PE1RGU/hf-antenna-switch/docs/design/host-protocol.md

# Host protocol: Mac or Pi to shack interface

Status: v0.1, 2026-10-29. Reviewed by Prins; P3b-01 to P3b-04 and C-1 to C-3 decided as proposed. Firmware phase P3b (firmware/PLAN.md).
Implementation: crate `host-proto` (firmware/crates/host-proto), used by shack-core and by the Mac tools.

## 1. Scope

This document sets the protocol between a host (the Mac now, the Raspberry Pi 5 later) and the shack interface MCU over USB.
One protocol for both hosts (D-68).

The host asks. The shack interface decides. Nothing in this protocol can:

- clear the SAFE latch (only the RESET button can, D-64, D-65, D-75),
- give a permit that the box did not report (D-63),
- key a radio without its permit (TX INH and keying are gated in hardware, D-71).

The host can always make things safer: stop, end TX, release keys.

## 2. Transport

| Item | Value | Source |
|---|---|---|
| Port | ESP32-C3 USB Serial/JTAG, through the DevKit USB-C and the rear panel extension | D-96, D-185 |
| Host side | CDC serial device, for example `/dev/cu.usbmodem*` on the Mac, `/dev/ttyACM0` on the Pi | |
| Isolation | Delock 64226 at the Mac side | A-16, D-185 |
| Baud rate | Not used (USB full speed) | |

The same port also carries the ROM boot messages after a reset and is the flash port. The protocol must survive text it does not know (section 3).

## 3. Format: text lines

Plain ASCII text, one message per line (P3b-01).

- A host line ends with CR, LF or CR LF, so a plain serial terminal works (Enter sends CR). An empty line is no command: no answer, but it counts for the keep-alive. Maximum 120 characters without the line end.
- The shack ends its lines with CR LF. Hosts strip the line end.
- Words are separated by one or more spaces. Keywords are lower case; radio and column names are not case sensitive.
- The first character of a line from the shack tells the line type:

| Start | Line type | Example |
|---|---|---|
| `ok` | Answer: command done or accepted | `ok` |
| `err` | Answer: command refused | `err txbusy R2 is transmitting` |
| `!` | Event, sent when something changes | `!tx R2 permitted` |
| `#` | Log text, for people only | `# expander ready` |

A host ignores every line that does not start with one of these. So the boot ROM text and noise do no harm.

Every command gets exactly one answer line (`ok` or `err`), in the order the commands came. Events and log lines can come between commands and answers. A host matches answers by order, not by content.

Why text and not binary (postcard + COBS, the first idea in PLAN.md): you can drive and read the interface by hand with any serial terminal; the Pi and Mac tools are short scripts; USB already checks every packet, so the frame CRC of the box link is not needed here.

## 4. Names and values

| Item | Values |
|---|---|
| radio | `R1`, `R2`, `R3` |
| column | `A1` to `A4`, `EXP`, `-` (none) |
| column list | columns joined by commas, for example `A2,A3`, or `-` for none |
| on/off | `on`, `off` |
| band | 0 to 15: FT-710 BAND D C B A as a 4-bit number (D-86). Decoding to metres is done on the host |

## 5. Commands

| Command | Does | `ok` answer |
|---|---|---|
| `hello` | Identify | `ok shack fw <x.y.z> proto 1` |
| `status` | Full state, one line (section 7) | `ok <key=value ...>` |
| `route <radio> <tx col> <rx col>` | Route a radio. Sent to the box; the result comes as an event | `ok` (queued) |
| `tx <R2\|R3> on\|off` | Ask for TX permit (handshake) or end TX | `ok` |
| `key <radio> on\|off` | Key the radio through the interface. Works only while its permit is out | `ok` |
| `bias <column list>` | Bias-T feeds on for these columns, off for the rest | `ok` (queued) |
| `stop on\|off` | Software stop: opens the SAFE loop. `off` closes it again; the SAFE latch still needs RESET | `ok` |
| `clearfault` | Clear the shack fault latch (LATCH_CLR edge) after a supervisor reset (P3b-04). While the expander does not answer, RESET_N may still hold the latch: the fault stays and a `#` line says so. When the box reports fault 11 (supervisor trip), the shack also sends ClearFault to the box (D-191, link-protocol.md 4.2); a refusal comes as `!refused clearfault` | `ok` |
| `events on\|off` | Events on (default) or off | `ok` |
| `keepalive <seconds>` | Host keep-alive time-out, 2 to 60 s (section 8) | `ok` |
| `name <column or radio> <text>` | Set the name of an antenna (`A1` to `A4`, `EXP`) or a radio (`R1` to `R3`), 1 to 8 characters (the width of an antenna box on page B): letters, digits, `-`, `.`, `_`, `/`. Stored (section 8a) | `ok` |
| `help` or `?` | The command list as `#` lines, then `ok` | `ok` |
| `names` | All names, one line | `ok A1=G5RV A2=Loop A3=spare A4=spare EXP=unit2 R1=FT-710 R2=WSPR R3=spare` |
| `page b\|c\|auto` | Display page: B flow (default), C cards, or auto (B 10 s, C 5 s). The Safe stop screen always takes over on a blocking problem (Prins, 2026-10-29) | `ok` |

Error answers: `err <code> <text>`. Codes:

| Code | Meaning |
|---|---|
| `syntax` | Unknown command or wrong number of words |
| `arg` | A value out of range (radio, column, on/off) |
| `linkdown` | The box link is down (tx on, route, bias) |
| `notforr1` | `tx` for R1; R1 uses the hardware PTT loop |
| `txbusy` | Route change for a radio that transmits or ends TX (F13) |
| `queuefull` | Too many commands wait for the box; try again |
| `toolong` | Line longer than 120 characters |
| `nofault` | `clearfault` while no fault is known at the shack and the box does not report fault 11 |

## 6. Events

Sent on every change (when events are on). One line each.

| Event | When |
|---|---|
| `!link up` / `!link down` | Box link state (link-protocol.md section 6) |
| `!expander ready` / `!expander lost` | Shack expander set up, or lost (all permits dropped) |
| `!fault` | A supervisor reset was seen after start-up: TX blocked until `clearfault` |
| `!safe ok` / `!safe lost` | SAFE loop current (GPIO21) |
| `!latched 1` / `!latched 0` | SAFE latch (expander input) |
| `!kill 1` / `!kill 0` | KILL switch pressed |
| `!band <n>` | R1 band data changed |
| `!tx <radio> <state>` | `idle`, `requesting`, `permitted`, `ending`, `releasing` |
| `!permit <radio> on\|off` | PERMIT line changed (all radios, R1 included) |
| `!refused <command words> <result>` | The box refused a command; result as in link-protocol.md 4.1, lower case |
| `!permitlost <radio>` | The box dropped a permit in use |
| `!txsense <radio> fault` | Keyed with permit for 500 ms without TX sense (F14) |
| `!txsense <radio> nopermit` | TX sense active without the permit for more than 50 ms, outside the 500 ms after an inhibit: the radio transmits while inhibited (no TX INH input, or a wiring fault). A warning only; nothing stops by itself (F15, D-188) |
| `!route <radio> <tx col> <rx col>` | Route as read back from the box |
| `!host timeout` | Host keep-alive missed: TX ended (section 8) |
| `!selftest pass` / `!selftest fail <item>` | The power-up self-test ended (section 6a). After a fail, TX stays blocked until a power cycle. Items: `expander`, `latch`, `watchdog` |
| `!selftest warn <item>` | Unexpected at start-up, TX not blocked: `txsense <radio>` (TX sense active), `i2c <address>` (SHTC3 0x70 or IMU 0x68 did not answer) |

## 6a. Power-up self-test

Decided by Prins, 2026-10-31. The shack tests its own safety hardware after power-up, before TX can be enabled. No radio is keyed and no permit goes out during the test.

1. Expander: the PCA9539 must answer and read back (F1 set-up) within 1 s of power-up. Fail: `expander`.
2. SAFE latch: it must read set (POR_N holds it set at power-up, D-84). Fail: `latch`.
3. Start-up inputs, warnings only: TX sense of each radio inactive; the DevKit parts SHTC3 (0x70) and IMU (0x68) answer.
4. Watchdog: the WDI kicks stop. The supervisor must trip, which resets the expander, between 0.5 s and 3 s after the last kick (TPS3823 time-out 0.9 to 2.5 s, C-19). Fail: `watchdog`. With R64 open (watchdog off, D-123) this always fails.
5. The kicks resume. When the expander answers again (RESET_N high), the shack gives its one LATCH_CLR edge (D-59 rule 2) and the test has passed.

The test takes 1 to 3 s. A fail means no LATCH_CLR edge: the fault latch keeps TX_EN low in hardware until a power cycle, the shack gives no permit, and `clearfault` does not apply. The display shows the colour bars test pattern (eight bars, 1 s) the first time it starts; it has no read-back, so this check is for the eye. The display shows a fault after a failed test.

The box runs its own self-test (link-protocol.md section 4.2, fault codes 7 to 10); the shack shows its result as `boxfault`.

## 7. Status line

`status` answers one line with `key=value` pairs, in this order:

```
ok link=up safe=ok latched=0 kill=0 fault=0 stop=0 keepalive=2 page=b band=5 box=ready
   r1=A1/A1,permit=1,key=0 r2=A3/A3,tx=permitted,permit=1,key=1 r3=-/-,tx=idle,permit=0,key=0
   k1=A1,A3 rfdet=- bias=- boxfault=0 selftest=pass
```

`selftest` is `running`, `pass` or `fail-<item>` (section 6a).

(One line on the wire; wrapped here for reading. About 200 characters: the 120-character limit is for host lines only. Unknown values read `?`, for example `box=?` before the first box status.)

## 8. Host keep-alive

Decided (P3b-03). A Mac app that crashes while R2 is keyed would leave a WSPR transmitter on until someone notices.

- While any `tx` is on or any `key` is on, the host must send a line at least every keep-alive time-out. Any line counts, an empty line too; `status` is the normal one.
- The time-out is 2 s. `keepalive <seconds>` sets it from 2 to 60 s, for typing by hand (Prins, 2026-10-29). It goes back to 2 s at every power-up. A host app leaves it at 2 s.
- No line within the time-out: the shack ends every TX and releases every key, the normal way (inhibit first, F14), and sends `!host timeout`.
- Routes, bias and the software stop stay as they are.

## 8a. Stored settings

Prins, 2026-10-29: the shack interface keeps its set-up over a power cycle, so the station can be used straight away.

Stored in the shack MCU flash (ESP32-C3, P7):

| Item | Stored | Note |
|---|---|---|
| Antenna and radio names | yes | `name` |
| Route per radio (TX and RX column) | yes | The route the box reports after a `route` that it accepted |
| Bias-T columns | yes | `bias` |
| Display page | yes | `page` |
| TX request, keys | **never** | A restart must not start a transmission |
| Keep-alive time-out | no | Back to 2 s at power-up (section 8) |
| Software stop | no | Off at power-up; the SAFE latch is set at power-up anyway |

- Saved 2 s after the last change, so a burst of commands gives one flash write.
- A record has a version byte and a CRC-16. A bad or missing record gives the defaults (names as in the requirements, no routes, no bias, page B) and the log line `# stored settings not found, defaults used`.
- Restore: each time the box link comes up and the box is ready, and each time the box reports READY again (after KILL, RF on A2, a stop or an expander reset: its relays come back off), the shack sends the stored routes and bias to the box. A route for a radio that is still ending TX goes as soon as that radio is idle. The box checks them like any other command (H1 to H4); a refusal comes as `!refused`. This also restores the routes after a box restart.
- What is stored is the route or bias the box accepted (result Ok), not the read-back in that answer: the box answers at once and switches its relays in the next 36 to 48 ms.
- Restoring a route moves relays without a command from the operator. TX still needs RESET (SAFE latch), the permit and, for R2 and R3, the handshake.

On the ESP32-C3 the record is in flash, in the `nvs` partition at 0x9000: one length byte, then the record. Wi-Fi and BLE are off (D-55), so nothing else uses that partition. espflash does not erase it, so the settings survive a firmware update. Tested on the DevKit, 2026-10-31. The settings are also saved while the expander does not answer.
## 9. Timing

- The shack reads host lines every tick (10 ms) and answers in the same tick.
- Commands that go to the box (`route`, `tx on`, `bias`) answer `ok` when queued. The result comes as an event, about 50 to 120 ms later (link-protocol.md 5.1).

## 10. Implementation (P3b)

- `host-proto` (no_std): line parser into a `HostCommand` enum, and formatters for answers, events and the status line into a fixed buffer. Fuzz test: no panic on any input.
- shack-core: the host port in `Shack::tick`: bytes come in through `ShackHw::usb_read`, each complete line is parsed and answered, and events go out through `ShackHw::usb_write` (`shack/host.rs`); keep-alive timer in `tick`.
- Simulator: the USB port as a byte channel on the board model. `sim-shack --pty` opens a pseudo-terminal, so a real terminal or a Mac script can talk to the simulated interface. Same commands, same answers as the real one.

## 11. Open points

- **P3b-01 Format. Decided (Prins, 2026-10-29): option 1.** Option 1: text lines (this document). Option 2: binary frames (postcard + COBS), smaller and typed, but needs a tool to read. Proposal: option 1.
- **P3b-02 Log output. Decided (Prins, 2026-10-29): accepted.** The firmware writes log text only as `#` lines through this protocol, never as raw `println` on the USB port. Proposal: accept; the target uses a small log adapter.
- **P3b-03 Host keep-alive. Decided (Prins, 2026-10-29): accepted.** 2 s, ends TX and keys only. Proposal: accept.
- **P3b-04 `clearfault`. Decided (Prins, 2026-10-29): option 1.** Clears the shack fault latch from the host after a supervisor reset (watchdog or brown-out) during operation. The firmware cannot read FAULT directly (it is not on the expander); it knows a fault happened when the expander was reset. The SAFE latch is not touched. Option 1: allow from the host, logged. Option 2: no command; a power cycle is needed. Proposal: option 1. The hardware still gates TX by the SAFE latch, the permits and the box.

Choices from P3a, confirmed by Prins (2026-10-29):

- **C-1 R1 permit.** PERMIT_R1 on while the box is READY and R1 has a TX column with K1 on; off while an R1 route change is pending (sent, not answered) or running (the box reports SWITCHING).
- **C-2 Fault after start-up.** After an expander reset during operation, the firmware sets the expander up again but does not clear the fault latch by itself. `clearfault` (P3b-04) is the way back.
- **C-3 F14 plausibility.** 500 ms keyed with permit and no TX sense: the port is flagged (`!txsense`). TX is not blocked.
