PE1RGU/hf-antenna-switch/Datasheets/_register.md

# Datasheet register: HF antenna switch

Rule: for every selected component, this folder holds the datasheet, the errata and the amendments (product change notices). One flat folder.

File name: `<MPN>_<Manufacturer>_<Type>_<Rev-or-date>.pdf`
Types: DS = datasheet, ER = errata, PCN = product change notice, AN = application note, CAT = catalogue chapter, SPEC = manufacturer specification, STD = standard.

## Components

| Component | MPN | Role | Selected |
|---|---|---|---|
| Relay, SPDT 16 A, 12 VDC, wash-tight (RTIII) | TE RTD14012F (TE PN 2-1419108-9) | K0 and TX row, Radio Port card | 2026-09-26 |
| DIN 41612 type C, 96 pos, male, angled, PL2 | HARTING 09 03 196 6921 | Card side, all cards (not used in rev C, archived) | 2026-09-26 |
| DIN 41612 type C, 96 pos, female, straight, PL2 | HARTING 09 03 296 6824 or 6825 | Backplane side (not used in rev C, archived) | 2026-09-26 |
| I2C I/O expander, 16 bit, RESET, no pull-ups | NXP/Nexperia PCA9539PW,118 (TSSOP24; Q900 variant rated -40 to +125 °C). Second sources TI TCA9539PWR, Diodes PI4IOE5V9539LEX (D-133) | Radio Port card, relay select, RESET from safety chain. Addresses 0x74 to 0x77 | 2026-09-26 |
| I2C I/O expander, 8 bit, 100 kΩ pull-ups | NXP PCA9554A | Antenna Port card, active-low relay drive (pull-ups hold the relay off at power-on). Addresses 0x38 to 0x3F | 2026-09-26 |
| DC power connector, 2 pole, PCB, male, 90° | Amass XT60PW-M | Backplane J12 (+12V_RLY) and J13 (+12V_AUX). Cable side: XT60 female | 2026-09-26 |
| DC power connector, 2 pole, PCB, male, 90° | Amass XT30PW-M | Backplane J14 (+5V). Cable side: XT30 female. Cannot mate with XT60: no rail mix-up | 2026-09-26 |
| Differential I2C bus buffer, 2 pairs | NXP PCA9615 | EXP CTRL link unit 1 to unit 2 (one at each end), rev C | 2026-09-27 |
| N-MOSFET 60 V SOT-23, logic level, relay coil driver (primary) | Nexperia BSS138BK | Coil driver, one per RT1 coil (37), rev C | 2026-09-27 |
| N-MOSFET 60 V SOT-23, logic level (second source) | Diotec MMFTN138K (replaces Diodes DMN61D8L-7, D-128, and onsemi 2V7002KT1G, D-134) | Coil driver and level shift, second source for BSS138BK on all boards | 2026-10-19 |
| RJ45 jack, 8P8C unshielded, THT, tab down | Wurth 615008137121; second source Molex 95501-2881 (D-138) | Controller board J1, RJ45 LINK in the top wall | 2026-10-19 |
| Elevated socket 2 x 12, 2.54 mm, 16.13 mm high | Samtec ESQ-112-33-G-D; second source ESW-112-33-G-D (D-139) | Controller board J2 onto RF board J14 | 2026-10-20 |
| P-MOSFET -30 V SOT-23, high-side switch +12V_SW (primary) | Nexperia PMV50EPEA | Relay supply switch under RLY_EN, rev C | 2026-09-27 |
| P-MOSFET -30 V SOT-23, high-side switch +12V_SW (second source) | AOS AO3407A | Second source for PMV50EPEA | 2026-09-27 |
| Coax lightning protector, M-J/M-J (SO-239 both sides), DC to 500 MHz, 500 W PEP | Comet CS-400R (CS-400P discontinued) | Spark arrestor at the RVS box entry, one per coax. Replaceable Sankosha arrestor Y08UZ-400A. DC fire 400 V ±15 %, impulse fire ≤ 950 V (1 kV/µs), insulation ≥ 10 GΩ: passes DC, no static drain | 2026-09-27 |
| UHF receptacle SO-239/A, 4-hole flange 25.4 mm, solder cup | Amphenol RF 83-798 | Radio and antenna ports in the case bottom wall (7 per unit). Body zinc die cast, nickel ≥ 0.00015 in; socket contact brass, silver ≥ 0.0002 in; insulator PTFE per MIL-P-19468. Replaces 83-1R (PBT insulator) | 2026-09-27 |
| SMA panel jack, 4-hole flange 12.7 mm, 50 ohm, PTFE, solder-cup contact | Amphenol RF 901-9215 (stainless body, gold), main part (D-110); second source Cinch/Johnson 142-0701-631 (brass body, gold; D-174); alternative Amphenol RF 132142 (brass body, gold), same outline | EXP J4 to J6 in the left wall (D-108). Not chosen yet: rear length against the 6 mm wall (A-21) | 2026-10-19 (candidates) |
| Solid state relay, 1-form-B (normally closed), 60 V, 150 mA, SOP4 2.54 mm | Littelfuse CPC1117N | Shack interface, TX INH: replaced by D-106 (end of life, PDN EIC-1177) | 2026-09-29, superseded 2026-10-07 |
| Solid state relay, 1-form-B, 350 V, 120 mA, 2.54SOP4 (primary) | Toshiba TLP4176G | Shack interface, TX INH per radio port (U203, U303, U403; D-77, D-106) | 2026-09-29, primary from 2026-10-07 |
| Solid state relay, 1-form-B, 60 V, 0.5 A, GU SOP4 (second source) | Panasonic AQY412S | Shack interface, TX INH, second source of TLP4176G (D-106) | 2026-10-07 |
| PNP medium power transistor 80 V 1 A, SOT-223 | Nexperia BCP53 (-10 or -16) | Shack interface, loop current source pass transistor (D-79) | 2026-09-29 |
| PNP general-purpose transistor 45 V 100 mA, SOT-23 | Nexperia BC857 (B) | Shack interface, loop current source sense transistor (D-79) | 2026-09-29 |
| Linear regulator 5 V 1.5 A, TO-220 | ST L7805CV (L78 series) | Shack interface 13.8 V to 5 V, on the housing wall (D-73, D-82) | 2026-09-30 |
| LDO 3.3 V 800 mA, SOT-223 | ST LD1117S33CTR (C version) | Shack interface 5 V to 3.3 V (D-81) | 2026-09-30 |
| TVS 600 W, SMB, uni- and bidirectional | ST SMBJ16A, SMBJ15CA (SMBJ series) | Shack interface: 13.8 V input (16A); loop pairs (15CA); box loop pairs (15CA, D-58) | 2026-09-30 |
| Schottky rectifier 40 V 3 A, SMC | Vishay SS34-M3/57T | Shack interface 13.8 V reverse-polarity diode (D-73) | 2026-09-30 |
| Mini-DIN 8 socket, PCB, right angle, side shielded | Same Sky MD-80SM (second source Kycon KMDGX-8S-BS, same footprint) | Shack interface radio ports R1 to R3 (D-85, D-86) | 2026-10-01 |
| Photorelay 1-form-A 60 V 0.7 A, 2.54 mm pitch, halogen-free | Toshiba TLP176AM (second source Panasonic AQY212G3HS) | Shack interface keying output per radio port (D-91) | 2026-10-04 |
| ESD clamp, bidirectional 15 V, SOD-323 | Nexperia PESD15VL1BA (second source Bourns CDSOD323-T15C) | Shack interface radio port lines (D-89) | 2026-10-04 |
| ESD array 2 data lines + VBUS, SOT-23-6 | ST USBLC6-2SC6 (second source UMW USBLC6-2SC6) | Shack interface USB-C J14, D+, D-, VBUS (D-96) | 2026-10-04 |
| USB 2.0 Type-C receptacle, 16 contacts, SMT top mount | GCT USB4105-GF-A (second source Same Sky UJ20-C-H-G-SMT-1-P16-TR, same land pattern) | Shack interface USB-C J14 at the housing wall (D-96) | 2026-10-04 |
| Zener 5.1 V 300 mW, SOD-323 | Nexperia BZX384-C5V1 (second source onsemi MM3Z5V1T1G) | Shack interface TX INH HIGH clamp (D-90) | 2026-10-04 |

Notes:
- Order code: datasheet RT1pb rev 4 (10-2023) lists the wash-tight 12 V CO part as RTD14012F, TE PN 2-1419108-9. The older Schrack code RTD14012 (alias 6-1393238-2) is still listed at Mouser. Order RTD14012F.
- RT314012 is the RTII (flux-proof) version. RTD14012 is the RTIII (wash-tight) version: 16 A, 5 mm pinning, CO, 12 VDC, 360 Ω, 33.3 mA, 400 mW, 29 × 12.7 × 15.7 mm (Mouser listing).
- Do not order RT314F12. That part is the bistable (latching) RT1.
- 09 03 296 6824 has 2.9 mm termination length, 6825 has 4.5 mm. Pick after the backplane PCB thickness is fixed.

## Documents

| File | MPN | Type | Rev / date | Source | Status |
|---|---|---|---|---|---|
| AQY41xS_Panasonic_DS_ASCTB140E_2026-01.pdf | AQY412S, AQY410S, AQY414S | DS (catalog with dimensions) | ASCTB140E 202601 | Panasonic, supplied by Prins 2026-10-07 | saved |
| AQY41xS_Panasonic_DS_ASCTB140E_2014-04.pdf | AQY412S, AQY410S, AQY414S | DS (short form) | ASCTB140E 201404-T | https://www.farnell.com/datasheets/2244194.pdf (Prins) | superseded by 202601 |
| OptoMOS_Littelfuse_PDN_EIC-1177_2026-08-13.pdf | CPC1117N and the PCB SSR family | PDN | 2026-08-13 | https://www.tti.com/content/dam/ttiinc/products/PCN/Littelfuse/Littelfuse-PDN-EIC-1177.pdf (Prins) | saved |
| 09031966921_HARTING_DS_2026-03-13.pdf | 09 03 196 6921 | DS | created 2026-03-13 | https://b2b.harting.com/files/download/PRD/PDF_DS/PDF_DS_09031966921_EN.pdf | saved |
| 09032966824_HARTING_DS_2025-08-01.pdf | 09 03 296 6824 | DS | created 2025-08-01 | https://b2b.harting.com/files/download/PRD/PDF_DS/PDF_DS_09032966824_EN.pdf | saved |
| 09032966825_HARTING_DS_2025-07-19.pdf | 09 03 296 6825 | DS | created 2025-07-19 | https://b2b.harting.com/files/download/PRD/PDF_DS/PDF_DS_09032966825_EN.pdf | saved |
| DIN41612_HARTING_CAT_Catalogue-03-11-Ch01_2019-03-13.pdf | DIN 41612 | CAT | catalogue 03 11, chapter 01, PDF 2019-03-13 | https://b2b.harting.com/files/livebooks/en/PRD0200000100182/downloads/livebook.pdf | saved |
| RTD14012F_TE_DS_RT1pb-rev4_2023-10.pdf | RTD14012F | DS | ENG_DS_RT1pb_4, 10-2023, Rev. 4 (current, covers the F codes) | https://eu.mouser.com/datasheet/3/2640/1/ENG_DS_RT1pb_4.pdf | saved |
| RT314012_TE_DS_RT1-rev7.pdf | RT1 (Schrack codes) | DS | ENG_DS_RT1_7 | https://www.te.com/commerce/DocumentDelivery/DDEController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 | saved |
| RT1_TE_SPEC_Definitions-Relays_rev3.pdf | RT1 | SPEC | ENG_SS_Definitions_Relays_3. The datasheet is valid only together with this document. | https://www.te.com/commerce/DocumentDelivery/DDEController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 | saved |
| RTD14012F_TE_PCN_P-23-024412_2023-04-18.pdf | RTD14012 | PCN | 2023-04-18. Case colour orange to white, materials upgraded towards IEC 60335-1 clause 30. Performance and approvals unchanged. Not discontinued. RTD14012 (6-1393238-2) is listed. Changed parts ship from 2023-10-16. | https://eu.mouser.com/PCN/Tyco_Electronics_PCN_P_23_024412.pdf | saved |
| n/a | (none) | PCN | E-13-006437 (2013) covers a solar junction box, not the RT1. Mouser links it to RTD14012 in error. Not filed. | https://eu.mouser.com/PCN/Tyco_Electronics_E_13_006437.pdf | not applicable |
| n/a | RTD14012 | ER | Relays have no errata. PCNs cover changes. | n/a | n/a |
| n/a | HARTING parts | PCN | none listed on the product pages | HARTING customer portal (login) | to check |
| n/a | DIN 41612 | STD | IEC 60603-2 | IEC webstore, paid | reference only |
| PCA9539_NXP_DS_Rev9.1_2025-10-10.pdf | PCA9539 | DS | Rev. 9.1, 10 October 2025 | https://www.nxp.com/docs/en/data-sheet/PCA9539_PCA9539R.pdf | saved |
| TCA9539_TI_DS_SCPS202C_2016-05.pdf | TCA9539PWR (second source of PCA9539PW, D-133) | DS | SCPS202C, revised May 2016 | https://www.ti.com/lit/gpn/TCA9539 (downloaded by Prins) | saved |
| PI4IOE5V9539_Diodes_DS_PT0549-4_2016-09-26.pdf | PI4IOE5V9539LEX (second source of PCA9539PW, D-133) | DS | 2016-06-0005 PT0549-4, 26 September 2016 | https://diodes.com/datasheet/download/PI4IOE5V9539.pdf (downloaded by Prins) | saved |
| PCA9554A_NXP_DS_Rev10_2017-11-08.pdf | PCA9554A | DS | Rev. 10, 8 November 2017 | https://www.nxp.com/docs/en/data-sheet/PCA9554_9554A.pdf | saved |
| n/a | PCA9539, PCA9554A | ER / PCN | none found yet | NXP product pages (PCN list may need login) | to check |
| PCA9615_NXP_DS_Rev2_2021-09-16.pdf | PCA9615 | DS | Rev. 2, 16 September 2021 | https://www.nxp.com/docs/en/data-sheet/PCA9615.pdf | saved |
| 65AN002E_ROHM_AN_Rev001_2022-06.pdf | (general) | AN | No. 65AN002E Rev.001, June 2022 | provided by Prins | saved |
| AND9093-D_onsemi_AN_Rev1_2014-02.pdf | (general, load switch for +12V_SW) | AN | AND9093/D Rev. 1, February 2014 | provided by Prins | saved |
| DMN61D8L_Diodes_DS_Rev4-2_2018-06.pdf | DMN61D8L | DS | DS37630 Rev. 4-2, June 2018 (page marking "Advanced Information": production status to confirm) | provided by Prins (diodes.com) | saved |
| BSS138BK_Nexperia_DS_Rev1_2011-08-04.pdf | BSS138BK | DS | Rev. 1, 4 August 2011, Product data sheet | https://assets.nexperia.com/documents/data-sheet/BSS138BK.pdf (downloaded by Prins) | saved |
| MMFTN138K_Diotec_DS_2026-05-19.pdf | MMFTN138K | DS | Version 2026-05-19 | Prins (diotec.com) | filed |
| BSS138BKT116_ROHM_DS_Rev001_2019-10-29.pdf | BSS138BKT116 | DS | Rev.001, 2019-10-29 | Prins (rohm.com) | filed |
| BSS138BKAHZGT116_ROHM_DS_Rev001_2020-07-07.pdf | BSS138BKAHZGT116 | DS | Rev.001, 2020-07-07 | Prins (rohm.com) | filed |
| BSS138BKW_ROHM_DS_Rev003_2023-10-17.pdf | BSS138BKW | DS | Rev.003, 2023-10-17 | Prins (rohm.com) | filed |
| PJA138K_Panjit_DS_Rev03S_2017-01-24.pdf | PJA138K | DS | REV.03S, 2017-01-24 | Prins (panjit.com) | filed |
| 2N7002KW-AU_Panjit_DS_Rev01S_2017-10-27.pdf | 2N7002KW-AU | DS | REV.01S, 2017-10-27 | Prins (panjit.com) | filed |
| 2N7002K_onsemi_DS_Rev20_2023-10.pdf | 2N7002K, 2V7002K | DS | Rev. 20, October 2023 | Prins (onsemi.com) | filed |
| AO3407A_AOS_DS_Rev5-1_2023-07.pdf | AO3407A | DS | Rev 5.1, July 2023 | https://www.aosmd.com/res/datasheets/AO3407A.pdf | saved |
| PMV50EPEA_Nexperia_DS_v1_2016-06-30.pdf | PMV50EPEA | DS | 30 June 2016, Product data sheet | https://assets.nexperia.com/documents/data-sheet/PMV50EPEA.pdf (downloaded by Prins) | saved |
| 83-1R_AmphenolRF_DS_RevAM.pdf | 83-1R | DS (customer outline drawing) | Rev. AM, 3/27/15 | Prins (Mouser) | saved, not selected (PBT) |
| 83-798_AmphenolRF_DS_RevAG_2012-04-11.pdf | 83-798 | DS (customer outline drawing) | Rev. AG, 11 April 2012 | Prins | saved |
| CS-400R_Comet_DS_4th-ed-2023-04_EN.pdf | CS-400R | DS (instruction manual) | 4th edition, Apr 2023 | Prins (Comet) | saved |
| CS-400R_Comet_DS_4th-ed-2023-04_JA.pdf | CS-400R | DS (instruction manual, Japanese) | 4th edition, Apr 2023 | Prins (Comet) | saved |
| XT60PW-M_Amass_DS_V1.2_2017-06.pdf | XT60PW-M | DS | V1.2 (PDF created 2017-06-16). Drawing only; no polarity marking | https://www.tme.eu/Document/b13629717d44ae038681dba08d18c0b6/XT60PW-M.pdf (alternative: https://www.lcsc.com/datasheet/lcsc_datasheet_2401181031_Changzhou-Amass-Elec-XT60PW-M_C98732.pdf) | saved |
| XT30PW-M_Amass_DS_V1.2_2017-05.pdf | XT30PW-M | DS | V1.2 (PDF created 2017-05-30). Drawing only; no polarity marking | https://www.tme.eu/Document/6eb2005a51a52592b3f19e8a450c54c8/XT30PW-M.pdf | saved |
| n/a | XT60PW-M, XT30PW-M | ER / PCN | none found yet | Amass | to check |
| AN-6602_Fairchild-onsemi_AN_Rev1.0_2015-07-16.pdf | – (JFET family) | AN | Rev 1.0, 2015-07-16 (orig. NSC Note 151, J. Maxwell 1976) | Prins | filed; reference, no part in this design |
| IRFL9014_Vishay_DS_RevG_2021-04-05.pdf | IRFL9014TRPBF | DS | Rev G, 2021-04-05 (doc 91195) | vishay.com | filed |
| BC857_Nexperia_DS_Rev9_2022-07-01.pdf | BC857B | DS | Rev 9, 2022-07-01 (BC856/BC857/BC858) | nexperia.com | filed |
| NTF2955_onsemi_DS_Rev8_2024-12.pdf | NTF2955T1G | DS | Rev 8, 2024-12 | onsemi (downloaded by Prins) | filed |
| ESP32-C3-DevKit-RUST-2_Espressif_SPEC_esp-dev-kits-master_2026-09.pdf | ESP32-C3-DevKit-RUST-2 | SPEC | esp-dev-kits user guide, release master (ESP32-C3 chapter 4) | Espressif (downloaded by Prins) | filed; board schematic and ESP32-C3-MINI-1 datasheet still to get |
| ESP32-C3-DevKit-RUST-2_Espressif_SCH_2025-10-30.pdf | ESP32-C3-DevKit-RUST-2 | SPEC | Rev 2.0 schematic, dated 2025-10-28 (PDF 2025-10-30) | Espressif (downloaded by Prins) | filed |
| PC817X_Sharp_DS_D2-A03101EN_2003-09-30.pdf | PC817X series | DS | Sheet D2-A03101EN, 2003-09-30 | Sharp (downloaded by Prins) | filed |
| 6N137_Vishay_DS_Rev2.2_2023-03-15.pdf | 6N137, VO2601, VO2611 | DS | Rev 2.2, 2023-03-15 | vishay.com | filed |
| 2036_Bourns_DS_RevB_2026-01.pdf | 2036-09-B2LF | DS | Rev B, 01/26 | bourns.com | filed |
| ACT45B_TDK_DS_2016-02-16_zh.pdf | ACT45B-510-2P-TL003 | DS (Chinese edition) | 2016-02-16 | lcsc.com copy of the TDK sheet | filed |
| 1812CAN_Coilcraft_DS_1201_2024-03-22.pdf | 1812CAN-513NRC (choke second source, D-151) | DS | Document 1201-1, revised 03/22/24 | coilcraft.com | filed |
| DLW43SH510XK2_Murata_DS_2020-12-15.pdf | DLW43SH510XK2L (choke second source, D-151) | DS (product search sheet) | 2020-12-15 | chipdip copy of the Murata sheet | filed |
| SL1003A_Littelfuse_DS_2017-12-12.pdf | SL1003A090R-001 (GDT second source, D-149) | DS | Revised 12/12/17 | cdn.components.ru copy of the Littelfuse sheet | filed |
| MMU-MMA-MMB_Vishay_DS_28963_2026-06-02.pdf | MMB 0207 47R, MMA 0204 220R | DS | 28963, 2026-06-02 | vishay.com | filed |
| APX823_Diodes_DS_DS31323-Rev5-2_2024-02.pdf | APX823-29W5G-7 | DS | DS31323 Rev 5-2, Feb 2024 | diodes.com | filed |
| MAX823_ADI_DS_19-0487-Rev5_2005-12.pdf | MAX823SEUK+T (supervisor second source, D-148) | DS | 19-0487 Rev 5, 12/05 | Prins (analog.com) | filed |
| 132142_AmphenolRF_DS_RevNC_2006-09-24.pdf | 132142 | DS (outline drawing) | Rev. NC, 24 Sep 2006 | Prins (amphenolrf.com) | filed |
| 901-9215_AmphenolRF_DS_RevG_2015-07-20.pdf | 901-9215 | DS (customer outline drawing) | Rev. G, 20 Jul 2015 | Prins (amphenolrf.com) | filed |
| 142-0701-631_Cinch_DS_NoRev_2014-12-17.pdf | 142-0701-631 | DS (series data: 0 to 18 GHz, 335 Vrms, DWV 1000 Vrms, -65 to +165 C; gold plated; no outline drawing) | no revision mark, PDF dated 17 Dec 2014 | Prins (4donline.ihs.com, CNCH-S-A0001287992-1.pdf) | filed |
| 615008137121_Wurth_DS_Rev001.002_2025-07-09.pdf | 615008137121 | DS | Rev 001.002, 2025-07-09 | Prins (we-online.com) | filed |
| 54602-908LF_AmphenolFCI_DS_C-BMJ-0102-RevH_2010-02-02.pdf | 54602-908LF | DS (product drawing) | C-BMJ-0102 Rev H, 2010-02-02 | Prins (amphenol-cs.com) | filed |
| 95501-2881_Molex_DS_SD-95501-001-RevF1_2022-01-10.pdf | 95501-2881 | DS (sales drawing) | SD-95501-001 Rev F1, 2022-01-10 | Prins (molex.com) | filed |
| ESW-ESQ_Samtec_DS_F-226_2026-06-16.pdf | ESW, ESQ elevated sockets (ESQ-112-37-G-D-LL, ESQ/ESW-112-33-G-D) | DS (catalogue page) | F-226 Rev 16JUN26 | Prins (samtec.com) | filed |
| SLW_Samtec_DS_SLW-1XX-01-X-X_RevX_2013-03-01.pdf | SLW low-profile socket strip (SLW-116-01-G-S, SLW-112-01-G-S) | DS (marketing print) | Rev X, 2013-03-01 | Prins (samtec.com) | filed |

## Design-rule check (skill hardware-design-rules), 2026-09-26

Assumptions, to be confirmed:
- A1. Worst-case ambient in the RVS box: 45 °C (Prins, 2026-09-26: box on the north side of the shed, plants around it, a bush on the east side, no direct sun).
- A2. RF: 100 W, worst-case SWR 3:1 on the line (FT-710 internal ATU range). Imax = 1.41 A x sqrt(3) = 2.45 A rms. Vmax = 70.7 V x sqrt(3) = 122 V rms, 173 V peak.
- A3. Relay rail: +12V RLY from a linear regulator in the box, 12 V ±5 %.
- Critical parts: not applicable (private project, no commissioner).

| MPN | Parameter | Operating | Rating | Ratio | Limit | Result |
|---|---|---|---|---|---|---|
| RTD14012F | Contact current (RF, per contact) | 2.45 A | 16 A | 0.15 | 0.7 | pass. Exception: ratings are for 50 Hz; HF behaviour not specified, verify by NanoVNA and 100 W test |
| RTD14012F | Contact voltage | 173 V peak | 250 VAC rated (354 V peak) | 0.49 | 0.7 | pass |
| RTD14012F | Ambient temperature | 45 °C (A1) + heat from other coils on the card | 85 °C | 0.53 at 45 °C; 0.8 reached at 68 °C | 0.8 | pass |
| RTD14012F | Coil voltage | 12 V ±5 % = 11.4 to 12.6 V | operative range class 2: 85 to 110 % = 10.2 to 13.2 V | n/a | exception (nominal-rated part) | pass. A 13.8 V rail would fail (above 13.2 V) |
| RTD14012F | Halogen | | TE: see Product Compliance Support Center | | | unknown, to check |
| 09 03 196 6921 / 296 6824 | Current per contact, RF line | 2.45 A | about 1.74 A at 45 °C (derating curve, all contacts loaded) | 1.41 on 1 contact; 0.70 on 2; 0.47 on 3 | 0.7 | pass with 2 contacts in parallel per RF line (0.70, accepted: close to the factor is fine). Returns via ground contacts in rows a and c and one ground contact in row b between RF groups (decided 2026-09-26) |
| 09 03 196 6921 / 296 6824 | Current per contact, +12V RLY at the PSU slot | 0.6 A (full chassis) | about 1.74 A at 45 °C | 0.34 | 0.7 | pass (use 2 contacts for margin) |
| 09 03 196 6921 / 296 6824 | Voltage, RF line | 122 V rms / 173 V peak | working voltage 250 V max (catalogue, depends on safety rules) | 0.49 rms / 0.69 peak | 0.7 | pass. Accepted by Prins 2026-09-26: close to the factor is fine, the factor already gives the margin |
| 09 03 196 6921 / 296 6824 | Temperature | 45 °C + contact self-heating | +125 °C | 0.36 at 45 °C | 0.8 (100 °C) | pass |
| 09 03 196 6921 / 296 6824 | Halogen | | glass-fibre thermoplastic, UL 94 V-0; no halogen statement in the datasheet | | | unknown, to check (V-0 plastics are often brominated) |
| PCA9539 / PCA9554A | Supply voltage | 3.3 V ±5 % = 3.47 V (local LDO on each card) | 5.5 V (max operating) | 0.63 | 0.7 | pass |
| PCA9539 / PCA9554A | I/O current per pin | driver input, below 1 mA (planned) | 25 mA | < 0.04 | 0.7 | pass, provisional until the driver circuit is fixed |
| PCA9539 / PCA9554A | Ambient temperature | 45 °C (A1) + card self-heating | 85 °C | 0.53 at 45 °C; 0.8 reached at 68 °C | 0.8 | pass. PCA9539 Q900 (125 °C) is an option if the card runs warm |
| PCA9539 / PCA9554A | Halogen | | NXP material declaration | | | unknown, to check |
| XT60PW-M / XT30PW-M | Current | 0.6 A per rail (full chassis, estimate) | 45 A (XT60PW-M) / 15 A (XT30PW-M), datasheet V1.2 (TME lists 30 A for the XT60PW-M) | 0.01 / 0.04 | 0.7 | pass |
| XT60PW-M / XT30PW-M | Voltage | 12.6 V | 500 V DC | 0.03 | 0.7 | pass |
| XT60PW-M / XT30PW-M | Temperature | 45 °C + negligible self-heating | 120 °C | 0.38 | 0.8 | pass. Note: lower limit -20 °C, close to Dutch winter extremes; box interior is a few K above ambient from the PSU |
| XT60PW-M / XT30PW-M | Halogen | | polyamide housing, UL94 V-0 (TME listing); no halogen statement found | | | unknown, to check (V-0 polyamide is often brominated) |

## Log

- 2026-09-26: folder and register created.
- 2026-09-26: org allowlist set. HARTING files fetched and saved. TE and Mouser sites refuse scripted downloads (bot protection); the built-in browser can open the files but does not save downloads to disk. TE documents located, not yet saved.
- 2026-09-26: RT1 datasheets saved (RT1pb rev 4 and RT1 rev 7). Scripted clicks in Chrome and the built-in browser do not produce downloads; hand-clicked downloads do. Definitions and two PCNs still to save.
- 2026-09-26: Definitions rev 3 and PCN P-23-024412 saved. PCN E-13-006437 checked and not filed (unrelated product). Relay and connector documents complete, except HARTING PCNs (portal login).
- 2026-09-26: first design-rule check done. Open: box temperature (A1), halogen status of relay and connector, HARTING working-voltage basis (rms or peak).
- 2026-09-26: A1 set to 45 °C. RF on the backplane decided, 3 contacts per RF line and per return. Voltage ratio 0.69 accepted. Open: halogen status of relay and connector.
- 2026-09-26: changed to 2 contacts per RF line, with a ground contact in row b between RF groups.
- 2026-09-26: I/O expanders selected: PCA9539 (radio card, RESET from safety chain) and PCA9554A (antenna card, active-low drive). No card EEPROM. NXP refuses scripted downloads; links listed for Prins.
- 2026-09-26: power entry selected: Amass XT60PW-M (J12 +12V_RLY, J13 +12V_AUX) and XT30PW-M (J14 +5V). Note: the PCB versions are rated 30 A and 15 A, not 60 A and 30 A like the cable versions. TME and LCSC refuse scripted downloads; links listed.
- 2026-09-26: PCA9539, PCA9554A, XT60PW-M and XT30PW-M datasheets saved. XT datasheets show no polarity; the KiCad Amass footprints mark pad 2 = + and pad 1 = - on both parts. XT60PW-M rated 45 A in datasheet V1.2.
- 2026-09-27: rev C. Unit 2 is run from the unit 1 controller over an EXP CTRL RJ45: differential I2C (PCA9615 at each end), /RLY_EN and TX_ANY as hardware lines. DIN 41612 parts archived with the backplane.
- 2026-09-27: arrestor is the Comet CS-400R (CS-400P out of stock). DC fire 400 V ±15 % (min 340 V) against 173 V RF peak: ratio 0.51 at the minimum. DC holdover ≤ 150 ms at 150 V DC: the 12 V bias-T does not hold the arc. Not waterproof: inside the RVS box only. Spare arrestor Y08UZ-400A.
- 2026-09-27: SO-239 Amphenol RF 83-1R. Drawing: hole pattern 0.718 in (18.24 mm), mounting holes 0.125 in, panel hole 0.656 in (16.66 mm), flange 0.054 in. STEP (hardware/unit/unit.3dshapes/AmphenolRF_83-1R.step): rear body 5.5 mm behind the flange, solder cup 3.4 mm dia to 11 mm behind the flange. Insulator is PBT, not PTFE: soldering heat and halogen status to check.
- 2026-09-27: SO-239 changed to Amphenol RF 83-798 (PTFE insulator). Drawing Rev. AG: length 26.59 mm approx, 15.82 mm from flange front face to barrel end, rear body dia 15.75 mm, hole pattern 18.24 mm, holes 3.18 mm. Estimated from the drawing: rear body about 4 mm and cup tip about 9.6 mm behind the flange. No 83-798 STEP; the 83-1R STEP stays as a placeholder.
- 2026-09-27: reference application notes filed: ROHM 65AN002E (PCB layout thermal design) and onsemi AND9093/D (MOSFET load switches; applies to the /RLY_EN switch of +12V_SW).

- 2026-09-27: coil MOSFET second source checked. DMN61D8L (DS37630 Rev 4-2): 60 V, VGS(th) 1.3 to 2.0 V, RDS(on) max 2.4 ohm at VGS 3 V / 0.15 A, gate leakage up to 60 uA at 3 V (internal gate network), internal active drain clamp, ESD 4 kV HBM, SOT-23 G-S-D as BSS138BK, halogen-free per Diodes note 3, AEC-Q101. Drop-in with the external clamp (37.5 V peak stays below its 60 V clamp). onsemi BSS138 rejected (50 V, RDS(on) only to 4.5 V).
- 2026-09-27: BSS138BK datasheet filed (Rev 1). Confirmed: 60 V; VGS(th) 0.48 to 1.6 V; RDS(on) max 6.5 ohm at VGS 2.5 V / 10 mA, 2.2 ohm at 4.5 V; pins 1 G, 2 S, 3 D; ESD 1.5 kV HBM; AEC-Q101. Halogen declaration: to check (Nexperia product page).
- 2026-09-27: PMV50EPEA datasheet filed. Confirmed: -30 V, VGS +-20 V, RDS(on) max 45 mohm at -10 V, VGS(th) -1 to -3 V, pins 1 G, 2 S, 3 D, ESD > 2 kV HBM, AEC-Q101. D-40 decided (Prins). Halogen declarations of PMV50EPEA, BSS138BK and AO3407A still to check.
- 2026-09-27: 3.3 V LDO. TLV755P and AP2112K rejected: 5.5 V class, 5.25 / 5.5 = 0.95 against 0.7. LP2985-33 selected (SLVS522S, May 2025): VIN 2.5 to 16 V, abs max 16 V (legacy chip) or 18 V (new chip), ratio 0.33; -40 to 125 °C. Note: TI ships two dies under one part number (legacy CSO DLN/GF8, new CSO RFB, suffix M3). Legacy needs COUT >= 2.2 uF over temperature with an ESR window; new needs >= 1 uF effective, ESR < 1 ohm. Design to the legacy limit. Second source ST LD2985BM33R (Rev 16, 2021-08-30, read online, file not yet saved): 2.5 to 16 V, same pins (INHIBIT high = on, pin 4 BYPASS 10 nF), COUT 2.2 uF ceramic for 1.8 to 3.3 V. MIC5205 filed but rejected as second source: needs ESR up to about 5 ohm, ultra-low-ESR ceramic can oscillate.
- 2026-09-27: halogen checks closed for this design (design log D-42, private non-commercial project). Earlier 'halogen: to check' entries are not applicable.
- 2026-09-27: LD2985 datasheet filed (Rev 16, 2021-08-30). Second source for LP2985-33 confirmed as drop-in: same SOT-23-5 pins, 2.5 to 16 V, 10 nF bypass, COUT 2.2 uF ceramic at 3.3 V.
- 2026-09-27: power input protection (design log D-45). Fuse Littelfuse 0468001.NR (468 series, Rev GD 2022-11, read online; littelfuse.com refuses scripted downloads) and second source Bourns SF-1206S100-2 (filed, Rev J 2021-04; lower limit -20 °C). TVS Littelfuse SMBJ15A and SMBJ6.0A (Rev JC 2025-07, read online). Links for Prins: https://www.littelfuse.com/assetdocs/fuse-468-datasheet?assetguid=6b7857dc-f79c-4aae-8bcc-a9ef11ddef09 and https://www.littelfuse.com/assetdocs/tvs-diodes-smbj-series-datasheet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
- 2026-09-27: PCA9615 limiting values (Rev 2): VDD(A) and VDD(B) max +6 V, Tamb -40 to +85 °C. VDD(B) on +5V (5.25 V max) gives 5.25 / 6 = 0.875 against 0.7: fails. Open decision.
- 2026-09-27: RF detector (design log D-47, C-15). LM2901 filed (TI SLCS006Z, May 2025, LM339 family datasheet): -40 to 125 °C, supply 2 to 30 V, inputs -0.3 to 36 V, VIO max 15 mV over temperature, open collector. LM339 rejected (0 to 70 °C). BAS70: onsemi BAS70LT1/D Rev 12 (June 2023) read online, not saved (scripted download refused): 70 V, 70 mA, VF max 0.41 V at 1 mA, CT max 2 pF, SOT-23 pin 1 A, pin 3 K. Link: https://www.onsemi.com/pdf/datasheet/bas70lt1-d.pdf
- 2026-09-27: detector changed to a BAS70-04 doubler (design log D-48). Pin-out from onsemi BAS70-04LT1/D Rev 15 (read online, not saved: https://www.onsemi.com/download/data-sheet/pdf/bas70-04lt1-d.pdf): pin 1 anode, pin 2 cathode, pin 3 cathode/anode (series). ST BAS70 series (DocID 12563 Rev 2, 2009) gives the same ratings but no pin drawing. Application note TI SNOAA91 "Comparator Input Types" (May 2023) filed: LM339/LM393/LM2901 inputs are fault tolerant to 36 V, independent of VCC.

- 2026-09-28: application note Fairchild/onsemi AN-6602 "Low Noise JFET - The Noise Problem Solver" filed (from Prins). Reference for low-noise front ends (for example the RX loop preamp); no JFET in the rev C design. Key rules added to the hardware-design-rules skill (section 7).

- 2026-09-28: bias-T supply (design log D-54, C-17). IRFL9014 (Vishay Rev G, filed): -60 V, VGS +-20 V, RDS(on) 0.50 ohm max at -10 V, VGS(th) -2 to -4 V, RthJA 60 K/W on 1 inch2 FR-4, Tj max 150 C, SOT-223 1 G / 2 D / 3 S / tab D. Second source onsemi NTF2955 (Rev 8, 2024-12, read online; onsemi refused the scripted download): -60 V, VGS +-20 V, 150 mohm typ at -10 V, RthJA 65 K/W on 1 inch2, -55 to 175 C, same pin-out (style 3). Link: https://www.onsemi.com/pdf/datasheet/ntf2955-d.pdf. BC857B (Nexperia Rev 9, filed): VCEO -45 V, IC -100 mA, VBE -600/-650/-750 mV at -2 mA, SOT-23 1 B / 2 E / 3 C; also made by onsemi, Diodes, Infineon.

- 2026-09-28: NTF2955 datasheet filed (Rev 8). ESP32-C3-DevKit-RUST-2 user guide filed (candidate controller MCU board). Findings: ESP32-C3-MINI-1, 5 V to 3.3 V buck on the board, supply by USB-C, 5V pin or battery (mutually exclusive), I2C sensors ICM-42670-P 0x68 and SHTC3 0x70 on SDA GPIO10 / SCL GPIO8 (GPIO10 not on the headers), WS2812 on GPIO2, boot button GPIO9; user LED GPIO7 in the tables but GPIO10 in the revision notes (to confirm on the schematic).

- 2026-09-28: DevKit-RUST-2 schematic Rev 2.0 filed. Power path: USB VBUS - D6 B5819W - VBUS (header 26) - D4 B5819W - +5V - SY8088 buck (EN 10k pull-up, header ENABLE 27) - +3V3 (header 2). Q1 DMG3415U switches +BATT to +5V without VBUS. I2C on board: SDA GPIO7, SCL GPIO8 (header 12, 13), 10k pull-ups, SHTC3 0x70, ICM-42670-P 0x68. User LED on GPIO10 (not on the header), WS2812 on GPIO2. The user guide tables (LED GPIO7, SDA GPIO10) are out of date. Design log D-55.

- 2026-09-28: PC817X (Sharp D2-A03101EN) filed. VCEO 80 V (35 V before date code P7, July 2002), Viso 5.0 kV rms, IF 50 mA, VR 6 V, -30 to 100 C, CTR min 50 % at IF 5 mA, tr/tf typ 4 us max 18 us at IC 2 mA RL 100 ohm; Fig. 13 about 18 us at RL 1 kohm. Also made by Lite-On (LTV-817), Everlight (EL817), Vishay (similar). Design log C-18.

- 2026-09-28: link parts (design log D-58). VO2611 (Vishay 6N137 family Rev 2.2, filed): single channel pin-out 1 NC, 2 A, 3 C, 4 NC, 5 GND, 6 VO, 7 VE, 8 VCC; VF 1.4/1.7 V at 10 mA, VR 5 V, IF 20 mA, IF surge 200 mA for 100 us, IFH max 5 mA, VCC 4.5 to 5.5 V, VO max 7 V, CMTI 15 kV/us (6N137: 1 kV/us), -40 to 100 C; second source Broadcom HCPL-2611 (to file). Bourns 2036-09 (Rev B 01/26, filed): DC sparkover 72 to 108 V, impulse 250 V at 100 V/us and 550 V at 1 kV/us, >1e10 ohm, <2 pF, glow 70 V, arc 10 V, 20 kA 8/20 once, 10 kA x10, -55 to 105 C, B2 = THT leads. GDT second source to find.

- 2026-09-28: safety gate (design log D-59, C-19). TPS3823A-33 (TI SLVS165O, March 2025, filed): VIT- 2.83 / 2.93 / 3.00 V (A-33 only), watchdog time-out 0.9 / 1.6 / 2.5 s, reset delay 120 / 200 / 300 ms, push-pull RESET_N, VDD abs max 6 V (3.35 / 6 = 0.56), inputs max VDD + 0.3 V, -40 to 125 °C (A-33 only; other versions -40 to 85 °C). WDI: a floating input disables the watchdog (1 kohm to GND fitted). A version does not latch RESET low when WDI pulses during a reset. SOT-23-5: 1 RESET_N, 2 GND, 3 MR_N, 4 WDI, 5 VDD. Second source Maxim/ADI MAX823 (same pin-out, to confirm; analog.com refused the scripted download). SN74LVC1G74 (TI SCES794G, Sept 2021, filed): DCT (SM8) 1 CLK, 2 D, 3 Q_N, 4 GND, 5 Q, 6 CLR_N, 7 PRE_N, 8 VCC; VCC abs max 6.5 V (0.52); -40 to 125 °C for DCT and DCU; PRE_N and CLR_N both low gives a non-stable state (CLR_N is tied high here); Ioff. Second source Nexperia 74LVC1G74DC (to confirm pin-out). SN74LVC1G27 (TI SCES488E, Dec 2013, filed): 3-input NOR, DBV 1 A, 2 GND, 3 B, 4 Y, 5 VCC, 6 C; VCC abs max 6.5 V (0.52); -40 to 125 °C; Ioff. Second source Nexperia 74LVC1G27GW (to confirm).

- 2026-09-29: TX INH switches (design log D-77). CPC1117N (Littelfuse DS-CPC1117N-R12, 2024-06-06, filed): pin 1 + control, 2 - control, 3 and 4 load; 60 VP, 150 mA (derates to 100 mA at 85 °C), RON typ 5 max 16 ohm at 120 mA, IF to open max 1 mA (3 mA recommended above 60 °C), IF to close min 0.1 mA, VF 0.9/1.2/1.5 V at 5 mA, VR 5 V, IF 50 mA, ton/toff max 10 ms at IF 2 mA, 1500 Vrms, -40 to 85 °C, MSL 3; lead span 6.10 mm, pitch 2.54 mm. TLP4176G (Toshiba, 2026-04-07, filed): pin 1 anode, 2 cathode, 3 and 4 drain (same as CPC1117N); 350 V, 120 mA, RON typ 15 max 25 ohm, trigger IFC max 3 mA, return IFT min 0.1 mA, recommended IF 5 to 25 mA and -20 to 65 °C, abs -40 to 85 °C, 1500 Vrms; body 3.9 x 7.0 mm (lead span about 7.0 mm, from the Toshiba product page). Common footprint needs pads that cover both lead spans (to draw). Design drive: IF 5 mA. Voltage ratio 14.4 V / 60 V = 0.24 (factor 0.7): pass. Halogen: not stated in either datasheet, status unknown (to ask). Toshiba application notes AKX00730 (glossary, IFT and IFC test methods), AKX00765 (safety standards for photocouplers), AKX01280 (photorelay e-book: selection and design notes) filed as AN.

- 2026-09-29: loop current source (design log D-79, C-24). BCP53 (Nexperia Rev 11, 2025-09-30, filed): VCEO -80 V, VCBO -100 V, Ptot 0.65 W at Tamb 25 °C on the standard footprint (more with a 1 cm2 collector pad), Rth(j-a) 192 K/W, Tj 150 °C, hFE min 63 at 5 mA (-10 and -16), VCEsat max 0.5 V at 500 mA; SOT-223 marking BCP53/10, BCP53/16. Voltage 38 / 80 = 0.48 (factor 0.7): pass. Power in a short about 0.13 W against 0.57 W at 40 °C: 0.23 (factor 0.6): pass. Second sources: onsemi, Diodes (to confirm pin-out). BC857 (Nexperia Rev 9, 2022-07-01, filed): VCEO -45 V, Ptot 250 mW, Rth(j-a) 500 K/W, VBE -600 / -650 / -750 mV at VCE -5 V, IC -2 mA; hFE 125 to 800 (B: 220 to 475). In the source it sees VCE about 1.3 V only. Second sources: onsemi, Diodes, many (jellybean).

- 2026-09-30: shack interface regulators (design log D-81, D-82, C-25). L7805C (ST DS0422 Rev 38, February 2025, filed): VI max 35 V (14.4 / 35 = 0.41 pass), TOP 0 to 125 °C (C; AB -40 to 125 °C), VO 4.75 to 5.25 V at 5 mA to 1 A and VI 7 to 18 V, Isc 0.2 A at 35 V, dropout 2 V at 1 A; TO-220 RthJC 5 °C/W, RthJA 50 °C/W; TO-220 tab = GND (insulating pad on the housing wall). Second sources: TI UA7805, onsemi MC7805 (TO-220 pin-out IN, GND, OUT; to confirm). LD1117 (ST DocID2572 Rev 38, January 2025, filed): VIN max 15 V (5 / 15 = 0.33 pass), 800 mA, TOP -40 to 125 °C (C version, order code LD1117S33CTR) or 0 to 125 °C (standard), SOT-223 pin 1 ADJ/GND, 2 VOUT, 3 VIN, tab = VOUT; RthJC 15, RthJA 110 °C/W; output capacitor 10 uF minimum for stability (no ESR window stated). Second sources TI LM1117-3.3, Diodes AZ1117-3.3 (pin-out and capacitor rules to confirm per maker).

- 2026-09-30: power entry parts (design log D-73, M-14). SMBJ series (ST DS1283 Rev 14, April 2026, filed): 600 W 10/1000 us, 4 kW 8/20 us, Tj -55 to 150 °C, typical failure mode short (the fuse then opens), UL497B, MSL 1. SMBJ16A: VRM 16 V, VBR 17.8 to 18.7 V, VCL 26 V at IPP 23.1 A. SMBJ15CA: VRM 15 V, VBR 16.7 to 17.6 V, VCL 24.4 V at 25.1 A. Second sources Littelfuse, Vishay SMBJ (same package and ratings, to confirm). SS34 (Vishay document 88751, 2020-04-23, filed): VRRM 40 V (14.4 / 40 = 0.36 pass), IF(AV) 3 A (0.2 / 3 = 0.07), IFSM 100 A, VF 0.5 V max at 3 A, Tj -55 to 150 °C, RthJA 55 °C/W, SMC (DO-214AB): footprint D_SMC. Order code SS34-M3/57T = halogen-free (M3). Second sources onsemi, Diodes SS34 (package and pin-out to confirm).

- 2026-10-02: radio port connector (design log D-85). MD-SM series (Same Sky rev 1.09, 2024-09-12, filed as MD-80SM_SameSky_DS_Rev1.09_2024-09-12.pdf): rated 100 Vac 1 A and 12 Vdc 2 A, contact resistance 30 mohm max, insulation 50 Mohm min at 250 Vdc, withstand 250 Vac 1 min, -40 to 85 °C, 1000 cycles, UL94V-0, RoHS. Shield SPCC tin, earth terminal brass tin, contacts phosphor bronze silver. Footprint changed for date codes after 2022-03-03 (8 x 0.9 mm holes, shield tabs as slots); use the new layout. Underload: current per pin below 0.1 A against 2 A (0.05, pass); temperature shack 40 °C plus small self-heating against 85 °C (pass, below 68 °C); voltage 14.4 V against 12 Vdc gives 1.2 (fail against 0.7), against 100 Vac gives 0.14. Documented exception (design log D-87, Prins): 12 Vdc 2 A is a nominal contact rating; insulation (250 Vac, 0.06) and contact power (24 W against 1.4 W, 0.06) are leading. Halogen: not stated, status unknown (to ask).

- 2026-10-03: keying OptoMOS candidate (design log D-88). CPC1017N (Littelfuse R13, 2024-06-19, filed): marked "Not For New Designs". 1-form-A, 60 VP, 100 mA (80 mA at 85 C), RON max 16 ohm, IF to operate max 1 mA (3 mA recommended above 60 C), VF 0.9/1.36/1.5 V at 5 mA, VR 5 V, IF max 50 mA, ton/toff max 10 ms, 1500 Vrms, -40 to 85 C, MSL 3, halogen-free, SOP4 lead span 6.10 mm (same package as CPC1117N). Not selected: replacement to find (decision 24).

- 2026-10-03: Yaesu FC-40 antenna tuner manual with circuit diagram (from Prins), filed as FC-40_Yaesu_MAN_EN.pdf (type MAN, reference for the FT-710 TUNER/LINEAR port, design log A-18). Tuner side of the port: TX_INH driven high through RB521S-30 and 270R (47k pull-down); TX GND pulled up through 47k and RB521S-30 (radio open collector); RESET, DATA IN, DATA OUT through 270R, 100 uH and 1 nF; +13.5 V from the radio through 120 uH.
- 2026-10-03: radio port ESD parts (design log D-89): Nexperia PESD15VL1BA (bidirectional, 15 V, SOD-323) and Bourns CDSOD323-T15C as second source: datasheets to file, ratings to confirm.

- 2026-10-03: TX INH HIGH clamp (design log D-90): Nexperia BZX384-C5V1 (SOD-323, 5.1 V), second source onsemi MM3Z5V1: datasheets to file. Load 4.2 mA, 21 mW (Ptot 300 mW to confirm).

- 2026-10-04: keying OptoMOS candidates (decision 24). TLP176AM (Toshiba Rev 7.0.A, 2026-04-07, filed): 1-form-A, VOFF 60 V, ION 700 mA, RON max 2 ohm, IFT max 3 mA, IFC min 0.1 mA, VF 1.1/1.27/1.4 V at 10 mA, VR 6 V, IF 50 mA, recommended IF 5 to 25 mA and VDD max 48 V, ton/toff max 3 / 0.5 ms, 3750 Vrms, -40 to 110 C, halogen-free, in mass production since 2018-02 (successor of the TLP172A, which is not recommended for new design). Package 4-pin SO6 (11-4M1S): pitch 2.54, lead span 7.0 +-0.4, body 3.7 x 4.55; pins 1 anode, 3 cathode (same side), 6 drain opposite pin 1, 4 drain opposite pin 3 = same physical layout as the CPC1117N SOP4 (1, 2, 4, 3). AQY212G3HS (Panasonic ASCTB133E, 2026-10, filed): 1-form-A, VL 60 V (recommended max 48 V), IL 1.8 A, Ron max 0.15 ohm, IFon max 3 mA, IFoff min 0.2 mA, VF max 1.5 V, VR 5 V, IF 50 mA, recommended IF 5 to 30 mA, ton/toff max 7.5 / 0.5 ms, 3750 Vrms, -40 to 105 C; SOP4 pitch 2.54, lead span 6.8 +-0.4, pad pattern 6 mm; pins 1 anode, 2 cathode, 3 and 4 load (as CPC1117N). Halogen status not stated (to ask). Underload for keying: 14.4 V / 60 V = 0.24 (both); LED 7 mA within the recommended range of both.
- 2026-10-04: ESD clamps (design log D-89). PESD15VL1BA (Nexperia, 2023-04-13, filed): bidirectional, VRWM 15 V, VBR 17.1/18.9/20.3 V at 5 mA, VCL 25 V at 1 A (44 V at IPPM), IRM max 50 nA, Cd 16 pF, PPPM 200 W and IPPM 5 A (8/20 us), IEC 61000-4-2 30 kV contact / 15 kV air, Tj 150 C, SOD323 (marking AE). CDSOD323-T15C (Bourns REV. 04/23, filed): bidirectional, VWM 15 V, VBR min 16.7 V at 1 mA, VC max 24 V at 1 A, ID max 1 uA, CJ 3 pF, PPP 350 W, 30 kV ESD, -55 to 150 C, SOD-323. Both drop-in on one SOD-323 footprint (no polarity). 14.4 V line against VRWM 15 V: TVS standoff, not a 0.7 voltage rating (same rule as the SMBJ16A on the 13.8 V input).
- 2026-10-04: HIGH-level zener (design log D-90). BZX384-C5V1 (Nexperia Rev 4, 2023-01-01, filed): Ptot 300 mW at 25 C, Tj 150 C, SOD323, marking D5. MM3Z5V1 (onsemi Rev 15, 2026-02, filed): PD 300 mW (FR-4 minimum pad) / 500 mW, -65 to 150 C, SOD-323, order code MM3Z5V1T1G. Load 21 mW: 21 / 252 mW at 45 C = 0.08.
- 2026-10-04: TLP176AM selected for keying (design log D-91, Prins option 1); AQY212G3HS second source.
- 2026-10-04: DevKit-RUST-2 header check (corrected after Prins's remark): the schematic symbol U4 "Rust_Board" (pins 1..30) is a logical symbol, not the header layout. Physical headers per the user guide Header Block table and photo: left 16 positions (RST, 3V3, NC, GND, IO0..IO8, IO21, IO20, IO9), right 12 positions (BAT+, EN, 5V, NC x5, IO18, IO19, NC, NC), plus a separate battery connector BAT+/BAT-. Board I2C on IO7 (SDA) / IO8 (SCL), schematic nets; the user guide I2C table (SDA GPIO10) and LED on GPIO7 are out of date (LED on GPIO10, silkscreen IO10). Table names left 14 RX/U0RXD for GPIO21 (U0TXD): naming error. Design log D-93.
- 2026-10-04: ESP32-C3-DevKit-RUST-1 schematic filed: ESP32-C3-DevKit-RUST-1_esp-rs_SCH_2022-05-02.pdf (Rev 1.2a, drawing date 2022-04-27; github.com/esp-rs/esp-rust-board commit efe1e8ad5c). This is the board in use (Prins). SDA GPIO10 (header pad 17), SCL GPIO8 (pads 13 and 18), LED GPIO7, power path as RUST-2. The Espressif user guide (esp-dev-kits) is a general dev-kit document and does not describe this board correctly. KiCad symbol, footprints (Rust_Board, Rust_Board_Shield, GCT_USB4105-GF-A), USB4105-GF-A STEP and the board PCB copied to hardware/shack-interface/lib/esp-rust-board (CERN-OHL). Design log D-93, D-94, A-19.
- 2026-10-04: SnapEDA ESP32-C3-DevKit-RUST-1 files (symbol, footprint MODULE_ESP32-C3-DEVKIT-RUST-1, STEP of the whole board, PARTREV 1.2), supplied by Prins, stored unchanged in hardware/shack-interface/lib/snapeda-devkit-rust-1. Footprint geometry agrees with esp-rs Rust_Board. STEP: SolidWorks 2021, mm, Y up, PCB 0 to 1.6 mm, USB-C overhang 1.76 mm. Used as the 3D model of the own footprint (design log D-95).
- 2026-10-04: Sullins Female Headers .100 datasheet filed (Sullins_Female-Headers-100_DS_2018-10-30.pdf, supplied by Prins). PPTC161LFBN-RC / PPTC141LFBN-RC: PP = polyester/phosphor bronze, T = tin, C = 2.54 mm, 16 or 14 positions, 1 row, LFB straight, N no mounting; height 8.50 mm, tail 3.20 mm, insertion depth 6.00 mm, 3 A, UL94V-0, recommended hole 1.02 mm. Gold flash variant: PPPC. Used for the DevKit sockets (design log D-95).
- 2026-10-04: DevKit sockets on both boards: gold-flash variant Sullins PPPC161LFBN-RC (1x16) and PPPC141LFBN-RC (1x14), Prins (gold to match the DevKit pins). Same datasheet (Sullins_Female-Headers-100_DS_2018-10-30.pdf). Design log D-95.
- 2026-10-04: DevKit right socket changed to PPPC121LFBN-RC (1x12, gold flash): the DevKit right header has 12 pins (Prins). Shack interface USB-C J14: GCT USB4105-GF-A (drawing https://gct.co/files/drawings/usb4105.pdf, to file) and ESD array ST USBLC6-2SC6 (datasheet Rev 7 2021-12, to file: download from st.com failed in this session). Design log D-95, D-96.
- 2026-10-04: USB-C J14 datasheets filed (supplied by Prins). ST USBLC6-2 (DS4260 Rev 7, 2021-12): pins 1, 6 I/O1, 2 GND, 3, 4 I/O2, 5 VBUS; IRM max 150 nA at VRM 5.25 V; VBR min 6 V (VBUS to GND); VCL max 12 V at 1 A, 17 V at 5 A (8/20 us, I/O to GND); C I/O-GND max 3.5 pF; IEC 61000-4-2 15 kV contact and air; Tj -40 to 150 C. UMW USBLC6-2SC6 (UTD Semiconductor, Nov 2024): same pin-out; VRWM 5 V, VBR 6 to 9 V, IR max 0.1 uA at 5 V, VC max 10 V at 1 A, 15 V at 6 A, Ipp 6 A, CJ max 1 pF, IEC 61000-4-2 30 kV, TJ -55 to 125 C, halogen-free: pin-compatible second source. GCT USB4105 product specification (Rev A3, 2023-02-27): VBUS 5 A collectively, GND 6.25 A, other pins 0.25 A each, 48 V DC, -40 to 85 C, insulation 100 Mohm min at 100 V DC, contact resistance 50 mohm max after durability. Underload (C-26): VBUS 5.25 V against ST VRM 5.25 V (rated working point; VBR min 6 V: 0.875) and against UMW VRWM 5 V (1.05; VBR min 6 V: 0.875): documented exception as D-45 (TVS: the stand-off voltage is the design point, margin on VBR min); data lines 3.6 V max against 5.25 V (0.69) / 5 V (0.72). Connector: 5.25 V / 48 V = 0.11; VBUS carries only the ESD array and 100 nF; 40 C / 85 C = 0.47. Design log D-96.
- 2026-10-05: Amphenol FCI USB Type-C family brochure filed (USB-Type-C_Amphenol-FCI_BROCHURE_2025-07.pdf, supplied by Prins) for the J14 second-source candidate 10164359-00011LF. Family values only (no part drawing, no land pattern): durability 10,000 cycles, 3.0 A continuous, 5.0 A VBUS and GND, 0.25 A other contacts, 100 V AC/DC, withstand 500 V AC, insulation 100 Mohm, LLCR 40 mohm max, gold flash, -25 to 85 C, product specification GS-12-1351. Underload against the J14 use: 5.25 / 100 V = 0.05, 40 / 85 C = 0.47, pass. Footprint match with the GCT USB4105 (KiCad USB_C_Receptacle_GCT_USB4105-xx-A_16P_TopMnt_Horizontal) not checked: part drawing 10164359 needed (amphenol-cs.com blocked from this session). Design log D-96.
- 2026-10-05: GCT USB4215 product specification filed (USB4215_GCT_SPEC_RevA_2024-04-26.pdf, supplied by Prins) for the J14 candidate USB4215-03-A: USB 2.0 Type-C, SMT, PCB top mount, horizontal, 16 pins; VBUS 5 A collectively, GND 6.25 A, other pins 0.25 A; 48 V DC; -25 to 85 C; insulation 100 Mohm min at 500 V DC; durability 20,000 cycles (plug replaced after 10,000). Ratings the same as the USB4105 except the lower temperature limit (-25 C against -40 C; shack indoors, no effect). Same maker as the USB4105, so not an independent source (R-10). No drawing in the specification: land pattern against the USB4105 footprint not checked (gct.co and the Digi-Key model downloads are blocked from this session). Design log D-96.
- 2026-10-05: Same Sky UJ20-C-H-G-SMT-1-P16-TR datasheet filed (2024-09-12, supplied by Prins). USB 2.0 Type-C, SMT top mount, 16 pins; 48 V DC; 5.0 A power pins collectively, 1.25 A VCONN, 0.25 A other pins; contact resistance 40 mohm max; insulation 100 Mohm at 100 V DC; withstand 100 V AC 1 min; 10,000 cycles; -25 to 85 C; housing PA9T UL94V-0, contacts C1815 with 3 u-inch gold on 50 u-inch nickel, shell SUS304 nickel. Recommended PCB layout against the GCT USB4105 pattern (esp-rs copy), relative to the signal-pad row: 12 pads 0.30 / 0.60 wide at the same pitch (outer GND 6.40, VBUS 4.80, 3.50, 2.50, 1.50, 0.50 mm), pad length 1.15 mm; front shell slots 0.6 x 1.7 in 2.1 mm pads at 0.565 mm (GCT 0.575); rear slots 0.6 x 1.4 in 1.8 mm pads at 4.745 mm (GCT 4.755); legs 8.64 mm apart (GCT 8.64); locating pegs 2 x 0.65 mm, 5.78 mm apart, at 1.065 mm (GCT 1.075). The 0.01 mm differences are within the 0.05 mm PCB tolerance of the drawing: drop-in on the same footprint. Shell legs 0.96 mm below the seating plane (drawing for a 0.80 mm board): on the 1.6 mm board the legs do not reach through; solder fill from the top side only (GCT leg length not on file). Underload: 5.25 / 48 V = 0.11, 40 / 85 C = 0.47, pass. Design log D-96.
- 2026-10-05: halogen status of CPC1117N, TLP4176G and MD-80SM (PBT body, UL94V-0): not stated by the makers. Marked only, no action (Prins, 2026-10-05; halogen checks not applicable to this private project, design log D-42).
- 2026-10-05: footprints from the filed datasheets. Common photorelay land SOP-4_P2.54mm_PhotoRelay_LongPad for CPC1117N, TLP4176G, TLP176AM, AQY212G3HS (design log D-99, C-28). MD-80SM: MD-SM rev 1.09 layout for date codes after 2022-03-03 (D-100); the SamacSys footprint does not match the datasheet and is not used.
- 2026-10-05: Kycon KMDGX series datasheet filed as KMDGX-8S-BS_Kycon_DS_0418.pdf (footer 0418, PDF dated 2026-01-26, supplied by Prins). KMDGX-8S-BS: fully shielded, PBT body, gold-plated copper-alloy contacts, 12 Vdc 2 A, 500 Vrms 1 min, insulation 500 Mohm at 500 Vdc, -25 to +80 C, 1000 cycles. Tail positions match the MD-80SM footprint (design log D-100, M-28); no hole sizes given. Halogen: not stated, marked only.

- 2026-10-07: CPC1117N end of life: Littelfuse PDN EIC-1177 (2026-08-13, filed) phases out the PCB SSR family, CPC1117N and CPC1117NTR included; last-time buy until 2026-11-11. TX INH changed to TLP4176G (primary) and Panasonic AQY412S (second source), design log D-106. AQY412S (ASCTB140E 201404-T, filed): 1-form-B, VL 60 V, IL 0.5 A, Ipeak 1.5 A, RON typ 1 max 2.5 ohm, IFoff typ 0.9 max 3 mA, IFon min 0.4 mA, VF max 1.5 V at 50 mA, IF max 50 mA, VR 5 V, Viso 1500 V AC, -40 to 85 C, Toff max 3 ms, Ton max 1 ms; pins 1, 2 LED and 3, 4 load (drawing; LED polarity of pin 1 to confirm on the full drawing); body 4.3 x 4.4 x 2.1 mm, no lead-span dimension in this short form (GU SOP4 span 6.8 +-0.4 per ASCTB133E, to confirm). Underload at the shack interface: 14.4 / 60 = 0.24, LED 7 mA / 50 mA = 0.14, 40 / 85 C = 0.47: pass. Halogen: not stated, marked only (D-42).
- 2026-10-07: AQY41xS catalog ASCTB140E 202601 filed (supplied by Prins). Dimensions: body 4.3 x 4.4 +-0.2, lead span 6.8 +-0.4, terminal 0.4 wide, about 0.5 long, pitch 2.54; recommended pad 0.8 x 1.2 on 6.0 centres (same as AQY212G3HS). Pin 1 = LED anode, 2 = cathode, 3 and 4 = load (schematic on page 1). Fit on the common land (D-99): toe 3.2 to 3.6, heel from 2.7, inside the pad 1.90 to 4.00: pass. The open points of D-106 are closed.
- 2026-10-10: halogen policy applies (design log D-107, supersedes D-42). Parts marked 'not stated, marked only' or 'unknown, to check' need the maker's material declaration.
- 2026-10-19: SMA panel jacks filed (D-108). 132142 and 901-9215 have the same outline: flange 12.70 mm square, 1.65 mm thick, 4 holes 2.60 mm on 8.64 mm, 1/4-36UNS-2A thread. Front face to flange rear 9.53 mm, overall 14.60 mm ref, so the contact (dia 1.27 mm, cup opening 0.76 to 0.95 mm) reaches 5.07 mm behind the flange. No body behind the flange. 132142: body brass gold, insulator Teflon, contact BeCu gold. 901-9215: body stainless steel gold, contact BeCu gold, insulator PTFE, DC to 18 GHz, -65 to +165 C, 100 cycles. No voltage or power rating on either drawing (to confirm). Halogen: PTFE and metal parts, epoxy captivation in 901-9215; maker declaration to check (D-107).
- 2026-10-19: DigiKey NL check per hardware-design-rules v2.2 section 2 (product page Substitutes, stock, Part Status), 13 parts, design log M-41. PCA9539D,118 (NXP, SOIC-24W): Obsolete; Direct substitute TI PCA9539DWR (1,690 in stock), Similar NXP PCA9539PW,118 (TSSOP). TCA9539 has no SOIC-24W variant (to confirm). BSS138BK,215: 0 in stock (backorder 2 Nov); Direct substitute onsemi 2V7002KT1G (103k); DMN61D8L-7 datasheet is "Advanced Information": replace as second source after a limits check (RDS(on) at VGS 3.3 V). PMV50EPEAR: 0 in stock, Similar only (onsemi FDN360P, TSC TSM650P03CX); AO3407A not on the DigiKey list. TPS3823A-33DBVR: 0 in stock, TI-only substitutes. Jellybean confirmed (second source to record by order code): BC857B (Diodes BC857B-7-F, Direct), BCP53-16 (ST BCP53-16, Direct), BC847B (Diodes BC847B-7-F, Direct), LM2901DR (ST LM2901DT, onsemi LM2901DR2G, Similar), LD1117S33CTR (ADI LT1117CST-3.3 Direct, onsemi NCP1117ST33T3G Similar), L7805CV (TI UA7805CKCS Direct, onsemi MC7805CTG Similar). LP2985-33DBVR: no DigiKey substitutes; ST LD2985BM33R stays the second source. IRFL9014: onsemi NTF2955T1G (Similar). Zero stock at DigiKey NL today: BSS138BK, PMV50EPEA, BC857B, BCP53-16, LM2901DR (TI), TPS3823A-33. About 25 parts (relay, optos, photorelays, TVS, connectors, GDT) still to check: DigiKey bot check stopped the session.
- 2026-10-19: decisions after the v2.2 review (design log D-126 to D-130). PCA9539: order code TI PCA9539DWR on all boards (single source in SOIC-24W, fallback TSSOP-24). BSS138BK second source onsemi 2V7002KT1G (limits to compare; DMN61D8L-7 retired). New parts, datasheets to file and DigiKey check to finish: Bourns CAT16-103J4LF 10k x4 array (second source Yageo YC164-JR-0710KL); 47 uF 25 V aluminium polymer 6.3 mm SMD (part to select, two makers); TDK ACT45B-510-2P-TL003 51 uH common-mode choke (second sources Murata DLW43SH510XK2L, Coilcraft 1812CAN-513; land pattern to compare with the Coilcraft 1812CAN footprint); 1 uF X7R 0603 16 V and 1 uF X7R 0805 50 V (jellybean); 1 nF 1 kV 1206 Y-capacitor footprints (DNP).
- 2026-10-19: PCA9539 back to TSSOP-24 (design log D-133, supersedes D-126). Sources, same pin-out, compared line by line: NXP/Nexperia PCA9539PW,118 (NXP DS Rev 9.1, filed; Nexperia product page lists PCA9539PW in production), TI TCA9539PWR (SCPS202C, Rev C, May 2016: no I/O pull-ups, RESET sets all I/O as inputs, tW 6 ns, VCC 1.65 to 5.5 V), Diodes PI4IOE5V9539LEX (datasheet 2016-06-0005: VCC 2.3 to 5.5 V, -40 to 85 °C, input leakage 1 uA max, so no pull-ups; tw(rst) 25 ns). To file: TI SCPS202C (https://www.ti.com/lit/gpn/TCA9539) and the Diodes datasheet (https://diodes.com/datasheet/download/PI4IOE5V9539.pdf). Stock at two distributors still to check (DigiKey bot check).
- 2026-10-19: TCA9539 (SCPS202C) and PI4IOE5V9539 (PT0549-4) datasheets filed (downloaded by Prins). Stock: PCA9539PW,118, TCA9539PWR and PI4IOE5V9539LEX available (Prins, 2026-10-19). Jellybean check for the expander passed: three makers, same pin-out, in stock. 0.65 mm pitch accepted for hand soldering (Prins).
- 2026-10-19: 2V7002KT1G (onsemi 2N7002K/D Rev 20, October 2023, read online; file to add) compared with BSS138BK: VDSS 60 V, VGS +-20 V, VGS(th) 1.0 to 2.3 V (VGS = VDS, 250 uA), RDS(on) max 2.5 ohm at VGS 4.5 V and 1.6 ohm at 10 V, no value below 4.5 V; ESD 2 kV HBM; IGSS 150 nA at 5 V; SOT-23 pin 1 G, 2 S, 3 D; halogen-free. The coil drivers see about 3.25 V on the gate: RDS(on) there is not specified (design log D-128).
- 2026-10-19: coil MOSFET second source, candidates from Prins (all in stock) compared with BSS138BK (Nexperia Rev 1: 60 V, VGS(th) 0.48 to 1.6 V, RDS(on) max 6.5 ohm at 2.5 V / 10 mA, pins 1 G, 2 S, 3 D). Drain peak 37.5 V needs at least 53.6 V (factor 0.7). Diotec MMFTN138K (SOT-23, version 2026-05-19): 60 V, VGS +-20 V, VGS(th) 0.48 to 1.6 V, RDS(on) max 2.2 ohm at 4.5 V / 200 mA and 6.5 ohm at 2.5 V / 10 mA, ESD 2 kV, pins 1 G, 2 S, 3 D, -55 to 150 C; AEC-Q101 with suffix -Q / -AQ: drop-in, pass. Halogen: RoHS stated, halogen not stated (to check). ROHM BSS138BKT116 and BSS138BKAHZGT116 (SST3): 60 V, VGS(th) 0.8 to 2.0 V (10 uA), RDS(on) max 4.0 ohm at 2.5 V / 10 mA, ESD 2 kV, halogen-free, but pins 1 S, 2 G, 3 D: gate and source change places on our footprint: not a drop-in. ROHM BSS138BKW and Panjit 2N7002KW-AU: SOT-323, other footprint. Panjit PJA138K: 50 V, 37.5 / 50 = 0.75 above the 0.7 factor: fail. onsemi 2N7002K / 2V7002K: no RDS(on) below 4.5 V (D-128).
- 2026-10-19: RJ45 unshielded candidates for the EXP CTRL jack (controller board J1). All three have the same hole pattern: pegs dia 3.2 at +-5.715 mm, pins on 1.27 mm pitch in two rows 2.54 mm apart, rows 6.35 and 8.89 mm behind the peg line. Wurth 615008137121: pin hole 0.90, front face 7.88 mm from the peg line, height about 11.65, PBT UL94 V-0, 1.5 A, 120 V AC, 1000 V AC withstand. Amphenol FCI 54602-908LF: pin hole 0.76, face 7.62 mm, height about 12.7, glass-filled polyester V-0. Molex 95501-2881: pin hole 0.889, face 7.93 mm, height 11.50, LCP V-0 (vendor footprint plates the pegs). Halogen status not stated on any of the three (to check, D-135).
- 2026-10-20: board-to-board J2 (A-24). Samtec ESW/ESQ F-226: B = seating plane to insulator top. Lead style -12/-37: A 2.29, B 11.05; -33/-58: A 2.29, B 16.13; -44/-69: A 4.57, B 18.67. Insertion depth 3.68 to 6.35 mm, 5.7 A per pin (ESQ/TSW), 515 V AC, black glass-filled polyester, phosphor bronze, -55 to +125 C with gold. ESQ-112-37-G-D-LL STEP (Prins): insulator 8.51 + spacer 2.54 = 11.05 mm, tails 2.29 mm: confirms B. With the standard 2 x 12 header on the RF board (pin top 8.54 mm above the RF board), -37 leaves 0.11 mm gap (no engagement); -33/-58 gives about 4.9 mm. Halogen status not stated (D-135).
- 2026-10-20: DevKit low-profile socket candidate (Prins). Samtec SLW Rev X: insulator 4.57 mm, tail 2.92 mm, contact C-28, closed bottom; mates with TLW / TSW short posts, insertion depth 2.16 to 2.92 mm (distributor data, to confirm on the Samtec catalogue). STEP SLW-116-01-G-S: body 0 to 4.57 mm, contact top 0.76 mm below the socket face. The DevKit header posts (standard header, about 6 mm, to measure) are longer than the socket takes. Not used (D-140).
- 2026-10-22: controller board open points (design log C-37, C-38, D-148). ESP32-C3 datasheet v1.7 (2024-04-01, not filed): Modem-sleep 160 MHz CPU running 23 / 28 mA typ (peripheral clocks off / on), Wi-Fi TX peak 335 mA (not used). LP2985 DBV RthJA 205.4 degC/W (TI Rev S). Supervisor second sources for TPS3823A-33: ADI MAX823SEUK+T (19-0487 Rev 5: pin-out 1 RESET_N, 2 GND, 3 MR, 4 WDI, 5 VCC; VTH S 2.85 to 3.00 V; tWD 1.12 / 1.6 / 2.4 s; tRP 140 / 200 / 280 ms; WDI floating disables; timer held cleared during reset; RESET sources 150 uA at VOH; -40 to 125 degC; to file) and Diodes APX823-29W5G-7 (DS31323 Rev 5-2, Feb 2024: VTH 2.80 to 3.05 V at -40 to 85 degC; tWD 1.12 / 1.6 / 2.4 s; td 140 / 200 / 280 ms; WDI floating disables; halogen and antimony free; to file). TDK ACT45B (2016-02): body 4.5 x 3.2 x 2.8 mm, 50 V, -40 to 150 degC; land pattern drawing to file and compare with the Coilcraft 1812CAN footprint. Halogen status: no statement found for Wurth 615008137121, Samtec ESQ (product page: RoHS, UL E111594 only) or the JLCPCB laminate; material declarations to request.
- 2026-10-22: filed ACT45B_TDK_DS_2016-02-16_zh.pdf (TDK ACT45B, Chinese edition, LCSC copy; land 5.9 x 3.4 / 3.2 x 1.6 mm, windings 1-4 and 2-3, starts 1 and 2 at one end; design log M-64), MMU-MMA-MMB_Vishay_DS_28963_2026-06-02.pdf (pulse load charts: MMB 0207 single pulse 220 W to 100 us, 10/700 us test voltage about 126 V at 47 ohm; MMA 0204 100 W, about 190 V at 220 ohm; design log C-39), APX823_Diodes_DS_DS31323-Rev5-2_2024-02.pdf (D-148). ADI MAX823-MAX825Z.pdf not filed (download refused by analog.com to scripts).

- 2026-10-22: GDT second source (design log D-149). Littelfuse SL1003A090R-001: DC 72 / 90 / 108 V, impulse 700 V at 100 V/us and 1 kV/us column (sheet), 10 kA 8/20 x10, 300 x 200 A 10/1000 us, arc about 10 to 35 V, -40 to 90 degC; body dia 6.0 x 8.1, 12.2 mm overall, leads 0.8 at pitch 4.4 +-0.3. Rejected: TDK T83-A90X (B88069X8300B502; dia 8, leads 1.0 at 4.4, 13.4 mm overall; sheet of T83-C600X Issue 04 2008-06-26 checked for the body), Socay SC3E5-90LM (Revision 2019-01-04: halogen-free, dia 5 x 7.6, lead pitch 3.8). Halogen status of SL1003A: no statement on the sheet (RoHS only).
- 2026-10-22: U13 and U14 second sources (design log D-154, M-68). Nexperia 74LVC2G74 (Rev. 16, 2025-09-22; filed as 74LVC2G74_Nexperia_DS_Rev16_2025-09-22.pdf): single D flip-flop with set and reset; DC = VSSOP8 SOT765-1 (MO-187; HE 3.0 to 3.2, e 0.5); pins 1 CP, 2 D, 3 Q_N, 4 GND, 5 Q, 6 RD_N, 7 SD_N, 8 VCC (same as TI SN74LVC1G74 DCT/DCU, SCES794G); VCC abs max 6.5 V; -40 to 125 degC; Schmitt-trigger inputs; SD_N and RD_N both low gives Q = Q_N = H (CLR_N is tied high here). TI DCU land (SCES794G): 8 x 0.85 x 0.3 mm, pitch 0.5, rows 3.1 mm. Nexperia 74LVC1G27 (Rev. 6, 2023-08-16; filed as 74LVC1G27_Nexperia_DS_Rev6_2023-08-16.pdf): GW = SOT363-2, GV = SOT457 (SC-74; D 2.7 to 3.1, E 1.3 to 1.7, HE 2.5 to 3.0, e 0.95); pins 1 A, 2 GND, 3 B, 4 Y, 5 VCC, 6 C (same as TI DBV); VCC abs max 6.5 V; -40 to 125 degC. TI SN74LVC1G27 DCK (SC70, SCES488E filed): same pin-out as DBV, -40 to 125 degC. onsemi NC7SZ27 (Rev. 4, August 2024; read in the browser, not filed: onsemi refuses scripts): 3-input NOR, SC-88 (SC70-6) pins 1 A, 2 GND, 3 B, 4 Y, 5 VCC, 6 C; VCC abs max 6.5 V; operating -40 to +85 degC (0.8 x 85 = 68 degC against R-04 45 degC: passes); NC7SZ27P6X marked DISCONTINUED in the ordering table; NC7SZ27P6X-L22347 listed without that mark (status to confirm). Halogen free (sheet).
- 2026-10-25: Cinch/Johnson 142-0701-631 added as second source for the EXP SMA (D-174). Vendor STEP filed as hardware/unit/case/ref-sma-142-0701-631.step: flange 12.7 mm square, 1.57 thick, holes 2.59 on 8.64, rear contact 1.27 mm, 5.21 mm long. Series datasheet: 335 Vrms working, 1000 Vrms DWV, brass body, 142-0701-631 gold plated (datasheet: body MIL-G-45204 0.25 um min., contacts 0.76 um min., 1.27 um nickel underplate); dimensions of the vendor STEP accepted by Prins (2026-10-25), BeCu contact, PTFE. Amphenol RF 132166 STEP also checked: rear tab 2.54 mm, does not fit the 4 mm wall.
