PE1RGU/hf-antenna-switch/archive/README.md

# Archive

Superseded designs. Kept for the record of how the design changed. Not maintained.

| Folder or file | Content | Superseded by |
|---|---|---|
| architecture-v0.1-2026-09-09.md | First architecture: TX bus and RX matrix, RS-485 | Rev C (docs/architecture.md) |
| architecture-rev-c-summary-2026-10-06.md | Rev C summary from the claude.ai Project (claude/architecture-rev-c.md): decisions, RF line, spacing check, placement study, case, open items | docs/architecture.md and docs/design/ (rf-board.md, controller-board.md, case.md), 2026-10-06 |
| block-diagram-rev-a-2026-09/ | Rev A card documents (radio port, antenna port, controller) and site plan rev B, with their HTML generators | Rev C |
| rev-b-backplane-2026-09/ | Card cage with DIN 41612 backplane, RF isolation coupons | Rev C, 2026-09-27 (D-01) |
| 2x1_as/ | Early KiCad project (2 x 1 antenna switch) | Rev C |
| controller-board-fab-c-s2-2026-10-22/ | Controller board fabrication files, layout c-s2 (Gerber and drill zip, Fabrication Toolkit, M-67): U13 in SSOP-8 DCT | Layout c-s3 (D-154, M-68), hardware/unit/controller-board/production/, 2026-10-22 |
| controller-board-fab-c-s3-2026-10-23/ | Controller board fabrication files, layout c-s3 (D-154, M-68): U13 VSSOP-8, 90-degree bends | Layout c-s4 / c-s5 (D-158, D-159), hardware/unit/controller-board/production/, 2026-10-23 |
| controller-board-fab-c-s4-2026-10-23/ | Controller board fabrication files, layout c-s4 (D-158, M-72): 45-degree bends, plain T-junctions | Layout c-s5 (D-159, M-73), hardware/unit/controller-board/production/, 2026-10-23 |
