PE1RGU/hf-antenna-switch/archive/rev-b-backplane-2026-09/README.md

# Archive: rev A/B card cage and DIN 41612 backplane (2026-09)

Superseded by architecture rev C (flat 3 radio x 4 antenna unit in a milled aluminium case), 2026-09-27.

Contents:
- backplane/: KiCad backplane (schematic, PCB, generators, XT 3D models, JLC order checklist, RVS box sketch).
- rf-isolation/: RF isolation test coupons for RF through the DIN 41612.
- block-diagram/: architecture rev A, its generator and page.
- Claude outputs/: backplane L1 detail and the RF isolation test spec.

Still valid in rev C and taken over: JLC stackup method and impedance check, markings (HV triangle, date code, no UL mark),
chassis-bond rule, XT power entry and the open XT polarity check (see project doc decisions-2026-09-26-backplane.md).
The XT STEP models are in backplane/backplane.3dshapes/.
