PE1RGU/hf-antenna-switch/docs/design/display-mockups/B2-flow-modern.png

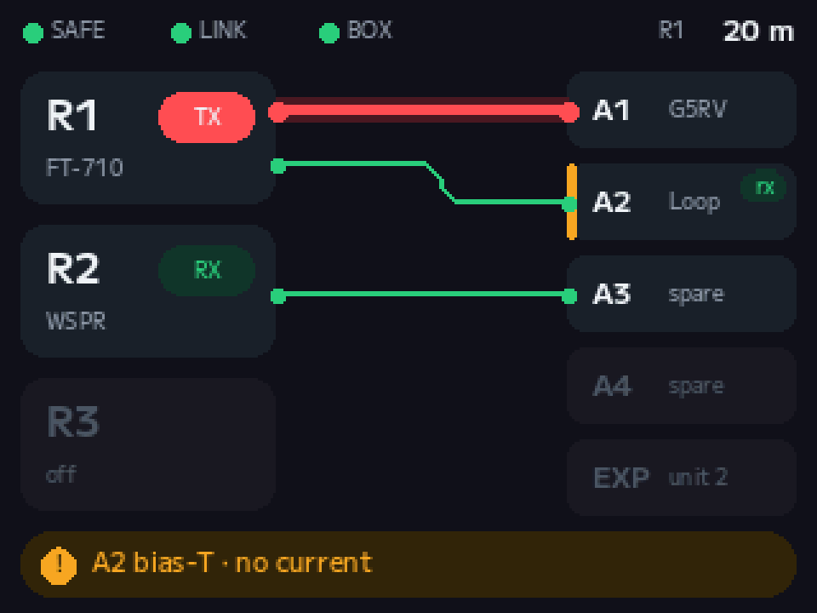
docs/design/display-mockups/B2-flow-modern.png
