PE1RGU/hf-antenna-switch/docs/design/display-mockups/B-flow.png

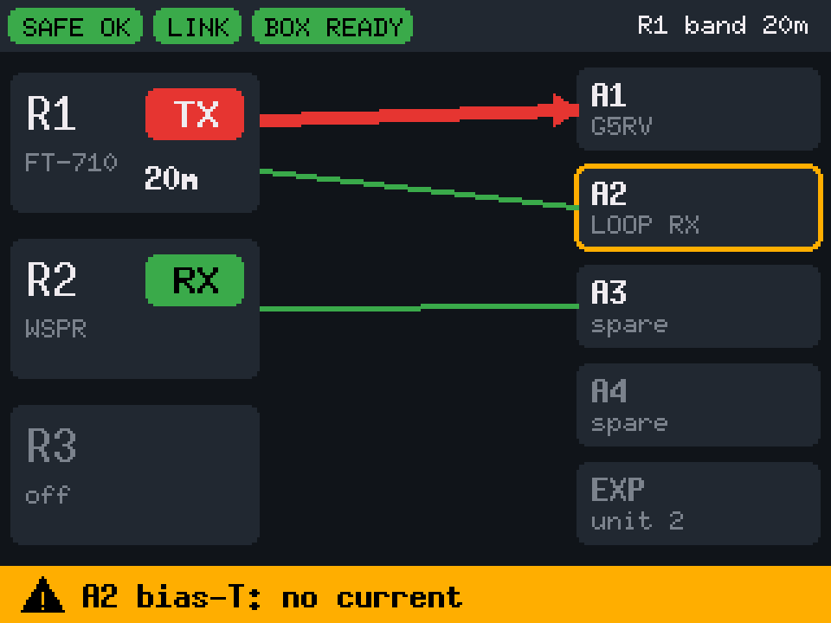
docs/design/display-mockups/B-flow.png
