PE1RGU/hf-antenna-switch/docs/design/display-mockups/C-cards.png

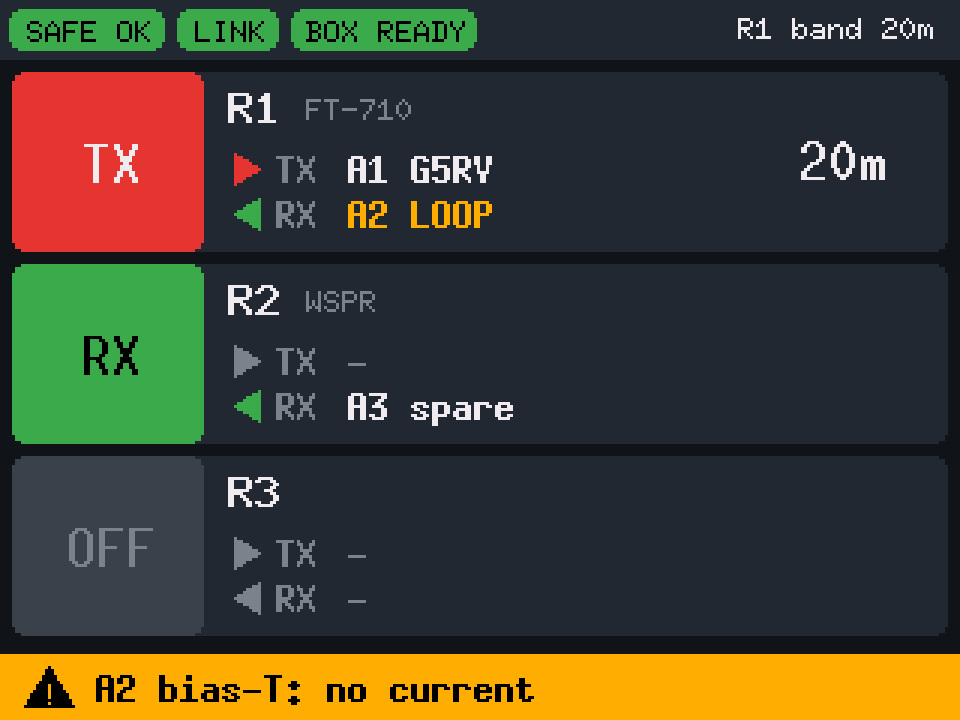
docs/design/display-mockups/C-cards.png
