PE1RGU/hf-antenna-switch/docs/images/shack-interface.png

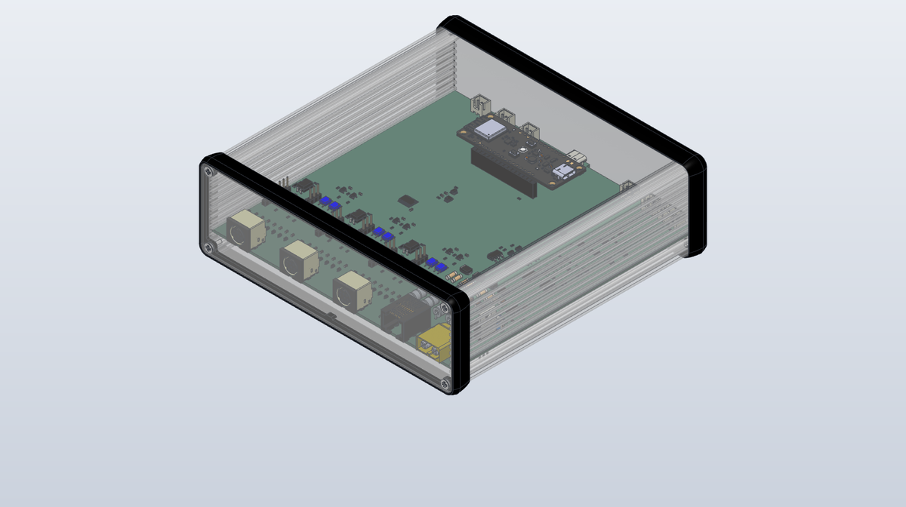
docs/images/shack-interface.png
