PE1RGU/hf-antenna-switch/hardware/docs/diagrams/F1_box_firmware.png

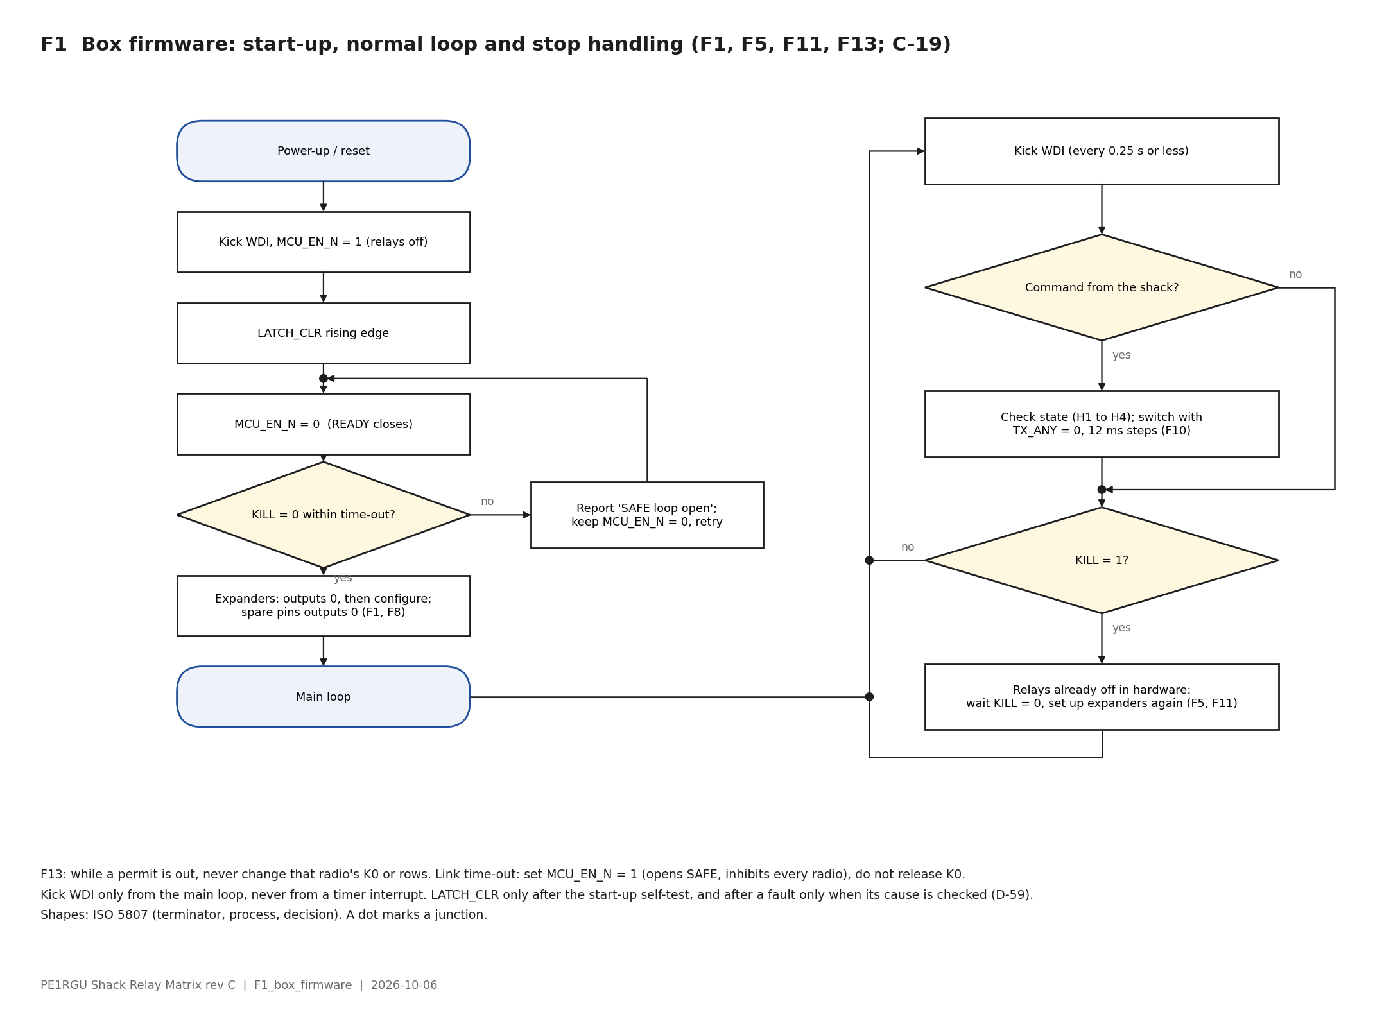
hardware/docs/diagrams/F1_box_firmware.png
