PE1RGU/hf-antenna-switch/hardware/docs/diagrams/F2_tx_handshake.png

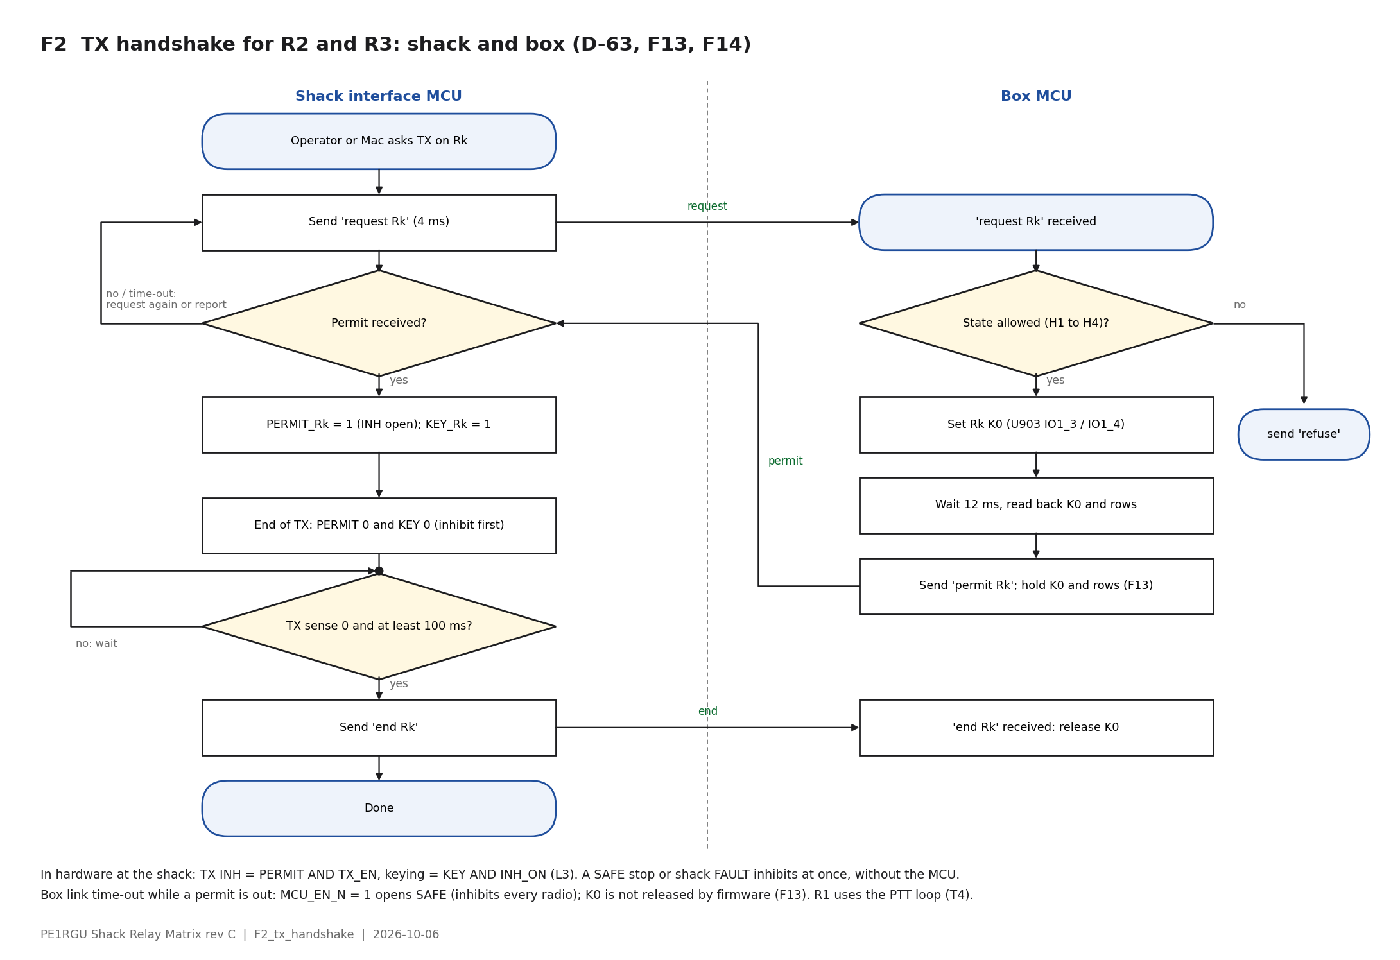
hardware/docs/diagrams/F2_tx_handshake.png
