PE1RGU/hf-antenna-switch/hardware/docs/diagrams/L1_safe_loop.png

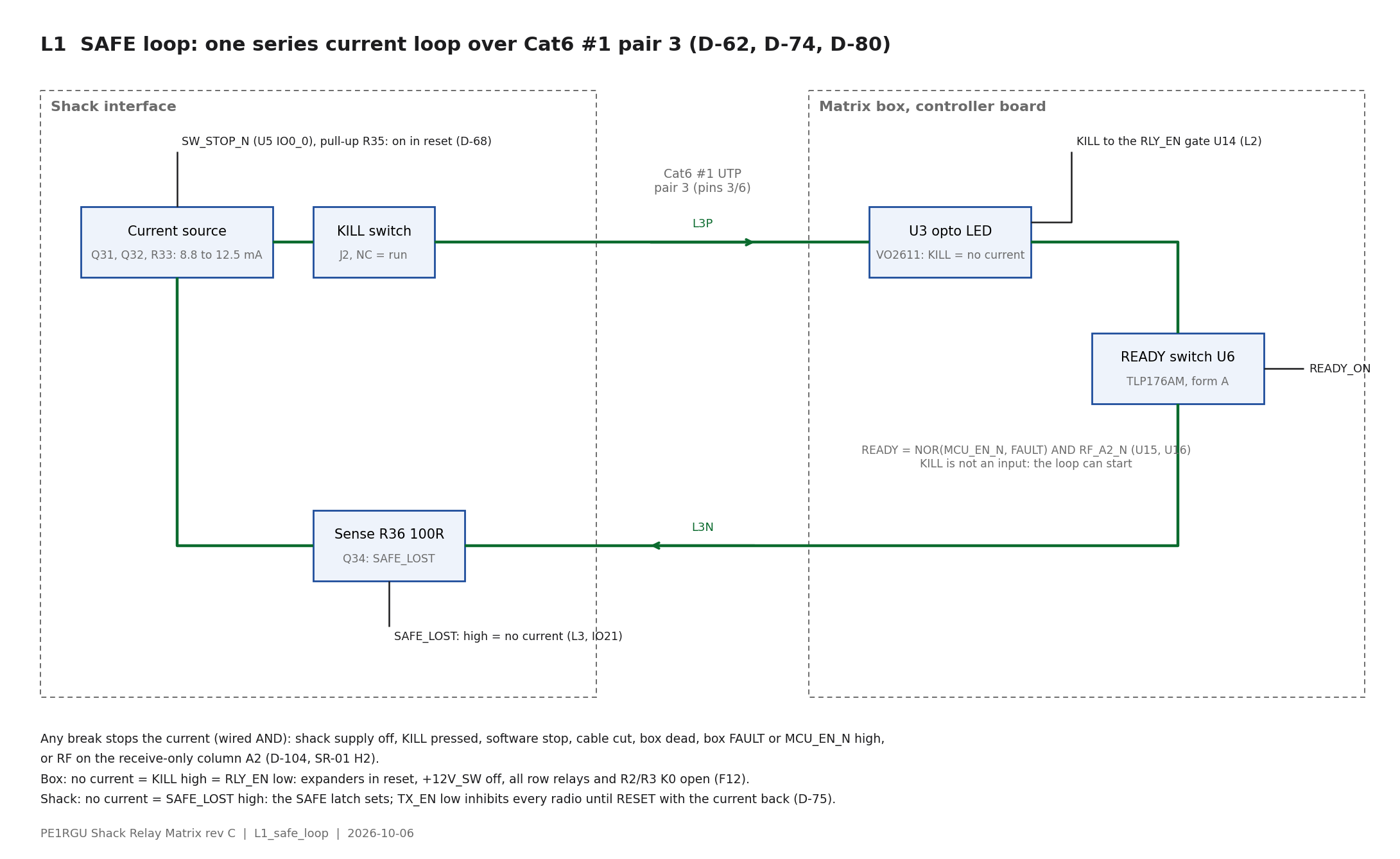
hardware/docs/diagrams/L1_safe_loop.png
