PE1RGU/hf-antenna-switch/hardware/docs/diagrams/L2_box_safety_gate.png

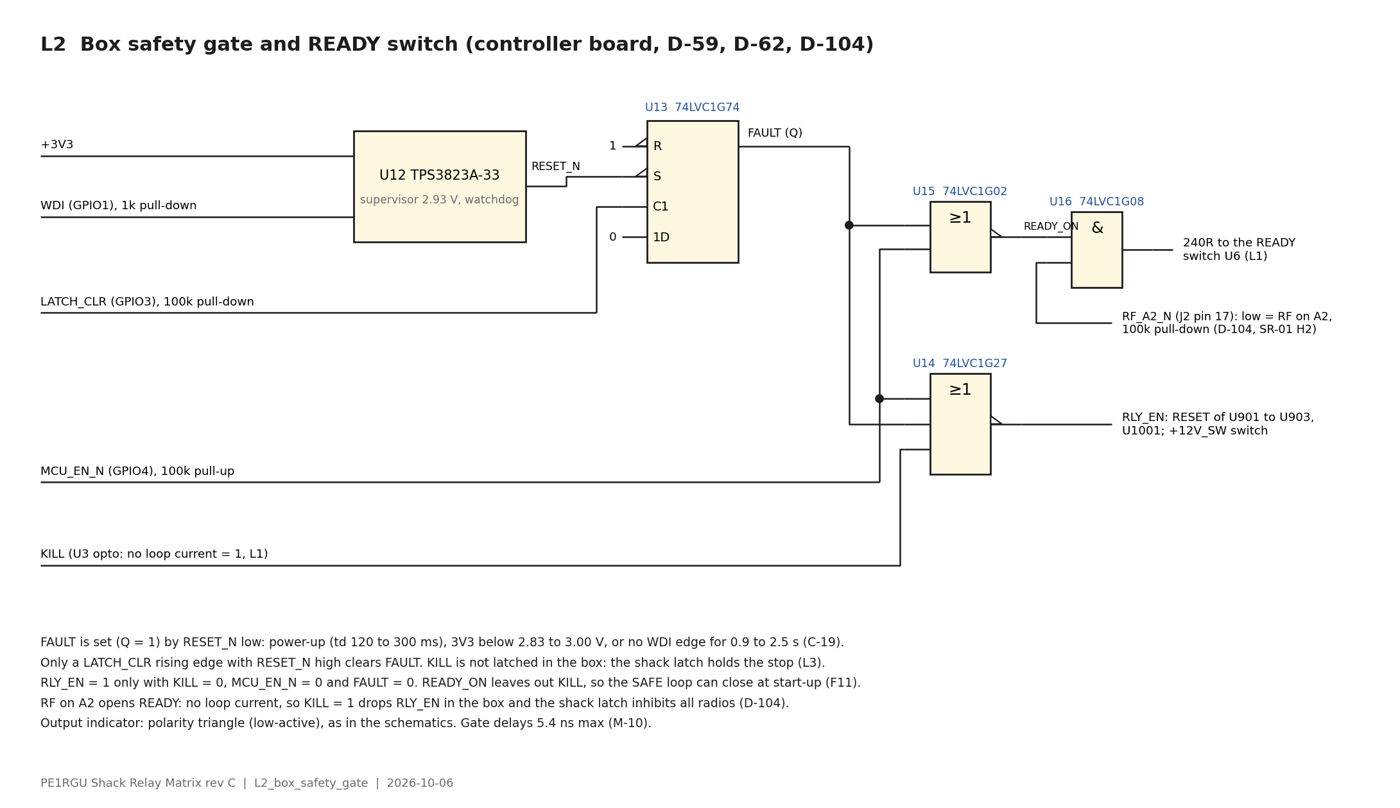
hardware/docs/diagrams/L2_box_safety_gate.png
