PE1RGU/hf-antenna-switch/hardware/docs/diagrams/L3_shack_latch_port.png

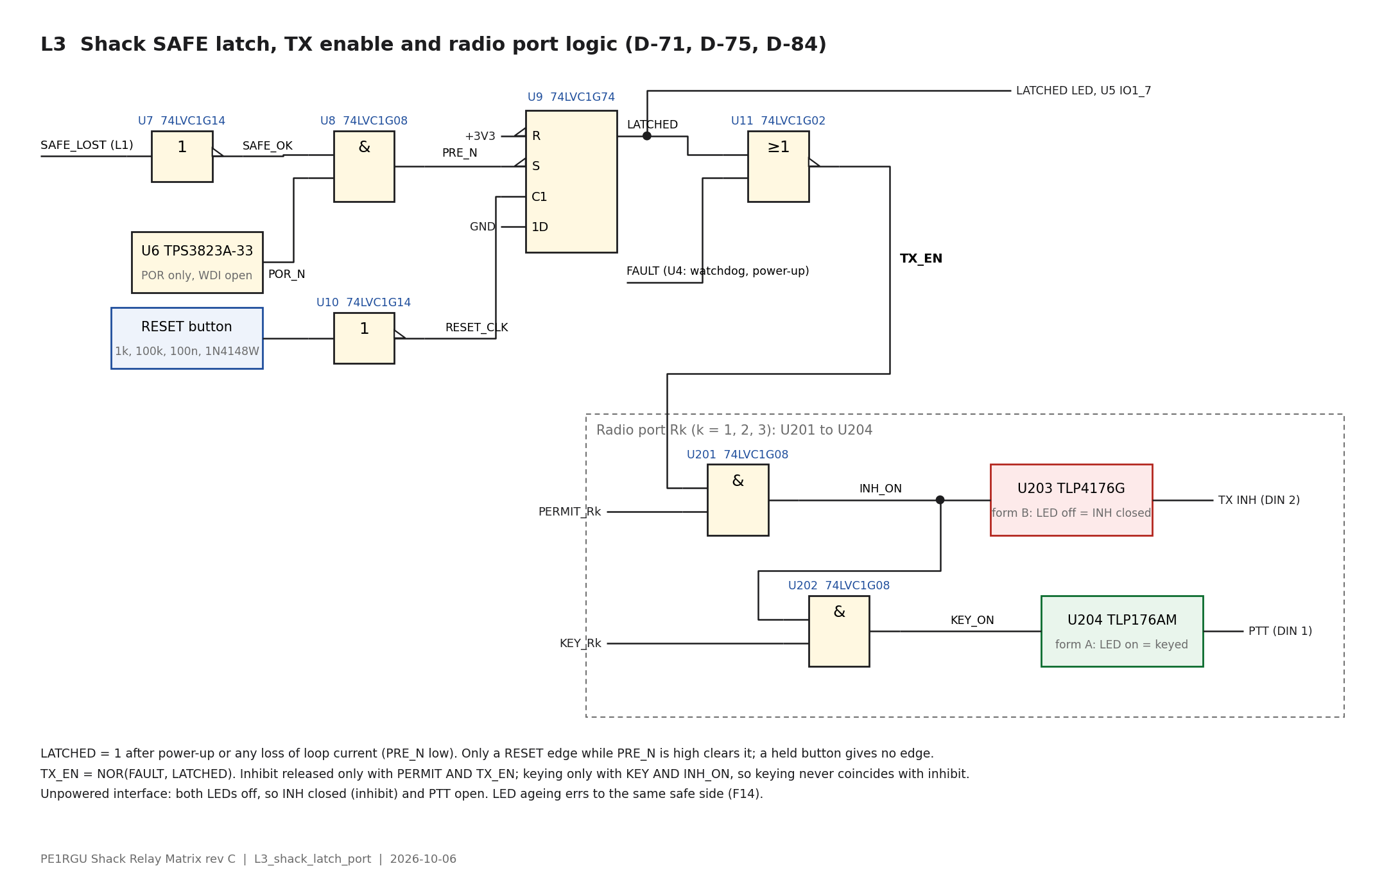
hardware/docs/diagrams/L3_shack_latch_port.png
