PE1RGU/hf-antenna-switch/hardware/docs/diagrams/T1_box_startup.png

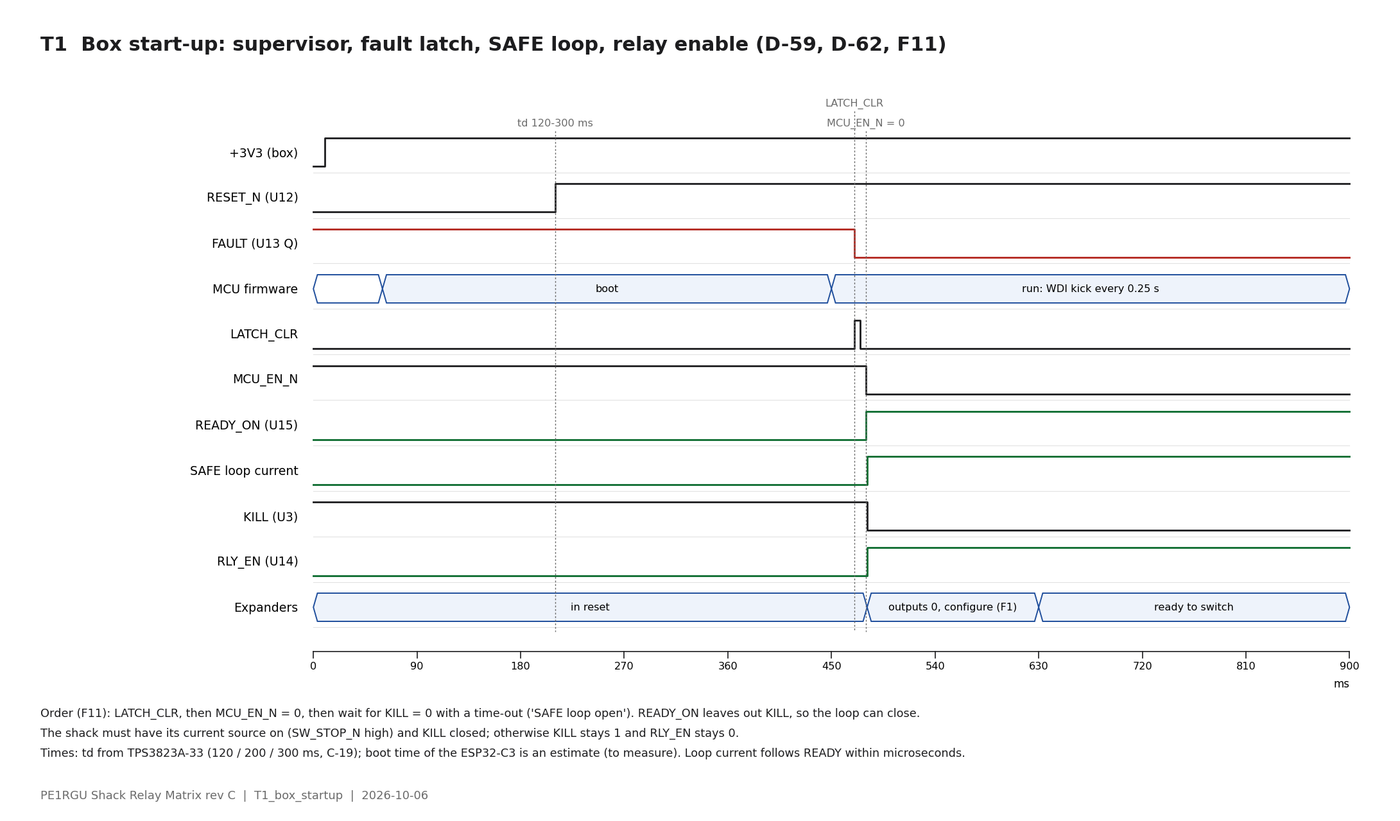
hardware/docs/diagrams/T1_box_startup.png
