PE1RGU/hf-antenna-switch/hardware/docs/diagrams/T2_safe_stop.png

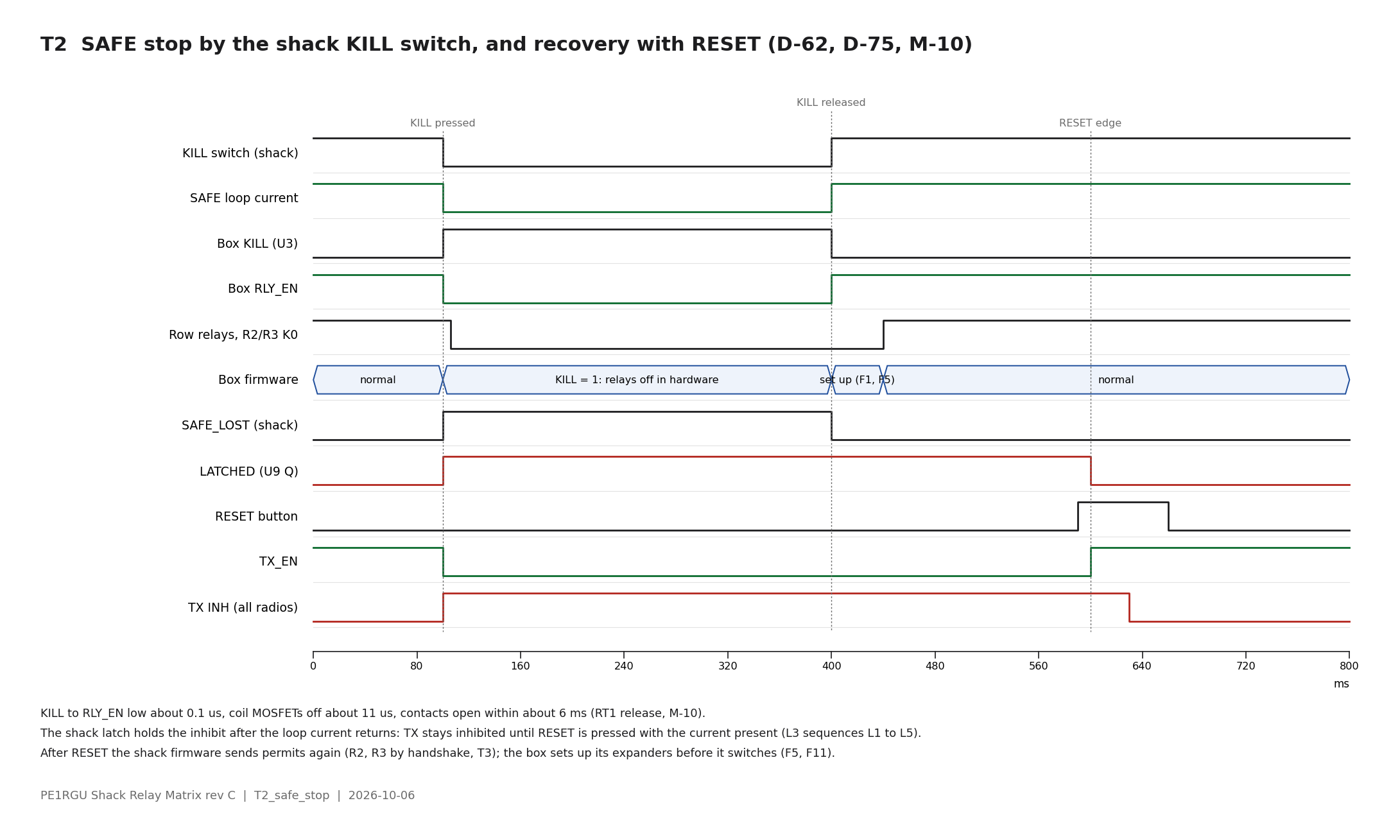
hardware/docs/diagrams/T2_safe_stop.png
