PE1RGU/hf-antenna-switch/hardware/docs/diagrams/T3a_tx_start.png

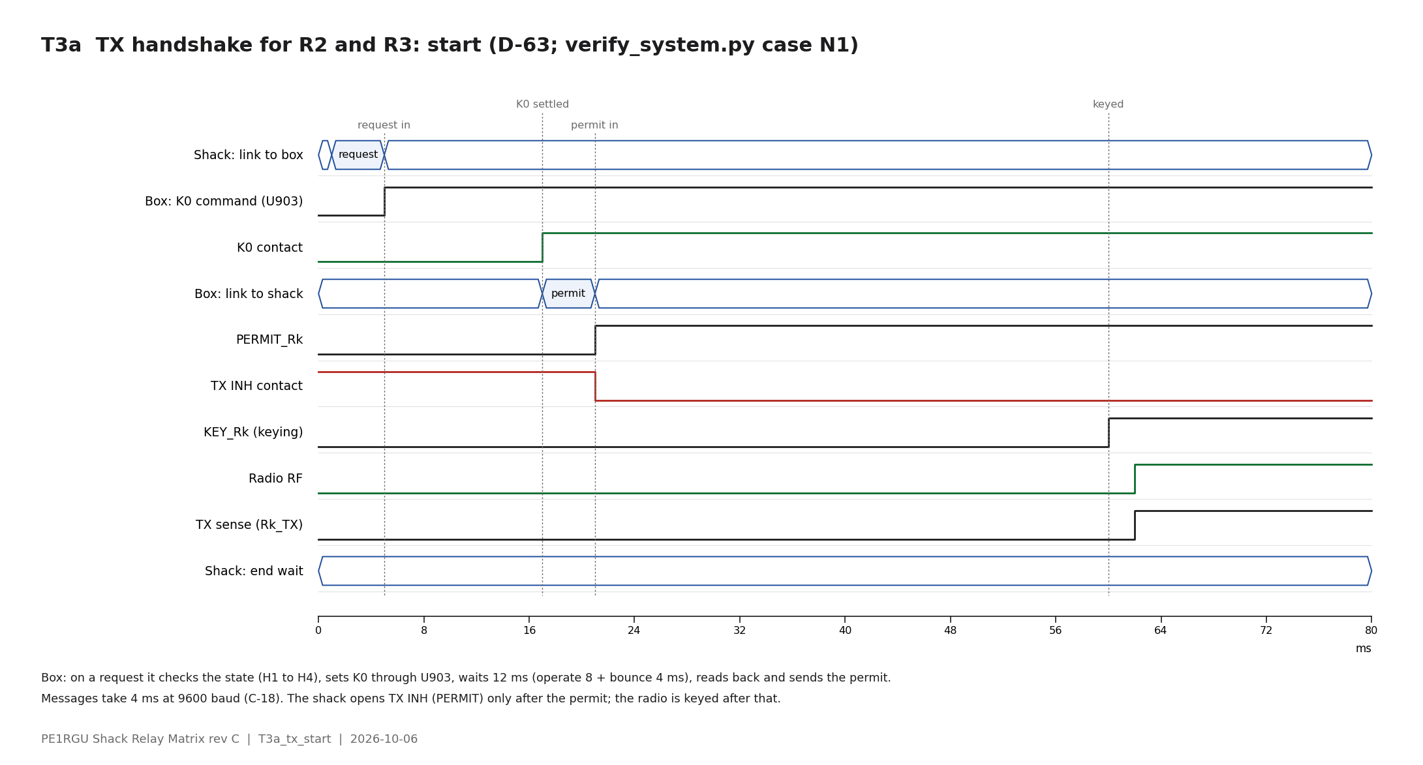
hardware/docs/diagrams/T3a_tx_start.png
