PE1RGU/hf-antenna-switch/hardware/docs/diagrams/T3b_tx_end.png

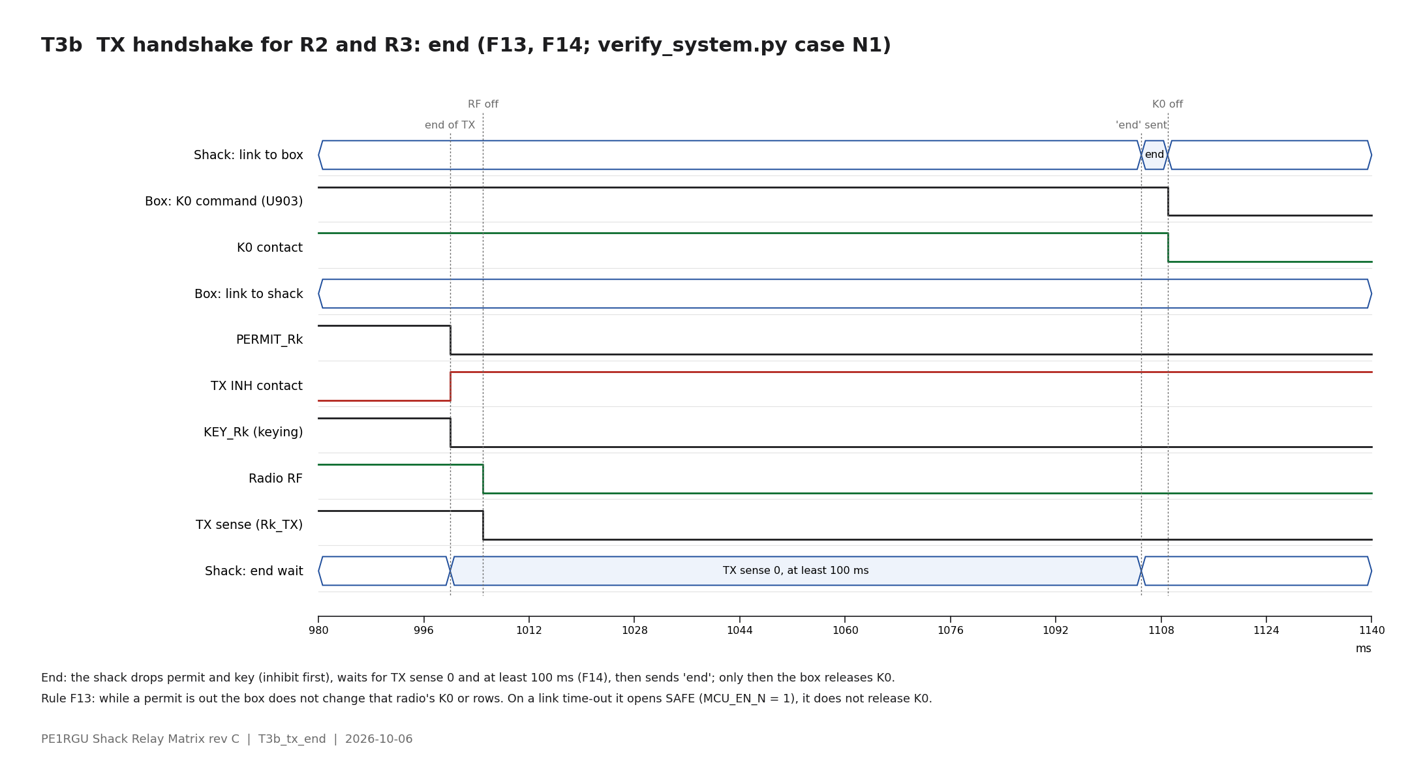
hardware/docs/diagrams/T3b_tx_end.png
