PE1RGU/hf-antenna-switch/hardware/docs/diagrams/T4_ptt_r1.png

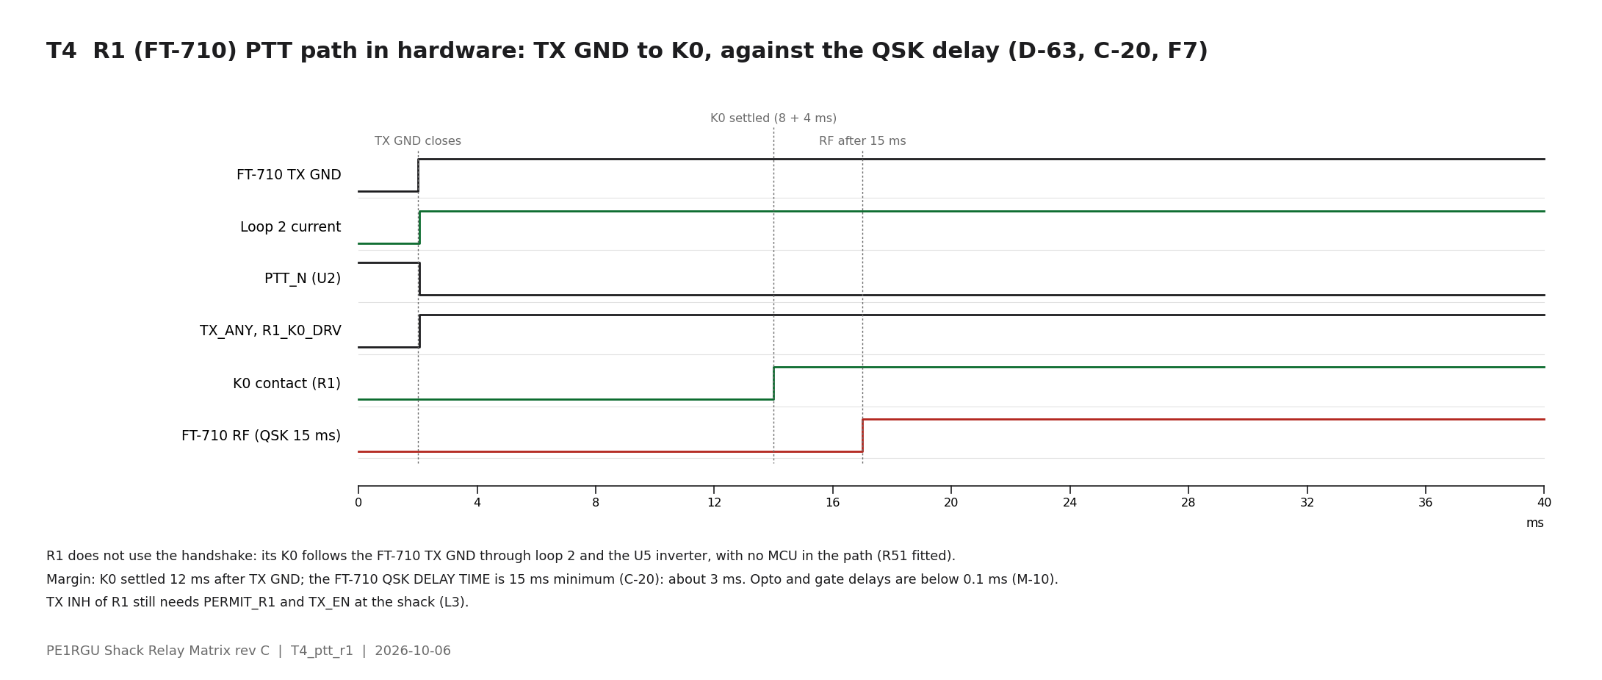
hardware/docs/diagrams/T4_ptt_r1.png
