PE1RGU/hf-antenna-switch/hardware/shack-interface/case/fit-iso.png

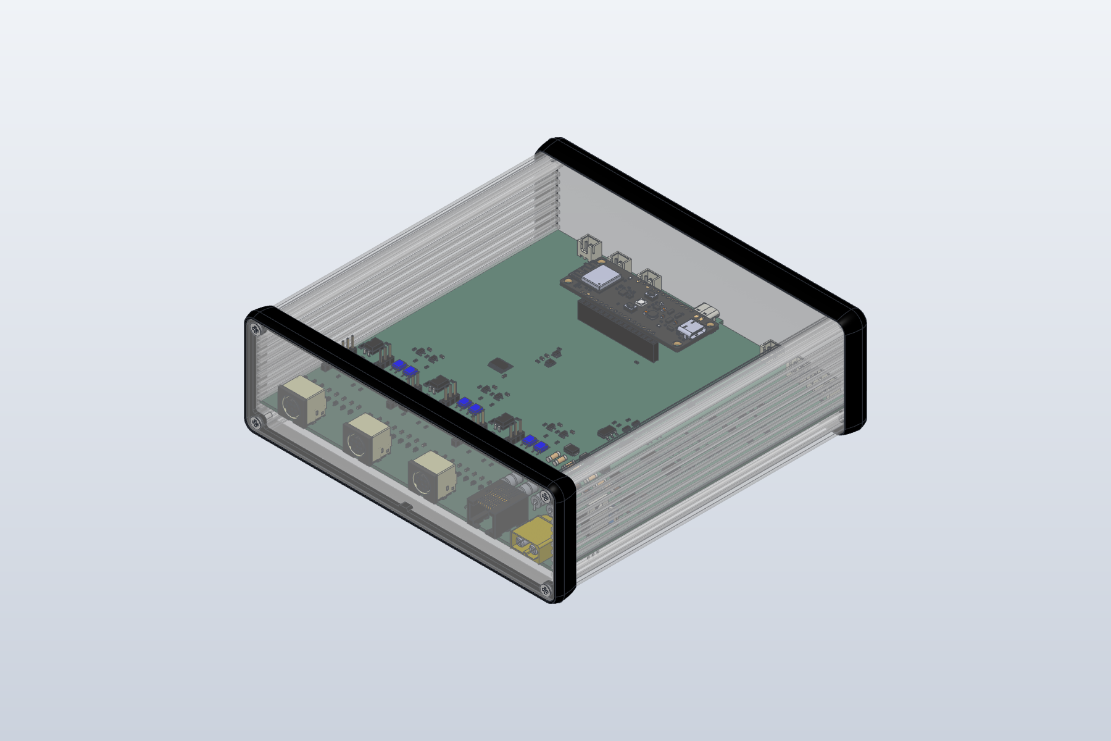
hardware/shack-interface/case/fit-iso.png
