PE1RGU/hf-antenna-switch/hardware/shack-interface/case/fit-section-u1.png

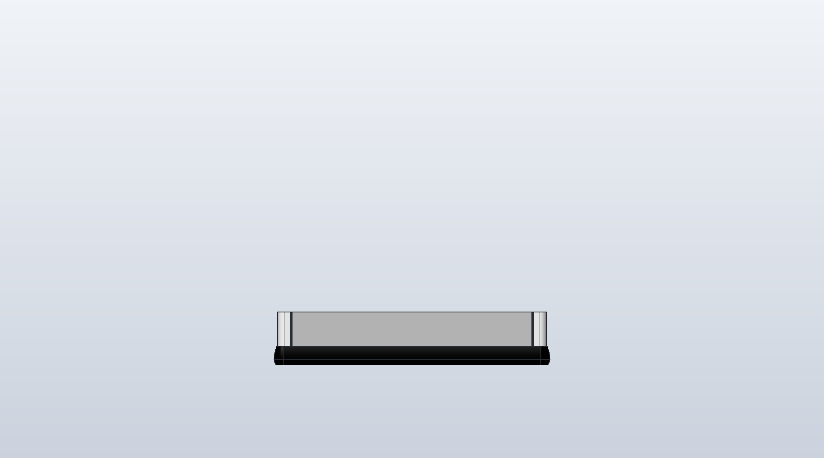
hardware/shack-interface/case/fit-section-u1.png
