PE1RGU/hf-antenna-switch/hardware/shack-interface/case/fit-sections.png

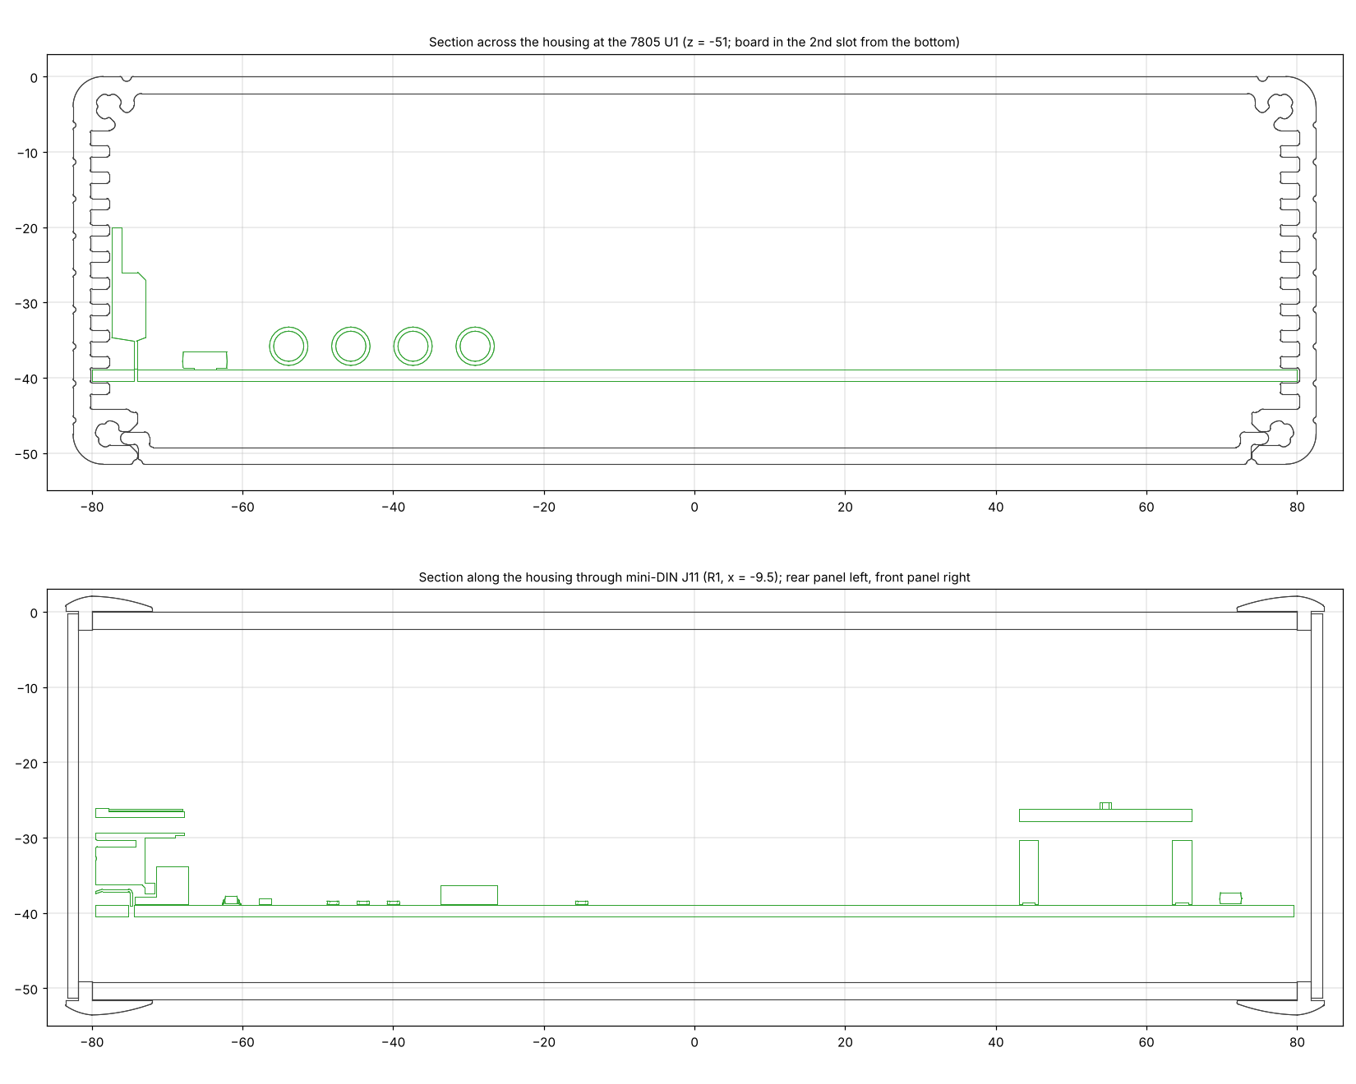
hardware/shack-interface/case/fit-sections.png
