PE1RGU/hf-antenna-switch/hardware/shack-interface/case/render-full/render-front-hero.png

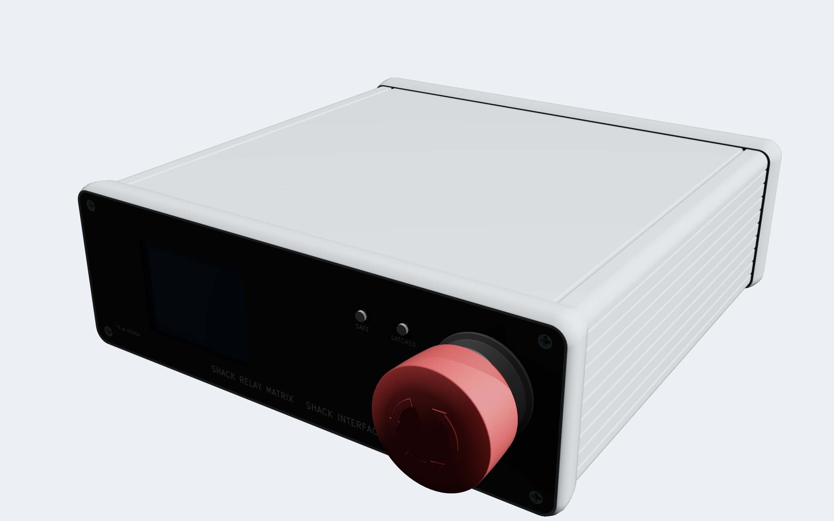
hardware/shack-interface/case/render-full/render-front-hero.png
