PE1RGU/hf-antenna-switch/hardware/shack-interface/case/render-full/render-front-straight-ev.png

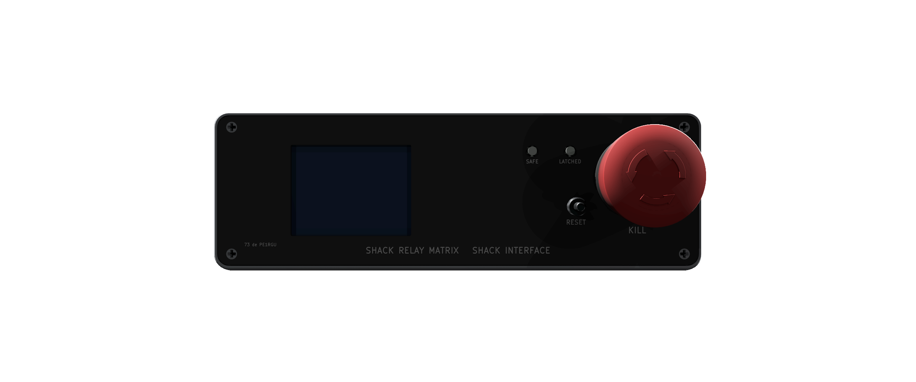
hardware/shack-interface/case/render-full/render-front-straight-ev.png
