PE1RGU/hf-antenna-switch/hardware/shack-interface/case/render-full/render-rear.png

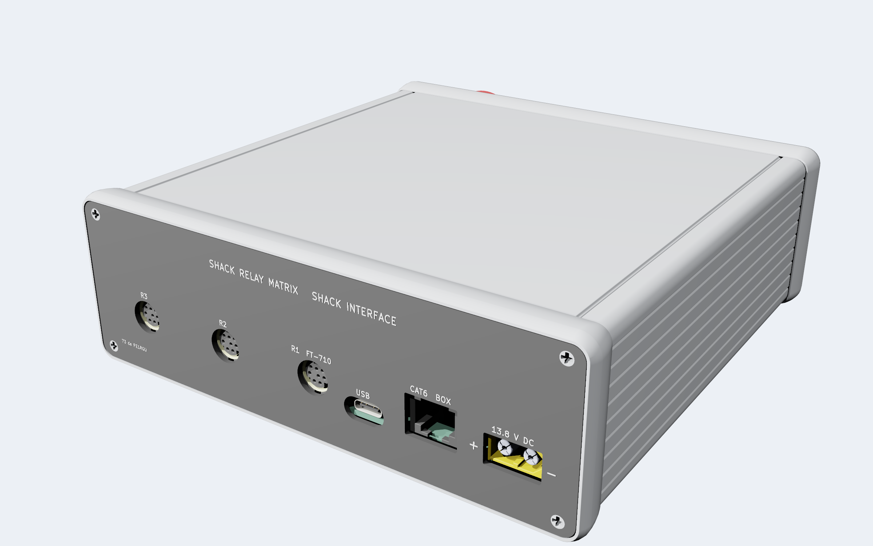
hardware/shack-interface/case/render-full/render-rear.png
