PE1RGU/hf-antenna-switch/hardware/shack-interface/case/render-full/snap-iso.png

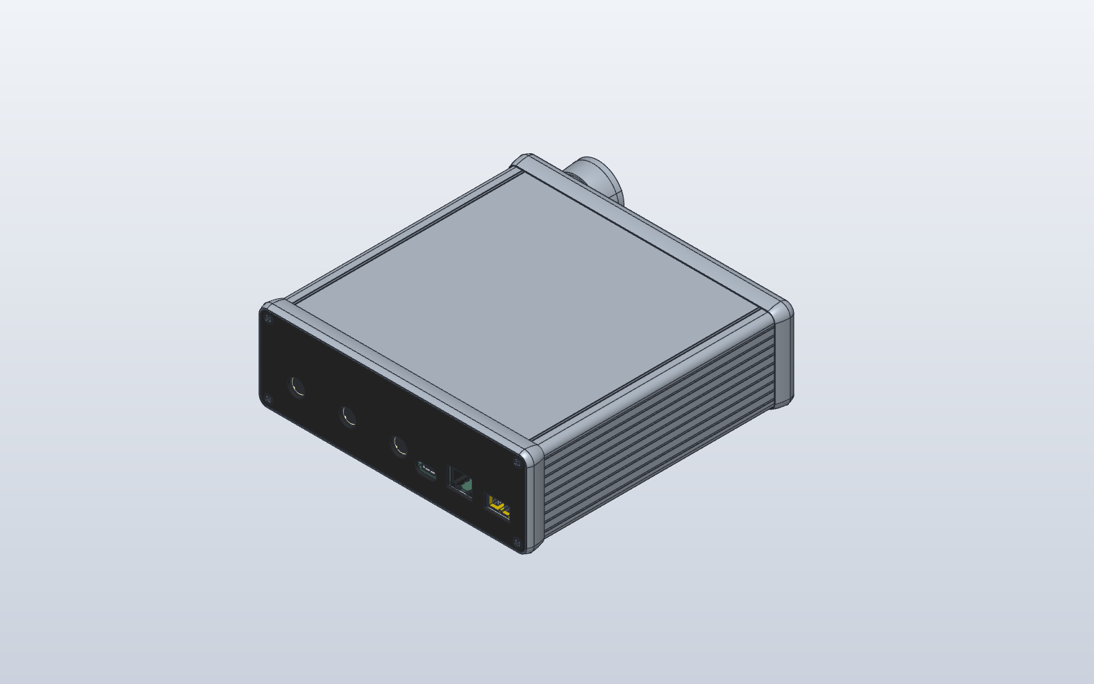
hardware/shack-interface/case/render-full/snap-iso.png
