PE1RGU/hf-antenna-switch/hardware/shack-interface/case/render-full/view-front.png

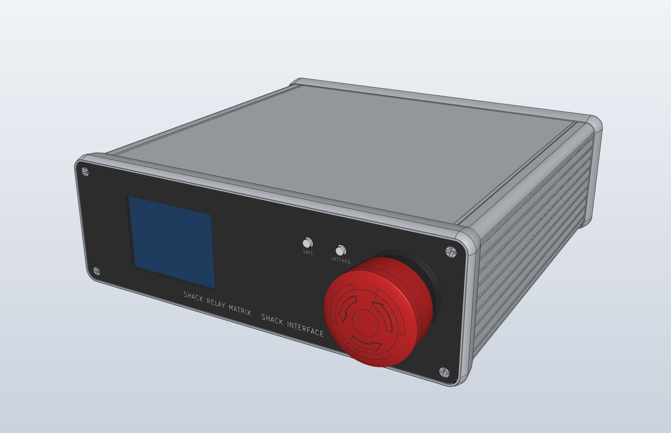
hardware/shack-interface/case/render-full/view-front.png
