PE1RGU/hf-antenna-switch/hardware/shack-interface/endplates/display-candidates/display-candidates.png

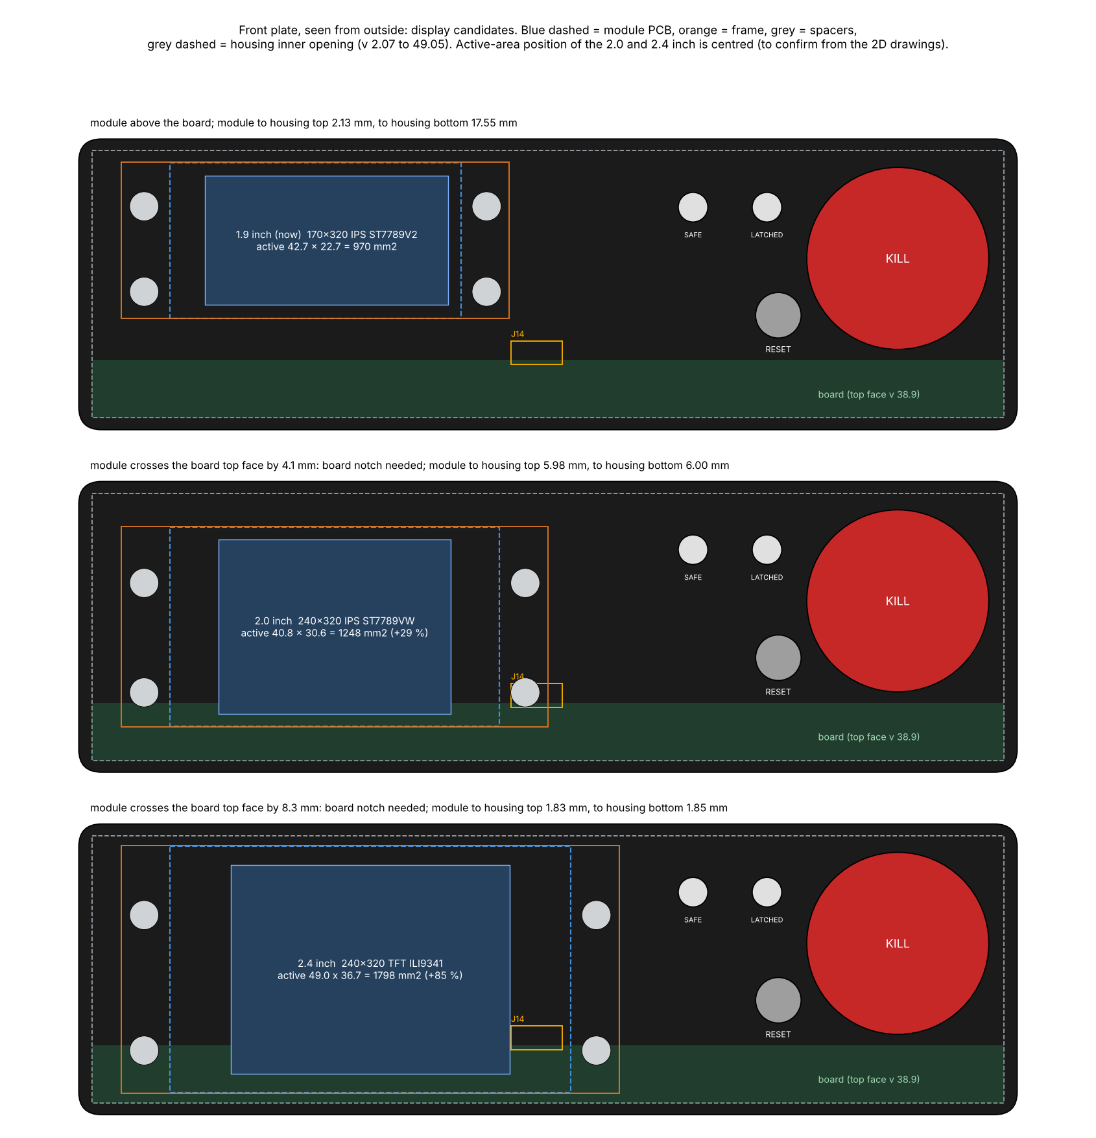
hardware/shack-interface/endplates/display-candidates/display-candidates.png
