PE1RGU/hf-antenna-switch/hardware/shack-interface/endplates/rear-panel-render.png

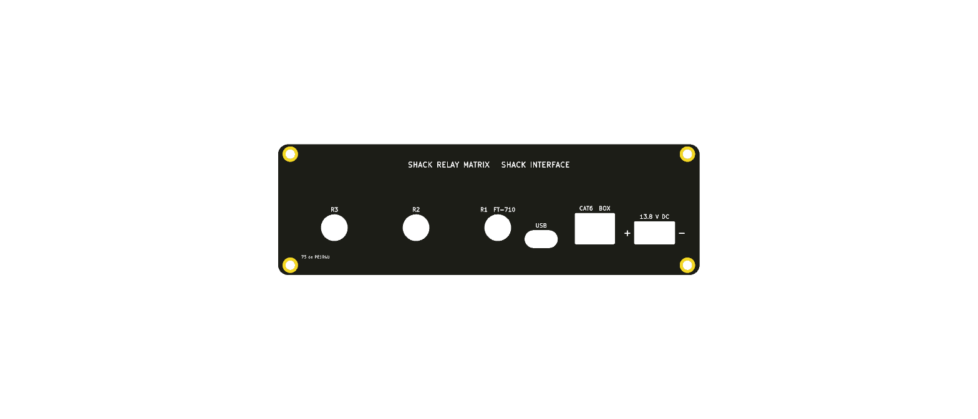
hardware/shack-interface/endplates/rear-panel-render.png
