PE1RGU/hf-antenna-switch/hardware/unit/case/_boards_iso.png

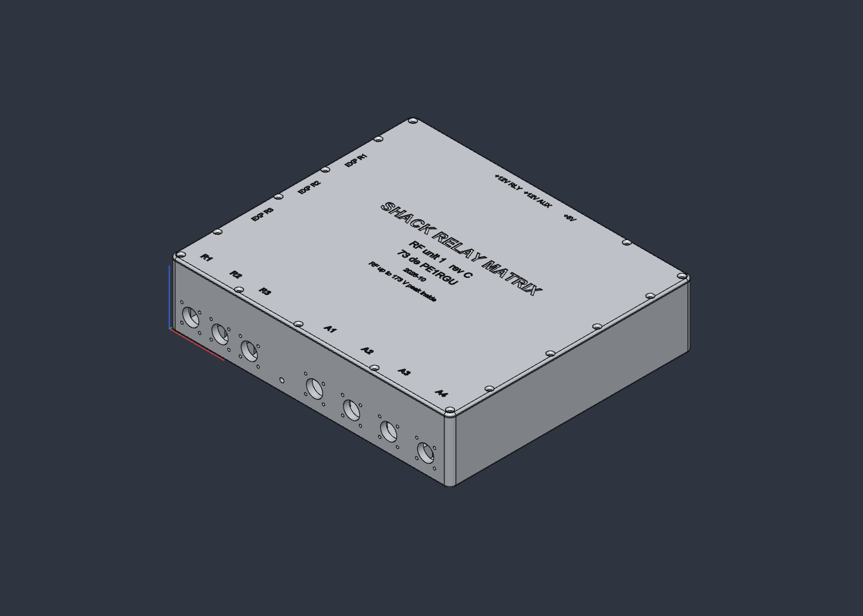
hardware/unit/case/_boards_iso.png
