PE1RGU/hf-antenna-switch/hardware/unit/case/_corner_tray.png

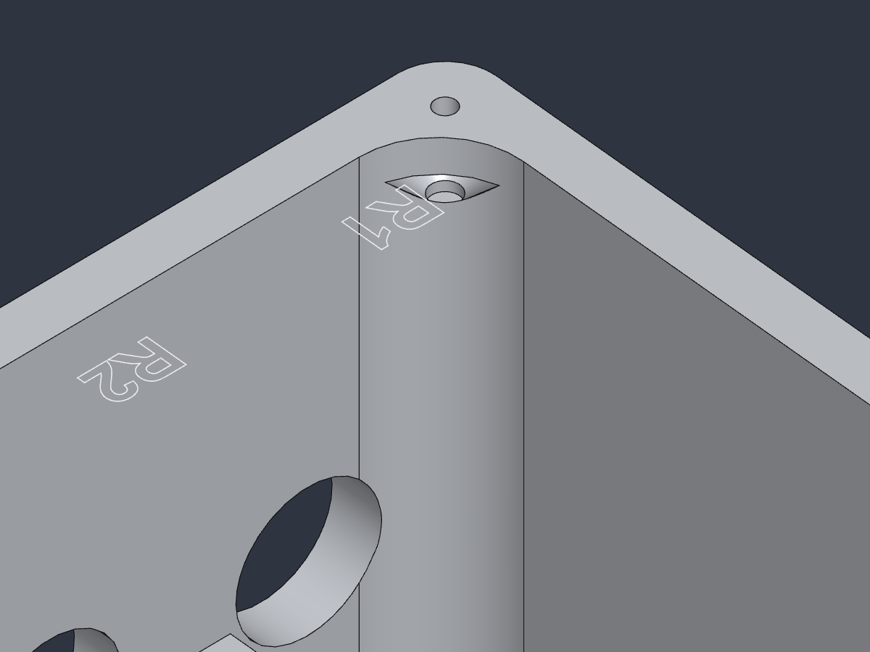
hardware/unit/case/_corner_tray.png
