PE1RGU/hf-antenna-switch/hardware/unit/case/_rj45_sec.png

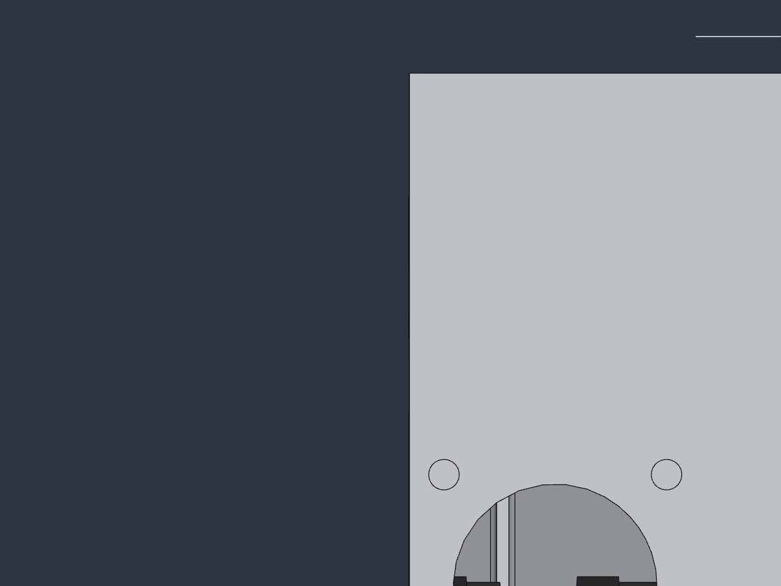
hardware/unit/case/_rj45_sec.png
