PE1RGU/hf-antenna-switch/hardware/unit/case/_rj_0.png

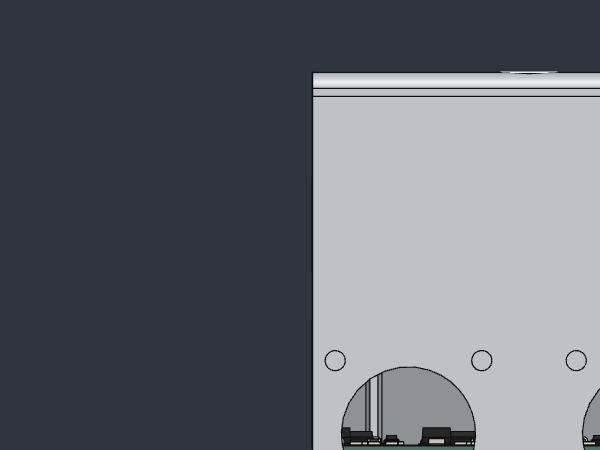
hardware/unit/case/_rj_0.png
