PE1RGU/hf-antenna-switch/hardware/unit/case/_rj_1.png

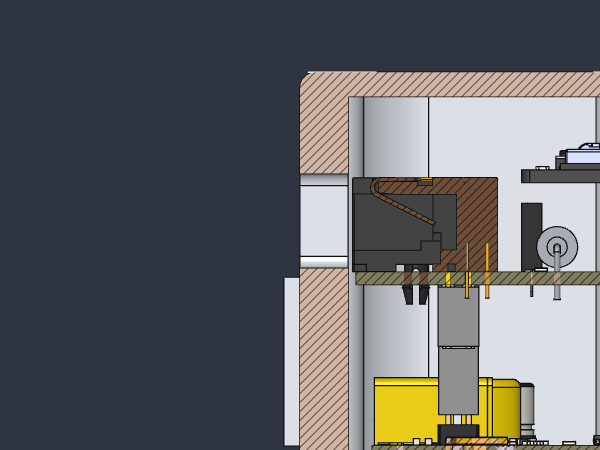
hardware/unit/case/_rj_1.png
