PE1RGU/hf-antenna-switch/hardware/unit/case/_rj_2.png

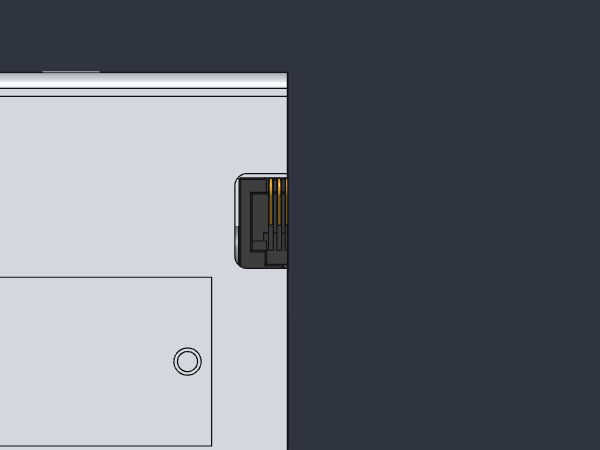
hardware/unit/case/_rj_2.png
