PE1RGU/hf-antenna-switch/hardware/unit/case/_screws_front.png

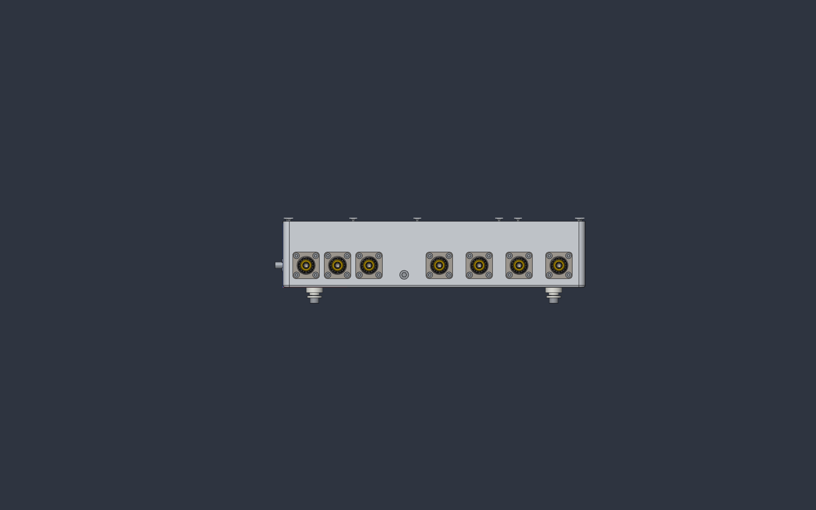
hardware/unit/case/_screws_front.png
