PE1RGU/hf-antenna-switch/hardware/unit/case/_sec60.png

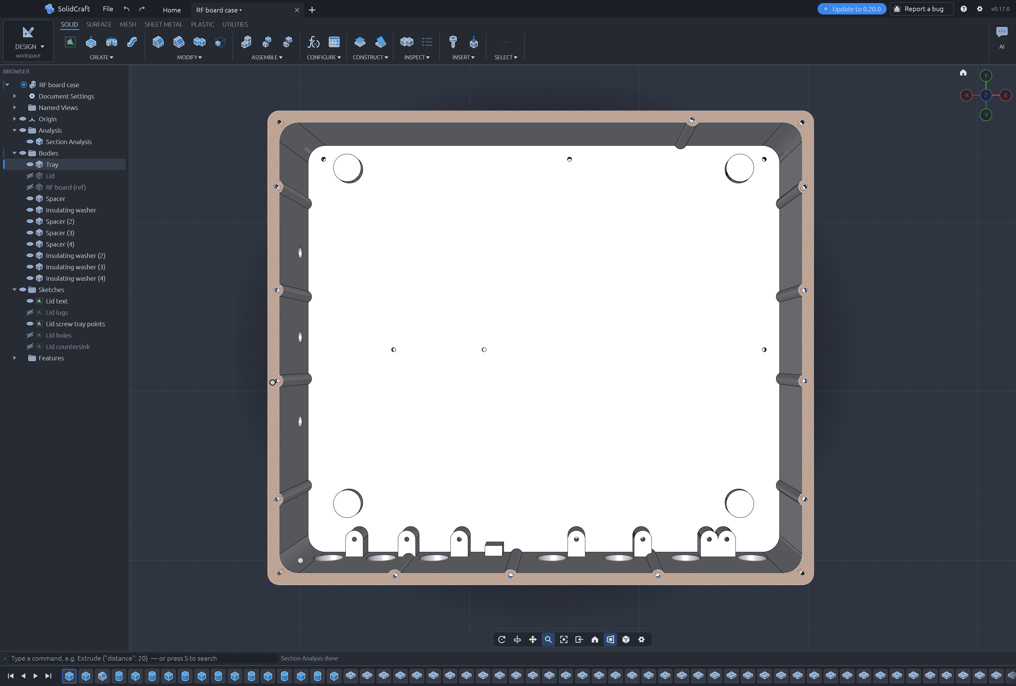
hardware/unit/case/_sec60.png
