PE1RGU/hf-antenna-switch/hardware/unit/case/_sma_side.png

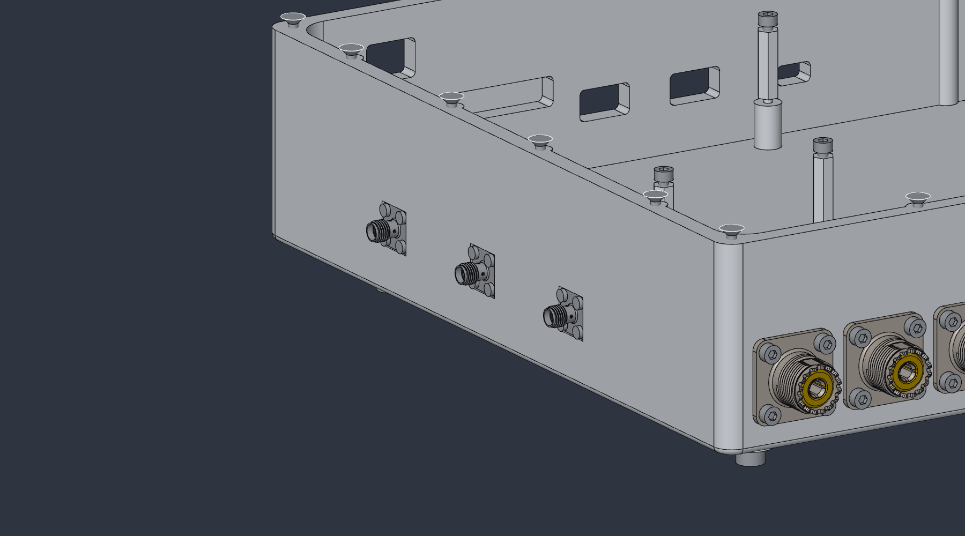
hardware/unit/case/_sma_side.png
