PE1RGU/hf-antenna-switch/hardware/unit/case/_win.png

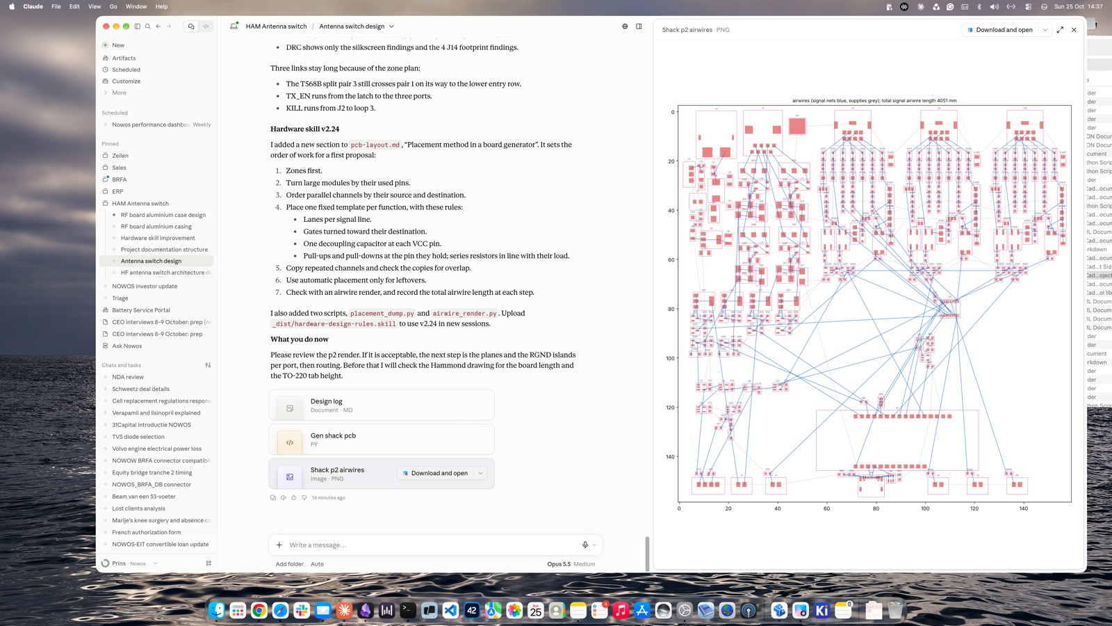
hardware/unit/case/_win.png
