PE1RGU/hf-antenna-switch/hardware/unit/case/rf-case-back.png

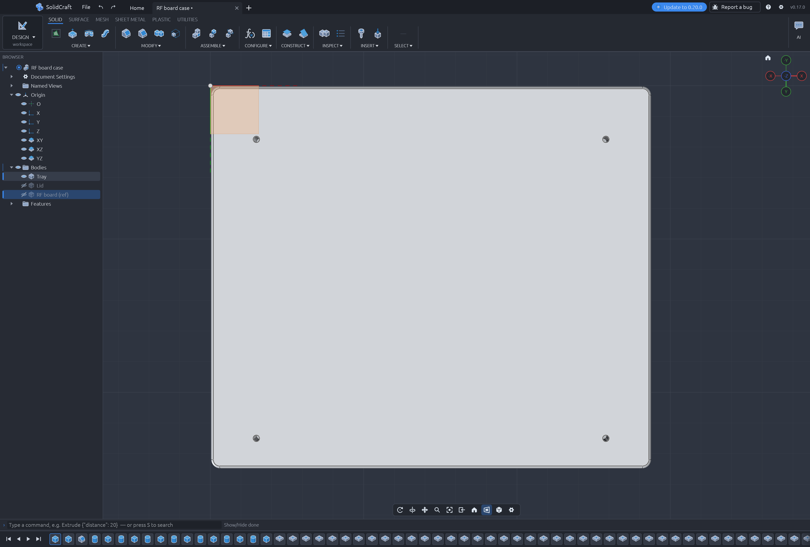
hardware/unit/case/rf-case-back.png
