PE1RGU/hf-antenna-switch/hardware/unit/case/rf-case-fit-iso.png

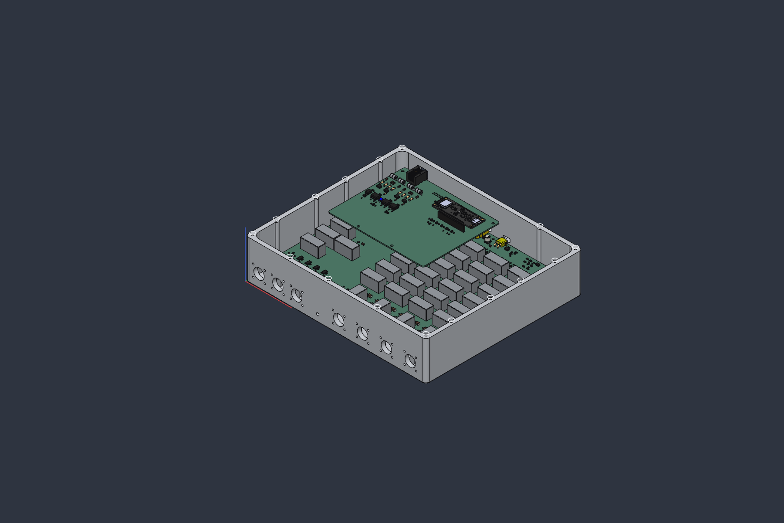
hardware/unit/case/rf-case-fit-iso.png
