PE1RGU/hf-antenna-switch/hardware/unit/case/rf-case-front.png

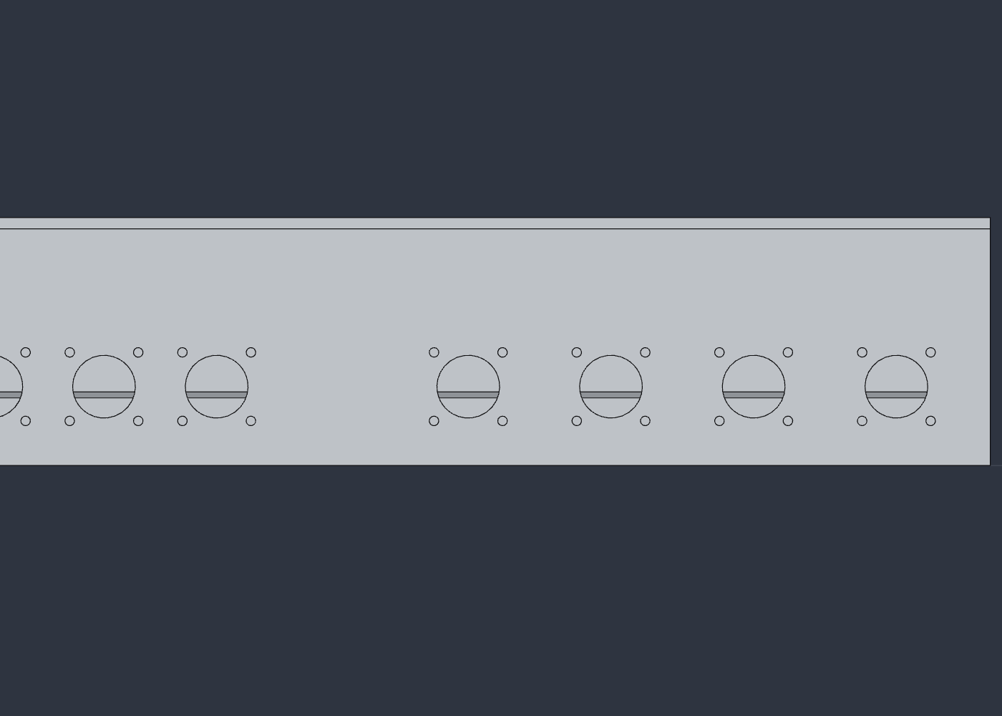
hardware/unit/case/rf-case-front.png
