PE1RGU/hf-antenna-switch/hardware/unit/case/rf-case-iso-open.png

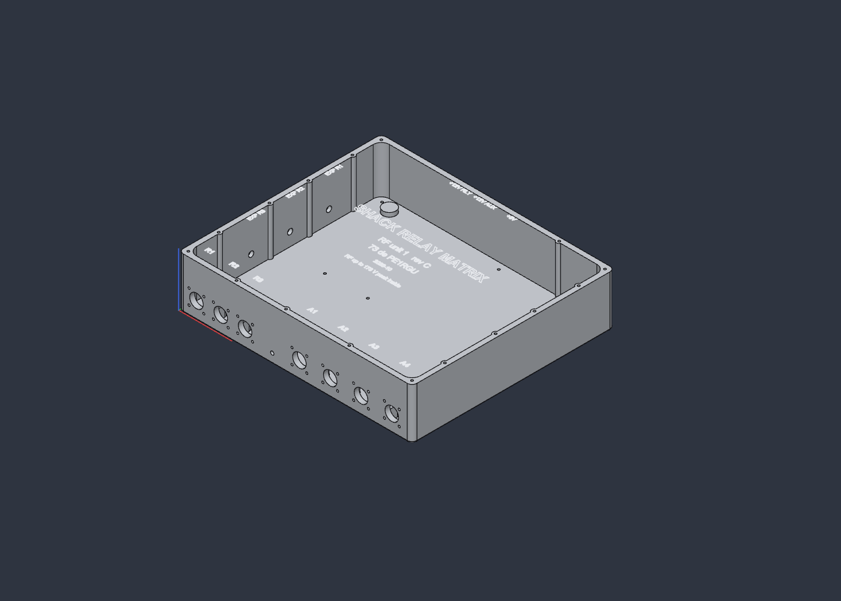
hardware/unit/case/rf-case-iso-open.png
