PE1RGU/hf-antenna-switch/hardware/unit/case/rf-case-top.png

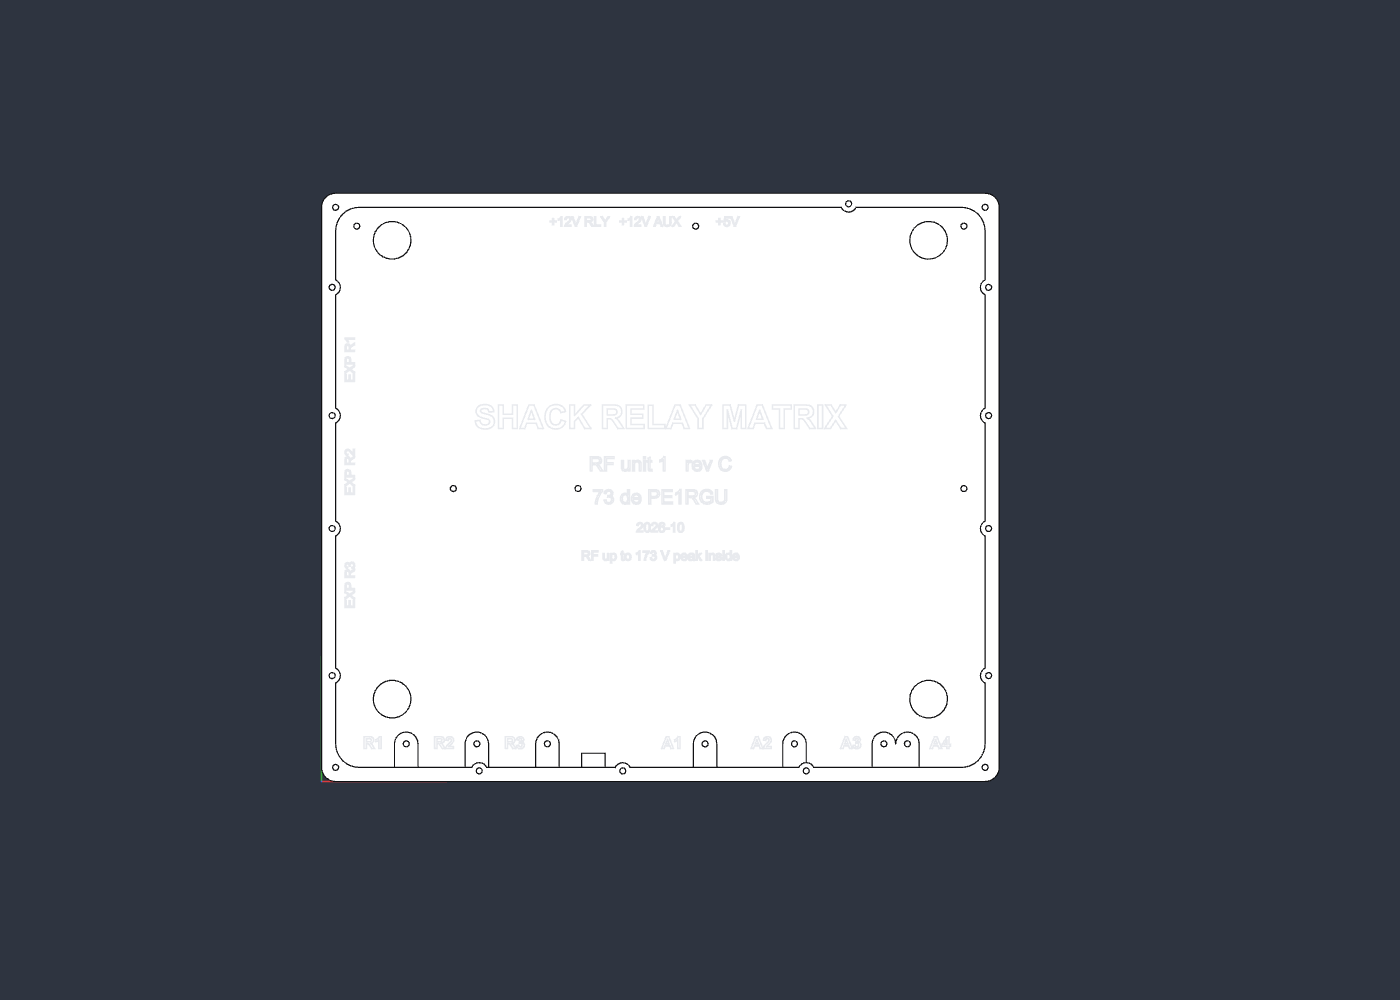
hardware/unit/case/rf-case-top.png
