PE1RGU/hf-antenna-switch/hardware/shack-interface/production/bom.csv

Designator | Footprint | Quantity | Value | LCSC Part #
A1 | ESP32-C3-DevKit-RUST_Socket | 1 | ESP32-C3-DevKit-RUST-1
C1 | CP_Radial_D6.3mm_P2.50mm | 1 | 47u 35V
C2 | 0805 | 1 | 330n 50V X7R
C201, C202, C301, C302, C401, C402, C61, C62, C63, C7, C72, C73, C74, C75, C76, C77 | 0603 | 16 | 1u 16V X7R
C205, C305, C405 | 1206 | 3 | 10n 1kV
C211, C212, C213, C214, C216, C217, C218, C311, C312, C313, C314, C316, C317, C318, C411, C412, C413, C414, C416, C417, C418 | 0603 | 21 | 1n C0G
C3, C64, C71 | 0603 | 3 | 100n 50V X7R
C4, C5 | 1206 | 2 | 10u 16V X7R
C6 | 1210 | 1 | 22u 16V X7R
D1 | D_SMC | 1 | SS34
D11, D21, D31, D41 | D_SMB | 4 | SMBJ15CA
D2 | D_SMB | 1 | SMBJ16A
D201, D301, D33, D401, D43, D71 | D_SOD-123 | 6 | 1N4148W
D202, D302, D402 | D_SOD-323_HandSoldering | 3 | BZX384-C5V1
D211, D212, D213, D214, D216, D217, D218, D311, D312, D313, D314, D316, D317, D318, D411, D412, D413, D414, D416, D417, D418 | D_SOD-323_HandSoldering | 21 | PESD15VL1BA
F1 | 1206 | 1 | 500mA T
GD1, GD2, GD3, GD4 | GDT_3Pin_P4.40mm_Bourns-2036-B2_Littelfuse-SL1003A-R | 4 | 2036-09-B2LF
J1 | RJ45_8P8C_Unshielded_TabDown | 1 | RJ45 LINK
J11 | MiniDIN-8_SameSky_MD-80SM_Horizontal | 1 | R1 mini-DIN
J12 | MiniDIN-8_SameSky_MD-80SM_Horizontal | 1 | R2 mini-DIN
J13 | MiniDIN-8_SameSky_MD-80SM_Horizontal | 1 | R3 mini-DIN
J14 | USB_C_Receptacle_GCT_USB4105-xx-A_16P_TopMnt_Horizontal | 1 | USB4105-GF-A
J15 | PinHeader_1x08_P2.54mm_Vertical | 1 | DISPLAY
J2 | JST_XH_B2B-XH-A_1x02_P2.50mm_Vertical | 1 | KILL switch
J3 | AMASS_XT60PW-M_1x02_P7.20mm_Horizontal | 1 | 13.8 V IN
J6 | JST_XH_B4B-XH-A_1x04_P2.50mm_Vertical | 1 | Front panel
J7 | JST_XH_B2B-XH-A_1x02_P2.50mm_Vertical | 1 | KILL state
JP201, JP301, JP401 | PinHeader_1x03_P2.54mm_Vertical | 3 | INH LEVEL
JP202, JP302, JP402 | SolderJumper-3_P1.3mm_Open_RoundedPad1.0x1.5mm_NumberLabels | 3 | PIN1 SEL
JP203, JP303, JP403 | SolderJumper-3_P1.3mm_Open_RoundedPad1.0x1.5mm_NumberLabels | 3 | FEED SEL
JP204, JP304, JP404 | SolderJumper-2_P1.3mm_Open_RoundedPad1.0x1.5mm | 3 | GND BOND
JP205, JP305, JP405 | PinHeader_1x03_P2.54mm_Vertical | 3 | SENSE A
JP206, JP306, JP406 | PinHeader_1x03_P2.54mm_Vertical | 3 | SENSE K
JP61 | SolderJumper-3_P1.3mm_Bridged12_RoundedPad1.0x1.5mm_NumberLabels | 1 | SDA SEL
L1, L2, L3, L4 | L_CMC_TDK_ACT45B | 4 | 51u CMC
Q11, Q21, Q31, Q41 | SOT-223-3_TabPin2 | 4 | BCP53-16
Q12, Q22, Q32, Q42 | SOT-23 | 4 | BC857B
Q13, Q23, Q33 | SOT-23 | 3 | BSS138BK
Q34, Q44 | SOT-23 | 2 | BC847B
R11, R12, R21, R22, R31, R32, R41, R42 | R_MELF_MMB-0207 | 8 | 47R
R13, R23, R33, R43 | 0603 | 4 | 56R
R14, R24, R34, R44 | 0603 | 4 | 22k
R15, R201, R202, R25, R301, R302, R35, R401, R402, R63, R72 | 0603 | 11 | 100k
R203, R205, R303, R305, R403, R405 | 0603 | 6 | 240R
R204, R304, R404, R75 | 0603 | 4 | 2k2
R206, R306, R406 | 1206 | 3 | 2k2
R207, R214, R215, R216, R217, R307, R314, R315, R316, R317, R38, R407, R414, R415, R416, R417, R48 | 0603 | 17 | 10k
R210, R211, R212, R213, R310, R311, R312, R313, R37, R410, R411, R412, R413, R47, R61, R62, R71 | 0603 | 17 | 1k
R36, R46 | 0603 | 2 | 100R
R5, R6 | 1206 | 2 | 0R
R64, R65 | 0603 | 2 | 5k1
R73, R74 | 0603 | 2 | 680R
U1 | TO-220-3_Vertical | 1 | L7805CV
U10, U7 | SOT-23-5 | 2 | 74LVC1G14
U11 | SOT-23-5 | 1 | 74LVC1G02
U2 | SOT-223-3_TabPin2 | 1 | LD1117S33CTR
U201, U202, U301, U302, U401, U402, U8 | SOT-23-5 | 7 | 74LVC1G08
U203, U303, U403 | SOP-4_P2.54mm_PhotoRelay_LongPad | 3 | TLP4176G
U204, U304, U404 | SOP-4_P2.54mm_PhotoRelay_LongPad | 3 | TLP176AM
U205, U305, U405 | DIP-4_W7.62mm | 3 | PC817X
U3, U6 | SOT-23-5 | 2 | TPS3823A-33
U4, U9 | VSSOP-8_2.3x2mm_P0.5mm | 2 | 74LVC1G74
U5 | TSSOP-24_4.4x7.8mm_P0.65mm | 1 | PCA9539
U61 | SOT-23-6 | 1 | USBLC6-2SC6
