PE1RGU/hf-antenna-switch/hardware/unit/rf-board/production/bom.csv

Designator | Footprint | Quantity | Value | LCSC Part #
C1001, C3, C802, C901, C902, C903 | 0603 | 6 | 1u 16V X7R
C101, C201, C301 | 0805 | 3 | 1u 50V X7R
C1011, C1021, C1031, C1041, C801 | 0603 | 5 | 100n 50V X7R
C4, C403, C503, C603, C703 | 0603 | 5 | 10n 50V X7R
C404, C504, C604, C704 | 1206 | 4 | 4.7p 1kV C0G
C405, C505, C605, C705 | 0603 | 4 | 47p 50V C0G
C5 | 0805 | 1 | 4.7u 16V X7R
C6, C7 | CP_Elec_6.3x7.7 | 2 | 47u 25V polymer
D1 | D_SMA | 1 | SS14
D101, D102, D104, D105, D106, D107, D108, D109, D110, D111, D201, D202, D204, D205, D206, D207, D208, D209, D210, D211, D301, D302, D304, D305, D306, D307, D308, D309, D310, D311, D402, D502, D602, D702 | D_SOD-123 | 34 | 1N4148W
D1011, D1021, D1031, D1041, D7, D8 | D_SMB | 6 | SMBJ15A
D2, D3, D4, D5 | D_SOD-123 | 4 | BZT52C24
D401, D501, D601, D701 | SOT-23 | 4 | BAS70-04
D6 | D_SOD-123 | 1 | BZT52C15
D9 | D_SMB | 1 | SMBJ6.0A
F1, F2, F3 | 1206 | 3 | 1A T
J1, J2, J3, J7, J8, J9 | SO239_83-798_StrapPad_BossRight | 6 | 83-798 SO-239
J10 | SO239_83-798_StrapPad_BossLeft | 1 | 83-798 SO-239
J11, J12 | AMASS_XT60PW-M_1x02_P7.20mm_Horizontal | 2 | XT60PW-M
J13 | AMASS_XT30PW-M_1x02_P2.50mm_Horizontal | 1 | XT30PW-M
J14 | PinHeader_2x12_P2.54mm_Vertical | 1 | Controller header
J4, J5, J6 | SMA_901-9215_StrapPad | 3 | SMA jack EXP
K101, K102, K104, K105, K106, K107, K108, K109, K110, K111, K201, K202, K204, K205, K206, K207, K208, K209, K210, K211, K301, K302, K304, K305, K306, K307, K308, K309, K310, K311, K401, K501, K601, K701 | Relay_SPDT_Schrack-RT1-16A-FormC_RM5mm | 34 | RTD14012F
Q1 | SOT-23 | 1 | PMV50EPEA
Q101, Q1013, Q102, Q1023, Q1033, Q104, Q1043, Q105, Q106, Q107, Q108, Q109, Q110, Q111, Q2, Q201, Q202, Q204, Q205, Q206, Q207, Q208, Q209, Q210, Q211, Q301, Q302, Q304, Q305, Q306, Q307, Q308, Q309, Q310, Q311, Q401, Q501, Q601, Q701 | SOT-23 | 39 | BSS138BK
Q1011, Q1021, Q1031, Q1041 | SOT-23 | 4 | BC857B
Q1012, Q1022, Q1032, Q1042 | SOT-223-3_TabPin2 | 4 | IRFL9014
R1, R1016, R1026, R1036, R1046, R801, R811, R812, R813, R814, R831, R832, R833, R834, R903 | 0603 | 15 | 10k
R101, R1012, R1014, R102, R1022, R1024, R1032, R1034, R104, R1042, R1044, R105, R106, R107, R108, R109, R110, R111, R201, R202, R204, R205, R206, R207, R208, R209, R210, R211, R3, R301, R302, R304, R305, R306, R307, R308, R309, R310, R311, R406, R506, R606, R706, R904 | 0603 | 44 | 100k
R1011, R1021, R1031, R1041 | 0805 | 4 | 10R
R1013, R1023, R1033, R1043, R404, R405, R504, R505, R604, R605, R704, R705 | 0603 | 12 | 47k
R1015, R1025, R1035, R1045 | 0603 | 4 | 33k
R1201, R1202, R1203, R1204, R1205, R1206, R1207, R1208, R1209 | 0603 | 9 | 0R
R2, R901, R902 | 0603 | 3 | 2k2
R4 | 1206 | 1 | 0R
R401, R501, R601, R701 | R_Axial_DIN0207_L6.3mm_D2.5mm_P10.16mm_Horizontal | 4 | 1M HV
R402, R502, R602, R702 | WireLink_P7.62mm_D1.0mm | 4 | 0R wire link
R802 | 0603 | 1 | 1k
R821, R822, R823, R824 | 0603 | 4 | 1M
RN1001, RN1002, RN901, RN902, RN903 | R_Array_Convex_4x0603 | 5 | 10k x4
U1 | SOT-23-5 | 1 | LP2985-33
U1001, U901, U902, U903 | TSSOP-24_4.4x7.8mm_P0.65mm | 4 | PCA9539
U801 | SOIC-14_3.9x8.7mm_P1.27mm | 1 | LM2901
