PE1RGU/hf-antenna-switch/hardware/unit/controller-board/production/bom.csv

Designator | Footprint | Quantity | Value | LCSC Part #
A1 | ESP32-C3-DevKit-RUST_Socket | 1 | ESP32-C3-DevKit-RUST-1
C1, C11, C14, C15, C16, C17, C2, C3, C4, C5 | 0603 | 10 | 1u 16V X7R
C12 | 0603 | 1 | 10n 50V X7R
C13 | 0805 | 1 | 4.7u 16V X7R
D11, D21, D31, D41 | D_SMB | 4 | SMBJ15CA
D12, D22, D32, D42 | D_SOD-123 | 4 | 1N4148W
GD1, GD2, GD3, GD4 | GDT_3Pin_P4.40mm_Bourns-2036-B2_Littelfuse-SL1003A-R | 4 | 2036-09-B2LF
J1 | RJ45_8P8C_Unshielded_TabDown | 1 | RJ45 LINK
J2 | PinSocket_2x12_P2.54mm_Vertical | 1 | to RF board J14
JP11 | SolderJumper-3_P1.3mm_Bridged12_RoundedPad1.0x1.5mm_NumberLabels | 1 | SDA SEL
L1, L2, L3, L4 | L_CMC_TDK_ACT45B | 4 | 51u CMC
Q4 | SOT-23 | 1 | BSS138BK
R11, R12, R21, R22, R31, R32, R41, R42 | R_MELF_MMB-0207 | 8 | 47R
R13, R23, R33 | R_MiniMELF_MMA-0204 | 3 | 220R
R14, R24, R34 | 0603 | 3 | 4.7k
R35 | 0603 | 1 | 240R
R36, R44, R62, R63 | 0603 | 4 | 100k
R43 | 0603 | 1 | 220R
R51, R64 | 0603 | 2 | 0R
R61, R66 | 0603 | 2 | 1k
R65 | 1206 | 1 | 0R
U1, U2, U3 | DIP-8_W7.62mm | 3 | VO2611
U11 | SOT-23-5 | 1 | LP2985-33
U12 | SOT-23-5 | 1 | TPS3823A-33
U13 | VSSOP-8_2.3x2mm_P0.5mm | 1 | 74LVC1G74
U14 | SOT-23-6 | 1 | 74LVC1G27
U15 | SOT-23-5 | 1 | 74LVC1G02
U16 | SOT-23-5 | 1 | 74LVC1G08
U4 | DIP-4_W7.62mm | 1 | PC817X
U5 | SOT-23-5 | 1 | 74LVC1G14
U6 | SOP-4_P2.54mm_PhotoRelay_LongPad | 1 | TLP176AM
