PE1RGU/hf-antenna-switch/hardware/shack-interface/case/ref-shack-interface-p8.step

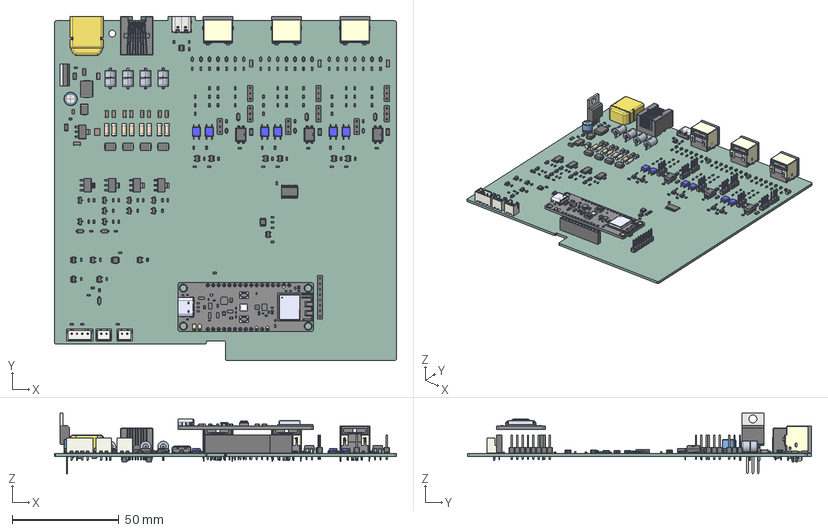
[picture p47: CAD file, 2026-10-29]
hardware/shack-interface/case/ref-shack-interface-p8.step
160.0 x 161.0 x 28.5 mm
R_MELF_MMD-0207 x 8
PinSocket_1x16_P2.54mm_Vertical
PinSocket_1x12_P2.54mm_Vertical
ESP32-C3-DevKit-RUST-1
R_0603_1608Metric x 81
D_SOD-323 x 24
C_0603_1608Metric x 40
SOT-223 x 5
SOT-23 x 9
SOT-23-5 x 12
DIP-4_W7.62mm x 3
D_SMB x 5
C_1206_3216Metric x 13
D_SOD-123 x 6
PinHeader_1x03_P254mm_Vertical x 9
PinHeader_1x08_P254mm_Vertical
2.54SOP4 x 6
TSSOP-24_4.4x7.8mm_P0.65mm
C_0805_2012Metric
CP_Radial_D63mm_P250mm
JST_B2B_XH_A x 2
Fuse_1206_3216Metric
R_1206_3216Metric x 5
2036-XX-B2 x 4
CUI_DEVICES_MD-80SM x 3
SSOP-8_2.95x2.8mm_P0.65mm x 2
USB_C_Receptacle_16P_TopMnt_Horizontal_GCT_USB4105-xx-A
JST_B4B_XH_A
D_SMC
Pin1
Pin3
Pin5
Pin7
Pin2
Pin4
Pin6
Pin8
housing
SOT-23-6
C_1210_3225Metric
XT60PW-M
TO-220-3_Vertical
shack-interface_PCB
