PE1RGU/hf-antenna-switch/hardware/shack-interface/endplates/display-frame/display-frame.step

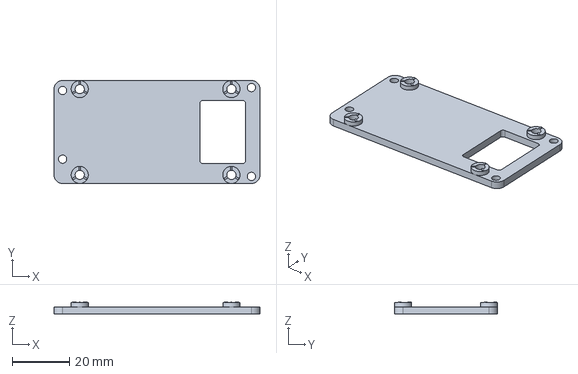
[picture p48: CAD file, 2026-10-29]
hardware/shack-interface/endplates/display-frame/display-frame.step
72.0 x 36.0 x 4.20 mm
