PE1RGU/hf-antenna-switch/hardware/unit/case/fit-print/rf-case-fit-tray-left.3mf

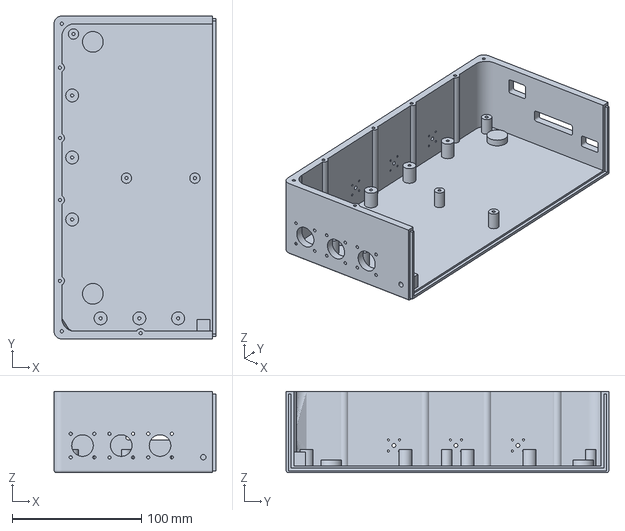
[picture p50: CAD file, 2026-11-10]
hardware/unit/case/fit-print/rf-case-fit-tray-left.3mf
125.2 x 250.0 x 63.0 mm
