PE1RGU/hf-antenna-switch/hardware/unit/case/rf-case-tray.step

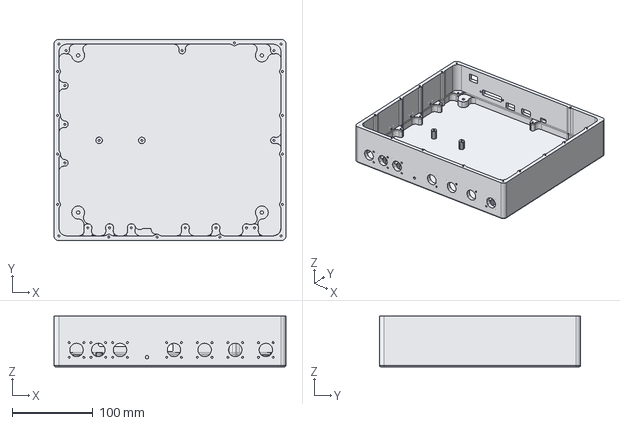
[picture p51: CAD file, 2026-11-10]
hardware/unit/case/rf-case-tray.step
288.0 x 250.0 x 63.0 mm
