PE1RGU/hf-antenna-switch/hardware/shack-interface/case/ref-shack-interface.step

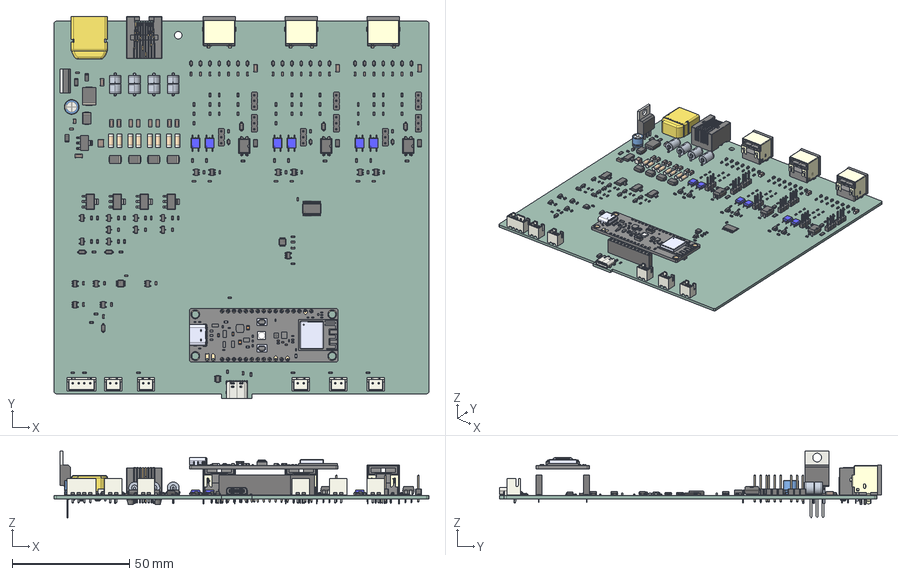
[picture p52: CAD file, 2026-10-27]
hardware/shack-interface/case/ref-shack-interface.step
160.0 x 163.0 x 28.5 mm
C_1206_3216Metric x 13
R_0603_1608Metric x 84
C_0603_1608Metric x 40
D_SOD-323 x 24
D_SOD-123 x 6
CUI_DEVICES_MD-80SM x 3
PinHeader_1x03_P254mm_Vertical x 9
PinSocket_1x16_P2.54mm_Vertical
PinSocket_1x12_P2.54mm_Vertical
ESP32-C3-DevKit-RUST-1
2.54SOP4 x 6
TSSOP-24_4.4x7.8mm_P0.65mm
TO-220-3_Vertical
DIP-4_W7.62mm x 3
2036-XX-B2 x 4
XT60PW-M
R_MELF_MMD-0207 x 8
USB_C_Receptacle_16P_TopMnt_Horizontal_GCT_USB4105-xx-A
SOT-23 x 9
SOT-23-5 x 12
D_SMB x 5
JST_B2B_XH_A x 5
SOT-223 x 5
Pin1
Pin3
Pin5
Pin7
Pin2
Pin4
Pin6
Pin8
housing
R_1206_3216Metric x 5
SSOP-8_2.95x2.8mm_P0.65mm x 2
CP_Radial_D63mm_P250mm
C_1210_3225Metric
C_0805_2012Metric
SOT-23-6
JST_B4B_XH_A
D_SMC
Fuse_1206_3216Metric
shack-interface_PCB
