PE1RGU/hf-antenna-switch/hardware/shack-interface/endplates/front-panel.step

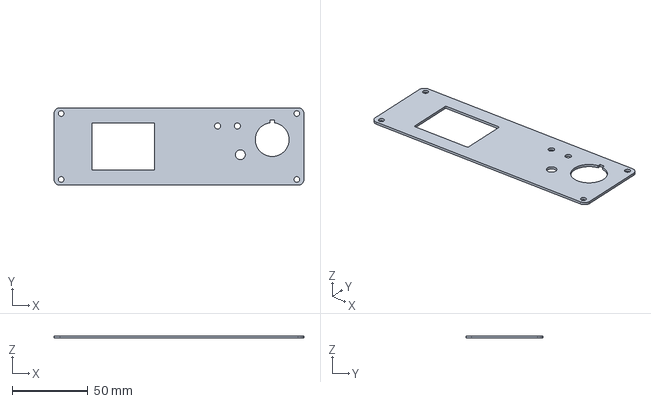
[picture p53: CAD file, 2026-10-29]
hardware/shack-interface/endplates/front-panel.step
165.0 x 51.1 x 1.51 mm
