PE1RGU/hf-antenna-switch/hardware/unit/case/fit-print/rf-case-fit-lid-left.stl

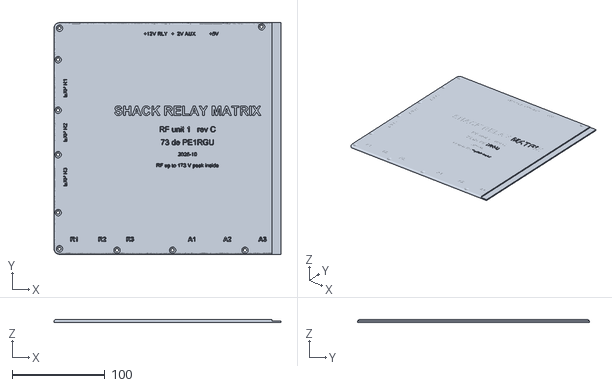
[picture p54: CAD file, 2026-11-10]
hardware/unit/case/fit-print/rf-case-fit-lid-left.stl
244.9 x 250.0 x 3.00
