PE1RGU/hf-antenna-switch/hardware/unit/case/rf-case-lid.step

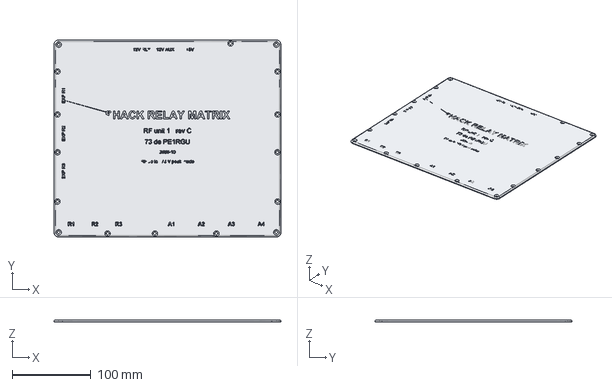
[picture p55: CAD file, 2026-11-10]
hardware/unit/case/rf-case-lid.step
288.0 x 250.0 x 3.00 mm
