PE1RGU/hf-antenna-switch/hardware/unit/case/fit-print/rf-case-fit-tray-right.3mf

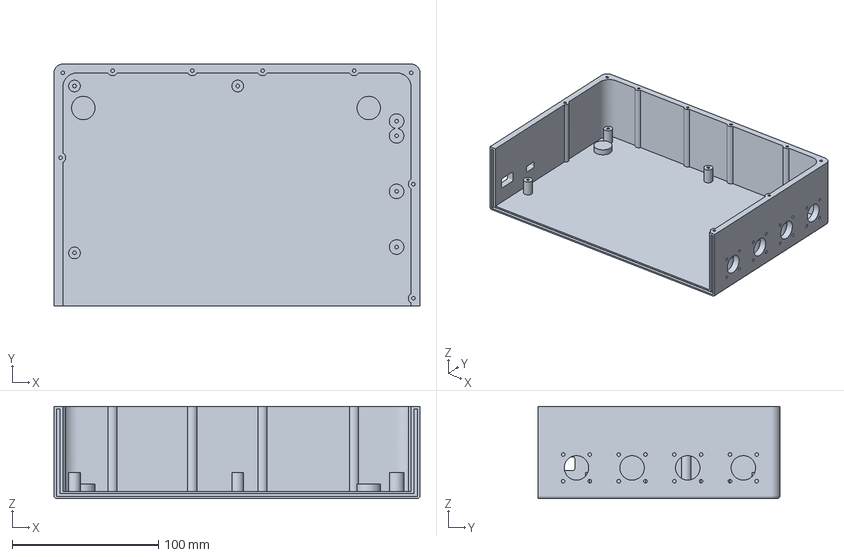
[picture p56: CAD file, 2026-11-10]
hardware/unit/case/fit-print/rf-case-fit-tray-right.3mf
250.0 x 165.2 x 63.0 mm
