PE1RGU/hf-antenna-switch/hardware/unit/case/rf-case.step

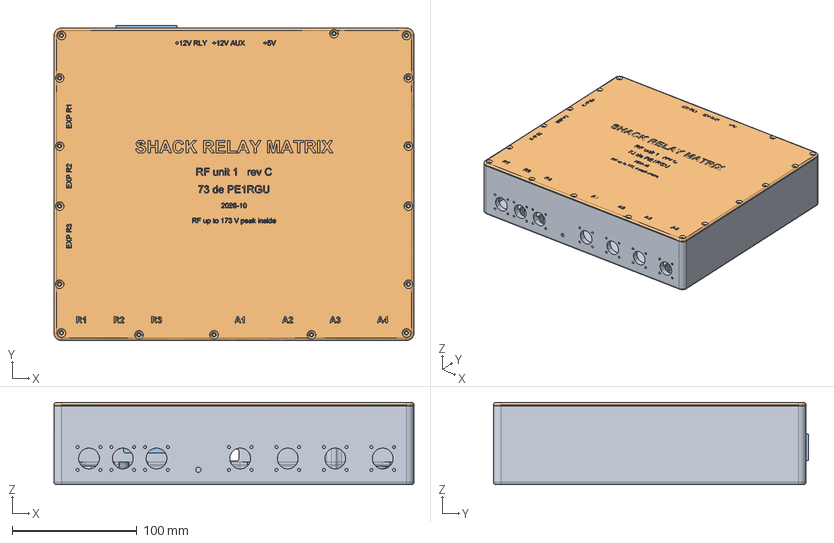
[picture p57: CAD file, 2026-11-10]
hardware/unit/case/rf-case.step
288.0 x 252.0 x 66.0 mm
