PE1RGU/hf-antenna-switch/hardware/unit/case/rf-case-spacer.stl

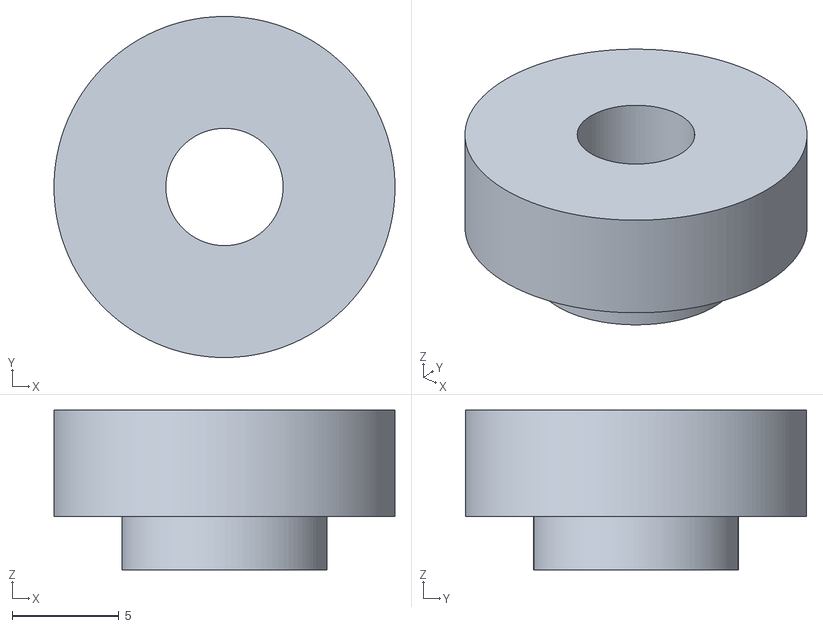
[picture p58: CAD file, 2026-10-27]
hardware/unit/case/rf-case-spacer.stl
16.0 x 16.0 x 7.50
