PE1RGU/hf-antenna-switch/hardware/unit/case/ref-sma-142-0701-631.step

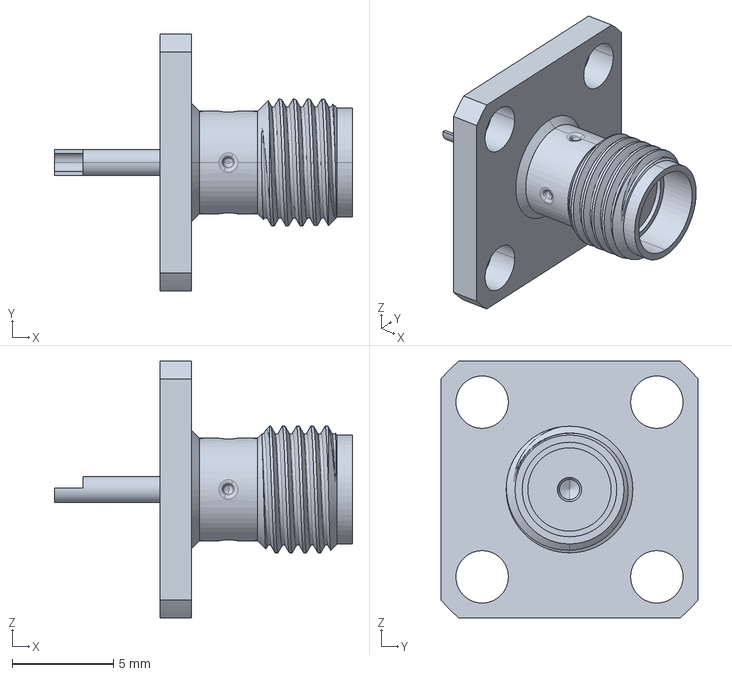
[picture p59: CAD file, 2026-10-27]
hardware/unit/case/ref-sma-142-0701-631.step
14.7 x 12.7 x 12.7 mm
