PE1RGU/hf-antenna-switch/hardware/unit/case/ref-rf-board.step

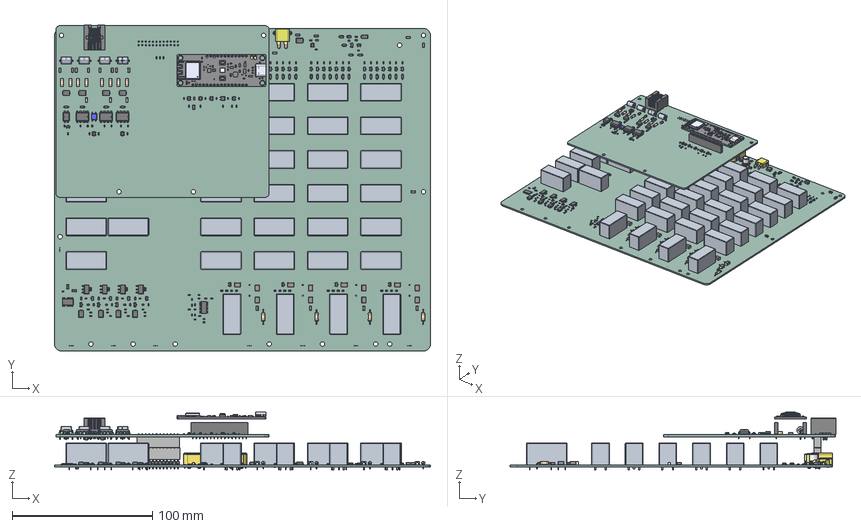
[picture p60: CAD file, 2026-10-27]
hardware/unit/case/ref-rf-board.step
268.0 x 232.4 x 41.2 mm
C_0603_1608Metric x 41
SOT-23 x 52
D_SOD-123 x 46
R_0603_1608Metric x 109
C-2-1419108-9 x 37
R_0805_2012Metric x 4
D_SMB x 11
XT30PW-M
TSSOP-24_4.4x7.8mm_P0.65mm x 4
C_1206_3216Metric x 19
XT60PW-M x 2
R_Array_Convex_4x0603 x 5
R_Axial_DIN0207_L63mm_D25mm_P1016mm_Horizontal x 4
C_1812_4532Metric x 8
L_1812_4532Metric x 4
PinHeader_2x12_P254mm_Vertical
CP_Elec_63x77 x 2
SOT-223 x 4
SOIC-14_3.9x8.7mm_P1.27mm
R_1206_3216Metric x 2
C_0805_2012Metric x 5
SOT-23-5 x 6
Fuse_1206_3216Metric x 3
D_SMA
DIP-8_W7.62mm x 3
R_MELF_MMD-0207 x 8
2036-XX-B2 x 4
PinSocket_1x16_P2.54mm_Vertical
PinSocket_1x12_P2.54mm_Vertical
ESP32-C3-DevKit-RUST-1
R_MiniMELF_MMA-0204 x 3
DIP-4_W7.62mm
SOT-23-6
Pin1
Pin3
Pin5
Pin7
Pin2
Pin4
Pin6
Pin8
housing
2.54SOP4
SSOP-8_2.95x2.8mm_P0.65mm
ESQ-112-33-G-D_socket
ESQ-112-33-G-D_pins
ESQ-112-33-G-D2_pins
ESQ-112-33-G-D-LL_bpins
controller-board_PCB
rf-board_PCB
