PE1RGU/hf-antenna-switch/hardware/unit/case/ref-sma-132166.step

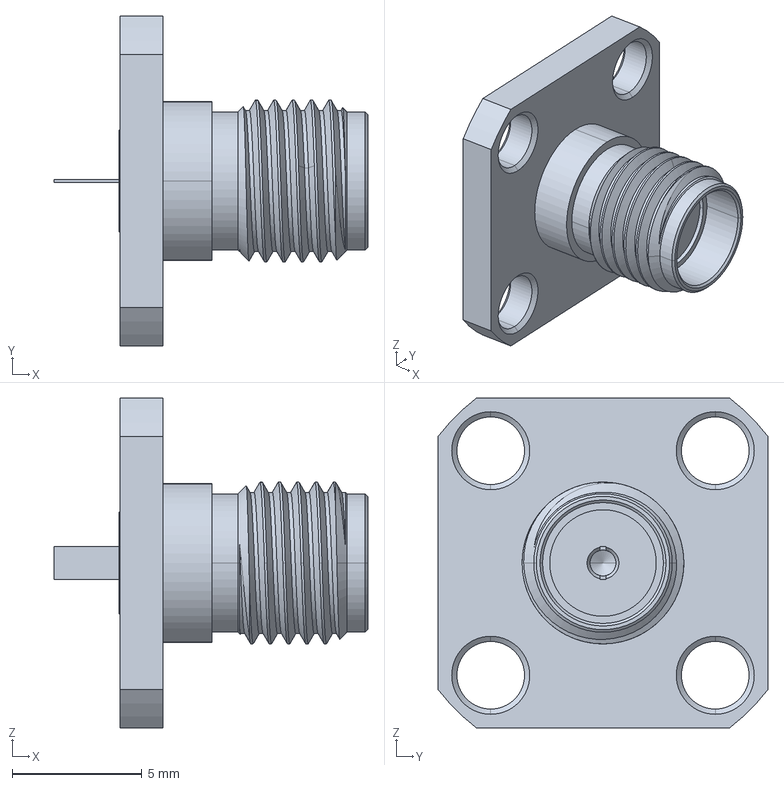
[picture p61: CAD file, 2026-10-27]
hardware/unit/case/ref-sma-132166.step
12.1 x 12.7 x 12.7 mm
