PE1RGU/hf-antenna-switch/hardware/unit/case/ref-so239-83-1R.step

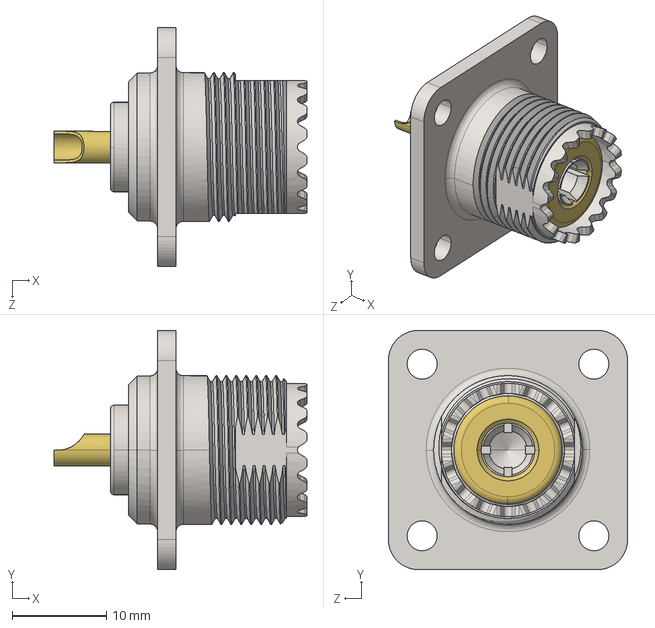
[picture p62: CAD file, 2026-10-27]
hardware/unit/case/ref-so239-83-1R.step
26.9 x 25.4 x 25.4 mm
