PE1RGU/hf-antenna-switch/hardware/unit/case/rf-case-exp-plate.step

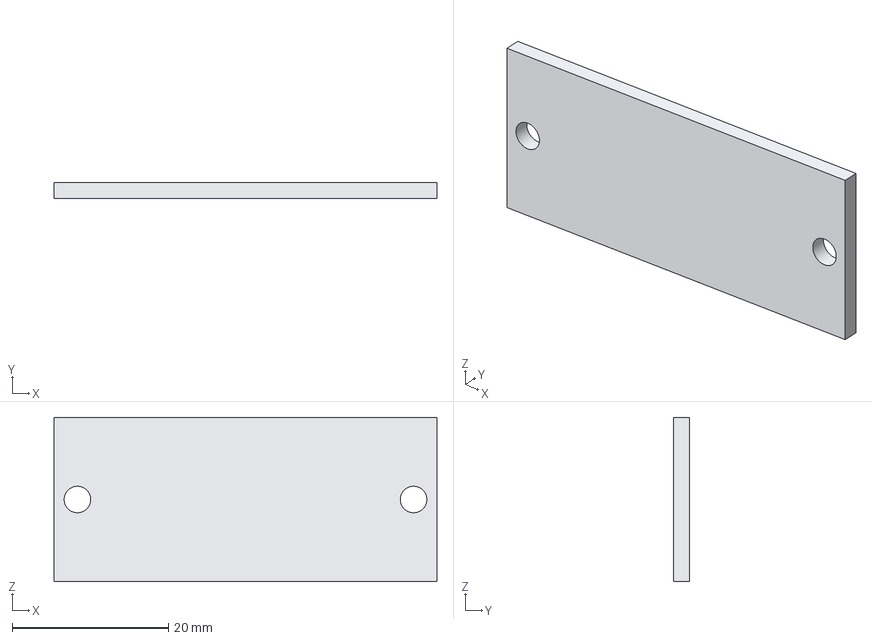
[picture p63: CAD file, 2026-10-27]
hardware/unit/case/rf-case-exp-plate.step
49.0 x 2.00 x 21.0 mm
