PE1RGU/hf-antenna-switch/hardware/unit/case/ref-controller-board.step

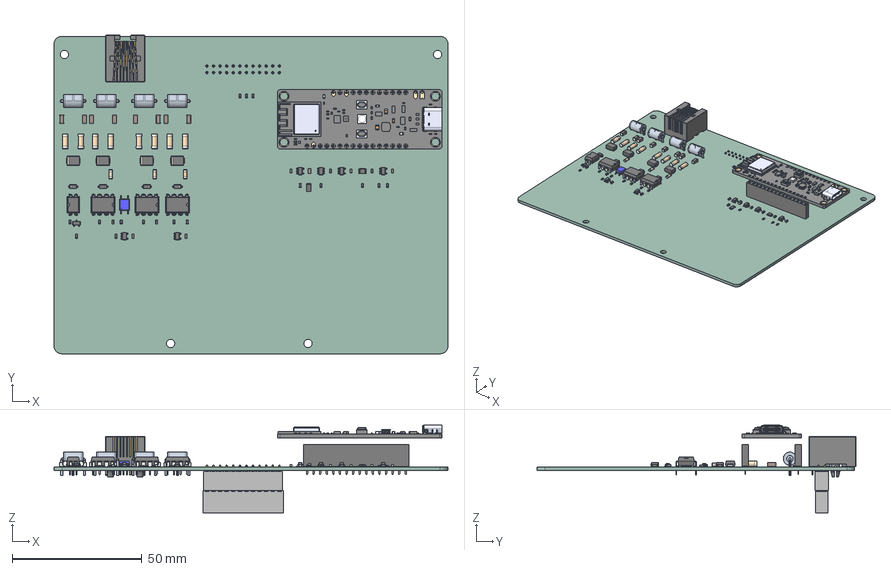
[picture p64: CAD file, 2026-10-27]
hardware/unit/case/ref-controller-board.step
152.0 x 123.0 x 33.8 mm
R_0603_1608Metric x 14
D_SMB x 4
DIP-4_W7.62mm
2036-XX-B2 x 4
R_MELF_MMD-0207 x 8
C_1206_3216Metric x 8
C_0603_1608Metric x 11
SOT-23-5 x 5
R_MiniMELF_MMA-0204 x 3
SOT-23
DIP-8_W7.62mm x 3
D_SOD-123 x 4
SOT-23-6
VSSOP-8_2.3x2mm_P0.5mm
Pin1
Pin3
Pin5
Pin7
Pin2
Pin4
Pin6
Pin8
housing
C_0805_2012Metric
2.54SOP4
R_1206_3216Metric
PinSocket_1x16_P2.54mm_Vertical
PinSocket_1x12_P2.54mm_Vertical
ESP32-C3-DevKit-RUST-1
ESQ-112-33-G-D_socket
ESQ-112-33-G-D_pins
ESQ-112-33-G-D2_pins
ESQ-112-33-G-D-LL_bpins
controller-board_PCB
