PE1RGU/hf-antenna-switch/(list of files, cad)

Other CAD files:
hardware/shack-interface/case/hammond/1455T1601.stp
hardware/shack-interface/endplates/_archive/front-a7-1.9in/display-frame/display-frame.step
hardware/shack-interface/endplates/_archive/front-a7-1.9in/display-frame/display-frame.stl
hardware/shack-interface/endplates/_archive/front-a7-1.9in/front-panel.step
hardware/shack-interface/endplates/display-frame/display-frame.3mf
hardware/shack-interface/endplates/display-frame/display-frame.stl
hardware/unit/case/rf-case-washer.stl
