PE1RGU/hf-antenna-switch/hardware/unit/verify/system-verification.md

# System logic verification: SAFE loop, latches, TX permit (design level)

Generated by `verify_system.py` from the decisions D-62 to D-75. Levels: 1 = true or high, 0 = false or low. Section 0 checks the drawn netlists against the connections the model uses.

## 0. Topology checks against the netlists

Shack interface (gen_shack_sch.py) and controller board (gen_controller_sch.py). Each row is one connection the model below relies on.

| Check | Result |
|---|---|
| Shack loop source: +13V8, R33 sense, Q31 BCP53 with Q32 BC857 current limit (D-74) | pass |
| Software stop: U5 IO0_0 drives Q33, which turns the source on through R34; R35 100k pull-up keeps the loop closed in reset (D-68) | pass |
| Series path: Q31 collector, KILL switch J2, R31 47R, L3P on J1 pin 3; return L3N on J1 pin 6, R32 47R (Cat6 pair 3, T568B) | pass |
| Loop return through R36 100R to GND; Q34 base from that node through R37, D33 base clamp (D-80) | pass |
| SAFE_LOST = Q34 collector with R38 pull-up: no loop current = high; to U7 and through R61 to IO21 | pass |
| PRE_N = AND(SAFE_OK = NOT SAFE_LOST, POR_N of U6) into U9 PRE_N only (D-75) | pass |
| U9: D = GND, CLR_N = +3V3, CLK = U10 (debounced RESET) only | pass |
| RESET button: J6 pin 1 to GND, R71 1k, R72 100k pull-up, C71 100n, D71 to 3V3, into U10 (D-84) | pass |
| U6 TPS3823A-33: WDI and MR open (watchdog off, power-on reset only) | pass |
| LATCHED = U9 Q to the NOR, the panel LED and U5 IO1_7 | pass |
| Shack FAULT = U4 Q (set by U3 RESET_N, which also resets U5) to the NOR only | pass |
| TX_EN = NOR(FAULT, LATCHED) to the AND gate of every port, nothing else | pass |
| R1 TX INH: LED of U203 (TLP4176G, form B) = AND(PERMIT_R1 with 100k pull-down, TX_EN) | pass |
| R1 keying: LED of U204 (TLP176AM, form A) = AND(KEY_R1 with 100k pull-down, INH_ON) | pass |
| R1 INH contact: DIN pin 2 to INH LEVEL JP201: 3 = RGND (LOW), 1 = DIN6 through 2k2 and 5V1 zener (HIGH) | pass |
| R1 keying contact: RGND to DIN pin 1 through PIN1 SEL JP202 (1-2) | pass |
| R2 TX INH: LED of U303 (TLP4176G, form B) = AND(PERMIT_R2 with 100k pull-down, TX_EN) | pass |
| R2 keying: LED of U304 (TLP176AM, form A) = AND(KEY_R2 with 100k pull-down, INH_ON) | pass |
| R2 INH contact: DIN pin 2 to INH LEVEL JP301: 3 = RGND (LOW), 1 = DIN6 through 2k2 and 5V1 zener (HIGH) | pass |
| R2 keying contact: RGND to DIN pin 1 through PIN1 SEL JP302 (1-2) | pass |
| R3 TX INH: LED of U403 (TLP4176G, form B) = AND(PERMIT_R3 with 100k pull-down, TX_EN) | pass |
| R3 keying: LED of U404 (TLP176AM, form A) = AND(KEY_R3 with 100k pull-down, INH_ON) | pass |
| R3 INH contact: DIN pin 2 to INH LEVEL JP401: 3 = RGND (LOW), 1 = DIN6 through 2k2 and 5V1 zener (HIGH) | pass |
| R3 keying contact: RGND to DIN pin 1 through PIN1 SEL JP402 (1-2) | pass |
| Cat6 #1, straight T568B cable: every loop has the same pins and the same P/N wire on both J1 (pairs 4/5, 1/2, 3/6, 7/8) | pass |
| Controller: SAFE loop on J1 pins 3 and 6 (the same pair as the shack) | pass |
| Box: L3P, R31, R33, U3 LED anode; cathode to READY, R32, L3N; D32 across the LED (current from the shack enters on L3P) | pass |
| Box KILL = U3 output with R34 pull-up: no loop current = KILL high, into the RLY_EN NOR | pass |
| Box READY switch U6 (TLP176AM, form A) in series with the loop, between the U3 LED and R32 (D-62, D-101) | pass |
| READY LED: U16 output through R35 240R to U6 LED, cathode to GND | pass |
| U16 = AND(READY_ON, RF_A2_N): RF_A2_N from J2 pin 17 (RF board A2 detector), R36 100k pull-down: J2 open = READY open (D-104) | pass |
| SDA select JP61: pad 1 (bridged to 2 by copper) = SDA_IO10 = DevKit pad 17, the RUST-1 default the firmware uses (D-192) | pass |
| READY_ON = NOR(MCU_EN_N, FAULT) (U15); KILL is not an input, so the loop can start | pass |

### 0b. Shack interface: review against hardware-design-rules v2.2 (D-120, D-124, D-126, D-127, D-130)

| Check | Result |
|---|---|
| Shack: common-mode choke L1 to L4 per Cat6 pair between the 47R MELF and the GDT (D-130) | pass |
| Shack: Y-capacitor footprints C22 to C29 (DNP) behind the chokes to CHASSIS (D-130) | pass |
| Shack: current links R5 (+5V after U1) and R6 (+3V3 after U2) (D-120) | pass |
| Shack: test points on +13V8, +5V, +3V3 and on the 7 mini-DIN signal lines of each radio port (21) (D-120) | pass |
| Shack: IC and 3.3 V rail decoupling one value, 1 uF X7R (D-127); L7805 330n / 100n kept (D-124) | pass |
| Shack: U5 PCA9539 (TSSOP-24, three makers, D-133) | pass |

## 1. SAFE loop current and box gate (exhaustive, 256 rows)

Series loop (D-62, D-74): shack current source, KILL switch, software stop, shack sense opto, Cat6 pair 3, box opto U3, box READY switch. READY = NOR(MCU_EN_N, FAULT) AND NOT RF_A2 (box; RF_A2 = RF on the receive-only column A2, D-104). Box KILL = NOT loop current. RLY_EN = NOR(KILL, MCU_EN_N, FAULT) (D-59). The shack SAFE latch is not in the loop (section 3).

| KILL switch closed | Software stop | Cable | Shack power | Box power | MCU_EN_N | FAULT | RF on A2 | READY | Loop current | Box KILL | RLY_EN |
|---|---|---|---|---|---|---|---|---|---|---|---|
| 1 | 0 | 1 | 1 | 1 | 0 | 0 | 0 | 1 | 1 | 0 | 1 |
| 1 | 0 | 1 | 1 | 1 | 0 | 0 | 1 | 0 | 0 | 1 | 0 |
| 1 | 0 | 1 | 1 | 1 | 0 | 1 | 0 | 0 | 0 | 1 | 0 |
| 1 | 0 | 1 | 1 | 1 | 1 | 0 | 0 | 0 | 0 | 1 | 0 |
| 1 | 0 | 1 | 1 | 0 | 0 | 0 | 0 | 0 | 0 | 1 | 0 |
| 1 | 0 | 1 | 0 | 1 | 0 | 0 | 0 | 1 | 0 | 1 | 0 |
| 1 | 0 | 0 | 1 | 1 | 0 | 0 | 0 | 1 | 0 | 1 | 0 |
| 1 | 1 | 1 | 1 | 1 | 0 | 0 | 0 | 1 | 0 | 1 | 0 |
| 0 | 0 | 1 | 1 | 1 | 0 | 0 | 0 | 1 | 0 | 1 | 0 |

The table shows the normal row and every single-fault row; the check runs over all 256 rows.

| Check | Result |
|---|---|
| Loop current flows only when all eight conditions are good (wired AND) | pass |
| RLY_EN = loop current in every row: any break anywhere drops the box relays | pass |
| READY does not depend on KILL: the loop can start | pass |
| RF on A2 opens the loop and drops RLY_EN in every row (SR-01 H2, D-104) | pass |

## 2. Box start-up order against the SAFE loop

| Order | Trace | Loop current at end |
|---|---|---|
| Rule 3 of verify_logic.py (check KILL = 0, then MCU_EN_N = 0) | LATCH_CLR: READY 0, loop 0, KILL 1; waits for KILL = 0: READY is 0, so the loop cannot close: **deadlock** | 0 |
| D-62 order (LATCH_CLR, MCU_EN_N = 0, then wait for KILL = 0) | LATCH_CLR: READY 0, loop 0, KILL 1; MCU_EN_N=0: READY 1, loop 1, KILL 0; wait KILL=0: READY 1, loop 1, KILL 0 | 1 |

| Check | Result |
|---|---|
| Old rule 3 deadlocks under D-62 (expected: shows the conflict) | pass |
| D-62 start-up order closes the loop | pass |

**Finding F11 (firmware).** Rules 3 and 5 of verify_logic.py (section 10) wait for KILL = 0 before MCU_EN_N = 0. With the SAFE loop (D-62), KILL goes to 0 only after MCU_EN_N = 0, so these rules deadlock. New rule: LATCH_CLR, then MCU_EN_N = 0, then wait for KILL = 0 (timeout: report 'SAFE loop open'). On KILL = 1 the relays are already off (the expanders are held in reset by RLY_EN = 0). After KILL returns to 0, the firmware must set up the expanders again (F1 order) before any switching. F5 is reworded in the same way: the relays do not return in their last state, they return off.

## 3. Shack SAFE latch (74LVC1G74, D-75)

PRE_N = loop OK AND power OK. A rising edge of the debounced RESET clocks D = 0, only while PRE_N is high. LATCHED = Q. Event sequences, one step per row.

| Sequence | Events (loop, power, RESET) | LATCHED per step | Expected | Result |
|---|---|---|---|---|
| L1 power-up, loop OK, RESET pressed | (1, 0, 0) (1, 1, 0) (1, 1, 1) (1, 1, 0) | [1, 1, 0, 0] | [1, 1, 0, 0] | as intended |
| L2 loop lost, then back without RESET | (1, 1, 0) (1, 1, 1) (0, 1, 0) (1, 1, 0) | [1, 0, 1, 1] | [1, 0, 1, 1] | as intended |
| L3 RESET pressed while the loop is open | (1, 1, 1) (0, 1, 0) (0, 1, 1) (0, 1, 0) | [0, 1, 1, 1] | [0, 1, 1, 1] | as intended |
| L4 RESET held down while the loop drops and returns | (1, 1, 1) (0, 1, 1) (1, 1, 1) (1, 1, 1) | [0, 1, 1, 1] | [0, 1, 1, 1] | as intended |
| L5 short shack power dip | (1, 1, 1) (1, 1, 0) (1, 0, 0) (1, 1, 0) | [0, 0, 1, 1] | [0, 0, 1, 1] | as intended |

| Check | Result |
|---|---|
| Only a RESET edge with the loop current present clears the latch; a held or early RESET does not | pass |

## 4. TX INH and keying per radio port (D-71)

TX INH: form B PhotoMOS, LED = permit AND NOT shack FAULT AND NOT LATCHED (and shack power). LED off = contact closed = inhibit. Keying: form A PhotoMOS, LED = key AND the same condition.

| Permit | Key | Shack FAULT | LATCHED | Shack power | INH contact | Radio inhibited | Keying contact |
|---|---|---|---|---|---|---|---|
| 1 | 1 | 0 | 0 | 1 | open | no | closed |
| 1 | 1 | 0 | 0 | 0 | closed | yes | open |
| 1 | 1 | 0 | 1 | 1 | closed | yes | open |
| 1 | 1 | 1 | 0 | 1 | closed | yes | open |
| 1 | 0 | 0 | 0 | 1 | open | no | open |
| 0 | 1 | 0 | 0 | 1 | closed | yes | open |

| Jumper | Contact closed (inhibit) gives | Contact open gives |
|---|---|---|
| LOW | radio TX INH pin at radio GND | pin at the radio's own pull-up level |
| HIGH | pin at the radio supply through the series resistor | pin at the radio's own pull-down level |
| removed | no effect | no effect (radio keyed only by the interface) |

| Check | Result |
|---|---|
| Keying contact is never closed while the inhibit is closed | pass |
| Any missing condition (permit, fault, latch, power) inhibits | pass |
| Unpowered interface: inhibit closed, keying open, in both jumper levels | pass |

## 5. TX handshake for R2 and R3, timed (D-63)

Model, 1 ms steps. Link message 4 ms. Box: on request it checks the state, sets K0, waits 12 ms, reads back, sends the permit. K0 contact: TX 12 ms after the command (operate plus bounce, max); back to RX after the release time (0 ms used as the worst case, because RT1 gives no minimum; 6 ms max). Radio: RF starts when keyed and not inhibited; RF stops t_inh after the inhibit and t_tail after the key opens (both to measure). Hazard X: RF present while the K0 contact is not on the TX row.

| Case | Hazard X (ms with RF off the TX row) | Reading |
|---|---|---|
| N1 normal TX, radio tail 5 ms | 0 | handshake keeps RF on the TX row |
| N2 normal TX, radio tail 50 ms | 0 | the shack waits for TX sense inactive, so a long tail is covered |
| E1 SAFE stop at 0.5 s during TX, radio stops 5 ms after the inhibit | 5 | K0 of R2/R3 drops at once (U903 in reset); RF tail breaks the K0 contact |
| E2 SAFE stop at 0.5 s, radio stops 0 ms after the inhibit | 0 | no hazard only if the radio stops at once |
| E3 shack MCU hangs at 0.5 s with permit set | 0 | box keeps K0: no hazard while the box state does not change |
| E4 TX sense opto failed (reads no TX), radio stops 20 ms after the inhibit | 15 | 'end' goes out at once; K0 releases under RF |
| E5 as E4, shack waits at least 100 ms after the inhibit | 0 | the minimum wait covers a failed TX sense |

| Check | Result |
|---|---|
| Normal handshake: no RF off the TX row, for short and long RF tails | pass |
| Shack MCU hang: the box keeps K0, the shack fault latch inhibits after the watchdog time-out | pass |
| SAFE stop during TX: hazard X depends on the radio inhibit response (expected: shows the weakness, accepted D-76) | pass |
| Failed TX sense: hazard without a minimum wait, none with it (F14) | pass |

**Finding F12 (design).** On a SAFE stop, the box drops RLY_EN at once. U903 goes into reset, so K0 of R2 and R3 releases within 0 to 6 ms, and all row relays open. At the same moment the shack inhibits the radio. A radio that needs a few ms to stop RF after the inhibit then sends RF across an opening K0 and row contacts. R1 is different: its K0 follows the FT-710 TX GND through the PTT loop, which stays closed until the radio ends TX. Row relays opening under RF on an emergency stop is inherent to any stop. The K0 of R2 and R3 could be held for about 50 ms after RLY_EN drops, so the radio is off before K0 moves. This is a decision for later (two options).

**Finding F13 (firmware).** The box must not change K0 or any relay of a radio while its permit is out. On a link time-out it must not release K0; it opens SAFE (MCU_EN_N = 1) instead, which inhibits every radio in hardware at the shack (and then F12 applies).

**Finding F14 (firmware).** An ageing or failed TX sense opto reads 'no TX': this failure is not fail-safe. (The LED ageing of the PhotoMOS parts is fail-safe: a weak LED keeps the form B contact closed, so the radio stays inhibited, and keeps the form A keying contact open.) Rule: after the inhibit, the shack waits for TX sense inactive and at least a minimum time (proposed 100 ms, longer than the measured inhibit response, M-12) before it sends 'end'. A plausibility check flags a port whose TX sense stays inactive while the radio is keyed.

## 6. Firmware rules added by this verification

1. Box start-up: LATCH_CLR, then MCU_EN_N = 0, then wait for KILL = 0 with a time-out; then set up the expanders (F1), then switch (F11). Replaces rule 3 of verify_logic.py.
2. Box on KILL = 1: relays are off in hardware; after KILL = 0, set up the expanders again before any switching (F11). Replaces rule 5 (F5).
3. Box: no change to K0 or to the rows of a radio while its permit is out; on a link time-out, open SAFE, do not release K0 (F13).
4. Shack: at TX end, first inhibit (permit 0, key 0), then wait for TX sense inactive and at least 100 ms (F14), then send 'end' to the box (section 5).
5. Shack: flag a port as faulty when TX sense stays inactive while the port is keyed or the radio should transmit (F14).
6. Shack: kick its own watchdog only from the main loop; a hang then drops all permits (E3).

## Result

All checks pass. Findings F11 to F14: firmware rule changes (F11, F13, F14) and one accepted design point (F12, D-76).
