PE1RGU/hf-antenna-switch/hardware/unit/verify/logic-verification.md

# Logic verification: Shack Relay Matrix rev C (unit 1)

Generated by `verify_logic.py` from the KiCad netlists of the RF board and the controller board. Every connection that the tables use is first checked against the netlists (section 1). Levels: 1 = high, 0 = low, Z = not driven (floating before pull resistors).

## 1. Topology checks against the netlists

| Check | Result |
|---|---|
| Controller: RLY_EN = U14 output to J2 pin 7 only | pass |
| U14 NOR inputs: KILL (pin 3), MCU_EN_N (pin 1), FAULT = U13 Q (pin 6); FAULT also to the READY gate U15 (D-62) | pass |
| U13 PRE_N (pin 7) = U12 RESET_N only | pass |
| U13 D (pin 2) = GND, CLR_N (pin 6) = +3V3 | pass |
| LATCH_CLR = U13 CLK, R62 100k pull-down | pass |
| MCU_EN_N: R63 100k pull-up to +3V3 | pass |
| WDI: R61 1k to GND (floating WDI would disable the watchdog) | pass |
| U12 TPS3823A-33, MR (pin 3) open (internal 90k pull-up) | pass |
| KILL = U3 opto output (loop 3) with R34 pull-up: loop open = KILL high | pass |
| PTT_N = U2 opto output (loop 2), R24 pull-up, into U5 (Schmitt inverter) | pass |
| TX_ANY (U5 out) to R1..R3_K0_DRV through the 0R footprints R51..R53 | pass |
| R51 fitted (R1 K0 follows PTT); R52, R53 not fitted: R2, R3 K0 come from U903 (D-63) | pass |
| J2 / J14 pin 7 = RLY_EN on both boards | pass |
| J2 / J14 pin 9 = TX_ANY on both boards | pass |
| J2 / J14 pin 11 = R1_K0_DRV on both boards | pass |
| J2 / J14 pin 13 = R2_K0_DRV on both boards | pass |
| J2 / J14 pin 15 = R3_K0_DRV on both boards | pass |
| RF board: RLY_EN = R3 100k pull-down, Q2 gate, RESET of U901, U902, U903, U1001 | pass |
| +12V_SW switch: Q2 (RLY_EN) pulls Q1 gate low through R2; R1 holds Q1 off | pass |
| J14 / J2 pin 17: RF board A2 detector output (A2_RFDET, also U901 input) to the controller READY gate U16 (D-104, SR-01 H2) | pass |
| SR-01: TX relays at A2 (K103, K203, K303) and their drivers Q, D, R not fitted; all other row relays fitted (D-103) | pass |
| 37 relays: coil to supply, low-side N-MOSFET to GND, 100k gate pull-down on every gate | pass |
| K0 (K101, K201, K301) on +12V_RLY (not switched); the other 34 coils on +12V_SW | pass |
| K0 gates on J14 and U903: IO1_2 reads R1 K0 (driven from TX_ANY through R51); IO1_3, IO1_4 drive R2, R3 K0 (R52, R53 open, D-63) | pass |
| Every other coil gate is driven by exactly one PCA9539 pin | pass |
| K0: COM (11) radio, NC (12) RX row, NO (14) TX row: coil off = receive | pass |
| RF board TX_ANY: J14 pin 9, U903 IO1_5, R904 100k pull-down (F4, D-61) | pass |

### 1b. Review against hardware-design-rules v2.2 (D-120 to D-122, D-127, D-129)

| Check | Result |
|---|---|
| J14 crossing: each of the 9 signal pins goes through one 0R link (series R) to its logic net; a C footprint (DNP) to GND on the logic side forms the RC (D-122) | pass |
| U901 to U903 IO1_6, IO1_7 (spare): each held low by 10k to GND (RN901 to RN903, D-121) | pass |
| Test points on the five rails and on SCL, SDA, EXP_INT, RLY_EN, TX_ANY, A2_RFDET (D-120) | pass |
| +3V3 current link R4 0R between U1 VOUT and the +3V3 rail (D-120) | pass |
| Bulk 47 uF 25 V on +12V_RLY (C6) and +12V_AUX (C7) (D-129) | pass |
| +12V_SW: 1 uF 50 V X7R at each radio block (C101, C201, C301) (D-127) | pass |
| IC decoupling one value: 1 uF X7R at U901 to U903, U1001, U801 (D-127) | pass |
| Expanders U901 to U903, U1001 = PCA9539 (TSSOP-24, three makers, D-133) | pass |
| Supports S1 to S6 plated on CHASSIS (with H1), each with one bond option footprint C8 to C13 (DNP) to GND (D-132) | pass |
| Controller: common-mode choke L1 to L4 per Cat6 pair between the GDT and the 47R MELF (D-130) | pass |
| Controller: Y-capacitor footprints C21 to C28 (DNP) from each wire behind the choke to CHASSIS (D-130) | pass |
| Controller: watchdog link R64 0R between WDI (GPIO1, R61) and U12 WDI; open = WDI floats = watchdog off (D-123) | pass |
| Controller: +3V3 current link R65 0R after U11 (D-120) | pass |
| Controller: test points on +5V, +3V3, FAULT, RF_A2_N (D-120) | pass |
| Controller: IC decoupling one value, 1 uF X7R (D-127) | pass |

## 2. Safety gate U14: RLY_EN = NOR(KILL, MCU_EN_N, FAULT)

| KILL | MCU_EN_N | FAULT | RLY_EN | Meaning |
|---|---|---|---|---|
| 0 | 0 | 0 | 1 | relays allowed |
| 0 | 0 | 1 | 0 | fault latched |
| 0 | 1 | 0 | 0 | MCU does not ask |
| 0 | 1 | 1 | 0 | MCU does not ask, fault latched |
| 1 | 0 | 0 | 0 | KILL loop open |
| 1 | 0 | 1 | 0 | KILL loop open, fault latched |
| 1 | 1 | 0 | 0 | KILL loop open, MCU does not ask |
| 1 | 1 | 1 | 0 | KILL loop open, MCU does not ask, fault latched |

Property: RLY_EN = 1 only in the single row KILL = MCU_EN_N = FAULT = 0.

| Check | Result |
|---|---|
| Gate: 7 of 8 rows give RLY_EN = 0 | pass |

## 3. Input states that are not a clean 0 or 1 (open pins, missing parts)

| Case | Net state | Result at the gate | RLY_EN |
|---|---|---|---|
| MCU not fitted or in reset (GPIO high-Z) | MCU_EN_N Z, pulled to 1 by R63; LATCH_CLR Z, pulled to 0; WDI Z, pulled to 0 | MCU_EN_N = 1; WDI static low: watchdog trips, FAULT = 1 | 0 |
| Cat6 cut or shack off (no loop current) | U3 LED off, KILL pulled to 1 by R34 | KILL = 1 | 0 |
| Controller board unplugged from J14 | RLY_EN on the RF board Z, pulled to 0 by R3 | expanders in reset, +12V_SW off | 0 |
| +3V3 below 2.83 to 3.00 V | U12 RESET_N = 0 (from VDD 1.1 V) | FAULT set (PRE_N) | 0 |

| Check | Result |
|---|---|
| Every open or missing input gives RLY_EN = 0 | pass |

## 4. RF board enable chain and coil drivers

PCA9539 (NXP Rev 9.1): RESET low holds all registers at default: configuration 1 (all pins inputs, high-Z), output register 1, polarity 0. Coil gate = pin level if the pin is an output, else the 100k pull-down (0).

| RLY_EN | Expander | Config bit | Output bit | Gate | +12V_SW | Row / K1 coil |
|---|---|---|---|---|---|---|
| 0 | reset | 1 (forced) | 1 (forced) | 0 | off | off |
| 1 | running | 1 | 0 | 0 | on | off |
| 1 | running | 1 | 1 | 0 | on | off |
| 1 | running | 0 | 0 | 0 | on | off |
| 1 | running | 0 | 1 | 1 | on | ON |

| Check | Result |
|---|---|
| RLY_EN = 0: no row relay or K1 coil can be on (two independent paths: expander reset and +12V_SW off) | pass |

**Finding F1 (firmware).** After reset the output register is 1. If the firmware sets a pin to output (configuration 0) before it writes 0 to the output register, that coil switches on at once (row 'running, config 0, output 1'). Rule: write the output registers (2, 3) to 0x00 first, then the configuration registers (6, 7).

Bias-T feeds (sheet Bias-T supply, U1001 0x77): the same reset path. AkBIAS_EN drives the BSS138 gate directly, with a 100k pull-down; the BSS138 turns on the IRFL9014 high-side switch through 47k.

| Check | Result |
|---|---|
| A1..A4_BIAS_EN = U1001 IO0_0..3, BSS138BK gate, 100k pull-down | pass |
| U1001 IO1_0..7 (spare): each held low by 10k to GND in RN1001, RN1002 (D-121) | pass |

| RLY_EN | U1001 | EN pin | BSS138 gate | Bias feed |
|---|---|---|---|---|
| 0 | reset: inputs | Z | 0 (pull-down) | off |
| 1 | input (default) | Z | 0 | off |
| 1 | output 0 | 0 | 0 | off |
| 1 | output 1 | 1 | 1 | on (current limited, C-17) |

**Finding F8 (closed by D-121).** Spare expander pins (U1001 IO1_0..7, IO1_6 and IO1_7 of U901 to U903) are inputs after every reset. They are now held low by 10k arrays, so the firmware rule (set them as outputs driving 0) is no longer needed for a defined level.

## 5. K0 (TX/RX transfer relay) path

R1 K0 has its own path: loop 2 (FT-710 TX GND) - U2 opto - PTT_N - U5 inverter - TX_ANY - R51 0R - R1_K0_DRV - J14 - Q101 gate. R2 and R3 K0 are driven by U903 IO1_3 and IO1_4 after the TX handshake (D-63; R52, R53 not fitted). The K0 coils are on +12V_RLY, so RLY_EN does not switch them (D-27); RLY_EN low resets U903, so R2 and R3 K0 drop (F12). The table is for R1.

| PTT loop 2 | Controller on J14 | +3V3 on controller | RLY_EN | TX_ANY / K0 gate | K0 contacts | Radio sees |
|---|---|---|---|---|---|---|
| open | yes | ok | 1 | 0 | NC (RX) | RX row with row relays |
| open | yes | ok | 0 | 0 | NC (RX) | RX row, row relays off: open line |
| open | yes | off | 0 | 0 | NC (RX) | RX row, row relays off: open line |
| open | no | ok | Z to 0 | 0 | NC (RX) | RX row, row relays off: open line |
| closed | yes | ok | 1 | 1 | NO (TX) | TX row with row relays |
| closed | yes | ok | 0 | 1 | NO (TX) | TX row, row relays off: open line |
| closed | yes | off | 0 | 0 | NC (RX) | RX row, row relays off: open line |
| closed | no | ok | Z to 0 | 0 | NC (RX) | RX row, row relays off: open line |

**Finding F2 (design).** PTT with RLY_EN = 0 (KILL, fault, MCU not ready) still moves K0 to the TX row, but every row relay is open: the FT-710 then transmits into an open TX row. The radio sees a very high SWR. Gating the K0 drives with RLY_EN does not help: the radio would then transmit into the open RX row. Options for a later decision: (a) a TX inhibit line from the controller back to the radio (FT-710 input to check), or (b) accept and rely on the radio's own SWR protection.

**Finding F3 (firmware, revised for D-63).** U903 IO1_2 (R1 K0 read-back) and IO1_5 (TX_ANY read-back) share their nets with the U5 output: they must stay inputs. IO1_3 and IO1_4 drive R2 and R3 K0 (outputs), which is safe only while R52 and R53 are not fitted (checked above). Build rule: never fit R52 or R53 together with firmware that drives IO1_3 or IO1_4.

**Finding F4 (design, closed).** TX_ANY on the RF board had no pull resistor, so U903 IO1_5 floated with J14 open. R904 100k pull-down added (D-61); the topology check above confirms it.

## 6. Sequences: supervisor, watchdog, fault latch

Model: TPS3823A-33 (SLVS165O): RESET_N low while VDD is below VIT-, and for td after VDD rises above it; watchdog timer starts when RESET_N goes high, is cleared by a falling WDI edge, and a time-out gives RESET_N low for td. 74LVC1G74: PRE_N low sets Q (overrides CLK); a rising CLK edge loads D = 0 only while PRE_N is high. Each scenario runs with the minimum (td 120 ms, tout 0.9 s) and the maximum (td 300 ms, tout 2.5 s) datasheet timing. Time step 1 ms.

| Scenario | Timing | RLY_EN = 1 intervals (ms) | RESET_N pulses | Result |
|---|---|---|---|---|
| S1 power-up, firmware clears the latch at 600 ms | min | 650-9000 | 0 | as intended |
| S1 power-up, firmware clears the latch at 600 ms | max | 650-9000 | 0 | as intended |
| S2 main loop hangs at 3 s, WDI static (MCU_EN_N stays 0) | min | 650-3800 | 6 | as intended |
| S2 main loop hangs at 3 s, WDI static (MCU_EN_N stays 0) | max | 650-5400 | 2 | as intended |
| S3 as S2, but LATCH_CLR keeps toggling every 100 ms (rule 2 broken) | min | 650-3800, 4000-4820, 5000-5840, 6000-6860, 7000-7880, 8000-8900 | 6 | relays cycle: shows why rule 2 exists |
| S3 as S2, but LATCH_CLR keeps toggling every 100 ms (rule 2 broken) | max | 650-5400, 5700-8200, 8500-9000 | 2 | relays cycle: shows why rule 2 exists |
| S4 LATCH_CLR edge during the power-up reset only (at 50 ms) | min | none | 0 | as intended |
| S4 LATCH_CLR edge during the power-up reset only (at 50 ms) | max | none | 0 | as intended |
| S5 brown-out 3 s to 3.05 s, firmware clears again at 3.6 s | min | 650-3000, 3600-9000 | 1 | as intended |
| S5 brown-out 3 s to 3.05 s, firmware clears again at 3.6 s | max | 650-3000, 3600-9000 | 1 | as intended |
| S6 KILL loop open from 4 s to 5 s | min | 650-4000, 5000-9000 | 0 | as intended |
| S6 KILL loop open from 4 s to 5 s | max | 650-4000, 5000-9000 | 0 | as intended |
| S7 WDI kicked from a timer interrupt while the main loop hangs at 3 s (rule 1 broken) | min | 650-9000 | 0 | relays stay on: shows why rule 1 exists |
| S7 WDI kicked from a timer interrupt while the main loop hangs at 3 s (rule 1 broken) | max | 650-9000 | 0 | relays stay on: shows why rule 1 exists |

| Check | Result |
|---|---|
| S1, S2, S4, S5, S6 behave as designed at minimum and maximum timing | pass |
| S3 and S7 reproduce the two known weaknesses (the firmware rules close them) | pass |

Readings: S1 the relays wait for the explicit clear after power-up. S2 a hung main loop drops RLY_EN at the time-out (0.9 to 2.5 s after the last WDI edge) and it stays low, because every reset sets FAULT again. S4 a clear edge during reset does nothing. S5 a brown-out needs a new clear. S6 KILL acts at once and is not latched: RLY_EN returns when the loop closes. S3 and S7: a crashed MCU that keeps toggling LATCH_CLR, or that kicks WDI from an interrupt, defeats the gate.

**Finding F5 (firmware, reworded after D-62).** KILL is not latched in the box (S6); the SAFE latch is in the shack (D-75). RLY_EN = 0 holds the expanders in reset, so when KILL returns to 0 the relays come back off, and the expander registers are at their defaults. Rule: after KILL returns to 0, set up the expanders again (F1 order) before any switching. Do not set MCU_EN_N = 1 on KILL = 1: under D-62 that opens READY and keeps the SAFE loop open (F11, verify_system.py).

## 7. Crossbar: relay states on one antenna column

Per column c: six row relays (R1 TXc, R1 RXc, R2 TXc, R2 RXc, R3 TXc, R3 RXc) and K1c (on = column to the antenna, off = antenna parked on the bleed). Hazards, for all TX rows (conservative: every TX row can carry RF when its K0 is in TX): H1 two TX rows on one column; H2 a TX row and a row of another radio on one column (TX power into that radio); H3 a TX row on an RX-only column (A2, bias-T and preamp); H4 a TX row on a column with K1 off (open line).

| Column | Allowed states (of 128) | States with H1 | H2 | H3 | H4 |
|---|---|---|---|---|---|
| A1 | 22 | 64 | 100 | 0 | 56 |
| A2 (RX only, TX relays not fitted) | 16 | 64 | 100 | 112 | 56 |
| A3 | 22 | 64 | 100 | 0 | 56 |
| A4 | 22 | 64 | 100 | 0 | 56 |

Allowed states in words: a column either carries one radio with its TX row and/or RX row (TX only with K1 on), or it carries RX rows of several radios (shared receive antenna), with K1 on or off. On A2 no TX row at all: since D-103 the A2 TX relays are not fitted, so the H3 states cannot occur in hardware (SR-01).

Per radio, across the columns: at most one TX row relay and at most one RX row relay closed (two TX rows would put the transmitter on two antennas; two RX rows parallel two antennas). The EXP relays (TXE, RXE) count as a column of their own, used by that radio only.

**Finding F6 (firmware).** No hardware interlock covers H1, H2 and H4; H3 is excluded in hardware on A2 (D-103). The firmware must check every requested state against these rules before any relay moves, and keep a column table (TX or RX only) that matches the fitted relays. `is_state_allowed()` below is the reference implementation.

## 8. Switching sequence and timing (derived firmware rules)

RT1 (RT1pb rev 4): operate 8 ms max, release 6 ms max, bounce 4 ms (form A) / 6 ms (form B) max.

| Step | Action | Wait | Reason |
|---|---|---|---|
| 1 | Check TX_ANY = 0 (U903 IO1_5) and the new state with is_state_allowed() | - | no relay moves under RF (hot switching); H1 to H4 |
| 2 | Open the row relays that change | 6 + 6 = 12 ms | release plus NC bounce: break before make |
| 3 | Set K1 of every column that the new state uses | 8 + 4 = 12 ms | column terminated before a TX row closes (H4) |
| 4 | Close the new row relays | 8 + 4 = 12 ms | operate plus bounce before RF is allowed |
| 5 | Read back the output registers and TX_ANY | - | the state is what the firmware wrote |
| 6 | Open K1 of columns no longer used (parks the antenna on the bleed) | 12 ms |  |

**Finding F7 (station).** K0 follows PTT in hardware and needs 8 ms operate plus 4 ms bounce. The FT-710 must not send RF within 12 ms after PTT closes. Rule: set the radio TX delay to at least 15 ms (FT-710 menu item to check). A PTT during steps 2 to 4 is possible; the firmware cannot stop it (see F2).

## 9. Timing: response chains, worst case

Values are datasheet maxima over temperature unless marked. Gate delays are in ns, the relays in ms: the relay times dominate every chain. Estimates are first-order and marked; they need a measurement (M- line).

| Chain | Worst case | Made of |
|---|---|---|
| KILL loop opens to RLY_EN low | 105 ns | opto + NOR |
| RLY_EN low to coil MOSFETs off (expander reset path) | 11.2 us | PCA9539 trst + gate discharge through 100k |
| RLY_EN low to +12V_SW off (supply path) | 18.6 us | Q1 gate charge through R1 (estimate) |
| KILL to row relay contacts open | 6.0 ms | plus coil current decay in the 24 V clamp (coil L not in the datasheet: to measure) |
| Brown-out (3V3 below VIT-) to RLY_EN low | 25.0 us | supervisor + latch + NOR |
| Watchdog: last WDI edge to RLY_EN low | 2.5 s | tout max 2.5 s (min 0.9 s) |
| PTT closes to K0 on the TX row, bounce ended | 12.0 ms | radio must not send RF before this |
| PTT opens to K0 contact leaves the TX row | 6.0 ms | maximum; RT1 gives no minimum release time |
| Firmware relay change (section 8), one step | 12.0 ms | then the next step; three steps: 36 ms |

**Order on a KILL.** The coil MOSFETs turn off after about 11.2 us, +12V_SW after about 18.6 us (estimate). The low side opens first, by about 7.4 us, so the coil current goes into the 24 V clamp (fast release, TE 13C3264). If +12V_SW opened first, the current would circulate for a moment through the freewheel diode on +12V_SW (slow decay). The margin rests on two first-order estimates: measure it (scope on a gate, +12V_SW and one coil during a KILL).

| Check | Result |
|---|---|
| Estimated order on KILL: coil MOSFETs off before +12V_SW (to confirm by measurement) | pass |
| K0 settled (12 ms) within the proposed radio TX delay of 15 ms | pass |
| WDI kick interval 0.25 s below the minimum watchdog time-out 0.9 s (margin 3.6) | pass |

**Finding F9 (station).** On PTT release the radio stops RF and K0 releases within 6 ms, but RT1 gives no minimum release time. If the radio's RF tail (ALC decay) is longer than the fastest K0 release, K0 breaks under RF. Check: measure the FT-710 RF tail after PTT release and the K0 release time on the first board (M- line).

**Finding F10 (firmware).** One PCA9539 port write changes up to 8 coils at once. Rule: never open and close relays on the same bus in one register write; open in one write, wait 12 ms, then close in a second write (section 8).

## 10. Firmware rules from this verification

1. Kick WDI (falling edge) only from the main loop after its checks; interval 0.25 s or less (C-19). Never from a timer interrupt (S7).
2. Give a LATCH_CLR edge only once after the start-up self-test, and after a fault only when the cause is checked (S3).
3. Start-up (after D-62, F11): RESET_N high, MCU_EN_N = 1, LATCH_CLR edge, then MCU_EN_N = 0, then wait for KILL = 0 (SAFE loop closed) with a time-out, then write PCA9539 output registers 0x00, then configuration registers (F1), then check TX_ANY = 0.
4. Keep U903 IO1_2 to IO1_5 as inputs (F3).
5. On KILL = 1: the relays are off in hardware; after KILL = 0 and TX_ANY = 0, set up the expanders again (F1) and use a fresh switching sequence (F5, F11).
6. Check every requested relay state with is_state_allowed() (H1 to H4, one TX and one RX row per radio) (F6).
7. Switch only with TX_ANY = 0, in the sequence of section 8, with the 12 ms waits (RT1 timing).
8. Bias-T feed only on RX-only ports (A2), and only when no TX row is on that column (A-10). Fault = EN 1 and OK 0: switch the feed off and report (D-54).
9. Set every spare expander pin as an output driving 0 (F8).
10. Open and close relays in separate register writes, 12 ms apart (F10).
11. Station: radio TX delay at least 15 ms (F7); RF tail after PTT release shorter than the K0 release time, to measure (F9).

## 11. Reference implementation of the state check

```python
def is_state_allowed(tx, rx, k1, rx_only=frozenset({2})):
    """tx[r], rx[r]: column (1..4, 'E') or None per radio r; k1: set of columns with K1 on. True if no hazard H1 to H4."""
    for c in (1, 2, 3, 4):
        tx_r = [r for r in tx if tx[r] == c]
        any_r = {r for r in tx if tx[r] == c} | {r for r in rx if rx[r] == c}
        if len(tx_r) > 1: return False                             # H1
        if tx_r and any_r - {tx_r[0]}: return False                # H2
        if tx_r and c in rx_only: return False                     # H3
        if tx_r and c not in k1: return False                      # H4
    return True
```

## Result

All checks pass. Findings F1 to F10: firmware rules, station settings, and F2, now handled by the FT-710 TX INH and the SAFE loop (D-62, A-15). F4 is closed (R904). F11 to F13: verify_system.py.
