PE1RGU/hf-antenna-switch/design-log.md

# Design log: Shack Relay Matrix (source for the design document)

Purpose: one record of every design choice with its reason, the rejected options, assumptions, calculations, standards and measurements. The detailed design document is drafted from this log. Newest entries at the end of each section. Rev C summary: docs/architecture.md; requirements: docs/requirements.md. Archived records: archive/ (list in archive/README.md).

Status keys: decided / assumed / to confirm / open / superseded.

## 1. Requirements and design basis

| ID | Item | Value | Source | Status |
|---|---|---|---|---|
| R-01 | Transmit power | 100 W HF, SWR up to 3:1 | Prins | decided |
| R-02 | Frequency range | 1.8 to 54 MHz (HF + 6 m) | Prins / station | decided |
| R-03 | Location | RVS box, north side of the shed, no direct sun; outer 500 × 600 × 200 mm, inner about 460 × 560 × 180 mm; cables enter at the bottom | Prins | decided |
| R-04 | Design ambient | 45 °C maximum | Prins | decided |
| R-05 | Radios | 3 (only 3 HF coaxes to the shack; more radios switched in the shack) | Prins, 2026-09-27 | decided |
| R-06 | Antennas unit 1 | A1 G5RV, A2 RX loop (RX only), A3 and A4 spare | Prins, 2026-09-27 | decided |
| R-07 | Assembly | By hand; avoid 0402; thermal relief by default | hardware skill | decided |
| R-08 | Fab | JLCPCB | hardware skill | decided |
| R-09 | Symbols | IEC 60617 | hardware skill | decided |
| R-10 | Parts | Jellybean parts, at least two drop-in sources, easy to get (JLCPCB, Mouser, DigiKey, Farnell), from manufacturers with full datasheets | Prins, 2026-09-27; hardware skill sections 5 and 13 | decided |
| R-11 | +12V_AUX load | 0.5 A maximum (bias-T preamp draws about 35 mA, LNA evaluation; 0.5 A spec for margin, Prins 2026-09-27) | Prins | decided |
| R-12 | ESD level, shack interface radio ports (mini-DIN, handled by the operator) | EN 61000-4-2 level 3: 6 kV contact, 8 kV air; protected at the connector, current path to the shield (CHASSIS) | Claude proposal, ESD requested by Prins 2026-10-03; hardware skill section 16 | proposed |
| R-13 | DevKit position, shack interface | DevKit A1 at the PCB edge, USB-C receptacle at the housing wall so the plug can be used from outside | Prins, 2026-10-04 | superseded by D-96: the DevKit USB-C is flush with its PCB, so the shack board gets its own USB-C J14 at the wall; DevKit position free |
| R-14 | DevKit position, box controller board | The DevKit USB-C must stay reachable for flashing when the box is opened: do not place the DevKit with its USB-C end against a wall or another part. No USB connector at the box wall | Prins, 2026-10-04 | decided. Layout rules (2026-10-05): (1) DevKit USB end (pads 16/17 end of the socket footprint) points into free space, not toward a case wall closer than 40 mm; (2) corridor 40 mm long and 14 mm wide in front of the DevKit USB edge: no part higher than 10 mm above the controller board in it (plug centre about 14.3 mm, plug overmold up to 12.35 x 6.5 mm); (3) height under the lid per C-27 and D-98. Check at the controller board layout |
| R-15 | Underload factors (derating) | Factor = value in operation / rating of the part; value in operation = worst case in the application; every factor is a maximum. Power loss 0.6; temperature including self-heating 0.8 (in °C: a +125 °C limit allows 100 °C); voltage 0.7 (12 V in operation needs a rating of at least 17.14 V); current 0.7; nominal value against the maximum of the structural shape (for example capacitance) 0.7. Rules: a ratio close to the factor is accepted, no extra margin on top of the factor. Parts with a nominal operating point (relay coil, TVS stand-off voltage) are checked against the maker's permitted range and recorded as a documented exception. RF parts at the worst-case SWR (C-01: 173 V peak, 2.45 A rms). Connector contacts from the maker's derating curve at the design ambient (R-04). Every exception gets a written reason in this log. Documented exceptions so far: RT1 coil (C-13), input TVS (D-45), USB ESD array (C-26), MD-80SM contact rating (D-87); conditional: PCA9539 with a 5 V push-pull band output (D-88) | Prins; hardware skill section 4 | decided |
| R-16 | Critical parts | Select parts with regard to the critical-parts documents of all commissioners | hardware skill section 3 | not applicable: private project, no commissioner |
| R-17 | Surge level of the Cat6 LINK entry (box controller board; mirrored at the shack interface) | EN 61000-4-5, 10/700 us combination wave (5/320 us current), 4 kV line to earth (level 4, outdoor symmetrical lines), Isc 100 A. Pass criterion: no damage, no relay operation during the test | Prins, 2026-10-22 (option 1: box outdoors at the antenna, buried Cat6) | decided |

## 2. Decisions

| ID | Date | Decision | Reason | Rejected options (why) | Status |
|---|---|---|---|---|---|
| D-01 | 2026-09-27 | Rev C: one flat RF board per unit in a milled aluminium case, controller board stacked | DIN 41612 backplane forced RF through connector pins (pad gap below spacing rule, coating needed), subrack too deep for the box, card guides and mechanics complex | Rev A/B card cage and backplane (complexity; archived) | decided |
| D-02 | 2026-09-27 | Case: custom milled aluminium (6082-T6) | Free board size, SO-239 in the bottom wall, cable force into the case | Standard extrusion (max about 200 mm width, would split the board) | decided |
| D-03 | 2026-09-27 | Unit 3 radios × 4 antennas | Matches 3 coaxes; 37 relays instead of 66 | 4 × 6 (larger, unused capacity) | decided |
| D-04 | 2026-09-27 | Expansion over SMA on the radio side, one EXP relay per TX and RX row (series disconnect) | Adds antennas without an open stub in unit 1 | Antenna-side expansion (6+ cables, fewer stations grow that way); 6 × 8 (both directions, 30 more relays, interlocks) | decided |
| D-05 | 2026-09-27 | Unit 2 without controller, run over EXP CTRL (PCA9615 differential I2C, /RLY_EN and TX_ANY as wires) | One controller, one watchdog, one safety chain; interlocks stay hardware | RS-485 multidrop with own controller (two watchdogs, loops through both units) | decided |
| D-06 | 2026-09-27 | One relay type: TE RT1 RTD14012F everywhere (37) | One part and footprint; open contacts see 173 V peak; RX relay sits on the TX line when TX and RX share an antenna | Signal relay in RX rows (voltage rating unchecked, second part) | decided |
| D-07 | 2026-09-27 | No GDT fitted on the board; DNP footprint (600 V class) | Entry arrestor (CS-400R) takes the surge; a second GDT behind a short jumper shares almost nothing; rev A 90 V value was below 173 V peak | Fitted GDT (little benefit, surge current through board and case) | decided; footprint removed by D-114 (2026-10-19) |
| D-08 | 2026-09-27 | Static bleed 1 MΩ + RF choke on K1 NC side stays | CS-400R insulates ≥ 10 GΩ below 400 V: no static drain | Rely on arrestor (does not drain) | superseded by D-32 (bleed stays, choke removed) |
| D-09 | 2026-09-27 | Spark arrestor Comet CS-400R | CS-400P out of stock; same function | – | decided |
| D-10 | 2026-09-27 | SO-239 Amphenol RF 83-798 (PTFE) | PTFE insulator, silver contact, drawing available; fits a 6 mm wall without pocket | 83-1R (PBT insulator: solder heat, halogen unknown); Qaxial UHF14-00-01 (no data checked); generic (no datasheet) | decided; first source changed to 83-1R by D-196 (supply) |
| D-11 | 2026-09-27 | Stackup JLC0216A, 2-layer 1.6 mm, 1 oz | Crossbar: rows top, columns bottom, THT relay pins change layer; wide 50 Ω line for current | 6-layer 7628A (needed only for the backplane pin fields) | superseded by D-115 |
| D-12 | 2026-09-27 | RF gap 2.0 mm, no conformal coating | EN IEC 60664-1 creepage for PD3 (about 1.9 mm) plus margin for IEC 60664-4; no coating process after hand assembly | 1.25 mm + coating (IEC 60664-3; process and repair burden) | decided |
| D-13 | 2026-09-27 | RF line W 2.7 mm, gap 2.0 mm on L1 and L2 | JLC calculator 2.6838 mm for 50 Ω (C-03) | – | superseded by D-116 |
| D-14 | 2026-09-27 | EXP CTRL second RJ45 on unit 1 top wall; power and RJ45 on top wall, SMA on left wall, SO-239 on bottom wall | Logic zone at the top, RF columns straight down to their SO-239 | Power and RJ45 on the left wall (sketch v1) | decided |
| D-15 | 2026-09-27 | Board bottom edge 5 mm from the inner bottom wall | 83-798 cup reaches about 3.6 mm into the case; strap under 6 mm | 10 mm offset (strap too long) | decided |
| D-16 | 2026-09-26 | I/O expanders PCA9539 (RESET from safety chain) and PCA9554A (pull-ups, active-low drive) | Safe state at power-on; second path to safe state | PCA9555/9554 (pull-ups with active-high drivers pull relays in) | decided (rev B, taken over) |
| D-17 | 2026-09-26 | XT60PW-M ×2, XT30PW-M power entry | Rail separation; XT30 cannot mate with XT60 | – | decided (rev B, taken over) |
| D-18 | 2026-09-26 | Mounting holes not grounded; one CHASSIS bond with open jumper and DNP 10 nF 1 kV | Avoid ground loops | All holes grounded | decided (rev B, taken over) |
| D-19 | 2026-09-26 | Markings: HV triangle, DC YYWW, no UL mark, no JLC order number | EU marking review; JLC offers no UL mark; order-number marking discontinued May 2026 | – | decided |
| D-20 | 2026-09-27 | Placement for the 9 mm RF band: radio block 48 mm (bands 24 + 24), board 260 × 230 mm, case about 280 × 250 × 60 mm | RF band grew from 8 to 9 mm (D-12, D-13) | Keep 250 × 216 mm (bands overlap relay rows) | superseded by D-23 |
| D-21 | 2026-09-27 | Radio SO-239 pitch 30 mm (x 12, 42, 72) | Flange gap 4.6 mm; frees room for the feeds | 32 mm pitch (R3 feed next to R1 feed at 2 mm) | decided; R1 and R2 positions superseded by D-203 |
| D-22 | 2026-09-27 | Column fence vias under the RT1 body edge at 36 mm column pitch | Keep the board narrow | – | superseded by D-23 |
| D-23 | 2026-09-27 | Column pitch 38 mm, column line 6 mm from the relay body; antenna SO-239 at x 139, 177, 215, 253; board 268 × 230 mm; case about 288 × 250 × 60 mm | Prins accepted a wider case: the 9 mm band clears the relay bodies, no fence vias under the relays | 36 mm pitch with vias under the relay edge (D-22) | decided |
| D-24 | 2026-09-27 | R3 feed runs straight up from its SO-239 at x 72; R1 and R2 feeds at x 81 and 90, jogs on top copper | No parallel run between feeds of different radios | Feeds side by side at x 78, 87, 96 (R3 ran 8 mm next to R1 at 3.3 mm gap, A-08) | decided |
| D-25 | 2026-09-27 | Schematic rev C: KiCad project hardware/unit/rf-board/, generated by gen_rfboard_sch.py; hierarchical sheets power (1), radio_port (3 instances), antenna_port (4 instances); references per block: R1 1xx, R2 2xx, R3 3xx, A1 4xx to A4 7xx | One sheet per function, identical ports stay identical; generator keeps the 37 relays consistent | Flat schematic (hard to keep 3 and 4 copies equal) | decided |
| D-26 | 2026-09-27 | Crosspoint wiring: row relay COM on the row bus, NO on the column (or EXP), NC open. K0 COM radio, NO TX row, NC RX row (off = RX, fail-safe) | NC to a row or GND would short the row when the relay is off | – | decided |
| D-27 | 2026-09-27 | Coil supplies: K0 on +12V_RLY (follows PTT, not cut by /RLY_EN, rev A); row relays and K1 on +12V_SW (+12V_RLY switched by /RLY_EN) | Safety chain drops all matrix and antenna relays; K0 stays under PTT control | – | decided (taken over from rev A) |
| D-28 | 2026-09-27 | Bias-T feed on the matrix side of K1 (PORT node, between DC block and K1 NO), not on the antenna side as in rev A | On the antenna side, a parked K1 (COM to NC) shorts the bias supply through the bleed choke L1. On the matrix side the feed is open when parked; no gating logic needed | Antenna side with bias gated by K1 in hardware and a current-limited switch | decided (Prins, 2026-09-27) |
| D-29 | 2026-09-27 | RT1 symbol: project library rf-board.kicad_sym, RTD14012F, flattened from KiCad Relay:RT314A03 (same drawing: plain coil, IEC form). Footprint Relay_THT:Relay_SPDT_Schrack-RT1-16A-FormC_RM5mm (double pins on 11, 12, 14) | KiCad RT314A12 only extends RT314A03, whose library text says bistable 3 V; text and datasheet link corrected in the project copy | Use the KiCad symbol as is (wrong description, wrong datasheet link) | decided |
| D-30 | 2026-09-27 | Schematic drawn with wires (generator v2): signal flow left to right (radio → K0 → rows; column → K1 → antenna), supplies up and GND down as power symbols, labels only where a net leaves a sheet, junction dots at every T, root sheet draws the four antenna columns as wires between the radio and antenna port sheets | v1 used labels on every pin: correct netlist, but the circuit could not be read. Rules from IEC 61082-1 practice and common guides (Gala, Altium, Cadence) | Labels at every pin (v1) | decided (Prins, 2026-09-27) |
| D-31 | 2026-09-27 | K0 drawn mirrored (NO on the left to the TX row, NC on the right to the RX row, coil on the right) | Removes the NC/NO wire crossing at K0 (Prins). Drawing only: pins and netlist unchanged | K0 unmirrored with one crossing | decided (Prins) |
| D-32 | 2026-09-27 | Static bleed: 1 MΩ only from K1 NC to GND, high-voltage resistor (about 950 V impulse before the CS-400R fires; e.g. Vishay VR25, to confirm). RF choke removed | 1 MΩ drains static (about 1 ms with about 1 nF antenna plus coax). A choke adds only a low-DC path, and that path would take induced surge current through K1, the board and the case, against D-07 (arrestor is the first surge path) | 1 MΩ ∥ RF choke (rev A, A-09); NC hard to GND (surge through the board) | decided (Prins); part Vishay VR25000001004FA500 (M-122) |
| D-33 | 2026-09-27 | All connectors on the root sheet: radio SO-239 J1 to J3, EXP SMA J4 to J6 (left), antenna SO-239 J7 to J10 (right), XT power J11 to J13. Port sheets carry RADIO, EXP and ANTENNA as hierarchical pins | The root sheet shows at a glance what goes in and what goes out (Prins) | Connectors inside the port sheets (v2) | decided (Prins) |
| D-34 | 2026-09-27 | Coil driver: one logic-level N-MOSFET (SOT-23, 2N7002 class) per coil, gate pull-down (off while the expander is in reset or not configured), clamp diode per coil | Coil budget C-13: about 1 V margin; 2N7002 class is jellybean and multi-source (R-10) | Darlington array ULN2803A (0.9 to 1.1 V drop, fails C-13; fewer parts); single-source DMOS arrays (TPL7407LA, TI only) | decided (Prins, 2026-09-27) |
| D-35 | 2026-09-27 | Coil clamp: diode per coil to a shared clamp line, one zener per supply group from the clamp line to the coil supply (+12V_SW group, +12V_RLY group for K0); freewheel diode on the +12V_SW output for a KILL while coils are on | TE 13C3264: plain diode slows release, diode + zener releases faster; shared zener keeps the part count low; drain peak = 12.6 + Vz + Vf must stay below 0.7 x VDS(max) | Plain diode per coil (slower release, longer break-before-make wait); diode + zener per coil (37 extra zeners) | decided (Prins, 2026-09-27); zener value with the MOSFET part. Closed by D-37 (review S-17, 2026-11-02) |
| D-36 | 2026-09-27 | Clamp diodes: standard switching diode per coil (1N4148W / BAS16 class, SOD-123 or SOT-23); Schottky 1 A (SS14 class) only as the freewheel diode on the +12V_SW output | Per coil: current 33 mA, release in ms, so a Schottky gives no gain; its reverse leakage rises strongly when hot, and each diode of an ON channel sees about 12 V reverse. Freewheel on +12V_SW: up to about 0.43 A (13 coils) when the switch opens, low Vf helps | Schottky per coil (no gain, more leakage hot) | decided (Prins, 2026-09-27) |
| D-37 | 2026-09-27 | Logic at 3.3 V (expanders and the I2C bus); coil MOSFET with RDS(on) specified at VGS 2.5 V and VGS(th) max about 1.6 V, 60 V (Nexperia BSS138BK class, to confirm second sources); clamp zener about 24 V (drain peak 12.6 + 24 + 0.9 = 37.5 V against 0.7 x 60 = 42 V) | A 3.3 V I2C master cannot drive a PCA9539 at 5 V (VIH = 0.7 x VDD = 3.5 V, NXP DS Rev 9.1). 2N7002 (Nexperia Rev 7): VGS(th) max 2.5 V, RDS(on) only specified at 4.5 V and 10 V: not usable at 3.3 V gate drive. BSS138BK (Nexperia Rev 1): VGS(th) max 1.6 V, RDS(on) max 6.5 ohm at 2.5 V, 10 mA: about 0.2 V drop at 33 mA, C-13 margin about 0.8 V | Logic at 5 V with a level shifter and 2N7002 | decided (Prins, 2026-09-27). Closed by D-134 (review S-17, 2026-11-02) |
| D-38 | 2026-09-27 | +12V_SW relay supply switch: P-MOSFET high-side switch, driven by a small N-MOSFET (onsemi AND9093 P-channel circuit); gate-source resistor holds it off; gate divider R_GS 10 k / R_series 2.2 k gives VGS about 10.3 V at 12.6 V and 9.3 V at 11.4 V; Schottky freewheel on the output (D-36); footprint for a drain-gate C (soft start) not fitted | Load at most 10 coils (2 row relays per radio + 4 K1) = about 0.33 A; simple, jellybean, multi-source | Integrated high-side switch (PROFET, TPS1H): protection not needed for this load, usually single source (R-10) | decided (Prins, 2026-09-27) |
| D-39 | 2026-09-27 | Enable line active-high: RLY_EN with a pull-down on each board. No signal (broken wire, dead controller, unplugged EXP CTRL cable, reset) = relays off. Replaces the active-low /RLY_EN of rev A/B | The safe state needs no active signal | Active-low /RLY_EN (a lost line could enable the relays, depending on the pull) | decided (Prins, 2026-09-27) |
| D-40 | 2026-09-27 | P-MOSFET part: Nexperia PMV50EPEA (-30 V, VGS +-20 V, RDS(on) max 45 mohm at -10 V, SOT-23 G-S-D, DS v.1 2016-06-30); second source AOS AO3407A (-30 V, +-20 V, max 48 mohm at -10 V, Rev 5.1 2023-07) | Drop about 15 mV at 0.33 A; VGS 10.3 V against 0.7 x 20 = 14 V; VDS 12.6 V against 0.7 x 30 = 21 V | 20 V P-MOSFETs (VGS +-8 or +-12 V: divider mandatory, less margin) | decided (Prins, 2026-09-27). PMV50EPEA DS filed (VGS(th) -1 to -3 V, ESD > 2 kV, AEC-Q101). AO3407A pin-out G-S-D checked. Halogen status of both to check. Halogen point closed by D-150 (review S-17, 2026-11-02) |
| D-41 | 2026-09-27 | 3.3 V logic LDO: TI LP2985-33 (SOT-23-5: 1 IN, 2 GND, 3 ON/OFF, 4 BYPASS, 5 OUT; SLVS522S May 2025); second source ST LD2985BM33R (same pins, Rev 16 2021-08-30). ON/OFF tied to IN, 10 nF bypass, COUT X7R with at least 2.2 uF effective at 3.3 V bias and temperature (4.7 uF 16 V 0805 proposed, DC-bias curve to confirm), 1 uF at IN | VIN 2.5 to 16 V: 5.25 / 16 = 0.33 against 0.7; -40 to 125 °C; ceramic-stable. TI ships a legacy die (COUT >= 2.2 uF over temperature, ESR window) and a new die (M3 suffix, COUT >= 1 uF effective, ESR < 1 ohm) under one part number, so the design meets the legacy limit | TLV755P and AP2112K (5.5 V class: 5.25 / 5.5 = 0.95); 1117 family (standard grades from 0 °C, LM1117 needs tantalum COUT); MIC5205 (needs ESR up to about 5 ohm, ultra-low-ESR ceramic can oscillate, so not a drop-in on a ceramic COUT) | decided (Prins, option 1). LD2985 datasheet filed (DocID8189 Rev 16): abs max 16 V, INHIBIT has no internal pull-up (tied to IN), CIN 1 uF required |
| D-42 | 2026-09-27 | Halogen policy (hardware-design-rules section 2) is not applied to this design. Halogen status is not checked or recorded for its parts; open halogen checks in this log and in the datasheet register are closed as not applicable | Private, non-commercial design (Prins) | Check every part | superseded by D-107 (Prins, 2026-10-10) |
| D-43 | 2026-09-27 | Schematic v4 (generator v4-coil-drivers-power): coil driver drawn next to each relay (Qn, Dn, Rn belong to Kn); gate pull-down 100k 0603; clamp diode 1N4148W SOD-123; clamp zeners BZT52C24 SOD-123, two in parallel per clamp net (D2 // D4 CLAMP_SW, D3 // D5 CLAMP_RLY; Prins 2026-09-27: one open zener must not remove the clamp of 34 coils); freewheel SS14 SMA; Q2 gate driver = BSS138BK (same part as the coil drivers); CLAMP_SW and CLAMP_RLY drawn as power symbols, like the supply nets; LDO caps 1u 16V X7R 0603, 10n 0603, 4.7u 16V X7R 0805 | Keeps each coil channel readable in one place; one MOSFET type on the board (fewer BOM lines, R-10); a shared clamp net drawn as a rail avoids a wire that would cross every row bus | Separate coil-driver sheet (37 channels, every coil via a label); a clamp wire across the rows (crossings at every relay) | decided (Prins, 2026-11-01, review Decide item): zener pulse checked (M-120), Nexperia BZT52H-C24,115 first source, Diotec BZT52C24 second; 100k checked in verify_logic (gate off about 11 us) |
| D-44 | 2026-09-27 | No gate-source zener on the coil MOSFETs; gate pull-down only | Gate driven on the board by the 3.3 V expander (push-pull) against VGS max +-20 V; BSS138BK has ESD protection on the gate; Miller coupling from the 37.5 V drain edge gives a short spike of about 1 V into the low-impedance expander output (estimate: Cgd about 2 pF, drain edge set by 33 mA into Coss); a zener adds leakage and capacitance for no gain here | Zener + resistor on each gate (application-note practice where the gate drive exceeds VGS max, leaves the board, or floats) | decided (Prins, 2026-09-27). Q1 gate-source zener: decide with the input protection (VGS follows the +12V_RLY input). Q1 zener point closed by D-45 (review S-17, 2026-11-02) |
| D-45 | 2026-09-27 | Power input protection per XT input: time-lag 1206 fuse at the connector, then a unidirectional TVS to GND (clamps transients; forward-biased on reverse polarity so the fuse opens). Fuse Littelfuse 0468001.NR 1 A 63 V (468 series, Rev GD 2022-11: -55 to 90 °C, 50 A breaking at 63 VDC, cold R 0.079 ohm), second source Bourns SF-1206S100-2 (Rev J 2021-04: -20 to 105 °C, cold R 0.132 ohm); 1 A on all three rails (one BOM line). TVS: SMBJ15A on +12V_RLY and +12V_AUX (VR 15 V, VBR min 16.7 V, VC 24.4 V at 24.6 A), SMBJ6.0A on +5V (VR 6.0 V, VBR min 6.67 V, VC 10.3 V); Littelfuse SMBJ Rev JC 2025-07, multi-source. Q1 gate-source zener BZT52C15 added (TVS clamp would give VGS about 20 V) | Zero series drop keeps the C-13 coil budget (fuse drop about 34 mV at 0.43 A); keyed XT connectors make reverse polarity rare; jellybean and multi-source. Current ratio: 0.43 A / 1 A (RLY), 0.5 A / 1 A (AUX), about 0.2 A / 1 A (+5V), before temperature re-rating (curve to read). TVS voltage: VR is the design point, not a 0.7 rating; documented exception, margin taken on VBR min (12.6 / 16.7 = 0.75; 5.25 / 6.67 = 0.79). SMBJ5.0A rejected: VR 5.0 V below the 5.25 V rail maximum (leakage up to 800 uA and more) | Ideal-diode P-MOSFET reverse protection (more parts, for a rare event); series Schottky or PTC (drop eats the C-13 margin) | decided (Prins, option 1). Parts proposed: fuse re-rating at 55 °C to confirm (current ratio 0.5 or less); PSU short-circuit current closed by D-199. Bourns second source rated only from -20 °C (same as the XT connectors). Littelfuse files: site refuses scripted downloads |
| D-46 | 2026-09-27 | PCA9615 VDD(B) (line side) from +3V3, not +5V; same at both ends of the EXP CTRL link | PCA9615 Rev 2 limiting value 6 V: 5.25 / 6 = 0.875 fails 0.7; 3.35 / 6 = 0.56 passes; 3.25 V min stays inside the 3.0 to 5.5 V range | VDD(B) on +5V with a documented exception | decided (Prins, 2026-09-27). Differential swing at 3.3 V into the termination to confirm (datasheet gives the minimum only at 5 V). Closed by D-53 (review S-17, 2026-11-02) |
| D-47 | 2026-09-27 | RF detector per antenna port: capacitive tap on the column side, C4 4.7 pF 1 kV C0G 1206 series and C5 47 pF 50 V C0G to GND (about 1:12), R3 10k DC return; BAS70 peak detector (onsemi BAS70LT1/D Rev 12: 70 V, VF max 0.41 V at 1 mA, 2 pF, SOT-23 1 A / 3 K; single diode only); hold 10 nF with 100k load (1 ms); comparators LM2901 quad for the four ports (TI SLCS006Z 2025-05: -40 to 125 °C, 2 to 30 V supply, inputs -0.3 to 36 V, open collector), supply +5V, VREF 0.3 V from +3V3 (10k/1k, 100 nF), 10k series + 1M feedback per channel (about 33 mV hysteresis), 10k pull-up to 3.3 V; outputs RFDET1..4 active low to the logic sheet | Capacitive ratio is flat over 1.8 to 54 MHz and has no power loss; see C-15. LM339 rejected for LM2901: LM339 is rated 0 to 70 °C only (outdoor box to -20 °C); LM339B -40 to 85 °C would also fit. BAT54 rejected: 30 V against about 31 V peak reverse | Resistive tap (0.26 W in a 47k HV resistor at 100 W; parasitic C gives a rising ratio above about 17 to 34 MHz) | decided (Prins, option 1). Combination of RFDET1..4 to RF_DET and expander inputs: with the logic sheet. KiCad has no BAS70 symbol: project symbol with SOT-23 pin numbers |
| D-48 | 2026-09-27 | Detector changed to a voltage doubler: BAS70-04 series pair (onsemi BAS70-04LT1/D Rev 15, SOT-23 style 11: 1 anode D1, 2 cathode D2, 3 K1/A2) with pin 1 to GND, pin 3 on the tap, pin 2 to DET; R3 DC return removed (the lower diode is the DC return); load R5 47k + R4 47k, the comparator reads DET / 2 | A negative impulse before the CS-400R fires (about 950 V at the column, about 80 V at the tap) reverse-biased the single BAS70 beyond 70 V; the lower diode now clamps it at about -0.4 V. Positive impulses are charge-limited by C4 (about 4.5 nC into 10 nF = 0.45 V). Same sensitivity, same part count | Single BAS70 with a documented, charge-limited exception | decided (Prins, option 1). LM2901 input above its supply: allowed (TI SLCS006Z note: inputs to 36 V without damage; IN- above the common-mode range with IN+ inside gives a correct LOW output), see TI SNOAA91 |
| D-49 | 2026-09-27 | I/O expanders: 3 x PCA9539 per unit (NXP Rev 9.1: 16 I/O, no pull-ups, active-low RESET, A0/A1 = 4 addresses 0x74 to 0x77, 2.3 to 5.5 V, -40 to 85 °C, SO24), second source TI TCA9539; addresses 0x74, 0x75, 0x76 on both units; unit 2 on its own I2C channel from the controller (mux or second port, with the controller header). Grouping: U1 = R1 rows (10) + K1 A1, A2 + RFDET1, 2; U2 = R2 rows + K1 A3, A4 + RFDET3, 4; U3 = R3 rows + 3 PTT readbacks; about 2 spare each | About 41 I/O per unit; 6 expanders do not fit in the 4 PCA9539 addresses on one bus. A separate channel keeps identical boards (no address strap), keeps RESET as a second path to the safe state, and keeps a unit 2 cable fault off the unit 1 bus. Case 55 °C / 85 °C = 0.65 | PCA9535 / TCA9535 x 3 with A2 as unit strap on one bus (no RESET, a unit 2 fault can hang unit 1); PCA9539R (RESET resets only the I2C interface); PCA9535C (open-drain outputs); PCA9555 / TCA9555 (internal pull-ups: gates at about 1.65 V against the 100k pull-down at power-on) | decided (Prins, option 1). RESET source and I2C pull-ups: next decisions; order code TI PCA9539DWR since D-126 (NXP PCA9539D,118 obsolete) |
| D-50 | 2026-09-27 | PCA9539 RESET driven directly by RLY_EN (active high, R3 100k pull-down on the power sheet) on all three expanders | One hardware line gives two paths to the safe state: no signal = +12V_SW off and expanders in reset (outputs to inputs, 100k gate pull-downs hold every coil off). Firmware sets RLY_EN high, then configures. Documented exception: the datasheet asks for a pull-up on RESET; the pull-down is deliberate. Common cause (RLY_EN stuck high) needs a fault outside the board plus a second fault before a relay moves | Separate EXP_RST line (RJ45 pair 4 and one controller header pin) | decided (Prins, option 1). Drawn on the new I/O expanders sheet (U901 0x74, U902 0x75, U903 0x76) |
| D-51 | 2026-09-27 | RJ45 LINK (Cat6 to the shack) on the controller board, with the isolated RS-485, PTT opto, KILL loop, surge protection and safety gate (rev B link card). RF board to controller: J14 2 x 12 2.54 mm header, 3.3 V logic. Odd pins: 1 SCL, 3 SDA, 5 EXP_INT, 7 SCL_B, 9 SDA_B, 11 EXP_INT_B, 13 RLY_EN, 15 TX_ANY, 17 to 21 R1..R3_K0_DRV, 23 spare; even pins: 2, 4 +5V, 6 to 24 GND (a GND next to every signal). U903 reads back the K0 drives. Unit 2 INT needs its own conductor: EXP CTRL RJ45 pair 4 carries EXP_INT_B (the PCA9615 carries SDA and SCL only) | Protection and isolation at the connector where the outdoor cable enters (skill section 16); header carries only local logic; RF board stays RF, coil drivers and expanders | RJ45 LINK on the RF board (isolation barrier and outdoor-cable protection next to 173 V RF, more header signals) | decided (Prins, option 1). I2C and INT pull-ups, EXP CTRL (PCA9615, RJ45, protection): next decision |
| D-52 | 2026-09-28 | EXP CTRL off the RF board. Unit 1: PCA9615 master end and RJ45 EXP CTRL on the controller board, next to RJ45 LINK. Unit 2: small EXP adapter board (2-layer, about 40 x 60 mm) on J14 in place of the controller board: PCA9615 slave end, RJ45, protection, own 3V3 LDO from +5V on J14; it drives SCL, SDA, RLY_EN, TX_ANY and reads EXP_INT. J14 new pin-out (odd pins): 1 SCL, 3 SDA, 5 EXP_INT, 7 RLY_EN, 9 TX_ANY, 11 to 15 R1..R3_K0_DRV, 17 to 23 spare; even pins unchanged (2, 4 +5V, 6 to 24 GND). Bus pull-ups on the RF board, so both units are the same: R901, R902 2.2k (SCL, SDA), R903 10k (EXP_INT) to +3V3 (C-16); controller board and adapter add none on this bus | RF board identical in both units, no build option on the safety line RLY_EN; with the cable out, R3 holds RLY_EN low (unit 2 safe); outdoor-cable protection away from the 173 V RF zone; J14 stays the only logic interface | EXP CTRL on the RF board with 0R links or jumpers per unit (build option, a wrong fit sets two drivers against each other on RLY_EN; RJ45 next to the RF zone) | decided (Prins, option 2). Supersedes the SCL_B, SDA_B, EXP_INT_B pins of D-51. C-14 to recheck: the PCA9615 load (91 mA max) leaves the RF board LDO. Unit 2 link (PCA9615, RJ45, adapter board) superseded by D-53; J14 pin-out and RF board pull-ups stay |
| D-53 | 2026-09-28 | Unit 2 link: 2 x 12 IDC ribbon, single-ended. The unit 1 controller board gets a second 2 x 12 header EXP with the J14 pin-out, driven from the second I2C channel (D-49) and the same K0 drives, RLY_EN and TX_ANY; pins 2 and 4 (+5V) not connected at the controller end (no parallel supplies). The ribbon plugs into J14 of the unit 2 RF board; every signal conductor lies next to a GND conductor. About 100 ohm series resistor per signal at the controller end, low-capacitance TVS array at each case wall, I2C at 100 kHz, ribbon 0.5 m max inside the RVS box. K0 in unit 2 follows each radio's own PTT. TX_ANY read back on U903 IO1_5 | All wires available, so unit 2 works like unit 1 without an adapter board or PCA9615; unit 2 bus about 130 pF (C-16) is within Standard mode; the firmware does not write to the expanders during TX | Ribbon with PCA9615 at both ends and the adapter (more RF margin, longer cable, one more board); RJ45 with PCA9615 (D-52, not enough conductors for three K0 drives); unit 2 K0 on TX_ANY or not used | decided (Prins, option 1). Fallback: add the PCA9615 pair (option 2) if the M-line tests show RF pick-up; the RF board does not change. Case wall passage: slot about 32 x 3 mm with grommet or clamp, milled in the first CNC order (D-201); position with the case CAD update |
| D-54 | 2026-09-28 | Bias-T supply: switched and monitored, one feed per antenna port, on a new sheet "Bias-T supply". Fourth PCA9539 U1001 at 0x77 (A1 A0 = 11) on the same bus, INT and RESET (= RLY_EN): IO0_0..3 A1..A4_BIAS_EN, IO0_4..7 A1..A4_BIAS_OK, IO1 spare. Per feed: +12V_AUX, 10R 0805 sense resistor, P-MOSFET high side IRFL9014 (Vishay, SOT-223, -60 V; second source onsemi NTF2955, same pin-out), BC857B PNP current limiter (C-17), BSS138BK gate drive from EN via 47k (VGS 8.6 V max with 100k gate-source), 100k enable pull-down, 100 nF X7R 50 V, SMBJ15A TVS on the output, 33k/10k read-back divider to OK. Firmware: fault = EN high and OK low; switch the feed off and report | Preamp can be switched and a short is reported per port; a short stays in current limit without firmware (C-17), and RLY_EN low holds U1001 in reset so the pull-downs turn every feed off; all parts jellybean and multi-source (R-10). 4th expander instead of shared fault flags (Prins) | Fixed feed with PTC (no control, no fault report); integrated smart high-side switch (single-source, against R-10); shared fault flags on U903 (Prins chose the 4th expander) | decided (Prins, option 2 and discrete option 1). Layout: about 1 square inch (645 mm2) drain copper per P-MOSFET (D-193: 0.64 in2 on F.Cu + B.Cu with thermal vias). A KILL also turns the preamps off |
| D-55 | 2026-09-28 | Controller MCU: Espressif ESP32-C3-DevKit-RUST-2 (Rev 2.0 schematic 2025-10-28, ESP32-C3-MINI-1) plugged onto the controller board, unit 1 only. Supply: 3V3 header pin (pin 2) from a linear LDO on the controller board (LP2985-33, same part as the RF board, from +5V on J14); ENABLE header pin (27) tied to GND so the on-board SY8088 buck stays off; VBUS/5V pins not connected. I2C: the board bus SDA GPIO7 / SCL GPIO8 (header pins 12, 13, 10k pull-ups, SHTC3 0x70 and ICM-42670-P 0x68 on board) is the expander bus to J14; the SHTC3 then gives box temperature and humidity. Other functions on GPIO0, 1, 3, 4, 5, 6, 20, 21 (EXP_INT, RS-485 TX/RX/DE, watchdog kick, MCU_EN, latch clear, 1 spare; final mapping in D-59: GPIO1 WDI, GPIO3 LATCH_CLR, GPIO4 MCU_EN_N, GPIO5 KILL read); status inputs (KILL, latch, supply OK) on U1001 IO1. Wi-Fi and BLE off in the firmware | Ready-made, supported board (Rust and ESP-IDF); keeps the no-switch-mode rule in the box; the PC can stay on USB at any time: the board's own Schottky D6 blocks our supply from the PC VBUS, and the buck stays off with ENABLE low | Supply through the 5V/VBUS pin with the buck running (switch-mode near the HF receive path); extra series diode on the 5V feed (not needed when the buck is off); ESP32-C3-MINI-1 module on the controller board (fallback) | decided (Prins, option 1). One I2C controller only: a unit 2 bus later needs a software bus or a mux (unit 2 postponed). To confirm: SY8088 behaviour with EN low and its output held at 3.3 V (back-feed through the high-side body diode to the +5V node, about 0.3 mA through R1 to ENABLE); ESP32-C3-MINI-1 temperature range; PC and box share GND when both are connected (bench only) |
| D-56 | 2026-09-28 | Data link to the shack: UART over two opto current loops, one per direction, powered from the shack end. Cat6 #1: pair 1 data shack to box, pair 2 PTT loop, pair 3 KILL loop, pair 4 data box to shack. Box receive: 6N137-class high-speed opto, output on the box +5V side (open collector, pull-up to 3.3 V). Box transmit: PC817-class phototransistor opto switching the shack loop. About 19.2 kbaud. Per pair at the box entry: GDT to the box earth, series resistor, TVS | No isolated supply in the box, so the no-switch-mode rule holds without a PSU winding; one method for all four pairs (optos and loop power from the shack); jellybean multi-source optos (Vishay, Broadcom, Lite-On, onsemi, Everlight) | Isolated RS-485 with the bus side on an extra PSU winding (depends on the PSU design, floating bus sides, needs a PSU winding at the shack end too); isolated RS-485 with built-in isolated power (switch-mode, 100 MHz class) | decided (Prins, option 2). Consequences: all four pairs of Cat6 #1 are used; a PTT loop for a second TX radio needs Cat6 #2. Firmware update over the link takes about 10 min. The RS-485 DE GPIO is no longer needed (2 GPIOs spare on the DevKit). Shack end: loop drivers for data and KILL, PTT loop from the FT-710 |
| D-57 | 2026-09-28 | Cat6 #1 is unshielded (UTP, already buried). No shield bond; common-mode RF handled by the FT240-31 chokes at both ends, surge by a GDT per pair to the RVS box earth at the entry, then series resistors and TVS, then the optos | The cable is in the ground (Prins); the opto loops (D-56) isolate every pair, so no ground or shield current enters the logic | Shielded S/FTP with the shield bonded at the box and a capacitor at the shack (cable would have to be replaced) | decided (installed cable). The loop receivers and TVS parts carry all induced energy: size them for it |
| D-58 | 2026-09-28 | Link speed 9600 baud (C-18). Link circuit per pair (controller board, sheet Link and PTT): Bourns 2036-09-B2LF 3-electrode 90 V GDT to CHASSIS; 47R thin-film MELF 0207 per wire; SMBJ15CA across the pair. Receive (pairs 1, 2, 3): 220R MiniMELF 0204 in series with the LED, 1N4148W anti-parallel, Vishay VO2611 (6N137 pin-out, 15 kV/us CMTI; second source Broadcom HCPL-2611), output open drain with 4.7k to 3.3 V, EN tied to VCC, 100 nF at VCC. Transmit (pair 4): 1N4148W series diode, PC817X (rank B or better) transistor on the loop, LED 17 mA from +5V through 220R, switched by a BSS138BK from DATA_TX (100k pull-down). PTT: 74LVC1G14 inverts PTT_N to TX_ANY; R1_K0_DRV, R2_K0_DRV, R3_K0_DRV from TX_ANY through 0R select links (R1 FT-710 own PTT, R2 Airspy and R3 spare TX mute). T568B pairs, + wire first: pair 1 = 4/5 data in, pair 2 = 1/2 PTT, pair 3 = 3/6 KILL, pair 4 = 7/8 data out. Shack side: 12 V through about 820R per loop (10 mA) | C-18: 9600 baud gives 10 to 20 % bit distortion; one opto type per direction; PTT to K0 without the MCU (rev A rule); data idle = loop current, so a dead box or cut cable shows as a break at the shack | 19.2 kbaud with a 4N35-class base-pin opto (second opto type, value needs a measurement) | decided (Prins, option 1). To confirm: GDT second source; MELF pulse rating; SMBJ15CA clamp at the chosen EN 61000-4-5 level (R- line); VO2611 LED surge (0.12 A for the TVS clamp time, rating 200 mA for 100 us). UART RX is inverted in firmware (idle = LED on = low) Surge checks at R-17 (4 kV 10/700 us): C-39, 2026-10-22 (MELF, TVS, LED pass); GDT second source still open. Open points closed by D-149 and C-39 (review S-17, 2026-11-02) |
| D-59 | 2026-09-28 | Safety gate on the controller board, drawn on the MCU sheet (renamed "MCU and safety gate"): RLY_EN = NOR(KILL, MCU_EN_N, FAULT). U12 TI TPS3823A-33 (SOT-23-5) monitors +3V3 (VIT- 2.83 to 3.00 V) with a watchdog on WDI (GPIO1, 0.9 to 2.5 s, R61 1k to GND); MR open (internal 90k pull-up). U13 74LVC1G74 fault latch: PRE_N = RESET_N sets FAULT at power-up, brown-out and watchdog time-out; D = GND, CLR_N = +3V3; a LATCH_CLR edge (GPIO3, R62 100k pull-down) clears it only while RESET_N is high. U14 74LVC1G27 3-input NOR drives RLY_EN (J2 pin 7). MCU_EN_N on GPIO4, active low, R63 100k pull-up, so a floating or resetting MCU keeps the relays off. KILL not latched. U12 RESET_N does not reset the MCU (DevKit pin 1 RST open). IEC 60617 project symbols for the NOR (>=1), the flip-flop (S, 1D, C1, R) and the Schmitt inverter U5 (replaces the ANSI KiCad symbol) | Datasheet-guaranteed watchdog and supply supervision in one SOT-23; the watchdog trips on a stuck-high or stuck-low WDI; the A version does not latch up on WDI pulses during reset; after every reset the relays wait for an explicit clear by the firmware; a NOR with three stop inputs needs no inverter; all parts -40 to 125 °C and multi-source (R-10). Gate on the MCU sheet: WDI, MCU_EN_N and LATCH_CLR stay wires, and the root sheet needs no labels | Discrete supply comparator plus charge-pump watchdog (about 12 more parts, tolerance and test effort; the IC already rejects a static WDI); separate gate sheet (root wires would cross the I2C lines to J2); active-high MCU_EN with an AND gate (needs an inverter for KILL) | decided (Prins, option 1). To confirm: MAX823 as TPS3823 second source (pin-out and WDI float behaviour), Nexperia 74LVC1G74DC and 74LVC1G27GW pin-outs, gate output with 3V3 below 1.65 V (A-14). MCU reset: U12 RESET_N not connected to the DevKit RST (Prins, option 1, 2026-09-28): the ESP32-C3 internal watchdogs restart the MCU, the external watchdog only drops the relays; no reset loop when the firmware starts slowly. Firmware rules (Prins, 2026-09-28): (1) kick WDI only from the main loop, after the checks of that pass; never from a timer interrupt, so a hung main loop stops the kicks; (2) give a LATCH_CLR edge only once after start-up, after the self-test (KILL state, expanders respond on I2C), and after a fault only when its cause is checked; never toggle LATCH_CLR as a routine. Reason: a crashed MCU that still toggles WDI and LATCH_CLR would defeat the latch. Pin-out points closed by D-154 and D-155 (review S-17, 2026-11-02) |
| D-60 | 2026-09-28 | RF board root sheet: control lines as KiCad buses. Bus aliases R1DRV, R2DRV, R3DRV (11 coil drives per radio), ANT (K1 drive, detector, bias feed per antenna port), CTRL (SCL, SDA, EXP_INT, RLY_EN); one bus segment at each block, each entry wire carries its net name. Wires for everything between neighbouring blocks: radio and antenna coax, crossbar columns, RFDET to the IO block, J14 (now mirrored) straight to the IO block. Aliases stored in rf-board.kicad_pro (KiCad 10 keeps them there). Sheet size A2 | 42 control lines between the IO block and seven port blocks cannot run as straight wires without crossing the coax and the columns; a bus per block keeps the structure visible (hardware skill: labels allowed for a long bus) | One PCA9539 inside each radio port sheet (no labels on the root; D-49, D-53, D-54 to change, full re-check) | decided (Prins, option 1) |
| D-61 | 2026-09-28 | R904 100k pull-down on TX_ANY on the RF board (IO expanders sheet), logic verification F4 | With J14 open (unit 2 ribbon out, controller removed) U903 IO1_5 floated; same method as R101 on the K0 drives | Leave it floating (no coil affected, but random reads and extra current) | decided (Prins, option 1) |
| D-62 | 2026-09-29 | One safety line (F2): Cat6 #1 pair 3 becomes the series loop SAFE, powered from the shack, through the shack KILL switch, a shack opto that drives FT-710 TX INH, the box opto U3 (reads SAFE into the KILL input of U14) and a new box switch READY (PC817, driven by NOR(MCU_EN_N, FAULT), 74LVC1G02 + BSS138). Any fault (KILL, watchdog, brown-out, firmware fault on a radio or antenna port, cable cut, box dead, shack supply off) stops the current: TX inhibited and all relays off. Shack side: hardware latch; a loss of loop current holds TX INH until RESET is pressed with the loop current back. PTT stays a hardware loop (pair 2) to K0 | One line, wired-AND of all OK conditions, fail-safe; the shack latch holds the stop until the cause is fixed and the operator acknowledges, also if the box firmware misbehaves; no new cable. READY excludes KILL, else the loop cannot start | PTT over the data link (4 ms per message at 9600 baud plus MCU time plus 12 ms K0 against 30 ms QSK DELAY max; a lost message sends RF into the RX row); firmware-held fault only (option 1) | decided (Prins, SAFE loop; option 2 latch). Start-up order: LATCH_CLR, MCU_EN_N low, then SAFE current flows and KILL reads 0, then switching. Drawn: shack interface (a1 to a11), box READY switch (D-101, M-30) |
| D-63 | 2026-09-29 | Per-radio K0 and TX permit. R1 (FT-710): hardware PTT loop (pair 2) drives only R1 K0 (controller R51 fitted, R52 and R53 not fitted). R2, R3: K0 from the box MCU through U903 IO1_3, IO1_4 (outputs; F3 changes). TX of R2 and R3 by handshake: request over the data link, box checks the state (H1 to H4), sets K0, waits 12 ms, reads back, sends a permit; the shack interface releases that radio's TX INH; at the end the shack interface sets TX INH, sees TX GND inactive, then the box releases K0. Each TX INH = SAFE latch AND permit, in hardware. Shack interface with its own MCU, connected to the Mac (full control of radios and antennas for propagation and antenna tests) | A WSPR or second station can transmit without moving the FT-710 to its TX row; no radio can send RF before its K0 is set, also radios without a TX delay setting; no new cable | Shared PTT loop with all K0 on TX_ANY (every TX mutes all receivers); Cat6 #2 with hardware PTT loops (cable to lay, every radio needs a TX delay of 15 ms or more) | decided (Prins, option 1). Drawn 2026-10-05: R52, R53 not fitted (controller c5), U903 IO1_3, IO1_4 as K0 outputs (RF board v10h), checked in verify_logic.py (M-30). To confirm: behaviour of each radio when keyed over CAT with TX INH active |
| D-64 | 2026-09-29 | Shack interface MCU: Raspberry Pi Pico 2 (RP2350) on sockets. Local display with touch control for stand-alone use. Control from the Mac over USB (CDC) or Ethernet. The SAFE RESET stays a physical button only; no USB, Ethernet or touch command can clear the SAFE latch | 26 GPIO, native USB, PIO for the 9600-baud link, Rust (embassy-rp) possible; stand-alone use without the Mac | ESP32-C3-DevKit-RUST-2 as in the box (about 15 free GPIO, needs an expander in the permit path) | superseded by D-65 (misunderstanding: Prins meant a full Raspberry Pi with a HAT) |
| D-65 | 2026-09-29 | Shack interface: full Raspberry Pi with a HAT. Pi: touch display, Ethernet, USB to the Mac, stand-alone use. HAT: loop supplies, link optos, SAFE loop with KILL switch, hardware latch and RESET button, per-radio TX INH = SAFE latch AND permit, TX GND senses, FT-710 mini-DIN, RJ45 for Cat6 #1. Rule kept from D-64: only the physical RESET button clears the SAFE latch | Built-in Ethernet, USB and display interface (DSI), Linux for UI and experiments; the GPIO budget is no longer a problem | Pico 2 with display and W5500 (D-64, GPIO short) | decided (Prins). Real-time split: D-66. Open: Pi model; display; SD card wear and power-loss behaviour |
| D-66 | 2026-09-29 | Real-time work on the HAT, not in Linux: an ESP32-C3-DevKit-RUST-2 on sockets, the same module as the box (D-55). It runs the box link, the permits, the TX GND senses and the handshake timing. The Pi sends requests only. Proposed: HAT MCU to Pi over the DevKit USB-C (USB Serial/JTAG, GPIO18/19), so the Pi can also flash it; safety lines on direct GPIO (link 2, permits 3, TX GND 3, SAFE sense 1, software stop 1); slow inputs (latch state, KILL state, BAND A to D) on a PCA9539, inputs only, on the board I2C GPIO7/8; permits gated by the same supervisor and fault-latch pattern as the box (D-59) | A Pi reboot or update does not touch the TX state; small firmware that truth tables can verify; one module type and one toolchain in the whole system; one spare fits both ends | Permits driven by the Pi with a charge-pump or monostable hold-off (Linux jitter in the handshake, safety logic in Linux) | decided (Prins, option 1, same MCU as the matrix); slow inputs and software stop changed by D-67. To confirm: GPIO fit (13 usable, about 14 needed with WDI and LATCH_CLR; one line may go to the expander), strapping pins GPIO2, 8, 9 |
| D-67 | 2026-09-29 | Pi model: Raspberry Pi 5, NVMe base under the Pi, active cooler, HAT on top. The Pi GPIO acts as the IO expander for slow and non-safety signals: latch state, KILL state, FT-710 BAND A to D (inputs), software stop (output; it can only open the SAFE loop). No PCA9539 on the HAT. Proposed: 1k series resistor in each Pi GPIO line on the HAT, so a wrong Pi pin setting or the Pi boot pulls cannot drive a HAT net | Fewer parts; the Pi shows the stop cause and does the antenna auto-select; none of these lines can enable TX (SAFE and the permits stay in hardware and on the HAT MCU) | Pi 4 (no NVMe slot, no RTC); PCA9539 on the HAT (D-66 proposal) | decided (Prins) for Pi 5; the IO part (Pi as IO expander, 1k series resistors) superseded by D-68. HAT MCU GPIO then: 11 lines (link 2, permits 3, TX GND 3, SAFE sense 1, WDI 1, LATCH_CLR 1) on GPIO0 to 6, 9, 10, 20, 21, no spare; GPIO7/8 stay the idle board I2C. To confirm: strapping GPIO2, 8, 9 and UART0 boot output on GPIO21; stacking height with the cooler |
| D-68 | 2026-09-29 | HAT works stand-alone: without the Pi, with only its USB-C connected to the Mac (Prins). One USB protocol for the Pi and the Mac. PCA9539 on the HAT, on the DevKit board I2C (GPIO7/8, polled, no INT line). Inputs: latch state, KILL state, FT-710 BAND A to D. Output: software stop (opens the SAFE loop only; the power-up state, input with a pull resistor, keeps the loop closed; rule F1 applies). The Pi connects to the HAT MCU over USB only, no Pi GPIO on HAT nets; the same USB-C can go to the Mac when the Pi is off. Proposed: the HAT has its own 5V supply and does not depend on the Pi supply | Link, SAFE, permits, handshake and stop cause keep working when the Pi is off, rebooting or removed; one clean interface to the Pi | Pi GPIO as IO expander (D-67, depends on the Pi) | decided (Prins). HAT MCU direct GPIO unchanged: 11 lines. To confirm: HAT and Pi power arrangement; PCA9539 address; strapping GPIO2, 8, 9 |
| D-69 | 2026-09-29 | Order of work: phase 1 is the shack interface stand-alone (HAT MCU with USB to the Mac through the Delock 64226). The Pi 5 and its display come later; Prins has display parts at work | The Pi only talks to the HAT over USB (D-68), so the Pi adds nothing the stand-alone unit needs | Pi and display in phase 1 | decided (Prins). Board form: D-70 |
| D-70 | 2026-09-29 | Shack interface: own board in its own housing (not Pi HAT format). The Pi connects later by USB cable. Panels: RJ45 Cat6 #1, 13.8 V input, FT-710 mini-DIN, R2 and R3 ports, KILL switch, RESET button, status LEDs. Proposed: SAFE and latch LEDs driven from the latch in hardware; per-radio LEDs on spare PCA9539 pins. The name HAT is replaced by shack interface board | Room for the DevKit on sockets, 4 loop circuits with protection, latch, gates and expander; connectors on panels; no mechanical tie to the Pi | Pi HAT 65 x 56 mm (too small for the DevKit and the panel connectors) | decided (Prins, option 1). Housing: aluminium (Prins, 2026-09-30); the 7805 mounts on its wall (D-82) |
| D-71 | 2026-09-29 | Radio ports R1 to R3: three identical ports, mini-DIN 8 (FT-710 TUNER/LINEAR pin-out), one adapter cable per radio. Per port: TX sense input; TX INH by a form B (normally closed) PhotoMOS whose LED is driven by permit AND SAFE latch, so an unpowered or stopped interface inhibits; a 3-pin jumper selects the inhibit level: LOW (contact to radio GND) or HIGH (contact to the radio's own supply pin through a series resistor footprint, value per radio); jumper removed = TX INH not used. Keying output: form A PhotoMOS to the radio PTT input, closed only after the permit | Radios without an inhibit input (many WSPR and QRP radios) are keyed only by the interface; both inhibit levels served; fail-safe in both levels (no LED current = inhibit); radio grounds stay separate | TX sense and TX INH only on R2 and R3 (excludes radios without inhibit); form A PhotoMOS for TX INH (an unpowered interface would release the inhibit) | decided (Prins, option 1, jumper for the level). To confirm: form B PhotoMOS part; FT-710 inhibit level (A-15); radios with an inhibit input that needs current, not a level |
| D-72 | 2026-09-29 | TX sense input per port: opto input with a 3-pin jumper. CONTACT: the interface feeds the opto LED through a series resistor and the radio output (open collector or relay contact) closes it to radio GND (FT-710 TX GND). VOLTAGE: the radio's TX voltage drives the opto LED through a series resistor (value per radio) | One port serves both radio output types; input isolated in both positions; the same idea as the TX INH jumper | Open-collector input only (radios with a voltage TX output need an adapter) | decided (Prins, option 1). Note: in CONTACT the LED feed ties the radio GND to its source; feed from the radio's own supply pin (FT-710 pin 6, +13V OUT) keeps the port floating; a feed from the interface supply ties radio GND to interface GND (already common in DC through the shack supply and the Delock hub downstream side). Proposed: feed from the radio supply pin, with a solder jumper to the interface supply for radios without one. To confirm: opto part (CTR at low LED current), LED series resistor for the VOLTAGE range, reverse protection. Closed by D-77 to D-84 (review S-17, 2026-11-02) |
| D-73 | 2026-09-29 | Shack interface power: 13.8 V input with fuse, reverse-polarity protection and TVS; linear regulator 13.8 V to 5 V (DPAK or TO-220), then LP2985-33 (same part as the box) for 3.3 V (3.3 V part changed by D-81). No switch-mode converter | No switching noise next to the HF receivers; same rule as the box; about 2 to 2.5 W total in the housing (estimate, to confirm) | Buck to 5 V (about 1 W less heat, switching source near the receivers) | decided (Prins, option 1). To confirm: current budget, regulator part and heat sinking. Closed by D-77 to D-84 (review S-17, 2026-11-02) |
| D-74 | 2026-09-29 | Shack loop drive: one constant-current source per loop (two-transistor source from 13.8 V), about 10 mA (value to confirm against the VO2611 threshold and the PC817 CTR) | Current independent of the supply (12 to 14.4 V) and of the cable length; a shorted or crossed pair draws only the set current; a clean SAFE sense threshold, so a partly failing connection gives a stop and not a marginal state | Series resistor per loop (current varies with supply and cable, more current in a short) | decided (Prins, option 1). Headroom: C-21. Closed by D-77 to D-84 (review S-17, 2026-11-02) |
| D-75 | 2026-09-29 | Shack SAFE latch: 74LVC1G74, same pattern as the box fault latch (D-59). PRE_N = loop OK AND power OK (a current loss or power-up sets it); debounced RESET button clocks D = GND, so it clears only while PRE_N is high; own power-on reset, separate from the MCU watchdog (a shack MCU hang drops the permits through the shack fault latch but does not stop the box) | Same part and pattern as the box, already verified (S1 to S7); no mechanical part | Self-holding relay (contact wear, coil current, harder to verify) | decided (Prins, option 1). To confirm: power-on reset part, RESET debounce values. Verified at design level: verify_system.py (all checks pass); findings F11 (box start-up rule changed), F12 (open: K0 of R2/R3 drops at once on a SAFE stop), F13 (box keeps K0 while a permit is out). Closed by D-77 to D-84 (review S-17, 2026-11-02) |
| D-76 | 2026-09-29 | F12 accepted for emergency stops: on a SAFE stop the box relays drop at once (R2/R3 K0 and all row relays within 0 to 6 ms) while the shack inhibits the radios; RF from a radio that is slower than that crosses opening contacts into open lines. Each radio's inhibit response time is measured on the bench (M-12) | A stop is rare; only the relay contacts carry the stress (all rows open, so RF goes into open lines, not into other equipment); R1 K0 follows the FT-710 TX GND; no extra parts | About 50 ms delay of the box relay drop after the SAFE loop opens (RC and Schmitt stage in the KILL path) | decided (Prins, option 1) |
| D-77 | 2026-09-29 | TX INH switch (superseded by D-106 for the part choice, 2026-10-07): Littelfuse CPC1117N (1-form-B OptoMOS, 2.54 mm SOP4: 60 V, 150 mA, RON typ 5 max 16 ohm, 1 mA LED to operate, 1500 Vrms); second source Toshiba TLP4176G (1-form-B, 2.54 SOP4: 350 V, 120 mA, 25 ohm max, 3 mA max trigger, 1500 Vrms) on the same footprint | Low LED current for the gate drive; voltage ratio 14.4 V / 60 V = 0.24 (factor 0.7); two sources in one package style | TLP4176G as the main part (higher RON and LED current, voltage margin not needed); TLP4227G (end of life) | decided (Prins, option 1). Datasheets filed 2026-09-29 (CPC1117N R12 2024-06-06, TLP4176G 2026-04-07): pin-out match confirmed (1 anode, 2 cathode, 3 and 4 load); lead span 6.10 mm (CPC1117N) against about 7.0 mm (TLP4176G), so the common footprint needs long pads (drawn: D-99); LED drive C-22. Halogen: not stated by the maker, marked only (Prins, 2026-10-05; D-42) |
| D-78 | 2026-09-29 | TX sense opto: PC817X (same as the box transmit opto, D-58), 1N4148W anti-parallel across the LED, LED about 5 mA (C-23). Firmware: after the inhibit, wait for TX sense inactive and at least 100 ms before 'end'; flag a port whose TX sense stays inactive while keyed (F14, verify_system.py) | One opto type in the system, several sources; diode protects against a reversed VOLTAGE-mode radio; a failed or aged TX sense opto reads 'no TX' (not fail-safe), so the minimum wait and the plausibility check close that gap | AC-input opto PC814 (lower CTR, new part) | decided (Prins, option 1) |
| D-79 | 2026-09-29 | Shack loop current source (D-74): two-transistor PNP source on the high side per loop. Pass BCP53 (80 V, SOT-223), sense BC857, Rsense 56 ohm for about 10 mA (I = VBE / Rsense; changed from 68 ohm by C-24). Shack entry protection as the box (GDT, 2 x 47R, SMBJ15CA) | Worst case at the source about 38 V (13.8 V + TVS clamp): 38 / 80 = 0.48 (factor 0.7); short-circuit loss about 0.14 W in a 1 W class package (factor 0.6); jellybean, several makers (Nexperia, onsemi, Diodes); about 1 V headroom as C-21 | LM334 (40 V against 38 V fails 0.7 unless a lower TVS; fewer sources); SOT-23 pass transistor (power in a short) | decided (Prins, option 1). Datasheets filed (BCP53 Rev 11, BC857 Rev 9): 38 / 80 = 0.48 pass; short 0.13 W / 0.57 W at 40 °C = 0.23 pass; current spread C-24 |
| D-80 | 2026-09-29 | Shack end of the loops without optos (isolation at the box end only, D-56). Pair 1 (data to box): the MCU switches the current source on and off through a small transistor. Pairs 3 and 4 (SAFE sense, data from box): sense resistor in the loop return, transistor or comparator to 3.3 V logic. Pair 2 (PTT to R1 K0): the R1 TX sense output switches its current source in hardware (delay some tens of us against 12 ms for K0), so the FT-710 TX GND serves TX sense and PTT loop through one circuit | One isolation barrier per loop is enough; fewer parts; no second CTR ageing on the safety line; shack entry keeps GDT, 2 x 47R and TVS | Optos at both ends (four more optos, each with CTR ageing) | decided (Prins, option 1). To draw: sense thresholds against C-24 current range |
| D-81 | 2026-09-30 | Shack interface 3.3 V: LD1117S33 (SOT-223, 800 mA) from +5V, replaces the LP2985-33 of D-73. Pin-out GND 1, OUT 2 (tab), IN 3; second sources TI LM1117-3.3, Diodes AZ1117-3.3 (pin-out and output capacitor per maker to confirm) | 3.3 V load estimate about 115 mA (DevKit 60, six PhotoMOS LEDs 42, status LEDs and pull-ups 12): LP2985 150 mA gives 0.77 (fails 0.7); LD1117: 0.14, loss about 0.2 W | LP2985-33 with the PhotoMOS LEDs on +5V through six BSS138 (3.3 V load 73 mA, 0.49; six more parts) | decided (Prins, option 1). Datasheet filed (ST DocID2572 Rev 38): VIN max 15 V (0.33), C version -40 to 125 °C (LD1117S33CTR), SOT-223 pin 1 GND, 2 OUT (tab), 3 IN; output 10 uF minimum: fit 22 uF X7R 1210 (at least 10 uF effective at 3.3 V). Budget and heat: C-25 |
| D-82 | 2026-09-30 | Shack interface 5 V regulator: 7805 in TO-220, bolted to the aluminium housing wall with an insulating pad (loss about 1.1 to 1.2 W at 130 mA, up to 14.4 V in) | The wall is the heatsink; junction well below the 0.8 temperature factor | DPAK L78M05 on PCB copper (about 100 °C junction at 40 °C ambient: at the 0.8 limit of 125 °C, no margin) | decided (Prins, option 1). The shack interface gets an aluminium housing (Prins, 2026-09-30; see D-70). Open point for the outdoor box: regulator heat against condensation (Prins) |
| D-83 | 2026-09-30 | Shack interface MCU pin map (replaces the D-67 count). DevKit header: GPIO10 is not on the header (pins 17, 18 not connected; GPIO10 only drives the board LED), so 10 GPIO besides I2C. Direct GPIO (8): IO0 PERMIT_R1, IO1 WDI, IO3 LATCH_CLR, IO4 PERMIT_R2, IO5 PERMIT_R3, IO6 DATA_TX, IO20 DATA_RX, IO21 SAFE_LOST (input, 1k series against the boot-ROM log). IO7/IO8 I2C. IO2 (WS2812, strapping) and IO9 (BOOT, strapping) unused, as the box. PCA9539 (0x74), 16 of 16: IO0_0..2 KEY_R1..R3, IO0_3 SW_STOP_N, IO0_4..6 LED_R1..R3, IO0_7 R3_TX; IO1_0 LATCHED, IO1_1 KILL_S, IO1_2..5 BAND_A..D, IO1_6 R1_TX, IO1_7 R2_TX. PCA9539 RESET = supervisor RESET_N; INT not connected (polled) | No strapping risk; permits, watchdog and link stay on direct GPIO; TX sense polled at 10 ms is fast enough against the 100 ms end-of-TX wait (F14); the R1 PTT loop still runs from R1_TX in hardware | GPIO2 and GPIO9 as direct lines (strapping pull-ups, R11 removed on the DevKit, LATCH_CLR idling high changes S4/F11, BOOT button on a signal line) | decided (Prins, option 1). PCA9539 map superseded by D-92 (2026-10-04); direct GPIO unchanged. Firmware: F1 order for the PCA9539; poll inputs every 10 ms |
| D-84 | 2026-10-01 | SAFE latch power-on reset (open in D-75): a second TPS3823A-33 with WDI left open (open WDI disables the watchdog, TPS3823 7.3.4), so it works as a plain supervisor; its RESET_N goes into PRE_N of the SAFE latch together with loop OK. RESET button: to GND through 1k, node pulled up by 100k, 100n to GND, into a 74LVC1G14 Schmitt inverter: press gives one rising edge (clear), a held button gives no further edge (L4) | Same part as U3, defined power-on and brown-out threshold, independent of the MCU watchdog. Debounce: press discharges in 0.1 ms (1k x 100n), release recharges in 10 ms (100k x 100n), so contact bounce gives no extra edge | RC into a Schmitt for the power-on reset (no brown-out threshold) | decided (Prins, option 1; RC debounce for RESET). 1N4148W across the 100k added (Prins: good practice, the circuit does not depend on the input load; anode at the node, cathode to 3V3) |
| D-85 | 2026-10-01 | Radio port connector: right-angle shielded PCB mini-DIN 8 at the board edge behind a housing cut-out, shield to CHASSIS. Part: Same Sky MD-80SM (8 contacts, shielded, horizontal, through-hole; MD-SM datasheet rev 1.09, 2024-09-12, filed: rated 100 Vac 1 A / 12 Vdc 2 A, 30 mohm, insulation 50 Mohm at 250 Vdc, withstand 250 Vac 1 min, -40 to 85 °C, 1000 cycles, UL94V-0; shield SPCC tin, earth terminal brass tin; contacts phosphor bronze, silver. The earlier values from the MD series sheet (500 Vac, -20 to 105 °C, 5000 cycles) are superseded); second source Kycon KMDGX-8S-BS (footprint match confirmed, D-100) | No wiring; pin-out fixed by the footprint; shield bonded at the panel | Panel-mount jack with a wired header (three looms, wiring-error risk on the inhibit lines) | decided (Prins, option 1; part chosen by Claude). Footprint: use the layout for date codes after 2022-03-03 (8 x 0.9 mm holes, shield tabs as slots; the older layout has 2 x 2.5 mm holes and does not fit). Voltage factor against the 12 Vdc rating (14.4 / 12 = 1.2): documented exception, see D-87. Footprint: own, D-100. Second source Kycon KMDGX-8S-BS (fully shielded; datasheet 0418 filed): tail positions match D-100 (checked 2026-10-05) |
| D-86 | 2026-10-02 | Keying output on mini-DIN pin 1, selected per port by a solder jumper: BAND D (R1, FT-710 band data) or KEY (R2, R3). All three ports stay one identical sheet. BAND A to D go to the expander from R1 only | One sheet for all ports; stand-alone antenna auto-select from the FT-710 band data keeps working on R1 | Fixed KEY on pin 1 (no band data from R1); separate keying connector per port (extra panel cut-outs and looms) | decided (Prins, option 1) |
| D-87 | 2026-10-02 | MD-80SM voltage factor: documented exception. The 12 Vdc / 2 A figure is a nominal contact rating, not an insulation limit. Leading values: insulation 50 Mohm at 250 Vdc and withstand 250 Vac (14.4 / 250 = 0.06), and the power the contact carries (12 V x 2 A = 24 W against below 14.4 V x 0.1 A = 1.4 W, 0.06). The connector does not make or break current under load | Insulation and contact power are far below the limits; the FT-710 uses the same connector type with 13.8 V on pin 6 | Search for a mini-DIN 8 rated 18 Vdc or more (no known shielded PCB part; time without a likely result) | decided (Prins, option 1) |
| D-88 | 2026-10-02 | Radio port drawing details (Claude, from D-71, D-72, D-78): TX sense mode by two 3-pin jumpers SENSE A (resistor source) and SENSE K (LED cathode), both 1-2 = CONTACT, both 2-3 = VOLTAGE; one 2k2 1206 resistor for both modes (value per radio in VOLTAGE mode). CONTACT feed by a 3-pad solder jumper FEED SEL: radio +13V OUT or interface +13V8. GND BOND solder jumper from radio GND (pin 5) to interface GND, closed on R1 for the band data. Keying gate KEY_ON = KEY AND INH_ON (second 74LVC1G08). BAND inputs: 1k series, 10k pull-up to 3.3 V fitted, 100k pull-down footprint DNP (changed 2026-10-03 after the FC-40 schematic: the radio band/data outputs see 47k pull-ups in the tuner, so open collector is possible; a pull-up serves both output types; no radio reads 1111). Keying OptoMOS CPC1017N as candidate | One 3-pin jumper cannot switch both ends of the opto LED; a 3-pad jumper cannot short the radio supply to the interface supply; the band data needs a common GND | One jumper and a resistor per mode (D-72 wording); pull-ups fitted (an open band input would read high) | proposed (Prins to confirm). CPC1017N datasheet R13 (filed 2026-10-03) is marked 'Not For New Designs': replaced by TLP176AM (D-91); the filed CPC1117N R12 has no such mark, current status to check. PCA9539 5 V tolerance (checked 2026-10-07, NXP Rev 9.1 section 6.5): inputs to 5.5 V (VIH max), 6 V absolute. Open collector band outputs: pin at most 3.3 V, pass. A 5 V push-pull output gives about 5.07 V through 1k with the 10k pull-up: inside 5.5 V, above 0.7 x 6 V = 4.2 V, so then a documented exception or a clamp; the FT-710 output type (A-18) decides. Open: ESD protection on the DIN lines; FT-710 band output type (TTL or open collector, A-15) |
| D-89 | 2026-10-03 | Radio port ESD and RF protection: per mini-DIN line (pins 1, 2, 3, 4, 6, 7, 8) a bidirectional TVS 15 V SOD-323 (Nexperia PESD15VL1BA, to confirm; second source Bourns CDSOD323-T15C, to confirm) and 1 nF C0G 50 V to the radio GND, at the connector; radio GND to CHASSIS by 10 nF 1 kV X7R 1206 (fitted). Radio GND drawn as a local power symbol RGND (one net per sheet instance) | The port floats, so the ESD current must find a path to the shield without crossing the board; the clamps work between the lines and the radio GND, the 10 nF takes the common-mode charge to CHASSIS; 1 nF also filters RF near the transmitter (skill section 16; FC-40 uses 270R, 100 uH and 1 nF per line); VRWM 15 V against 14.4 V lines | Clamps to interface GND (breaks the floating port); TVS array (fewer parts, but one more package type and no 15 V bidirectional array in the library yet) | decided (Prins: add ESD protection). Datasheets filed 2026-10-04: PESD15VL1BA VRWM 15 V, VBR min 17.1 V, VCL 25 V at 1 A, 30 kV contact (IEC 61000-4-2 level 4, above R-12); CDSOD323-T15C VWM 15 V, VBR min 16.7 V, VC 24 V at 1 A, 30 kV: drop-in on one SOD-323 footprint. Closed: datasheets filed (review S-17, 2026-11-02) |
| D-90 | 2026-10-03 | TX INH HIGH level: radio +13V OUT (pin 6) through RH 2k2 (0603) to a node clamped by a 5.1 V zener (Nexperia BZX384-C5V1, SOD-323; second source onsemi MM3Z5V1T1G; datasheets filed 2026-10-04, Ptot 300 mW both) to the radio GND; INH LEVEL 1-2 switches this node onto TX INH through the form B contact | The FC-40 drives TX INH from 5 V logic (A-18); 13.8 V on that input could damage the radio; the port stays floating; pin 6 load about 4.2 mA plus FEED 6 mA, about 10 mA against about 80 mA (A-17): 0.13. RH 39 mW of 100 mW (0.39); zener 21 mW of 252 mW at 45 C (0.08) | HIGH from the interface +5V (needs the GND bond, the port no longer floats, adds a path from the interface supply into the radio) | decided (Prins, option 1). RH not fitted on ports that use the LOW level. Bench test A-15/A-18 with the clamped level |
| D-91 | 2026-10-04 | Keying photorelay (decision 24): Toshiba TLP176AM (1-form-A, 60 V, 0.7 A, RON max 2 ohm, IFT max 3 mA, 3750 Vrms, -40 to 110 C, halogen-free), second source Panasonic AQY212G3HS (60 V, 1.8 A, 0.15 ohm, IFon max 3 mA, 3750 Vrms, -40 to 105 C). Replaces the CPC1017N candidate (D-88). One long-pad footprint for U3 and U4 covering lead spans 6.1 to 7.0 mm (CPC1117N, TLP4176G, TLP176AM, AQY212G3HS), pitch 2.54 mm; symbol pins follow the SOP4 positions (TLP176AM pins 1, 3, 4, 6 = positions 1, 2, 3, 4) | Active parts in mass production; halogen-free per datasheet (halogen policy); same maker as the TX INH second source; 14.4 / 60 = 0.24; IF 7 mA inside the recommended range of both (5 to 25 / 5 to 30 mA); RON is irrelevant for a PTT input of a few mA | AQY212G3HS as the main part (lower RON and higher current not needed; halogen status not stated); CPC1017N (not for new designs); TLP172A (not recommended for new design) | decided (Prins, option 1). Common footprint drawn: D-99 |
| D-92 | 2026-10-04 | Schematic drawing rule for the shack interface: every hierarchical label sits at the sheet edge on the same side as its pin on the block of the root sheet. To route the MCU sheet without crossings, the PCA9539 pins are regrouped (replaces the D-83 expander map, to be drawn with the MCU sheet): first the pins that leave on one edge, then the next edge, then the port group | Prins found the link sheet drawn the other way round from its block (cable left on the root, right inside); a block and its sheet must read the same way | Keep the D-83 map and let the MCU sheet be an exception to the rule | decided (Prins, option 1; redraw sheet by sheet). Firmware: pin directions per bit, F1 unchanged. Map as drawn 2026-10-04 (M-22): IO0_0 SW_STOP_N (out), IO0_1 R1_TX, IO0_2 KEY_R1 (out), IO0_3 BAND_D, IO0_4 BAND_A, IO0_5 BAND_B, IO0_6 BAND_C, IO0_7 LED_R1 (out), IO1_0 KEY_R2 (out), IO1_1 R2_TX, IO1_2 LED_R2 (out), IO1_3 KEY_R3 (out), IO1_4 R3_TX, IO1_5 LED_R3 (out), IO1_6 KILL_S, IO1_7 LATCHED (unmarked = input). U5 drawn mirrored (I/O on the left): IO0_0..1 to the left edge, IO0_2..IO1_5 to the bottom edge in the root order, IO1_6..7 under the chip to the right edge. The order differs from the D-92 proposal (KILL_S and LATCHED last, not on IO0_2..3): a right-edge group at the top would cross the RESET_N wire |
| D-93 | 2026-10-04 | DevKit drawn as one board symbol A1 "ESP32-C3-DevKit-RUST" (project library), laid out as the physical board, with the pad numbers of the esp-rs Rust_Board symbol and footprint (github.com/esp-rs/esp-rust-board): left header pads 1..16 top to bottom (RST, 3V3, NC, GND, IO0..IO7, IO8/SCL, IO21/TXD, IO20/RXD, IO9/BOOT), right header pads 28..17 top to bottom (VBAT, EN, VBUS, NC x5, IO18/D-, IO19/D+, IO8/SCL, IO10/SDA), pad 28 level with pad 5; pads 29, 30 (battery connector) not on the headers. Module at the top, USB-C at the bottom. Footprint: own, see D-95 (the esp-rs Rust_Board_Shield is kept for reference in hardware/shack-interface/lib/esp-rust-board, CERN-OHL). A short wire and a local net label at each used DevKit pin; the same label at the other end. Exception to the wires-only rule, limited to the DevKit. Replaces J4 and J5 | Reads like the real board, helps debugging (Prins); with the fixed DevKit pin order, wires cannot run without crossings; one pad numbering with the maker's footprint | Wires to every DevKit pin (crossings); two connector symbols; RUST-2 user guide table as the layout source (general Espressif dev-kit document, Prins) | decided (Prins, decision 27; layout corrected twice on 2026-10-04 after Prins's remarks). Board in use: DevKit-RUST-1 Rev 1.2a (A-19). |
| D-94 | 2026-10-04 | SDA select solder jumper JP61 (3 pads) between the PCA9539 SDA and the DevKit: 2-3 = pad 17 IO10 (DevKit-RUST-1, fitted), 2-1 = pad 12 IO7 (DevKit-RUST-2). SCL on pad 13 (IO8 on both boards). Firmware sets the SDA GPIO (10 or 7) to match the jumper. Same change needed on the box controller board (D-55) | The two board revisions differ only in the SDA position (RUST-1 SDA GPIO10, LED GPIO7; RUST-2 SDA GPIO7, LED GPIO10); EN, D-/D+ and all other used pads match; a spare of either revision fits | DevKit-RUST-1 only (a RUST-2 spare would not work; the RUST-2 is the current Espressif product) | decided (Prins, option 1). A wrong jumper on a RUST-1 puts SDA on the LED pin (470R and LED to GND): I2C fails, nothing is damaged. Drawn on both boards 2026-10-04: shack interface JP61, box controller board JP11 (M-23) |
| D-95 | 2026-10-04 | DevKit mounting and footprint, shack interface board and box controller board: gold-flash female socket headers soldered to the board, the DevKit (male pin headers) pushed in. Sullins PPPC161LFBN-RC (1x16) and PPPC121LFBN-RC (1x12; the DevKit right header has 12 pins, the battery pads have none, Prins): polyester (PBT) body, phosphor bronze, gold flash, 8.50 mm high, insertion depth 6.00 mm, 3 A, recommended hole 1.02 mm (Sullins Female Headers .100 datasheet, filed). Own footprint ESP32-C3-DevKit-RUST_Socket, made by hardware/shack-interface/lib/gen_devkit_fp.py; one file, copied unchanged to both projects (shack-interface/lib/shack-interface.pretty, unit/controller-board/lib/controller-board.pretty). Geometry of the esp-rs and SnapEDA footprints (they agree: rows 20.32 mm, right pad 28 level with left pad 5); pad numbers as esp-rs and A1 (1..16, 28..17); pad 1.7 mm, drill 1.0 mm, pad 1 rounded square; no standoff holes (Prins); courtyard includes the USB-C overhang (1.76 mm). Stack (Prins, measured): male header body 2.54 mm, pin 6.01 mm below the body against 6.00 mm insertion depth, so DevKit PCB underside 11.05 mm above the board. 3D: KiCad PinSocket 1x16 and 1x12 models, SnapEDA STEP of the board (rotate X -90, offset Z 11.05 mm); positions checked by a STEP export of a test board (shack-interface/lib/test-3d) | Prins: sockets on the board, gold to match the DevKit pins, same on both modules; 0.762 mm drill of both source footprints is too small for 0.64 mm square pins and the 1.27 mm SnapEDA pads leave a 0.25 mm ring | SnapEDA footprint as is; esp-rs Rust_Board_Shield (0.762 mm drill, no 3D model of the board); tin sockets PPTC (tin against a gold pin) | decided (Prins) |
| D-96 | 2026-10-04 | Shack interface: own USB-C receptacle J14 (GCT USB4105-GF-A, KiCad footprint USB_C_Receptacle_GCT_USB4105-xx-A_16P_TopMnt_Horizontal with its 3D model) at the PCB edge and housing wall, on the root sheet between the MCU and SAFE blocks. D+ (A6, B6) and D- (A7, B7) to the DevKit pads 19 (IO19) and 20 (IO18), in parallel with the DevKit's own USB-C (short stub, full speed 12 Mbit/s). ESD array U61 USBLC6-2SC6 (pins as the KiCad symbol: 1, 6 I/O1; 3, 4 I/O2; 2 GND; 5 VBUS) flow-through on D+ and D-, VBUS pin on the connector VBUS with C64 100 nF. CC1, CC2: Rd 5.1 kohm to GND (R64, R65). VBUS not connected to the DevKit (pad 26 stays open, board buck stays off, D-55). GND contacts to GND; shell (SH) to CHASSIS. SBU not connected. MCU block right edge: USB_DP, USB_DN, USB_VBUS, USB_CC1, USB_CC2 above FAULT (D-92 order) | The DevKit USB-C is flush with its PCB and cannot reach through the wall (Prins); an own connector gives free DevKit placement, a defined cut-out and separate GND and shell | DevKit USB-C at the wall (R-13: plug engagement and shell contact problems) | decided (Prins). Only one of the two USB-C connectors may be used at a time (both are on D+ and D-). With the host off, the ESP32-C3 keeps its D+ pull-up on (behind the Delock isolator, low risk). Datasheets filed 2026-10-04: ST USBLC6-2 (DS4260 Rev 7) confirms the pin-out and 1/6, 3/4 as one I/O line each; second source UMW USBLC6-2SC6 (same pin-out); GCT USB4105 spec Rev A3. Underload C-26 (VBUS against the TVS stand-off: documented exception as D-45). Second source: Same Sky UJ20-C-H-G-SMT-1-P16-TR (Prins, 2026-10-05; datasheet filed): same land pattern as the GCT USB4105 within 0.01 mm (pads, pitch, pegs, both slot pairs), 48 V, 5 A, -25 to 85 C, 10,000 cycles: drop-in on the J14 footprint. The other candidates are dropped: GCT USB4215-03-A (same maker; rear legs 0.18 mm off, no pegs) and Amphenol FCI 10164359-00011LF (no drawing). Shell legs 0.96 mm long: no through-hole fillet on the 1.6 mm board (top-side fill only; check the GCT leg length and the joint strength at the first assembly). Open; panel label. Cut-out (2026-10-07): the GCT spec gives no panel cut-out; proposal a slot of about 13.0 x 7.0 mm (USB-C plug overmold up to 12.35 x 6.5 mm), receptacle front close to the outer wall face; to draw with the housing choice and check on a sample |
| D-97 | 2026-10-05 | Shack interface drawing (D-92, SAFE and root steps): accept the crossings that the block pin order makes necessary. Root: R1_TX crosses the PERMIT, KEY and BAND_D fan-out wires to R1 (3). SAFE sheet: SAFE_LOST crosses FAULT and LATCHED (2). No junction at a crossing. TX_EN stays on the right edge of the SAFE block | With the present pin orders a drawing without crossings is not possible: R1_TX enters the port between BAND_D and BAND_A; in the SAFE sheet the TX_EN and LED_SAFE pins on the right edge split the Q net from the SAFE_LOST chain. TX_EN on the bottom edge would cross the R3 fan-out | Zero crossings by a new port row order (TX row at the bottom), LATCHED above FAULT on the MCU block and KEY/TX bit swaps for R2, R3: rejected, the port and MCU sheets and the expander map would change again for a drawing benefit only | decided (Prins, option 1). The SAFE estimate was 1 crossing; a planarity check gives 2 as the minimum |
| D-98 | 2026-10-05 | Box case outer depth 66 mm (was 60): inner height 58 mm. Walls, floor, lid, SO-239 positions and the RF board stay as they are | C-27: with 60 mm the DevKit on its sockets (D-95) leaves about 0.15 mm under the lid | Low-profile open-bottom sockets (about 3 mm body, DevKit pins through the board) with 60 mm: rejected, D-95 would change again for a less standard part | decided (Prins, option 1). Case drawing: unit-case-sketch.svg |
| D-99 | 2026-10-05 | Common photorelay footprint SOP-4_P2.54mm_PhotoRelay_LongPad (project library, generator lib/gen_photorelay_fp.py) for U3 (TX INH: CPC1117N, TLP4176G) and U4 (keying: TLP176AM, AQY212G3HS) on all three radio ports. Pads 2.10 x 0.80 mm, roundrect, from 1.90 to 4.00 mm off the centre line, pitch 2.54; positions as KiCad SOP-4. 3D: SamacSys TLP4176G STEP at rotate z +90. Replaces Package_SO:SOP-4_3.8x4.1mm_P2.54mm | One land covers all four parts (C-28): inner edge from the CPC1117N land (3.85 gap), outer edge 0.25 mm past the Toshiba land for the iron (hand assembly). Pad width 0.8 as Toshiba and Panasonic; 1.74 mm between pads | Two footprints or a stacked alternative land: rejected, one land fits all parts. SamacSys footprints as they are: each fits only its own part; the SamacSys TLP4176G model rotation (-90) put the pin 1 dimple at pin 3 in a KiCad STL export | decided (Claude, under D-77 and D-91 'to draw'); pads under the body accepted by Prins ('soldering will be fine', 2026-10-05). Halogen: not stated by the makers, marked only (Prins, 2026-10-05; D-42) |
| D-100 | 2026-10-05 | MD-80SM footprint MiniDIN-8_SameSky_MD-80SM_Horizontal (project library, generator lib/gen_minidin_fp.py) for J11 to J13: MD-SM rev 1.09 layout for date codes after 2022-03-03. Rows 8.5 (pins 5, 2, 1, 3) and 11.0 (8, 7, 4, 6) from the board edge; columns -3.4, -1.3, +1.3, +3.4 (pin 7 at -0.9); drill 1.0, pad 1.6 (pin 1 rounded square); earth terminal slot 2.3 x 0.8 at 4.7; shield tab slots 0.8 x 2.2 at +-6.75, 5.5; all shield pads = pad 9 (CHASSIS). Front face flush with the board edge. 3D: SamacSys STEP, offset X -7.0, rotate X -90 | Datasheet layout for the current date codes. Drill at the top of its +0.1 tolerance: the SamacSys STEP has the outer columns 6.5 apart (datasheet 6.8); a 1.0 hole takes both with a 0.42 mm tail | SamacSys MD80SM footprint: fits neither Same Sky layout (2.5 mm rows with 1.0 holes and three 2.3 mm round shield holes); prior layout (2 x 2.5 holes): wrong date codes | decided (Claude, under D-85). Kycon KMDGX-8S-BS (datasheet 0418) has the same tail positions: rows 8.5 (5, 2, 1, 3) and 11.0 (8, 7, 4, 6), columns 2.6 and 6.8, pin 7 0.9 off the centre line, earth legs at 4.7, shield tabs 13.5 apart at 5.5; Kycon gives no hole sizes. To confirm on the first parts: outer column distance 6.5 or 6.8; shield tab size (0.45 x 1.7 from the Same Sky STEP; Kycon tab about 1.6 long from the drawing); Kycon tail section |
| D-101 | 2026-10-05 | Box READY switch (D-62): Toshiba TLP176AM photorelay U6 (form A, 60 V, 0.7 A, RON max 2 ohm, IFT max 3 mA, 3750 Vrms; second source Panasonic AQY212G3HS) in series with the SAFE loop between the U3 LED and R32, on the common footprint (D-99). LED from U15 74LVC1G02 READY_ON = NOR(MCU_EN_N, FAULT) through R35 240R (about 7 mA, as C-22). Replaces the PC817 + BSS138 of D-62 | Loop current 8.75 to 12.5 mA (C-24): a PC817 needs IF of about 25 to 50 mA to stay saturated over CTR spread and ageing; the photorelay has no CTR, drops about 25 mV against 0.2 V (more headroom, C-21), and is already in the BOM | PC817 with BSS138 from +5V (CTR-dependent saturation, higher drive current, one more part type) | decided (Prins, option 1). Drawn in gen_controller_sch.py c5-ready (M-30) |
| D-102 | 2026-10-06 | RF board supports: six M3 standoffs (13 mm, non-plated holes, not on GND) at the free spots of the placement study, plus the seven M3 screws to the milled GND bosses at the SO-239 (the defined RF bond, D-18). Board coordinates (mm, from the top left): S1 (5, 5), S2 (149, 5) between XT60 AUX and XT30, S3 (263, 5), S4 (46, 116.5) between the EXP RX R2 relay and the K0 R2 NC line, S5 (99, 116.5) in the channel between the feed bands and the A1 relays, S6 (263, 116.5) right of the A4 column; bosses at y 225, 14 mm beside each SO-239. Keep-out 8 mm diameter around each standoff (washer 7 mm). The case M5 holes at the top move to case x 30 and 258 (15 mm from S1, S3) | Prins asked for a 3 x 3 grid. A true 3 x 3 needs a support near the board centre (x 134, y 115), and the relay field has no free spot there: between two relay cells and their RF bands there is 1.5 to 2 mm. The free spots give about 90 % of the 3 x 3 stiffness (C-29: 135 against 151 Hz) without a board or case change. The largest free panel (164 x 112 mm, x 99 to 263) is the relay crossbar itself | True 3 x 3 with 10 mm gap rows between the radio blocks (board and case about 20 mm taller, columns 20 mm longer, C-29 gives only 138 to 151 Hz); 4 corners only (C-29: 38 Hz, under the relay mass) | decided (Claude, under Prins's 3 x 3 choice: a true 3 x 3 does not fit). To check at the layout: S5 has 0.5 mm between its keep-out and the band edges (fence vias); S2 and S4 positions against the logic and coil-driver parts; holes plated on CHASSIS with bond options since D-132 |
| D-103 | 2026-10-06 | SR-01, hazard H1 (a TX relay closes on a receive-only column): on every receive-only antenna column the TX relays and their coil drivers are not fitted. Unit 1: A2 (RX loop), so K103, K203, K303 with Q, D and R 103, 203, 303 are DNP; footprints stay on the board. Generator gen_rfboard_sch.py v10i (RX_ONLY = {"2"}). Silkscreen at the column: "A2 RX ONLY: TX relays not fitted". The firmware keeps a column table (TX or RX only) that matches the fitted relays | No contact exists between a TX row and A2, so no firmware or driver fault can connect them. The open-contact capacitance of three relays leaves the A2 path (only the crossing coupling of C-04 stays). No new parts; 3 relays and their drivers less | Coil-supply link per column (+12V_TXk through LK1 to LK4, read-back to U1001): reversible without parts, but the open TX contacts stay in the A2 path (isolation not measured, M-01) and a closed link brings back the firmware-only state | decided (Prins, option 1). H2 (K0 does not transfer while its RX row is on A2): open, next decision. A wrong firmware column table sends TX into an open row (radio sees a high SWR); not a hazard for A2. H2 closed by D-104 (review S-17, 2026-11-02) |
| D-104 | 2026-10-06 | SR-01, hazard H2 (K0 does not transfer while its RX row is on A2): RF on the receive-only column A2 opens the SAFE loop in hardware. The A2 detector output (RF board net A2_RFDET, LM2901 open collector, 10k pull-up, low = RF, D-47) goes to J14 / J2 pin 17 (was spare). On the controller link sheet U16 74LVC1G08 drives the READY LED: READY = NOR(MCU_EN_N, FAULT) AND RF_A2_N; R36 100k pull-down, so J2 open or no RF board = READY open. RF on A2: no loop current, box KILL = 1 drops RLY_EN (all relays release, K1-A2 parks the loop, A2 RX relays open; about 7 ms, M-10), and the shack SAFE latch inhibits all radios until RESET | Detects the effect, so it covers every cause: K0 coil, driver or contact, a broken PTT pair 2, an R2/R3 firmware error. Uses parts and paths that exist; no timing assumption on the radio inhibit | K0 confirmation before RF (coil-current sense per K0, loop-2 sense at the shack, TX INH within the 20 ms TX delay): more parts, depends on M-12, does not cover a stuck contact or a firmware error | decided (Prins, option 1). RF reaches A2 for about 7 ms before the relays open (threshold about 0.5 W, C-15): the loop survives, the preamp is at risk. Option 2 stays possible after M-12. Unit 2: its J14 pin 17 is not connected to the unit 1 controller (EXP header, D-53): to add with the unit 2 work. Detector false trips from antenna coupling: A-20 |
| D-105 | 2026-10-06 | SO-239 strap land, project footprints SO239_83-798_StrapPad_BossRight (J1 to J9) and _BossLeft (J10, A4), generator hardware/unit/rf-board/gen_so239_fp.py. Origin: connector axis on the board edge. Pad 1: strap land 3.5 x 4.0 mm on F.Cu and B.Cu, 0.5 mm from the edge, joined by 3 vias (drill 0.8, pad 1.2) at the inner end; pad clearance 2.0 mm (RF gap, D-12). Pad 2: plated M3 hole (drill 3.2, pad 6.0) 14 mm beside the axis, 5 mm from the edge, to the milled GND boss (D-102), solid zone connection. No 3D model (the connector is in the case wall) | The strap (3 x 0.3 mm) from the cup lands on the top pad (cup centre about 1.5 mm above the top surface, D-15); a land on both layers lets the column or feed arrive on L1 or L2 without an extra via; the vias at the inner end keep solder out of them. The GND hole carries the RF return (2.45 A rms, C-01), so a solid connection (hardware rules section 6) | One-layer land with layout vias (the layer change then depends on the layout); thermal spokes on the GND hole (adds inductance in the RF return) | decided (Claude, under D-10, D-15, D-18, D-102). To check at the first parts: strap length and cup height against the land (A-05, M-03) |
| D-106 | 2026-10-07 | TX INH photorelay (U203, U303, U403): Toshiba TLP4176G as the main part (1-form-B, 350 V, 120 mA, RON max 25 ohm, IFT max 3 mA, 1500 Vrms), Panasonic AQY412S as the second source (1-form-B, 60 V, 0.5 A, RON max 2.5 ohm, IFoff max 3 mA, 1500 V AC, -40 to 85 C; ASCTB140E). Both on the common footprint (D-99). Replaces CPC1117N (D-77) | Littelfuse PDN EIC-1177 (2026-08-13) ends the whole OptoMOS PCB SSR family, CPC1117N included (last-time buy 2026-11-11). Both new parts are in production; LED drive 7 mA (C-22) covers both 3 mA maxima; 14.4 / 60 = 0.24 | Last-time buy of CPC1117N with TLP4176G as second source (a part at end of life in a new design, against R-10) | decided (Prins, option 1). AQY412S checked on ASCTB140E 202601 (filed 2026-10-07): lead span 6.8 +-0.4, terminal 0.4 x 0.5, pin 1 = LED anode: fits the common land (C-28) |
| D-107 | 2026-10-10 | Halogen policy (hardware-design-rules section 2, DR-02) applies to this design. Supersedes D-42. The datasheet register records the halogen status of each part from the maker's material declaration; with no declaration the status is 'unknown' and flagged. PCB laminate: halogen-free FR-4 at JLCPCB, if it combines with the chosen stackup | Standard design rules; removes the conflict between DR-02 and D-42 | Policy not applied (D-42): less check work, but against the standard rules and DR-02 | decided (Prins, option 1). Open: halogen status of the parts marked 'not stated' or 'unknown' under D-42; halogen-free laminate with the RF board stackup in the JLCPCB quote form. Halogen point closed by D-150 (review S-17, 2026-11-02) |
| D-108 | 2026-10-10 | EXP SMA J4 to J6: bulkhead SMA jack with a 4-hole flange in the 6 mm left wall, solder-cup rear, joined to a strap land at the board edge as the SO-239 (D-105). Candidates: Amphenol RF 132142 and 901-9215 (4-hole flange, solder cup, 50 ohm); part choice after the drawings are filed | Same method as the SO-239: no extra connectors or cable in the RF path at 100 W and 173 V peak; the board edge is already 4 mm from the inner left wall (288 - 2 x 6 - 268 = 8 mm, 4 mm per side) | SMA on the board edge with an RG142 jumper to a bulkhead SMA (two more connectors and a cable assembly per radio) | decided (Prins, option 1). Open: part and rear length (A-21); footprint after the drawing |
| D-109 | 2026-10-19 | Column link R402, R502, R602, R702: THT wire link, tinned copper wire about 0.8 mm in two plated holes (project footprint, pitch and pads at the layout). DC block C401, C501, C601, C701 (not fitted): 1812 footprint in parallel with the link. GDT GD401 to GD701 (not fitted): THT footprint; bias choke L402 to L702 (not fitted): 1210 | The link carries the full column current (2.45 A rms, C-01); a 0.8 mm wire carries it with a large margin, is easy to solder by hand and has many sources | SMD 0R jumper 2512 (jumper ratings of most makers about 2 to 3 A: 2.45 A probably fails the 0.7 factor) | decided (Prins, option 1) |
| D-110 | 2026-10-19 | EXP SMA mounting: pocket 13 x 13 x 2 mm milled from the outside at each SMA, wall 4 mm there; flange in the pocket, 4 x M2 tapped into the wall; axis about 1.5 mm above the board top surface (as the SO-239 cup, D-15). Part: Amphenol RF 901-9215 (stainless body, gold, PTFE, -65 to +165 C), second source 132142 (brass body, same outline). Footprint SMA_901-9215_StrapPad (gen_rf_fp.py): strap land as D-105, plated M3 hole to a milled GND boss 9 mm beside the axis, 3 mm from the edge | Both parts have only the contact (5.07 mm) behind the flange; with a 4 mm wall it ends about 1.1 mm past the inner wall, about 2.9 mm from the board edge, so the strap is about 3.5 to 4 mm (limit 6 mm, D-15). The full thread stays outside for the plug. The GND boss carries the RF return next to the jack (as D-102, D-105) | A part with a longer rear for thick panels (none found with a drawing and a second source) | decided (Prins, option 1; part and footprint: Claude). To confirm: rear length on a real part (A-21); GND boss position against the EXP relays at placement |
| D-111 | 2026-10-19 | Layout corrections from the first DRC (p1): (a) strap-land vias in the SO-239 and SMA footprints drill 0.6 mm, pad 1.0, pitch 1.2 (was 0.8 / 1.2 / 1.0: hole gap 0.2 mm); (b) SMA GND hole 4 mm from the edge (was 3: pad on the edge); (c) EXP relays at x 8 (was 6: courtyard on the SMA land); (d) detector tap C404 to C704 and bias choke L402 to L702 in 1812 (pad gap about 2.7 mm), because the pads of a 1206 or 1210 are about 1.8 mm apart, below the 2.0 mm RF gap (D-12) and the PD3 creepage (about 1.9 mm, C-05). RF board schematic v10m | Found by DRC with the RF netclass (clearance 2.0 mm) on the pads of these parts: the tap sees about 158 V peak, the choke the full column voltage | Keep 1206 / 1210 with a slot under the part (milled slot, more cost, still close to the limit) | decided (Claude, under D-12, D-105, D-110). To confirm: a 4.7 pF 1 kV C0G part in 1812 (A-22) |
| D-112 | 2026-10-19 | Coil drivers (BSS138BK, 100k gate pull-down, 1N4148W clamp) of all 37 relays in the logic zone of the RF board, one cell above the relay column of its relay (y 23 to 37 mm); only the coil lines run to the relays. Replaces 'next to its relay' in rf-board.md | The coil lines are DC and low impedance, so RF pick-up where they cross the RF rows does no harm; the gate lines (100k, VGS(th) min 0.48 V) stay short and away from the RF bands | Drivers on the bottom side under each relay (short coil loop, but the high-impedance gate lines cross the RF bands at 100 W) | decided (Prins, option 1) |
| D-113 | 2026-10-19 | RF board corners: radius 5 mm. The milled case pocket may have an inner corner radius up to about 15 mm (0.5 mm play kept, gaps 4 / 3 / 5 mm to the walls) | Square corners need a pocket corner radius below the wall gap (3 to 5 mm), which needs a small, long cutter for the 58 mm deep pocket. S1 and S3 stay at 5 mm from the edges | Square board corners | decided (Prins: radius on the board corner; radius value: Claude, own check of the corner geometry) |
| D-114 | 2026-10-19 | No GDT footprint at the antenna ports: GD401 to GD701 removed from the RF board (supersedes the DNP footprint of D-07). The bleed R401 to R701 sits right of the column at c + 9.8 mm on all four ports | The CS-400R at the RVS box entry takes the surge (D-07, D-09); a GDT on the board would take surge current through K1, the board and the case (D-32). At A4 the board edge is 15 mm from the column, so a GDT and the bleed did not both fit, and GD701 sat in the edge band | Keep the option with a small SMD GDT footprint (no part with a datasheet found; A4 still tight) | decided (Prins, option 1) |
| D-115 | 2026-10-19 | (Layer use of L3/L4 superseded by D-156.) RF board stackup JLC06161H-7628A, 6-layer 1.6 mm, 1 oz outer, 0.5 oz inner. Layer use: L1 (F.Cu) rows and GND pour; L2 GND (reference for L1); L3 coil lines, logic and supply rails; L4 GND; L5 GND (reference for L6); L6 (B.Cu) columns, radio feeds and GND pour. The THT relay pins still make the layer change. Supersedes D-11 | Prins asked for more ground planes (Hans Rosenberg rules, hardware-design-rules section 8): every RF line on its own adjacent GND plane, row/column crossings shielded by L2, L4 and L5, a solid plane under the logic zone and short ground vias. Outer prepreg 0.5124 mm allows a 50 Ω line that carries 2.45 A rms (C-30, C-31) | JLC 4-layer (Prins asked first): the thickest JLC 4-layer outer prepreg is 0.2104 mm (7628), so a 50 Ω line next to the plane is about 0.46 mm wide and rises about 48 °C at DC (C-31); 4-layer with the inner GND voided under the RF bands (W 2.4 mm): crossings stay unshielded, small RF gain; 2-layer JLC0216A (D-11) | decided (Prins, 2026-10-19) |
| D-116 | 2026-10-19 | RF line on L1 and L6: coplanar with GND below, W 0.975 mm, gap 2.0 mm (50 Ω, JLC calculator, C-30). Gap unchanged (D-12). Via fence centre 3.05 mm from the trace centre, pitch 2.54 mm; RF band about 7.1 mm (C-33). Supersedes D-13 | C-30: the JLC calculator is the fab's own model for this stackup; D-12 keeps the PD3 creepage gap on the outer layers | W 1.08 mm (own conformal mapping, about 10 % wider than JLC); W 1.04 mm with gap 1.25 mm (gap below D-12) | decided |
| D-117 | 2026-10-19 | Inner GND planes (L2, L4, L5): antipad 0.5 mm around every pad and via of an RF net; no inner copper of another net within 0.5 mm of an RF hole | Inside the laminate the IPC-2221 B1 value applies (0.2 mm up to 300 V); 0.5 mm adds margin for the 173 V peak and the drill tolerance | 2.0 mm as on the outer layers (not needed for solid insulation; larger holes in the reference plane) | decided (Claude, to review) |
| D-118 | 2026-10-19 | Halogen policy (D-107) set aside for the RF board laminate: standard FR-4 in the JLC06161H-7628A stackup (JLC offers no halogen-free material for 6 layers). Closes the conflict in A-23 | Prins: halogen is not a problem for this board (private, non-commercial build, as D-42) | Ask JLC for halogen-free 7628A (not needed) | decided (Prins, 2026-10-19); to review under D-135 (the 'private build' reason no longer applies). Halogen point closed by D-150 (review S-17, 2026-11-02) |
| D-119 | 2026-10-19 | RF board return paths and pour (hardware-design-rules v2.2, pcb-layout.md): (1) every RF layer change L1 to L6 (relay pins, column links, SO-239 and SMA lands) gets 2 to 4 GND vias through all layers within about 1 mm of the signal via or pin; (2) GND pour on L1, L3 and L6 tied to GND, stitched on a 5 mm grid (λ/10 at 300 MHz in FR-4 is about 48 mm); (3) GND via fence and GND strip around the board edge on all layers, no 20H pullback; (4) no floating copper; fab note "no copper to be added without approval" | Hartley: a change between two different ground planes (L2 to L5) needs a return via next to the signal; floating copper collects field energy. Review RF-01, RF-06 | One return via per change (rule asks up to four for RF) | decided (skill rule); to draw in layout p2. Drawn in layout p2 (M-71 to M-79) (review S-17, 2026-11-02) |
| D-120 | 2026-10-19 | Test access on all three boards (drawn 2026-10-19). RF board: TP1 to TP5 on +12V_RLY, +12V_AUX, +5V, +12V_SW, +3V3; TP1201 to TP1205, TP1209 on SCL, SDA, EXP_INT, RLY_EN, TX_ANY, A2_RFDET; R4 0R link after the +3V3 LDO. Controller: TP1 +5V, TP2 +3V3, TP3 FAULT, TP4 RF_A2_N; R65 0R link after U11; loop current = voltage across the 47R MELF. Shack interface: TP1 to TP3 on +13V8, +5V, +3V3, one TP per mini-DIN signal line (21); R5, R6 0R links after the 7805 and the LD1117. The input fuses serve as the current links of the fused rails. A via in an open GND area serves as GND test point | bring-up-and-measurement.md (test access, current per rail). Review RF-04, CT-09, SI-10 | Test pads only (no current measurement without cutting a track) | decided (skill rule); drawn (M-42, M-44, M-45) |
| D-121 | 2026-10-19 | Unused PCA9539 IO (14 pins: U901, U902, U903 IO1_6 and IO1_7; U1001 IO1_0 to IO1_7): 10 kΩ to GND in 4-element arrays RN901 to RN903, RN1001, RN1002 (Bourns CAY16-103J4LF, convex 4x0603; second source Yageo YC164-JR-0710KL; CAT16 is concave, fixed by M-122) | RLY_EN drives RESET, so after every reset all IO are inputs again; a firmware rule cannot hold them. NXP DS Rev 9.1 section 8.1: IDD rises when an input sits between the rails. Review RF-02. Logic verification F8 closed | Tie the pins to GND direct (no parts; an output set high by a firmware error then drives into GND) | decided (Prins, 2026-10-19); drawn (M-42) |
| D-122 | 2026-10-19 | Filter at the board crossings. RF board: new sheet "J14 filter": each slow line (SCL, SDA, EXP_INT, RLY_EN, TX_ANY, R1 to R3_K0_DRV, A2_RFDET) passes a series link R1201 to R1209 (0R fitted) with a C footprint to GND on the logic side, C1201 to C1209 (DNP, 100 pF C0G max), placed at J14. Controller EXP ribbon: the same RC at the controller end when the EXP header is drawn (unit 2, postponed) | environment-and-protection.md: every conductor that crosses a shield or zone boundary is filtered at the crossing; J14 enters next to the 100 W RF field. I2C check: 2.2 kΩ with 100 pF gives about 190 ns rise, below the 1000 ns of standard mode. Review RF-09, CT-06 | Fit the RC now (values not yet known; footprints let the bench decide) | decided; RF board drawn (M-42); EXP header open |
| D-123 | 2026-10-19 | Controller: watchdog link R64 (0R) between the WDI net (GPIO1, R61 1k pull-down) and U12 WDI, fitted in use. Open on the bench: U12 WDI floats, so the watchdog is off (TPS3823 SLVS165O 7.3.4); the supply supervisor and the fault latch stay active. No link in RESET_N | Schematic review checklist: the watchdog can be disconnected on prototypes. A RESET_N link would either hold the latch in FAULT (no bring-up) or remove the brown-out protection; the WDI link removes only the watchdog. Review CT-07. Replaces the first text of this line (links in WDI and RESET_N) | Links in WDI and RESET_N with a pull on the latch input | decided; drawn (M-44) |
| D-124 | 2026-10-19 | Documented exceptions, shack interface: SMBJ16A on +13V8 (15 V max / 16 V VRWM = 0.94); PESD15VL1BA on the 14.4 V radio lines (0.96); L7805 capacitors 330 nF in and 100 nF out kept as in the ST datasheet (mixed values on the 5 V input and output nodes) | A TVS stand-off must sit just above the highest rail to clamp low; the voltage factor applies to the clamp, not to VRWM. The 7805 values are the datasheet stability condition. Review SI-01, SI-04, SI-09 | SMBJ18A / PESD18 (higher clamp, less protection) | decided (exceptions recorded) |
| D-125 | 2026-10-19 | Title block C4 of the controller board and shack interface: the dead default string (RF board stackup text) removed from the generators; the sheets already show "Stackup and size: to decide with the layout" (a later assignment overrides it) | Review CT-01, SI-07: the copied RF board text was in the source only, not on the sheets | none | done (no sheet change) |
| D-126 | 2026-10-19 | I/O expanders U901 to U903, U1001 (RF board) and U5 (shack interface): order code TI PCA9539DWR (SOIC-24W, same footprint and pin-out). NXP PCA9539D,118 is obsolete (DigiKey NL 2026-10-19, broker stock only). SOIC-24W now has one maker: documented single-source exception; fallback TSSOP-24 with NXP PCA9539PW and TI TCA9539PWR (footprint change) | DigiKey substitutes: TI PCA9539DWR listed as Direct. No footprint change in rev C | Move to TSSOP-24 now (two makers, new footprint and layout) | superseded by D-133 (Prins, 2026-10-19: a single-source part conflicts with the jellybean rule) |
| D-127 | 2026-10-19 | Decoupling: one value per IC, 1 uF X7R 0603 at each IC power pin, all boards (RF board C901 to C903, C1001, C802; controller C1 to C5, C14 to C17; shack interface C7, C61 to C63, C72 to C77, C201/C202 per port). Bulk stays separate (LDO output capacitors). RF board +12V_SW: one 1 uF 50 V X7R 0805 per radio block (C101, C201, C301) | passives.md (Bogatin, Rosenberg): the largest value in the chosen body at every pin, no mixed small values (anti-resonance). Review RF-07, CT-08 | Keep 100 nF and simulate the rails | decided (Prins, 2026-10-19); drawn |
| D-128 | 2026-10-19 | BSS138BK second source: onsemi 2V7002KT1G (DigiKey Direct) replaces Diodes DMN61D8L-7 (datasheet still "Advanced Information"). Limits to compare line by line before use: RDS(on) at VGS 3.3 V against the 33 mA coil current, VGS(th), ESD | DigiKey NL 2026-10-19: BSS138BK zero stock, backorder; 2V7002KT1G in stock | Keep DMN61D8L-7 | decided (Prins, 2026-10-19). Limits compared 2026-10-19 on onsemi 2N7002K/D Rev 20 (2023-10, read online, to file): 60 V, VGS +-20 V, VGS(th) 1.0 to 2.3 V, RDS(on) max 2.5 ohm at 4.5 V / 200 mA and 1.6 ohm at 10 V; no RDS(on) value below 4.5 V (curves only); ESD 2 kV HBM; IGSS 150 nA at 5 V; SOT-23 G-S-D, halogen-free, AEC-Q101 (2V prefix). Against BSS138BK (6.5 ohm max at 2.5 V specified): with the 3.25 V gate drive the overdrive is about 0.95 V above the maximum threshold, so the part very probably carries 33 mA with a small drop, but the datasheet does not guarantee it. Not a verified drop-in (open, D-134 to decide) |
| D-129 | 2026-10-19 | RF board bulk at the 12 V entries: C6 (+12V_RLY) and C7 (+12V_AUX), 47 uF 25 V aluminium polymer, 6.3 mm SMD (12.6 / 25 = 0.50). Part and second source to confirm on DigiKey. C2 on the Q1 gate stays a DNP soft-start option | passives.md (Bogatin): the slow droop after a relay edge needs bulk capacitance on the rail. Polymer: low ESR but enough damping against hot-plug ringing with the cable inductance; ceramics alone would ring | 2 x 10 uF 25 V X7R 1210 (more ringing at hot plug) | decided (Prins, 2026-10-19); drawn; part Panasonic EEH-ZC1V470P 35 V (D-200, M-122) |
| D-130 | 2026-10-19 | Cat6 #1 stays unshielded (UTP). Full filtering at both entries: GDT to CHASSIS, then a common-mode choke per pair (L1 to L4 on the controller and on the shack interface: TDK ACT45B-510-2P-TL003 51 uH, second sources Murata DLW43SH510XK2L, Coilcraft 1812CAN-513, land pattern to confirm), Y-capacitor footprints 1 nF 1 kV from each wire behind the choke to CHASSIS (DNP), then the 47R MELF and the TVS | environment-and-protection.md: a shield needs a 360° bond at both ends, which an RJ45 with springs does not give; the loops are differential and isolated (optos), so a CM choke at each entry is the better filter. Review CT-04, CT-05, SI-03 | Shielded Cat6 with 360° glands at both ends | decided (Prins, 2026-10-19); drawn (M-44, M-45). Closed by D-149 (review S-17, 2026-11-02) |
| D-131 | 2026-10-19 | Controller board and shack interface stackup: 2 layers, 1.6 mm, L2 solid GND, routed power, no controlled impedance (title block C4) | pcb-layout.md: slow logic and routed power need one reference plane; no RF lines on these boards. USB on the shack interface is full speed (12 Mb/s) over a short run. Review CT-10, SI-08 | 4 layers (cost without a need) | decided (Prins, 2026-10-19) Controller board: changed to 4 layers by D-144. Shack interface: changed to 4 layers by D-170 |
| D-132 | 2026-10-19 | RF board supports S1 to S6: plated M3 holes (was NPTH, D-102) on the CHASSIS net through the standoffs, each with one 1206 bond option footprint to GND (C8 to C13, DNP): fit 0R (DC bond), 10 nF 1 kV (RF bond) or a resistor (cavity damping) after the bench test. H1 stays the defined bond point | environment-and-protection.md (Keith Armstrong): multi-point RF bonds closer than λ/10 at the highest frequency of concern, with options per mounting point on prototypes. Review RF-08. Supersedes the "not on GND" part of D-102 | Keep NPTH supports (no bond option) | decided (Prins, 2026-10-19); drawn (M-42, M-43) |
| D-133 | 2026-10-19 | I/O expanders U901 to U903, U1001 (RF board) and U5 (shack interface): PCA9539 function in TSSOP-24 (KiCad Package_SO:TSSOP-24_4.4x7.8mm_P0.65mm), three makers with the same pin-out: NXP/Nexperia PCA9539PW,118 (order code in the schematic), TI TCA9539PWR, Diodes PI4IOE5V9539LEX. Checked line by line: pins 1 INT, 2 A1, 3 RESET, 4 to 11 IO0, 12 GND, 13 to 20 IO1, 21 A0, 22 SCL, 23 SDA, 24 VDD on all three; no I/O pull-ups (NXP Rev 9.1, TI SCPS202C; Diodes datasheet 2016: input leakage max 1 uA at 0 V, so no pull-up); RESET sets all registers to default and all I/O to inputs; reset pulse 6 to 25 ns min; VDD 2.3 (TI 1.65) to 5.5 V, abs max 6 V; -40 to 85 °C; IOL 25 mA per pin. Input threshold worst case 0.7 x VDD (NXP, TI) = 2.43 V at 3.47 V: A?_BIAS_OK at 11.4 V gives 2.65 V, margin 0.22 V (C-17 divider) | skill section 2: at least two drop-in sources. Layout has no tracks, so the footprint change costs little now. Supersedes D-126 | SOIC-24W with TI PCA9539DWR only (single source); MCP23017 (one maker, other pin-out and registers) | decided (Prins, 2026-10-19); drawn (M-46). Datasheets filed; all three in stock (Prins, 2026-10-19); 0.65 mm pitch accepted for hand soldering (Prins). Order rule (review S-7, 2026-11-01): plain PCA9539 only, never the PCA9539R. The R variant resets only the I2C interface on RESET (NXP Rev 9.1 section 6.4), so the registers and the relay outputs keep their old state. The firmware relies on RESET clearing them: RLY_EN low must hold the expanders silent and K0 off (relay_box.rs:434, 564), and set_up runs again after the reset (relay_box.rs:478). The rule is in the part description of U901 to U903, U1001 and U5 and goes into the order BOM (B-3) |
| D-134 | 2026-10-19 | Coil MOSFET second source: Diotec MMFTN138K (SOT-23, pins 1 G, 2 S, 3 D) replaces onsemi 2V7002KT1G (D-128). Proposed, waiting for Prins | Same limits as BSS138BK line by line (60 V, VGS(th) 0.48 to 1.6 V, RDS(on) max 6.5 ohm at 2.5 V / 10 mA, 2.2 ohm at 4.5 V), same pin-out, ESD 2 kV, in stock (Prins); 37.5 / 60 = 0.63 | ROHM BSS138BKT116 / AHZG (pins 1 S, 2 G: not a drop-in on the SOT-23 G-S-D footprint), ROHM BSS138BKW and Panjit 2N7002KW-AU (SOT-323), Panjit PJA138K (50 V: 0.75 above the factor), 2V7002KT1G (no RDS(on) below 4.5 V) | decided (Prins, option 1). Halogen status of MMFTN138K to check (D-107). Halogen point closed by D-150 (review S-17, 2026-11-02) |
| D-135 | 2026-10-19 | General halogen rule (all boards, all projects): halogen-free parts and materials (IEC 61249-2-21) unless that is impossible or impractical. Each exception is a D- line with its reason. Replaces 'minimise' in DR-02 and D-107; the 'private project' reason of D-42 and D-118 no longer applies | Prins, 2026-10-19 | Minimise only (D-107) | decided (Prins). D-118 to review: its remaining reason is that JLC offers no halogen-free 6-layer material |
| D-136 | 2026-10-19 | RF board placement by function (layout p1g), per the placement checklist of hardware-design-rules (pcb-layout.md): (1) edge band 3.5 mm free of parts on all sides, for the GND strip and via fence (D-119), except the edge connectors and supports; (2) 8 mm washer keep-out at S1 to S6 (D-102); (3) each IC with its own parts: 1 uF at the VDD pin (PCA9539 pin 24, LM2901 pin 3), arrays at IO1_6 and IO1_7, bus pull-ups at U901, R904 at U903; (4) the J14 filter at the J14 pins (link at the pin, C and test point on the logic side); (5) expanders left of J14 (bus J14, filter, expanders in one line), LDO and the +12V_SW switch with clamps right of J13, bias-T supply below radio block 3 as one block per antenna port, RF detect between the feed bands and K401; (6) fuse, TVS and bulk stacked at each 12 V entry; (7) +12V_SW decoupling C101 to C301 on the bottom side under the EXP TX relay, next to its coil pin | p1b and p1f used shelf packing: decoupling 20 to 40 mm from the ICs, parts 2.5 mm from the edge (Prins review 2026-10-19); C101 to C301 sat on the TX row line of each radio block | Shelf packing by zone (no relation to the pins) | decided (Claude, under D-119, D-102, D-127; Prins: implement and review) |
| D-137 | 2026-10-19 | Controller board outline and mounting: one board of about 150 x 118 mm above the RF board, on the RF board supports S1, S2, S4 and S5 (longer standoffs, about 20 mm, from the RF board to the controller board); top edge at the top wall with the RJ45 in that wall; J14 inside the outline; DevKit placed with the 40 mm USB corridor of R-14 | No new holes in the relay field of the RF board; four supports keep the board stiff when the Cat6 plug is pushed in | A board of about 150 x 60 mm on S1 and S2 plus two new supports in the relay field (RF placement changes) | decided (Prins, option 1) |
| D-138 | 2026-10-19 | RJ45 LINK jack J1 (controller board, top wall): Wurth 615008137121 (unshielded, THT, tab down), second source Molex 95501-2881. One common footprint: pins on the shared pattern (rows 6.35 and 8.89 mm behind the peg line, 1.27 mm stagger), drill 1.0 mm, NPTH pegs 3.25 mm, origin at the peg midpoint. Wall opening sized for 11.65 mm height and the front face 7.88 to 7.93 mm from the peg line | Same height and face position within 0.15 mm, so one wall opening fits both; Wurth states 1.5 A, 120 V AC and 1000 V AC withstand and has the newest datasheet (2025) and a STEP model | Amphenol FCI 54602-908LF as second source: about 1 mm taller, face 0.26 mm further back, datasheet from 2010. Halogen status of both parts not stated (to check, D-135) | decided (Prins, option 1). Halogen point closed by D-150 (review S-17, 2026-11-02) |
| D-139 | 2026-10-20 | Board-to-board J2 (controller board underside, onto RF J14): Samtec ESQ-112-33-G-D elevated socket, B 16.13 mm (seating plane to insulator top); second source ESW-112-33-G-D (same height, round solder tail). RF J14 stays the standard 2 x 12 2.54 mm header. Footprint unchanged (PinSocket_2x12, drill 1.0 for the 0.64 mm square tail) | STEP fit (M-53): socket face 0.95 mm above the J14 body, pin engagement 5.05 mm at a 19.7 mm board gap, inside the Samtec range 3.68 to 6.35 mm; the range holds for a board gap of 18.4 to 21.1 mm, so a standard 20 mm standoff fits (4.75 mm). Same family as the part Prins found (ESQ series, several platings and tails) | ESQ-112-37-G-D-LL (B 11.05 mm: no engagement with the standard header); 8.5 mm socket with an extra-long-pin header (two special parts, no part found). Halogen status not stated (D-135) | decided (Prins, option 1) |
| D-140 | 2026-10-20 | DevKit height stays as D-95: Sullins 8.50 mm sockets, DevKit underside 11.05 mm above the controller board, DevKit top 6.15 mm under the lid (with the 20 mm board gap: 5.85 mm) | The height is not a problem now (Prins); no change to the DevKit or the footprint | Samtec SLW-116/112-01-G-S low-profile socket (4.57 mm, closed bottom, short posts only): needs the DevKit pins cut to about 2.8 mm; open-bottom socket for 0.64 mm square pins: no part found; DevKit soldered directly: not plug-in | decided (Prins) |
| D-141 | 2026-10-20 | Test access with the controller board fitted: RF board test points under the controller board stay (TP1, TP2, TP1201 to TP1205, TP1209) for the RF board test before assembly; the controller board gets TP5 SCL, TP6 SDA, TP7 EXP_INT, TP8 RLY_EN, TP9 TX_ANY on the top side at the J2 pins (schematic c11, layout c-p3). +5V, +3V3, FAULT and RF_A2_N already have test points (D-120); +12V_SW stays reachable on the RF board (TP4) | RF board layout does not change; the bus can be probed in the assembled unit | Move the eight RF test points to x > 153 mm: long tracks through the relay field, RF layout changes. Not reachable in the assembled unit: +12V_RLY and +12V_AUX | decided (Prins, option 1) |
| D-142 | 2026-10-20 | Controller board isolation barrier: the Cat6 loop side (J1, GDT, chokes, 47R, TVS, opto LED or switch side, LED series and clamp diodes) lies left of x 54.5 and above y 52.5 (RF frame); the logic side right of x 57.5 and below y 55.5. A 3 mm copper-free band between them (rule area on all copper layers). Optos U1 to U4 and the READY photorelay U6 sit on the barrier with the loop side up. GND (B.Cu plane, F.Cu pour) only on the logic side; no plane under the loop side | The loops float on the shack supply (D-56); a GND plane under the loop copper would bridge the opto isolation and couple surge current into logic GND. Band 3 mm against about 0.5 mm clearance for a 1.5 kV impulse (EN IEC 60664-1 table F.2, PD2; to confirm) | Plane over the whole board (bridges the isolation); barrier only at each opto (zig-zag plane edge, longer return paths) | decided (Prins, 2026-10-20) |
| D-143 | 2026-10-21 | Controller board routing by an own grid router (routing/grid_router.py), not by Freerouting. B.Cu stays the GND plane of the logic side: a B.Cu track there costs 15 x F.Cu, a via 4 mm of F.Cu track, so B.Cu carries only short jumps; on the loop side (no plane) B.Cu costs 1.5 x. Clearance per netclass, isolation band closed, GND not routed (own via per pad). The routing result (routing/routes.json) is applied by gen_controller_pcb.py; the router runs again after a placement change | Freerouting put long tracks across the plane or left nets open (M-58); the own router keeps the plane rule and gives the same result on every run | Freerouting result finished by hand (13 open connections, long B.Cu runs, lost on every placement change) | decided (Prins, option 1) |
| D-144 | 2026-10-21 | Controller board stackup: 4 layers, JLC04161H-7628, 1.6 mm. L1 F.Cu signals (vertical), L2 In1.Cu GND, L3 In2.Cu signals (horizontal), L4 B.Cu GND. The GND planes and the F.Cu GND pour cover the logic side only; the loop side (D-142) has no plane on any layer. Routing style (Prins, 2026-10-21): L1 vertical, L3 horizontal; break out from the pad centre H, V or 45 degrees, then one straight diagonal or a layer change; no via at the end of a long 45 degree run (short breakout only); track widths from the series 0.127 / 0.254 / 0.508 mm, default 0.254, smaller only where it must be. Changes D-131 for the controller board only (the shack interface stays 2 layers) | Each signal layer gets its own solid GND plane next to it (skill section 8); with 2 layers the B.Cu plane carried jumps and the routing could not keep one direction per layer (M-59). Extra cost small at this volume | 2 layers (D-131, M-59): plane cut by jumps, mixed directions | decided (Prins, option 1). Halogen-free laminate: not required in this project (D-150) |
| D-145 | 2026-10-21 | Controller board CHASSIS plane: CHASSIS zones on L1, L2 and L4 over the loop side (the region left of and above the isolation band, D-142), the same three layers as the logic-side GND. GDT centre pins and H1 join the zones directly (thermal relief, spokes 1.0 mm, gap 0.5 mm; L4 is 1 oz); each Y-capacitor CHASSIS pad has its own via. Zone clearance 0.5 mm (Loop class). Stitching vias 1.0 mm inside the edge of each plane region (CHASSIS and GND), pitch 5 mm. CHASSIS is no longer routed. CHASSIS and logic GND stay separate (bond option D-18) | GDT discharge current (kA class, 8/20 us) needs a low-inductance path from the GDT centre pins to H1 and the box; a 0.508 mm track can fuse and adds inductance. The Y capacitors (D-130) need a short return to be effective at HF. Every loop-side signal layer then has a plane next to it. Prins, 2026-10-21 | CHASSIS as a routed 0.508 mm track (r3): high inductance, surge current through a thin track | decided (Prins). To confirm: GDT impulse rating against the plane and spoke copper (Bourns 2036 datasheet). Closed by C-36 (review S-17, 2026-11-02) |
| D-146 | 2026-10-21 | Controller board power stays routed on 4 layers: +5V and +3V3 as 0.508 mm tracks (narrowed to 0.254 mm only at fine-pitch pins), no power plane | Worst load about 0.11 A (C-35), slow logic (I2C 100 kHz, 9600 baud), local decoupling at every IC. A plane would need a pad via per SMD power pad (about 30), so the via count stays about the same (M-61). On 4 layers L2 and L4 are the GND references of L1 and L3 | 6 layers with L5 as a split +5V/+3V3 plane (higher cost, new stackup and halogen check, new routing run); power plane on L2 or L4 (split under signal tracks) | decided (Prins, option 1) |
| D-147 | 2026-10-21 | Controller board Cat6 wires (nets L1P to L4N, J1 to GDT to choke): netclass Entry, 1.016 mm, clearance 0.5 mm, on L1 and L3 | Surge copper C-36: at 0.508 mm the inner-layer runs of the J1 fan-out melt at about 0.64 kA 8/20 per wire; 1.016 mm gives about 1.3 kA inner and 2.9 kA outer | 0.508 mm (tracks act as a fuse above about 0.6 kA per wire) | decided (Prins, option 1) |
| D-148 | 2026-10-22 | Supervisor second sources for U12 TPS3823A-33 (CT-11; TI-only, zero stock at DigiKey NL on 2026-10-19): ADI MAX823SEUK+T (SOT23-5, same pin-out 1 RESET_N, 2 GND, 3 MR, 4 WDI, 5 VCC; VTH 2.85 to 3.00 V over temperature; watchdog 1.12 / 1.6 / 2.4 s; reset 140 / 200 / 280 ms; WDI floating disables the watchdog; -40 to 125 degC; datasheet 19-0487 Rev 5) and Diodes APX823-29W5G-7 (VTH 2.80 to 3.05 V, watchdog 1.12 / 1.6 / 2.4 s, reset 140 / 200 / 280 ms, WDI floating disables, -40 to 85 degC, halogen and antimony free, DS31323 Rev 5-2) | Same pin-out and the same thresholds and timing window as the TPS3823A-33 (VIT- 2.83 to 3.00 V, 0.9 to 2.5 s); C-19 kick period 0.25 s fits all three; D-123 (R64 open floats WDI) works on all three. TI states that the non-A TPS3823 can latch RESET low when WDI toggles during reset; the A version does not. MAX823: 'while reset is asserted, the timer remains cleared and does not count'; no latch is described. The MCU keeps kicking WDI during a reset (DevKit RST pin not connected) | Single source (TI only); TPS3823 non-A (RESET latch with WDI active) | decided (Prins, 2026-11-01): MAX823SEUK+T is now the first source (D-195). To confirm on the bench with each second source: no RESET latch with WDI toggling during reset; MAX823 RESET sources only 150 uA at VOH (logic loads only, fine). Datasheets to file |
| D-149 | 2026-10-22 | Cat6 entry parts, controller board: (1) common-mode chokes L1 to L4 on an own footprint L_CMC_TDK_ACT45B from the TDK land pattern (pads 0.9 x 1.35 mm, pitch 2.5 x 4.55 mm), long axis vertical: the P winding in the right column, the N winding in the left column, both lines enter at the top (TDK 1 and 2 = winding starts). Pad numbers follow Device:L_Coupled (pad 1 = TDK 1, 2 = TDK 4, 3 = TDK 2, 4 = TDK 3); the schematic does not change. The template N/P crossing at the choke is gone; Y-capacitors swap sides (P cap right, N cap left, wire pad at the bottom). (2) GDT second source Littelfuse SL1003A090R-001 (SL1003A Revised 12/12/17: 90 V +-20 %, impulse 700 V at 1 kV/us, 10 kA 8/20 x10, 300 x 200 A 10/1000 us, body dia 6.0 x 8.1, leads 0.8 in one row at pitch 4.4 +-0.3, 12.2 mm overall) on the same three holes; footprint GDT_3Pin_P4.40mm_Bourns-2036-B2_Littelfuse-SL1003A-R with the courtyard of the larger body. The GDTs of pairs 3 and 1 move 1.3 and 1.0 mm toward J1 (12.8 mm between neighbours, still symmetric about J1) | M-64: with the TDK part the old choke layout cancelled the common-mode flux and the footprint did not match the land. Second source: the same lead row and pitch as the Bourns B2 form, so one footprint takes both | Choke: keep the 1812CAN footprint and swap the N pins (crossing moves before the choke, land mismatch stays). GDT: TDK T83-A90X (B88069X8300B502; same pitch, but dia 8 and 13.4 mm overall, does not fit 11.5 mm between columns); Socay SC3E5-90LM (halogen-free, but lead pitch 3.8 mm, needs slots; 12 mm overall) | decided (Prins, 2026-10-22). Murata and Coilcraft checked (D-151); halogen not required (D-150); C-39 with the SL1003A (impulse 700 V, transverse delay not given): difference current 7.2 A, TVS 0.29, 47R 2.4 mJ even for 1 us, within the factors |
| D-150 | 2026-10-22 | Halogen status is not a selection criterion in this project (hobby project). No material declarations are requested; open halogen points close (D-144 laminate, J1, J2, SL1003A). D-135 stays the general rule for other projects | Prins, 2026-10-22: 'not important for this hobby project' | Request declarations from Wurth, Molex, Samtec, Littelfuse and JLCPCB | decided (Prins) |
| D-151 | 2026-10-22 | Second sources checked against the new choke footprint L_CMC_TDK_ACT45B (D-149) and for the MELF resistors. Murata DLW43SH510XK2L (product sheet 2020-12-15: 4.5 x 3.2 x 2.6, terminals 0.8 x 0.7 at the corners, windings (1)-(2) and (4)-(3), dots at (1) and (4) on one end; 51 uH, 230 mA, 50 V, 1.0 ohm, -40 to 125 degC) and Coilcraft 1812CAN-513 (Document 1201-1, 03/22/24: 4.95 x 3.18 x 3.0 max, terminals 0.94 x 1.1, windings 1-2 and 4-3, dots at 1 and 4 on one end; 51 uH, 300 mA, 250 Vrms isolation, 0.59 ohm, -40 to 125 degC; own land 3.68 x 1.73 pitch): both have the TDK geometry (both winding starts at one end), so they mount by position on the TDK land; terminal overlap on the pads 0.65 mm (Murata) and 0.88 x 0.79 mm (Coilcraft). Their pin numbers differ from TDK (top row 1 and 2, bottom row 4 and 3); the parts have no polarity. MELF: TE Connectivity Neohm SMA-A (0204 and 0207 thin film, 1 %, 47R and 220R in the series; product sheet SMA-A0207BTNT39K) as second source for the Vishay MMB 0207 and MMA 0204; Vishay CMB 0207 / CMA 0204 (carbon film, higher pulse load) as a same-maker fallback | Drawings filed; the C-39 margins (47R energy 0.005 to 0.1 of the rating) leave room for any thin-film MELF of the same size | Single source | decided (Claude, under D-149 and CT-11). TE pulse data not on the product sheet: to check with a full datasheet at the order |
| D-152 | 2026-10-22 | Board signature on every board: the main function of the board as one IEC 60617 logic symbol with a short truth table in the silkscreen art block (hardware skill v2.8). Controller board: RLY_EN = NOR(KILL, MCU_EN_N, FAULT), drawn in c-s1 (M-62). RF board and shack interface: to choose and draw at their silkscreen pass. The same boards also get the schematic function frames of M-66 at their next schematic revision | Prins, 2026-10-22: a signature that also tells the main function | A logic element only where it fits (skill up to v2.7) | decided (Prins) |
| D-153 | 2026-10-22 | Ordering: all boards of the project in one JLCPCB order when every board is ready; Prins orders the parts and assembles by hand (no JLC assembly; BOM and position files for assembly not used). Controller board files stay ready in hardware/unit/controller-board/production/ and are generated again at the order for the date code | Prins, 2026-10-22 | Order the controller board alone now | decided (Prins) |
| D-154 | 2026-10-22 | U13 fault latch in VSSOP-8 0.5 mm: TI SN74LVC1G74DCUR, second source Nexperia 74LVC2G74DC (single flip-flop with set and reset despite the name). Both MO-187 CA, same pin-out (1 CLK/CP, 2 D, 3 Q_N, 4 GND, 5 Q, 6 CLR_N/RD, 7 PRE_N/SD, 8 VCC), -40 to 125 degC. KiCad VSSOP-8_2.3x2mm_P0.5mm. Fixed 0.2 mm fan-out copper at U13 (layout c-s3, M-68) | Two independent makers for the fault latch (Prins, option A) | Keep TI DCT SSOP-8 single source with spares (no second maker in that package) | decided (Prins) |
| D-155 | 2026-10-22 | U14 stays SOT-23-6: TI SN74LVC1G27DBVR, second source Nexperia 74LVC1G27GV (SOT457, same pin-out 1 A, 2 GND, 3 B, 4 Y, 5 VCC, 6 C; fits the SOT-23-6 land; -40 to 125 degC). Candidate Diodes 74LVC1G27W6-7 (pin-out to check). No layout change; schematic c14b (description only), ctl14 description text updated, connectivity and board unchanged | Two makers without a layout change; 0.95 mm pitch is easier by hand | SC-70-6 (TI DCK, Nexperia GW, onsemi NC7SZ27P6X): Prins first chose it for three makers, then the onsemi sheet (Rev. 4, 2024-08) showed NC7SZ27P6X discontinued and -40 to 85 degC only; two makers remain, at 0.65 mm pitch and another layout pass | decided (Prins). Candidate Diodes 74LVC1G27W6-7 not used: TI and Nexperia cover the part (review S-17, 2026-11-02) |
| D-156 | 2026-10-23 | RF board layer use (option A): L1 rows and GND pour (ref L2); L2 GND; L3 routing, horizontal (ref L2); L4 routing, vertical (ref L5); L5 GND; L6 columns, radio feeds and GND pour (ref L5). Coil lines, +12V_SW, I2C and rails on L3 and L4 with the grid router; no logic copper on L1 or L6 in the RF area. A via from L3 to L4 changes the reference from L2 to L5: GND via next to it. Free areas of L3 and L4 get a GND pour. Same physical stackup JLC06161H-7628A. Partly supersedes D-115 (L4 GND) and D-119 item 2 (pour on L3 only); D-117 antipads apply on L2 and L5 | Prins, 2026-10-23, after the stackup sketch (Claude outputs/rf-board-stackup-options.png): +12V_SW to 34 coils crosses the coil lines; two layers at right angles route without cuts in the RF pours; each signal layer keeps a solid GND plane at 0.10 mm; rows and columns still have two planes between them | B: L4 GND, L3 only, hops on L1/L6 outside the RF bands (cuts in the outer pours, more vias, router keep-outs; L4 and L5 both GND add little) | decided (Prins) |
| D-157 | 2026-10-23 | RF return vias (D-119 item 1): GND vias at every RF layer change as close as the 2.0 mm outer gap allows (about 3.3 mm from a relay pin centre, 2.9 mm from an RF via centre), 2 to 4 per change. Clearance mechanism (M-70): RF netclass 0.5 mm (inner antipads, D-117), outer GND pours in the RF area with zone clearance 2.0 mm, RF-to-other copper on L1/L6 checked by the generator | The 2.0 mm creepage gap (D-12, PD3) does not allow GND copper within 1 mm of an RF pad on the outer layers; the extra return path of about 2 mm adds roughly 2 nH (about 0.7 ohm at 54 MHz) | Vias within 1 mm with conformal coating on every relay field (coating as a requirement on the whole matrix) | decided (Prins) |
| D-158 | 2026-10-23 | Routing rule, all boards: no 90-degree bends in a track; every bend is 45 degrees (chamfer). A T-junction (a branch at right angles to a straight track) is allowed. Parts in one signal path sit on one line (for example DC block, bias choke and bias decoupling on one vertical line), and a track enters a pad straight, without a small angle; pads that a straight track joins are placed level with each other | Prins, 2026-10-23: 90-degree corners can crack under thermal expansion and shrinkage; 45 degrees is more robust, and aligned parts with straight tracks read better | 90-degree corners (grid router before c-s4, RF copper p2a) | decided (Prins) |
| D-159 | 2026-10-23 | T-junctions on tracks narrower than 0.6 mm get two 45-degree fillets (leg 0.5 mm), so that no right-angle corner is left (logic, coil and supply tracks). RF lines (0.975 mm) keep the plain T of D-158 | Prins, 2026-10-23 (option B), from David L. Jones, PCB Design Tutorial (Finishing Touches): a chamfer at a T on thin tracks is more robust and avoids etching problems at the corner; same reason as D-158 | A: T at 90 degrees on all tracks (D-158 as first written) | decided (Prins) |
| D-160 | 2026-10-23 | Controller board: the CHASSIS plane stays under the four Cat6 common-mode chokes L1 to L4 (F.Cu, In1, B.Cu); no cut-out | The plane is CHASSIS, the common-mode reference of the entry (D-145), so its capacitance to the choke pads acts as small Y-capacitance on both sides; estimated input-to-output path through the plane well below 1 pF (pads about 1.2 mm2 each at 0.21 mm), small against the interwinding capacitance of the choke (to confirm from the TDK ACT45B data). Raised by TI SLYP762 (no plane under a common-mode choke) | B: cut-out under each choke body on all three layers (removes the bypass path, but also the plane under the pairs at the choke; new layout revision) | decided (Prins); interwinding capacitance to confirm |
| D-161 | 2026-10-23 | RF board: fixed fan-out of the TSSOP-24 parts U901, U902, U903 and U1001 (as D-154 on the controller board). Every signal pin gets a straight F.Cu stub (0.254 mm) outward along the pad axis to its own via (0.6/0.3 mm), in two staggered columns 0.6 and 1.6 mm beyond the pad end (1.3 mm via pitch in a column; 0.22 mm from a stub to the next via). The placement keeps a 1.9 mm keep-out along each pad row free of other parts. The router ends on the via. A via that the routes reach on F.Cu only is removed again (the F.Cu route joins the stub) | First router runs (M-75): 9 to 16 nets failed, all at the expander pins: tracks of earlier nets boxed the 0.65 mm pins in before their own nets were routed. With the fan-out: 161 of 161 nets | A: router only, with escape strips of 1 mm in front of each fine-pitch pin (still 9 to 15 failures); B: three via columns (did not fit beside the resistor arrays RN901 to RN903) | decided (Claude, same method as D-154); for review by Prins |
| D-162 | 2026-10-23 | RF board: each board support S1 to S6 has its own net CHASSIS_S1 to CHASSIS_S6, with only its local bond option (C8 to C13, DNP). No board copper joins the supports to each other or to H1. H1 with JP1 and C1 stays the one defined CHASSIS bond (D-18). Schematic v12b, netlist rf14 | Prins, 2026-10-23 (option B). A board net across all supports would join the case floor points through the board and form loops through the enclosure; long CHASSIS tracks would also cross the RF area. Local bond options keep the bench test of D-132 open per support | A: route CHASSIS as one net across the board | decided (Prins) |
| D-163 | 2026-10-24 | Grid router costs, all boards from now: a 45-degree step costs more than a step against the main layer direction (3.5 against 3 per 0.1 mm), and a 90-degree turn less than two 45-degree turns (8 against 6 + 6). A branch leaves a straight track at right angles (T, filleted per D-159); a corner gets the 45-degree chamfer of D-158. A track keeps the clearance from pads of its own net, except in four straight entry corridors from the pad centre (it does not graze its own pads). The automatic placement puts parts that lie within 1.5 mm of each other on one horizontal and one vertical line, on a 0.5 mm grid | Prins, 2026-10-24 (option A): branches at 45 degrees and a track that touches TP4 look untidy; D-158 asks for parts on one line, which the automatic placement did not yet do | B: keep the old costs (45-degree branches) and fix marked spots by hand only | decided (Prins); more vias accepted |
| D-164 | 2026-10-24 | Grid router, all boards: minimum track segment 0.4 mm between two bends, or between a bend and a via. Exceptions: the last segment into a pad or via centre, and segments inside the 1.5 mm breakout zone around own pads (pin fields) | Prins, 2026-10-24: short jogs of 0.1 to 0.3 mm look untidy and must be settled before the stitching vias are placed | A: geometric clean-up after routing (no clearance-safe way to shift a segment in general); B: no breakout exception (the search did not converge: 1 to 3 nets failed in 10 passes) | decided (Prins: minimum length first) |
| D-165 | 2026-10-24 | RF board GND stitching (D-119 items 2 and 3, D-156): (1) return vias: the router allows a via between F/In2 (reference L2) and In3 (reference L5) only where a GND via fits within 1.5 mm (2.5 mm in the logic regions), places that GND via at once, or uses a GND via already there; (2) edge fence 1.5 mm inside the outline, pitch 2.54 mm; (3) GND vias on a 5 mm grid where the pours have room. To make room: expanders U901 to U903 17.5 mm apart (was 15), a 5 mm exit strip on the inner layer in front of each fan-out via, fan-out connections routed first. The coil supply nets (+12V_RLY, +12V_SW, +12V_AUX) keep 0.508 mm (no narrowing) | Prins, 2026-10-24 (option A): every signal via that changes the reference plane gets its GND return close by | B: return vias placed after routing (8 % of the vias without a GND via within 3 mm) | decided (Prins) |
| D-166 | 2026-10-25 | RF board: the 12 signal vias with the nearest GND via at 3.0 to 4.1 mm (M-80) are accepted as they are | Prins, 2026-10-25 (option A): they carry 400 kHz I2C and static coil-drive lines; a few mm of extra return path adds about 1 to 2 nH | B: rework the expander band placement (uncertain outcome, hours of runs); SOIC-24 is out (D-133, three makers for TSSOP-24) | decided (Prins) |
| D-167 | 2026-10-25 | RF board aggressor/victim rule in the router: detector and comparator inputs (/A?_DET, D?01 K and COM nodes, VREF Net-(C801-Pad1), U801 + inputs) keep 1.0 mm (about 4 track widths) on the same layer from bias, bias switch, coil supply, clamp, coil drain, coil gate and I2C copper | Aggressor/victim check M-81: /A3_DET ran 70 mm beside /A3_BIAS at 0.35 mm on In2, /A2_DET 32 mm beside /A1_BIAS; the DET node is a 47k/47k divider without a capacitor, so it is the most sensitive node on the board | No rule (the bias lines are DC; only switching edges couple) | decided (Prins, 2026-10-25) |
| D-168 | 2026-10-25 | RF board signature (D-152): the matrix as one IEC 60617 X/Y switch symbol, inputs R1 to R3, outputs A1 to A4, enable EN = RLY_EN, with the truth table "K(n,m) on, EN 1: Rn = Am / EN 0: all open", in the F.SilkS art block with title, revision, date code and "73 de PE1RGU" | D-152 asks for the main function as one IEC symbol with a truth table; the RF board function is a 3 x 4 crosspoint with one enable | A full 3 x 4 grid drawing of the relays (too large for the free area; repeats the copper) | decided (Prins, 2026-10-25) |
| D-169 | 2026-10-25 | Controller board keeps its c-s5 routing (controller router r4). The general router (rf-board/routing/grid_router.py, with the M-83 fixes) is the router for the RF board and for new boards | Regression M-83: the general router routes the controller board completely with DRC 0, but with 182 vias against 104 and less tidy power trunks; c-s5 is order-ready | Re-route the controller board with the general router (more vias, no gain); tune the general router to match c-s5 first (about half a day, and a re-check of the RF board) | decided (Prins, 2026-10-25) |
| D-170 | 2026-10-25 | Shack interface stackup: 4 layers, JLC04161H-7628, 1.6 mm, as the controller board (D-144). L1 F.Cu signals (vertical), L2 In1.Cu GND, L3 In2.Cu signals (horizontal), L4 B.Cu GND. Changes D-131 for the shack interface | Each signal layer gets its own solid GND plane (skill section 8); on 2 layers the controller board plane carried jumps and the routing could not keep one direction per layer (M-59); 295 parts and 183 nets (si14); the general router runs with nearly the controller settings; one order for all boards (D-153) | 2 layers (D-131): cheaper per board, but the M-59 problem would very probably come back | decided (Prins, 2026-10-25) |
| D-171 | 2026-10-25 | Shack interface housing: Hammond 1455T1601, extruded aluminium with metal end panels, about 163 x 160 x 51.5 mm; the board slides into the slots, extrusion designed for 160 mm wide boards (Hammond drawing 1455T1601), so the board is about 160 x 156 mm. Rear panel: RJ45, three mini-DIN, 13.8 V input; front panel: USB-C, KILL, RESET, five LEDs. Entry parts as the other boards: J1 RJ45 footprint of the controller board (Wurth 615008137121, second source Molex 95501-2881, D-138); J3 Amass XT60PW-M as the RF board power inputs (KiCad footprint pin 1 GND, pin 2 +; polarity on the real part M-02); GDT GD1 to GD4 and chokes L1 to L4 on the controller board footprints (D-149) | About 7000 mm2 of courtyards (si14, 295 parts); hand assembly on one side needs 2 to 2.5 times that; the 160 mm rear panel takes the five rear connectors with room; one plug family for the station 13.8 V | Hammond 1455N1601 (board 100 x 156 mm, about 45 % filled, rear panel only about 95 mm wide) | decided (Prins, 2026-10-25). To confirm on the drawing: slot height above the floor and end panel thickness. Closed by M-92 (review S-17, 2026-11-02) |
| D-172 | 2026-10-25 | Shack interface placement by function zones (hardware/shack-interface/svg/shack-placement-zones.png): rear edge XT60, RJ45, R1 to R3 mini-DIN; Cat6 entry and loop sources behind the RJ45; power at the left wall with the 7805; one column per radio port behind its mini-DIN with its RGND island; expander row across the middle; SAFE latch front left; DevKit front centre with J14 at its end; panel JST headers along the front edge; CHASSIS strip along the rear edge. The zones go on the silkscreen at the layout silkscreen pass: a frame per zone with its function title, as the schematic function frames (M-66) | Signal flow from the panels inward; each radio port local to its connector; short USB stub from J14 to the DevKit pads | – | decided (Prins, 2026-10-25) |
| D-173 | 2026-10-25 | Shack interface planes (under D-89, D-130, D-145): GND on F.Cu (pour), In1.Cu and B.Cu; one RGND island per radio port on the same three layers, from the CHASSIS strip to the opto row (radio side of the optos, border at y 53.3 and 55.5 at U2x5), with holes for the band stacks (the 1k series resistor ends the radio side; BAND pad, pull-up and pull-down on GND, linked by an In2 track and two vias past the opto row); CHASSIS as a 7.5 mm strip along the rear edge (mini-DIN shields, J1, H1), the Cat6 entry block down to the Y-capacitors (GDT centres), a 3 mm ring along the side and front edges and pads around the J14 shell. Router keep-out: interface nets do not run over an RGND island (exceptions: nets with a pad in the island or in its holes, for example BAND and +3V3 to the stacks, +13V8 to FEED SEL). Stitching after routing on a 5 mm grid in every plane region | D-89 (RGND separate except GND BOND and 10 nF to CHASSIS), D-130 (GDT to CHASSIS at the entry), skill section 8 (each signal layer over its own plane, no signal over a split) | A CHASSIS plane under the whole entry and loop area as the controller board (the shack loops have no optos, D-80, so they refer to GND) | decided (Prins, 2026-10-25: looks good; GDT row of M-88 also accepted) |
| D-174 | 2026-10-25 | EXP SMA J4 to J6: Cinch/Johnson 142-0701-631 added as second source (brass body, gold, PTFE, 4-hole flange, flush dielectric), and its vendor STEP is the 3D model in the case design (hardware/unit/case/ref-sma-142-0701-631.step). Main part stays Amphenol RF 901-9215 (D-110); 132142 stays listed as an alternative | Measured on the vendor STEP: flange 12.7 mm square, 1.57 mm thick, holes 2.59 mm on 8.64 mm, rear only the 1.27 mm contact, 5.21 mm long (901-9215 / 132142: 5.07 mm), so it fits the same pocket, M2 holes and 3.0 mm bore; the contact ends 1.2 mm past the inner wall. Datasheet (Cinch uncabled receptacles, 0 to 18 GHz): working voltage 335 Vrms at sea level, DWV 1000 Vrms, -65 to +165 C: 173 V peak / (335 x 1.414) = 0.37 | Amphenol RF 132166 (rear tab only 2.54 mm: ends inside the 4 mm wall, no strap possible) | decided (Prins, 2026-10-25). Dimensions of the vendor STEP accepted by Prins (2026-10-25); gold plated (datasheet 142-0701-631_Cinch_DS_NoRev_2014-12-17.pdf filed). Rear length on a real part with A-21; footprint SMA_901-9215_StrapPad unchanged |
| D-175 | 2026-10-25 | Shack interface jumper settings on the front silkscreen: the setting name at each end pin of every 3-way jumper (TX INH HI/LO, PIN 1 KEY/BAND, FEED RADIO/13V8, SENSE A and SENSE K CONT/VOLT, JP61 RUST-2/RUST-1), the function name beside the jumper where it fits (TX INH, PIN 1), the reference for all jumpers; full table per port on the back (CONTACT/VOLTAGE mode, TX INH, PIN 1, FEED, GND BOND rule). Pad numbers 1/3 on the solder jumpers give way to the setting names | Prins, 2026-10-25: the jumper settings must be visible on the board | Function titles for every jumper (no room in the port column for FEED, GND BOND, SENSE A, SENSE K without a placement change); table on the front (no free area of 26 x 15 mm in a port column) | decided (Prins) |
| D-176 | 2026-10-25 | Shack interface board signature (D-152): the SAFE latch U9 (74LVC1G74) as an IEC 60617 D flip-flop in the art block: S with negation = PRE_N, 1D = 0, C1 with the dynamic input = RESET, output LATCHED; truth table PRE_N 0 -> LATCHED 1; RESET with PRE_N 1 -> LATCHED 0; PRE_N = SAFE_OK AND POR_N. Drawn in gen_shack_pcb.py section 8 (M-91) | The latch is the function the board exists for (D-62, D-75); differs from the controller board NOR signature | TX_EN = NOR(FAULT, LATCHED) as a >=1 gate (too close to the controller board signature) | decided (Prins, option A) |
| D-177 | 2026-10-26 | Shack interface panel connectors against the end panels: the faces of J1 (RJ45, 1.85 mm), J11 to J13 (mini-DIN, 2.3 mm), J3 (XT60, 2.55 mm) and J14 (USB-C, 2.3 mm) sit behind the inner face of the 1.5 mm end panels (M-92). A mini-DIN plug must then reach 3.8 mm through the panel before it mates; its overmold does not pass a shell-size hole. Options: (A) let the connectors overhang the board edge so that each face sits about 0.3 mm from the panel (footprint check per connector, short re-route at the edges); (B) keep the board and make the panel cut-outs large enough for the plug overmolds | Hammond 1455T1601 STEP fit | – | decided (Prins, 2026-10-26, option A); done in layout p5 (M-93) |
| D-178 | 2026-10-26 | Shack interface in the 1455T1601 with the removable cap (T Extrusion Cap) on top, parts side up toward the cap; board in the 2nd slot from the closed bottom (slot centre 11.68 mm below the closed outer face in the Hammond frame) | Access to the 7805 screw and the jumpers with the cap off (Prins, 2026-10-26) | Top slot next to the closed face: only about 2.8 mm from the board underside to the corner ribs at the 7805 leads; cap at the bottom (M-92): the regulator is reached only from below the board | decided (Prins) |
| D-179 | 2026-10-26 | Shack interface end plates as PCBs (replace the Hammond aluminium plates): 165.0 x 51.13 mm, R 3.9, 1.6 mm FR-4 (fits the 1.7 mm bezel pocket), 2 layers, black solder mask, white silkscreen, ENIG; labels on the outside face; CHASSIS plane on the inside face only (outside face plain black); 4 plated screw holes 3.7 mm with a bare 6.0 mm ring on both faces (bond to the extrusion through the screws); cut-outs from the connector faces (rect + 0.3 mm per side, mini-DIN 10.5 mm, USB-C slot 13.0 x 7.0 mm, D-96). Generator hardware/shack-interface/endplates/gen_endplates.py. Halogen-free FR-4 to request in the JLC order (section 2). H1 earth wire to the extrusion, not to the rear plate | Silkscreen text, same order as the boards, a few USD (Prins, 2026-10-26: option B, black PCB) | CNC aluminium plates at JLC (30 to 60 USD per plate, laser marking extra, separate drawing) | decided (Prins) |
| D-180 | 2026-10-26 | Shack interface front plate: colour TFT (ST7789 class) instead of the R1 to R3 LEDs; the SAFE and LATCHED LEDs stay (driven by the latch in hardware, D-70; the display depends on firmware). Display drive: SPI on the two free DevKit pins, SCK on IO2 and MOSI on IO9; CS tied low; DC, RST and backlight from the PCA9539 pins freed by LED_R1 to R3 (DC changes only between command and pixel data, so the I2C delay is small). SCK on IO2: the DevKit WS2812 on IO2 sees only short pulses (all 0 bits) and stays dark. Display inputs are high impedance, so the IO2 and IO9 boot straps keep their pull-ups; a press on BOOT disturbs the picture only. KILL switch and RESET button panel-mounted (option A); wire headers on the board may move to make room behind the plate | Prins, 2026-10-26: colour display, option A (no MCU change, same module as the box, D-66) | ESP32-S3 DevKit with free GPIO (other module than the box, MCU zone rework) | decided (Prins); display part, KILL and RESET parts to select; firmware: display driver with DC on the expander. Strap check 2026-11-01 (review S-12, M-114): on the Waveshare 2inch module (D-187) SCK and DIN go from the header to the LCD flex with no pull and no other part; ST7789VW input current max 1 uA, about 45 mV against the C3 pull-up. Pins stay; boot with the display connected to confirm on the prototype. Parts selected by D-181, D-182, D-187; only the boot check on the prototype stays (M-114) (review S-17, 2026-11-02) |
| D-181 | 2026-10-26 | Shack interface KILL switch: EAO 84-5340.0020 emergency stop, red 32 mm head, 2 NC positive opening (EN 60947-5-5), twist to unlock, plug-in terminals 2.8 x 0.5 mm, gold-plated silver contacts, minimum 1 V / 1 mA, cut-out 22.3 mm with a 3.2 mm key to 24.1 mm, panel 1 to 4 mm, 9.5 mm behind the panel (EAO datasheet 01/2019). R75 (KILL_S pull-up) changes from 10k to 2k2 so that KILL_S carries 1.5 mA, above the contact minimum. Loop pole: 8.8 to 12.5 mA, up to 15 V | Low-level loads (loop 8.8 mA minimum, KILL_S 0.33 mA) need gold contacts specified below 10 mA; shallow body | APEM A01ES-DM (contact minimum 10 mA at 5 V, below the loop minimum); C&K 7201SYZBE toggle (gold 20 mA / 20 V: 15 V / 20 V = 0.75, above the 0.7 voltage factor; needs a separate guard) | decided (Prins). Datasheet filed: Datasheets/84-E-Stop_EAO_DS.pdf |
| D-182 | 2026-10-26 | Shack interface RESET button: C&K 8125SHZBE, SPDT on-momentary (C and NO used), plunger, 1/4-40 bushing (hole 6.5 mm), solder lugs, B contact material (gold over copper alloy), 0.4 VA max at 20 V, for dry circuits. Load: 3.3 V, 33 uA steady, 3.3 mA discharge pulse of the 100 nF through 1k (D-84). Status LEDs SAFE and LATCHED: 3 mm panel LEDs, Dialight 558 low-current types proposed (red 558-1101, green 558-1301, 2 mA, hole 3.94 to 4.01 mm; panel 0.79 to 1.57 mm, see A-28) | Gold contacts for a logic-level button; the EAO 82 series is specified from 5 mA only | EAO 82 (gold minimum 5 mA) | decided (Claude, for review by Prins) |
| D-183 | 2026-10-27 | Front plate a4: KILL moves 2 mm inboard to u 144 and RESET with it to u 123 (v unchanged). The KILL holder (diameter 29.8 mm, 5.5 mm deep behind the plate) came 0.3 mm from the extrusion side wall at u 146; at u 144 the gap is 1.37 mm. RESET keeps its 21 mm spacing to KILL, so the KILL holder stays 1.35 mm from the RESET body | 3D fit M-100 with the maker models | KILL at u 146 (0.3 mm to the wall, no margin for the extrusion and plate tolerances); KILL lower on the plate (the 32 mm head and the label need the full height) | decided (Claude, for review by Prins) |
| D-184 | 2026-10-27 | Display frame and front plate a5: printed frame (PETG or ASA, black; hardware/shack-interface/endplates/display-frame/gen_display_frame.py, STEP and STL) on the four M2 module standoffs (M2 x 5 pan head), fixed with M2.5 x 6 pan-head screws to four Wurth WA-SMSI 9774060151R SMD steel spacers (M2.5, OD 5.1 mm, L 6.0 mm) on the plate inside face at u 11.5 / 71.7, v 12 / 27. L 6.0 mm = module glass front to the module standoff ends, so the frame face meets both; three 0.2 mm crush ribs per module boss press the glass onto the plate. Recessed frame face (0.3 mm) clears the module back parts by 0.8 mm; window for the connector and the cable plug. Module moved 4 mm right (u 16) so the left frame ear keeps 1.86 mm from the extrusion. Print as exported: flat back on the bed, no supports | Prins, 2026-10-27: SMD spacers (clean outside face) | Screws through the plate (two screw heads on the front) | decided (Prins: fixing method; Claude: frame details, for review) |
| D-185 | 2026-10-27 | Mac USB link at the rear: a panel-mount USB-C extension (metal flange, 2 screws, 90 degree plug; generic part, for example the Melopero 'USB 3.1 Type C male 90 degree to female' panel extension) on the rear plate; the internal plug goes into the DevKit's own USB-C (faces -x at board x about 59, y 140; plug over the SAFE latch zone, clear of J2/J7). Flange screws in plated CHASSIS holes of the rear plate, so the cable shield bonds to the plate at the entry panel. Main board unchanged; J14 stays on the board but is closed behind the front plate (not reachable): J14, U61, C64, R64, R65 may stay unfitted (open point for Prins). Front plate a6: USB-C slot and label removed. Note: the DevKit USB path has no U61 ESD array (DevKit protection only); the Delock 64226 isolator stays at the Mac side | Prins, 2026-10-27: no cable at the front; bulkhead to the DevKit USB, metal 2-screw part with a 90 degree plug | J14 on the rear edge (no GND-referenced path: the entry CHASSIS block x 21.5 to 55.5 and the RGND islands x 56 to 156.5 fill the rear half; J3 to J1 gap 7.5 mm, slot 13 mm); J14 moved inside facing the rear with a bulkhead cable (keeps U61, small layout change); Adafruit 6069 round bulkhead (plastic nut, shield not bonded) | superseded by D-186 (Prins, 2026-10-27: too complicated; J14 on the board at the rear panel) |
| D-186 | 2026-10-27 | Shack interface layout p7: J14 (USB-C to the Mac) at the rear edge, in the rear plate with the other cables. The radio-port templates move to a 32 mm pitch (was 35; mini-DIN centres x 76.5, 108.5, 140.5, R3 unchanged; RGND islands 0.6 mm apart), which frees a GND channel between the Cat6 entry CHASSIS block (x up to 55.5) and the R1 island (from x 62). J14 at x 59.5, turned 180, on a 13 x 2 mm board tab at the rear edge; U61, C64, R64, R65 behind it in a wider channel part (x 54.5 to 65 up to y 15.5); GND notch in the CHASSIS strip under the J14 signal pads, shell pads on CHASSIS. H1 moves to x 27 (between J3 and J1, in the entry CHASSIS). Fan-out as p3 to p6, turned 180; VBUS stubs end on router terminals. Router keep-out: USB nets off the CHASSIS strip and the entry block. Front edge straight (no tab); front plate without USB slot; rear plate a7 with the 13 x 7 mm USB slot | Prins, 2026-10-27: the bulkhead route is complicated and expensive; J14 on the board at the rear panel | Rear bulkhead with internal cable (D-185, superseded); J14 left of J3 (gap 7.5 mm); J14 between ports (no GND path through the RGND islands) | decided (Prins: J14 at the rear; Claude: layout, for review) |
| D-187 | 2026-10-28 | Shack interface display: Waveshare 2inch LCD Module (240x320 IPS, ST7789VW, SPI, PH2.0 8-pin in the same pin order; module 58.0 x 35.0, active area 40.8 x 30.6) in place of the 1.9 inch (D-180). Front plate a8: module PCB at u 15.0 to 73.0, v 8.0 to 43.0 (centred in the housing opening, v 2.07 to 49.05); window = active area + 0.3 mm per side (u 25.01 to 66.41, v 9.9 to 41.1); the cell frame ring (1.2 mm bearing on three sides, 4.0 mm on the flex side, from the module STEP) rests on the plate inside face. Mounting (D-184 principle kept): the module's M2 x 6 hex pillars are not used; M2 x 5 pan-head screws from the front go through the module into M2 x 3 heat-set inserts in four frame bosses on the module PCB back (0.2 mm crush ribs); printed frame 72 x 36 x 2.5 mm, face 1.5 mm behind the PCB back, window for the side-entry header, plug and cable; fixed with M2.5 screws to four Wurth WA-SMSI 9774055151R spacers (L 5.5 mm) at u 11.5 / v 11, 35 and u 77.5 / v 10, 41. The stack crosses the main board top face (v 38.87), so the main board needs a front notch: x u 6.5 to 73.5 to w 10.0 and u 73.5 to 82.5 to w 11.5 (w from the plate inside face; board edge now at w 2.3); no part is in that band on p7 | 3D fit M-103 with the Waveshare 2D drawing and STEP | 2.4 inch ILI9341 module (TN panel, viewing angle; 1.8 mm to the housing; larger notch); keep the 1.9 inch (no board change, 22 % less area than the 2.0 inch) | decided (Prins: 2.0 inch module; Claude: placement, frame, notch, for review); notch in layout p8 (M-104) |
| D-188 | 2026-10-29 | Firmware rule F15, TX without permit: when a radio's TX sense is active while its PERMIT is off, for more than 50 ms, and its permit was not on in the last 500 ms (the normal RF tail after an inhibit, F14), the shack raises an alarm: host event `!txsense <radio> nopermit`, a warning on the display, a firmware event. It does not stop by itself (no software stop); the operator decides. The emulator radio now obeys TX INH (it stops within its inhibit response time), with an option for a radio without a TX INH input | Found in the emulator by Prins: an inhibited R2 could transmit without any warning. A radio that ignores TX INH (requirements: R2, R3 may have no TX INH input), or a wiring fault, sends RF into its receive row. The A2 RF detector stops that in hardware for the loop only (D-104). A software stop would drop every relay and stop every radio, while a radio that ignores TX INH keeps transmitting into an open line | Option B: alarm and software stop (opens SAFE) | decided (Prins, option A). 500 ms grace to review with the measured inhibit response (M-12) |
| D-189 | 2026-10-31 | RF board copper under the case seats and at the relay NC pads (review 2026-10-31, B-1 and B-2). (1) Supports S1 to S6: rule areas SUP_KO, radius 4.5 mm, on F.Cu and B.Cu: no via (any layer) and no pour; tracks on F.Cu only of the support's own net CHASSIS_Sn (router keep-out); inner tracks may pass. (2) SO-239 and SMA GND screw holes (case seats B1 to B10, diameter 10): router keep-out radius 5.5 mm for every net except GND, on F.Cu tracks and all vias. (3) Relay NC pads (pad 12, nets unconnected-(K*-Pad12)) in netclass RF and in the router fixed nets: 2.0 mm outer (D-12), 0.5 mm inner (D-117), as the contact pins 11 and 14 (pad_clear_skip keeps the router's all-layer 2.0 mm pad rule off them, so the drive lines keep their inner channels) | Only solder mask separated +12V_RLY, +5V, drive and coil vias and GND pour from the aluminium seats (3.4 to 3.97 mm from the hole centre; seat radius 4.0, washer 3.5); this also joined GND to the supports and broke the CHASSIS_Sn split (D-162). Pad 12 carries the row RF while the coil is off, but had logic clearances (0.20 to 0.24 mm to GND vias and pour) | Smaller seats in the case (Ø 6); keep the layout and add insulating washers | decided (Prins, 2026-10-31: fix B-1 and B-2); drawn (M-107) |
| D-190 | 2026-10-31 | Part reuse, first step (review 2026-10-31 section 10, P-1 to P-5): one value text per part: 2k2 (RF R2, R901, R902, was 2.2k), 100n 50V X7R 0603 (RF C801, C1011 to C1041; shack C3, C64, C71), 10n 50V X7R 0603 (RF C4, controller C12); shack PC817X order code PC817X2NSZ9F as on the controller; shack U4 and U9 in VSSOP-8 0.5 mm, SN74LVC1G74DCUR, second source Nexperia 74LVC1G74DC,125 (SOT765-1, MO-187; pin-out 1 CP, 2 D, 3 Q_N, 4 GND, 5 Q, 6 RD, 7 SD, 8 VCC, Nexperia Rev 18 table 3, filed), as controller U13 (D-154) | Fewer order lines and two makers for the shack latches (was TI DCT only, R-10). The 100n parts on the bias outputs see 12.6 V (S-6): one 50 V X7R line covers every 100n | P-6 to P-13 (value and footprint changes): open, each needs Prins | decided (Prins, 2026-10-31: P-1 to P-5); drawn (M-108) |
| D-191 | 2026-10-31 | Controller board: FAULT (fault latch U13 Q) to DevKit pin 11 (GPIO6) through R66 1k 0603, so the box MCU can read the latch (review 2026-10-31 S-1). GPIO6 is an input; the 1k limits the current if the pin is ever driven by mistake. R66 sits in the free slot under U15 in the gate row | A supervisor trip while the MCU keeps running (a loop hang that ends, or a 3V3 dip above the ESP32 brown-out) sets FAULT and opens READY. The firmware saw only KILL = 1, waited in WaitSafe for good, sent no fault code, and only a power cycle helped. GPIO6 was spare and is not a strapping pin | No change: power cycle only, no diagnosis; FAULT to a spare expander pin (the expanders are in reset while RLY_EN is low, so they cannot read it) | decided (Prins, 2026-10-31: S-1). Firmware (Prins: host clearfault, as P3b-04): the box reads FAULT; after the self-test FAULT = 1 gives fault 11, READY stays open; the host `clearfault` makes the shack send link ClearFault (0x03); the box gives one LATCH_CLR edge, Ok if FAULT clears, else NotReady (link-protocol.md 4.2) |
| D-192 | 2026-10-31 | SDA select jumpers JP11 (controller) and JP61 (shack) come from the fab set for the DevKit-RUST-1: footprint SolderJumper-3_P1.3mm_Bridged12_RoundedPad1.0x1.5mm_NumberLabels (pads 1 and 2 joined by copper, KiCad net tie 1,2), project symbol SolderJumper_3_Bridged12. Pads 1 and 3 swap nets: pad 1 = SDA_IO10 (DevKit pad 17, RUST-1), pad 3 = SDA_IO7 (pad 12, RUST-2). For a RUST-2: cut the 1-2 bridge, bridge 2-3. Updates D-94 | Review 2026-10-31 S-2: with open jumpers every PCA9539 NACKs and the self-test fails; a 3-pad solder blob also joins the GPIO7 LED to SDA. The firmware uses GPIO10 (RUST-1), so the default must be RUST-1 without a manual step | Keep the open footprint, add an assembly step and a continuity check to bring-up (a step that can be missed); 0R links (an extra part, and a wrong fit is the same risk) | decided (Prins, 2026-10-31: S-2) |
| D-193 | 2026-11-01 | Bias-T drain copper (review S-3): per feed FET Q1012/Q1022/Q1032/Q1042 a drain pour (/A?_BIAS, priority above the GND pour, solid pad connection) on F.Cu over the top of its 12.9 x 28 mm cell (y 181.3 to 190.8) and on B.Cu over the whole cell, joined by 9 thermal vias 0.6/0.3 next to the tab. B.Cu carries no routes there; stitch.py puts no grid vias in the cells (router_cfg stitch_no_grid). Filled copper per FET about 95 mm2 F.Cu + 320 mm2 B.Cu = 415 mm2 (0.64 in2) | 1 in2 per FET (D-54) does not fit in the cell; the minimum pad (about 120 K/W) gives Tj about 150 °C in a held short at 55 °C and breaks D-54. 0.64 in2 on two layers with vias, over the inner GND planes, gives an estimated RthJA of about 70 to 75 K/W: Tj about 110 to 114 °C, 0.73 to 0.76 of 150 °C (C-17) | Recalculate C-17 with the minimum pad and let the firmware turn the feed off (gives up "a short stays in current limit without firmware") | decided (Prins, option 1); estimate to confirm by a held-short test on the prototype |
| D-194 | 2026-11-01 | Shack interface width 159.6 mm (review S-8): the two side edges that run in the extrusion slots move in by 0.2 mm each (x 0.2 and x 159.8 in the board frame); length, notch, rear tab and all parts stay where they are | JLC outline tolerance about ±0.2 mm against 0.2 mm play in the 160 mm slots (M-92); a 160.2 mm board would not slide in. Trim on both sides keeps the board centre at x 80, which gen_endplates.py uses for the front and rear plate holes, so the plates do not change | Trim 0.4 mm on one side (moves the centre 0.2 mm: plate holes off by 0.2 mm, or new end plates) | decided (review S-8) |
| D-195 | 2026-11-01 | Supervisor first source ADI MAX823SEUK+T for controller U12 and shack U3, U6 (review S-10); second sources TI TPS3823A-33DBVR (A version only) and Diodes APX823-29W5G-7. Value and symbol stay TPS3823A-33 (same pin-out; a value change would change the netlists and the boards) | DigiKey 19k in stock, TPS3823A-33 TI only with zero stock (Prins, 2026-11-01). MAX823 19-0487 Rev 5 (filed): pins 1 RESET_N, 2 GND, 3 MR, 4 WDI, 5 VCC as the TPS3823; S threshold 2.85 to 3.00 V; watchdog 1.12 to 2.4 s (C-19 kick 0.25 s fits); reset 140 to 280 ms; push-pull RESET_N, VOH 0.8 VCC at 150 uA: every RESET_N load is a CMOS input (U12 to U13 74LVC1G74; U3 to U4 74LVC1G74 and U5 PCA9539; U6 to U8 74LVC1G08); WDI open disables the watchdog (R64 open on the bench, U6); WDI sources max 20 uA against the 1k pull-downs R61, R62 (20 mV, low); MR internal 52k pull-up (U6 MR open); the timer is cleared during reset, no latch; -40 to 125 C (EUK) | TPS3823A-33 first (TI only, no stock) | decided (Prins, 2026-11-01); MPN, descriptions and controller hand-assembly BOM (M-118) |
| D-196 | 2026-11-01 | SO-239 J1 to J3, J7 to J10: Amphenol RF 83-1R first source, 83-798 second (reverses the choice in D-10). Value and footprint stay (SO239_83-798_StrapPad, same flange). Halogen exception to D-135: the 83-1R PBT insulator has no halogen statement; the reason is supply (83-798 single source, 16 weeks) | Prins, 2026-11-01: 83-1R in stock at DigiKey. Drawings 83-1R rev AM and 83-798 rev AG: same 1.000 in square flange, 0.718 in hole pitch, 0.125 in holes, 0.656 in panel hole, .625-24 NEF thread, 0.620 in body, 0.557 in flats; front 0.625 against 0.623 in; overall 1.062 against 1.047 in (rear about 0.4 mm longer). 83-1R cup position 0.312 +- 0.100 in: the cup tip can sit up to 2.5 mm further in than nominal; the strap (D-15) takes it, and the cup is on the J pad 1 net. RF at HF: PBT (er about 3.2) against PTFE (2.1) has no effect below 30 MHz | Keep the 83-798 first (PTFE, halogen-free, 16 weeks) | decided (Prins, 2026-11-01). Risks: PBT softens at the strap solder heat, so solder fast and check that the centre contact does not move or turn (bench, first part); halogen status to ask Amphenol. A-05 and M-03: measure the 83-1R |
| D-197 | 2026-11-01 | RF creepage 2.0 mm (D-12) accepted for the prototype order without a check against the standards (review Decide item). C-05, A-01, S-03 and S-04 stay open: read IEC 60664-1 table F.5 and IEC 60664-4 before any product use or a second batch | Private ham build, small batch; 2.0 mm is above the remembered PD3 value (about 1.9 mm at 125 V rms, group IIIb) for 122 V rms (A-03). A larger value means new RF clearances and a full router run, and the board may not fit. IEC 60664-4 covers up to 10 MHz (S-04), so 14 to 30 MHz is outside its scope anyway | Buy IEC 60664-1 and -4 and check before the order (cost, delay, possible re-layout) | decided (Prins, 2026-11-01). Residual risk: surface tracking over years in a humid box. Check the boards for tracking marks at each opening of the box |
| D-198 | 2026-11-01 | RT1 (RTD14012F) open-contact isolation at HF accepted without a coupon test (review Decide item): buy all relays for the build at once. M-01 runs on the first assembled RF board instead of a coupon: NanoVNA through the SO-239s, isolation, insertion loss and match at 1.8, 3.5, 7, 14, 21, 28 and 50 MHz | TE gives no HF data (A-04). Voltage (1000 V rms open contact against 173 V peak) and current (16 A against 2.45 A) are well inside the rating. Estimate only: about 1 to 2 pF across an open contact gives about 30 dB per contact at 28 MHz (100 W to about +18 dBm at the other port); two open contacts in series give more. The footprint is fixed, so the result does not change the layout | Test 4 relays on a coupon first, then buy the rest (delay; coupon to design) | decided (Prins, 2026-11-01); Prins measures. Risk: poor isolation shows only on the finished board; the fix is then a relay change |
| D-199 | 2026-11-01 | Unit PSU in the RVS box: Mean Well HDR-30-12 (12 V 2 A, set to 12.0 V) feeds both XT60 inputs (+12V_RLY and +12V_AUX, one lead each); Mean Well HDR-15-5 (5 V 2.4 A) feeds the XT30 (+5V). DIN rail, 52.5 mm wide together. Clip-on ferrites on the DC leads | Need per unit (C-13, D-45): +12V_RLY 0.43 A, +12V_AUX 0.5 A, +5V about 0.2 A; 12 V rails 11.4 to 12.6 V, 5 V rail 4.75 to 5.25 V (a 13.8 V station supply is too high). HDR-30-12: +-1 %, adjustable 10.8 to 13.8 V; HDR-15-5: +-2 %; both hiccup overload (a few A), -30 to +70 C, EN55032 class B (Mean Well specs, filed). Short-circuit current far below the 50 A breaking capacity of the 0468001.NR fuses (A-13 closed) | Mean Well RD-50A dual output (12 V channel +-7 %: 11.2 to 12.8 V, outside the window; needs > 10 % load on 5 V); linear 12 V supply (heavy, heat in the box) | decided (Prins, 2026-11-01). Risk: switch-mode supplies near the antennas (A2 RX loop): listen test on A2 with the PSU on and off; fallback a linear 12 V supply |
| D-200 | 2026-11-01 | Part merges P-6 to P-12 (review section 10) declined; P-13 only for the RF board: RF C6, C7 get a 47 uF 35 V polymer part in 6.3 mm at B-3 (MPN only); shack C1 stays the 47 uF 35 V radial | Each merge saves one order line but changes a value or a footprint on a board that is nearly order-ready: new netlist, board rebuild and DRC, and for P-6 and P-8 a new controller zip. P-9 reverses D-124, P-10 needs a new C-21 headroom check, P-12 a surge check, P-7 dims the front LEDs | Apply all (up to 8 order lines fewer) | decided (Prins, 2026-11-01) |
| D-201 | 2026-11-01 | Case items (review Decide row): (1) end plates fixed with pan-head ST3.5 x 8 self-tapping screws, no countersink on the PCB plates (A-27); (2) WA-SMSI spacers stay on the 6.0 mm pad without NPTH; solder one on a test plate and check 0.35 N m and a pull by hand; fallback: drill 3.7 mm by hand (A-29); (3) unit 2 ribbon slot milled now, in the CNC order: plain slot about 32 x 3 mm for the 24-way 1.27 mm ribbon (30.5 mm wide), with a grommet or a clamp; position set in the case CAD update before the CNC resubmit (S-14, S-15), and the controller EXP header is placed to match when it is drawn (D-53) | (1) pan head seats flat on the 3.7 mm plated ring, no fab note; (2) frame load is small and the hole can still be drilled later; (3) a slot costs little in the first CNC setup and saves a second setup on a finished case; a 32 mm slot has its cutoff far above HF | (1) JLC 90 degree countersink to 5.5 mm; (2) add the NPTH now (dot on the front); (3) machine the slot later | decided (Prins, 2026-11-01) |
| D-202 | 2026-11-02 | Detector tap C404 to C704: Knowles 1206J1K04P70CCT (4.7 pF 1 kV C0G, +-0.25 pF) on a project 1206 land C_1206_3216Metric_RFgap2.0: pads 1.25 mm wide at +-1.625 mm, gap 2.0 mm (RF gap, D-12, D-111); pad 1 (ANT) 3.4 mm high as the 1812 land, pad 2 (detector) 2.0 mm high. Footprints swapped in place on the board; tracks unchanged and still end on both pads. RF schematic v12j-c4-1206, netlist rf16 (only these 4 footprints differ from rf15), ERC 0, DRC 0 violations (30 unconnected relay pad 12 as before). routing/geom.json still has the 1812 pads: export again before any re-route | Stock check 2026-11-01: no stocked or active 4.7 pF 1 kV C0G part in 1812 (Vishay VJ HV C0G starts at 10 pF and is obsolete); Knowles 1206 about 7,300 at DigiKey. A standard 1206 land has a 1.8 mm pad gap, below the RF rule; the 2.0 mm gap still puts the full 1206 termination (1.1 to 1.6 mm from the centre) on the pad | 1206 part on the existing 1812 pads (0.15 to 0.35 mm termination overlap; no board change) | decided (Prins, 2026-11-02). Single source |
| D-203 | 2026-11-05 | Radio SO-239 R1 and R2 moved for the case pocket corner: J1 board x 12 to 18, J2 42 to 45, J3 stays at 72 (pitch 27 mm, flange gap 1.6 mm). Case x 28, 55, 82; GND bosses case x 42 and 69 (board GND holes x 32 and 59). Bottom-wall lid lug and lid screw from case x 67 to 68 (between the R2 and R3 bores; the lug takes the inner 0.5 mm of the R2 right flange holes and keeps 0.5 mm from the R3 left ones; at 68.5 both hole edges came within 0.03 mm of the lug edge and the CAD face failed). A4 right flange holes (case x 272.12) tapped to the wall thickness (depth wall, not so_tap). Feeds unchanged: R1 x 90, R2 x 81, R3 x 72. Supersedes the R1 and R2 positions of D-21 | At x 12 the R1 bore (16.7 mm) cut up to 0.28 mm into the R10 pocket corner and the two left R1 flange holes broke out through the radius; the A4 right flange holes touched the bottom-right radius. At x 18 the R1 flange holes keep 1.6 mm of wall to the radius. A smaller pocket radius leaves too little metal at the corner lid M3 (R6: 1.0 mm, R8: 1.8 mm, R10: 2.6 mm) | (1) R1 to R3 all +6 mm with the 30 mm pitch: R3 at x 78 comes 3 mm from the R1 feed at x 81, so the feeds move and S5 loses its 0.5 mm margin; (2) pocket R6 or R8 with the connectors unchanged; (3) keep R10 and deburr the corner | decided (Prins, 2026-11-05) |
| D-204 | 2026-11-07 | Tray designed for milling (JLCCNC CNC design guideline): every concave vertical edge in the pocket R >= 6.5 (Ø12 end mill, pocket 58 deep; rule R >= depth/10 + 0.5 = 6.3). The material a Ø13 tool cannot remove becomes a milled fill, per z band (5-15, 15-16, 16-18, 18-63): GND bosses B1 to B7 and the support bosses near the walls are joined to the wall, pads and lugs get R6.5 fillets. Board keep-outs stay air: RF copper on B.Cu 2.0 mm (z 16-18), other B.Cu copper 0.5 mm (z 17-18, not the own CHASSIS_S pad of a support), parts below the board 0.5 mm, SMA pin and strap 2.0 mm. SMA GND bosses B8 to B10 moved from (14, SMA+9) Ø10 to (13.5, SMA+13) Ø8 so the tool reaches the SMA pin; RF board J4 to J6 GND holes moved to board (3.5, 48.5 / 96.5 / 144.5) with 3 reroutes, CASE_KO rule areas (no pour, no vias) where the fill touches the board underside. M5 pads 10 high and M5 tapped through (15); EXP plate M3 tapped through the wall; SMA centre bore 5 deep (exits through the fill skin); SMA lower M2 pair blind 3.5; SO-239 R3 upper-left M3 8 deep (through the lug fillet) | Prins, 2026-11-06: easier and cheaper milling, standoffs near the edge joined to the wall, deeper holes are easier to tap. Free-standing bosses and 90 degree corners need small long tools; a joined boss is one contour pass. | Bosses free-standing (cost); fill without board keep-outs (case touches RF copper); 45 degree web to the SMA bosses (superseded by the move) | decided |

## 3. Assumptions

| ID | Assumption | Basis | To confirm by | Status |
|---|---|---|---|---|
| A-01 | FR-4 material group IIIb (CTI 100 to 175) | JLC gives no CTI; JLC blog: standard FR-4 about CTI 175; skill rule | JLC or laminate datasheet | assumed; accepted for the prototype (D-197) |
| A-02 | Pollution degree 3 inside the case | Outdoor box, condensation possible | – (conservative choice) | assumed |
| A-03 | Working voltage 173 V peak / 122 V rms on RF lines | 100 W, SWR 3:1, 50 Ω (C-01) | – | assumed (calculated) |
| A-04 | RT1 open-contact isolation adequate at HF | Not in datasheet | RT1 isolation test (postponed) | to confirm; accepted for the build, measured on the first RF board (D-198) |
| A-05 | 83-798 rear dimensions (body about 4 mm, cup tip about 9.6 mm behind flange) | Scaled from drawing Rev. AG | Measure a real part | confirmed: real 83-1R fits (Prins, 2026-11-09) |
| A-06 | Crossing coupling negligible | C-04 | Layout review / measurement | superseded by C-32 (crossings shielded) |
| A-07 | XT polarity: KiCad footprint pad 2 = + | Vendor STEP puts the angled end on pad 2; convention angled = − | Real part | confirmed (M-131): real parts have + on the flat side (Prins, 2026-11-09); the vendor STEP on the boards has the angled end on pad 1 (GND), so pad 2 = + is right |
| A-08 | Short parallel run of R1 and R3 feeds acceptable | Gap ≥ 2.0 mm | – | superseded by D-24 (run removed) |
| A-09 | Bleed topology: 1 MΩ parallel to the RF choke from K1 NC to GND (rev A text "1 MΩ ∥ RF choke") | Rev A antenna card doc; rev C says "1 MΩ with RF choke" | Prins | superseded by D-32 |
| A-10 | DC block on a bias-T port sees no TX current | Bias-T only on RX-only ports (A2); no TX relay on an RX-only column | Interlock design and test (TC-07) | H1 closed by D-103 (A2 TX relays not fitted). H2 covered by D-104 (RF on A2 opens the SAFE loop; about 7 ms of RF at A2 before the relays open), 2026-10-06 |
| A-11 | Detector as a resistive tap on the column side of the DC block, Schottky peak detector, DET to a comparator on the logic sheet | Rev A: Schottky + comparator presence detector | With the detector part choice | superseded by D-47 (capacitive tap instead of resistive) |
| A-12 | Second source for the coil MOSFET | Diodes DMN61D8L (DS37630 Rev 4-2, 2018-06): 60 V; VGS(th) 1.3 to 2.0 V; RDS(on) max 2.4 ohm at VGS 3 V (drop about 0.08 V at 33 mA); internal active clamp at or above 60 V, so the external 37.5 V clamp takes the energy; gate leakage up to 60 uA at 3 V (fine with the expander drive and the gate pull-down); SOT-23 G-S-D, same as BSS138BK; halogen-free (Diodes note 3); AEC-Q101. Drive margin: 3.1 V gate (3.3 V -5 %) against 2.0 V max threshold. onsemi BSS138 rejected (50 V, RDS(on) only to 4.5 V) | Datasheet check 2026-09-27; production status (page marked 'Advanced Information') to confirm at order | confirmed (status to check at order); second source changed to onsemi 2V7002KT1G (D-128). Closed by D-134 (review S-17, 2026-11-02) |
| A-13 | PSU location | The PSU sits in the RVS box; power leads to the case are short and stay inside the box (Prins 2026-09-27). PSU type and short-circuit current still unknown: must stay below the fuse breaking capacity (50 A) | Prins; PSU data to add | closed: Mean Well HDR-30-12 and HDR-15-5, short-circuit current a few A (D-199) |
| A-14 | Brown-out window and power ramp are safe | U12 asserts RESET_N from VDD 1.1 V; LVC logic is specified from 1.65 V; between 3.0 V (ESP32-C3 minimum) and the U12 threshold (2.83 V min) the MCU can run out of specification, but FAULT stays set only after a reset, so a glitch on MCU_EN_N could enable relays in that window; below 1.65 V the U14 output is not specified (R3 100k pull-down on the RF board, RF board expanders in reset) | Bench test: slow 3V3 ramp up and down with RLY_EN on a scope (M- line) | to confirm |
| A-15 | FT-710 TX INH (TUNER/LINEAR 8-pin mini-DIN) stops transmission at a logic level still unknown; enabled by menu "TX INHIBIT" (OFF/ON, default OFF); "TUN/LIN PORT SELECT" = LINEAR. Pin names from the OM drawing (EH080H201, 2307N-GS, p. 14): RESET (BAND D), TX INH, BAND C, RX D (BAND B), GND, +13V OUT, TX D (BAND A), TX GND; level, input current and pin numbers not stated | FT-710 Operation Manual; CAT manual menu 07 TX INHIBIT, TX status 2 = TX INHIBIT | Bench test on the radio: measure the open TX INH pin voltage, then pull it low through 1k with the menu ON and key the radio | to confirm |
| A-16 | Shack USB: all shack USB devices (radios and, from now, the shack interface HAT) connect to the Mac through Prins's Delock 64226 (4-port USB 2.0 isolator hub: low, full and high speed; 5 kV data, 3 kV power isolation; isolated power from its own 5 V 2 A PSU); only keyboard, monitor and webcam connect directly. So the HAT has no USB isolator of its own, and the HAT is fed from the shack supply (no load on the isolated USB supply) | Prins, 2026-09-29 | Speed confirmed from the Delock product page (full speed supported, ESP32-C3 is full speed). HAT DevKit: VBUS from the isolator reaches only the disabled on-board buck (ENABLE to GND, as D-55), so no back-feed; to confirm on the HAT drawing | decided (speed); to confirm (VBUS) |
| A-17 | FT-710 TUNER/LINEAR pin 6 (+13V OUT) current limit about 80 mA | Prins, 2026-10-03, online information | Port load: FEED about 6 mA plus the INH HIGH source (D-90, 4.2 mA), about 10 mA in total: 0.13. Confirm in the FT-710 manual or by measurement | assumed |
| A-18 | FT-710 tuner port behaviour, read from the FC-40 schematic (Yaesu FC-40 manual, for FT-857D/897D): the tuner drives TX INH high through a Schottky diode and 270R from its 5 V logic (47k pull-down in the tuner), so the radio TX INH input is active high at about 5 V with its own pull-down; TX GND is an open-collector output of the radio (the tuner pulls it up through 47k and a Schottky); RESET, DATA IN and DATA OUT (BAND D, B, A in LINEAR mode) have 270R, 100 uH and 1 nF in the tuner | FC-40 manual (filed); same port family on the FT-710 assumed | Bench test as A-15 with a 5 V source, not 13.8 V | assumed (FT-710 to confirm) |
| A-19 | The DevKit in hand follows the esp-rs/esp-rust-board README (github.com/esp-rs/esp-rust-board, board named ESP32-C3-DevKit-RUST-1, diagram v1.2): right header 1 VBAT, 2 EN, 3 VBUS, 4..8 NC, 9 IO18/D-, 10 IO19/D+, 11 IO8/SCL, 12 IO10/SDA; left header as the RUST-2 except IO7 = LED. Board I2C SDA GPIO10, SCL GPIO8. The RUST-2 (Espressif schematic Rev 2.0) has SDA on GPIO7 (left 12), LED on GPIO10, right 11 and 12 not connected. So the SDA position differs between the two boards; SCL (GPIO8, left 13), EN, D-/D+ and the left header match | Prins, 2026-10-04: board in front of him, the GitHub page is correct; Espressif user guide is a general dev-kit document | Confirmed 2026-10-04: Prins's board is ESP32-C3-DevKit-RUST-1; esp-rs schematic Rev 1.2a (2022-04-27) filed: SDA IO10 (pad 17), SCL IO8 (pads 13 and 18), 10k pull-ups R17/R18, LED on IO7 (470R), WS2812 on IO2; power path the same as the RUST-2 (D6, D4, Q1, SY8088 EN), so D-55 holds | confirmed |
| A-20 | RF on A2 from coupling stays below the detector threshold while another antenna transmits | The A2 detector reacts at about 6.9 V peak on the column (C-15, about 0.5 W). A loop near the G5RV may pick up a part of 100 W. Above the threshold every TX on A1 would open the SAFE loop (D-104): no hazard, but no TX possible | Measure the A2 column voltage while the FT-710 sends 100 W on A1 and A3 (M- line); if needed, raise the A2 threshold or park the loop (K1-A2 off) during TX | to confirm |
| A-21 | EXP SMA contact reaches the board-edge strap land across the 4 mm gap to the left wall | Drawings filed 2026-10-19 (132142 Rev NC, 901-9215 Rev G): the contact reaches only 5.07 mm behind the flange and there is no rear body. Through the full 6 mm wall it ends about 0.9 mm inside the wall hole: it does not reach the board. A wall pocket or a different part is needed | Mounting decision, then a real part (calliper) | closed: real Cinch 142-0701-631 fits (Prins, 2026-11-09) |
| A-22 | A 4.7 pF 1 kV C0G capacitor exists in 1812 from two makers (detector tap, D-111) | HV MLCC series in 1812 (for example Vishay VJ HV, Knowles) list C0G values in the pF range at 1 kV; not checked on a datasheet | Datasheet check before the BOM | closed by D-202: no 1812 part; 1206 on a 2.0 mm gap land |
| A-23 | JLC06161H-7628A combines with halogen-free FR-4 (D-107) and the order cost of a 268 x 230 mm 6-layer board is acceptable | JLC quote form 2026-10-19 (6 layers, 268 x 230 mm, 5 pcs, 1.6 mm, 1 oz / 0.5 oz, Specify Stackup = JLC06161H-7628A): engineering fee 33.00 USD, stackup fee 114.54 USD, board 39.80 USD, total 187.34 USD, build 8 to 9 days, shipping about 37.60 USD. Material types offered for 6 layers: FR4 TG135, FR4 TG155, Nan Ya NP-140F, NP-155F, KB-6165, S1000H, Shengyi S1000-2M; none is listed as halogen-free. Surface finish for 6 layers: OSP or ENIG only (HASL not offered). The form notes that this special stackup does not support economic PCB assembly (hand assembly, no effect) | Price: Prins. Halogen-free: ask JLC, or set D-107 aside for this board as with D-42 | closed: halogen set aside for this board (D-118); price recorded |
| A-24 | Board-to-board link J2/J14 across the 19.7 mm gap: Samtec ESW-112-33-G-D elevated socket on the controller board underside with the standard 2 x 12 header on the RF board gives about 4.8 mm pin engagement (insertion depth 3.68 to 6.35 mm), if B = 16.13 mm is the socket height above the board | Samtec ESW catalogue (lead style -33: A 2.29, B 16.13 mm); the definition of B is not stated in the catalogue text | Samtec ESW drawing and STEP; 3D fit check | B confirmed (Samtec F-226 drawing: seating plane to insulator top; ESQ-112-37-G-D-LL STEP 8.51 + 2.54 = 11.05 mm). Lead style -37 (Prins, 2026-10-20) is 5.08 mm too short for the standard header; closed by D-139 and M-53 (ESQ-112-33-G-D, engagement 5.05 mm) |
| A-25 | 2026-10-25 | Shack interface board 159 mm long in the Hammond 1455T1601 extrusion (body 160 +-0.5 mm, drawing 1455T1601); the 7805 tab back face 2.6 mm inside the board edge reaches the inner side wall (inner width 155.5 mm, board 160 mm in the slots) and its mounting hole height clears the slot ribs | Hammond drawing values without labels (155.50, 160.00 +-0.50, 43.53/46.63, 11.50/8.00) | Check with the Hammond STEP model of 1455T1601 before the order (3D fit, verification.md) | confirmed with the Hammond STEP (M-92): board 160 wide seats in the slots (0.2 mm to the slot flanks), 159 long fits (1.1 mm to each bezel); 7805 tab back face 0.34 mm from the side-wall fin tips (insulating pad fills it); board in the 2nd slot from the bottom. New open point: connector faces 1.85 to 2.55 mm behind the end panels (D-177). Open point closed by D-177 (M-93) (review S-17, 2026-11-02) |
| A-26 | 2026-10-25 | JLCPCB 4-layer accepts the USB-C fan-out: 0.15 mm tracks, 0.4/0.2 mm vias, and the 0.18 mm gap between the J14 GND pads A1/B12, A12/B1 and the NPTH pegs of the KiCad USB4105 footprint (GCT land pattern) | JLCPCB capabilities page (4-layer: 0.09 mm track, 0.15 mm via drill); the peg gap is part of the maker's land | Confirm in the JLCPCB quote form (DFM check) before the order | assumed |
| A-27 | 2026-10-26 | End plate screws: the Hammond screws are self-tapping, shank 3.5 mm, countersunk head 5.5 mm, 8 mm long (measured on the Hammond STEP). The PCB plates have plain 3.7 mm plated holes, so the countersunk head stands about 1.4 mm proud; a pan-head ST3.5 x 8 (or 9.5) screw seats flat on the copper ring | SolidCraft fit: the countersunk screw models overlap the PCB plate by 9.3 mm3 each (head in a plate without countersink) | Check with the real screws; if the countersunk look is wanted, ask JLC for a 90 degree countersink to 5.5 mm on the outside face | decided (D-201: pan-head ST3.5 x 8) |
| A-28 | 2026-10-26 | Front plate thickness against the panel parts: Dialight 558 snap-in LEDs take a panel of 0.79 to 1.57 mm; the JLC 1.6 mm plate is at or just above that. EAO 84 (1 to 4 mm), C&K 8125 bushing and the display take 1.2 or 1.6 mm | Datasheets | Decision with Prins: 1.2 mm front plate or another LED holder | decided (Prins, 2026-10-26): plates stay 1.6 mm for stiffness under the KILL and RESET press; Dialight 558 to try on the first plate, another holder if it does not snap in |
| A-29 | 2026-10-27 | WA-SMSI spacers on a 6.0 mm pad without the 3.7 mm NPTH of the Wurth land pattern, so the outside face stays closed. The solder joint is then the ring face and the outer fillet only; hand soldering (hot air) is outside the Wurth process (reflow profile only) | Wurth datasheet 9774055151R: pad 6.0 mm, NPTH 3.7 mm, max torque 0.35 N m; the frame load is small | Solder one spacer on a test plate and check it against 0.35 N m and a pull by hand; fallback: drill the 3.7 mm hole (a dot on the front) | decided (D-201: no NPTH, test plate check) |
| A-30 | 2026-10-27 | Rear-plate USB-C panel extension: generic part without a maker drawing; cut-out, screw pitch, depth behind the plate, cable length, plug angle direction and wiring (USB 2.0 data lines and shield continuity at least) are unknown | Shop pages (Melopero, The Pi Hut, Core Electronics) give no dimensions | Measure the part on arrival; check shield continuity jack shell to plug shell and D+/D- with a meter; then add the cut-out and two plated CHASSIS holes to gen_endplates.py (rear plate above the connectors, v below 26, or in a gap of 18.9 to 24.5 mm between them) | superseded (D-186: no panel extension) |
| A-31 | 2026-10-28 | Waveshare 2inch module back: the STEP shows no SMD parts on the PCB back; the frame face keeps 1.5 mm from the PCB back for parts up to about 1.3 mm. Cell frame ring widths are from the STEP only (on the 1.9 inch, Prins measured 0.8 mm on the side opposite the flex, as the model, and 1.6 to 1.9 mm on the others, wider than the model) | Waveshare STEP and 2D drawing | Check the back parts and the ring widths on the real module before the frame is printed |

## 4. Calculations

| ID | Calculation | Inputs | Method | Result | Status |
|---|---|---|---|---|---|
| C-01 | Worst-case RF current and voltage | 100 W, 50 Ω, SWR 3:1 | Standing-wave maxima: I = √(P/Z)·√SWR, V = √(2PZ)·√SWR | 2.45 A rms, 173 V peak | decided |
| C-02 | 50 Ω CPWG, gap 1.25 mm | JLC0216A, 1 oz, core 1.43 mm | JLC calculator | 2.5128 mm (no mask), 2.4559 mm (mask) | superseded by C-03 |
| C-03 | 50 Ω CPWG, gap 2.0 mm | as C-02 | JLC calculator; own conformal-mapping check (Er fitted 4.41) gave 2.70 mm | 2.6838 mm on L1 and L2 (no mask) | decided |
| C-04 | Coupling at a row/column crossing | 2.5 × 2.5 mm overlap, 1.6 mm FR-4 | Parallel plate | about 0.16 pF, about 60 dB isolation at 30 MHz | superseded by C-32 |
| C-05 | Creepage at 122 V rms | Group III, PD2 / PD3 | EN IEC 60664-1 creepage table, 125 V row (values from memory) | PD2 about 1.2 mm; PD3 about 1.9 mm | to confirm with copy; 2.0 mm accepted for the prototype without the copy (D-197) |
| C-06 | Arrestor margin | 173 V peak vs CS-400R 400 V ±15 % | Ratio at minimum | 0.51 | decided |
| C-07 | Relay count and coil power | 3 × (1 + 5 + 5) + 4 | Count | 37 RT1 positions, 400 mW each; unit 1 fits 34 (D-103) | decided |
| C-08 | Board and case size (8 mm band) | Placement study v3 | Drawing | Board 250 × 216 mm, case 270 × 236 × 60 mm | superseded by C-11 |
| C-09 | Trace current 2.45 A rms in 2.7 mm, 1 oz outer | IPC-2152 | – | low rise expected; to record in layout notes | superseded by C-31 |
| C-10 | Via fence offset | W/2 + S + via pad radius + 0.05 mm | Skill rule | 1.35 + 2.0 + 0.5 + 0.05 = 3.9 mm; RF band about 9 mm | superseded by C-33 |
| C-11 | Board and case size (9 mm band, 36 mm columns) | Placement study | Drawing | Board 260 × 230 mm; case 280 × 250 × 60 mm | superseded by C-12 |
| C-12 | Board and case size (9 mm band, 38 mm columns) | RT1 29 × 12.7 mm; band 9 mm; radio block 48 mm; column pitch 38 mm, line 36 mm from cell start; feeds at x 72, 81, 90; logic zone 32 mm; antenna port zone 34 mm; strap zone 10 mm | Placement study (gen_relay_placement.py) | Board 268 × 230 mm; case outside about 288 × 250 × 60 mm | decided (study) |
| C-13 | RT1 coil voltage budget (worst case, skill section 14) | Operate voltage 8.4 V max at 23 °C, cold coil, no pre-energization (RT1pb rev 4); copper +0.393 %/K; case air 55 °C assumed (A1 45 °C + about 10 K from max 13 coils on = 5.2 W); re-energized hot coil +24 K assumed (400 mW, to confirm); +12V_RLY min 11.4 V; high-side switch drop about 0.05 V | Extreme-value, own calculation | Required: 9.5 V (cold coil at 55 °C), 10.3 V (hot coil at 79 °C). Available: ULN2803A (ST DS rev 4: VCE(sat) 0.9 typ / 1.1 V max at 100 mA) gives 10.25 to 10.45 V: margin -0.05 to +0.2 V, fails or marginal. Low-side MOSFET (about 0.1 V at 33 mA) gives about 11.25 V: margin about 1 V | assumed inputs, to confirm (case temperature, coil rise) |
| C-14 | 3.3 V LDO load and heat, RF board (U1 LP2985-33), recomputed 2026-10-19 from rf9.xml | 4 × PCA9539 IDD max 200 µA at 5.5 V (NXP DS Rev 9.1) = 0.8 mA; I2C pull-ups R901, R902 2.2 kΩ, both lines LOW = 3.0 mA; EXP_INT R903 10 kΩ = 0.33 mA; RF detect pull-ups R801, R831 to R834 10 kΩ, all LOW = 1.65 mA; 40 driver outputs HIGH into 100 kΩ gate pull-downs = 1.3 mA. +5V max 5.25 V | Own calculation, worst case (all pulls LOW, all outputs HIGH at once) | About 7.1 mA against 0.7 × 150 = 105 mA: ratio 0.05, pass. Loss (5.25 − 3.3) × 0.0071 = 14 mW: no heat issue. The PCA9615 load of the first version is gone since D-53 | decided (recomputed) |
| C-15 | RF detector range (D-47, D-48) | Tap k = 4.7 / (4.7 + 47 + 2 diode + 2 layout) = 0.084 (1:11.9), C0G tolerance about 7 %; doubler: DET = 2 (k Vp - VF), comparator input DET / 2 = k Vp - VF; doubler source impedance about 1 / (f C) = 10 k at 1.8 MHz against 94 k load (0.9); BAS70 VF 0.25 V nominal, 0.32 V cold; VREF 0.3 V + 15 mV LM2901 offset; SWR 3 voltage minimum = 0.5 x forward peak; 173 V peak maximum | Own calculation (script in the session) | Threshold at the column: 6.9 V peak nominal, 8.5 V worst = 0.48 to 0.73 W at SWR 1, 1.9 to 2.9 W at the SWR 3 voltage minimum. Maximum: DET 30.7 V (C3 50 V: 0.61), comparator input 15.4 V against 36 V (0.43), each BAS70-04 diode about 31 V reverse against 70 V (0.44), C4 158 V against 1 kV (0.16). Line loading 4.3 pF: return loss 34 dB at 30 MHz, 29 dB at 54 MHz; C4 current 0.25 A peak at 54 MHz | calculated; to measure on the first board (M- line) |
| C-16 | I2C pull-ups on the RF board bus (D-52) | PCA9539 Ci 10 pF max x 3 (NXP DS Rev 9.1); PCA9615 A side Cio 10 pF max (NXP DS Rev 2, unit 2); MCU pin about 10 pF (to confirm with the MCU); traces and J14 about 25 pF (estimate, 2-layer); VDD 3.3 V; PCA9539 IOL min 3 mA at VOL 0.4 V | Rmin = (3.3 - 0.4) / 3 mA; rise time tr = 0.8473 x R x Cb (I2C spec, 30 to 70 %), Cb design value 100 pF | Cb about 75 pF, design value 100 pF. Rmin 0.97 kOhm. 2.2 kOhm: tr 0.19 us (Fast-mode limit 0.3 us), sink 1.5 mA. PCA9615 A side output VOL up to 0.6 V (static offset) against PCA9539 VIL 0.3 x VDD = 0.99 V: margin 0.39 V | decided; Cb to confirm on the layout. Unit 2 (D-53): plus about 35 pF for 0.5 m ribbon, total about 130 pF: tr 0.24 us at 2.2 kOhm, Standard-mode limit 1 us |
| C-17 | Bias-T current limit and short-circuit heat (D-54) | BC857 VBE -600/-650/-750 mV at IC 2 mA, VCE 5 V, 25 °C (Nexperia Rev 9); limiter works at about 0.2 mA: about 60 mV lower (estimate, to confirm on Fig. 7); tempco about -2 mV/K (to confirm); Rs 10R; +12V_AUX 12.6 V max; preamp 36 mA (LNA evaluation); IRFL9014 RthJA 60 K/W on 1 inch2 FR-4, Tj max 150 °C (Vishay Rev G); NTF2955 65 K/W on 1 inch2, 175 °C (onsemi Rev 8); board ambient -20 to 55 °C | I = VBE / Rs; P = 12.6 V x I in a short; Tj = Ta + P x RthJA | Limit 48 to 78 mA over -20 to 55 °C (42 mA min at 85 °C): preamp 36 mA passes with 12 mA margin at 55 °C. Short: 0.98 W max at -20 °C (Tj about 39 °C); 0.79 W at 55 °C, Tj about 102 °C: 102 / 150 = 0.68 (IRFL9014), 0.58 (NTF2955), below 0.8. Rs 61 mW max / 125 mW = 0.49. VGS 8.6 / 20 = 0.43; VDS 12.6 / 60 = 0.21; BC857 VCE 12.6 / 45 = 0.28 | decided; VBE at 0.2 mA and tempco to confirm. Drain copper (D-193): 0.64 in2 on F.Cu + B.Cu with 9 vias, not 1 in2; estimated RthJA 70 to 75 K/W, Tj 110 to 114 °C at 55 °C (0.73 to 0.76); confirm by a held-short test on the prototype |
| C-18 | Box transmit loop speed, PC817 (D-56) | Sharp PC817X D2-A03101EN (2003-09-30): tr, tf typ 4 us, max 18 us at VCE 2 V, IC 2 mA, RL 100 ohm; Fig. 13 (VCE 2 V, IC 2 mA, 25 °C, typical, 'not for guarantee'): at RL 1 kohm tr about 18 us, tf about 17 us, td about 3 us, ts about 1.5 us; at RL 10 kohm about 60 to 70 us. CTR min 50 % at IF 5 mA (rank-free), VCEO 80 V (35 V before date code P7, 2002), -30 to 100 °C. Loop 10 mA from 12 V through about 1.1 kohm at the shack (RL about 1.1 kohm) | Edge time from Fig. 13 at RL 1 kohm; UART bit time 1 / baud; the shack 6N137 switches at 2 to 5 mA of the 10 mA, so the asymmetry of on- and off-delay distorts the bit, not the full edge | Edges about 20 us typical; storage time rises when the transistor is driven deep into saturation (IF 15 mA, CTR rank B 130 to 260 %: up to about 39 mA capability for a 10 mA loop), not shown in Fig. 13. 19.2 kbaud: bit 52 us, a 10 to 20 us distortion is 20 to 40 % of a bit: too little margin on paper. 9600 baud: bit 104 us, 10 to 20 % | proposal: 9600 baud design value; 19.2 kbaud only after an M- line measurement. LED drive: BSS138BK from a GPIO, IF about 15 mA from +5V, CTR rank B or better |
| C-19 | Watchdog and latch timing (D-59) | TPS3823A-33 (SLVS165O): tout 0.9 / 1.6 / 2.5 s, td 120 / 200 / 300 ms, VIT- 2.83 / 2.93 / 3.00 V; LP2985-33 output 3.3 V; ESP32-C3 boot to application a few hundred ms (to measure) | Datasheet limits; firmware must kick WDI within the minimum time-out | Kick period 0.25 s or less (margin 3.6 on 0.9 s). The first kick after power-up must come within 0.9 s after RESET_N goes high, otherwise U12 resets again and FAULT stays set (safe). Relays can switch on at the earliest after td (120 ms) plus the firmware clear. U12 VDD 3.35 / 6 = 0.56; LVC VCC 3.35 / 6.5 = 0.52; 55 / 125 °C = 0.44 | decided; boot time to measure |
| C-20 | FT-710 TX delay against K0 (F7) | FT-710 OM: "QSK DELAY TIME" 15 / 20 / 25 / 30 ms (default 15), "valid in all communication modes", and the delay acts on the TX GND pin of the LINEAR jack; K0 settled after 8 ms operate + 4 ms bounce (RT1pb rev 4) | Compare | 15 ms default gives 3 ms margin; 20 ms gives 8 ms. Proposal: QSK DELAY TIME 20 ms. Assumes TX GND closes at PTT and RF starts after the delay (OM wording; to confirm with a scope on the first board, M- line) | proposed |
| C-21 | SAFE loop headroom at 10 mA (the loop with the most drops) | Series drops, estimate: current source headroom about 1 V; shack sense opto LED about 1.2 V; shack and box entry resistors 4 x 47R about 1.9 V; cable, 2 x 50 m 24 AWG (length assumed) about 0.1 V; box 220R 2.2 V; VO2611 LED about 1.5 V; READY PC817 VCE(sat) about 0.2 V; software stop switch about 0.5 V | Sum of series drops, own estimate | Total about 8.6 V against 12 V minimum supply: about 3.4 V margin | estimate; to confirm with the datasheet values and the real cable length |
| C-22 | PhotoMOS LED drive current (CPC1117N and TLP4176G on one footprint) | IFT or IF to operate max: TLP4176G 3 mA, CPC1117N 1 mA (3 mA recommended above 60 °C); Toshiba AKX01280: design IF = IFT(max) x a1 (LED ageing, 1.43 for 85 °C and 100 kh) x a2 (IFT against Ta) x a3 (drive tolerance) | Toshiba AKX01280 method, conservative a1; a2 from the TLP4176G IFT-Ta curve (to read) | 3 mA x 1.43 x 1.5 = 6.4 mA: design IF 7 mA. From a 3.3 V gate: R = (3.3 - 1.5 VF max - VOL) / 7 mA, about 240 ohm; at VF 0.9 V about 10 mA (TLP4176G recommended 5 to 25 mA; CPC1117N abs max 50 mA). Return: LED off below 0.1 mA (both) | estimate; a2 and VOL to confirm |
| C-23 | TX sense output margin, PC817X | CTR min 50 % at IF 5 mA (PC817X D2-A03101EN); ageing allowance: half the CTR (25 %); pull-up 10k to 3.3 V | Hand calculation | IC available at 25 % CTR = 1.25 mA against 0.33 mA needed for a low output | margin about 3.8 at end of life (estimate); VOLTAGE-mode resistor per radio still to size |
| C-24 | Loop current spread, BCP53 + BC857 source | BC857 VBE 600 / 650 / 750 mV at 2 mA (Rev 9); sense transistor at about 0.1 mA: about 80 mV lower (about 60 mV per decade, estimate); shack 10 to 40 °C: -2 mV/K (estimate); Rsense 56 ohm | Extreme-value estimate | VBE 0.49 to 0.70 V: loop current 8.8 to 12.5 mA (nominal about 10 mA). VO2611 IFH max 5 mA: margin 1.76 at the minimum; VO2611 IF max 20 mA: 12.5 mA is 0.63 (factor 0.7) pass; SAFE loop drops at 12.5 mA about 9.5 V against 12 V minimum supply (C-21 scaled) | estimate; confirm by measurement on the first board |
| C-25 | Shack interface supply budget and regulator heat | 3.3 V: DevKit about 60 mA, six PhotoMOS LEDs 42 mA, status LEDs and pull-ups about 12 mA = about 115 mA; 5 V: 3.3 V load plus about 15 mA = about 130 mA; loops from +13V8 up to 4 x 13.2 mA. L7805C TO-220 RthJC 5 °C/W, LD1117 SOT-223 RthJA 110 °C/W (ST datasheets). Wall mount: pad about 1.5 °C/W and housing to air about 10 °C/W (assumed) | Hand calculation, ambient 40 °C in the shack housing | 7805: (14.4 - 0.4 - 5) V x 0.13 A = 1.2 W, rise about 20 K, junction about 60 °C (limit 100 °C). LD1117: 1.7 V x 0.115 A = 0.2 W, rise about 22 K, junction about 62 °C. Both pass the 0.8 temperature factor | estimate; housing thermal resistance to confirm with the housing choice. Update 2026-10-27 (D-180, D-181): 3.3 V plus display about 40 mA (Waveshare FAQ, max), less the three R1 to R3 LEDs about 6 mA, plus KILL_S 1.5 mA = about 150 mA; 5 V about 165 mA. 7805: (14.4 - 0.4 - 5) V x 0.165 A = 1.5 W, rise about 25 K, junction about 65 C (limit 100 C). LD1117: 1.7 V x 0.15 A = 0.26 W, rise about 28 K, junction about 68 C (limit 100 C); 150 / 800 mA = 0.19. Both still pass |
| C-26 | USB-C J14 underload (D-96) | VBUS 4.75 to 5.25 V (USB 2.0 host; Delock 64226 isolated 5 V supply), D+ and D- 3.6 V max (full speed), shack ambient 40 C; ST USBLC6-2 DS4260 Rev 7, UMW USBLC6-2SC6 Nov 2024, GCT USB4105 Rev A3 | Hand calculation against the filed datasheets | USBLC6-2 (ST): VBUS 5.25 V at the specified VRM 5.25 V (leakage 150 nA max specified there), VBR min 6 V: 0.875; data 3.6 / 5.25 = 0.69. UMW: VRWM 5 V: 5.25 / 5 = 1.05 (leakage specified only at 5 V), VBR min 6 V: 0.875; data 3.6 / 5 = 0.72. Documented exception as D-45: for a TVS the stand-off voltage is the design point; margin taken on VBR min. Tj: 40 C against 150 C (ST) / 125 C (UMW) with 0.8: pass. USB4105: 5.25 / 48 = 0.11, 40 / 85 C = 0.47, VBUS current about 0 (ESD array and 100 nF only): pass | decided; UMW leakage above 5 V not specified (accepted: no load function on VBUS) |
| C-27 | Height stack in the box: DevKit on sockets under the lid (R-14, D-95) | From the inner floor (architecture rev C, estimates): standoff 13, RF board 1.6, RT1 15.7, gap 4, controller board 1.6 = 35.9 mm. Socket 8.50 (Sullins drawing) + DevKit header spacer 2.54 (Prins) = 11.05 mm to the DevKit underside; DevKit PCB 1.6; tallest DevKit part the USB-C receptacle (confirmed by Prins on the board in hand, 2026-10-05), about 3.3 mm (SnapEDA DevKit model; height not measured). Socket tail 3.20 mm (Sullins) | Hand sum | DevKit top 51.85 mm. Case 60 mm (inner 52): about 0.15 mm left. Case 66 mm (inner 58): about 6.2 mm left. Socket tails 1.6 mm below the controller board, 2.4 mm above the RT1 tops if placed over a relay. USB-C plug centre about 14.3 mm above the controller board | done. Build values (2026-10-20, M-52 to M-54, D-139, D-140): standoff 13 mm under the RF board, 20 mm M3 standoffs from the RF board to the controller board on S1, S2, S4, S5 (gap 20 mm, was 4 + 15.7 + estimate); RT1 tops 4.3 mm under the controller board; controller board underside 34.6 mm, top 36.2 mm; DevKit top 52.15 mm, 5.85 mm under the lid; J2 pin engagement 4.75 mm |
| C-28 | Lead fit on the common photorelay land (D-99) | Datasheets: CPC1117N span 6.096 +-0.102, foot 0.559 +-0.127, body 3.81; TLP4176G span 7.0 +-0.4, foot 0.6 +-0.3, body 4.4 +-0.25; TLP176AM span 7.0 +-0.4, foot 0.5 min, body 4.55 +0.25/-0.15; AQY212G3HS span 6.8 +-0.4, foot 0.5, body 4.4 +-0.2. Land 1.90 to 4.00 mm from the centre | Toe = span/2, heel = toe - foot, at the tolerance limits | Toe 3.00 to 3.10 (CPC1117N), 3.3 to 3.7 (Toshiba), 3.2 to 3.6 (AQY212G3HS and AQY412S, ASCTB140E 202601, added 2026-10-07): 0.3 to 1.0 mm of pad outside each toe. Heel 2.31 to 2.67 (CPC1117N), from 2.4 (TLP4176G), up to 3.2 (others): on the pad for all parts. Pads reach 0.3 to 0.5 mm under the 4.4 to 4.8 mm bodies (no lead there; acceptable). Input-to-output pad gap 3.80 mm | done |
| C-29 | RF board first resonance against the support layout (D-102) | FR-4 1.6 mm, E 18.6 GPa, Poisson 0.12 (typical, to confirm with the laminate datasheet); mass 12 kg/m2 (board about 180 g, 37 RT1 about 330 g, other parts about 100 g over 0.062 m2, rounded up) | Simply supported rectangular panel, f = (pi / 2) x sqrt(D / m) x (1 / a2 + 1 / b2), D = E h3 / (12 (1 - nu2)) = 6.44 Nm; the largest free panel sets the first mode. Point supports are less stiff than edge supports, so the values are upper bounds; use them only to compare layouts | 4 corners (268 x 230): about 38 Hz. D-102 layout (largest panel 164 x 112): about 135 Hz. Ideal 3 x 3 (134 x 115): about 151 Hz. 3 x 3 with gap rows (134 x 125): about 138 Hz. The earlier estimates in the chat (45, 136, 179 and 297 Hz) were not from one method; this line replaces them | estimate (compare only). No vibration requirement is set: the unit is fixed in the RVS box (handling and transport only) |
| C-30 | 50 Ω coplanar line with GND below on L1 (and L6) | JLC06161H-7628A (calculator: 7628 RC49% 0.218 + 7628 0.218 + 1080 RC67% 0.0764 mm to L2), 1 oz outer, gap 2.0 mm | JLC impedance calculator 2026-10-19, 6 layers, 1.6 mm, 1 oz / 0.5 oz, 'Coplanar Single Ended (without solder mask)', L1 ref L2, gap 2.0 (reported 1.999); own conformal mapping as a cross-check (Er 4.33, no copper thickness) | JLC: W 0.9751 mm. Own: W 1.08 mm (about 10 % wider; Er and copper thickness differ). Design value 0.975 mm. L6 ref L5 not run separately: the stackup is symmetric | decided |
| C-31 | Trace current 2.45 A rms (C-01), 1 oz outer layer | IPC-2221 external chart, I = 0.048 dT^0.44 A^0.725 (DC, conservative) | Formula | W 0.975 mm: about 11.0 °C at DC (about 21 °C with skin effect at 30 MHz, scaled from the skill estimate for 1.0 mm). Rejected 4-layer W 0.46 mm: about 48 °C at DC. IPC-2152 record still to do | decided; IPC-2152 record open |
| C-32 | Coupling at a row/column crossing (6-layer) | Row on L1 over L2 GND, column on L6 over L5 GND; L2, L4 and L5 solid between them | Geometry | No direct capacitance between row and column; coupling only through the relay pin holes and the antipads (D-117) | decided |
| C-33 | Via fence offset (6-layer line) | W/2 + S + via pad radius + 0.05 mm | Skill rule | 0.4875 + 2.0 + 0.5 + 0.05 = 3.04, rounded 3.05 mm; RF band about 7.1 mm (was 9 mm). Placement (C-12) keeps the 9 mm bands, so it has margin | decided |
| C-34 | Shack interface supply at 11 to 15 V input (worst-case corners) | L7805: dropout 2 V typ (ST DS0422 Rev 38), output 4.75 to 5.25 V; LD1117S33: dropout max 1.15 V at 500 mA (ST DocID2572 Rev 38, lower at 115 mA); thermal path as C-25; SMBJ16A VRWM 16 V; load 130 mA on +5V | Hand calculation, ambient 40 °C | 15 V: 7805 loss (15 − 0.4 − 5) × 0.13 = 1.25 W, rise about 21 K, junction about 61 °C (limit 100 °C): pass. 11 V: 7805 input 10.6 V, needs 7 V: pass, 3.6 V margin. LD1117 at VIN 4.75 V: output holds above 3.3 V while the dropout stays below 1.45 V; datasheet max 1.15 V: pass, about 0.3 V margin. SMBJ16A at 15 V: 0.94, TVS exception (D-124). Loop current at 11 V: to check with C-24 | pass; loop current to check |
| C-35 | Trace current, controller board (D-144) | Worst case: +5V at most about 0.11 A (LP2985 envelope, CT-02), +3V3 the same; Cat6 loop current tens of mA (220R LED path). JLC04161H-7628: outer 1 oz (0.035 mm), inner 0.5 oz (0.0152 mm). IPC-2221 charts, I = k dT^0.44 A^0.725 (k 0.048 outer, 0.024 inner; A in mil2), dT 10 degC | Formula (conservative cross-check; IPC-2152 gives more) | 0.254 mm: outer about 0.89 A, inner about 0.27 A. 0.508 mm: outer about 1.5 A, inner about 0.44 A. Worst load 0.11 A: ratio 0.25 on the narrowest case (0.254 inner), within the 0.7 factor. Power nets 0.508 (narrowed to 0.254 only at fine-pitch pins), loop nets 0.508 for surge robustness, signals 0.254 | done |
| C-36 | Surge copper on the Cat6 entry, controller board (D-145, D-58) | GDT Bourns 2036-09: 10 kA 8/20 us (> 10 operations), 20 kA once, total of both lines (datasheet Rev B 01/26). Copper melt, adiabatic (Onderdonk, 25 to 1083 degC): I2t = 8.3e4 A2s/mm4 x A2. 8/20 us current (IEC 61000-4-5 form t3 e^-t/3.911us): I2t = 12.2 us x Ipk2. 10/700 us generator, 5/320 us current: I2t = 231 us x Ipk2. Outer 1 oz 0.035 mm, inner 0.5 oz 0.0152 mm | Own calculation (python) | CHASSIS path (4 spokes 1.0 mm on L1, L4 and L2, 0.34 mm2): about 28 kA 8/20, above the GDT rating. Loop nets J1 to GDT, 0.508 mm: outer about 1.5 kA, inner about 0.64 kA 8/20 per wire; every pair has inner (L3) runs in the J1 fan-out, so about 0.64 kA per wire is the weak link. 1.016 mm would give about 1.3 kA inner, 2.9 kA outer. EN 61000-4-5 10/700 us at 4 kV (100 A or less per line): I2t 2.3 A2s against 4.9 A2s inner, margin about 2. Adiabatic: conservative for short pulses, but no margin for plating tolerance | done; 1.016 mm chosen (D-147, M-63). Surge level set by R-17 (4 kV 10/700 us), parts checked in C-39; the 0.3 mm vias in the Cat6 wires (barrel about 0.017 mm2 at 18 um plating) are about equal to a 1.016 mm inner track |
| C-37 | 3.3 V load and heat, controller board (U11 LP2985-33, CT-02) | ESP32-C3: Modem-sleep, CPU 160 MHz running, all peripheral clocks on: 28 mA typ (ESP32-C3 datasheet v1.7, table 4-8; no max given, so 2 x typ = 56 mA used); Wi-Fi and BLE off, so no RF calibration or TX peaks (335 mA). DevKit: SHTC3 0.9 mA, ICM-42670-P 0.6 mA, addressable LED idle about 1 mA, red LED on IO10 3.2 mA if driven, FB divider 0.03 mA, I2C pull-ups 10k both low 0.66 mA. Board: R14, R24, R34 4.7k with outputs low 2.1 mA, R61 1k on WDI high 3.3 mA, TLP176AM LED 7 mA (C-22), R63 0.03 mA, logic and TPS3823 0.1 mA, J2 inputs 0.1 mA. VIN 5.25 V max, box air 55 degC, RthJA 205.4 degC/W (LP2985 DBV, TI Rev S) | Sum by hand | Worst case about 79 mA (typ about 47 mA): 79 / 150 mA = 0.53, inside the 105 mA envelope (factor 0.7). Loss (5.25 - 3.3) x 0.079 + 5.25 x 0.001 = 0.16 W, rise 33 degC, Tj about 88 degC: 88 / 125 = 0.70, within 0.8 (planes lower RthJA) | done (desk); measure the 3V3 current at bring-up |
| C-38 | DevKit buck held off and back-feed (CT-03) | DevKit-RUST-2 schematic 2025-10-30: SY8088 U5, EN on header pin 27 (ENABLE) with R1 10k to the DevKit +5V; FB divider 100k / 22k1 on 3V3; +5V from VBUS through D4 B5819W and from +BATT through Q1 DMG3415U (gate on VBUS). RUST-1 schematic 2022-05-02: the same SY8088 with ENABLE on the header. Controller: pin 27 to GND, pins 26 (VBUS) and 28 (VBAT) open (netlist ctl11) | Schematic check | EN is held low, so the buck stays off. With 3V3 fed into its output, the high-side switch body diode (synchronous buck, to confirm in the SY8088 datasheet) can charge the DevKit +5V to about 2.7 V; the only loads there are R1 into the grounded EN (0.27 mA) and the open battery path through Q1. D4 blocks VBUS. No back-feed into the controller +5V (pins 26 and 28 open). With a USB cable on the DevKit at the bench, +5V is about 4.7 V and EN low still holds the buck off | done (desk); measure the 3V3 draw with the DevKit fitted against C-37 |
| C-39 | Surge parts at 4 kV 10/700 us (R-17) on the Cat6 entry | Generator 4 kV, 40 ohm, Isc 100 A, 5/320 us; conservative: all 100 A in one wire (the test couples all wires, about 1/8 each). GDT 2036-09: impulse sparkover 550 V at 1000 V/us, transverse delay < 75 ns (3 electrodes), arc about 10 V, 200 A 10/700 us > 500 operations (Bourns Rev B 01/26). Behind the GDT there is no path to earth (Y-capacitors DNP, optos isolated), so a line-to-earth surge reaches the 47R, TVS and LED only as the difference between P and N: at most 550 V for the transverse delay. MMB 0207 (Vishay 28963, 2026-06-02): single pulse 220 W up to 100 us (22 mJ), 10/700 us test voltage about 126 V at 47 ohm; MMA 0204: 100 W up to 100 us, about 190 V at 220 ohm. SMBJ15CA: VCL 24.4 V at IPP 24.6 A 10/1000 us (ST DS1283 Rev 14). VO2611 LED 200 mA for 100 us. Copper C-36 | Own calculation | GDT 100 / 200 A = 0.5. Copper: 5/320 us I2t = 2.3 A2s against 19.7 A2s for a 1.016 mm inner track (0.12) and about 24 A2s for a 0.3 mm via. Difference mode for 75 ns: (550 - 25) / 94 ohm = 5.6 A; 47R 1.47 kW x 75 ns = 0.11 mJ against 22 mJ (0.005); TVS 5.6 / 24.6 A = 0.23; LED (24.4 - 1.7) / 220 = 0.10 A / 0.2 A = 0.52; 220R 2.3 W against 100 W. All within the 0.7 factor. Not covered: a difference-mode surge (not a test case for symmetrical lines; the twisted pair and the 3-electrode GDT keep it small) and a GDT that fails to fire on one side | done (desk). Bench or lab test at R-17 level not planned yet |
| C-40 | Narrowed tracks on the RF board (M-79): CLAMP_SW (132 mm) and +3V3 (195 mm) at 0.254 mm on In2/In3, 0.5 oz (15.2 um finished): cross-section 5.98 sq mil | IPC-2152 baseline chart (Figure 5-1: no plane, still air; curve fit Area = (117.555 dT^-0.913 + 1.15) I^(0.84 dT^-0.018 + 1.159)), IPC-2221 internal chart as the conservative cross-check (I = 0.024 dT^0.44 A^0.725), adiabatic heating for the pulse (copper 1.72e-8 ohm m, 8960 kg/m3, 385 J/kg K); own Python calculation | CLAMP_SW carries current only while a coil releases: 33 mA per coil; worst case all energised +12V_SW coils at once, 0.43 A (D-36), for a few ms. Taken as DC (upper bound): IPC-2152 4.4 °C rise, IPC-2221 37 °C. As a pulse: 0.6 °C for 10 ms, 3.1 °C for 50 ms. Resistance of the narrowed length 0.60 ohm (all in series, worst case): 0.26 V at 0.43 A, so the drain peak rises from 37.5 to 37.8 V against 42 V (0.7 x 60 V, D-37). Capacity of the 0.254 mm track: IPC-2152 0.62 A at 10 °C rise (IPC-2221 0.24 A). +3V3 worst case 7.1 mA (C-14): rise below 0.01 °C, 6 mV over 195 mm. The planes L2 and L5 at 0.1 mm cool the inner tracks further, so the baseline values are conservative. The curve fit is a published approximation of the IPC-2152 chart, not the chart itself | pass (both nets) |

## 5. Standards

| ID | Standard | Use | Copy on file | Status |
|---|---|---|---|---|
| S-01 | IPC-2152 (2009) | Trace current | no | reference |
| S-02 | IPC-2221 | Clearance cross-check (B2 1.25 mm at 151 to 300 V peak) | no | reference |
| S-03 | EN IEC 60664-1 | Creepage and clearance (PD, material group) | no | to buy (NEN) |
| S-04 | IEC 60664-4 | High-frequency correction above 30 kHz (to 10 MHz) | no | to buy (NEN) |
| S-05 | IEC 60664-3 | Coating option (not used, D-12) | no | reference |
| S-06 | IEC 61249-2-21 | Halogen-free definition | no | reference |
| S-07 | IEC 60617 | Symbols | – | reference |
| S-09 | IEC 61082-1:2014 (EN 61082-1:2015) | Rules for electrotechnical documents (schematic layout) | no | reference (paid) |
| S-10 | EN 61000-4-5 (IEC 61000-4-5) | Surge immunity, 10/700 us wave for symmetrical communication lines (R-17) | no | to buy (NEN) |
| S-08 | ISO 7010 W012 / IEC 60417-5036 | HV warning mark | – | reference |

## 6. Measurements

| ID | Measurement | Setup | Result | Status |
|---|---|---|---|---|
| M-01 | RT1 open-contact isolation, insertion loss, match | 2-layer coupon, NanoVNA-H4, SOLT at SMA, 1 to 54 MHz; values at 1.8, 3.5, 7, 14, 21, 28, 50 MHz | – | postponed (Prins); now on the first assembled RF board through the SO-239s, no coupon (D-198) |
| M-02 | XT60PW-M / XT30PW-M polarity | Real part: moulded sign at the angled end | – | closed (M-131): + on the flat side, pad 2 |
| M-03 | 83-798 rear length | Real part, calliper | – | open |
| M-04 | Schematic ERC and crossbar netlist check | kicad-cli 10.0.5 sch erc --severity-all; netlist export and script check | 37 relays; each ANTk joins 6 row relays (NO), the column link and the DC block; each TXBUS/RXBUS joins K0 and 5 row relays; EXP joins SMA and both EXP relays. ERC: 0 real faults. 8 label_dangling errors (A1 to A4 DET and BIAS on the root, no logic sheet yet), 51 isolated_pin_label warnings (coil driver nets, logic sheet not drawn), 2 footprint_link warnings (rf-board.pretty still empty) | pass for this step |
| M-05 | Schematic v2 (wires) ERC and netlist check | kicad-cli 10.0.5; netlist export and script check | Same connectivity as v1: 113 nets, 101 parts, all crossbar, row, EXP, PORT, PARK and ANTENNA nets as intended. ERC: 8 label_dangling (A1 to A4 DET and BIAS on the root), 49 isolated_pin_label (coil driver nets), 1 power_pin_not_driven (+12V_SW has no source yet), 2 footprint_link: all from the logic sheet and footprints not done yet | pass for this step |
| M-06 | Schematic v3 (connectors on root, 1 MΩ only) ERC and netlist check | kicad-cli 10.0.5; netlist script | 97 parts (4 chokes removed); columns, rows, EXP, RADIO, ANTENNA (J7 to J10 with K1 COM and GD), PARK (K1 NC and 1 MΩ only), power J11 to J13 as intended. ERC as M-05, footprint_link now 7 (one per SO-239 on the root) | pass for this step |
| M-07 | Controller schematic c3 (safety gate) ERC, netlist and upgrade check | kicad-cli 10.0.5: sch erc --severity-all; netlist export and script check; sch upgrade --force on a copy of each sheet and a structural diff | ERC 0 violations (the seven isolated-label warnings of c1 are closed). Nets: WDI J3.6 R61 U12.4; RESET_N U12.1 U13.7; LATCH_CLR J3.8 R62 U13.1; MCU_EN_N J3.9 R63 U14.1; FAULT U13.5 U14.6; KILL J3.10 U14.3 (and the link sheet); RLY_EN U14.4 J2.7. 59 parts, all references unique. Upgrade diff: no changes. Root sheet with wires only, no labels | pass for this step |
| M-08 | Logic verification by truth tables and state sequences (hardware skill, verify designed logic) | verify_logic.py on the KiCad XML netlists of both boards (hardware/unit/verify/, report logic-verification.md); 24 topology checks against the netlists, exhaustive truth tables (gate, open inputs, enable chain, coil drivers, bias feeds, K0 path), timed supervisor/latch model at datasheet min and max timing (7 scenarios), all 128 relay states per column | All checks pass. Findings: F1 PCA9539 output register defaults to 1 (write outputs 0 before configuring); F2 PTT with RLY_EN low sends the radio into an open TX row (decision open: TX inhibit or accept); F3 U903 IO1_2..5 must stay inputs (shared with the U5 output); F4 TX_ANY on the RF board has no pull resistor (proposal 100k pull-down); F5 KILL not latched, relays return in their last state (firmware drops MCU_EN_N); F6 no hardware interlock for the crossbar hazards (firmware state check); F7 K0 needs 12 ms before RF (radio TX delay); F8 spare expander pins float (set as outputs, 0) | pass; F2 and F4 to decide. F2 and F4 closed by D-61 and D-62 (review S-17, 2026-11-02) |
| M-09 | RF board v10 (root buses) check | kicad-cli 10.0.5 ERC; netlist compared with v9k (sets of pins per net); sch upgrade diff on all 7 sheets; verify_logic.py on the new netlist; render | ERC: 7 footprint_link warnings only (7 SO-239 footprints still to make). Connectivity identical to v9k: 215 nets, same pins per net, 307 parts. Upgrade diff: no changes. Logic verification: all checks pass | pass |
| M-10 | Timing of the switching chains (verify_logic.py section 9), desk check | Datasheet maxima: VO2611 100 ns, LVC1G27 5.4 ns, LVC1G74 5.9 ns, TPS3823 VDD-to-RESET 25 us, PCA9539 trst 400 ns, BSS138BK Ciss 56 pF with 100k, PMV50EPEA QG 19.2 nC with R1 10k (estimate), RT1 operate 8 / release 6 / bounce 4 and 6 ms | KILL to RLY_EN low about 0.1 us; to coil MOSFETs off about 11 us; +12V_SW off about 19 us (estimate): low side opens first, into the 24 V clamp; KILL to contacts open about 6 ms plus the coil decay (coil L not in the datasheet). Brown-out to RLY_EN low 25 us; watchdog 0.9 to 2.5 s after the last WDI edge. PTT to K0 settled 12 ms (radio TX delay at least 15 ms, F7). Findings: F9 no minimum K0 release time against the radio RF tail (measure); F10 open and close relays in separate register writes, 12 ms apart. To measure on the first board: KILL order (gate, +12V_SW, coil), coil decay, K0 release, FT-710 RF tail | pass on paper; measurements open |
| M-11 | Design-level system logic check (D-62 to D-75) | verify_system.py: SAFE loop table (128 rows), start-up order, SAFE latch sequences, port truth tables, timed handshake with fault cases | All checks pass; findings F11 (start-up rule changed), F12 (accepted, D-76), F13 (box keeps K0 while a permit is out) | done (desk check); topology checks follow when drawn. Topology checks done (verify_logic.py) (review S-17, 2026-11-02) |
| M-12 | Radio inhibit response: time from TX INH active to RF off, per radio (FT-710 first); also the RF tail after PTT release (F9) | Radio into a dummy load, RF sampler to a scope channel, TX INH line on a second channel | – | open |
| M-13 | Shack interface schematic, first increment (root + link sheet), gen_shack_sch.py a1-link | KiCad 10.0.5 through the KiCad MCP on the Mac: ERC, netlist export (nl.py), SVG render check | Link sheet: 0 ERC findings; 51 parts, 37 nets, supplies and loop returns as intended (loops 1 and 2 return to GND, loops 3 and 4 through the 100R sense). Root: 8 expected findings (5 labels for nets whose other end is not drawn yet, 3 temporary supply flags until the power sheet exists). Render: text placement corrected (mirrored symbols flip the field justification) | done for this increment |
| M-14 | Shack interface schematic, second increment (power sheet), gen_shack_sch.py a2-power | KiCad 10.0.5 through the KiCad MCP: ERC, netlist (nl.py), SVG render | 64 parts, 40 nets. +13V8: fuse, SS34, SMBJ16A, 47u, 330n, L7805 IN and the four loop sources; +5V: L7805 OUT, LD1117 IN, 3 capacitors; +3V3: LD1117 OUT, 22u, 100n and the loop pull-ups; J3 pin 2 on GND. ERC: 5 expected findings only (labels for nets whose other end is not drawn yet); the earlier temporary flags are gone. Two findings fixed on the way: PWR_FLAG on a regulator output (power output conflict), and a VIN_N label that merged with GND | done for this increment. Datasheets filed 2026-09-30: SMBJ series (ST DS1283 Rev 14), SS34 (Vishay 88751; SMC package, footprint changed from SMA to SMC, order code SS34-M3/57T halogen-free); fuse SF-1206S already filed (box) |
| M-15 | Shack interface schematic, third increment (MCU sheet), gen_shack_sch.py a3-mcu | KiCad 10.0.5 through the KiCad MCP: ERC, netlist (nl.py), SVG render | 75 parts, 84 nets. ERC: 0 errors, 36 warnings, all 'label connected to only one pin' on the 18 nets whose other end (SAFE sheet, radio ports) is not drawn yet. Netlist: RESET_N = U3, U4 PRE_N, U5 RESET; WDI = J4.6, 1k, U3; LATCH_CLR = J4.8, 100k, U4 CLK; SDA J4.12 to U5.23, SCL J4.13 to U5.22; SAFE_LOST through R61 1k to J4.14 (IO21); R1_TX and SW_STOP_N reach the link sheet. Part numbers renumbered once (R41..R43 clashed with loop 4) | done for this increment |
| M-16 | Shack interface schematic, fourth increment (SAFE sheet), gen_shack_sch.py a4-safe | KiCad 10.0.5 through the KiCad MCP: ERC, netlist (nl.py), SVG render | 96 parts, 98 nets. ERC: 0 errors, 32 warnings, all labels of the 16 nets that go to the radio ports (not drawn yet). Netlist: SAFE_LOST to U7 (Schmitt) and on to U8 A (SAFE_OK); POR_N (U6) to U8 B; PRE_N = U8 out to U9 S; RESET_CLK = U10 out to U9 C1; LATCHED = U9 Q to U11, R74 and U5 IO1_0; FAULT = U4 Q to U11 B; TX_EN = U11 out; KILL_S = J7 pin 1, R75 10k, U5 IO1_1; front panel J6: BTN, LED_SAFE, LED_LATCHED, GND. Root: one crossing (KILL_S drop with the SAFE_LOST route), one crossing (SAFE_LOST branch with DATA_RX) | done for this increment |
| M-17 | Shack interface schematic, fifth increment (radio port sheet, three instances; root rewired), gen_shack_sch.py a5-ports | KiCad 10.0.5 through the KiCad MCP: ERC, netlist export and a 61-point netlist check, SVG render | 204 parts, 169 nets. ERC: 0 errors, 0 warnings (the 32 provisional labels are gone). Per port: TX INH contact to pin 2; INH LEVEL 2-3 to pin 5, 1-2 through RH to pin 6; PIN1 SEL common to pin 1, KEY contact to pad 3; SENSE K 1-2 to pin 8, 2-3 to pin 5; SENSE A 2-3 from pin 8; FEED SEL pad 1 to pin 6; shield to CHASSIS; TX_EN from U11; PERMIT from the DevKit, KEY and LED from U5; radio GND not tied to GND with GND BOND open. R1 TX joins R1_TX (expander IO1_6 and the loop 2 source gate); R2 TX to IO1_7, R3 TX to IO0_7; BAND A to D from R1 to IO1_2..5; R2/R3 band pins not connected. Root: no wire crossings (link pin order changed, SAFE_LOST on the SAFE block top edge, port signals on the MCU block bottom edge). CHASSIS is now a power symbol (IEC 60417-5020) with one PWR_FLAG at the lug | done for this increment |
| M-18 | Shack interface schematic a6-esd: radio port ESD and RF protection (D-89), RGND local power symbol, band pull-ups | KiCad 10.0.5 through the KiCad MCP: ERC, netlist check (TVS and 1 nF on every line to the port RGND, 10 nF RGND to CHASSIS, three separate RGND nets), SVG render | 249 parts, 169 nets. ERC: 0 errors, 0 warnings. All 45 new parts on the intended nets; /Radio port R1/RGND, /R2/RGND, /R3/RGND separate from GND | done for this increment |
| M-19 | Shack interface schematic a6-esd with the HIGH-level clamp (D-90) | KiCad 10.0.5 through the KiCad MCP: ERC, netlist check, SVG render | 252 parts. ERC: 0 errors, 0 warnings. Per port: HIGH node = INH LEVEL pin 1, zener cathode and RH; RH other end on pin 6; zener anode on the port RGND | done for this increment |
| M-20 | Shack interface schematic: keying part TLP176AM (D-91) | KiCad 10.0.5 through the KiCad MCP: ERC, netlist check | 252 parts. ERC: 0 errors, 0 warnings. U204, U304, U404 = TLP176AM: LED from R5, contact to pin 1 selector and to RGND, as before | done |
| M-21 | Drawing rule D-92, steps 1 and 2: link sheet mirrored (cable left, logic right, KILL wires out on the cable side); radio port sheet redrawn (logic inputs on the top edge, one vertical per row; TX_EN on the bottom edge; mini-DIN pins and PNL_LED on the right edge); root: port blocks fed from the top, panel LED connectors beside the mini-DIN | KiCad 10.0.5 through the KiCad MCP: ERC, netlist comparison against the 2026-10-04 reference (ref-a6.xml), SVG render | 252 parts, 169 nets. ERC: 0 errors, 0 warnings. Connectivity identical to the reference, except three intended swaps of equivalent pins in each port (U2 AND inputs, U4 contact pins, PIN1 SEL pads 1 and 3). Root: R1_TX crosses three R1 fan-out wires (PERMIT, KEY, BAND_D), to remove in the root step | done for this step; SAFE, MCU and root follow. Closed by later steps (verify_logic.py) (review S-17, 2026-11-02) |
| M-22 | Drawing rule D-92, step 3: MCU sheet redrawn (DevKit board symbol A1 with net labels, D-93; PCA9539 regrouped and drawn mirrored; hierarchical labels on the same sides as the MCU block: link signals left, FAULT, LATCHED, KILL_S right, port group bottom in the root order), gen_shack_sch.py a7-mcu | KiCad 10.0.5 through the KiCad MCP: ERC, netlist comparison against ref-a6.xml with netcmp3.py (maps J4 pin n to A1 pad n, J5 pin 11 ENABLE to A1 pad 18 EN, the old to the new U5 pin per signal, plus the earlier port swaps; unconnected DevKit pads left out), SVG render | 251 parts (J4, J5 replaced by A1). After the A1 layout correction (D-93): ERC 0/0, connectivity identical (152 connected nets). ERC: 0 errors, 0 warnings. Connectivity identical after the mapping; R61 and R63 drawn the other way round (equivalent pins). MCU sheet: no wire crossings | done for this step; SAFE and root follow. Closed by later steps (verify_logic.py) (review S-17, 2026-11-02) |
| M-23 | DevKit changes on the box controller board (gen_controller_sch.py c4-devkit-socket): A1 board symbol with net labels at the DevKit pins (D-93), SDA select JP11 (D-94), socket footprint (D-95); shack interface A1 description to the gold sockets | KiCad 10.0.5 through the KiCad MCP: ERC on both boards; controller netlist compared with its c3 netlist (ref-c3.xml) by netcmp-c4.py (J3 pin n = A1 pad n, J4 pin n = A1 pad 16+n, SDA split by JP11); shack netlist against ref-a6.xml by netcmp3.py; verify_logic.py on the RF board and new controller netlists; STEP export of the footprint test board | Controller: 59 parts (J3, J4 replaced by A1, JP11 added), 59 nets, identical after the mapping; ERC 0/0. Shack: ERC 0/0, identical after the mapping. verify_logic.py: all checks pass, report unchanged. 3D: sockets at pad 1 and pad 28, DevKit 11.05 mm above the board, components up, USB-C at +Y | done |
| M-24 | USB-C J14 on the shack interface (D-96), 1x12 socket footprint without standoff holes on both boards (D-95), gen_shack_sch.py a8-usb, gen_controller_sch.py c4 | KiCad 10.0.5 through the KiCad MCP: ERC both boards; shack netlist against ref-a6.xml with the new USB parts left out; USB nets read from the netlist; controller netlist by netcmp-c4.py; STEP export of the footprint test board | Shack: 257 parts, ERC 0/0, identical to the reference outside the USB parts. USB_DP = A1.19, J14.A6/B6, U61.1/6; USB_DN = A1.20, J14.A7/B7, U61.3/4; USB_VBUS = J14.A4/A9/B4/B9, U61.5, C64; USB_CC1 = J14.A5, R64; USB_CC2 = J14.B5, R65; J14.SH on CHASSIS; J14 GND contacts, U61.2, C64, R64, R65 on GND. Controller: ERC 0/0, identical after the mapping. 3D: 1x16 and 1x12 sockets at pad 1 and pad 28, DevKit 11.05 mm above the board | done |
| M-25 | Drawing rule D-92, step 4: SAFE sheet redrawn (SAFE_LOST top; FAULT, LATCHED, KILL_S left; TX_EN, BTN, LED_SAFE, LED_LATCHED right; U6 and the RESET inverter U10 drawn mirrored), root unchanged (D-97), gen_shack_sch.py a9-safe | KiCad 10.0.5 through the KiCad MCP: ERC, netlist comparison against the a8 netlist (ref-a8.xml), SVG render | ERC: 0 errors, 0 warnings. Connectivity identical to a8, except two intended swaps of equivalent pins: U11 NOR inputs (FAULT now pin 1, LATCHED pin 2) and R71 pins | done. D-92 redraw complete for all sheets |
| M-26 | Common photorelay footprint (D-99), gen_shack_sch.py a10-photorelay-fp | KiCad 10.0.5 through the KiCad MCP: ERC; netlist against a9; STL export of a test board (lib/test-3d/test-photorelay-3d) to read the model position | ERC: 0 errors, 0 warnings. Netlist: only the footprint field of the six photorelays changed. Model: pin 1 dimple at pad 1 after the rotation fix (+90); body 2.09 mm high; leads 0.09 mm below the board surface in the SamacSys model (no effect) | done |
| M-27 | MD-80SM footprint (D-100), gen_shack_sch.py a11-minidin-fp | KiCad 10.0.5 through the KiCad MCP: ERC; netlist against a10; STL export of a test board (lib/test-3d/test-minidin-3d) | ERC: 0 errors, 0 warnings. Netlist: only the footprint and description of J11 to J13 changed. Model: tails at the pad rows (pin 7 at -0.9, outer tails at +-3.25 against pads at +-3.4), earth terminal legs in the centre slot, shield tabs in the side slots, body behind the edge, top 12.8 mm above the board | done |
| M-28 | Kycon KMDGX-8S-BS against the MD-80SM footprint (D-100) | Kycon KMDGX series datasheet (footer 0418, PDF 2026-01-26), drawing KMDGX-8S-BS read at 500 dpi | Positions identical to D-100: rows 8.5 and 11.0, same pin order, columns 2.6 and 6.8, pin 7 0.9 left of the centre line (bottom view, front up), earth legs at about +-0.7 at 4.7 (inside the 2.3 mm slot), shield tabs 13.5 apart at 5.5. Body 14.0 x 13.0 high x 12.9 deep (Same Sky 14.0 x 12.8 x 13.4): inside the courtyard. Tails 3.18 +-0.3 (signal), 3.5 +-0.3 (shield). Ratings: 12 Vdc 2 A, 500 Vrms 1 min, -25 to +80 C, gold contacts. No hole sizes given | match on positions; hole fit to confirm with a part |
| M-29 | System verification with topology checks (verify_system.py section 0): the drawn netlists against the model of D-62 to D-75 | verify_system.py with the KiCad XML netlists of the shack interface (a11) and the controller board (c4); mutation test (three changed netlists) | 28 connection checks: shack loop source and current limit, software stop with its pull-up (D-68), series path over Cat6 pair 3, sense and SAFE_LOST, SAFE latch (PRE_N, D, CLR_N, CLK, button network, U6 without watchdog), LATCHED, FAULT, TX_EN to the three ports only, per port the TX INH and keying LED logic, part types (form B, form A), contacts and jumpers; box pair 3 polarity and KILL. All pass; the model sections 1 to 5 pass as before. Each mutation gave a FAIL. Open: the box READY switch (D-62) is not drawn on the controller board, so section 1 still models it from the design log | done; READY to draw on the box side |
| M-30 | Box side of D-62 and D-63 drawn, and the complete design verified: controller c5-ready (READY switch U6, READY gate U15, R35; loop 3 named SAFE; R52, R53 DNP), RF board v10h (texts: U903 IO1_3, IO1_4 drive R2, R3 K0) | KiCad 10.0.5 through the KiCad MCP: ERC on the three boards; netlists (shack a11, controller c5, RF v10h); verify_logic.py (RF + controller) and verify_system.py (shack + controller), each with a mutation test | ERC: shack 0/0, controller 0/0, RF board 0 errors and 7 warnings (footprint SO239_83-798_StrapPad not made yet, open). Controller netlist against c4: only the new parts and the loop 3 return through U6; RF netlist connectivity unchanged. verify_logic.py: 35 checks pass (U14 inputs with FAULT also to U15; R51 fitted, R52, R53 DNP; U903 IO1_3, IO1_4 drive R2, R3 K0; F3 revised). verify_system.py: 44 checks pass, the READY check now passes (no open item); new cross-board check: all four Cat6 pairs on the same J1 pins and wires on both boards. Mutations gave FAIL | done |
| M-31 | Logic, timing and flow diagrams for the detailed design document (hardware/docs/diagrams, generator gen_diagrams.py): L1 SAFE loop, L2 box safety gate, L3 shack latch and port logic, T1 box start-up, T2 SAFE stop and recovery, T3a/T3b TX handshake start and end, T4 R1 PTT path, F1 box firmware flow, F2 TX handshake flow | Drawn from the netlists and verify_system.py / verify_logic.py models; timing values from C-19, C-20, M-10, D-63; IEC 60617-12 logic symbols (polarity indicator as in the schematics), ISO 5807 flow shapes; SVG with editable text and PNG 200 dpi | Diagrams show order and margins from datasheet values, not measured data; ESP32-C3 boot time is an estimate | done; update when the firmware or timing changes |
| M-32 | Support positions against the placement study (D-102) | gen_relay_placement.py: distance from each support centre to every relay body, RF band, connector and antenna-port part, less the 4 mm keep-out radius; the script stops when a value is negative. gen_case_sketch.py: S1 to S6 drawn in view A | Clearance beyond the keep-out (mm): S1 30, S2 3.0, S3 27, S4 3.5, S5 0.5, S6 1.5; bosses B1 to B7 3.0 to 38. All positive. The logic zone is empty in the study, so S2 and S4 need a check when the logic and coil-driver parts are placed | done (study level) |
| M-33 | SR-01 H1 (D-103) drawn and checked: RF board v10i | KiCad 10.0.5 through the KiCad MCP: ERC; netlist export hardware/unit/verify/rf6.xml; verify_logic.py with a new topology check; mutation test with the v10h netlist rf5.xml | ERC: 0 errors, the 7 known SO-239 footprint warnings. Netlist: K103, K203, K303 and their Q, D, R are DNP, all other row relays fitted. verify_logic.py: 36 checks pass (new: SR-01); with rf5.xml (relays fitted) the SR-01 check fails, as expected. verify_system.py: 44 checks pass | done |
| M-34 | SR-01 H2 (D-104) drawn and checked: RF board v10j, controller c6-rf-a2 | KiCad 10.0.5 through the KiCad MCP: ERC; netlists hardware/unit/verify/rf7.xml and ctl6.xml compared with rf6.xml and ctl5.xml; verify_logic.py and verify_system.py with new checks; mutation tests with the old netlists; SVG render of the changed sheets | ERC: controller 0/0; RF board 0 errors and the 7 known SO-239 warnings. Netlist differences: RF board J14 pin 17 joins A2_RFDET (U801 pin 1, R822, R832, U901 pin 18); controller J2 pin 17 = RF_A2_N (U16 pin 2, R36), U16 pin 1 = READY_ON (U15), U16 pin 4 to R35, C5 for U16; nothing else. verify_logic.py 37 checks pass (new: pin 17 across both boards); verify_system.py 46 checks pass (new: U16 topology; SAFE loop table 256 rows with RF on A2). With rf6.xml or ctl5.xml the new checks fail, as expected. Diagrams L1 and L2 updated | done |
| M-35 | SO-239 strap footprints (D-105) | gen_so239_fp.py run twice (same files); RF board schematic v10k with the two footprints; KiCad 10.0.5 through the KiCad MCP: ERC; netlist rf7.xml exported again; verify_logic.py | ERC: 0 errors, 0 warnings (the 7 footprint warnings are closed). Netlist: only the footprint field of J1 to J10 changed (J10 BossLeft). verify_logic.py: report unchanged, all checks pass | done |
| M-36 | TX INH part change (D-106): shack interface a12 | gen_shack_sch.py a12; gen_photorelay_fp.py (description only); KiCad 10.0.5 through the KiCad MCP: ERC shack interface and controller; netlist hardware/unit/verify/si12.xml compared with si.xml; verify_system.py | ERC 0/0 on both boards. Netlist: identical nets and parts; only the value of U203, U303, U403 changed (CPC1117N to TLP4176G). verify_system.py: 46 checks pass with si12.xml; with the old si.xml the part check fails, as expected. Diagram L3 updated | done |
| M-37 | Footprints for the 19 parts without one (D-109, D-110): RF board v10l | gen_rf_fp.py (SMA strap land, wire link, axial GDT); gen_rfboard_sch.py v10l-fp-set2; KiCad 10.0.5 through the KiCad MCP: ERC, netlist hardware/unit/verify/rf8.xml compared with rf7.xml; verify_logic.py | ERC 0/0. Netlist: 308 parts, nets identical to rf7.xml; only the 19 footprints changed (R402 to R702 value now '0R wire link'). No part without a footprint. verify_logic.py with rf8.xml and ctl6.xml: 37 checks pass | done |
| M-38 | RF board layout p1: board file and placement | Board from the schematic (KiCad MCP create_board_from_schematic, footprints only: the MCP left 554 pads of the hierarchical instances without a net); gen_rfboard_pcb.py p1-placement with the KiCad 10.0.5 Python: nets from hardware/unit/verify/rf9.xml, outline 268 x 230 mm, supports S1 to S6, netclasses RF (2.7 / 2.0 mm), Power (0.8 / 0.25), Default (0.254 / 0.2); 51 large parts placed per the study, 257 small parts parked beside the board. kicad-cli pcb drc --severity-all | All 1061 pads with a net in the netlist have their net. DRC: 0 violations, 499 unconnected (no tracks yet). First run: 58 violations, fixed by D-111. Render: hardware/unit/rf-board/svg/rf-board-p1.svg and .png | done for p1 |
| M-39 | RF board layout p1b: zones for the small parts | gen_rfboard_pcb.py p1b-zones: drivers in the logic zone (D-112), power entry fuses and TVS next to the XT connectors, the rest of the power sheet and the expanders in the logic zone, bias-T supply below radio block 3 (x 2 to 66 mm), RF detect between the feed bands and K401, antenna port parts around K1 and the column link; corners R 5 mm (D-113). kicad-cli pcb drc --severity-all | 307 of 308 parts on the board; R701 (A4 bleed) parked beside the board: no room right of the A4 GDT (D-114, open). DRC: 0 clearance or courtyard violations; 157 silkscreen notes (reference texts in the dense zones, for p3); 499 unconnected (no tracks). Two errors on the way: wrong pad order of L402 and C402 (fixed), and the SWIG proxies of new board shapes must stay referenced in the script (else the type table breaks) | done for p1b |
| M-40 | RF board layout p1c: 6-layer stackup (D-115, D-116) | gen_rfboard_pcb.py p1c-6layer with the KiCad 10.0.5 Python on the Mac: 6 copper layers, board 1.6 mm, physical stackup JLC06161H-7628A written into (setup) as text (the Python wrapper does not expose BOARD_STACKUP), finish ENIG, netclass RF 0.975 / 2.0 mm. Reload with pcbnew; kicad-cli pcb drc --severity-all. Backup: rf-board/.mcp-backups/*.bak-p1b-2026-10-19 | Board loads: 6 layers (F.Cu, In1 to In4, B.Cu), 1.6 mm, one stackup block. DRC: 109 silk_overlap and 48 silk_over_copper warnings, 499 unconnected items (no tracks yet), identical to the p1b report; no errors | pass |
| M-41 | Design review against hardware-design-rules v2.2 (underload, second source, placement, return paths, test access, crossings) | Three read-only passes over the netlists rf9.xml, ctl6.xml, si12.xml, the design documents and generators; DigiKey NL product pages (substitutes, stock, lifecycle) for 13 active parts until the DigiKey bot check stopped the session. Report: docs/reviews/2026-10-19-review-hdr-v2.2.md | RF board 12 findings, controller 13, shack interface 10, parts 13 checked. Actions: D-119 to D-125, C-14 recomputed, C-34. Parts: NXP PCA9539D,118 obsolete (DigiKey Direct substitute TI PCA9539DWR); BSS138BK second source to change to onsemi 2V7002KT1G (Direct); TPS3823A-33 TI only; zero stock at DigiKey NL for BSS138BK, PMV50EPEA, BC857B, BCP53-16, LM2901DR, TPS3823A-33. About 25 parts still to check on DigiKey | done; decisions taken 2026-10-19 (D-121, D-126 to D-132) |
| M-42 | RF board schematic v11a (review against hardware-design-rules v2.2): J14 filter sheet, pull-down arrays, test points, +3V3 link, bulk C6 C7, 1 uF decoupling, supports S1 to S6 with bond options, PCA9539DWR | gen_rfboard_sch.py v11a-review-hdr22; KiCad 10.0.5 kicad-cli: ERC, netlist hardware/unit/verify/rf10.xml; verify_logic.py rf10.xml ctl7.xml (nl.py load_model takes the 0R links as shorts and leaves filter and test parts out of the member lists); SVG renders checked for overlaps | ERC 0 errors, 0 warnings. verify_logic.py: 52 checks pass (37 before, 15 new for D-120 to D-132; F8 closed). With rf9.xml the new checks fail, as expected. Backups: rf-board/.mcp-backups/*.bak-v10m-2026-10-19 | pass |
| M-43 | RF board layout p1d: new parts placed (40 parts plus S1 to S6 plated, C8 to C13) | gen_rfboard_pcb.py p1d-review with the KiCad 10.0.5 Python: footprints added from the netlist, values and DNP from the netlist; F2 and D8 moved to x 138.6; C6 and C7 at the 12 V entries; J14 filter zone below J14; bond options outside the 8 mm support keep-out. kicad-cli pcb drc --severity-all | DRC: no errors; 86 silk_over_copper and 171 silk_overlap notes (reference texts, for p3); unconnected items as before (no tracks). R701 parked as before (D-114) | pass |
| M-44 | Controller board schematic c7: chokes L1 to L4 and Y-capacitor footprints C21 to C28 (D-130), watchdog link R64 (D-123), +3V3 link R65, test points TP1 to TP4, 1 uF decoupling, C4 stackup text (D-131), BSS138BK second source text (D-128) | gen_controller_sch.py c7-review-hdr22; kicad-cli ERC, netlist hardware/unit/verify/ctl7.xml; verify_logic.py and verify_system.py | ERC 0/0. verify_logic.py 52 checks pass (6 new controller checks); verify_system.py with si13.xml and ctl7.xml: 52 checks pass. Backups: controller-board/.mcp-backups/*.bak-c6-2026-10-19 | pass |
| M-45 | Shack interface schematic a13: chokes L1 to L4 and Y-capacitor footprints C22 to C29 (D-130), R5 and R6 rail links, TP1 to TP3 and 21 port test points (D-120), 1 uF decoupling (D-127), U5 PCA9539DWR (D-126), C4 stackup text (D-131) | gen_shack_sch.py a13-review-hdr22; kicad-cli ERC, netlist hardware/unit/verify/si13.xml; verify_system.py si13.xml ctl7.xml | ERC 0/0. verify_system.py: 52 checks pass (6 new shack checks). Backups: shack-interface/.mcp-backups/*.bak-a12-2026-10-19 | pass |
| M-46 | PCA9539 to TSSOP-24 (D-133): RF board v11b, shack interface a14, RF layout p1e | gen_rfboard_sch.py v11b, gen_shack_sch.py a14, gen_rfboard_pcb.py p1e (replaces a footprint that changed in the schematic); kicad-cli ERC both boards, netlists rf10.xml and si13.xml, DRC; verify_logic.py, verify_system.py | ERC 0/0 on both boards. DRC: no errors; 82 silk_over_copper and 175 silk_overlap notes. verify_logic.py 52 and verify_system.py 52 checks pass. Backups *.bak-v11a / a13 / p1d-2026-10-19 | pass |
| M-47 | Coil MOSFET second source text (D-134) on all three boards; RF layout page A3 | gen_rfboard_sch.py v11c, gen_controller_sch.py c8, gen_shack_sch.py a15 (BOM text only); kicad-cli 10.0.5: ERC, netlists rf11.xml, ctl8.xml, si14.xml compared with rf10, ctl7, si13; verify_logic.py, verify_system.py; gen_rfboard_pcb.py p1f-a3 (page A3 landscape, written as text: the Python wrapper has no PAGE_INFO; library id kept on loaded footprints), DRC | ERC 0/0 on all three. Netlists: same parts, values, footprints and nets; only the description text changed. 52 + 52 checks pass. Layout: page A3, the board and title block fit (render checked); a second run loads no footprint again; DRC 0 errors, 499 unconnected (no tracks) | done |
| M-48 | RF board layout p1g: placement by function (D-136) | gen_rfboard_pcb.py p1g-functional: groups with one anchor; each part placed next to the pad it connects to (outward first, then sideways), no courtyard overlap with 0.6 mm gap, inside the group region; kicad-cli pcb drc --severity-all; edge check script (courtyard to board edge) | All 359 parts placed (R701 parked, D-114). DRC: no clearance or courtyard errors; 230 silkscreen notes (reference texts, for p3); 499 unconnected (no tracks). Edge check: no part within 3.5 mm of the edge except the edge connectors, supports and GD701 (2.6 mm, D-114). Render hardware/unit/rf-board/svg/rf-board-p1g.png | done for p1g |
| M-49 | GDT footprints removed (D-114): RF board v11d, layout p1h | gen_rfboard_sch.py v11d-no-gdt; kicad-cli ERC, netlist hardware/unit/verify/rf12.xml compared with rf11.xml; verify_logic.py; gen_rfboard_pcb.py p1h-no-gdt (now also removes board parts that left the schematic); DRC; edge check | ERC 0/0. Netlist: GD401 to GD701 removed, all other parts, values, footprints and nets unchanged. 52 checks pass. Layout: R701 placed, all 356 parts on the board, none in the edge band apart from the edge connectors and supports; DRC: no clearance or courtyard errors, 227 silkscreen notes (p3), 499 unconnected | done |
| M-50 | 3D model check, RF board p1h | Script over all footprints: model path, file found, offset and rotation; kicad-cli pcb render (top and edge views) | 29 footprint types. Found: all library parts. Missing in the KiCad 10 install: AMASS XT60PW-M and XT30PW-M; now taken from hardware/unit/unit.3dshapes (vendor STEP, offset and rotation as on the rev B backplane), render shows the mating face at the board edge. RT1 footprint pointed to the RT2 DPDT model of the KiCad library; now the TE STEP RTD14012F (C-2-1419108-9, Prins 2026-10-19): file bbox 29.0 x 12.7 x 15.7 mm body, pins 3.6 mm; modelled upside down, so rotated 180 deg about x and moved by (12.15, 3.83) mm onto the footprint pads (pin centres from the file match A1, NC 15.26, COM 20.3, NO 25.34 and the 7.5 mm row pitch); render checked. No model (flat parts, acceptable): test points, wire links, mounting holes, solder jumper. No model (parts in the case wall): SO-239 83-798 (83-1R placeholder STEP available), SMA 901-9215 (no STEP yet). DNP parts are hidden in the render, as intended | done; SMA model open. SMA model closed by D-174 (review S-17, 2026-11-02) |
| M-51 | Controller board footprints J1 (D-138) and GD1 to GD4, schematic c9 | hardware/unit/controller-board/lib/gen_ctl_fp.py and gen_gdt_step.py (cadquery); test board in Claude outputs/pcbwork/fpcheck/, kicad-cli pcb render (top, profile, iso); kicad-cli sch erc; verify_logic.py and verify_system.py with ctl9.xml | RJ45: Wurth STEP origin at the body centre; offset (0, 1.12, 5.83) puts the contact ends on the pads and the body on the board. Profile render (scale from the 2.54 mm pin rows): pin rows 6.5 and 9.0 mm, face 8.0 mm from the peg line, height 11.9 mm (nominal 6.35, 8.89, 7.88, 11.65; within the render scale error); tab down. GDT: Bourns STEP 2036-XX-B2 (Prins 2026-10-20; body centre at the file origin, leads toward -x), rotated (0, 90, 90) and raised 3.05 mm: body 0.5 mm above the board, leads in the pads, 1.9 to 2.0 mm below the board (render). The own model (gen_gdt_step.py) stays as a fallback. ERC 0 violations; logic 52 pass, system 52 pass | done |
| M-52 | Controller board layout c-p1 and 3D fit check of the stack | gen_controller_pcb.py c-p1 (netlist ctl9; outline x 1 to 153, y -2 to 120.5 in the RF frame; H1 plated CHASSIS at S1, NPTH H2 to H4 at S2, S4, S5; J2 on the bottom, pad n over RF J14 pad n; J1 face 0.5 mm from the top wall; DevKit USB toward +x at the right edge); kicad-cli pcb drc; kicad-cli pcb export step of both boards; cadquery check (Claude outputs/pcbwork/ctl/fit.py, fit2.py): RF board bottom at z 13, controller board bottom at z 34.3 (C-27), case inner -4 to 272 x -3 to 233 x 0 to 58 | DRC: no clearance or courtyard errors (54 silkscreen notes, for p3). All parts inside the case; DevKit top 51.85 mm, 6.15 mm under the lid (C-27 confirmed). RJ45 face 0.6 mm from the top wall. Gap RT1 tops to the controller board underside 4.0 mm. Lowest controller tails (DIP optos over RT1 relays) 1.71 mm below the board, 2.29 mm clear of the relay tops; GDT leads 1.91 mm, RJ45 pegs 2.45 mm below, over free RF board area. J2 socket (8.5 mm) to J14 header (top at z 23.14): 2.57 mm gap, no engagement: the board-to-board connector is open (A-24). Parts use the top 85 mm of the board; the area below y 85 is free. Missing 3D model: Coilcraft 1812CAN choke (low part, about 3 mm; choke still to choose) | done; J2/J14 open. J2/J14 closed by D-139 (review S-17, 2026-11-02) |
| M-53 | J2 Samtec ESQ-112-33-G-D fitted, schematic c10, layout c-p2 | Samtec STEP (Prins); model rotation (-90, 0, 90), offset (-1.27, -13.97, 7.62) set in gen_controller_pcb.py, checked in a test STEP export (seating on the board, top 16.2 mm); ERC; verify_logic and verify_system with ctl10.xml; STEP export of both boards and fit.py / fit3.py | J2 socket face at z 18.09, J14 pin top at z 23.14: engagement 5.05 mm; socket 0.95 mm above the J14 body. Other results as M-52. ERC 0; logic 52 pass, system 52 pass | done |
| M-54 | Controller board as a 3D reference on the RF board (layout p1i) | kicad-cli pcb export step of controller-board.kicad_pcb (c-p2) into hardware/unit/unit.3dshapes/controller-board.step; gen_rfboard_pcb.py section 9 adds a board-only footprint CTL3D (no pads, not in BOM or position files) at the frame origin with offset (-20, 20, 20): 20 mm standoff; kicad-cli pcb render (iso, front, side); DRC before and after | The controller board sits on S1, S2, S4 and S5 with J2 on J14; the renders agree with the cadquery check (M-52, M-53). DRC unchanged: 227 silkscreen notes, no other violations. The STEP must be exported again after each controller layout change | done |
| M-55 | Controller board test points D-141: schematic c11, netlist ctl11, layout c-p3 | gen_controller_sch.py (TP5 to TP8 on the MCU sheet, TP9 on the Link sheet, each on a local label of its net); kicad-cli sch erc and export netlist; net check of TP5 to TP9 in ctl11.xml; verify_logic and verify_system with ctl11.xml; gen_controller_pcb.py; kicad-cli pcb drc; STEP export and RF board p1i regenerated (CTL3D) | Nets: TP5 on SCL with A1 13 and J2 1; TP6 on SDA with JP11 2 and J2 3; TP7 on EXP_INT with A1 5 and J2 5; TP8 on RLY_EN with U14 4 and J2 7; TP9 on TX_ANY with U5 4, R51 to R53 and J2 9. ERC 0; logic 52 pass, system 52 pass; DRC no clearance or courtyard errors (55 silkscreen notes). TP5 to TP9 in one row beside the J2 pins | done |
| M-56 | Controller board placement c-p5: one template per Cat6 pair, copied to the four columns (Prins: symmetry) | gen_controller_pcb.py section 4b: columns in the J1 pin order (pairs 4, 3, 1, 2), 11.8 mm wide, pair 3 16.6 mm (U6 beside U3); per column GDT (y 23), choke (30), Y-capacitor footprints left and right of the choke, 47R per wire (38.5), TVS (46), LED resistor (51.2), diode (56), opto across the barrier (Y_B 63); N on the left rail, P on the right rail. J1 centred over the columns (x 28.5). Logic side per column: decoupling under VCC pin 8, pull-up under the output pin 6. Test points TP1 to TP9 in one row under J2 at 2.54 mm pitch; K0 links under their J2 pins; LDO and safety gate in one row under the DevKit signal pins. kicad-cli pcb drc with zone refill; render | No clearance or courtyard errors; 66 silkscreen notes (p3); one starved thermal (U14 GND pad, closed by its via at routing). The choke footprint has its dots diagonal, so each column needs one N/P crossing below the choke (B.Cu, loop side has no plane); the PC817 of pair 4 has the collector left, so pair 4 needs one more crossing | done; review by Prins. Review closed by M-67 and D-153 (review S-17, 2026-11-02) |
| M-57 | Controller board placement c-p6: grid for the remaining parts (Prins: same lines, same orientation) | gen_controller_pcb.py section 5 (the net-based placer is removed; all parts at fixed positions): opto logic row 1 (decoupling, pull-ups, R43, Q4, R35 under their pins) and row 2 (R44 under Q4, U16 with C5 and R36 under U6, U5 with C4 under U2); U11, U14, U15, U13, U12 in one row at 8 mm pitch with each decoupling capacitor 3.6 mm to the right, C11 left of U11; row 2 under them for C12, R65 and the pull-ups and pull-downs; JP11 at the end of the row. ICs at rotation 0, 0603 parts upright. kicad-cli pcb drc with zone refill; render; STEP for the RF board view | No clearance or courtyard errors; silkscreen notes for p3; starved thermal on the GND pads of U14 and U16 (closed by their vias at routing) | done; review by Prins. Review closed by M-67 and D-153 (review S-17, 2026-11-02) |
| M-58 | Controller board autorouting trials (Freerouting) on layout c-r1 | routing/route.py: GND class not routed (locked GND via per SMD GND pad, 26), analytics off (-da). Run 1 (jar 2.x on Java 21): both layers. Run 2 (Freerouting 2.5.0 app): stage a F.Cu only (--router.layers.routable=true,false), stage b both layers from the locked stage a result, via cost 200 | Run 1: 2 unrouted, F.Cu about 1130 mm, B.Cu about 990 mm with long runs across the logic GND plane (DATA_RX 66 mm, KILL 64 mm, DATA_TX 74 mm). Run 2: stage a 30 unrouted on F.Cu only (1471 mm); stage b still 13 unrouted, B.Cu 593 mm, 53 vias. Neither result keeps the B.Cu plane whole; results kept in Claude outputs/pcbwork/ctl (keep_r1a, keep_r1b_fr25); board back at c-r1 (placed, GND vias) | done; routing method open. Routing method closed by D-143 (review S-17, 2026-11-02) |
| M-59 | Controller board routing r2 (grid router, D-143) | routing/export_geom.py (KiCad: pads with exact copper outline, locked GND vias, rule area, holes) -> routing/grid_router.py (numpy, scipy, scikit-image MCP; 0.1 mm grid, clearance + half width + 0.085 mm margin; power nets narrow to 0.254 mm only where a wide track does not fit; rip-up by order: failed nets first, board routed again) -> routing/routes.json -> gen_controller_pcb.py c-r2; kicad-cli pcb drc with zone refill; F.Cu and B.Cu plots | 60 nets routed, 0 unconnected, no clearance or short errors (pass 2 of the router, 74 s). F.Cu 1906 mm, B.Cu 198 mm, 119 signal vias. On the logic side B.Cu carries only short jumps (each 2.5 mm or less); the plane stays one piece. DRC: 4 starved thermals on F.Cu at THT GND pads (U1 pin 5, J2 pins 8, 16, 24; these pads join the B.Cu plane), silkscreen notes for p3 | done; review by Prins. Review closed by M-67 and D-153 (review S-17, 2026-11-02) |
| M-60 | Controller board routing r3 on 4 layers (D-144) | routing/grid_router.py r3: numba A* on a 0.1 mm grid, state layer, cell and direction; L1 vertical and L3 horizontal preferred (cost 1 per mm, off-direction 3, diagonal 3.5, 45 degree bend 6, 90 degree bend 12, via 25); turns of 135 degrees or more not allowed; no via next to a diagonal outside the 1.5 mm breakout zone; start and end at the pad centre; rip-up by order. Netclasses Power 0.508/0.2, Loop 0.508/0.5, Default 0.254/0.2, GND not routed (own locked via per SMD GND pad). gen_controller_pcb.py c-r3; kicad-cli pcb drc with zone refill; F.Cu and In2.Cu plots | 60 nets routed in pass 1 (30 s), 0 unconnected, no clearance or short errors; DRC only silkscreen notes (for p3). L1 1192 mm (vertical 487, diagonal 700, horizontal 5), L3 1317 mm (horizontal 1166, diagonal 144, vertical 6), 143 signal vias. Widths: 0.508 mm on power and loop nets (only +3V3 narrows to 0.254 at fine pitch), 0.254 mm elsewhere. Via count high: router cost tuning possible | done; review by Prins. Review closed by M-67 and D-153 (review S-17, 2026-11-02) |
| M-61 | Controller board routing r4 (D-145) | gen_controller_pcb.py c-r4 --no-routes (CHASSIS zones, pad vias, stitching vias) -> export_geom.py -> grid_router.py r4 (CHASSIS not routed; grid on multiples of 0.1 mm; a short stub joins an off-grid pad centre, so long segments stay exactly vertical or horizontal) -> gen_controller_pcb.py c-r4 -> kicad-cli pcb drc with zone refill; layer plots r4_F.Cu, r4_In1.Cu, r4_In2.Cu, r4_B.Cu (Claude outputs/pcbwork/ctl). Cost sweep: r3 costs, then ORTH 4 / DIAG 4 per mm, ORTH 5 / DIAG 4 / VIA 20, ORTH 5 / DIAG 5 / BEND90 10 | 59 nets routed, 0 unconnected, DRC only silkscreen notes. L1 1140 mm (995 vertical, 112 diagonal, 33 horizontal), L3 1263 mm (1242 horizontal), 124 signal vias; 34 plane pad vias, 131 stitching vias. The r3 figure of 700 mm L1 diagonal was wrong: long straight tracks were skewed by up to 0.05 mm to the off-grid pad centres and counted as diagonal. Sweep: higher diagonal cost lowers L1 diagonal from about 100 to 3 to 24 mm, but raises the vias from 119 to 175 to 211; r3 costs kept. Finding: a board with old tracks applied gives new vias a wrong net when KiCad loads it; the generator now has --no-routes for the export. Power nets: +5V 200 mm and 13 vias, +3V3 229 mm and 20 vias (18 % of the track length, 27 % of the vias) | done; review by Prins. Review closed by M-67 and D-153 (review S-17, 2026-11-02) |
| M-62 | Controller board silkscreen c-s1 (skill schematic-and-marking.md) | gen_controller_pcb.py section 5d: labels (J1 LINK, PAIR 4 3 1 2, isolation band, TP1 to TP9 with signal names, JP11 SDA settings), art block (SHACK RELAY MATRIX 1.5 mm, board, rev, date code DC 2643, 73 de PE1RGU, safety gate as an IEC 60617 NOR with truth table), back: J2 to RF board J14 and stackup legend; every reference placed by search clear of pads, silk, texts and other courtyards; kicad-cli DRC; F.SilkS and B.SilkS plots s1_front.pdf, s1_back.pdf (Claude outputs/pcbwork/ctl) | DRC with --severity-all: 0 violations, 0 unconnected. All references placed, none on another part's courtyard where avoidable. The ≥ glyph renders. Date code DC 2643 (ISO week of 2026-10-21) to update at the order | done; review by Prins. Review closed by M-67 and D-153 (review S-17, 2026-11-02) |
| M-63 | Controller board routing e1 (D-147) | grid_router.py: Entry class 1.016 mm; width steps down the series only where a track does not fit (1.016, 0.508, 0.254), narrowed nets reported; clearance margin raised from 0.085 to 0.1 mm (= grid pitch: painted copper can end one cell short of the true edge; the first e1 run gave 14 clearance errors of up to 0.01 mm at the GDT centre pins); L1 ring of 1.0 mm kept free around through-hole CHASSIS pads (one starved thermal at GD1 pin 2 otherwise). gen_controller_pcb.py: Entry netclass. kicad-cli DRC, plots e1_F.Cu, e1_In2.Cu | 59 nets routed in pass 1, 0 unconnected, DRC --severity-all 0 violations. All Cat6 wires at 1.016 mm, none narrowed (only +3V3 narrows to 0.254 at fine pitch). L1 1151 mm, L3 1256 mm, 120 vias | done; review by Prins. Review closed by M-67 and D-153 (review S-17, 2026-11-02) |
| M-64 | Cat6 choke land pattern and winding sense against the TDK ACT45B drawing (CT-05, D-130) | TDK ACT45B datasheet 2016-02-16 (filed, Chinese edition): body 4.5 x 3.2 x 2.8 mm, terminals 1 and 4 on one long side, 2 and 3 on the other; recommended land 5.9 x 3.4 mm outside, 3.2 x 1.6 mm inside (pads 1.35 x 0.9 mm, pitch 4.55 x 2.5 mm); circuit: windings 1-4 and 2-3 side by side on one drum, 1 and 2 at the same end. Layout c-s1: KiCad footprint L_CommonModeChoke_Coilcraft_1812CAN (pads 1.0 x 1.15 mm, pitch 3.68 x 1.73 mm), long axis along x, P enters at pad 1 (right) and leaves at pad 2 (left), N enters at pad 3 (left) and leaves at pad 4 (right) | Drawing check | Finding 1: P and N enter the choke at opposite ends. With the TDK part the common-mode fluxes cancel: the choke then gives no common-mode impedance and adds about 4 x 51 uH in the difference path (harmless at 9600 baud, but the CT-05 RF filter does not work). The template assumed diagonal dots (Coilcraft symbol); the TDK drawing shows starts at the same end. Finding 2: the footprint does not match the TDK land (pitch 3.68 x 1.73 against 4.55 x 2.5 mm; the TDK terminal overhangs the pad by about 0.16 mm). Murata DLW43SH and Coilcraft 1812CAN drawings to check | closed by D-149 (M-65) |
| M-65 | Controller board c-s2 (D-149): schematic c12, netlist ctl12, layout c-s2, routing | gen_ctl_fp.py (L_CMC_TDK_ACT45B, GDT_3Pin_P4.40mm_Bourns-2036-B2_Littelfuse-SL1003A-R); gen_controller_sch.py c12-cmc-gdt2; kicad-cli ERC and netlist ../verify/ctl12.xml; verify_logic.py rf12 ctl12 and verify_system.py si14 ctl12; gen_controller_pcb.py c-s2 (choke orientation and Y-capacitor pads checked by assert; pad vias keep 1 mm from other vias; references fall back to the own body when no free spot is outside); --no-routes, export_geom.py, grid_router.py, DRC with zone refill; STEP export | ERC 0. All logic and system checks pass. Router: 59 nets in pass 1, 104 vias (was 120), L1 1149 mm, L3 1201 mm; only +3V3 narrows at fine pitch. DRC --severity-all: 0 violations, 0 unconnected (one hole-to-hole error between two CHASSIS pad vias in the first run, fixed by the 1 mm via spacing) | done; review by Prins. Review closed by M-67 and D-153 (review S-17, 2026-11-02) |
| M-66 | Controller board schematic c13: frames per function and text clean-up (Prins, 2026-10-22) | gen_controller_sch.py c13-sections: Sheet.section() draws a dashed frame with a bold title per function (link sheet: pairs 1 to 4, PTT to K0, decoupling; MCU sheet: 3.3 V supply, SDA select and I/O, MCU, safety gate, READY gate, decoupling, test points). Fixes: GDTs 2.54 mm left (wires no longer cross the GDT body), 47R 2.54 mm right (Y-capacitors clear of the 47R text), values of horizontal resistors above the body, decoupling at 17.78 mm pitch, GND names centred under the symbol, TP9 on the TX_ANY wire, TP4 text clear of the RF_A2_N label, Q4 text beside the mirrored symbol, U15 and A1 moved clear of the frame titles, title block C4 to the 4-layer stackup (D-144, D-145), date 2026-10-22. KiCad MCP find_overlapping_elements and find_wires_crossing_symbols before; kicad-cli ERC; netlist ../verify/ctl13.xml compared with ctl12; verify_logic.py and verify_system.py; PDF render checked by eye; PCB generator on ctl13, DRC | ERC 0. Connectivity and parts identical to ctl12 (88 nets). All logic and system checks pass. 16 wire-over-GDT crossings and the R-to-Y-capacitor overlaps removed. PCB c-s2 unchanged, DRC 0, 0 unconnected. KiCad note: on a mirrored symbol the field justification is mirrored too | done; review by Prins. Review closed by M-67 and D-153 (review S-17, 2026-11-02) |
| M-67 | Controller board order-readiness pass | Fabrication Toolkit (bennymeg, KiCad 10 plugin) from the command line: KiCad Python -m com_github_bennymeg_JLC-Plugin-for-KiCad.cli -p controller-board.kicad_pcb -e -nI -nB (zones already filled by kicad-cli; -aN fails without the GUI); output production/. Gerber and drill read back (file functions, outline, holes per tool against the board). gen_bom.py: hand-assembly BOM from ctl13 with first and second sources. kicad-cli pcb render top and bottom. Order sheet production/ORDER-controller-board.md | Gerbers 4 copper layers, outline 152.0 x 122.5 mm; drill counts match the board (PTH 269 / 28 / 60 / 12 / 1, NPTH 3 / 2). BOM 33 lines, 71 parts, 10 DNP, 10 pads without a part. Findings: VO2611 order code was the SMD option (-X007T) on a DIP-8 footprint, corrected to VO2611 (schematic c13 MPN); 74LVC1G27 second source Nexperia GW is SOT363 and 74LVC1G74 second source Nexperia DC is VSSOP8: both do not fit the footprints. New second source for U14: Diodes 74LVC1G27W6-7 (SOT26, pin-out to check); U13 (TI DCT) has no second source in the same package. ERC 0, netlist connectivity unchanged | done; U13 single source and U14 pin-out to decide or check. U13 closed by D-154, U14 by D-155 (review S-17, 2026-11-02) |
| M-68 | U13 package change (D-154) and second-source check of U14 | Nexperia 74LVC2G74 (Rev. 16, 2025-09-22) and 74LVC1G27 (Rev. 6, 2023-08-16) read in the browser (text, PDFs not saved); TI SCES794G (filed) for DCU pin-out and land. Schematic c14-u13dcu, netlist ctl14 (only the U13 footprint differs from ctl13); layout c-s3: U13 pads local clearance 0.12 mm (pad gap 0.15 mm), pins 6 and 8 (+3V3) joined by a 0.2 mm strap outside the pad tips, pin 7 (RESET_N) and pin 4 (GND) by stubs to vias under the body, pin 2 (GND) to pin 4 around pin 3 (NC); router ends on terminals (routing/terminals.json) and starts only from locked copper that touches the first pad (grid_router fix) | ERC 0; router 59 of 59 nets, 105 vias; DRC 0 violations, 0 unconnected; logic and system checks pass (ctl14). Drill PTH 0.3 mm x 270 (105 routed, 34 plane, 131 stitching). Finding for U14: Nexperia 74LVC1G27GV is SOT457 (SC-74), same pin-out as TI DBV (1 A, 2 GND, 3 B, 4 Y, 5 VCC, 6 C), D 2.7 to 3.1, HE 2.5 to 3.0, e 0.95: fits the present SOT-23-6 land; the M-67 statement that Nexperia has no fitting package was wrong | done; U14: D-155 |
| M-69 | RF board schematic v12a: frames per function and text clean-up (as controller board c13, M-66; hardware skill v2.7) | gen_rfboard_sch.py: Sheet.section (dashed frame, bold title); frames on the radio port (TX row, RX row, K0, decoupling), antenna port (column link and bias-T option, detector, K1 relay), power (coil supply, chassis bond, input protection moved 30.48 mm right, 3.3 V, supports), RF detect, IO expanders (pull-ups moved up 7.62 mm), bias-T (U1001, feeds A1 to A4), J14 filter. Text fixes: R1012 value off the source line, C1011/D1011 spacing (TVS and read-back divider 2.54 mm right), R802 text clear of C801, R402 text above the line. Root sheet: no frames (the sheet blocks are boxes). Checked by SVG render of every sheet | ERC 0; netlist rf13: nets, parts, values and footprints identical to rf12; logic verification passes (rf13, ctl14) | done |
| M-70 | RF board clearance mechanism for D-12 (2.0 mm outer) and D-117 (0.5 mm inner) in kicad-cli 10.0.5 | Copy of the RF board (Claude outputs/pcbwork/rf/drutest), GND zones on F.Cu and In1.Cu over K102, kicad-cli pcb drc --refill-zones, nearest zone point to K102 pad 14 measured with KiCad Python. (1) RF netclass 2.0 + rf-board.kicad_dru with an inner-layer rule 0.5 (conditions A.NetClass, A.hasNetclass, none); (2) the same file with an inner rule 3.0; (3) RF netclass 0.5, F.Cu zone local clearance 2.0, In1.Cu zone 0.2 | (1) and (2): gap 2.07 mm on both layers: kicad-cli does not read the .kicad_dru file (also a larger value has no effect). (3): F.Cu 2.07 mm, In1.Cu 0.62 mm: works. Use for the layout: RF netclass clearance 0.5 mm; outer GND pours in the RF area with zone clearance 2.0 mm; RF to RF and RF to other pads on L1/L6 checked by the board generator (DRC checks only 0.5 mm there) | done |
| M-71 | RF board layout p2a: RF copper (D-116, D-119, D-156, D-157) | hardware/unit/rf-board/gen_rfboard_copper.py, run by gen_rfboard_pcb.py (REV p2a-rf, netlist rf13). Rows on L1 below each relay row (TX y0+18.5, RX y0+42.5; COM stubs join both COM pins); K0 TXBUS on L1, RXBUS on L6 to two RF vias (1.2/0.8) on the RX row; EXP on L6 to the SMA strap; feeds on L6 at x 90 (R1), 81 (R2), 72 (R3): R1 farthest from K0, so no feed crosses another on L6 (the study had 81, 90, 72); R1 jog on L1 at y 219.5, R2 jog on L1 at y 212.5 with two transitions; columns on L6 at the antenna axes, NO stubs at the pin mid point; antenna port: column link, detector tap and DC block on L1, PORT and PARK on L6, ANTENNA on L1 to the SO-239 strap. W 0.975 everywhere. Own spacing check on L1/L6 (exact pad copper, other RF nets, RF vias, 2.0 mm). GND vias 0.6/0.3: return vias (2 per RF change, radius 3.4 to 4.3 mm), fence at 3.05 mm and 2.54 mm pitch where the clearances allow. Pours: L1/L6 2.0 mm, logic regions 0.25 mm (priority 1), L2 to L5 0.2 mm. C101, C201, C301 GND pad: own via, no zone connection. kicad-cli DRC with zone refill | 299 RF segments, 12 RF vias, 0 RF spacing violations; 260 return vias, 1527 fence vias; DRC: 0 copper violations (161 silk overlap, 66 silk over copper: silkscreen pass p3); all RF nets connected; 499 open logic connections (routing next). Fix on the way: removed tracks and zones must stay referenced in Python (REMOVED), else the next run fails (SWIG) | done (step 1 of p2) |
| M-72 | D-158 applied: RF board p2b and controller board c-s4 | RF board: chamfer of 2.0 mm per leg on every bend of the RF copper (rows and their end relays as one polyline, top column stub, feeds, ANTENNA); transition vias on straight runs, bends on one layer; antenna port: link R?02 moved to y 182.885 (pad 2 level with the K1 NO pins), DC block C?01 to c + 5.5 / 185.023 (one vertical line with L?02 and C?02), detector tap C?04 to y 182.885, detector row to x c - 19.8, y 187.0 (2.0 mm from the tap ANT pad and the K1 NO pins); PORT: C?01 to L?02 vertical with a T to the link. New generator check: RF pad to pad of another part 2.0 mm on L1/L6 (found 1.64 mm C?04 to R?05 and 1.82 mm K?01 to C?03 on the way; fixed). Controller board: U13 straps chamfered (leg 0.45 mm), terminal at the strap middle; grid_router.py post-pass chamfers every 90-degree bend (leg 0.5 mm) except at a via or pad centre. Check script Claude outputs/pcbwork/rf/bends.py | RF board: 0 bends of 90 degrees, 0 RF spacing violations, 0 copper DRC violations, RF nets connected. Controller board c-s4: 13 bends before, 0 after (10 chamfered by the router, 3 at the straps); router 59 of 59 nets, 104 vias; DRC 0, 0 unconnected; new Gerber zip c-s4 | done |
| M-73 | D-159 applied: controller board c-s5 | grid_router.py post-pass chamfer_tees: a branch end on the interior of a straight track, or three ends at one vertex (two in line, one at right angles), on tracks below 0.6 mm, not at a via or pad centre; two fillet segments of the branch width. Router 59 of 59 nets, 104 vias; 3 T-junctions filleted (the others are at pads). bends.py: a point on another segment of the same net (fillet foot) is not a corner | DRC 0, 0 unconnected; 0 right-angle bends on the controller board and on the RF board; new Gerber zip c-s5 (drill counts unchanged); c-s3 zip archived (archive/controller-board-fab-c-s3-2026-10-23, Prins OK) | done |
| M-74 | KiCad 10 joins touching copper of different nets on load (claim from KiCadRoutingTools, review-routed-board) | Copy of the RF board (Claude outputs/pcbwork/rf/drutest/shorttest.py): two 0.254 mm tracks on In2.Cu, /SCL at y 10.0 and /SDA at y 10.2 (overlapping copper), saved with KiCad Python; kicad-cli pcb drc --severity-all; board loaded again with KiCad Python | DRC: no shorting_items, no clearance violation; after the reload both tracks are on /SDA. Confirmed: overlapping fixed copper of different nets is not reported. The generators must check fixed copper by geometry before saving (the RF copper step does, gen_rfboard_copper.py) and compare track nets after a reload. Hardware skill v2.13. Net check of both boards (Claude outputs/pcbwork/rf/netcheck.py): no track end inside a pad of another net (controller 631 tracks, RF 332); controller routes.json: no net changed; 4 pieces of 0 to 0.02 mm at off-grid pad centres (L4P, RF_A2_N) not matched, inside pad copper: grid_router.py is to drop segments below 0.05 mm and skip chamfers on them at its next change (no controller revision for this alone) | done; router clean-up done in the general router (M-75): short stubs at pad centres stay, no chamfer on a leg below 0.1 mm |
| M-75 | RF board logic routing p2c | Router: hardware/unit/rf-board/routing/grid_router.py, general version of the controller router with the board settings in router_cfg.json. Layers: F.Cu only in the logic regions, the detector and bias boxes of each antenna port and 1.5 mm around own SMD pads; In2.Cu horizontal; In3.Cu vertical; B.Cu obstacle only (D-156). Clearance of routed copper to RF copper: 2.0 mm on F.Cu and B.Cu, 0.5 mm on In2 and In3, 2.0 mm to RF pads on all layers (their local pad clearance, which DRC applies on every layer). Classes: Power (+12V*, +5V, +3V3, CLAMP_*) 0.508/0.2 mm, others 0.254/0.2 mm; GND, CHASSIS and the RF nets not routed. Method: each net split into its pad-to-pad spanning tree; all 475 connections routed shortest first; failed nets first in the next pass. Run in the cloud workspace (the device shell stops background jobs after 180 s). Checks: kicad-cli DRC with zone refill; bends.py; netcheck.py (tolerance match) | 161 of 161 nets in 3 passes (825 s); 594 vias; F.Cu 1509 mm, In2 8504 mm, In3 6927 mm; 0 right-angle bends; 19 T fillets. DRC: 0 copper violations (silkscreen 212, for p3). Unconnected: CHASSIS (14 links, question to Prins) and pin 12 of 30 relays (the two NC pins of each relay are joined inside the relay; not routed, a track would only add a stub). netcheck: all 2619 route tracks keep their net after a reload; no track end in a pad of another net. Findings fixed on the way: a GND pad-via stub crossed U901 pin 1 (stubs now keep 0.2 mm from other pads); own copper is free for a route only where the whole track width stays inside it (a grid track over an off-grid own stub came 0.198 mm to the next via); a layer change inside own through copper adds no via; grid margin 0.12 mm; device_commit_files can send an old copy when the same staged path is used again (use a new path per commit, check md5) | done; open: CHASSIS, aggressor/victim check, stitching vias, silkscreen p3, controller regression with the general router. Open points closed by D-165 to D-167 (review S-17, 2026-11-02) |
| M-76 | D-162 applied: RF board p2c with the CHASSIS split | Schematic v12b-chassis-split, netlist rf14 (difference to rf13 by script: only the CHASSIS net, now CHASSIS with H1, JP1, C1 and CHASSIS_S1 to S6 with Sn and its bond capacitor); ERC 0. Router: CHASSIS nets in the Power class (0.508 mm); board netclass Power now also lists +3V3 and CHASSIS (as routed). Same router and settings as M-75 | 168 of 168 nets in 3 passes (811 s); 611 vias; F.Cu 1486 mm, In2 8486 mm, In3 6973 mm; 0 right-angle bends. DRC: 0 copper violations; one starved_thermal warning (In2 GND island at J12 pad 1, joined to the pad only; a stitching via there is to fix it); silkscreen 212 for p3. Unconnected: only pin 12 of 30 relays (NC pins joined inside the relay, not routed). netcheck: 2639 of 2639 route tracks keep their net; no track end in a pad of another net | done; open: stitching vias, aggressor/victim check, silkscreen p3. Open points closed by D-165 to D-167 (review S-17, 2026-11-02) |
| M-77 | D-158 and D-163 applied: RF board p2c3 | Placement: align pass in gen_rfboard_pcb.py group() after the satellites (snap to 0.5 mm, rows then columns within 1.5 mm, a test point on the line of the nearest pad of its net; every move checked against all courtyards and keep-outs); by hand: R3 0.7 mm right, D2 cathode and TP4 on the Q1 drain line (+12V_SW straight from Q1 through TP4 to D2). Router: costs in router_cfg.json (D-163); own pads repel outside the entry corridors; a free layer change only at the centre of own through copper; chamfer and fillet pieces checked for clearance (a smaller leg of 0.3 or 0.2 mm when the full one hits; a fillet below 0.2 mm left out); corners at pads and vias of other nets no longer skipped by mistake. GND pad via search out to 2.5 mm (C402 to C702 pad 2 now have a via, without spokes) | 168 of 168 nets in 1 pass (367 s); 747 vias (611 before, +22 %); F.Cu 1738 mm, In2 8440 mm, In3 7113 mm; 445 corners chamfered, 26 T fillets; 12 right-angle corners left where no chamfer keeps the clearance (bends.py now skips corners at pad and via centres). DRC: 0 copper violations, one warning (In2 GND island at J12 pin 1, for the stitching pass); silkscreen 205 for p3. Unconnected: only the relay NC pin pairs. netcheck: 3017 of 3017 route tracks keep their net; no track end in a pad of another net. Q1 area: D3, D6, C2 and D1 on y 6.0; D5 pin 2 joins the +12V_RLY line straight below D6 | done; open: stitching vias, short jogs of 0.1 to 0.3 mm in some routes (router has no minimum segment length), silkscreen p3. Open points closed by D-165 to D-167 (review S-17, 2026-11-02) |
| M-78 | D-164 applied: RF board p2c4 | grid_router.py: second search astar_rl with the steps since the last turn or via in the state (5 values for 0.4 mm), shared search buffers reset by a touched list, lazy heap, heuristic weight 1.5 (about 10 times faster; path cost at most 1.5 times the optimum), used in the first window when it has at most 80 million states, else the plain search (reported). Post-processing fixes found on the way: rounding keys stable for x.xxx5 values (a pad stub was dropped and its track tilted), a chamfer stays short of a branch that ends on its leg (A1_BIAS was cut open), segments split at fillet ends (KiCad reported fillets on the middle of a track as dangling) | 168 of 168 nets in 1 pass (369 s); 815 vias (747 before, +9 %); F.Cu 1676 mm, In2 8446 mm, In3 7160 mm; visible segments below 0.35 mm before chamfering: 23, all in breakout zones (about 150 before); 594 corners chamfered, 18 T fillets, 9 right-angle corners left. DRC: 0 copper violations; warnings: J14 pins 6 and 8 one F.Cu spoke, J11 pin 1 In2 island (both for the stitching pass; a spoke ring on F.Cu made the search fail); silkscreen 205. Unconnected: only the relay NC pin pairs. netcheck: 3740 of 3740 route tracks keep their net | done; open: stitching vias and edge fence, silkscreen p3. Open points closed by D-165 to D-167 (review S-17, 2026-11-02) |
| M-79 | D-165 applied: RF board p2d | grid_router.py: return-via room in the search (gnd_spot_ok: other-net copper, RF clearances, 0.9 mm to other vias, 0.4 mm drill to drill, off all pads), placement right after each connection, reuse of GND vias in the radius, inner exit strips (escape_inner 5 mm), fan-out connections first, rounded board corners (5 mm) kept clear, no narrowing for the coil supply. routing/stitch.py: edge fence and 5 mm grid with the same checks, report of signal vias without a GND via within 3 mm. export_geom.py also reads footprint rule areas (none on this board). Faults found on the way: GND vias in GND connector pads (DRC hole_to_hole, via_dangling), a route in the 5 mm corner arc (copper_edge_clearance), +12V_RLY narrowed to 0.254 mm over 115 mm (about 0.2 V drop at 0.4 A) | 168 of 168 nets in 6 passes (2869 s); 767 signal vias, 296 return vias from the router, 291 edge fence vias, 743 grid vias (1122 from stitch.py); F.Cu 1979 mm, In2 8628 mm, In3 7117 mm. Signal vias with a reference change: 500; GND via within 1.5 mm 422, 1.5 to 2.0 mm 23, 2.0 to 3.0 mm 22, none within 3 mm 33 (expander and coil-driver area, slow logic lines; mostly fan-out vias). Narrowed to 0.254 mm: CLAMP_SW 132 mm (flyback current, ms pulses), +3V3 195 mm (a few mA). DRC: 0 copper violations, no warnings except silkscreen (215, for p3); unconnected only the relay NC pin pairs. 9 right-angle corners. netcheck: 3819 of 3819 route tracks keep their net | done; open: signal vias without a near return (M-80: 12 at 3.0 to 4.1 mm), silkscreen p3. Open points closed by D-165 to D-167 (review S-17, 2026-11-02) |
| M-80 | Work on the 33 signal vias without a GND via within 3 mm (M-79) | (1) stitch.py: the return-via report now runs at the end, with the edge fence and grid vias in place (before, it ran before them). (2) Router trials, not kept (copy in Claude outputs/pcbwork/rf/scratch/grid_router_m80_trials.py): return-via room also required at the fan-out vias of the expanders; nets with a missing return via first in the next pass; a last try without the return-via room; rip-up and reroute of the nets around an open pad (radius 3 to 6 mm, 30 rounds) | (1) With all GND vias in place: of 500 signal vias with a reference change, 422 have a GND via within 1.5 mm, 29 within 1.5 to 2.0 mm, 37 within 2.0 to 3.0 mm, 12 within 3.0 to 4.1 mm (all in the expander and coil-driver band, slow logic and static drive lines). No board change. (2) No trial routed all nets: 1 to 10 nets stayed open per pass; rip-up oscillated between 1 and 3 open nets in the expander band. The board stays at M-79 | done; 12 vias at 3.0 to 4.1 mm for Prins to accept or not. Accepted by D-166 (review S-17, 2026-11-02) |
| M-81 | Aggressor/victim check, RF board (routing/xtalk.py) and D-167 applied | Victims: detector outputs, detector nodes, VREF, comparator + inputs. Aggressors: coil drains (37 V flyback edge), coil supply and clamp nets, coil gate drive, I2C, bias lines and bias switch nets. Measured: smallest edge gap on the same layer, parallel length within 1.0 mm on the same layer, broadside parallel length on In2/In3 (centre lines within 0.5 mm in plan view; F.Cu and B.Cu are screened by L2 and L5). Router run with the pair rule (6 passes, 4229 s), stitch.py, generator, DRC, bends.py, netcheck | Before: coil and I2C nets 5.6 mm or more from every victim; bias lines 0.35 mm from DET over 70 mm (A3) and 32 mm (A2/A1). After: every aggressor 1.15 mm or more from every victim on the same layer, no parallel run within 1.0 mm. Left: /A2_DET runs 13.8 mm broadside under /A2_BIAS (In2/In3, 0.233 mm apart): about 1 pF; the bias switch Q1022 turns on through a gate RC of tens of us (estimate), so the coupled spike on the 23.5 kohm DET node stays in the microvolt range (to confirm with a scope at bring-up). 168 of 168 nets, 1074 router vias, 1124 stitching vias; return vias as M-80 (12 at 3.0 to 4.1 mm). DRC 0 copper violations, only silkscreen; unconnected only the relay NC pairs; 9 right-angle corners; netcheck 3823 of 3823 | done; bring-up: scope DET while switching the bias |
| M-82 | RF board silkscreen p3 (gen_rfboard_pcb.py section 12, REV p3-silk) | Labels for the radio, EXP and antenna ports, the supply inputs and J14; test points as "TPx net"; matrix row and column labels; A2 RX ONLY note (D-103); HV warning triangle "RF 173 V pk 100 W HF" on both sides; art block with the signature (D-168); stackup legend on B.SilkS. References placed clear of pads, silk and other texts; values on the fab layer only. Fix during the pass: the generator edits the saved board and removed only Edge.Cuts drawings, so every run added a second copy of all board silk (20 silk_overlap, each text against its own copy); section 12 now removes all board-level F/B.SilkS drawings first. Labels that do not fit within 12 mm are tried turned 90 degrees, then within 25 mm | DRC (kicad-cli, refill): 0 violations; unconnected only the 30 relay NC pin pairs. All labels placed. 15 references stay on the fab layer only for lack of room (R1202 to R1206, C1202, C1206, C1208, Q109, Q202, Q204, Q302, Q303, Q307, R1032). Renders svg/rf-board-p3-F-silk.svg and -B-silk.svg | done |
| M-83 | Controller board regression with the general router (skill kicad.md: route the controller board again before the general router replaces the controller router) | General router (rf-board/routing/grid_router.py, M-81 version) on the c-s5 geometry (routing/geom.json), settings in Claude outputs/pcbwork/ctl/regress/router_cfg_ctl.json: layers F (V) and In2 (H), B obstacle only; classes as the controller router r4 (Power 0.508, Entry 1.016/0.5, Loop 0.508/0.5, GND and CHASSIS not routed); RF settings, regions, return vias and pairs off; costs and seg_min as the RF board (D-163, D-164). Applied in a copy of the board (Claude outputs/pcbwork/ctl/regress/unit), then kicad-cli DRC with refill, bends.py, netcheck.py | First run: 57 of 59 nets; LATCH_CLR and FAULT failed at U13 (VSSOP-8, pads 0.35 mm at 0.5 mm pitch): the 'deep' rule left no free cell beside the centre of a pad narrower than w + 2 x margin. Also the Cat6 Entry nets were narrowed from 1.016 to 0.508 mm (C-36 not met): the straight entry corridor ended inside the repel zone of a wide track. Two fixes in the general router: cells inside own pad copper are free where the track disc keeps clear of the clearance zone of other nets; corridor length includes w/2 + margin. Result after the fixes: 59 of 59 nets in pass 1 (96 s), Entry nets at 1.016 mm, +5V narrowed on one connection, DRC 0 violations and 0 unconnected, 1 right-angle bend (+3V3 at 106.6/50.0), netcheck 0. Against the c-s5 routing (controller router): 182 vias against 104, 2383 mm against 2344 mm, power trunks run as steps across the middle of the board. Share of the extra vias (single-pass runs): connection-by-connection routing and the entry rules about 44, minimum segment length about 28, the D-163 costs about 6. The c-s5 board is not changed. RF board routes are not changed; the fixes apply at its next routing run | done |
| M-84 | Shack interface schematic a16 (gen_shack_sch.py a16-fp-entry): footprints for J1, J3, GD1 to GD4 and L1 to L4 (D-171); footprints and two 3D models copied from the controller board library into lib/ | kicad-cli ERC; netlist si15 against si14 (nets as sets of ref-pin pairs, footprints per part) | ERC 0 violations. Connectivity the same as si14 except J3 pins 1 and 2 swapped (pin 1 GND, pin 2 VIN_P, as the XT60PW-M footprint). Footprints changed only on J1, J3, GD1 to GD4, L1 to L4 | done |
| M-85 | Shack interface layout p1 (new generator hardware/shack-interface/gen_shack_pcb.py): board 160 x 156 mm, 4 layers (D-170), parts placed by the zones of D-172. Panel parts fixed at the rear and front edges; 7805 at the left wall; Cat6 entry 2 x 2 behind J1; four loop-source columns; per radio port three rows behind the mini-DIN in pin order (ESD diode, 1 nF, test point) and the three optos in a row; port R1 placed by the satellite method of the RF board, R2 and R3 copied from R1 at the 35 mm connector pitch | kicad-cli DRC (no routes, no zones); render svg/shack-p1.svg | All 295 parts on the board, no courtyard overlaps. DRC: silkscreen only (93 silk_overlap, 72 silk_over_copper; silk pass later) and 4 hole_clearance inside the KiCad USB4105 footprint (J14 GND pads against its own NPTH pegs; to check against the GCT land). Open: a few port parts with far nets (R2x1, R2x2, R2x8) sit near the DevKit; the SAFE latch is a loose cluster; slot height and end panel thickness still to confirm on the Hammond drawing (TO-220 tab height, board length) | p1 for review |
| M-86 | Shack interface layout p1b (Prins, 2026-10-25: parts around U5 floating, keep traces short and direct). Pull-downs R2x1 (PERMIT) and R2x2 (KEY) placed with only the port parts as targets, so they sit at U2x1 and U2x2 pin 1; LED resistors R208, R308, R408 at pin 1 of their panel headers J8 to J10; expander U5 back in the D-172 row (y 72 to 88) under the ports, MCU support group under it right of the DevKit; port columns end at y 70 | Generator, kicad-cli DRC, airwire render (Claude outputs/pcbwork/shack/dump.py, MST per signal net) | No parts left mid-way: U5 has only C61 beside it. 295 parts, no courtyard overlaps, DRC silkscreen only plus the 4 J14 footprint findings (M-85). Signal airwire length 4485 mm. Long airwires left by the zone plan: PERMIT from the DevKit left pins to the ports, KILL_S J7 to U5, LATCHED latch to U5 | p1b for review |
| M-87 | Shack interface layout p1c, SAFE latch (Prins, 2026-10-25: parts around U8 messy). Fixed rows in signal-flow order: row 1 U7 (SAFE_LOST to SAFE_OK), U8 (PRE_N), U9 (LATCHED), U11 (TX_EN); row 2 U6 (POR_N) under U7, U10 (RESET clock) under U8, left of the U9 clock pin; every IC at rotation 0 (inputs left, output right) with its own 1 uF upright right of it, pad 1 level with the VCC pin (C72 to C77 one per IC); RESET RC network (R72, C71, D71, R71) below U10 toward J6; SAFE and LATCHED LED resistors R73, R74 at J6; KILL_S pull-up R75 at J7 | Generator, kicad-cli DRC, airwire render of the latch zone | Latch in two clean rows, all latch links short and without crossings over an IC. 295 parts, no courtyard overlaps; DRC silkscreen and the 4 J14 footprint findings only. Signal airwire length 4481 mm | p1c for review |
| M-88 | Shack interface layout p2, review of the whole board (Prins, 2026-10-25: check the rest of the board). Changes: (1) DevKit A1 turned 270 along the front edge (centre 89.5, 134): its signal pin row (pads 1 to 16, every used signal) now faces the loops, the MCU support, U5 and the ports; J14 under USB pads 19, 20; U61 and the CC resistors beside J14; MCU support zone above the DevKit. (2) Cat6 entry blocks under the J1 pins they serve (pair 4 left, pair 2 right, pairs 3 and 1 below) and the loop-source columns in the same order (loop 3 toward the latch and KILL, loop 2 toward port R1). (3) Loop-source column template: pass transistor, then sense transistor with Rsense and base resistor, enable switch with its pull resistor, return sense with its resistors and clamp, small parts upright in rows. (4) Radio port template: band stacks (1k, 10k, DNP) on the lanes of DIN3, DIN4, DIN7 and under JP202 for DIN1; DIN2, DIN6, DIN8 lanes free to the optos; optos in one row, radio side up; INH LEVEL, R204 and the zener on the DIN6 lane; SENSE A turned so that its DIN8 pin is next to TP208; LED resistors straight under the opto LED pins; gates turned 180 (output under the resistor it drives, inputs right with the pull-down, decoupling under the VCC pin). Ports R2 and R3 copied from R1 | Generator, kicad-cli DRC, airwire render (placement_dump.py, airwire_render.py with supplies GND, +3V3, +5V, +13V8, CHASSIS, RGND) | 295 parts, no courtyard overlaps, smallest courtyard gap in the port template 0.42 mm. DRC: silkscreen and the 4 J14 footprint findings only. Signal airwire length 4051 mm (p1: 4485 mm). Left open: pair 3 of J1 still crosses pair 1 to the lower entry row (T568B split pair); TX_EN from the latch to the three ports and KILL from J2 to loop 3 stay long by the zone plan | p2 for review |
| M-89 | Shack interface layout p3: (1) Cat6 entry with the four GDTs in one row directly behind J1 (upright, P pin on top), one column per pair at 8.25 mm pitch in the J1 pin order (4, 3, 1, 2): GDT, choke (both inputs on top, P side from the TDK pin-out), Y-capacitors side by side, 47R MELF per wire, TVS across; J1 centred over the columns at x 38.5, H1 at x 53; loop-source columns moved under the entry columns in the same order. Reason: the 2 x 2 blocks of p2 put two GDTs 45 mm from the CHASSIS bond (skill: protection at the connector, short surge path). (2) Board 159 mm long (A-25). (3) Planes D-173, plane via per SMD pad of GND, RGND and CHASSIS (with checks of the via stub against other pads and fixed links), fixed links for the GND BOND (RGND pad into the island) and the RGND-to-CHASSIS capacitors (CHASSIS pad to the strip). (4) USB-C J14 fan-out as fixed copper with terminals (0.5 mm pitch, alternating A/B data pads: D+ joined by a U over A7, D- joined on In2 through two 0.4/0.2 vias; VBUS to U61 pin 5 and to C64; CC stubs); U5 pin 24 linked to C61 pad 1. (5) U9 decoupling capacitor above the VCC pin so that PRE_N reaches pin 7 | Generator (gen_shack_pcb.py p3), kicad-cli DRC with zone refill, airwire render (3871 mm before planes) | Placement: no courtyard overlaps; DRC copper clean before routing except the J14 footprint pegs (A-26) | done |
| M-90 | Shack interface routing p3: general router (routing/grid_router.py with a new per-net keep-out option, routing/router_cfg.json: F vertical, In2 horizontal, B obstacle; classes Power 0.508, Entry 1.016/0.5, Loop 0.508/0.5; GND, RGND and CHASSIS not routed; keepout.json from the generator), then the generator adds the routes and the stitching vias, kicad-cli DRC with refill, bends.py, netcheck.py | 156 of 156 nets in pass 4 (585 s), 2285 tracks, 428 vias (F 3705 mm, In2 2238 mm); stitching vias CHASSIS 165, GND 529, RGND 120; plane vias 137. DRC: 0 copper violations, 0 unconnected; left: silkscreen (silk pass), 19 starved thermals (pads in the narrow band-stack holes and the J14 shell; each keeps at least one spoke), 4 hole_clearance inside the J14 footprint (A-26). 4 right-angle bends; netcheck 0 | done; for review |
| M-91 | Shack interface silkscreen p4 (gen_shack_pcb.py section 8, REV p4): zone frames with titles (D-172; frame lines broken at pads and part silk), jumper settings (D-175), connector, test point (DIN pin numbers above the test points) and panel header labels, art block (title, rev, date, 73 de PE1RGU, signature D-176 with truth table), back: jumper table per port and stackup legend. Port silk placed once at the first spot free in all three ports, so R1 to R3 carry the same silk. Text 1.0 mm, line 0.15 mm. kicad-cli DRC: 0 silk findings, 0 unconnected; left 19 starved thermals and 4 hole clearances in J14 (A-26). 14 references stay on the fab layer only (no room: C2, C25, R204, R304, R404, R11, R12, R21, R22, R31, R32, R41, R42, U202) | done |
| M-92 | Shack interface fit in the Hammond 1455T1601 (A-25), in SolidCraft 0.22.1 (solidcraft-cli run hardware/shack-interface/case/fit-script.json; design hardware/shack-interface/case/shack-case-fit.solidcraft): Hammond STEP 1455T1601.stp (hammfg.com, 2026-10-26) and the board STEP (kicad-cli pcb export step --subst-models --user-origin 20x20mm, case/ref-shack-interface.step; J3 now with the Amass XT60 model as the RF board; L1 to L4 have no 3D model); board in the 2nd slot from the bottom (slot centre y -39.68, board centred along the extrusion), inspect.clearance with 3 mm. Profile: 11 slot levels per side at 3.5 mm pitch, opening 2.0 mm, 1.5 mm at the bottom; inner height about 47 mm. Result: one overlap, the 7805 model leads (8.1 mm below the board) with the bottom cap: trim the leads to 3 mm or less (4.1 mm to the bottom ledge). Lowest slot rejected: THT pins of U1, JP405/JP406 and C1 touch the bottom ledges (0 to 0.4 mm). Clearances: board to slot flanks 0.2 mm, board ends to the bezels 1.1 mm, 1206 parts to the side fins 0.94 mm, tallest part (7805 tab) 18.9 mm above the board with about 18 mm left to the top; connector faces to the end panels 1.85 (J1), 2.3 (J11 to J13, J14), 2.55 mm (J3), see D-177. Offline section plot case/fit-sections.png (OpenCascade) | done |
| M-93 | Shack interface layout p5 (D-177): panel connector faces 2.0 mm beyond the board edges (OVH in gen_shack_pcb.py): J11 to J13 at y -2.0, J1 and J3 moved 1.55 and 2.25 mm to the rear; J14 cannot overhang (its rear shell pads sit 2 mm behind the face), so the front edge has a 13 x 2.0 mm board tab under J14. CHASSIS strip edge moved with the mini-DINs (CH_Y 5.5). U61 now fixed left of the fan-out (the satellite placed it over the fan-out after J14 moved, and USB_CC1 did not route). Footprint silk of the overhanging connectors trimmed 0.4 mm inside the edge (DRC lib_footprint_mismatch warnings on J3, J11 to J13 as a result). Routed again: 156 of 156 nets in one pass, 417 vias; stitching CHASSIS 150, GND 511, RGND 136. kicad-cli DRC: 0 copper violations, 0 unconnected, 0 silk findings; left 24 starved thermals, 4 J14 hole clearances (A-26), 4 footprint mismatch warnings. Fit in SolidCraft again (case/shack-case-fit.solidcraft): every connector face and the board tab 0.3 mm from the end panels; no new overlap (only the 7805 model leads) | done |
| M-94 | Shack interface fit with the cap on top (D-178), SolidCraft 0.22.1: hardware/shack-interface/case/fit-script.json (housing turned so that SolidCraft Z is up and the cap on top; board parts side up, 2nd slot from the closed bottom), design case/shack-case-fit.solidcraft, view case/fit-iso.png. inspect.clearance 3 mm: no overlap; only contact the 7805 model leads (8 mm) with the closed bottom: trim to 3 mm or less (6.3 mm free under the board). Board underside to the closed face about 8.6 mm, tallest part to the cap about 13 mm; 1206 parts to the side fins 0.94 mm; connector faces and the J14 tab 0.3 mm from the end panels. Variant top slot: same result but 2.8 mm from the board underside to the corner ribs at the 7805 leads (rejected) | done |
| M-95 | Shack interface end plates a1 (D-179), gen_endplates.py (KiCad Python; connector positions from ../shack-interface.kicad_pcb, face profiles from the board STEP): rear plate with XT60 (16.1 x 9.0, with + and - beside the opening on the side of each pin), RJ45 (15.75 x 12.25), three mini-DIN 10.5 mm (R1 FT-710, R2, R3), title and call sign; front plate with the USB-C slot. Every cut-out inside the bezel window (assert). kicad-cli DRC: 0 violations, 0 unconnected on both plates. Render with the stackup colours (kicad-cli pcb render --use-board-stackup-colors). SolidCraft fit with both plate STEPs in place of the Hammond plates (Claude outputs/pcbwork/shack/case/fit_plates.json): connector faces 0.3 mm from the plate inside face, no overlap with the board or its parts; only overlap the Hammond countersunk screw models (A-27). Front plate controls (KILL, RESET, five LEDs) still to place after the part choice | done; front controls open |
| M-96 | Shack interface front plate a2 (proposal for review): KILL (EAO 84, key up) at u 30, SAFE and LATCHED LEDs and RESET right of it, display window (active area 42.72 x 22.70 mm + 0.3 mm) at u 76 to 119, USB-C slot unchanged, labels below the parts, title along the bottom. KILL and RESET left of the DevKit (board x 63 to 116 leaves only about 13 mm behind the plate); the display (about 9 mm deep) over the DevKit. Display data from the Waveshare files (schematic: RT9193-33 regulator, TXS0108 level shifter, backlight transistor with 10R and a 10k pull-up on BL; 3D: active area at x 6.24 to 48.96, y 2.30 to 25.01 of the 51.2 x 27.3 module; glass over the corner holes, threaded standoffs on the back, so the module needs a frame behind the plate). kicad-cli DRC: 0 | proposal; frame, header moves and the main board changes (R75, display connector, LED_R1 to R3 nets) follow. Followed by M-97, M-100, M-103 (review S-17, 2026-11-02) |
| M-97 | Shack interface schematic a17-display (gen_shack_sch.py, D-180, D-181): J8 to J10 and R208/R308/R408 removed with the radio-port LED pins; PCA9539 IO0_7, IO1_2, IO1_5 now DISP_BL, DISP_DC, DISP_RST; DevKit IO2 DISP_SCK, IO9 DISP_MOSI; J15 (1x8, 2.54 mm) for the Waveshare cable: 1 BL, 2 RST, 3 DC, 4 CS = GND, 5 CLK, 6 DIN, 7 GND, 8 +3V3; R75 2k2. Symbol Conn_01x08 added to _sym/ | kicad-cli ERC; netlist si16.xml against si15.xml; verify_system.py si16.xml ctl14.xml | ERC 0. Netlist difference exactly the intended one (parts -J8, -J9, -J10, -R208, -R308, -R408, +J15; R75 10k to 2k2; nets LED_R1..3 and PNL_LED gone, DISP_* new). verify_system: all checks pass (report unchanged) | done |
| M-98 | Shack interface layout p6 (netlist si16): wire headers J6, J2, J7 moved back to y 146.5 (behind the display, clear of its 11 mm depth); J15 upright right of the DevKit at x 124.2, y 120.5 (no room in the header row; the area behind KILL and RESET stays free); routed again: 155 of 155 nets, 429 vias; stitching CHASSIS 151, GND 544, RGND 137. kicad-cli DRC: 0 copper violations, 0 unconnected, 0 silk findings; left 18 starved thermals, 4 J14 hole clearances (A-26), 4 footprint mismatch warnings (trimmed connector silk) | done |
| M-99 | Front plate a3 (after p6): display window on the left (module at u 12 to 63, over the wire headers), USB-C centre, SAFE and LATCHED LEDs and RESET right of centre, KILL (EAO 84, key up) on the right over the free board area; title along the bottom. Clearances behind the plate (estimates from the datasheets, no 3D models of the EAO and C&K parts yet): KILL body over board x 128 to 159 with no part taller than about 3 mm under it; RESET body at board x 119 to 126, about 1 mm in y from J15; display and cable about 11 mm deep against the headers at 12 mm. kicad-cli DRC 0 on both plates | done; to check with the part 3D models before the order. Checked with the 3D models in M-100 and M-103 (review S-17, 2026-11-02) |
| M-100 | Front plate 3D fit (cadquery/OpenCascade in the cloud workspace, script Claude outputs/pcbwork/shack/case/fit_front.py): Hammond STEP, board STEP p6 (new export case/ref-shack-interface-p6.step; case/ref-shack-interface.step is still p5 with J8 to J10), front plate STEP, EAO 84-5340.0020 model (eao.com, 'example of use', demo panel removed; parts behind the panel moved to a 1.51 mm plate), C&K 8125SHZBE model (CADENAS via Farnell; flange on the plate inside face), Waveshare 1.9 inch module with an 8.5 x 14.7 x 4.2 mm cable plug envelope, LEDs as 5.2 mm x 12 mm cylinders. Positions from gen_endplates.py, housing frame as M-94. Depth behind the plate: KILL 13.8 mm to the tab ends (datasheet 9.5 mm is the body only; plug-in receptacles add more, free space behind), RESET 14.3 mm to the lug ends, display 7.6 mm, LEDs 12 mm (estimate). Minimum distances at a3: KILL to the extrusion side wall 0.3 mm (D-183); a4: KILL to the housing 1.37 mm, to the board 2.97 mm (the PCB under the holder; no part under it), to RESET 1.35 mm; RESET to the DevKit A1 2.74 mm (lugs point to A1: solder the wires with the lead going sideways); display, LEDs: no part within 5 mm. kicad-cli DRC 0 on both plates (a4) | done |
| M-101 | Display frame fit (cadquery, Claude outputs/pcbwork/shack/case/fit_frame.py): module at u 16, frame, M2 and M2.5 heads, four spacers, against the p6 board STEP and the Hammond STEP. Frame 67.2 x 27.5 x 2.7 mm, 3.35 cm3, 6.0 to 8.5 mm behind the plate (screw heads to 10.25 mm). Distances: frame to the housing 1.86 mm (left ear to the top fin), frame to the board parts 1.98 mm (J6), display to the housing 1.95 mm, spacers to the housing 2.76 mm; module to frame contact at the bosses only (ribs, by design). Front plate a5: DRC 0 on both plates; plate STEPs now exported with --user-origin 20x20mm (a5 first export without it was offset by 20 mm) | done |
| M-102 | Shack interface layout p7 (D-186; gen_shack_pcb.py p7, patch script Claude outputs/pcbwork/shack/p7patch.py, p6 copy gen_shack_pcb.p6.py): placement without courtyard clash (port template gaps all at least 0.25 mm); general router 155 of 155 nets in pass 2 (230 s), 425 vias, F 3889 mm, In2 2290 mm; USB_DP 158 mm (7 vias), USB_DN 159 mm (4 vias), both inside the channel x 58.4 to 61.3 over GND; stitching CHASSIS 153, GND 551, RGND 118. kicad-cli DRC: 0 copper violations, 0 unconnected; left 12 starved thermals, 4 J14 hole clearances (footprint, A-26), 4 footprint mismatch warnings (trimmed connector silk). Generator fix: zero-length router pieces at terminals are skipped. Silk: 13 references on the fab layer only; titles GND BOND, SENSE A, SENSE K not placed (reference only). 3D fit (cadquery, Claude outputs/pcbwork/shack/case/fit_rear.py; board STEP case/ref-shack-interface-p7.step): board tab and mini-DIN faces 0.3 mm from the rear plate, J3 0.39, J1 0.45, J14 face 0.29 mm behind the plate in its slot; board to the slot flanks 0.23 mm. Plates a7: DRC 0 | done; for review |
| M-103 | Front plate a8 and display frame D-187 (cadquery; scripts Claude outputs/pcbwork/shack/case/display-fit-2in/fit2.py, render2.py, notch.json): Hammond STEP, main board p7 STEP with the proposed notch cut, front plate a8 STEP, Waveshare 2inch STEP (hex pillars left out), PHR-8 plug and a cable bend envelope, frame from display-frame/gen_display_frame.py, spacers and M2.5 heads. Cell ring on the plate inside face (gap 0.000; 1.51 mm behind the outside face). Distances: frame to housing 1.91 mm (top left corner, frame corners R 3), frame to board parts 3.4 mm, module 5.78 mm to the housing and 4.14 mm to board parts, plug and cable envelope 1.72 mm to the DevKit socket row, spacer heads 1.65 mm to J6 and 2.76 mm to the housing, notched board edge 1.64 mm to the stack; KILL, RESET and LEDs more than 6 mm away. kicad-cli DRC with zone refill: 0 violations, 0 unconnected on both plates (the generator writes both plates, so the rear plate also shows rev a8) | done |
| M-104 | Shack interface layout p8 (D-187; gen_shack_pcb.py p8, p7 copy in Claude outputs/pcbwork/shack/p7-backup/): front edge with the display notch, x 4.0 to 71.0 to y 151.3 and x 71.0 to 80.0 to y 149.8 (board frame), corners R 0.5; router rule area over the notch plus 0.6 mm; CHASSIS ring along the notch 2.0 mm wide (3.0 mm gave two new starved thermals at J6 pad 4); plane and stitching vias and silk kept out of the notch; MCU zone frame follows the notch 1.0 mm inside the edge. Placement unchanged. General router 155 of 155 nets in pass 7 (837 s; passes 1 to 6 left one net each), 439 vias, F 3879 mm, In2 2329 mm; +3V3 and L1N narrowed at pads as on p7; stitching CHASSIS 138, GND 524, RGND 112. kicad-cli DRC with refill: 0 copper violations, 0 unconnected; left the same 12 starved thermals as p7, 4 J14 hole clearances (A-26), 4 footprint mismatch warnings. Board STEP case/ref-shack-interface-p8.step (export with --user-origin 20x20mm). 3D fit with the a8 stack (Claude outputs/pcbwork/shack/case/display-fit-2in/fit3.py): board edge 1.64 mm from the stack, other distances as M-103 | done; for review |
| M-105 | Shack interface layout p8b (Prins, 2026-10-29): the display notch runs to the left board edge; the 4 x 7.7 mm corner piece left of it is removed (the board stays in the left slot up to y 151.3; the right slot holds it to the front edge). No track or via was in that piece, so the p8 routes are kept. Stitching CHASSIS 136, GND 524, RGND 112. kicad-cli DRC with refill: 0 copper violations, 0 unconnected; the same 12 starved thermals as p7, 4 J14 hole clearances (A-26), 4 footprint mismatch warnings. Board STEP case/ref-shack-interface-p8.step exported again | done |
| M-106 | Full SolidCraft render of the shack interface (SolidCraft 0.22, solidcraft-cli; folder hardware/shack-interface/case/render-full/): design shack-interface-full.solidcraft (script render-full.json) with the Hammond housing without its own end panels, main board p8b STEP, front plate a8 and rear plate with silkscreen (kicad-cli --include-silkscreen; with --include-soldermask the ray tracer refuses the scene: soldermask faces are not opaque), EAO KILL, C&K RESET, panel LEDs, Waveshare 2inch module, frame D-187, PHR-8 plug, spacers and screws; parts that needed cleaning or colour are exported by world_parts.py (cadquery assemblies with names and colours). shack-interface-render.solidcraft: 501 board bodies inside the housing hidden (scripts render-views.json, render-studio.json), three render setups (front-hero, rear, front-straight), CPU ray tracer, budget studio (the default compact budget allows 262 144 triangles; the scene has 0.57 M visible), 16 primary samples, HDR-001 environment. The GPU path tracer needs Vulkan, which macOS does not have. Renders render-front-hero.png, render-rear.png, render-front-straight.png (about 8 to 15 minutes each on the M1); render-front-straight-ev.png is the same image lifted by +1.6 EV (expose.py) | done |
| M-107 | D-189 applied: RF board p3-keep (keep-outs at the case seats, relay NC pads as RF) | gen_rfboard_copper.py (SUP_KO rule areas, via_ok), gen_rfboard_pcb.py (netclass pattern, REV p3-keep), routing/export_geom.py (SUP_KO and boss keep-outs to routing/boss_keepout.json), grid_router.py (keep-outs per layer, via mask grown by the via radius, GND vias kept out, pad_clear_skip), stitch.py (GNDKO); router_cfg.json passes 10. Chain: gen --no-routes, export_geom, grid_router (numpy/scipy/numba/matplotlib venv, Python 3.12), stitch, gen, zone fill (pcbnew ZONE_FILLER), kicad-cli pcb drc --severity-all. Checks by script (KiCad Python): nearest other-net copper to each support and boss centre on F.Cu and B.Cu, smallest gap from every pad 12 to other-net copper per layer; routing/xtalk.py against the p3-silk board | Router: 168 of 168 nets in 5 passes (1220 s), 1118 vias. DRC 0 violations; 30 unconnected = pad 12 pairs (as M-76). Supports: nearest other copper 4.47 to 4.62 mm (was 3.40 to 3.50). GND bosses: nearest non-GND copper on B.Cu 5.51 mm (K106/K206/K306 coil pad A1; was 3.81 at J4). Pad 12: 2.00 mm on F/B, 0.50 mm inner (was 0.24 / 0.20). Signal vias without a GND via within 3 mm: 12, max 4.21 mm (D-166 accepted 12 at up to 4.1). xtalk: no parallel run on any victim, as before. Silkscreen: the same 15 references off the silk as p3-silk. Backup of p3-silk outside the repo | pass |
| M-108 | D-190 applied: schematics v12c-reuse (RF), c14c-reuse (controller), a18-reuse (shack); netlists rf15, ctl15, si17; layouts RF p3-keep (values only), controller c-s5 (values only), shack p8c | gen_*_sch.py; kicad-cli ERC; netlist compare against rf14, ctl14, si16 by script; verify_logic.py rf15 ctl15, verify_system.py si17 ctl15 (C71 check compares the value only); gen_rfboard_pcb.py and gen_controller_pcb.py on the new netlists, compare of placement, tracks and vias against the boards before; gen_bom.py (controller); shack: fixed fan-out of U4 and U9 as controller U13 (0.2 mm straps and stubs, two vias each, pad clearance 0.12 mm, router terminals), gen --no-routes, export_geom, grid_router, gen, zone fill; kicad-cli pcb drc --severity-all | ERC 0 on all three. Netlists: only the listed values and the U4/U9 footprint differ, connectivity identical. verify_logic 51 pass plus the stale D-132 support check (review S-16); verify_system 52 pass. RF and controller: placement, tracks and vias unchanged, DRC 0 (RF 30 unconnected = pad 12 pairs). Controller BOM: C12 line text only. Shack: router 155 of 155 nets in 2 passes, 427 vias; DRC as p8b (4 J14 peg hole clearances, A-26; 4 footprint library mismatches) plus one starved thermal: an F.Cu RGND island at JP306 pin 3, joined through the PTH pin only (13 against 12) | pass |
| M-109 | D-191 applied: controller schematic c15-fault-io6, netlist ctl16, layout c-s6 | gen_controller_sch.py; kicad-cli ERC; netlist compare against ctl15 by script; verify_logic.py rf15 ctl16 (FAULT check extended with R66, new check FAULT_IO6 = R66 pin 2 and A1 pin 11), verify_system.py si17 ctl16; gen_controller_pcb.py c-s6 --no-routes, export_geom.py, grid_router.py, gen_controller_pcb.py, kicad-cli pcb drc --severity-all --schematic-parity with zone refill; gen_bom.py. The generator now splits a track where a same-net track ends on its middle (router T joint), else KiCad reports a dangling end | ERC 0. Netlist: only R66 new, FAULT gains R66 pin 1, new net FAULT_IO6 (R66, A1 pin 11). verify_logic: all pass except the stale D-132 support check (review S-16); verify_system 52 pass. Router: 60 of 60 nets in 2 passes, 114 vias (was 104), L1 1154 mm, L3 1235 mm; 35 T joints split. DRC: 0 violations, 0 unconnected; parity only the cosmetic field and `{slash}` net-name notes as before. BOM: R66 joins the R61 1k line (no new line). Production zip not regenerated yet (S-9, after S-2) | pass |
| M-110 | D-192 applied: controller schematic c16-sda-bridged, netlist ctl17, layout c-s7; shack schematic a19-sda-bridged, netlist si18, layout p8d | gen_controller_sch.py, gen_shack_sch.py (symbol SolderJumper_3_Bridged12, footprint Bridged12, pads 1 and 3 swapped); kicad-cli ERC; netlist compare against ctl16 and si17; verify_logic.py rf15 ctl17 and verify_system.py si18 ctl17, each with a new JP11 / JP61 check (fails on ctl16 and si17 as it should); controller: gen --no-routes, export_geom, grid_router, gen, DRC with refill, gen_bom.py; shack: the same chain; silk check of the hidden references against p8c | ERC 0 on both. Netlists: only the JP11 and JP61 footprint and the pad 1 / pad 3 nets differ. verify_logic: all pass except the stale D-132 support check (S-16); verify_system all pass. Controller: router 60 of 60 nets in 1 pass, 112 vias; DRC 0 violations, 0 unconnected (silk text shortened to 1-2 IO10, 2-3 IO7 to clear the edge); BOM JP11 line text. Shack: router 155 of 155 nets in 1 pass, 439 vias (was 427), F 3838 mm, In2 2322 mm; DRC 4 J14 peg hole clearances (A-26), 11 starved thermals (was 13), 4 footprint library mismatches, 0 unconnected; 48 hidden references as p8c. Production zip not regenerated yet (S-9) | pass |
| M-111 | D-193 applied: RF layout p3-drain (netlist rf15 unchanged) | gen_rfboard_pcb.py (BIAS_CELLS), gen_rfboard_copper.py (thermal vias with via_ok, drain zones), routing/stitch.py and router_cfg.json (stitch_no_grid); gen --no-routes, export_geom, grid_router, stitch, gen, zone fill, kicad-cli pcb drc --severity-all --refill-zones; filled area per drain zone by script (KiCad Python); routing/xtalk.py | Router: 168 of 168 nets in 5 passes (1256 s), 1124 vias (was 1118). Return vias: 12 signal vias without a GND via within 3 mm, max 4.21 mm (as M-107). DRC 0 violations; 30 unconnected = pad 12 pairs (as M-76). Drain copper per FET: F.Cu 94.6 to 98.9 mm2, B.Cu 318.6 to 321.9 mm2, total 415 to 418 mm2; 9 thermal vias each. xtalk: no parallel run on any victim | pass |
| M-112 | D-194 applied: shack layout p8e (netlist si18 unchanged) | gen_shack_pcb.py (XL, XR for the outline, the via and silk edge checks); gen --no-routes, export_geom, grid_router, gen, kicad-cli pcb drc --severity-all --schematic-parity --refill-zones; Edge.Cuts bounding box; DRC and hidden references against p8d by script | Outline 159.6 x 161.0 mm (Edge.Cuts box 159.7 with the 0.1 mm line). Router: 155 of 155 nets in 4 passes, 429 vias (was 439). DRC: 4 J14 peg hole clearances (A-26), 12 starved thermals (was 11: R418 pad 2 now has one spoke, as the other 11 sense-divider pads without a plane via), 4 footprint library mismatches, 0 unconnected, no edge clearance item; parity as before. Silkscreen: 49 hidden references (was 48): JP406 (SENSE K, port 4, next to the right edge) lost its place; its CONT/VOLT names and the table on the back stay | pass |
| M-113 | Controller production files for c-s7 (review S-9) | Fabrication Toolkit 10.0 plugin from the command line (KiCad Python -m com_github_bennymeg_JLC-Plugin-for-KiCad.cli -p controller-board.kicad_pcb -e -nI -nB, from ~/Documents/KiCad/10.0/3rdparty/plugins); zip read back by script: Gerber file functions, drill hits per tool against the board pads and vias; ORDER sheet updated | Zip Shack_Relay_Matrix_rev_C_controller_board_c-s7.zip: L1 Top, L2 and L3 Inner, L4 Bottom, mask, silk and paste both sides, profile, PTH and NPTH drill. Drill per tool equal to the board: PTH 0.3 x 277, 0.8 x 28 (U1 to U4), 1.0 x 60 (J1, A1, J2), 1.2 x 12, 3.2 x 1; NPTH 3.2 x 3, 3.25 x 2; outline 152.0 x 122.5 mm. designators.csv and positions.csv now list R66. ORDER sheet: c-s7 / c16 / ctl17, and the 0.8 and 1.0 mm hole labels corrected (they were swapped). The c-s5 zip removed (copy in backups/). Date code still DC 2643: set at the order (D-153) | pass |
| M-114 | D-180 strap check (review S-12): do the display inputs pull IO2 (SCK) or IO9 (MOSI) at reset | Waveshare 2inch_LCD_Module_SchDoc.pdf and ST7789VW.pdf (hardware/shack-interface/endplates/display-candidates/2inch/) read | SCK and DIN go straight from the PH2.0 header to the LCD flex: no pull-up, pull-down or other part. Only BL has a circuit (NPN, 1k, 10k), and BL is on the PCA9539. ST7789VW IIH/IIL max 1 uA: about 45 mV drop against the C3 internal pull-up (about 45 k). The straps read high at reset; no board change. shack-interface-rev-a.md pin map updated. Open: boot with the display connected on the prototype | pass |
| M-115 | MPN for BSS138BK (review S-4): the ROHM BSS138BKT116 has the same name and another pin order | gen_rfboard_sch.py (v12d-mpn) and gen_shack_sch.py (a20-mpn): MPN BSS138BK to BSS138BK,215; schematics regenerated; Nexperia datasheet pinning table (1 G, 2 S, 3 D) against the Q_NMOS_GSD footprint; kicad-cli sch erc --severity-all; kicad-cli sch export bom grouped by MPN | Nexperia BSS138BK,215: pin 1 G, 2 S, 3 D, equal to the footprint. BOM: RF 42 parts (Q2, Q101 to Q111, Q201 to Q211, Q301 to Q311, Q401, Q501, Q601, Q701, Q1013 to Q1043), shack 3 (Q13, Q23, Q33), all BSS138BK,215. Schematic diff: the MPN field only (20 symbols in the sheet files). ERC: 0 items on both. Netlist and boards unchanged (no MPN on the boards). Controller already Nexperia through gen_bom.py (D-134). Second source Diotec MMFTN138K stays in the part description | pass |
| M-116 | RF J14 header named (review S-5): mate for the ESQ-112-33-G-D socket (D-139) | Samtec TSW/HTSW catalogue F-226 (Nov 2025, filed as Datasheets/TSW_Samtec_DS_F-226_2025-11-07.pdf): lead style table, plating codes, board mates; ESQ plating codes (F-226 ESW/ESQ); gen_rfboard_sch.py v12e-j14, MPN and description on J14; kicad-cli sch erc; BOM export | TSW-112-07-L-D: lead style -07 = overall 10.92, tail 2.54, post 5.84 mm above the 2.54 mm body; -L = 10 uin gold on the post, matte tin tail (the current catalogue has no -G; ESQ -G is 20 uin gold). ESQ is a listed TSW board mate. Engagement at the 19.7 mm board gap: 5.84 - 0.95 = 4.89 mm (M-53 used a 6.0 mm post: 5.05 mm); inside 3.68 to 6.35 mm for a board gap of 18.2 to 20.9 mm. Tail 2.54 mm: 0.94 mm through the 1.6 mm board. Samtec hole 1.02 +- 0.03 mm; footprint drill 1.0. ERC 0; BOM J14 = TSW-112-07-L-D. Boards unchanged. No second source named (other makers do not state the post length to the ESQ) | pass |
| M-117 | Order codes (review S-6) | gen_rfboard_sch.py v12f-order, gen_shack_sch.py a21-order: MPN fields only (values unchanged, so netlists and boards stay); TI LM2901 datasheet rev Z package option addendum; kicad-cli sch erc on both; BOM export grouped by MPN | RF U801 LM2901DR (TI, SOIC-14 D, active, -40 to 125 C). Shack: J2, J7 B2B-XH-A(LF)(SN), J6 B4B-XH-A(LF)(SN) (JST XH); C211 to C218, C311 to C318, C411 to C418 (21 x 1 nF 0603 C0G) Murata GRM1885C1H102JA01D, 50 V. Already in place before this pass: U205/U305/U405 PC817X2NSZ9F; RF C801 and C1011 to C1041 100n 50V X7R (P-2, D-190); shack C1 47u 35V with 105 C long-life in the description (MPN with the housing height at B-3). ERC 0 on both | pass |
| M-118 | Lifecycle and stock (review S-10) | Vishay IRFL9014 Rev G ordering information; MAX823 datasheet filed (Datasheets/MAX823_ADI_DS_Rev5_2005-12.pdf); RESET_N loads from si18.xml and ctl17.xml; gen_rfboard_sch.py v12g-be3, gen_shack_sch.py a22-max823, gen_controller_sch.py c17-max823, gen_bom.py; kicad-cli sch erc on the three boards | RF Q1012 to Q1042 IRFL9014TRPBF-BE3 (Vishay: Pb-free and halogen-free, alternate manufacturing location; the plain TRPBF is listed obsolete at DigiKey). Supervisors: MAX823SEUK+T first (D-195) on U12, U3, U6; controller hand-assembly BOM swapped (first ADI, second TI / Diodes); production zip c-s7 unchanged (values and board unchanged). TLP176AM: Mouser 34k in stock (Prins, 2026-11-01), no longer long-lead. Second sources already named: TLP176AM AQY212G3HS, SN74LVC1G74DCUR Nexperia 74LVC1G74DC,125, IRFL9014 onsemi NTF2955. Open: SO-239 83-798 stays single source (16 weeks at the last check); order it first, and measure A-05 on the first parts. ERC 0 on all three | pass |
| M-119 | SO-239 first source 83-1R (D-196) | 83-1R drawing rev AM (filed as Datasheets/83-1R_AmphenolRF_DS_RevAM_2015-03-27.pdf) against 83-798 rev AG; gen_rfboard_sch.py v12h-83-1r; kicad-cli sch erc; BOM export | Flange, hole pattern, thread and front length match (table in D-196). BOM: J1 to J3, J7 to J10 MPN 83-1R; description names 83-798 as second source and the solder note. Value '83-798 SO-239' stays (on the board fab layer only; a change would change the netlist). ERC 0. Boards unchanged | pass |
| M-120 | Clamp zener pulse (D-43, review Decide item) | Nexperia BZT52H series Rev 3 (2010-12-07; filed as Datasheets/BZT52H_NXP_DS_Rev3_2010-12-07.pdf): PZSM 40 W at 100 us, Fig 1 PZSM against pulse width, IZSM 1.25 A (C24); Diotec BZT52C series 2026-09-02 (filed); SLKOR BZT52B series (Prins's download); coil decay calculation; gen_rfboard_sch.py v12i-zener; kicad-cli sch erc; BOM export | Worst case: RLY_EN drops with 13 coils on (C-13), all into CLAMP_SW. Coil 360 ohm, 35 mA at 12.6 V; inductance not stated by TE, 1 H assumed. Loop: L di/dt = -(i R + VZ + VF), current zero after about 1.15 ms; zener energy about 0.44 mJ per coil, 5.8 mJ for 13; peak 0.46 A x 25 V = 11.5 W; equal to about 0.5 ms at full power. Fig 1 at 0.5 ms: about 16 W (Tj 25 C before the surge), about 13 W (Tj 150 C before). One zener alone passes (margin 1.1 to 1.4); two in parallel share the current. At 2 H the pulse is twice as long (about 1 ms: limit 9 to 11 W), so one zener alone would be at the limit, two in parallel still pass. Drain peak with VZ max 25.6 V: 39.1 V plus the zener slope resistance, against 42 V. Diotec BZT52C24 (SOD-123F, 500 mW) states no surge rating: second source only. SLKOR makes 5.1 to 20 V only: no 24 V part. BZT52H-C24 is SOD-123F on the SOD-123 land (hand soldering). ERC 0. Open: measure the RT1 coil inductance and scope the drain at an RLY_EN drop with 13 coils on (bench) | pass |
| M-121 | Shack F1 short-circuit check (A-13/D-45, review Decide PSU) | Bourns SF-1206S050-2 datasheet: 500 mA slow 1206, 63 V DC, breaking 50 A, cold resistance min 0.447 ohm | A dead short at 14.4 V through the fuse alone draws at most 14.4 / 0.447 = 32 A, below the 50 A breaking rating, on any 13.8 V supply (D-199 HDR units limit far lower) | pass |
| M-122 | Order BOMs RF board and shack interface (review B-3) | hardware/unit/rf-board/gen_bom.py (rf16: 43 lines, 296 parts) and hardware/shack-interface/gen_bom.py (si18: 66 lines, 257 parts), as the controller gen_bom.py; output production/bom_hand_assembly.csv each. Stock and second-source sweep on DigiKey, 2026-11-01 (D-121, review items 8 to 10) | Every fitted part has an order line with first and second source or a jellybean spec. First source moved for stock: PMV50EPEAR (0 to 2027) and AO3407A (NRND) to Diodes DMP3056L-7 (pin-out to check on the datasheet); BAS70-04 to ST BAS70-04FILM; 901-9215 (0) to Cinch 142-0701-631; TLP4176G (0) to Panasonic AQY412S; PESD15VL1BA to Littelfuse SD15C-01FTG; BZX384 to Vishay; BCP53-16 to onsemi. RN901 to RN1002: CAY16-103J4LF (CAT16 is concave; MPN fixed in the schematic). New: C6/C7 EEH-ZC1V470P 35 V (D-200), R401 to R701 VR25 1M (D-32), C404 to C704 (D-202), shack C1 Wurth 860080573003, C205 Yageo 1 kV, F1 SF-1206S050-2, D6 BZT52C15-7-F, headers and shunts. Single source: XT60PW-M/XT30PW-M (LCSC or TME, not at DigiKey), RT1, TSW J14, JST XH, 1206J1K04P70CCT. Open checks: Kycon KMDGX-8S-BS land against MD-80SM, AQY412S land against the long-pad footprint | pass, with the open checks |
| M-123 | Order-readiness pass RF board and shack interface (review B-4), as M-67 | kicad-cli pcb drc --severity-all --refill-zones on both boards; RF rev p3-drain to p3-c1206 (title block, art block text and netlist comment rf16 changed in place on the board; REV in gen_rfboard_pcb.py); Fabrication Toolkit cli (-e -nI -nB) on both boards, output production/; Gerber and drill read back by script (file functions, outline, holes per tool against the board); order sheets production/ORDER-rf-board.md and production/ORDER-shack-interface.md | RF: DRC 0 violations, 30 unconnected (relay pad-12 pairs, known); 6 copper layers, outline 268.0 x 230.0 mm; PTH per tool matches the board (0.3 x 4196, 0.6 x 30 + 4 slots, 0.8 x 20, 1.0 x 34, 1.3 x 296, 1.9 x 2, 2.7 x 4, 3.2 x 17), no NPTH. Shack p8e: DRC 0 copper violations, 0 unconnected, known 12 starved thermals, 4 J14 hole clearances (A-26), 4 footprint mismatch warnings; 4 copper layers, outline 159.6 x 161.0 mm; PTH and NPTH per tool match the board (15 slots), two 0.2 mm via holes (USB, M-89). Finding: gen_rfboard_pcb.py no longer reproduces the board. A full run ends the four ANT tap tracks on the C404 to C704 pad 1 centre (harmless) but places A1_BIAS drain vias differently, with 2 dangling vias and a hole-to-hole error (DRC 3). The board stays as committed; do not run the generator on it before that is fixed. Open: JLC DFM upload of both zips (also A-26) and Prins's sign-off of the RF routing | pass, DFM and sign-off open |
| M-124 | Records: verify_logic.py to D-162 (review S-16) and log statuses (review S-17) | Support check changed from D-132 (S1 to S6 on CHASSIS with H1) to D-162: each Sn on its own net CHASSIS_Sn with only its DNP bond Cn to GND, H1 on CHASSIS. python3 verify_logic.py rf16.xml ctl17.xml and python3 verify_system.py si18.xml ctl17.xml, both reports filed again. S-17: 50 rows from the review list (34 groups) get a closing note with the entry that closed them; text and history kept; A-23, A-24, A-30 and M-64 were already closed | verify_logic 54 pass, 0 fail (new rows since the last filing: JP11 SDA, R66 FAULT read-back, the D-162 support check); verify_system all pass (new row: JP61 SDA) | pass |
| M-125 | RF board p3-so239 (D-203) | Surgical patch of the committed board (the generator does not reproduce it, M-123): Claude outputs/pcbwork/rf-so239-move/patch.py (KiCad 10 Python), board p3-c1206 kept there; kicad-cli pcb drc --severity-all --refill-zones; kicad-cli pcb export step --user-origin 20x20mm to hardware/unit/case/ref-rf-board.step | J1 and J2 moved with their silk labels; R1 F.Cu stub and jog start, R2 L6 stub, its two transition vias and the L1 jog start moved (22 points); GND vias: 19 moved with the copper, 18 removed by the via rules of gen_rfboard_copper.py and stitch.py, 9 fence, 7 grid and 4 edge-fence vias added; RF vias keep a GND via at 2.95 to 3.4 mm, as before. DRC 0 violations, 30 unconnected (relay pad-12 pairs, known). R1 and R2 jogs now run 34.3 mm in parallel at 7 mm (was 37.3 mm), so the coupling does not rise. gen_rfboard_pcb.py: J positions and REV p3-so239; routing/boss_keepout.json: seats at x 32 and 59. The production zip p3-c1206 is out of date: generate it again at the order (D-153) | pass |
| M-126 | Case CAD D-203 | Claude outputs/pcbwork/rf-so239-move/edit_case.py (document.json of rf-case.solidcraft and rf-case-work.solidcraft: 5 + 5 holes, 2 bosses, 2 boss taps, 6 lug and lid-screw sketch points, 1 thread, 12 occurrences); solidcraft-cli run (rebuild, file.export, model.threads, file.save with cache; Emboss1 on for the lid export only); cadquery/OpenCascade checks; gen_case_drawing.py rev C | Both designs rebuild without a failing feature (the full one in 17 min, of which 15 for the lid engraving). Tray STEP valid, 0 bad faces; 14 point checks pass (bores, flange holes, bosses, taps, lug). Bottom-left pocket corner: no hole or bore reaches the radius (fill-and-recut test, 0 mm3). Bottom-right: the A4 right flange holes exit where the radius starts (0.066 mm3 each, radius 0.09 mm high across the hole): through holes, as the others. First try with the lug at x 68.5 gave an invalid wall face (lug edge 0.03 mm from both flange holes); x 68 is clean. A4 depth = wall failed in the CAD (end face on the inner face, no boolean result) and was dropped. Fit against ref-rf-board.step p3-so239 (711 solids, 11 near the walls): no overlap; RJ45 0.55 mm and controller board 0.675 mm from the tray, as before. Drawing RF-CASE-01 rev C: 79 of 79 tapped holes match the thread data. Fit-print STLs made again; the bottom corners are rebuilt as true R10 cylinders (the STEP corner faces are splines and meshed into flats) | pass |
| M-127 | Case CAD D-204 | Claude outputs/pcbwork/case-dfm: dfm.py (morphological opening per z band with the keep-outs, shapely), emit_fill.py + fitter.py (fill sketches as lines and three-point arcs, 0.005 mm), cad/edit_dfm.py (document.json: SMA bosses, pad_h, m5_depth, EXP M3), solidcraft-cli run cad/dfm_work_A.json (fill features inserted after 'GND boss A4' with timeline.roll_to, depth edits, model.threads); verify_tray.py (OpenCascade slices) | Fill = box 1 mm into the walls minus the final air shrunk by EPS (0.02 / 0.06 / 0.025 / 0.06 mm per band), so no fill face lies on an existing face. Failed tries: fill grown 0.1 mm into the old material (union failed on near-coincident arcs), equal EPS per band (shared side edges), extrude profiles 'all' (pocket filled), EPS 0.02 at z 16-18 (SO-239 A1 bore cut failed), SMA bore 4 deep (0.06 mm membrane), lower SMA M2 and R3 M3 3 broke out through fill faces (invalid faces). Final tray STEP valid (OpenCascade), 1 solid, 758 cm3 (was 736). Slices at z 6 to 62.5: no concave corner below R6.45 in the open pocket (only drilled holes, horizontal bores and cutouts at the walls); keep-outs: 0.02 to 0.06 mm fill skin on the inner wall at the SMA strap zones and 0.02 mm at the S1 and S2 supports (0.01 mm2); 22 point probes pass. Drawing RF-CASE-01 rev D: 79 of 79 tapped holes match the thread data. Fit-print STLs made again (bottom-right corner above z 18 rebuilt as a cylinder) | pass |
| M-128 | Case CAD D-204b (Prins, 2026-11-08: slit between the BL pad fill and B1 not wanted; floor edges) | dfm.py now bridges material pieces closer than 3 mm with a 2 mm web as an obstacle and opens again (one web: BL pad to B1, the slit was 1.06 mm); both SolidCraft designs rebuilt with the same fill and edits | Both rebuild without a failing feature. Tray STEP valid, 0 bad faces, 758.6 cm3; slices and 23 probes as M-127, pad web closed. Drawing rev D: 79 of 79 tapped holes; note 6 now allows R <= 1 on the floor edges (corner-radius cutter), sharp as modelled. Fit-print STLs made again | pass |
| M-129 | Fit-print STLs, lid artefacts (Prins, 2026-11-08: seen in the STL, not in SolidCraft) | hardware/unit/case/fit-print/split_rf_case.py rev 2 | Cause: the engraved lid STEP has edge tolerances up to 4 mm on the letters; OpenCascade leaves 186 to 938 open edges there and pymeshfix moved letters by up to 0.5 mm (and on the tray replaced a patch of the x 68 lug fillet, up to 0.9 mm). SolidCraft's own STL export is coarser (0.76 mm) and also not closed. Fix: no mesh repair. Tray meshed once at the finest closed setting (chord 0.02 mm); the plain lid (rf-case-lid-plain.step) meshed closed at 0.01 mm and the engraving cut as 0.5 mm prisms of the 'Lid text' sketch outline (lid-text-sketch.json); booleans on meshes (manifold). Check: engraving at z 65.75 matches the sketch outline (0.006 mm2 difference over 1232 mm2); tray parts within 0.05 mm of the STEP except the x 68 lug fillet (spline, up to 0.17 mm) | pass |
| M-130 | RF production files p3-case (D-203, D-204; Prins, 2026-11-09) | kicad-cli pcb drc --severity-all --refill-zones; Fabrication Toolkit cli (-e -nI -nB), output hardware/unit/rf-board/production/; Gerber and drill read back by script against the board (pcbnew hole count per tool); p3-c1206 zip removed from production/ (copy in production/backups); ORDER-rf-board.md updated | DRC 0 violations, 30 unconnected (relay pad-12 pairs, known). 6 copper layers (L1 Top, L2 to L5 Inner, L6 Bottom), outline 268.0 x 230.0 mm. PTH per tool matches the board: 0.3 x 4175 (was 4196, M-125 and D-204 via changes), 0.6 x 30 + 4 slots, 0.8 x 20, 1.0 x 34, 1.3 x 296, 1.9 x 2, 2.7 x 4, 3.2 x 17; no NPTH. Date code still DC 2643: set it at the order (ORDER-rf-board.md). Open: JLC DFM upload and Prins's sign-off of the RF routing (B-4) | pass |
| M-131 | XT polarity check (S-13; Prins, 2026-11-09: XT60PW-M and XT30PW-M in hand, + on the flat side) | kicad-cli pcb render --side back of the RF board (view mirrored: J13 XT30 at max x shows at the left), XT faces against pad nets read with pcbnew; footprint silk read on both boards | RF J11, J12 (XT60): angled end at pad 1 GND, flat end at pad 2 (+12V_RLY_IN, +12V_AUX_IN). RF J13 (XT30): angled end at pad 1 GND, flat end at pad 2 +5V_IN. Shack J3 (XT60, same footprint, rotation 0): pad 1 GND, pad 2 VIN_P. Silk '+' beside pad 2 and '-' beside pad 1 on all four. The A-07 note (angled end on pad 2) was wrong. No change needed. Also: RT1 in hand, looks right, test on the board; display received, check open (D-187, D-180) | pass |

## 7. Sources and documents

Paths are relative to the master folder (the local repository). The claude.ai Project docs (claude/...) are a mirror.

- Requirements and architecture: docs/requirements.md, docs/architecture.md (rev C), docs/design/ (one document per board), docs/test/test-spec.md.
- Archive: archive/README.md lists every archived item and what replaced it (architecture v0.1: archive/architecture-v0.1-2026-09-09.md; rev A card documents and site plan rev B: archive/block-diagram-rev-a-2026-09/; rev A/B card cage and backplane: archive/rev-b-backplane-2026-09/).
- Datasheets and register: Datasheets/_register.md. The PDFs stay in Datasheets/ and are not in the repository.
- Schematics (each generator runs from its own folder):
  - RF board: hardware/unit/rf-board/ (rf-board.kicad_pro, gen_rfboard_sch.py, _sym/, rf-board.pretty/, rf-board.pdf).
  - Controller board: hardware/unit/controller-board/ (controller-board.kicad_pro, gen_controller_sch.py, _sym/, lib/controller-board.pretty/, controller-board.pdf).
  - Shack interface: hardware/shack-interface/ (shack-interface.kicad_pro, gen_shack_sch.py, _sym/, lib/shack-interface.pretty/, shack-interface-rev-a.md).
- Footprint generators: hardware/shack-interface/lib/ (gen_photorelay_fp.py, gen_minidin_fp.py, gen_devkit_fp.py). The footprints are used in lib/shack-interface.pretty/ and, unchanged, in hardware/unit/controller-board/lib/controller-board.pretty/. RF board: hardware/unit/rf-board/gen_so239_fp.py writes the SO-239 strap footprints into rf-board.pretty/ (D-105).
- Drawings: hardware/unit/relay-placement-study.svg, hardware/unit/unit-case-sketch.svg (generators gen_relay_placement.py, gen_case_sketch.py in the same folder).
- Diagrams: hardware/docs/diagrams/ (gen_diagrams.py, SVG and PNG).
- Verification: hardware/unit/verify/ (verify_logic.py, verify_system.py, nl.py; netlists rf12.xml, ctl11.xml, si14.xml; reports logic-verification.md, system-verification.md). Run from that folder: `python3 verify_logic.py rf10.xml ctl7.xml` and `python3 verify_system.py si13.xml ctl7.xml`.
- 3D models and vendor libraries: not in the repository; sources and paths in hardware/THIRD-PARTY.md (for example hardware/unit/unit.3dshapes/: XT60PW-M, XT30PW-M, 83-1R placeholder; lib/3d/: photorelay and mini-DIN models).
- JLC calculator screenshots: chat 2026-09-27 (gap 1.25 mm and 2.0 mm), not filed.
- Hardware skill: design log rule and JLC0216A stackup added 2026-09-27 (proposal v11). Hans Rosenberg grounding and return-path rules added 2026-10-19; basis for D-115.
