PE1RGU/hf-antenna-switch/hardware/unit/case/_so239_fix.png

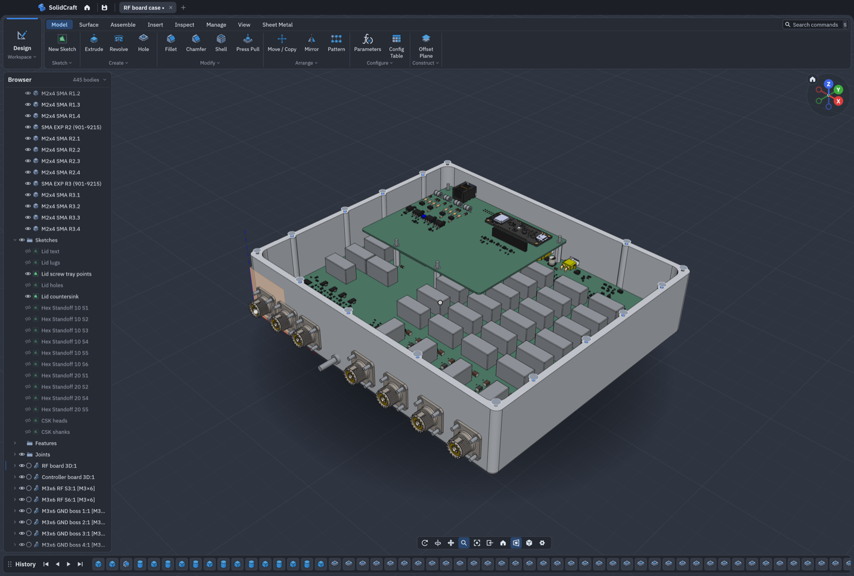
hardware/unit/case/_so239_fix.png
