PE1RGU/hf-antenna-switch/(list of files, drawings)

Other design files:
hardware/unit/controller-board/routing/controller-board.dsn
hardware/unit/controller-board/routing/stage-a.dsn
hardware/unit/controller-board/routing/stage-b.dsn
