PE1RGU/hf-antenna-switch/hardware/unit/rf-board/rf-board.kicad_pcb

## KiCad design hardware/unit/rf-board/rf-board.kicad_pcb (2026-11-02)

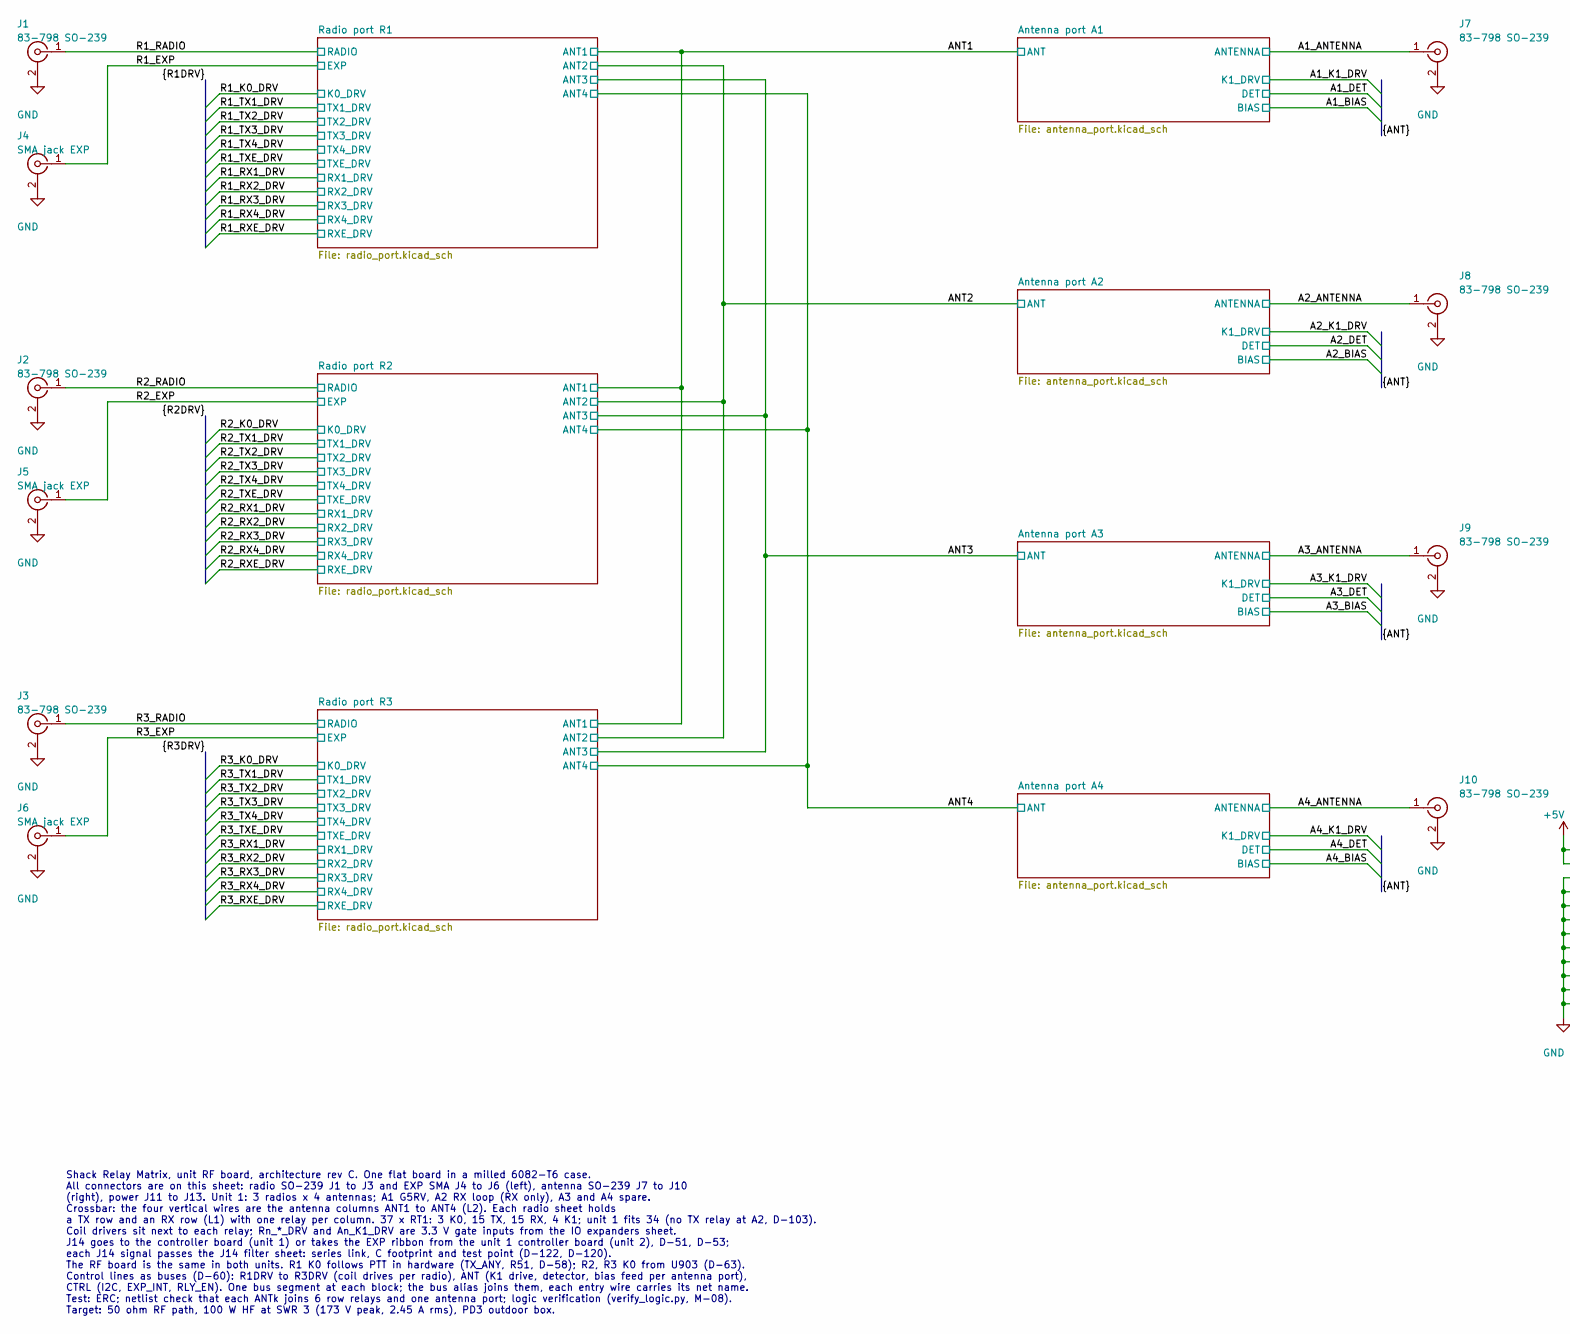
[picture p96: schematic rf-board.kicad_sch, Unit RF board: overview, connectors and crossbar, part in row 1, column 1]

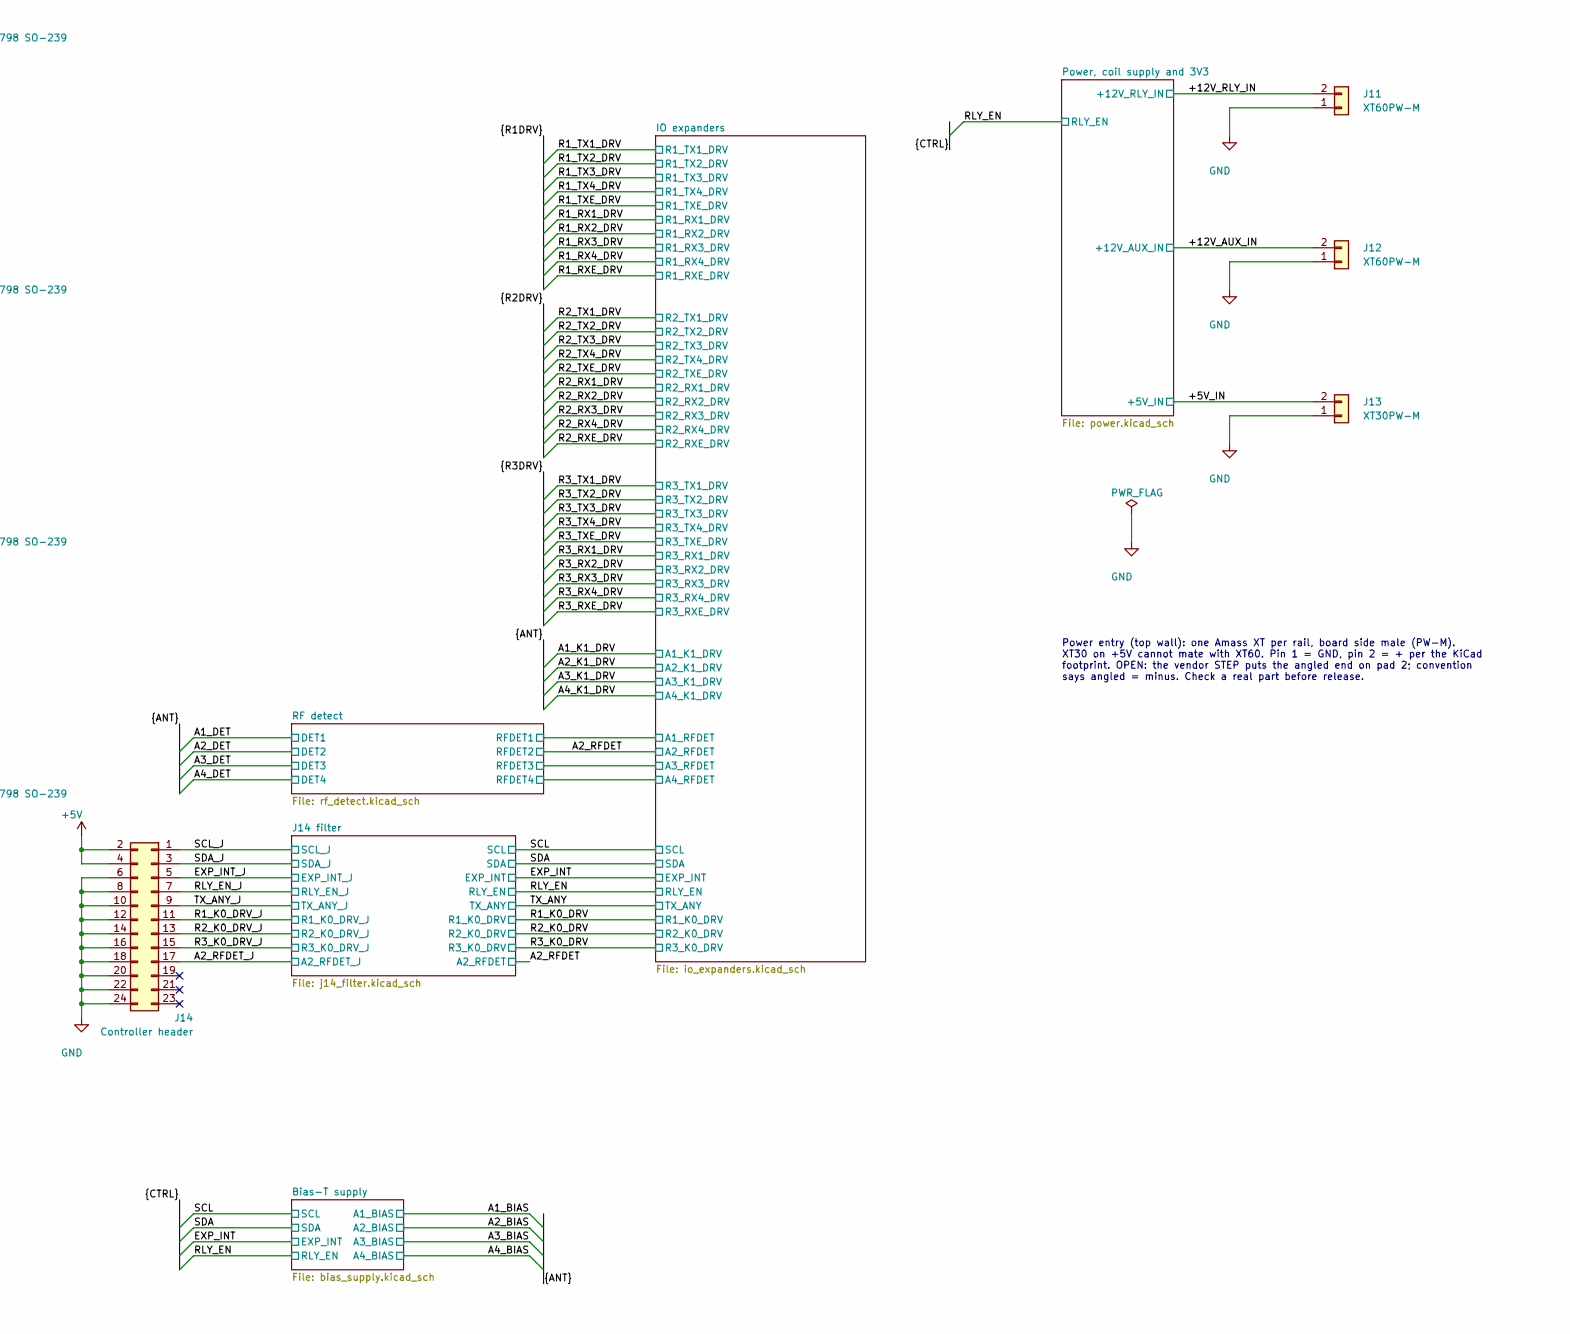
[picture p97: schematic rf-board.kicad_sch, Unit RF board: overview, connectors and crossbar, part in row 1, column 2]

Parts:
J1, J2, J3, J7, J8, J9: 83-798 SO-239; SO239_83-798_StrapPad_BossRight; MPN 83-1R
J4, J5, J6: SMA jack EXP; SMA_901-9215_StrapPad; MPN 901-9215
J10: 83-798 SO-239; SO239_83-798_StrapPad_BossLeft; MPN 83-1R
J11, J12: XT60PW-M; AMASS_XT60PW-M_1x02_P7.20mm_Horizontal; MPN XT60PW-M
J13: XT30PW-M; AMASS_XT30PW-M_1x02_P2.50mm_Horizontal; MPN XT30PW-M
J14: Controller header; PinHeader_2x12_P2.54mm_Vertical; MPN TSW-112-07-L-D

Connections:
+5V: J14.2, J14.4; also elsewhere on the board
/+5V_IN: J13.2; also elsewhere on the board
/+12V_AUX_IN: J12.2; also elsewhere on the board
/+12V_RLY_IN: J11.2; also elsewhere on the board
/A1_ANTENNA: J7.1 (In); also elsewhere on the board
/A2_ANTENNA: J8.1 (In); also elsewhere on the board
/A2_RFDET_J: J14.17; also elsewhere on the board
/A3_ANTENNA: J9.1 (In); also elsewhere on the board
/A4_ANTENNA: J10.1 (In); also elsewhere on the board
/EXP_INT_J: J14.5; also elsewhere on the board
/R1_EXP: J4.1 (In); also elsewhere on the board
/R1_K0_DRV_J: J14.11; also elsewhere on the board
/R1_RADIO: J1.1 (In); also elsewhere on the board
/R2_EXP: J5.1 (In); also elsewhere on the board
/R2_K0_DRV_J: J14.13; also elsewhere on the board
/R2_RADIO: J2.1 (In); also elsewhere on the board
/R3_EXP: J6.1 (In); also elsewhere on the board
/R3_K0_DRV_J: J14.15; also elsewhere on the board
/R3_RADIO: J3.1 (In); also elsewhere on the board
/RLY_EN_J: J14.7; also elsewhere on the board
/SCL_J: J14.1; also elsewhere on the board
/SDA_J: J14.3; also elsewhere on the board
/TX_ANY_J: J14.9; also elsewhere on the board
GND: J1.2 (Ext), J2.2 (Ext), J3.2 (Ext), J4.2 (Ext), J5.2 (Ext), J6.2 (Ext), J7.2 (Ext), J8.2 (Ext), J9.2 (Ext), J10.2 (Ext), J11.1, J12.1, J13.1, J14.6, J14.8, J14.10, J14.12, J14.14, J14.16, J14.18, J14.20, J14.22, J14.24; also elsewhere on the board

Notes on the sheet:
Power entry (top wall): one Amass XT per rail, board side male (PW-M). XT30 on +5V cannot mate with XT60. Pin 1 = GND, pin 2 = + per the KiCad footprint. OPEN: the vendor STEP puts the angled end on pad 2; convention says angled = minus. Check a real part before release.
Shack Relay Matrix, unit RF board, architecture rev C. One flat board in a milled 6082-T6 case. All connectors are on this sheet: radio SO-239 J1 to J3 and EXP SMA J4 to J6 (left), antenna SO-239 J7 to J10 (right), power J11 to J13. Unit 1: 3 radios x 4 antennas; A1 G5RV, A2 RX loop (RX only), A3 a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

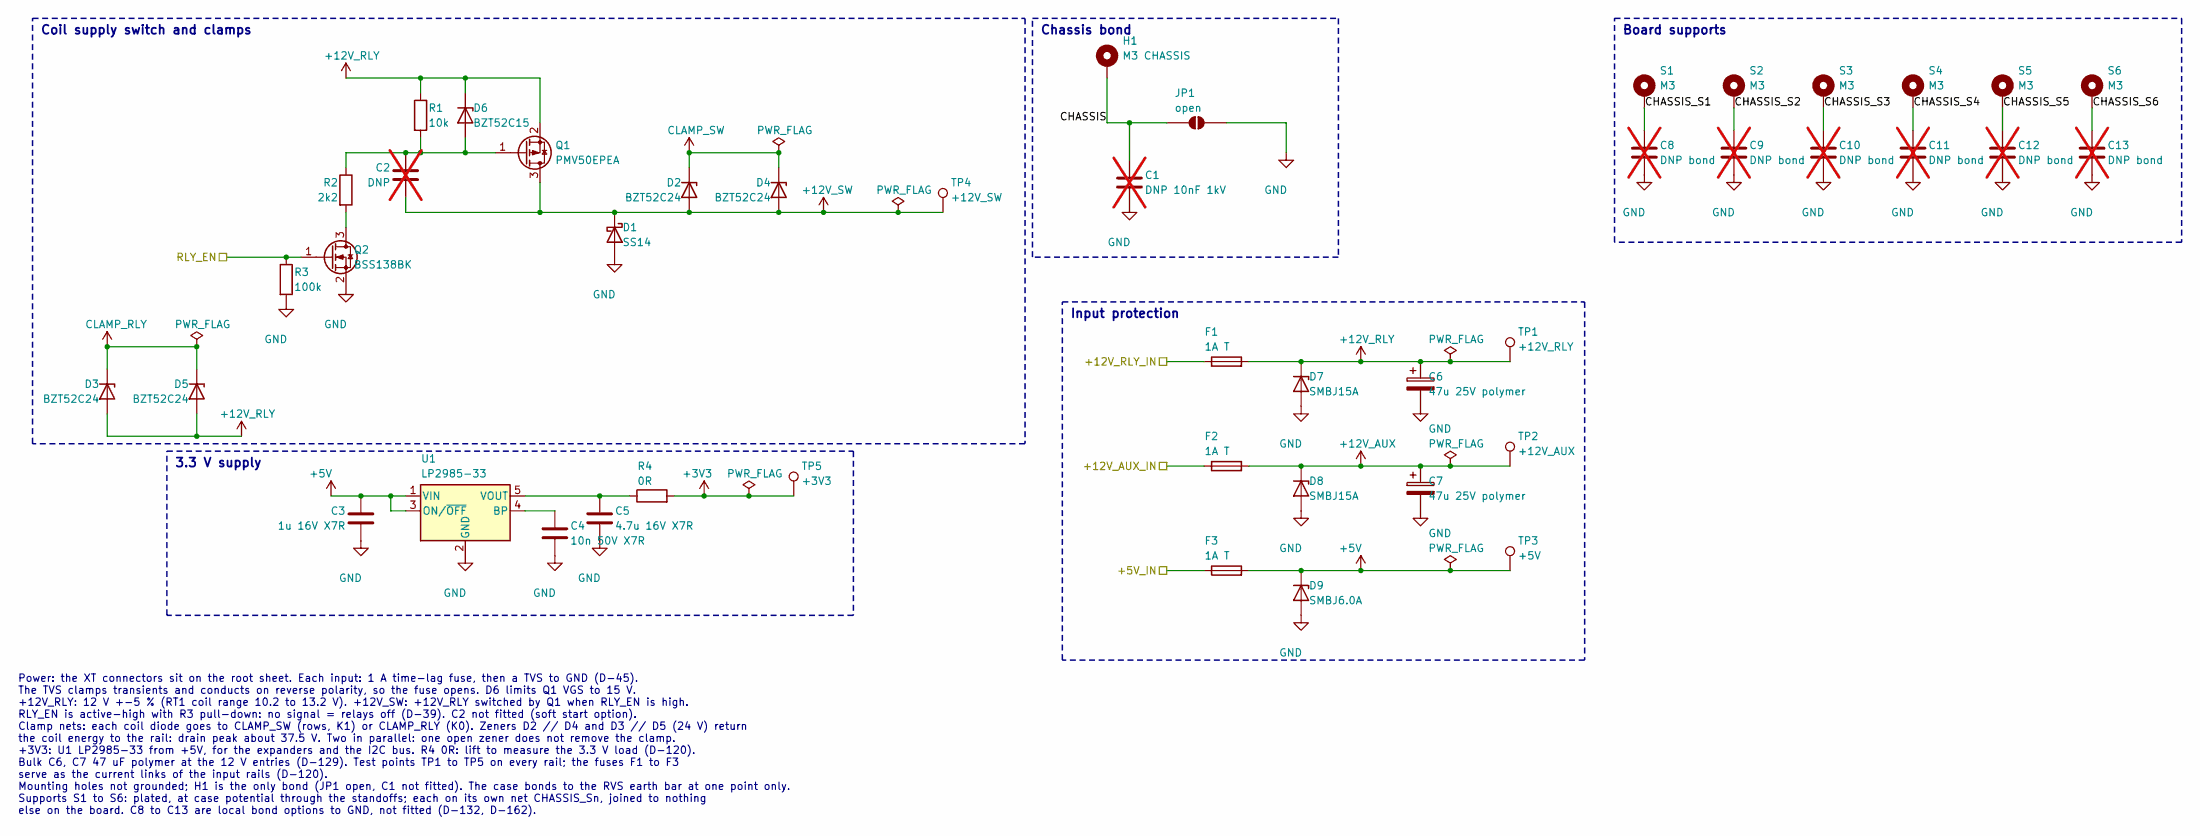
[picture p98: schematic power.kicad_sch, Unit RF board: power, coil supply, 3V3 and chassis bond]

Parts:
C1: DNP 10nF 1kV; C_1206_3216Metric_Pad1.33x1.80mm_HandSolder; not fitted
C2: DNP; C_0603_1608Metric_Pad1.08x0.95mm_HandSolder; not fitted
C3: 1u 16V X7R; C_0603_1608Metric_Pad1.08x0.95mm_HandSolder
C4: 10n 50V X7R; C_0603_1608Metric_Pad1.08x0.95mm_HandSolder
C5: 4.7u 16V X7R; C_0805_2012Metric_Pad1.18x1.45mm_HandSolder
C6, C7: 47u 25V polymer; CP_Elec_6.3x7.7
C8, C9, C10, C11, C12, C13: DNP bond; C_1206_3216Metric_Pad1.33x1.80mm_HandSolder; not fitted
D1: SS14; D_SMA; MPN SS14
D2, D3, D4, D5: BZT52C24; D_SOD-123; MPN BZT52C24
D6: BZT52C15; D_SOD-123; MPN BZT52C15
D7, D8: SMBJ15A; D_SMB; MPN SMBJ15A
D9: SMBJ6.0A; D_SMB; MPN SMBJ6.0A
F1, F2, F3: 1A T; Fuse_1206_3216Metric_Pad1.42x1.75mm_HandSolder; MPN 0468001.NR
H1: M3 CHASSIS; MountingHole_3.2mm_M3_Pad
JP1: open; SolderJumper-2_P1.3mm_Open_RoundedPad1.0x1.5mm
Q1: PMV50EPEA; SOT-23; MPN PMV50EPEA
Q2: BSS138BK; SOT-23; MPN BSS138BK
R1: 10k; R_0603_1608Metric_Pad0.98x0.95mm_HandSolder
R2: 2k2; R_0603_1608Metric_Pad0.98x0.95mm_HandSolder
R3: 100k; R_0603_1608Metric_Pad0.98x0.95mm_HandSolder
R4: 0R; R_1206_3216Metric_Pad1.30x1.75mm_HandSolder
S1, S2, S3, S4, S5, S6: M3; MountingHole_3.2mm_M3_Pad
TP1: +12V_RLY; TestPoint_Pad_D1.5mm
TP2: +12V_AUX; TestPoint_Pad_D1.5mm
TP3: +5V; TestPoint_Pad_D1.5mm
TP4: +12V_SW; TestPoint_Pad_D1.5mm
TP5: +3V3; TestPoint_Pad_D1.5mm
U1: LP2985-33; SOT-23-5; MPN LP2985-33DBVR

Connections:
+3V3: R4.2, TP5.1; also elsewhere on the board
+5V: C3.1, D9.1 (K), F3.2, TP3.1, U1.1 (VIN), U1.3 (ON/~OFF); also elsewhere on the board
+12V_AUX: C7.1, D8.1 (K), F2.2, TP2.1; also elsewhere on the board
+12V_RLY: C6.1, D3.2 (A), D5.2 (A), D6.1 (K), D7.1 (K), F1.2, Q1.2 (S), R1.1, TP1.1; also elsewhere on the board
+12V_SW: C2.2, D1.1 (K), D2.2 (A), D4.2 (A), Q1.3 (D), TP4.1; also elsewhere on the board
/+5V_IN: F3.1; also elsewhere on the board
/+12V_AUX_IN: F2.1; also elsewhere on the board
/+12V_RLY_IN: F1.1; also elsewhere on the board
/Power, coil supply and 3V3/CHASSIS: C1.1, H1.1, JP1.1 (A)
/Power, coil supply and 3V3/CHASSIS_S1: C8.1, S1.1
/Power, coil supply and 3V3/CHASSIS_S2: C9.1, S2.1
/Power, coil supply and 3V3/CHASSIS_S3: C10.1, S3.1
/Power, coil supply and 3V3/CHASSIS_S4: C11.1, S4.1
/Power, coil supply and 3V3/CHASSIS_S5: C12.1, S5.1
/Power, coil supply and 3V3/CHASSIS_S6: C13.1, S6.1
/RLY_EN: Q2.1 (G), R3.1; also elsewhere on the board
CLAMP_RLY: D3.1 (K), D5.1 (K); also elsewhere on the board
CLAMP_SW: D2.1 (K), D4.1 (K); also elsewhere on the board
GND: C1.2, C3.2, C4.2, C5.2, C6.2, C7.2, C8.2, C9.2, C10.2, C11.2, C12.2, C13.2, D1.2 (A), D7.2 (A), D8.2 (A), D9.2 (A), JP1.2 (B), Q2.2 (S), R3.2, U1.2 (GND); also elsewhere on the board
unnamed: C2.1, D6.2 (A), Q1.1 (G), R1.2, R2.1
unnamed: Q2.3 (D), R2.2
unnamed: C4.1, U1.4 (BP)
unnamed: C5.1, R4.1, U1.5 (VOUT)

Notes on the sheet:
Power: the XT connectors sit on the root sheet. Each input: 1 A time-lag fuse, then a TVS to GND (D-45). The TVS clamps transients and conducts on reverse polarity, so the fuse opens. D6 limits Q1 VGS to 15 V. +12V_RLY: 12 V +-5 % (RT1 coil range 10.2 to 13.2 V). +12V_SW: +12V_RLY switched by Q1 wh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
Coil supply switch and clamps
Chassis bond
Input protection
3.3 V supply
Board supports

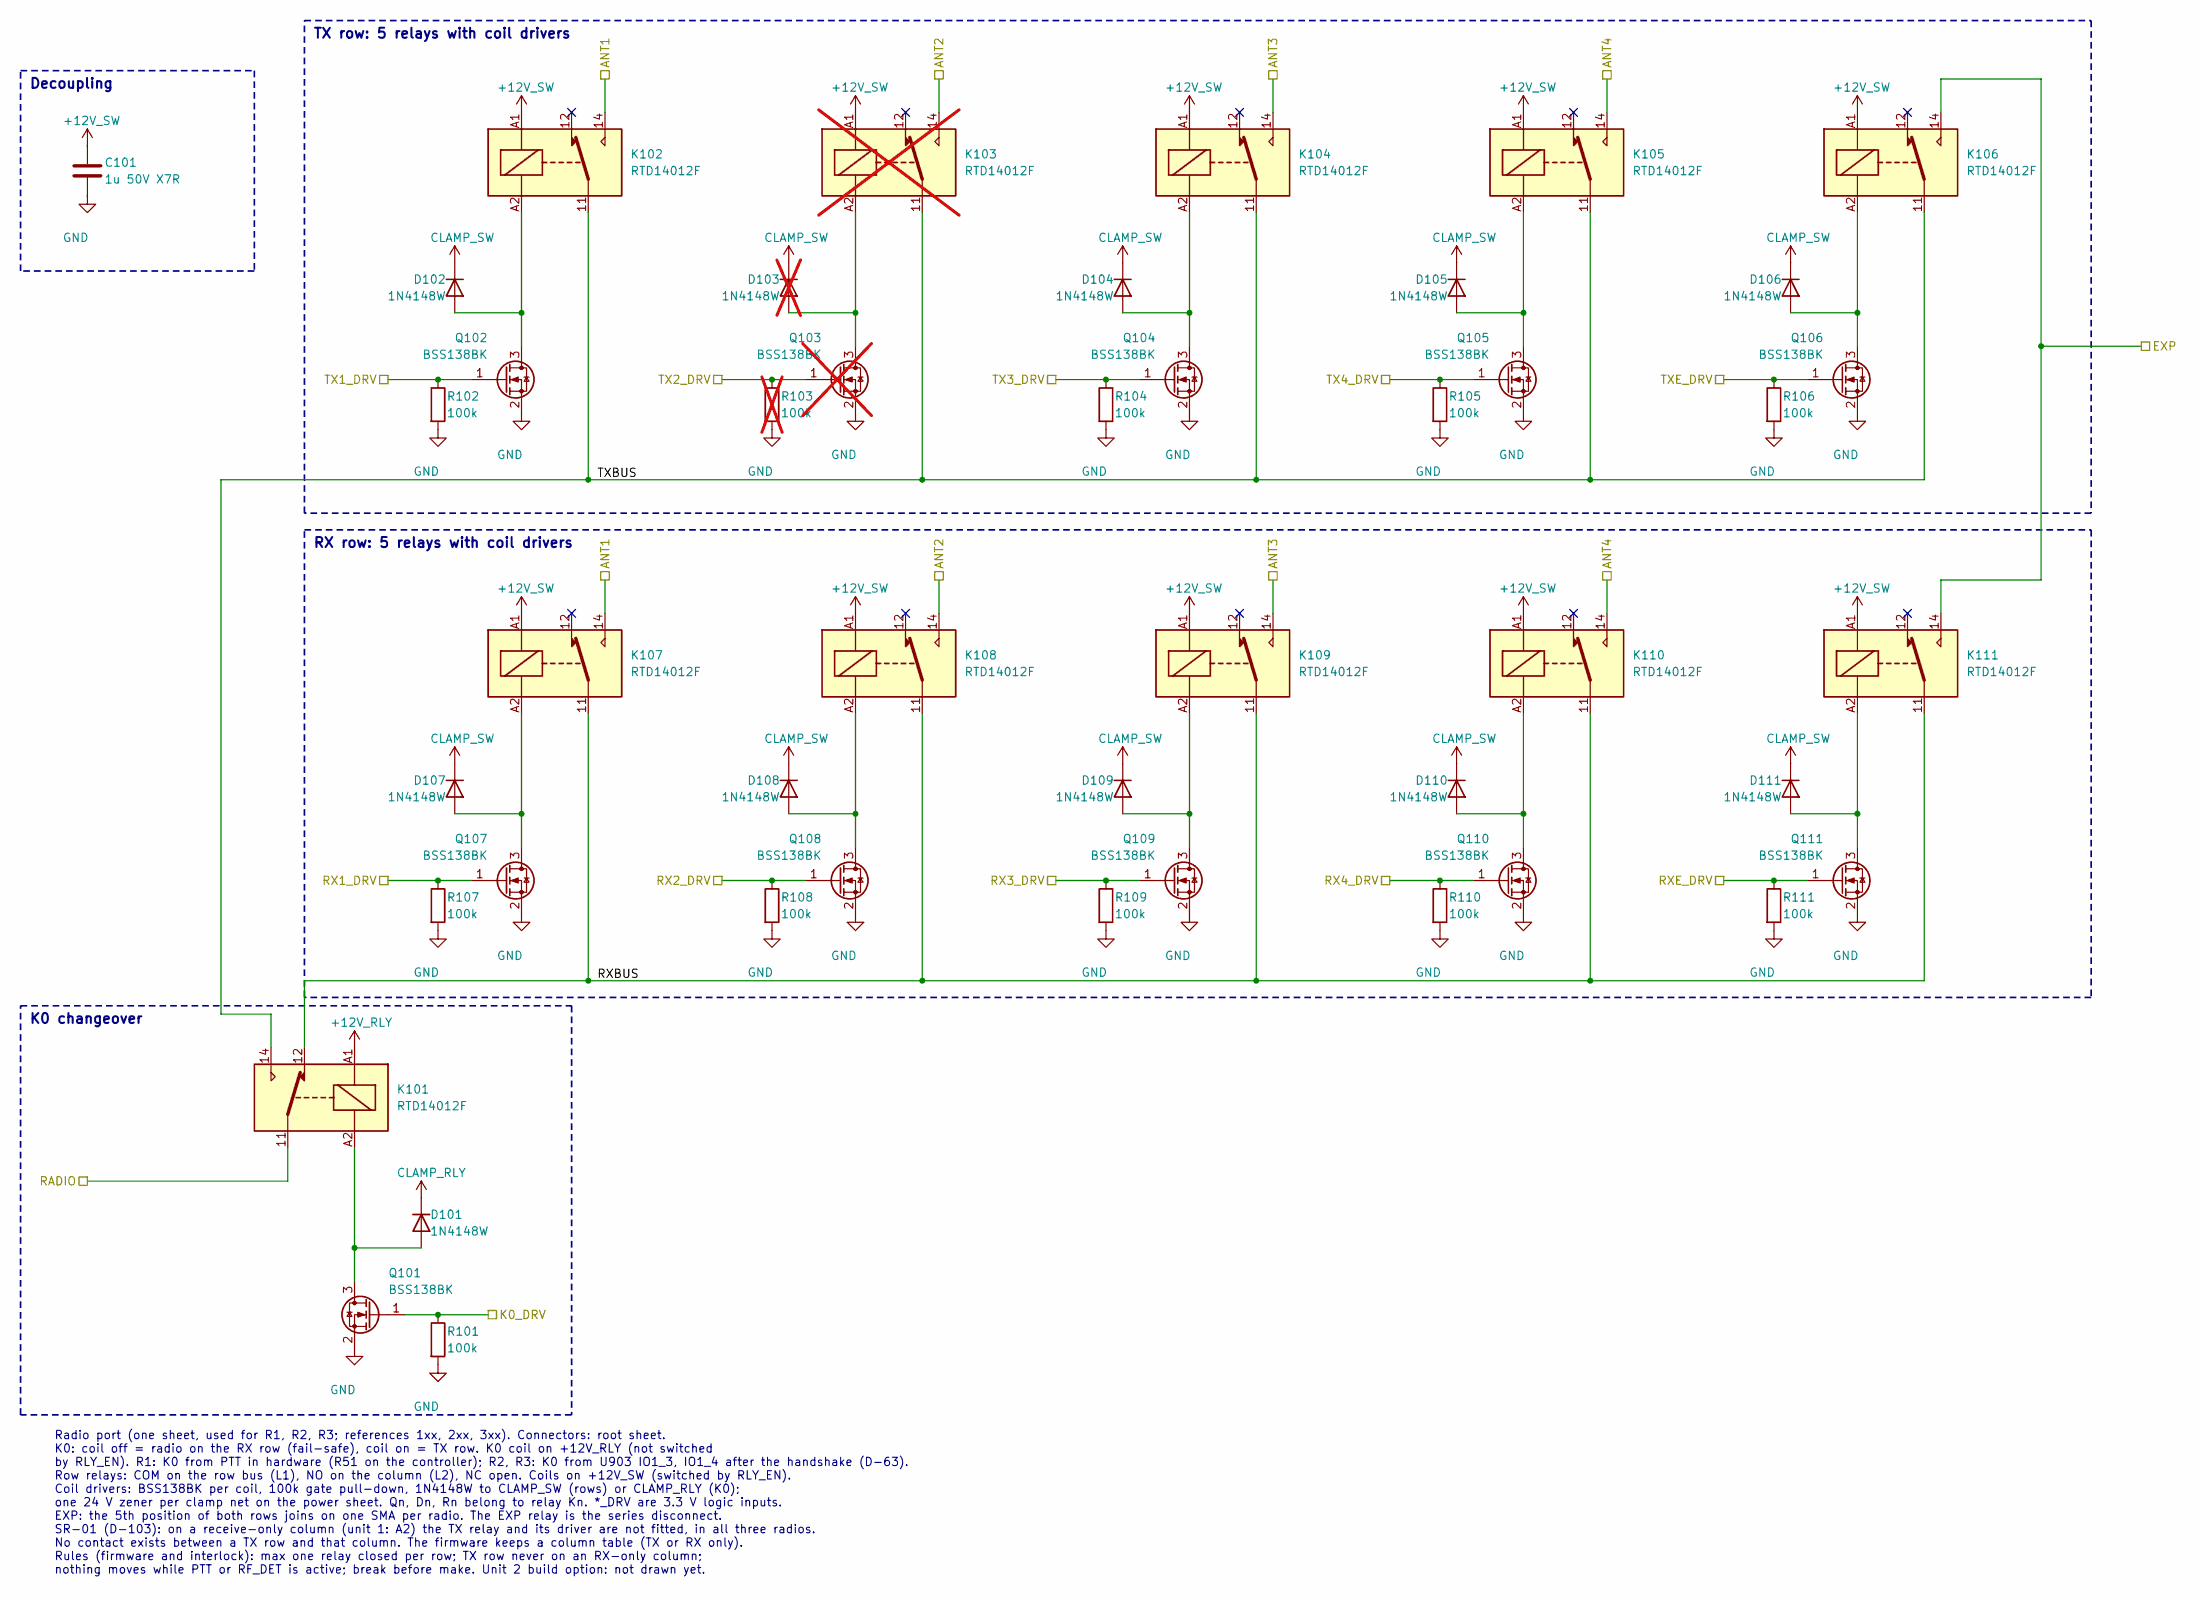
[picture p99: schematic radio_port.kicad_sch, Unit RF board: radio port (K0, TX/RX rows, EXP, drivers)]

Parts:
C101: 1u 50V X7R; C_0805_2012Metric_Pad1.18x1.45mm_HandSolder
D101, D102, D104, D105, D106, D107, D108, D109, D110, D111: 1N4148W; D_SOD-123; MPN 1N4148W
D103: 1N4148W; D_SOD-123; MPN 1N4148W; not fitted
K101, K102, K104, K105, K106, K107, K108, K109, K110, K111: RTD14012F; Relay_SPDT_Schrack-RT1-16A-FormC_RM5mm; MPN RTD14012F
K103: RTD14012F; Relay_SPDT_Schrack-RT1-16A-FormC_RM5mm; MPN RTD14012F; not fitted
Q101, Q102, Q104, Q105, Q106, Q107, Q108, Q109, Q110, Q111: BSS138BK; SOT-23; MPN BSS138BK,215
Q103: BSS138BK; SOT-23; MPN BSS138BK,215; not fitted
R101, R102, R104, R105, R106, R107, R108, R109, R110, R111: 100k; R_0603_1608Metric_Pad0.98x0.95mm_HandSolder
R103: 100k; R_0603_1608Metric_Pad0.98x0.95mm_HandSolder; not fitted

Connections:
+12V_RLY: K101.A1; also elsewhere on the board
+12V_SW: C101.1, K102.A1, K103.A1, K104.A1, K105.A1, K106.A1, K107.A1, K108.A1, K109.A1, K110.A1, K111.A1; also elsewhere on the board
/ANT1: K102.14, K107.14; also elsewhere on the board
/ANT2: K103.14, K108.14; also elsewhere on the board
/ANT3: K104.14, K109.14; also elsewhere on the board
/ANT4: K105.14, K110.14; also elsewhere on the board
/R1_EXP: K106.14, K111.14; also elsewhere on the board
/R1_K0_DRV: Q101.1 (G), R101.1; also elsewhere on the board
/R1_RADIO: K101.11; also elsewhere on the board
/R1_RX1_DRV: Q107.1 (G), R107.1; also elsewhere on the board
/R1_RX2_DRV: Q108.1 (G), R108.1; also elsewhere on the board
/R1_RX3_DRV: Q109.1 (G), R109.1; also elsewhere on the board
/R1_RX4_DRV: Q110.1 (G), R110.1; also elsewhere on the board
/R1_RXE_DRV: Q111.1 (G), R111.1; also elsewhere on the board
/R1_TX1_DRV: Q102.1 (G), R102.1; also elsewhere on the board
/R1_TX2_DRV: Q103.1 (G), R103.1; also elsewhere on the board
/R1_TX3_DRV: Q104.1 (G), R104.1; also elsewhere on the board
/R1_TX4_DRV: Q105.1 (G), R105.1; also elsewhere on the board
/R1_TXE_DRV: Q106.1 (G), R106.1; also elsewhere on the board
/Radio port R1/RXBUS: K101.12, K107.11, K108.11, K109.11, K110.11, K111.11
/Radio port R1/TXBUS: K101.14, K102.11, K103.11, K104.11, K105.11, K106.11
CLAMP_RLY: D101.1 (K); also elsewhere on the board
CLAMP_SW: D102.1 (K), D103.1 (K), D104.1 (K), D105.1 (K), D106.1 (K), D107.1 (K), D108.1 (K), D109.1 (K), D110.1 (K), D111.1 (K); also elsewhere on the board
GND: C101.2, Q101.2 (S), Q102.2 (S), Q103.2 (S), Q104.2 (S), Q105.2 (S), Q106.2 (S), Q107.2 (S), Q108.2 (S), Q109.2 (S), Q110.2 (S), Q111.2 (S), R101.2, R102.2, R103.2, R104.2, R105.2, R106.2, R107.2, R108.2, R109.2, R110.2, R111.2; also elsewhere on the board
unnamed: D101.2 (A), K101.A2, Q101.3 (D)
unnamed: D102.2 (A), K102.A2, Q102.3 (D)
unnamed: D103.2 (A), K103.A2, Q103.3 (D)
unnamed: D104.2 (A), K104.A2, Q104.3 (D)
unnamed: D105.2 (A), K105.A2, Q105.3 (D)
unnamed: D106.2 (A), K106.A2, Q106.3 (D)
unnamed: D107.2 (A), K107.A2, Q107.3 (D)
unnamed: D108.2 (A), K108.A2, Q108.3 (D)
unnamed: D109.2 (A), K109.A2, Q109.3 (D)
unnamed: D110.2 (A), K110.A2, Q110.3 (D)
unnamed: D111.2 (A), K111.A2, Q111.3 (D)

Parts of its further copies:
C201, C301: 1u 50V X7R; C_0805_2012Metric_Pad1.18x1.45mm_HandSolder
D201, D202, D204, D205, D206, D207, D208, D209, D210, D211, D301, D302, D304, D305, D306, D307, D308, D309, D310, D311: 1N4148W; D_SOD-123; MPN 1N4148W
D203, D303: 1N4148W; D_SOD-123; MPN 1N4148W; not fitted
K201, K202, K204, K205, K206, K207, K208, K209, K210, K211, K301, K302, K304, K305, K306, K307, K308, K309, K310, K311: RTD14012F; Relay_SPDT_Schrack-RT1-16A-FormC_RM5mm; MPN RTD14012F
K203, K303: RTD14012F; Relay_SPDT_Schrack-RT1-16A-FormC_RM5mm; MPN RTD14012F; not fitted
Q201, Q202, Q204, Q205, Q206, Q207, Q208, Q209, Q210, Q211, Q301, Q302, Q304, Q305, Q306, Q307, Q308, Q309, Q310, Q311: BSS138BK; SOT-23; MPN BSS138BK,215
Q203, Q303: BSS138BK; SOT-23; MPN BSS138BK,215; not fitted
R201, R202, R204, R205, R206, R207, R208, R209, R210, R211, R301, R302, R304, R305, R306, R307, R308, R309, R310, R311: 100k; R_0603_1608Metric_Pad0.98x0.95mm_HandSolder
R203, R303: 100k; R_0603_1608Metric_Pad0.98x0.95mm_HandSolder; not fitted

Connections of its further copies:
+12V_RLY: K201.A1, K301.A1; also elsewhere on the board
+12V_SW: C201.1, C301.1, K202.A1, K203.A1, K204.A1, K205.A1, K206.A1, K207.A1, K208.A1, K209.A1, K210.A1, K211.A1, K302.A1, K303.A1, K304.A1, K305.A1, K306.A1, K307.A1, K308.A1, K309.A1, K310.A1, K311.A1; also elsewhere on the board
/ANT1: K202.14, K207.14, K302.14, K307.14; also elsewhere on the board
/ANT2: K203.14, K208.14, K303.14, K308.14; also elsewhere on the board
/ANT3: K204.14, K209.14, K304.14, K309.14; also elsewhere on the board
/ANT4: K205.14, K210.14, K305.14, K310.14; also elsewhere on the board
/R2_EXP: K206.14, K211.14; also elsewhere on the board
/R2_K0_DRV: Q201.1 (G), R201.1; also elsewhere on the board
/R2_RADIO: K201.11; also elsewhere on the board
/R2_RX1_DRV: Q207.1 (G), R207.1; also elsewhere on the board
/R2_RX2_DRV: Q208.1 (G), R208.1; also elsewhere on the board
/R2_RX3_DRV: Q209.1 (G), R209.1; also elsewhere on the board
/R2_RX4_DRV: Q210.1 (G), R210.1; also elsewhere on the board
/R2_RXE_DRV: Q211.1 (G), R211.1; also elsewhere on the board
/R2_TX1_DRV: Q202.1 (G), R202.1; also elsewhere on the board
/R2_TX2_DRV: Q203.1 (G), R203.1; also elsewhere on the board
/R2_TX3_DRV: Q204.1 (G), R204.1; also elsewhere on the board
/R2_TX4_DRV: Q205.1 (G), R205.1; also elsewhere on the board
/R2_TXE_DRV: Q206.1 (G), R206.1; also elsewhere on the board
/R3_EXP: K306.14, K311.14; also elsewhere on the board
/R3_K0_DRV: Q301.1 (G), R301.1; also elsewhere on the board
/R3_RADIO: K301.11; also elsewhere on the board
/R3_RX1_DRV: Q307.1 (G), R307.1; also elsewhere on the board
/R3_RX2_DRV: Q308.1 (G), R308.1; also elsewhere on the board
/R3_RX3_DRV: Q309.1 (G), R309.1; also elsewhere on the board
/R3_RX4_DRV: Q310.1 (G), R310.1; also elsewhere on the board
/R3_RXE_DRV: Q311.1 (G), R311.1; also elsewhere on the board
/R3_TX1_DRV: Q302.1 (G), R302.1; also elsewhere on the board
/R3_TX2_DRV: Q303.1 (G), R303.1; also elsewhere on the board
/R3_TX3_DRV: Q304.1 (G), R304.1; also elsewhere on the board
/R3_TX4_DRV: Q305.1 (G), R305.1; also elsewhere on the board
/R3_TXE_DRV: Q306.1 (G), R306.1; also elsewhere on the board
/Radio port R2/RXBUS: K201.12, K207.11, K208.11, K209.11, K210.11, K211.11
/Radio port R2/TXBUS: K201.14, K202.11, K203.11, K204.11, K205.11, K206.11
/Radio port R3/RXBUS: K301.12, K307.11, K308.11, K309.11, K310.11, K311.11
/Radio port R3/TXBUS: K301.14, K302.11, K303.11, K304.11, K305.11, K306.11
CLAMP_RLY: D201.1 (K), D301.1 (K); also elsewhere on the board
CLAMP_SW: D202.1 (K), D203.1 (K), D204.1 (K), D205.1 (K), D206.1 (K), D207.1 (K), D208.1 (K), D209.1 (K), D210.1 (K), D211.1 (K), D302.1 (K), D303.1 (K), D304.1 (K), D305.1 (K), D306.1 (K), D307.1 (K), D308.1 (K), D309.1 (K), D310.1 (K), D311.1 (K); also elsewhere on the board
GND: C201.2, C301.2, Q201.2 (S), Q202.2 (S), Q203.2 (S), Q204.2 (S), Q205.2 (S), Q206.2 (S), Q207.2 (S), Q208.2 (S), Q209.2 (S), Q210.2 (S), Q211.2 (S), Q301.2 (S), Q302.2 (S), Q303.2 (S), Q304.2 (S), Q305.2 (S), Q306.2 (S), Q307.2 (S), Q308.2 (S), Q309.2 (S), Q310.2 (S), Q311.2 (S), R201.2, R202.2, R203.2, R204.2, R205.2, R206.2, R207.2, R208.2, R209.2, R210.2, R211.2, R301.2, R302.2, R303.2, R304.2, R305.2, R306.2, R307.2, R308.2, R309.2, R310.2, R311.2; also elsewhere on the board
unnamed: D201.2 (A), K201.A2, Q201.3 (D)
unnamed: D202.2 (A), K202.A2, Q202.3 (D)
unnamed: D203.2 (A), K203.A2, Q203.3 (D)
unnamed: D204.2 (A), K204.A2, Q204.3 (D)
unnamed: D205.2 (A), K205.A2, Q205.3 (D)
unnamed: D206.2 (A), K206.A2, Q206.3 (D)
unnamed: D207.2 (A), K207.A2, Q207.3 (D)
unnamed: D208.2 (A), K208.A2, Q208.3 (D)
unnamed: D209.2 (A), K209.A2, Q209.3 (D)
unnamed: D210.2 (A), K210.A2, Q210.3 (D)
unnamed: D211.2 (A), K211.A2, Q211.3 (D)
unnamed: D301.2 (A), K301.A2, Q301.3 (D)
unnamed: D302.2 (A), K302.A2, Q302.3 (D)
unnamed: D303.2 (A), K303.A2, Q303.3 (D)
unnamed: D304.2 (A), K304.A2, Q304.3 (D)
unnamed: D305.2 (A), K305.A2, Q305.3 (D)
unnamed: D306.2 (A), K306.A2, Q306.3 (D)
unnamed: D307.2 (A), K307.A2, Q307.3 (D)
unnamed: D308.2 (A), K308.A2, Q308.3 (D)
unnamed: D309.2 (A), K309.A2, Q309.3 (D)
unnamed: D310.2 (A), K310.A2, Q310.3 (D)
unnamed: D311.2 (A), K311.A2, Q311.3 (D)

Notes on the sheet:
Radio port (one sheet, used for R1, R2, R3; references 1xx, 2xx, 3xx). Connectors: root sheet. K0: coil off = radio on the RX row (fail-safe), coil on = TX row. K0 coil on +12V_RLY (not switched by RLY_EN). R1: K0 from PTT in hardware (R51 on the controller); R2, R3: K0 from U903 IO1_3, IO1_4 after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
TX row: 5 relays with coil drivers
RX row: 5 relays with coil drivers
K0 changeover
Decoupling

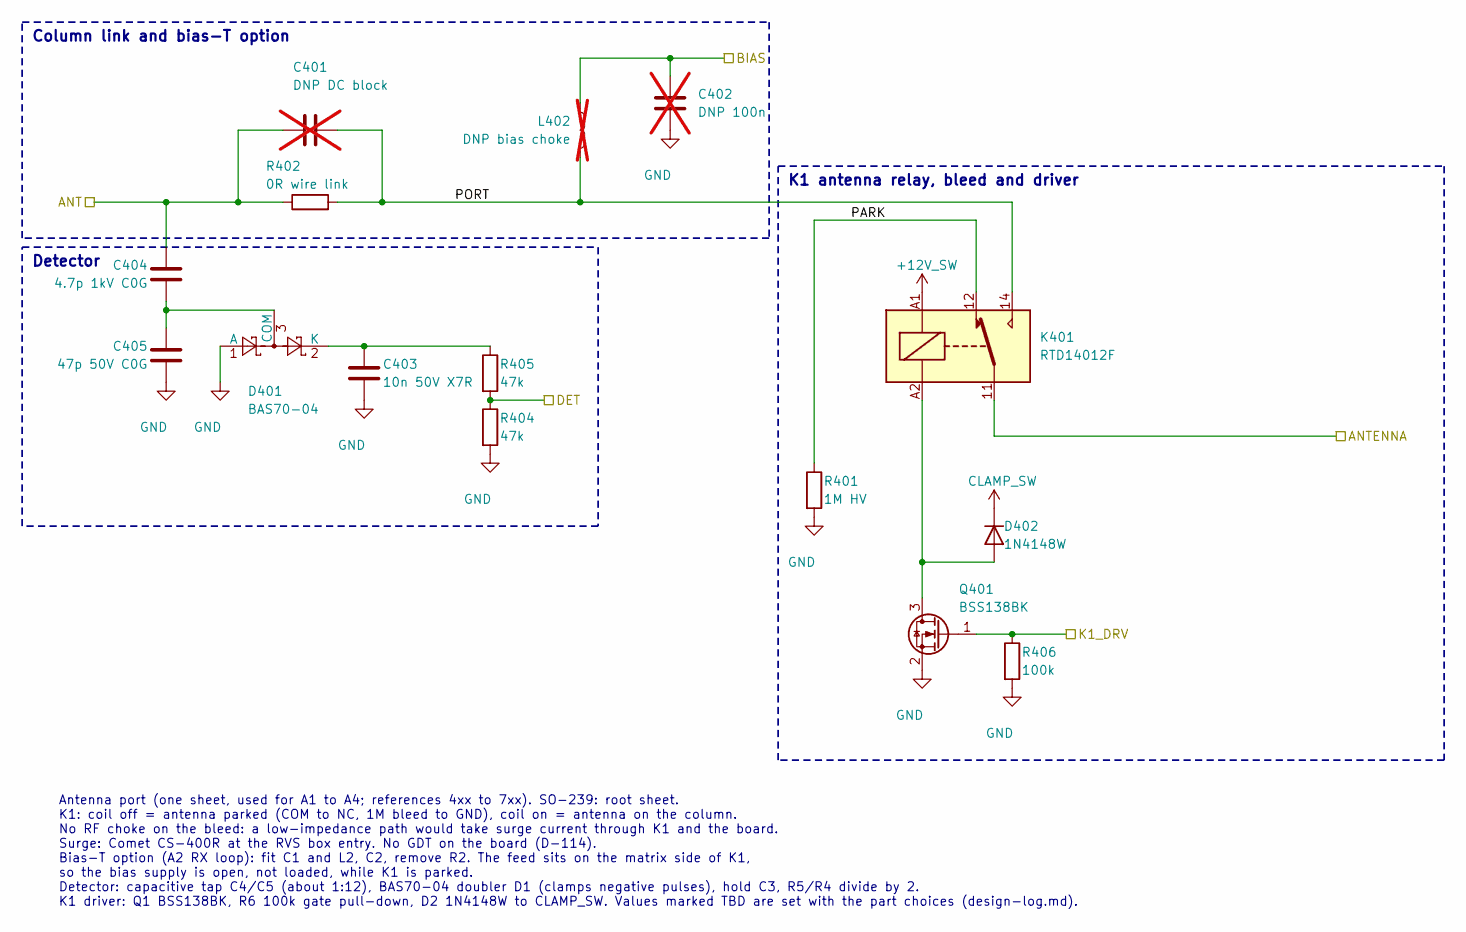
[picture p100: schematic antenna_port.kicad_sch, Unit RF board: antenna port (K1, driver, detector, bias-T)]

Parts:
C401: DNP DC block; C_1812_4532Metric_Pad1.57x3.40mm_HandSolder; not fitted
C402: DNP 100n; C_1206_3216Metric_Pad1.33x1.80mm_HandSolder; not fitted
C403: 10n 50V X7R; C_0603_1608Metric_Pad1.08x0.95mm_HandSolder
C404: 4.7p 1kV C0G; C_1206_3216Metric_RFgap2.0; MPN 1206J1K04P70CCT
C405: 47p 50V C0G; C_0603_1608Metric_Pad1.08x0.95mm_HandSolder
D401: BAS70-04; SOT-23; MPN BAS70-04
D402: 1N4148W; D_SOD-123; MPN 1N4148W
K401: RTD14012F; Relay_SPDT_Schrack-RT1-16A-FormC_RM5mm; MPN RTD14012F
L402: DNP bias choke; L_1812_4532Metric_Pad1.30x3.40mm_HandSolder; not fitted
Q401: BSS138BK; SOT-23; MPN BSS138BK,215
R401: 1M HV; R_Axial_DIN0207_L6.3mm_D2.5mm_P10.16mm_Horizontal
R402: 0R wire link; WireLink_P7.62mm_D1.0mm
R404, R405: 47k; R_0603_1608Metric_Pad0.98x0.95mm_HandSolder
R406: 100k; R_0603_1608Metric_Pad0.98x0.95mm_HandSolder

Connections:
+12V_SW: K401.A1; also elsewhere on the board
/A1_ANTENNA: K401.11; also elsewhere on the board
/A1_BIAS: C402.1, L402.1; also elsewhere on the board
/A1_DET: R404.1, R405.2; also elsewhere on the board
/A1_K1_DRV: Q401.1 (G), R406.1; also elsewhere on the board
/ANT1: C401.1, C404.1, R402.1; also elsewhere on the board
/Antenna port A1/PARK: K401.12, R401.1
/Antenna port A1/PORT: C401.2, K401.14, L402.2, R402.2
CLAMP_SW: D402.1 (K); also elsewhere on the board
GND: C402.2, C403.2, C405.2, D401.1 (A), Q401.2 (S), R401.2, R404.2, R406.2; also elsewhere on the board
unnamed: C404.2, C405.1, D401.3 (COM)
unnamed: C403.1, D401.2 (K), R405.1
unnamed: D402.2 (A), K401.A2, Q401.3 (D)

Parts of its further copies:
C501, C601, C701: DNP DC block; C_1812_4532Metric_Pad1.57x3.40mm_HandSolder; not fitted
C502, C602, C702: DNP 100n; C_1206_3216Metric_Pad1.33x1.80mm_HandSolder; not fitted
C503, C603, C703: 10n 50V X7R; C_0603_1608Metric_Pad1.08x0.95mm_HandSolder
C504, C604, C704: 4.7p 1kV C0G; C_1206_3216Metric_RFgap2.0; MPN 1206J1K04P70CCT
C505, C605, C705: 47p 50V C0G; C_0603_1608Metric_Pad1.08x0.95mm_HandSolder
D501, D601, D701: BAS70-04; SOT-23; MPN BAS70-04
D502, D602, D702: 1N4148W; D_SOD-123; MPN 1N4148W
K501, K601, K701: RTD14012F; Relay_SPDT_Schrack-RT1-16A-FormC_RM5mm; MPN RTD14012F
L502, L602, L702: DNP bias choke; L_1812_4532Metric_Pad1.30x3.40mm_HandSolder; not fitted
Q501, Q601, Q701: BSS138BK; SOT-23; MPN BSS138BK,215
R501, R601, R701: 1M HV; R_Axial_DIN0207_L6.3mm_D2.5mm_P10.16mm_Horizontal
R502, R602, R702: 0R wire link; WireLink_P7.62mm_D1.0mm
R504, R505, R604, R605, R704, R705: 47k; R_0603_1608Metric_Pad0.98x0.95mm_HandSolder
R506, R606, R706: 100k; R_0603_1608Metric_Pad0.98x0.95mm_HandSolder

Connections of its further copies:
+12V_SW: K501.A1, K601.A1, K701.A1; also elsewhere on the board
/A2_ANTENNA: K501.11; also elsewhere on the board
/A2_BIAS: C502.1, L502.1; also elsewhere on the board
/A2_DET: R504.1, R505.2; also elsewhere on the board
/A2_K1_DRV: Q501.1 (G), R506.1; also elsewhere on the board
/A3_ANTENNA: K601.11; also elsewhere on the board
/A3_BIAS: C602.1, L602.1; also elsewhere on the board
/A3_DET: R604.1, R605.2; also elsewhere on the board
/A3_K1_DRV: Q601.1 (G), R606.1; also elsewhere on the board
/A4_ANTENNA: K701.11; also elsewhere on the board
/A4_BIAS: C702.1, L702.1; also elsewhere on the board
/A4_DET: R704.1, R705.2; also elsewhere on the board
/A4_K1_DRV: Q701.1 (G), R706.1; also elsewhere on the board
/ANT2: C501.1, C504.1, R502.1; also elsewhere on the board
/ANT3: C601.1, C604.1, R602.1; also elsewhere on the board
/ANT4: C701.1, C704.1, R702.1; also elsewhere on the board
/Antenna port A2/PARK: K501.12, R501.1
/Antenna port A2/PORT: C501.2, K501.14, L502.2, R502.2
/Antenna port A3/PARK: K601.12, R601.1
/Antenna port A3/PORT: C601.2, K601.14, L602.2, R602.2
/Antenna port A4/PARK: K701.12, R701.1
/Antenna port A4/PORT: C701.2, K701.14, L702.2, R702.2
CLAMP_SW: D502.1 (K), D602.1 (K), D702.1 (K); also elsewhere on the board
GND: C502.2, C503.2, C505.2, C602.2, C603.2, C605.2, C702.2, C703.2, C705.2, D501.1 (A), D601.1 (A), D701.1 (A), Q501.2 (S), Q601.2 (S), Q701.2 (S), R501.2, R504.2, R506.2, R601.2, R604.2, R606.2, R701.2, R704.2, R706.2; also elsewhere on the board
unnamed: C504.2, C505.1, D501.3 (COM)
unnamed: C503.1, D501.2 (K), R505.1
unnamed: D502.2 (A), K501.A2, Q501.3 (D)
unnamed: C604.2, C605.1, D601.3 (COM)
unnamed: C603.1, D601.2 (K), R605.1
unnamed: D602.2 (A), K601.A2, Q601.3 (D)
unnamed: C704.2, C705.1, D701.3 (COM)
unnamed: C703.1, D701.2 (K), R705.1
unnamed: D702.2 (A), K701.A2, Q701.3 (D)

Notes on the sheet:
Antenna port (one sheet, used for A1 to A4; references 4xx to 7xx). SO-239: root sheet. K1: coil off = antenna parked (COM to NC, 1M bleed to GND), coil on = antenna on the column. No RF choke on the bleed: a low-impedance path would take surge current through K1 and the board. Surge: Comet CS-400R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
Column link and bias-T option
Detector
K1 antenna relay, bleed and driver
