PE1RGU/hf-antenna-switch/hardware/unit/rf-board/rf-board.kicad_pcb

## KiCad design hardware/unit/rf-board/rf-board.kicad_pcb (continued)

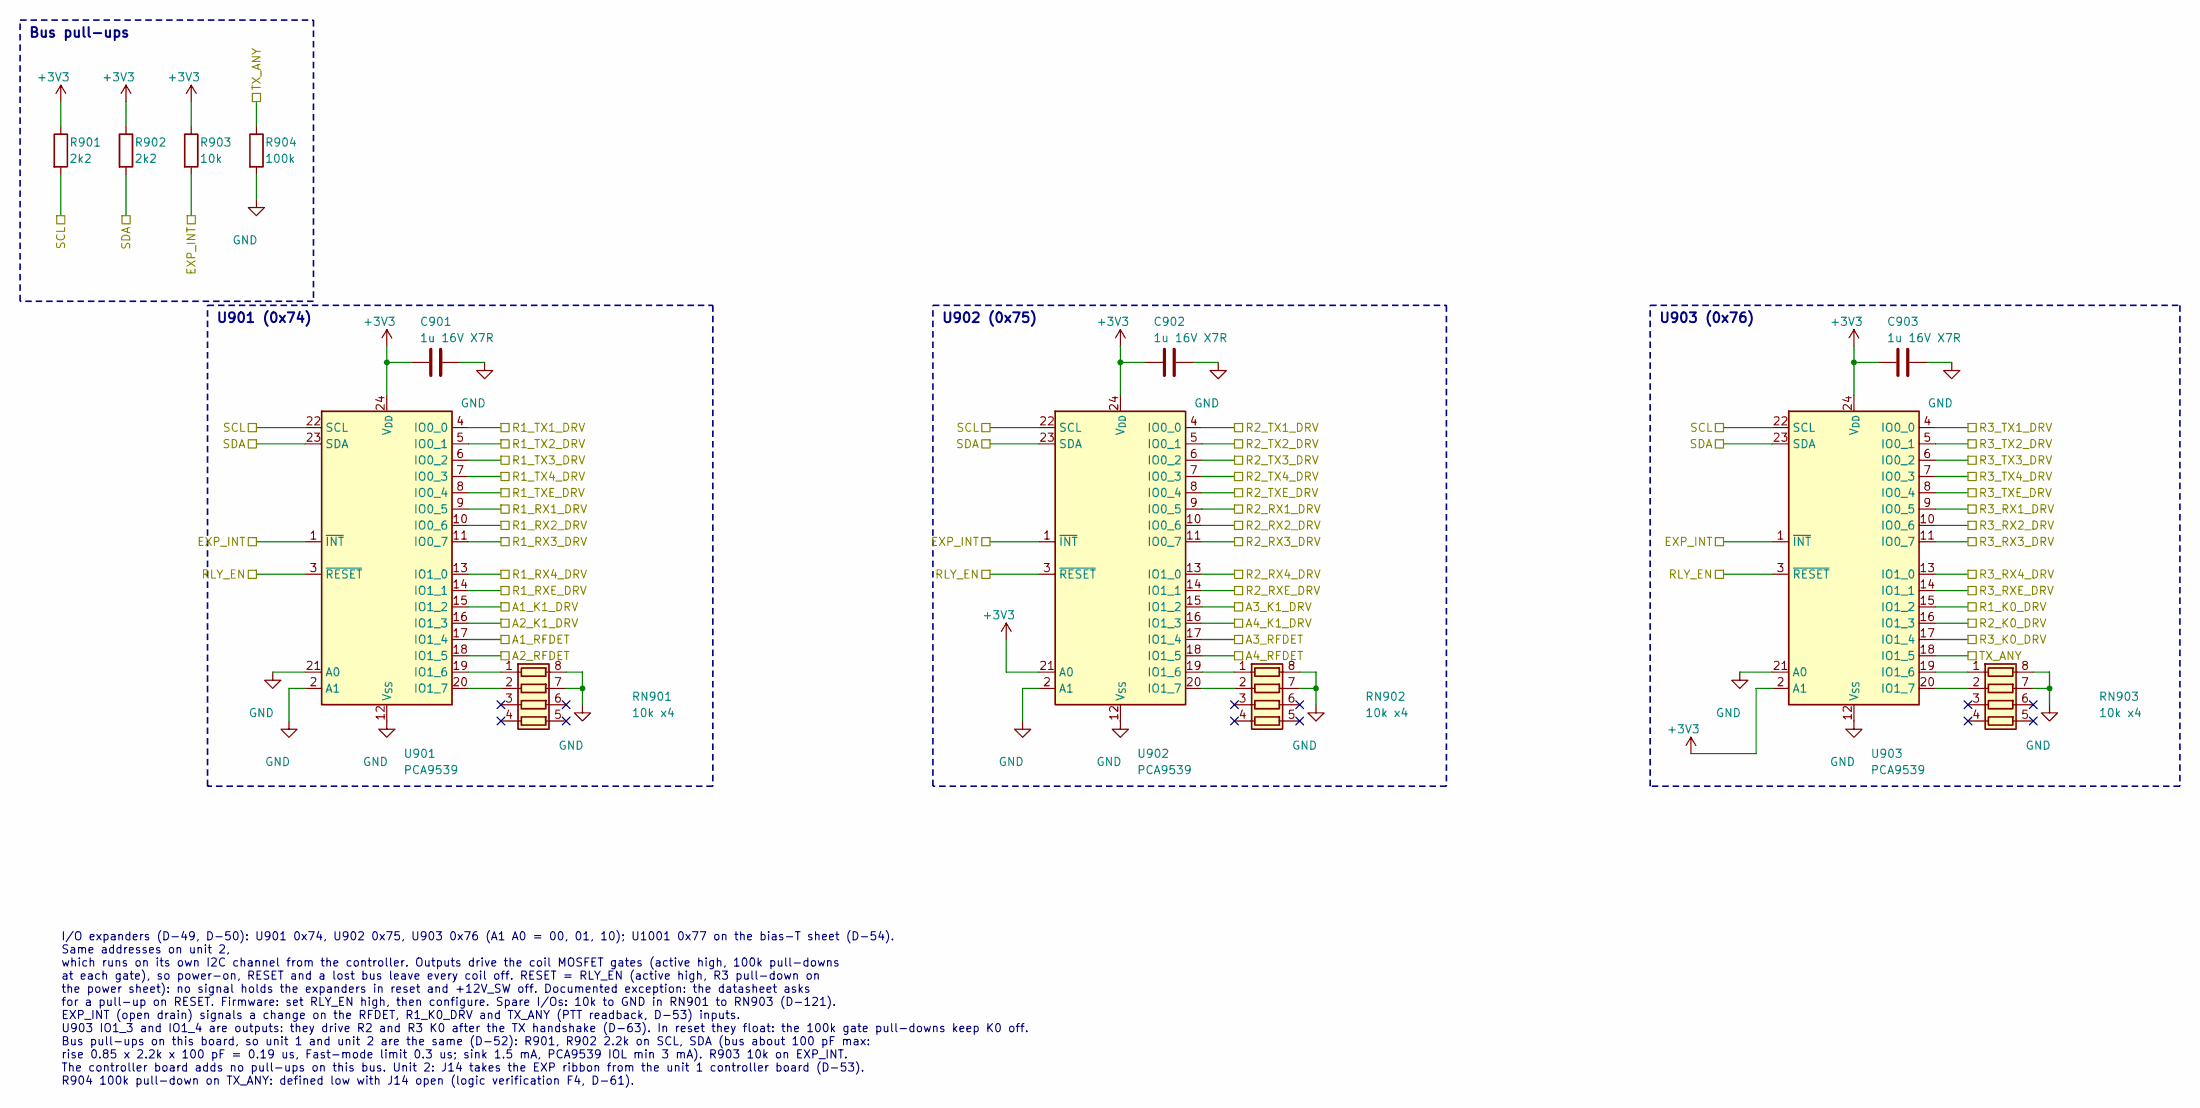
[picture p101: schematic io_expanders.kicad_sch, Unit RF board: I/O expanders (3 x PCA9539)]

Parts:
C901, C902, C903: 1u 16V X7R; C_0603_1608Metric_Pad1.08x0.95mm_HandSolder
R901, R902: 2k2; R_0603_1608Metric_Pad0.98x0.95mm_HandSolder
R903: 10k; R_0603_1608Metric_Pad0.98x0.95mm_HandSolder
R904: 100k; R_0603_1608Metric_Pad0.98x0.95mm_HandSolder
RN901, RN902, RN903: 10k x4; R_Array_Convex_4x0603; MPN CAY16-103J4LF
U901, U902, U903: PCA9539; TSSOP-24_4.4x7.8mm_P0.65mm; MPN PCA9539PW,118

Connections:
+3V3: C901.1, C902.1, C903.1, R901.1, R902.1, R903.1, U901.24 (V_{DD}), U902.21 (A0), U902.24 (V_{DD}), U903.2 (A1), U903.24 (V_{DD}); also elsewhere on the board
/A1_K1_DRV: U901.15 (IO1_2); also elsewhere on the board
/A2_K1_DRV: U901.16 (IO1_3); also elsewhere on the board
/A2_RFDET: U901.18 (IO1_5); also elsewhere on the board
/A3_K1_DRV: U902.15 (IO1_2); also elsewhere on the board
/A4_K1_DRV: U902.16 (IO1_3); also elsewhere on the board
/EXP_INT: R903.2, U901.1 (~INT), U902.1 (~INT), U903.1 (~INT); also elsewhere on the board
/IO expanders/A1_RFDET: U901.17 (IO1_4); also elsewhere on the board
/IO expanders/A3_RFDET: U902.17 (IO1_4); also elsewhere on the board
/IO expanders/A4_RFDET: U902.18 (IO1_5); also elsewhere on the board
/R1_K0_DRV: U903.15 (IO1_2); also elsewhere on the board
/R1_RX1_DRV: U901.9 (IO0_5); also elsewhere on the board
/R1_RX2_DRV: U901.10 (IO0_6); also elsewhere on the board
/R1_RX3_DRV: U901.11 (IO0_7); also elsewhere on the board
/R1_RX4_DRV: U901.13 (IO1_0); also elsewhere on the board
/R1_RXE_DRV: U901.14 (IO1_1); also elsewhere on the board
/R1_TX1_DRV: U901.4 (IO0_0); also elsewhere on the board
/R1_TX2_DRV: U901.5 (IO0_1); also elsewhere on the board
/R1_TX3_DRV: U901.6 (IO0_2); also elsewhere on the board
/R1_TX4_DRV: U901.7 (IO0_3); also elsewhere on the board
/R1_TXE_DRV: U901.8 (IO0_4); also elsewhere on the board
/R2_K0_DRV: U903.16 (IO1_3); also elsewhere on the board
/R2_RX1_DRV: U902.9 (IO0_5); also elsewhere on the board
/R2_RX2_DRV: U902.10 (IO0_6); also elsewhere on the board
/R2_RX3_DRV: U902.11 (IO0_7); also elsewhere on the board
/R2_RX4_DRV: U902.13 (IO1_0); also elsewhere on the board
/R2_RXE_DRV: U902.14 (IO1_1); also elsewhere on the board
/R2_TX1_DRV: U902.4 (IO0_0); also elsewhere on the board
/R2_TX2_DRV: U902.5 (IO0_1); also elsewhere on the board
/R2_TX3_DRV: U902.6 (IO0_2); also elsewhere on the board
/R2_TX4_DRV: U902.7 (IO0_3); also elsewhere on the board
/R2_TXE_DRV: U902.8 (IO0_4); also elsewhere on the board
/R3_K0_DRV: U903.17 (IO1_4); also elsewhere on the board
/R3_RX1_DRV: U903.9 (IO0_5); also elsewhere on the board
/R3_RX2_DRV: U903.10 (IO0_6); also elsewhere on the board
/R3_RX3_DRV: U903.11 (IO0_7); also elsewhere on the board
/R3_RX4_DRV: U903.13 (IO1_0); also elsewhere on the board
/R3_RXE_DRV: U903.14 (IO1_1); also elsewhere on the board
/R3_TX1_DRV: U903.4 (IO0_0); also elsewhere on the board
/R3_TX2_DRV: U903.5 (IO0_1); also elsewhere on the board
/R3_TX3_DRV: U903.6 (IO0_2); also elsewhere on the board
/R3_TX4_DRV: U903.7 (IO0_3); also elsewhere on the board
/R3_TXE_DRV: U903.8 (IO0_4); also elsewhere on the board
/RLY_EN: U901.3 (~RESET), U902.3 (~RESET), U903.3 (~RESET); also elsewhere on the board
/SCL: R901.2, U901.22 (SCL), U902.22 (SCL), U903.22 (SCL); also elsewhere on the board
/SDA: R902.2, U901.23 (SDA), U902.23 (SDA), U903.23 (SDA); also elsewhere on the board
/TX_ANY: R904.1, U903.18 (IO1_5); also elsewhere on the board
GND: C901.2, C902.2, C903.2, R904.2, RN901.7 (R2.2), RN901.8 (R1.2), RN902.7 (R2.2), RN902.8 (R1.2), RN903.7 (R2.2), RN903.8 (R1.2), U901.2 (A1), U901.12 (V_{SS}), U901.21 (A0), U902.2 (A1), U902.12 (V_{SS}), U903.12 (V_{SS}), U903.21 (A0); also elsewhere on the board
unnamed: RN901.1 (R1.1), U901.19 (IO1_6)
unnamed: RN901.2 (R2.1), U901.20 (IO1_7)
unnamed: RN902.1 (R1.1), U902.19 (IO1_6)
unnamed: RN902.2 (R2.1), U902.20 (IO1_7)
unnamed: RN903.1 (R1.1), U903.19 (IO1_6)
unnamed: RN903.2 (R2.1), U903.20 (IO1_7)

Notes on the sheet:
I/O expanders (D-49, D-50): U901 0x74, U902 0x75, U903 0x76 (A1 A0 = 00, 01, 10); U1001 0x77 on the bias-T sheet (D-54). Same addresses on unit 2, which runs on its own I2C channel from the controller. Outputs drive the coil MOSFET gates (active high, 100k pull-downs at each gate), so power-on, RES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
Bus pull-ups
U901 (0x74)
U902 (0x75)
U903 (0x76)

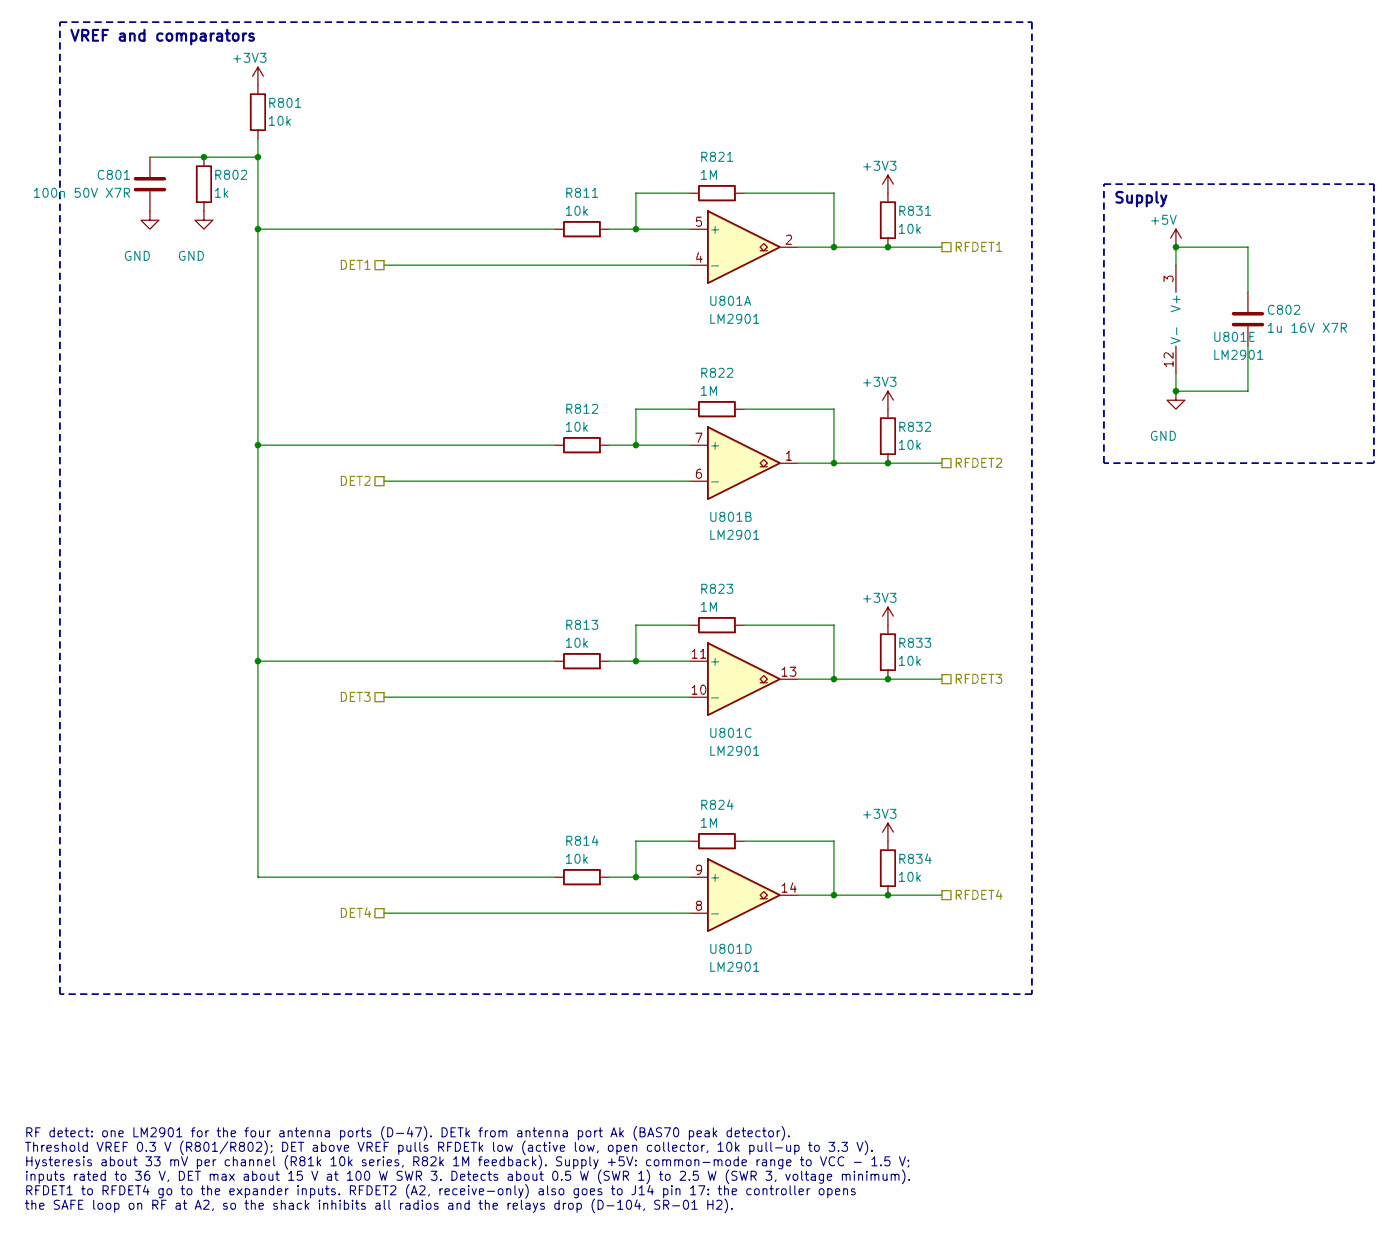
[picture p102: schematic rf_detect.kicad_sch, Unit RF board: RF detect comparators (LM2901)]

Parts:
C801: 100n 50V X7R; C_0603_1608Metric_Pad1.08x0.95mm_HandSolder
C802: 1u 16V X7R; C_0603_1608Metric_Pad1.08x0.95mm_HandSolder
R801, R811, R812, R813, R814, R831, R832, R833, R834: 10k; R_0603_1608Metric_Pad0.98x0.95mm_HandSolder
R802: 1k; R_0603_1608Metric_Pad0.98x0.95mm_HandSolder
R821, R822, R823, R824: 1M; R_0603_1608Metric_Pad0.98x0.95mm_HandSolder
U801: LM2901; SOIC-14_3.9x8.7mm_P1.27mm; MPN LM2901DR

Connections:
+3V3: R801.1, R831.1, R832.1, R833.1, R834.1; also elsewhere on the board
+5V: C802.1, U801.3 (V+); also elsewhere on the board
/A1_DET: U801.4 (-); also elsewhere on the board
/A2_DET: U801.6 (-); also elsewhere on the board
/A2_RFDET: R822.2, R832.2, U801.1; also elsewhere on the board
/A3_DET: U801.10 (-); also elsewhere on the board
/A4_DET: U801.8 (-); also elsewhere on the board
/IO expanders/A1_RFDET: R821.2, R831.2, U801.2; also elsewhere on the board
/IO expanders/A3_RFDET: R823.2, R833.2, U801.13; also elsewhere on the board
/IO expanders/A4_RFDET: R824.2, R834.2, U801.14; also elsewhere on the board
GND: C801.2, C802.2, R802.2, U801.12 (V-); also elsewhere on the board
unnamed: C801.1, R801.2, R802.1, R811.1, R812.1, R813.1, R814.1
unnamed: R811.2, R821.1, U801.5 (+)
unnamed: R812.2, R822.1, U801.7 (+)
unnamed: R813.2, R823.1, U801.11 (+)
unnamed: R814.2, R824.1, U801.9 (+)

Notes on the sheet:
RF detect: one LM2901 for the four antenna ports (D-47). DETk from antenna port Ak (BAS70 peak detector). Threshold VREF 0.3 V (R801/R802); DET above VREF pulls RFDETk low (active low, open collector, 10k pull-up to 3.3 V). Hysteresis about 33 mV per channel (R81k 10k series, R82k 1M feedback). Sup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
VREF and comparators
Supply

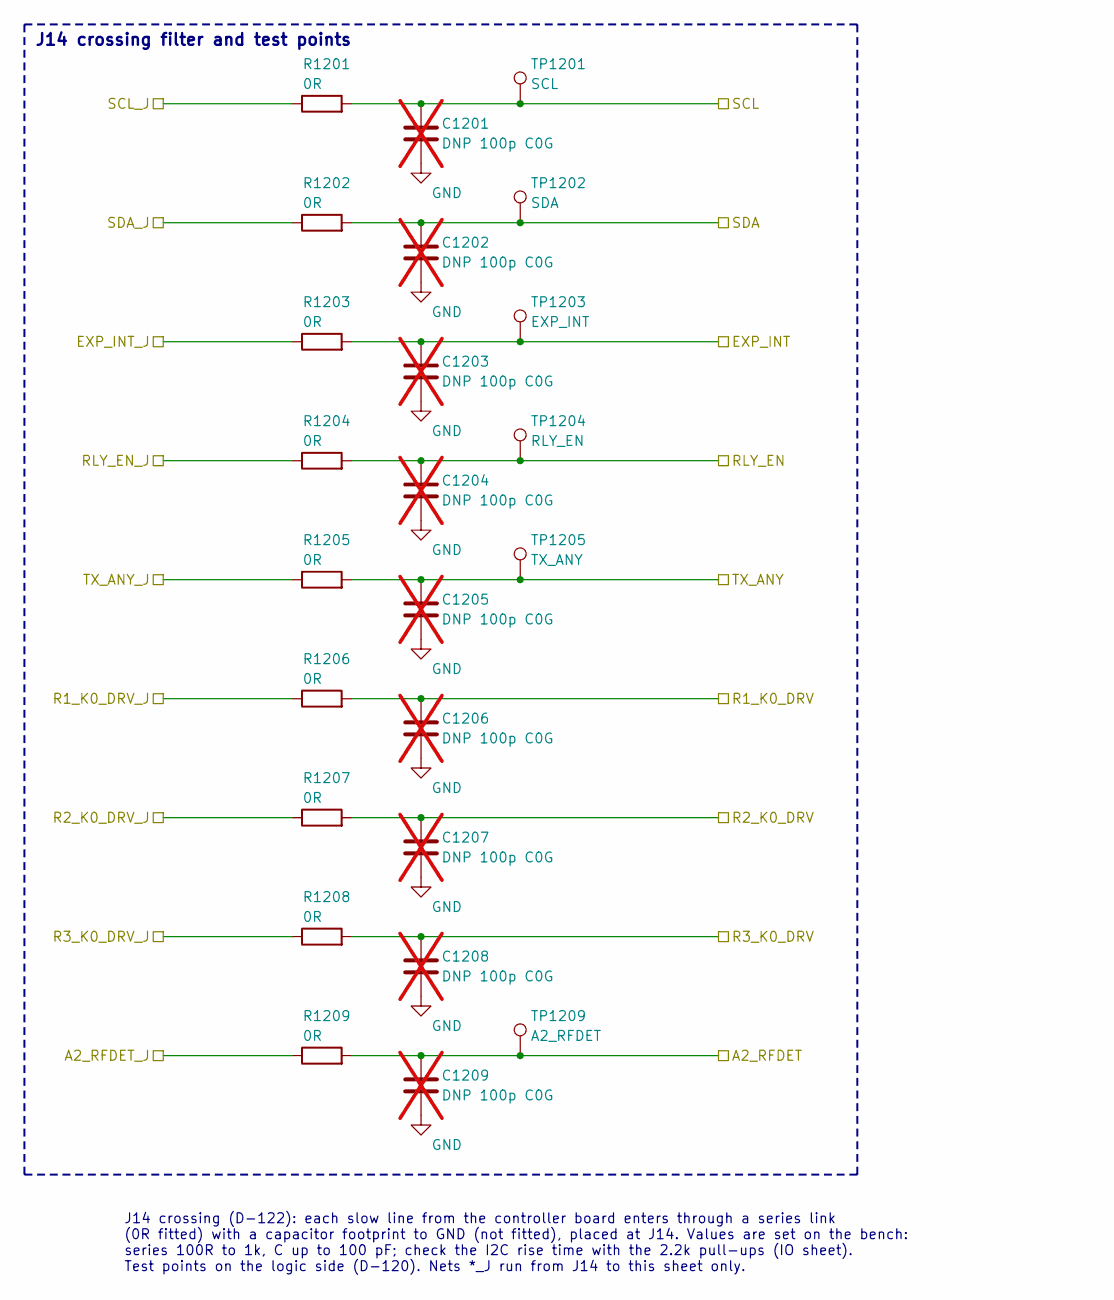
[picture p103: schematic j14_filter.kicad_sch, Unit RF board: J14 crossing filter and test points]

Parts:
C1201, C1202, C1203, C1204, C1205, C1206, C1207, C1208, C1209: DNP 100p C0G; C_0603_1608Metric_Pad1.08x0.95mm_HandSolder; not fitted
R1201, R1202, R1203, R1204, R1205, R1206, R1207, R1208, R1209: 0R; R_0603_1608Metric_Pad0.98x0.95mm_HandSolder
TP1201: SCL; TestPoint_Pad_D1.5mm
TP1202: SDA; TestPoint_Pad_D1.5mm
TP1203: EXP_INT; TestPoint_Pad_D1.5mm
TP1204: RLY_EN; TestPoint_Pad_D1.5mm
TP1205: TX_ANY; TestPoint_Pad_D1.5mm
TP1209: A2_RFDET; TestPoint_Pad_D1.5mm

Connections:
/A2_RFDET: C1209.1, R1209.2, TP1209.1; also elsewhere on the board
/A2_RFDET_J: R1209.1; also elsewhere on the board
/EXP_INT: C1203.1, R1203.2, TP1203.1; also elsewhere on the board
/EXP_INT_J: R1203.1; also elsewhere on the board
/R1_K0_DRV: C1206.1, R1206.2; also elsewhere on the board
/R1_K0_DRV_J: R1206.1; also elsewhere on the board
/R2_K0_DRV: C1207.1, R1207.2; also elsewhere on the board
/R2_K0_DRV_J: R1207.1; also elsewhere on the board
/R3_K0_DRV: C1208.1, R1208.2; also elsewhere on the board
/R3_K0_DRV_J: R1208.1; also elsewhere on the board
/RLY_EN: C1204.1, R1204.2, TP1204.1; also elsewhere on the board
/RLY_EN_J: R1204.1; also elsewhere on the board
/SCL: C1201.1, R1201.2, TP1201.1; also elsewhere on the board
/SCL_J: R1201.1; also elsewhere on the board
/SDA: C1202.1, R1202.2, TP1202.1; also elsewhere on the board
/SDA_J: R1202.1; also elsewhere on the board
/TX_ANY: C1205.1, R1205.2, TP1205.1; also elsewhere on the board
/TX_ANY_J: R1205.1; also elsewhere on the board
GND: C1201.2, C1202.2, C1203.2, C1204.2, C1205.2, C1206.2, C1207.2, C1208.2, C1209.2; also elsewhere on the board

Notes on the sheet:
J14 crossing (D-122): each slow line from the controller board enters through a series link (0R fitted) with a capacitor footprint to GND (not fitted), placed at J14. Values are set on the bench: series 100R to 1k, C up to 100 pF; check the I2C rise time with the 2.2k pull-ups (IO sheet). Test poin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
J14 crossing filter and test points

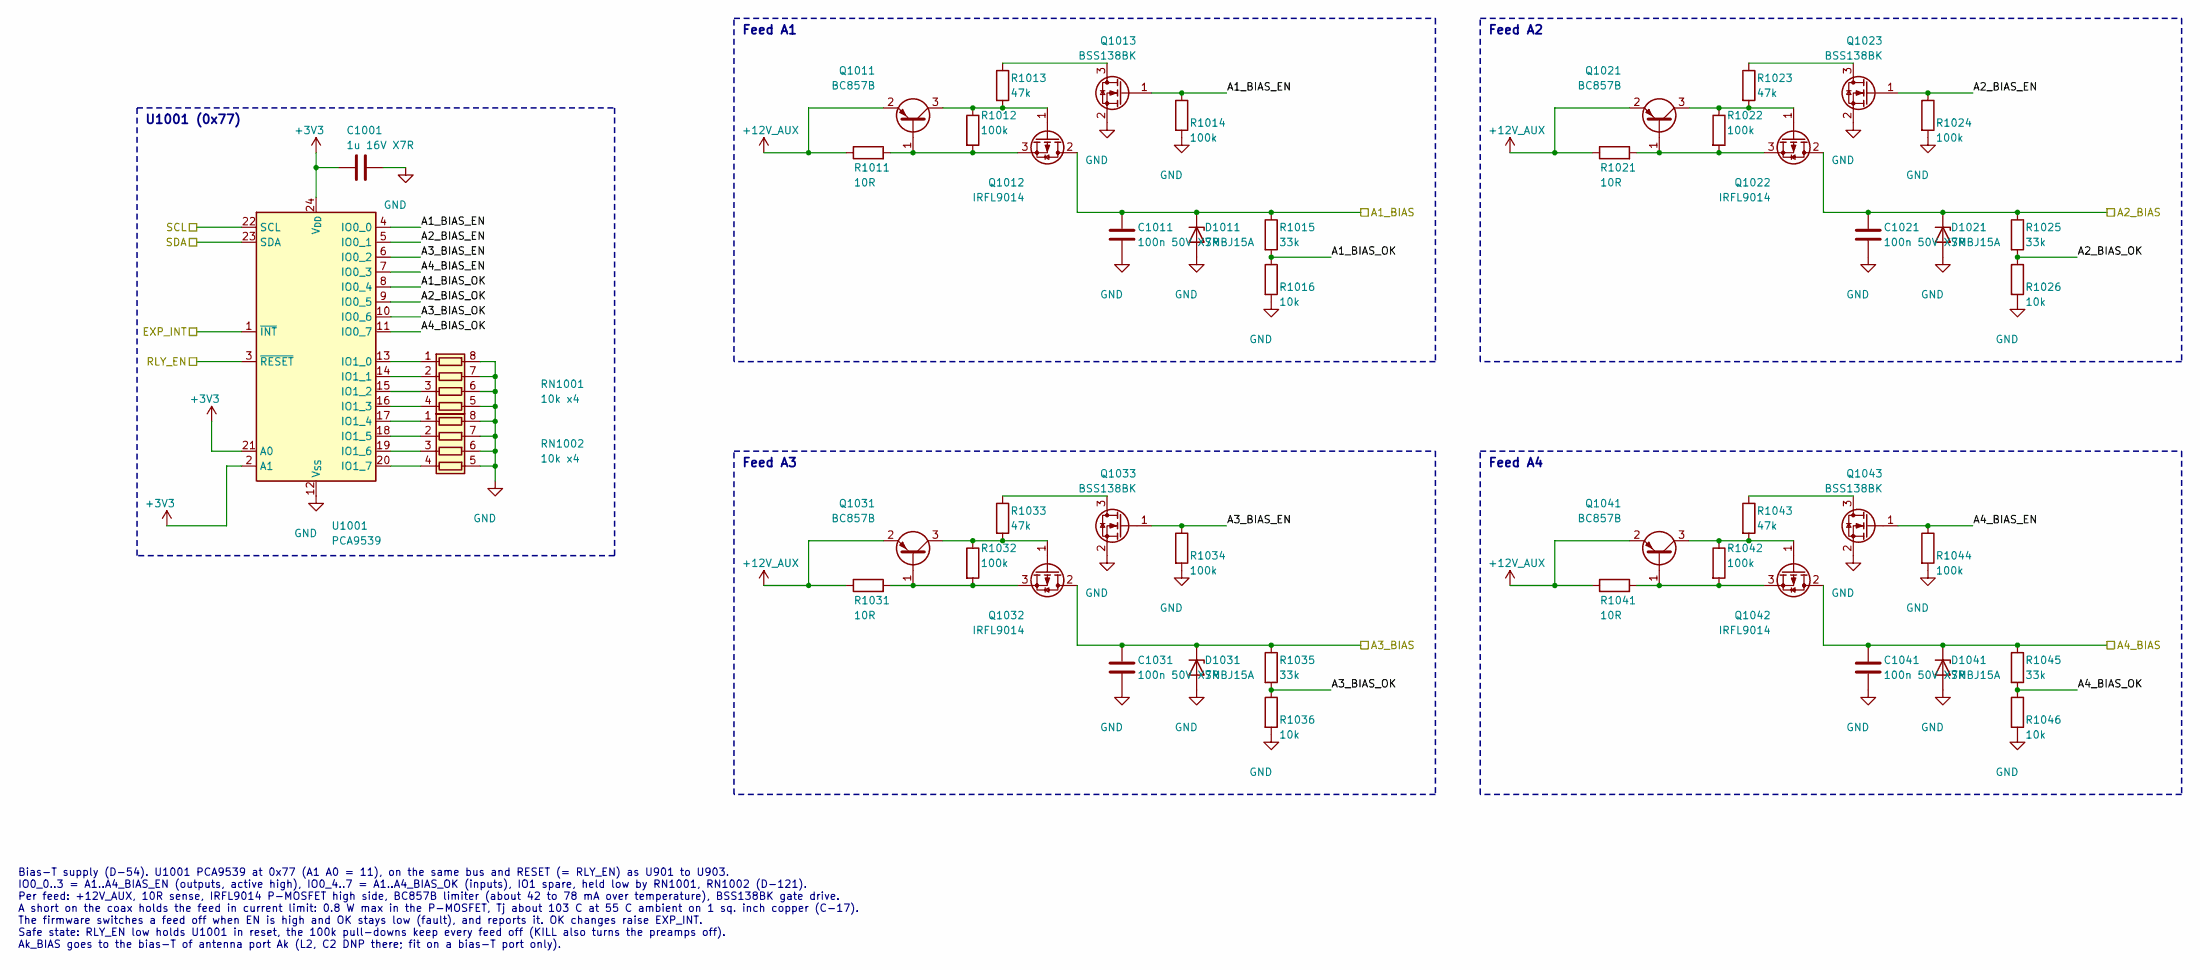
[picture p104: schematic bias_supply.kicad_sch, Unit RF board: bias-T supply (switched, current-limited)]

Parts:
C1001: 1u 16V X7R; C_0603_1608Metric_Pad1.08x0.95mm_HandSolder
C1011, C1021, C1031, C1041: 100n 50V X7R; C_0603_1608Metric_Pad1.08x0.95mm_HandSolder
D1011, D1021, D1031, D1041: SMBJ15A; D_SMB; MPN SMBJ15A
Q1011, Q1021, Q1031, Q1041: BC857B; SOT-23; MPN BC857B
Q1012, Q1022, Q1032, Q1042: IRFL9014; SOT-223-3_TabPin2; MPN IRFL9014TRPBF
Q1013, Q1023, Q1033, Q1043: BSS138BK; SOT-23; MPN BSS138BK
R1011, R1021, R1031, R1041: 10R; R_0805_2012Metric_Pad1.20x1.40mm_HandSolder
R1012, R1014, R1022, R1024, R1032, R1034, R1042, R1044: 100k; R_0603_1608Metric_Pad0.98x0.95mm_HandSolder
R1013, R1023, R1033, R1043: 47k; R_0603_1608Metric_Pad0.98x0.95mm_HandSolder
R1015, R1025, R1035, R1045: 33k; R_0603_1608Metric_Pad0.98x0.95mm_HandSolder
R1016, R1026, R1036, R1046: 10k; R_0603_1608Metric_Pad0.98x0.95mm_HandSolder
RN1001, RN1002: 10k x4; R_Array_Convex_4x0603; MPN CAT16-103J4LF
U1001: PCA9539; TSSOP-24_4.4x7.8mm_P0.65mm; MPN PCA9539PW,118

Connections:
+3V3: C1001.1, U1001.2 (A1), U1001.21 (A0), U1001.24 (V_{DD}); also elsewhere on the board
+12V_AUX: Q1011.2 (E), Q1021.2 (E), Q1031.2 (E), Q1041.2 (E), R1011.1, R1021.1, R1031.1, R1041.1; also elsewhere on the board
/A1_BIAS: C1011.1, D1011.1 (K), Q1012.2 (D), R1015.1; also elsewhere on the board
/A2_BIAS: C1021.1, D1021.1 (K), Q1022.2 (D), R1025.1; also elsewhere on the board
/A3_BIAS: C1031.1, D1031.1 (K), Q1032.2 (D), R1035.1; also elsewhere on the board
/A4_BIAS: C1041.1, D1041.1 (K), Q1042.2 (D), R1045.1; also elsewhere on the board
/Bias-T supply/A1_BIAS_EN: Q1013.1 (G), R1014.1, U1001.4 (IO0_0)
/Bias-T supply/A1_BIAS_OK: R1015.2, R1016.1, U1001.8 (IO0_4)
/Bias-T supply/A2_BIAS_EN: Q1023.1 (G), R1024.1, U1001.5 (IO0_1)
/Bias-T supply/A2_BIAS_OK: R1025.2, R1026.1, U1001.9 (IO0_5)
/Bias-T supply/A3_BIAS_EN: Q1033.1 (G), R1034.1, U1001.6 (IO0_2)
/Bias-T supply/A3_BIAS_OK: R1035.2, R1036.1, U1001.10 (IO0_6)
/Bias-T supply/A4_BIAS_EN: Q1043.1 (G), R1044.1, U1001.7 (IO0_3)
/Bias-T supply/A4_BIAS_OK: R1045.2, R1046.1, U1001.11 (IO0_7)
/EXP_INT: U1001.1 (~INT); also elsewhere on the board
/RLY_EN: U1001.3 (~RESET); also elsewhere on the board
/SCL: U1001.22 (SCL); also elsewhere on the board
/SDA: U1001.23 (SDA); also elsewhere on the board
GND: C1001.2, C1011.2, C1021.2, C1031.2, C1041.2, D1011.2 (A), D1021.2 (A), D1031.2 (A), D1041.2 (A), Q1013.2 (S), Q1023.2 (S), Q1033.2 (S), Q1043.2 (S), R1014.2, R1016.2, R1024.2, R1026.2, R1034.2, R1036.2, R1044.2, R1046.2, RN1001.5 (R4.2), RN1001.6 (R3.2), RN1001.7 (R2.2), RN1001.8 (R1.2), RN1002.5 (R4.2), RN1002.6 (R3.2), RN1002.7 (R2.2), RN1002.8 (R1.2), U1001.12 (V_{SS}); also elsewhere on the board
unnamed: Q1011.1 (B), Q1012.3 (S), R1011.2, R1012.2
unnamed: Q1011.3 (C), Q1012.1 (G), R1012.1, R1013.2
unnamed: Q1013.3 (D), R1013.1
unnamed: Q1021.1 (B), Q1022.3 (S), R1021.2, R1022.2
unnamed: Q1021.3 (C), Q1022.1 (G), R1022.1, R1023.2
unnamed: Q1023.3 (D), R1023.1
unnamed: Q1031.1 (B), Q1032.3 (S), R1031.2, R1032.2
unnamed: Q1031.3 (C), Q1032.1 (G), R1032.1, R1033.2
unnamed: Q1033.3 (D), R1033.1
unnamed: Q1041.1 (B), Q1042.3 (S), R1041.2, R1042.2
unnamed: Q1041.3 (C), Q1042.1 (G), R1042.1, R1043.2
unnamed: Q1043.3 (D), R1043.1
unnamed: RN1001.1 (R1.1), U1001.13 (IO1_0)
unnamed: RN1001.2 (R2.1), U1001.14 (IO1_1)
unnamed: RN1001.3 (R3.1), U1001.15 (IO1_2)
unnamed: RN1001.4 (R4.1), U1001.16 (IO1_3)
unnamed: RN1002.1 (R1.1), U1001.17 (IO1_4)
unnamed: RN1002.2 (R2.1), U1001.18 (IO1_5)
unnamed: RN1002.3 (R3.1), U1001.19 (IO1_6)
unnamed: RN1002.4 (R4.1), U1001.20 (IO1_7)

Notes on the sheet:
Bias-T supply (D-54). U1001 PCA9539 at 0x77 (A1 A0 = 11), on the same bus and RESET (= RLY_EN) as U901 to U903. IO0_0..3 = A1..A4_BIAS_EN (outputs, active high), IO0_4..7 = A1..A4_BIAS_OK (inputs), IO1 spare, held low by RN1001, RN1002 (D-121). Per feed: +12V_AUX, 10R sense, IRFL9014 P-MOSFET high 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
U1001 (0x77)
Feed A1
Feed A2
Feed A3
Feed A4

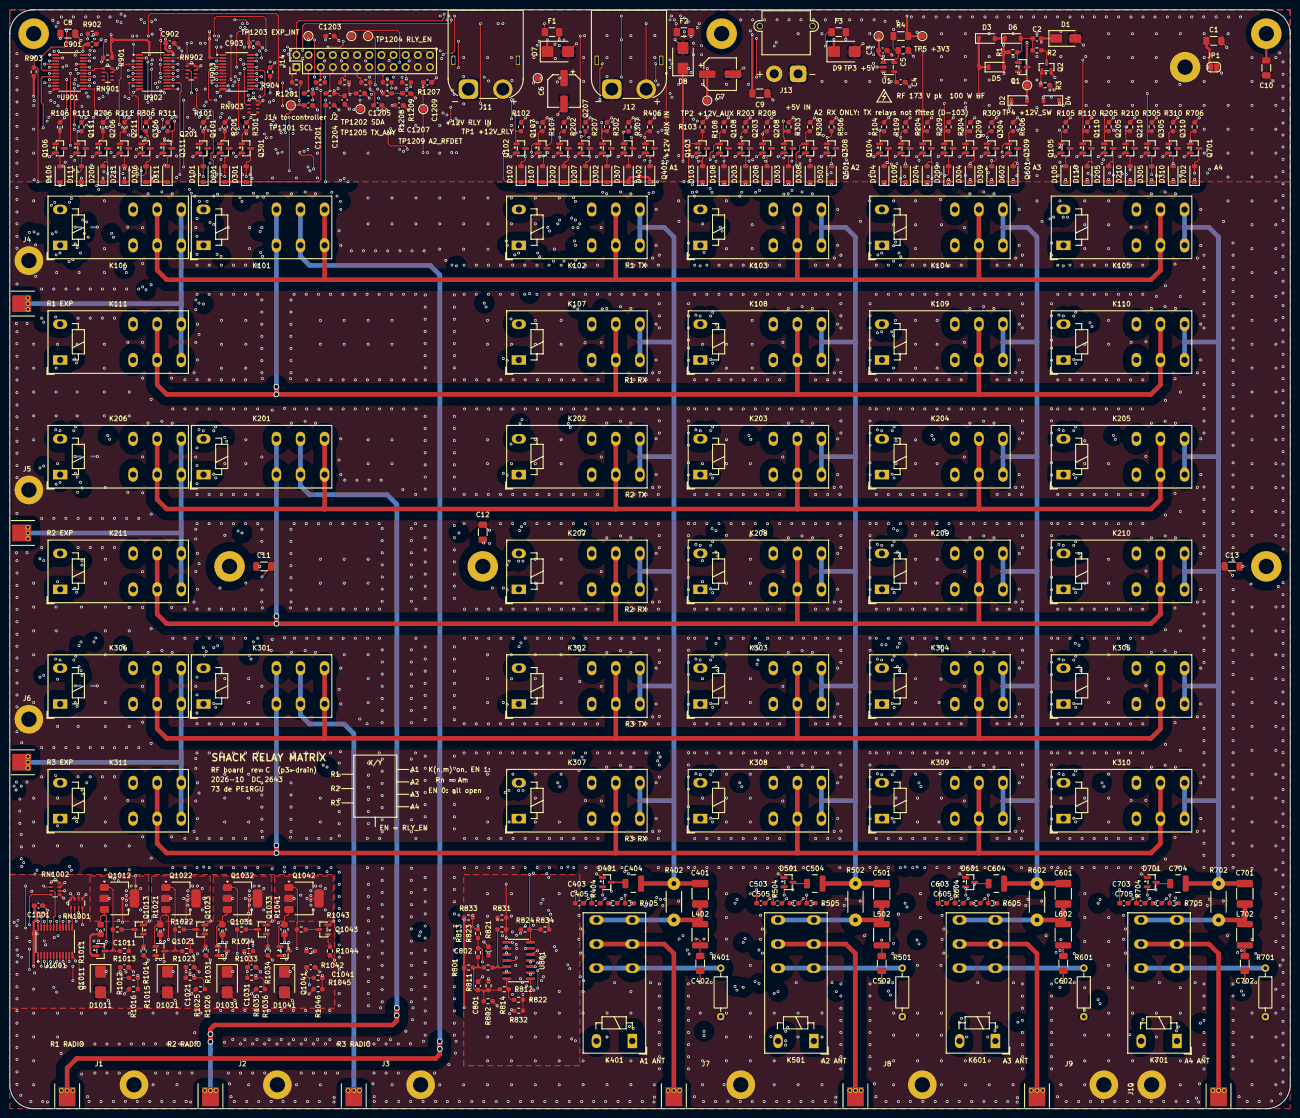
[picture p105: board rf-board.kicad_pcb from above]

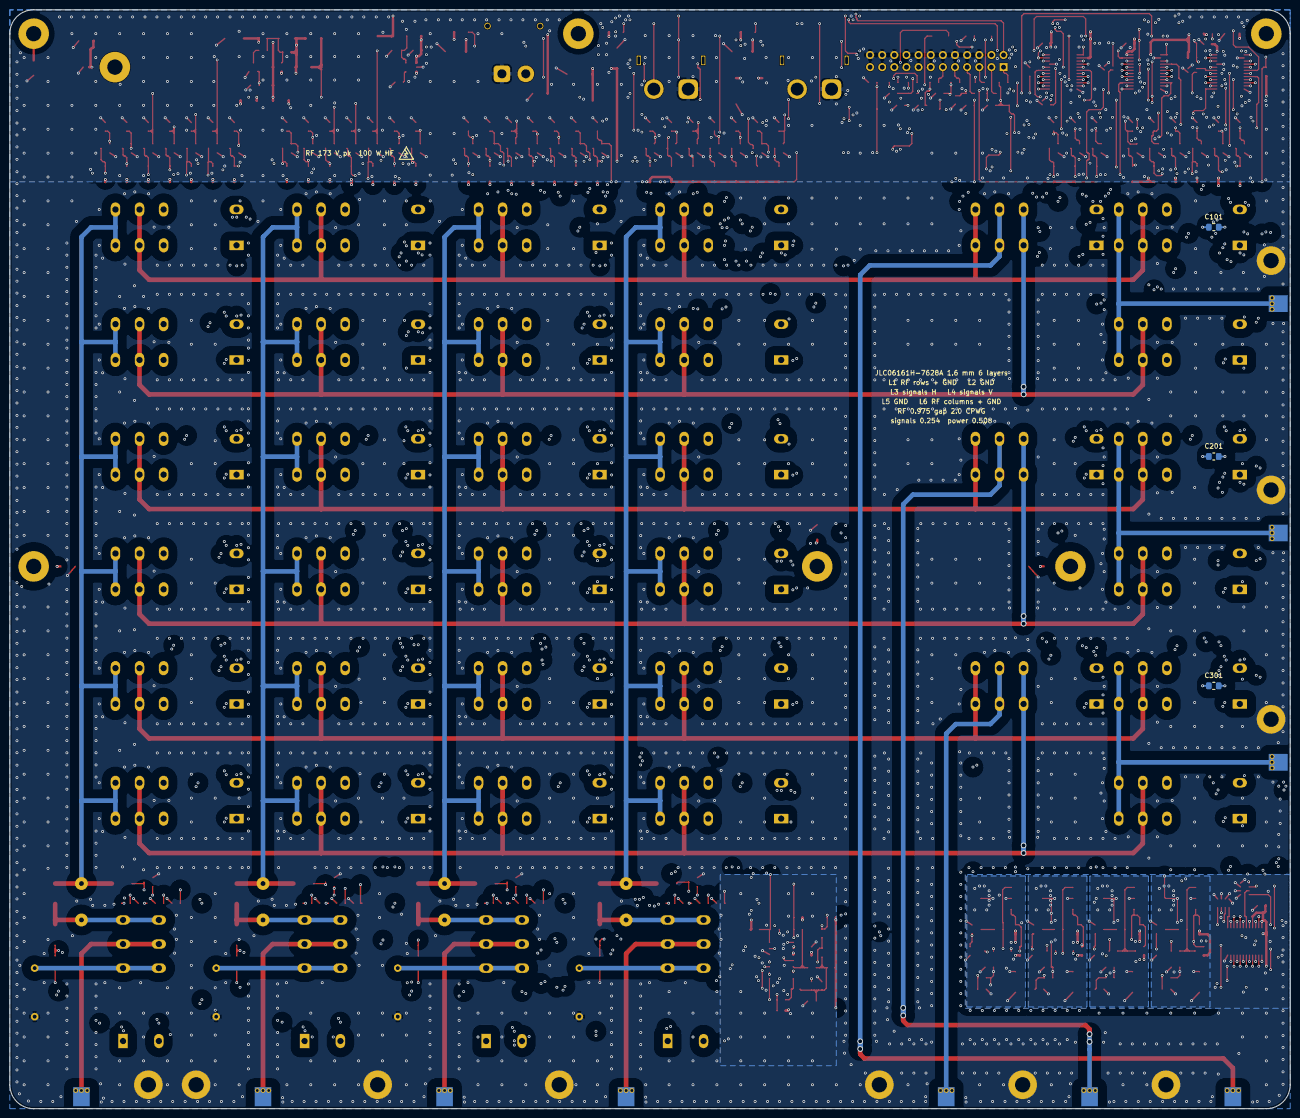
[picture p106: board rf-board.kicad_pcb from below]

Board: 6 copper layers, 268.0 x 230.0 mm, 357 parts (3 on the bottom side), 197 nets.

Other parts of the board:
CTL3D: controller board 3D (reference only)
