PE1RGU/hf-antenna-switch/hardware/unit/controller-board/controller-board.kicad_pcb

## KiCad design hardware/unit/controller-board/controller-board.kicad_pcb (2026-10-31)

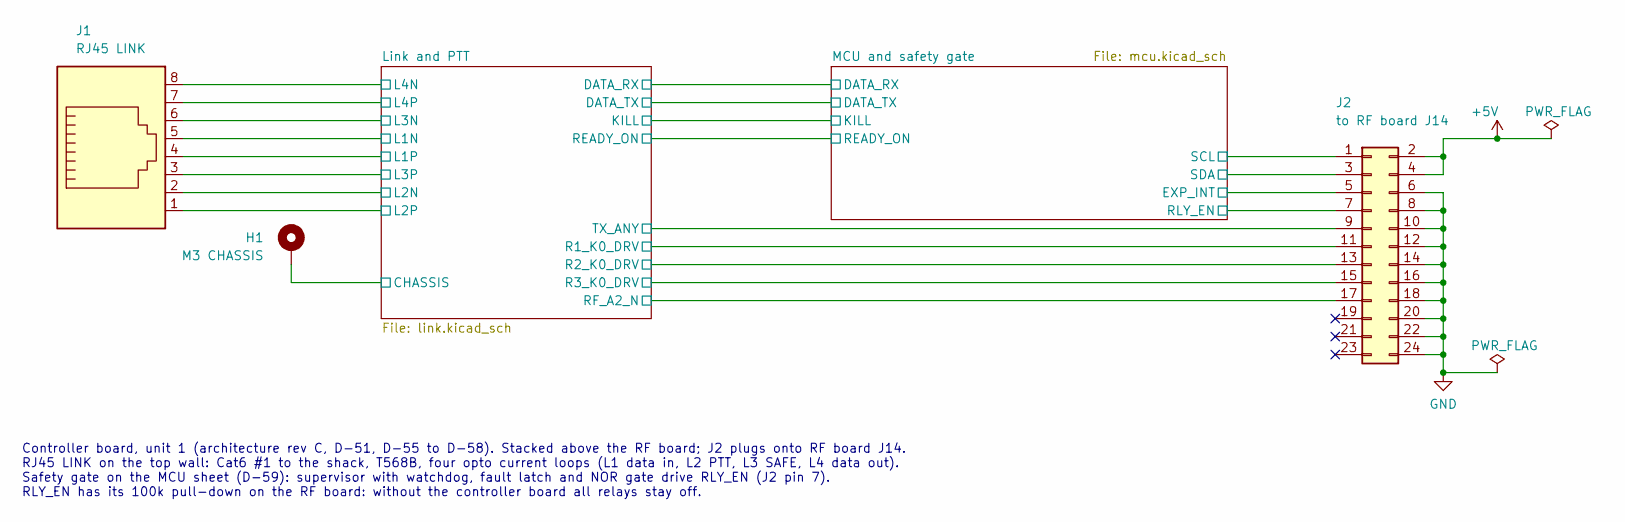
[picture p107: schematic controller-board.kicad_sch, Controller board: overview and connectors]

Parts:
H1: M3 CHASSIS; MountingHole_3.2mm_M3_Pad
J1: RJ45 LINK; RJ45_8P8C_Unshielded_TabDown; MPN 615008137121
J2: to RF board J14; PinSocket_2x12_P2.54mm_Vertical; MPN ESQ-112-33-G-D

Connections:
+5V: J2.2, J2.4; also elsewhere on the board
/Link and PTT/CHASSIS: H1.1; also elsewhere on the board
/Link and PTT/L1N: J1.5; also elsewhere on the board
/Link and PTT/L1P: J1.4; also elsewhere on the board
/Link and PTT/L2N: J1.2; also elsewhere on the board
/Link and PTT/L2P: J1.1; also elsewhere on the board
/Link and PTT/L3N: J1.6; also elsewhere on the board
/Link and PTT/L3P: J1.3; also elsewhere on the board
/Link and PTT/L4N: J1.8; also elsewhere on the board
/Link and PTT/L4P: J1.7; also elsewhere on the board
/Link and PTT/R1_K0_DRV: J2.11; also elsewhere on the board
/Link and PTT/R2_K0_DRV: J2.13; also elsewhere on the board
/Link and PTT/R3_K0_DRV: J2.15; also elsewhere on the board
/Link and PTT/RF_A2_N: J2.17; also elsewhere on the board
/Link and PTT/TX_ANY: J2.9; also elsewhere on the board
/MCU and safety gate/EXP_INT: J2.5; also elsewhere on the board
/MCU and safety gate/RLY_EN: J2.7; also elsewhere on the board
/MCU and safety gate/SCL: J2.1; also elsewhere on the board
/MCU and safety gate/SDA: J2.3; also elsewhere on the board
GND: J2.6, J2.8, J2.10, J2.12, J2.14, J2.16, J2.18, J2.20, J2.22, J2.24; also elsewhere on the board

Notes on the sheet:
Controller board, unit 1 (architecture rev C, D-51, D-55 to D-58). Stacked above the RF board; J2 plugs onto RF board J14. RJ45 LINK on the top wall: Cat6 #1 to the shack, T568B, four opto current loops (L1 data in, L2 PTT, L3 SAFE, L4 data out). Safety gate on the MCU sheet (D-59): supervisor with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
