PE1RGU/hf-antenna-switch/hardware/unit/controller-board/controller-board.kicad_pcb

## KiCad design hardware/unit/controller-board/controller-board.kicad_pcb (continued)

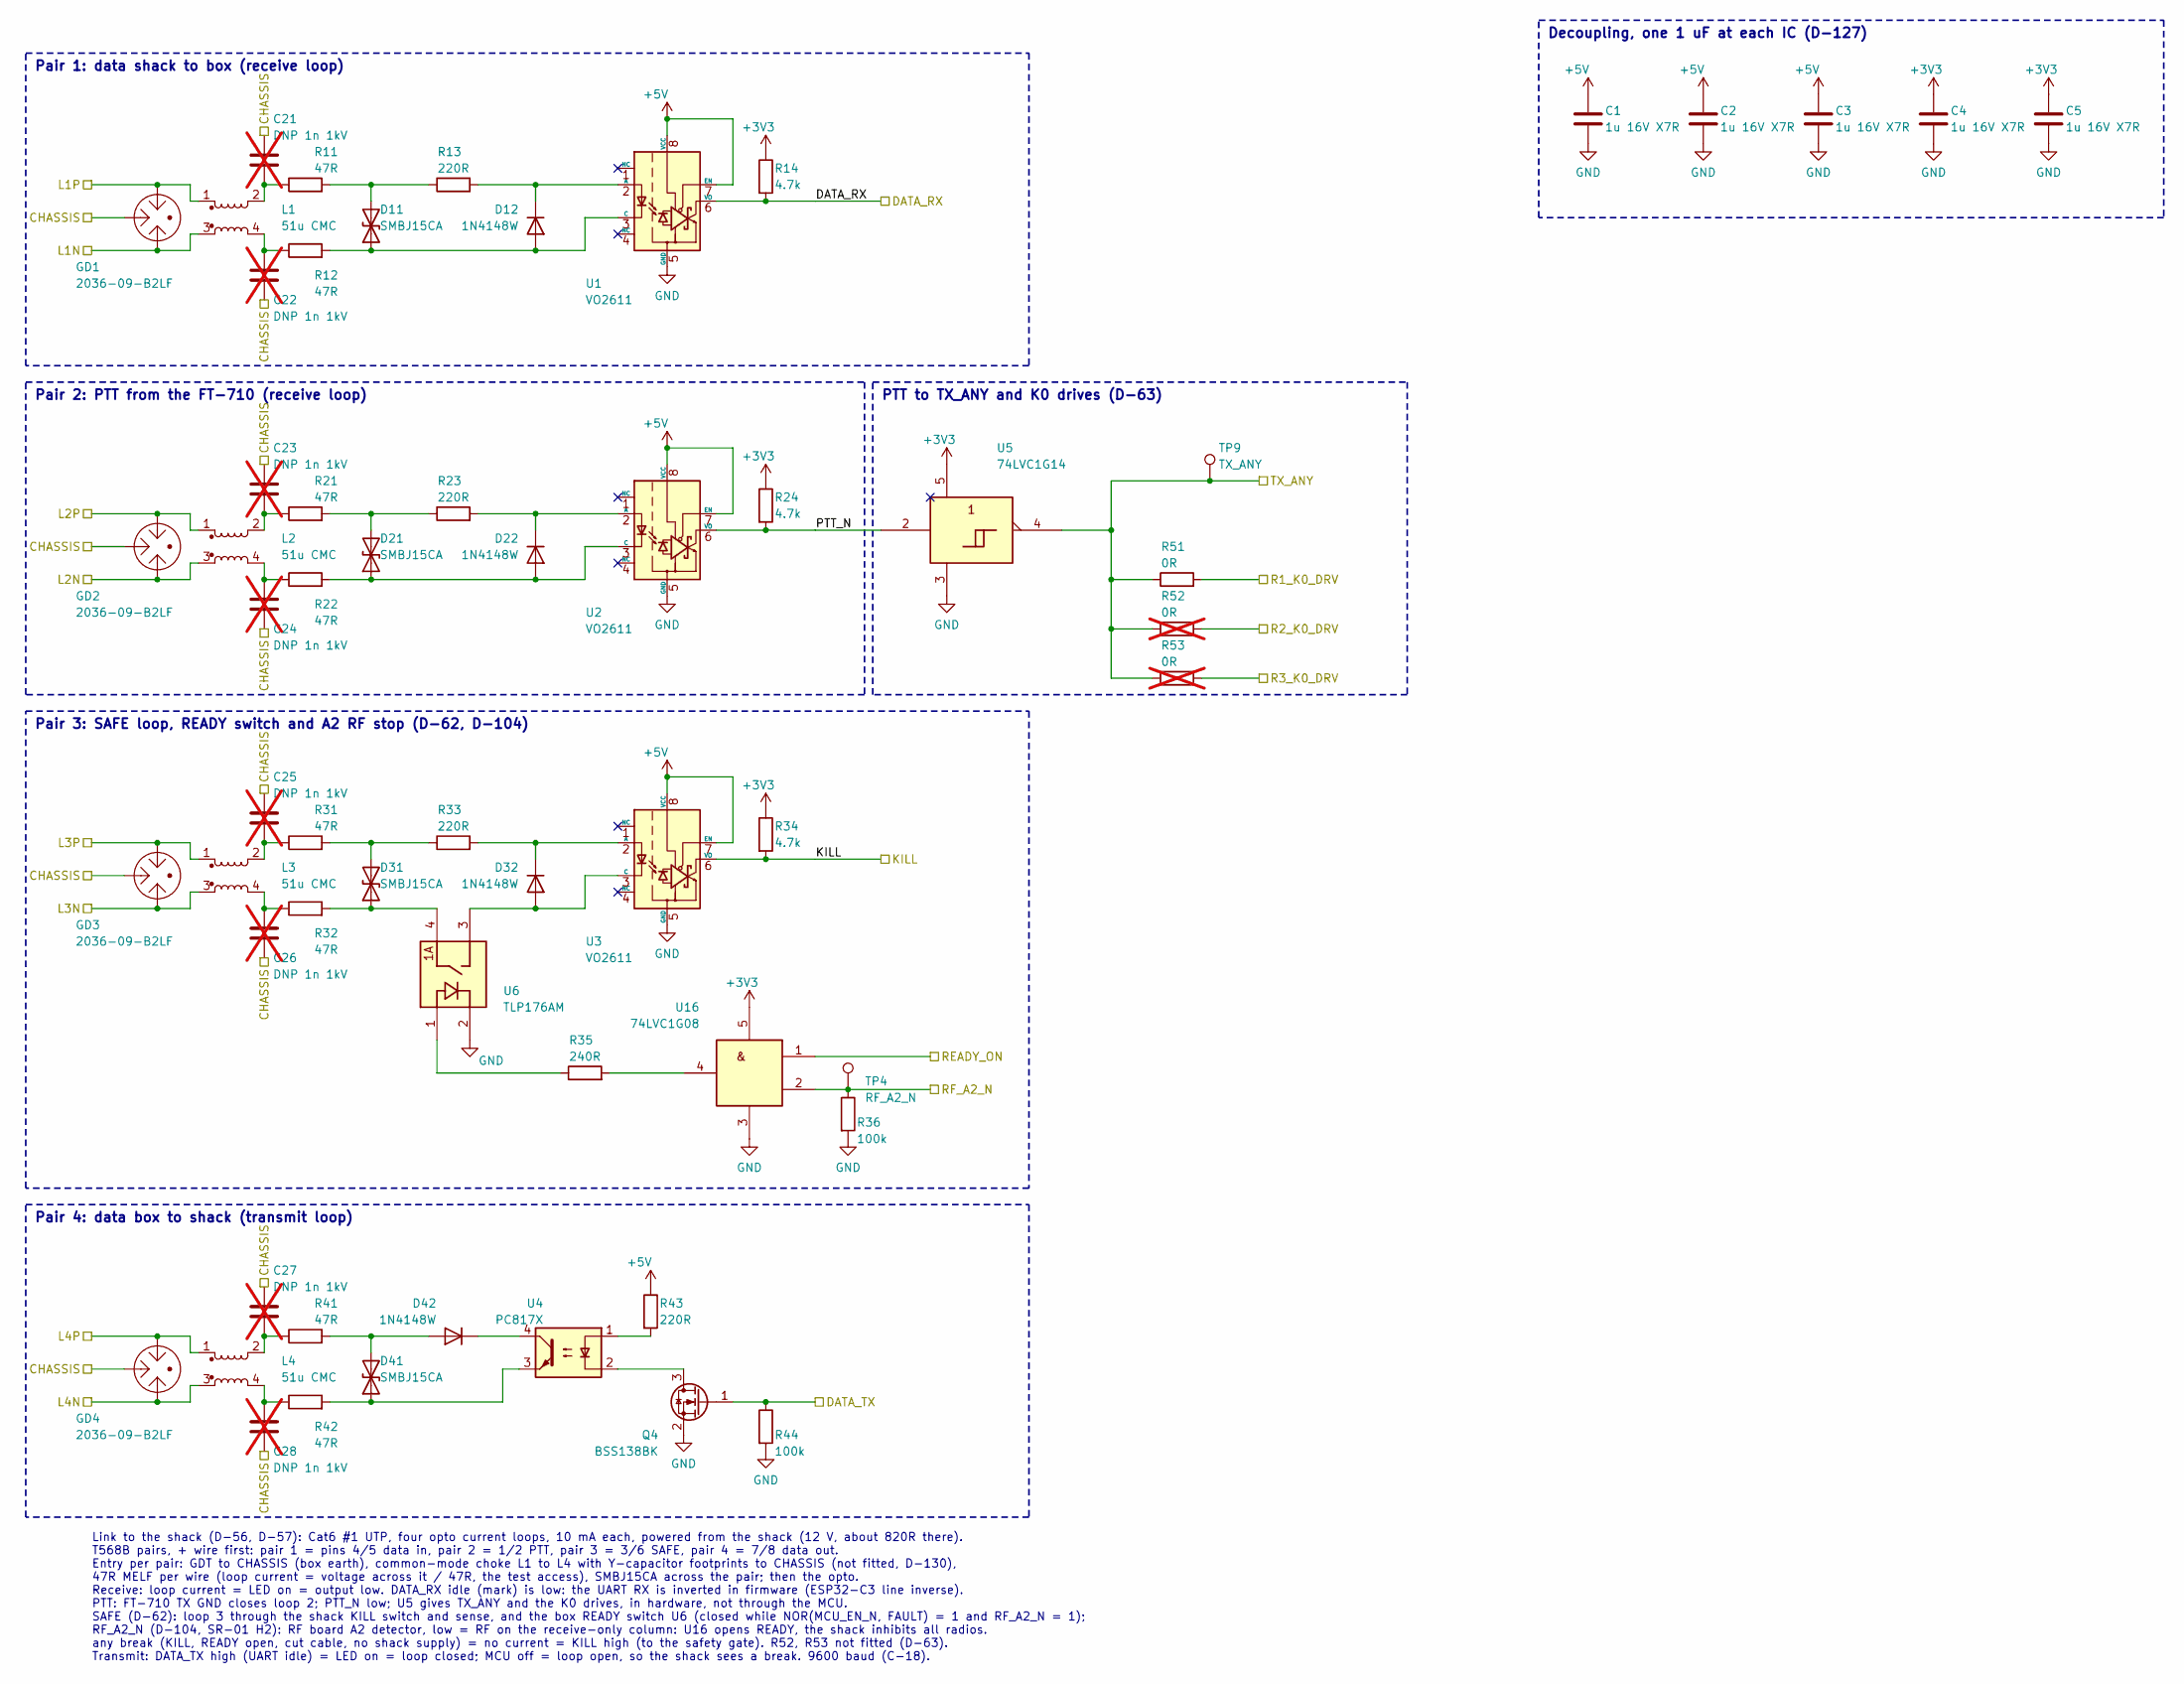
[picture p108: schematic link.kicad_sch, Controller board: link to the shack and PTT]

Parts:
C1, C2, C3, C4, C5: 1u 16V X7R; C_0603_1608Metric_Pad1.08x0.95mm_HandSolder
C21, C22, C23, C24, C25, C26, C27, C28: DNP 1n 1kV; C_1206_3216Metric_Pad1.33x1.80mm_HandSolder; not fitted
D11, D21, D31, D41: SMBJ15CA; D_SMB; MPN SMBJ15CA
D12, D22, D32, D42: 1N4148W; D_SOD-123; MPN 1N4148W
GD1, GD2, GD3, GD4: 2036-09-B2LF; GDT_3Pin_P4.40mm_Bourns-2036-B2_Littelfuse-SL1003A-R; MPN 2036-09-B2LF
L1, L2, L3, L4: 51u CMC; L_CMC_TDK_ACT45B; MPN ACT45B-510-2P-TL003
Q4: BSS138BK; SOT-23; MPN BSS138BK
R11, R12, R21, R22, R31, R32, R41, R42: 47R; R_MELF_MMB-0207
R13, R23, R33: 220R; R_MiniMELF_MMA-0204
R14, R24, R34: 4.7k; R_0603_1608Metric_Pad0.98x0.95mm_HandSolder
R35: 240R; R_0603_1608Metric_Pad0.98x0.95mm_HandSolder
R36, R44: 100k; R_0603_1608Metric_Pad0.98x0.95mm_HandSolder
R43: 220R; R_0603_1608Metric_Pad0.98x0.95mm_HandSolder
R51: 0R; R_0603_1608Metric_Pad0.98x0.95mm_HandSolder
R52, R53: 0R; R_0603_1608Metric_Pad0.98x0.95mm_HandSolder; not fitted
TP4: RF_A2_N; TestPoint_Pad_D1.5mm
TP9: TX_ANY; TestPoint_Pad_D1.5mm
U1, U2, U3: VO2611; DIP-8_W7.62mm; MPN VO2611
U4: PC817X; DIP-4_W7.62mm; MPN PC817X2NSZ9F
U5: 74LVC1G14; SOT-23-5; MPN 74LVC1G14GV
U6: TLP176AM; SOP-4_P2.54mm_PhotoRelay_LongPad; MPN TLP176AM(TPL,E)
U16: 74LVC1G08; SOT-23-5; MPN 74LVC1G08GV

Connections:
+3V3: C4.1, C5.1, R14.1, R24.1, R34.1, U5.5, U16.5; also elsewhere on the board
+5V: C1.1, C2.1, C3.1, R43.1, U1.7 (EN), U1.8 (VCC), U2.7 (EN), U2.8 (VCC), U3.7 (EN), U3.8 (VCC); also elsewhere on the board
/Link and PTT/CHASSIS: C21.1, C22.2, C23.1, C24.2, C25.1, C26.2, C27.1, C28.2, GD1.2, GD2.2, GD3.2, GD4.2; also elsewhere on the board
/Link and PTT/DATA_RX: R14.2, U1.6 (VO); also elsewhere on the board
/Link and PTT/KILL: R34.2, U3.6 (VO); also elsewhere on the board
/Link and PTT/L1N: GD1.1, L1.3; also elsewhere on the board
/Link and PTT/L1P: GD1.3, L1.1; also elsewhere on the board
/Link and PTT/L2N: GD2.1, L2.3; also elsewhere on the board
/Link and PTT/L2P: GD2.3, L2.1; also elsewhere on the board
/Link and PTT/L3N: GD3.1, L3.3; also elsewhere on the board
/Link and PTT/L3P: GD3.3, L3.1; also elsewhere on the board
/Link and PTT/L4N: GD4.1, L4.3; also elsewhere on the board
/Link and PTT/L4P: GD4.3, L4.1; also elsewhere on the board
/Link and PTT/PTT_N: R24.2, U2.6 (VO), U5.2
/Link and PTT/R1_K0_DRV: R51.2; also elsewhere on the board
/Link and PTT/R2_K0_DRV: R52.2; also elsewhere on the board
/Link and PTT/R3_K0_DRV: R53.2; also elsewhere on the board
/Link and PTT/READY_ON: U16.1; also elsewhere on the board
/Link and PTT/RF_A2_N: R36.1, TP4.1, U16.2; also elsewhere on the board
/Link and PTT/TX_ANY: R51.1, R52.1, R53.1, TP9.1, U5.4; also elsewhere on the board
/MCU and safety gate/DATA_TX: Q4.1 (G), R44.1; also elsewhere on the board
GND: C1.2, C2.2, C3.2, C4.2, C5.2, Q4.2 (S), R36.2, R44.2, U1.5 (GND), U2.5 (GND), U3.5 (GND), U5.3, U6.2, U16.3; also elsewhere on the board
unnamed: C21.2, L1.2, R11.1
unnamed: C22.1, L1.4, R12.1
unnamed: C23.2, L2.2, R21.1
unnamed: C24.1, L2.4, R22.1
unnamed: C25.2, L3.2, R31.1
unnamed: C26.1, L3.4, R32.1
unnamed: C27.2, L4.2, R41.1
unnamed: C28.1, L4.4, R42.1
unnamed: D11.1 (A1), D12.2 (A), R12.2, U1.3 (C)
unnamed: D11.2 (A2), R11.2, R13.1
unnamed: D12.1 (K), R13.2, U1.2 (A)
unnamed: D21.1 (A1), D22.2 (A), R22.2, U2.3 (C)
unnamed: D21.2 (A2), R21.2, R23.1
unnamed: D22.1 (K), R23.2, U2.2 (A)
unnamed: D31.1 (A1), R32.2, U6.4
unnamed: D31.2 (A2), R31.2, R33.1
unnamed: D32.2 (A), U3.3 (C), U6.3
unnamed: D32.1 (K), R33.2, U3.2 (A)
unnamed: D41.1 (A1), R42.2, U4.3
unnamed: D41.2 (A2), D42.2 (A), R41.2
unnamed: D42.1 (K), U4.4
unnamed: Q4.3 (D), U4.2
unnamed: R35.1, U6.1
unnamed: R35.2, U16.4
unnamed: R43.2, U4.1

Notes on the sheet:
Link to the shack (D-56, D-57): Cat6 #1 UTP, four opto current loops, 10 mA each, powered from the shack (12 V, about 820R there). T568B pairs, + wire first: pair 1 = pins 4/5 data in, pair 2 = 1/2 PTT, pair 3 = 3/6 SAFE, pair 4 = 7/8 data out. Entry per pair: GDT to CHASSIS (box earth), common-mod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
Pair 1: data shack to box (receive loop)
Pair 2: PTT from the FT-710 (receive loop)
PTT to TX_ANY and K0 drives (D-63)
Pair 3: SAFE loop, READY switch and A2 RF stop (D-62, D-104)
Pair 4: data box to shack (transmit loop)
Decoupling, one 1 uF at each IC (D-127)

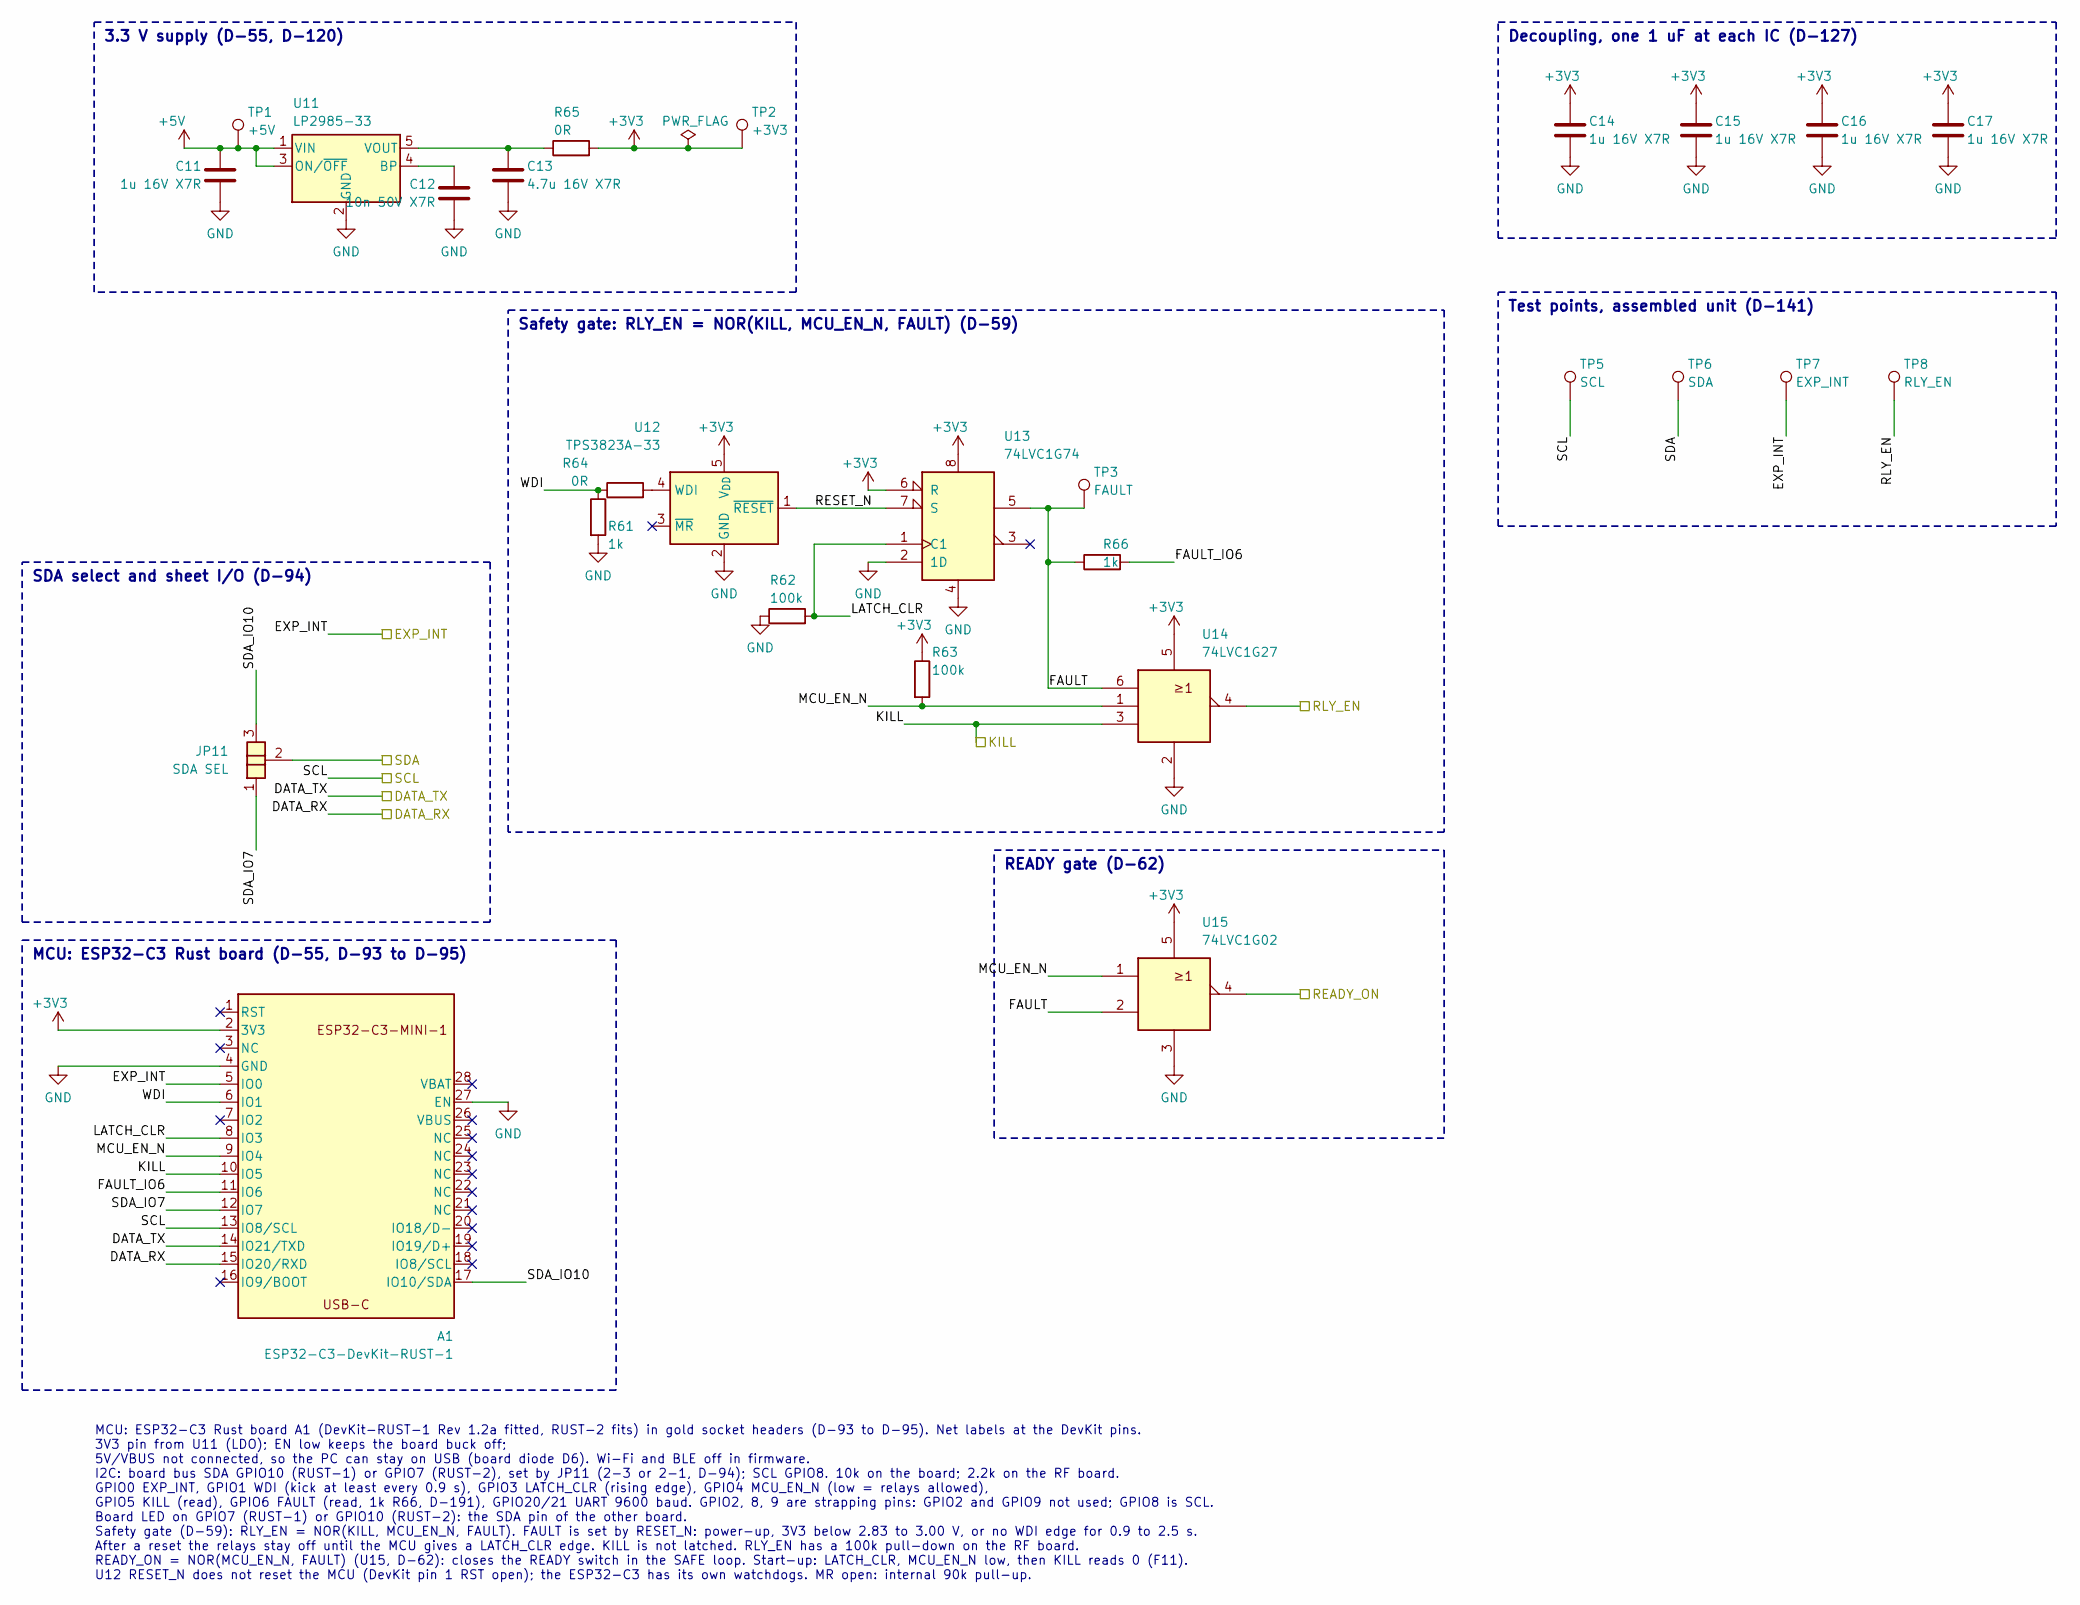
[picture p109: schematic mcu.kicad_sch, Controller board: MCU, 3.3 V and safety gate]

Parts:
A1: ESP32-C3-DevKit-RUST-1; ESP32-C3-DevKit-RUST_Socket
C11, C14, C15, C16, C17: 1u 16V X7R; C_0603_1608Metric_Pad1.08x0.95mm_HandSolder
C12: 10n 50V X7R; C_0603_1608Metric_Pad1.08x0.95mm_HandSolder
C13: 4.7u 16V X7R; C_0805_2012Metric_Pad1.18x1.45mm_HandSolder
JP11: SDA SEL; SolderJumper-3_P1.3mm_Open_RoundedPad1.0x1.5mm_NumberLabels
R61, R66: 1k; R_0603_1608Metric_Pad0.98x0.95mm_HandSolder
R62, R63: 100k; R_0603_1608Metric_Pad0.98x0.95mm_HandSolder
R64: 0R; R_0603_1608Metric_Pad0.98x0.95mm_HandSolder
R65: 0R; R_1206_3216Metric_Pad1.30x1.75mm_HandSolder
TP1: +5V; TestPoint_Pad_D1.5mm
TP2: +3V3; TestPoint_Pad_D1.5mm
TP3: FAULT; TestPoint_Pad_D1.5mm
TP5: SCL; TestPoint_Pad_D1.5mm
TP6: SDA; TestPoint_Pad_D1.5mm
TP7: EXP_INT; TestPoint_Pad_D1.5mm
TP8: RLY_EN; TestPoint_Pad_D1.5mm
U11: LP2985-33; SOT-23-5; MPN LP2985-33DBVR
U12: TPS3823A-33; SOT-23-5; MPN TPS3823A-33DBVR
U13: 74LVC1G74; VSSOP-8_2.3x2mm_P0.5mm; MPN SN74LVC1G74DCUR
U14: 74LVC1G27; SOT-23-6; MPN SN74LVC1G27DBVR
U15: 74LVC1G02; SOT-23-5; MPN 74LVC1G02GV

Connections:
+3V3: A1.2 (3V3), C14.1, C15.1, C16.1, C17.1, R63.1, R65.2, TP2.1, U12.5 (V_{DD}), U13.6 (R), U13.8, U14.5, U15.5; also elsewhere on the board
+5V: C11.1, TP1.1, U11.1 (VIN), U11.3 (ON/~OFF); also elsewhere on the board
/Link and PTT/DATA_RX: A1.15 (IO20/RXD); also elsewhere on the board
/Link and PTT/KILL: A1.10 (IO5), U14.3; also elsewhere on the board
/Link and PTT/READY_ON: U15.4; also elsewhere on the board
/MCU and safety gate/DATA_TX: A1.14 (IO21/TXD); also elsewhere on the board
/MCU and safety gate/EXP_INT: A1.5 (IO0), TP7.1; also elsewhere on the board
/MCU and safety gate/FAULT: R66.1, TP3.1, U13.5, U14.6, U15.2
/MCU and safety gate/FAULT_IO6: A1.11 (IO6), R66.2
/MCU and safety gate/LATCH_CLR: A1.8 (IO3), R62.2, U13.1 (C1)
/MCU and safety gate/MCU_EN_N: A1.9 (IO4), R63.2, U14.1, U15.1
/MCU and safety gate/RESET_N: U12.1 (~RESET), U13.7 (S)
/MCU and safety gate/RLY_EN: TP8.1, U14.4; also elsewhere on the board
/MCU and safety gate/SCL: A1.13 (IO8/SCL), TP5.1; also elsewhere on the board
/MCU and safety gate/SDA: JP11.2, TP6.1; also elsewhere on the board
/MCU and safety gate/SDA_IO7: A1.12 (IO7), JP11.1
/MCU and safety gate/SDA_IO10: A1.17 (IO10/SDA), JP11.3
/MCU and safety gate/WDI: A1.6 (IO1), R61.1, R64.1
GND: A1.4 (GND), A1.27 (EN), C11.2, C12.2, C13.2, C14.2, C15.2, C16.2, C17.2, R61.2, R62.1, U11.2 (GND), U12.2 (GND), U13.2 (1D), U13.4, U14.2, U15.3; also elsewhere on the board
unnamed: C12.1, U11.4 (BP)
unnamed: C13.1, R65.1, U11.5 (VOUT)
unnamed: R64.2, U12.4 (WDI)

Notes on the sheet:
MCU: ESP32-C3 Rust board A1 (DevKit-RUST-1 Rev 1.2a fitted, RUST-2 fits) in gold socket headers (D-93 to D-95). Net labels at the DevKit pins. 3V3 pin from U11 (LDO); EN low keeps the board buck off; 5V/VBUS not connected, so the PC can stay on USB (board diode D6). Wi-Fi and BLE off in firmware. I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
3.3 V supply (D-55, D-120)
SDA select and sheet I/O (D-94)
MCU: ESP32-C3 Rust board (D-55, D-93 to D-95)
Safety gate: RLY_EN = NOR(KILL, MCU_EN_N, FAULT) (D-59)
READY gate (D-62)
Decoupling, one 1 uF at each IC (D-127)
Test points, assembled unit (D-141)

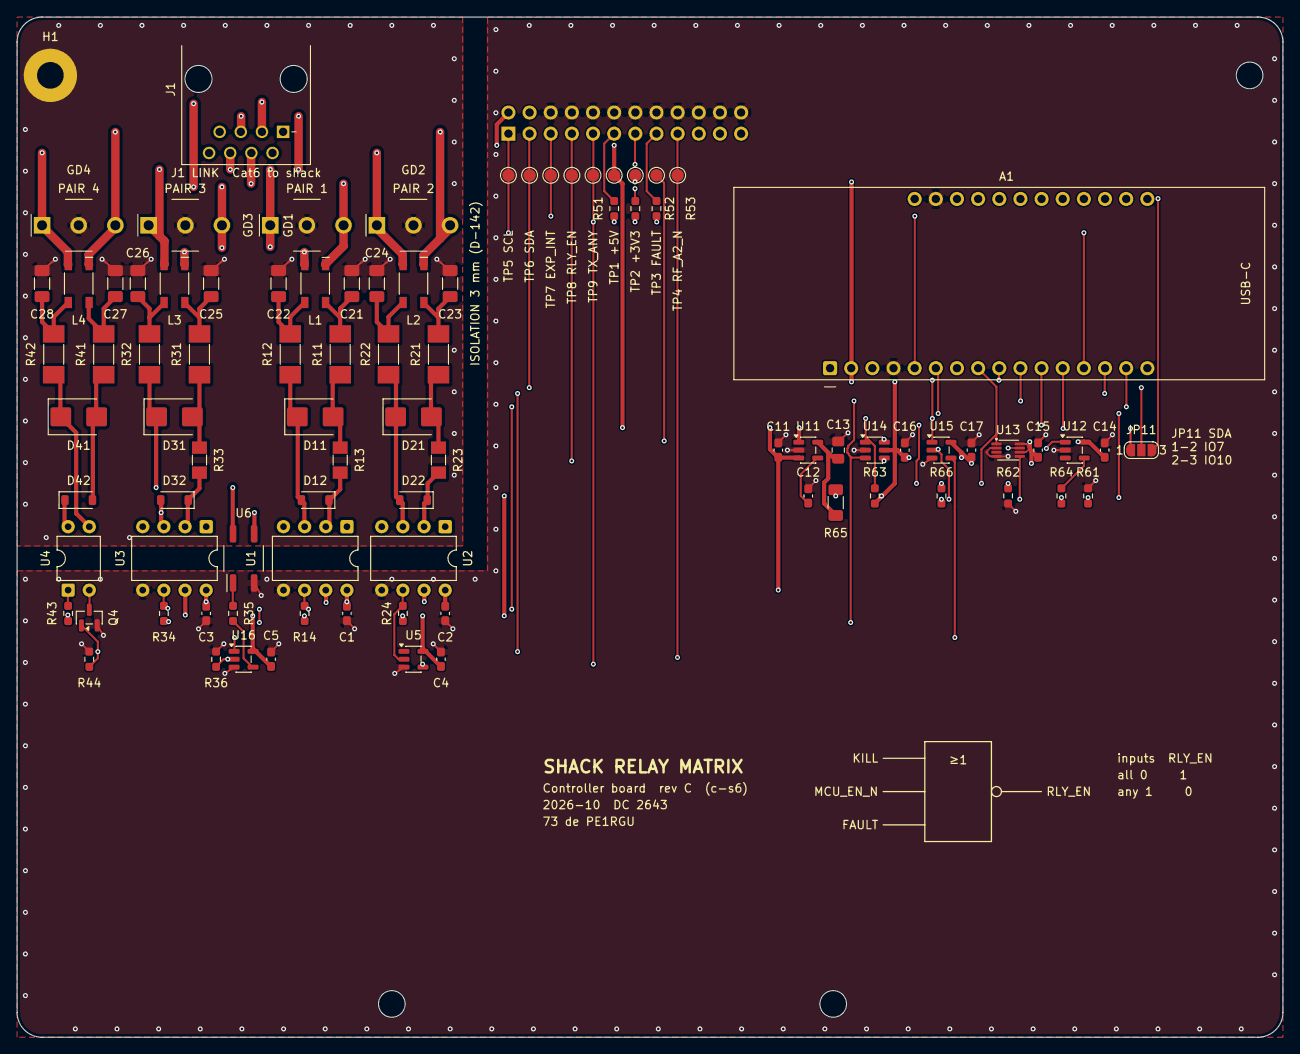
[picture p110: board controller-board.kicad_pcb from above]

Board: 4 copper layers, 152.0 x 122.5 mm, 93 parts (1 on the bottom side), 62 nets.

Other parts of the board:
H2, H3, H4: M3 NPTH; MountingHole_3.2mm_M3
