PE1RGU/hf-antenna-switch/hardware/shack-interface/shack-interface.kicad_pcb

## KiCad design hardware/shack-interface/shack-interface.kicad_pcb (2026-10-31)

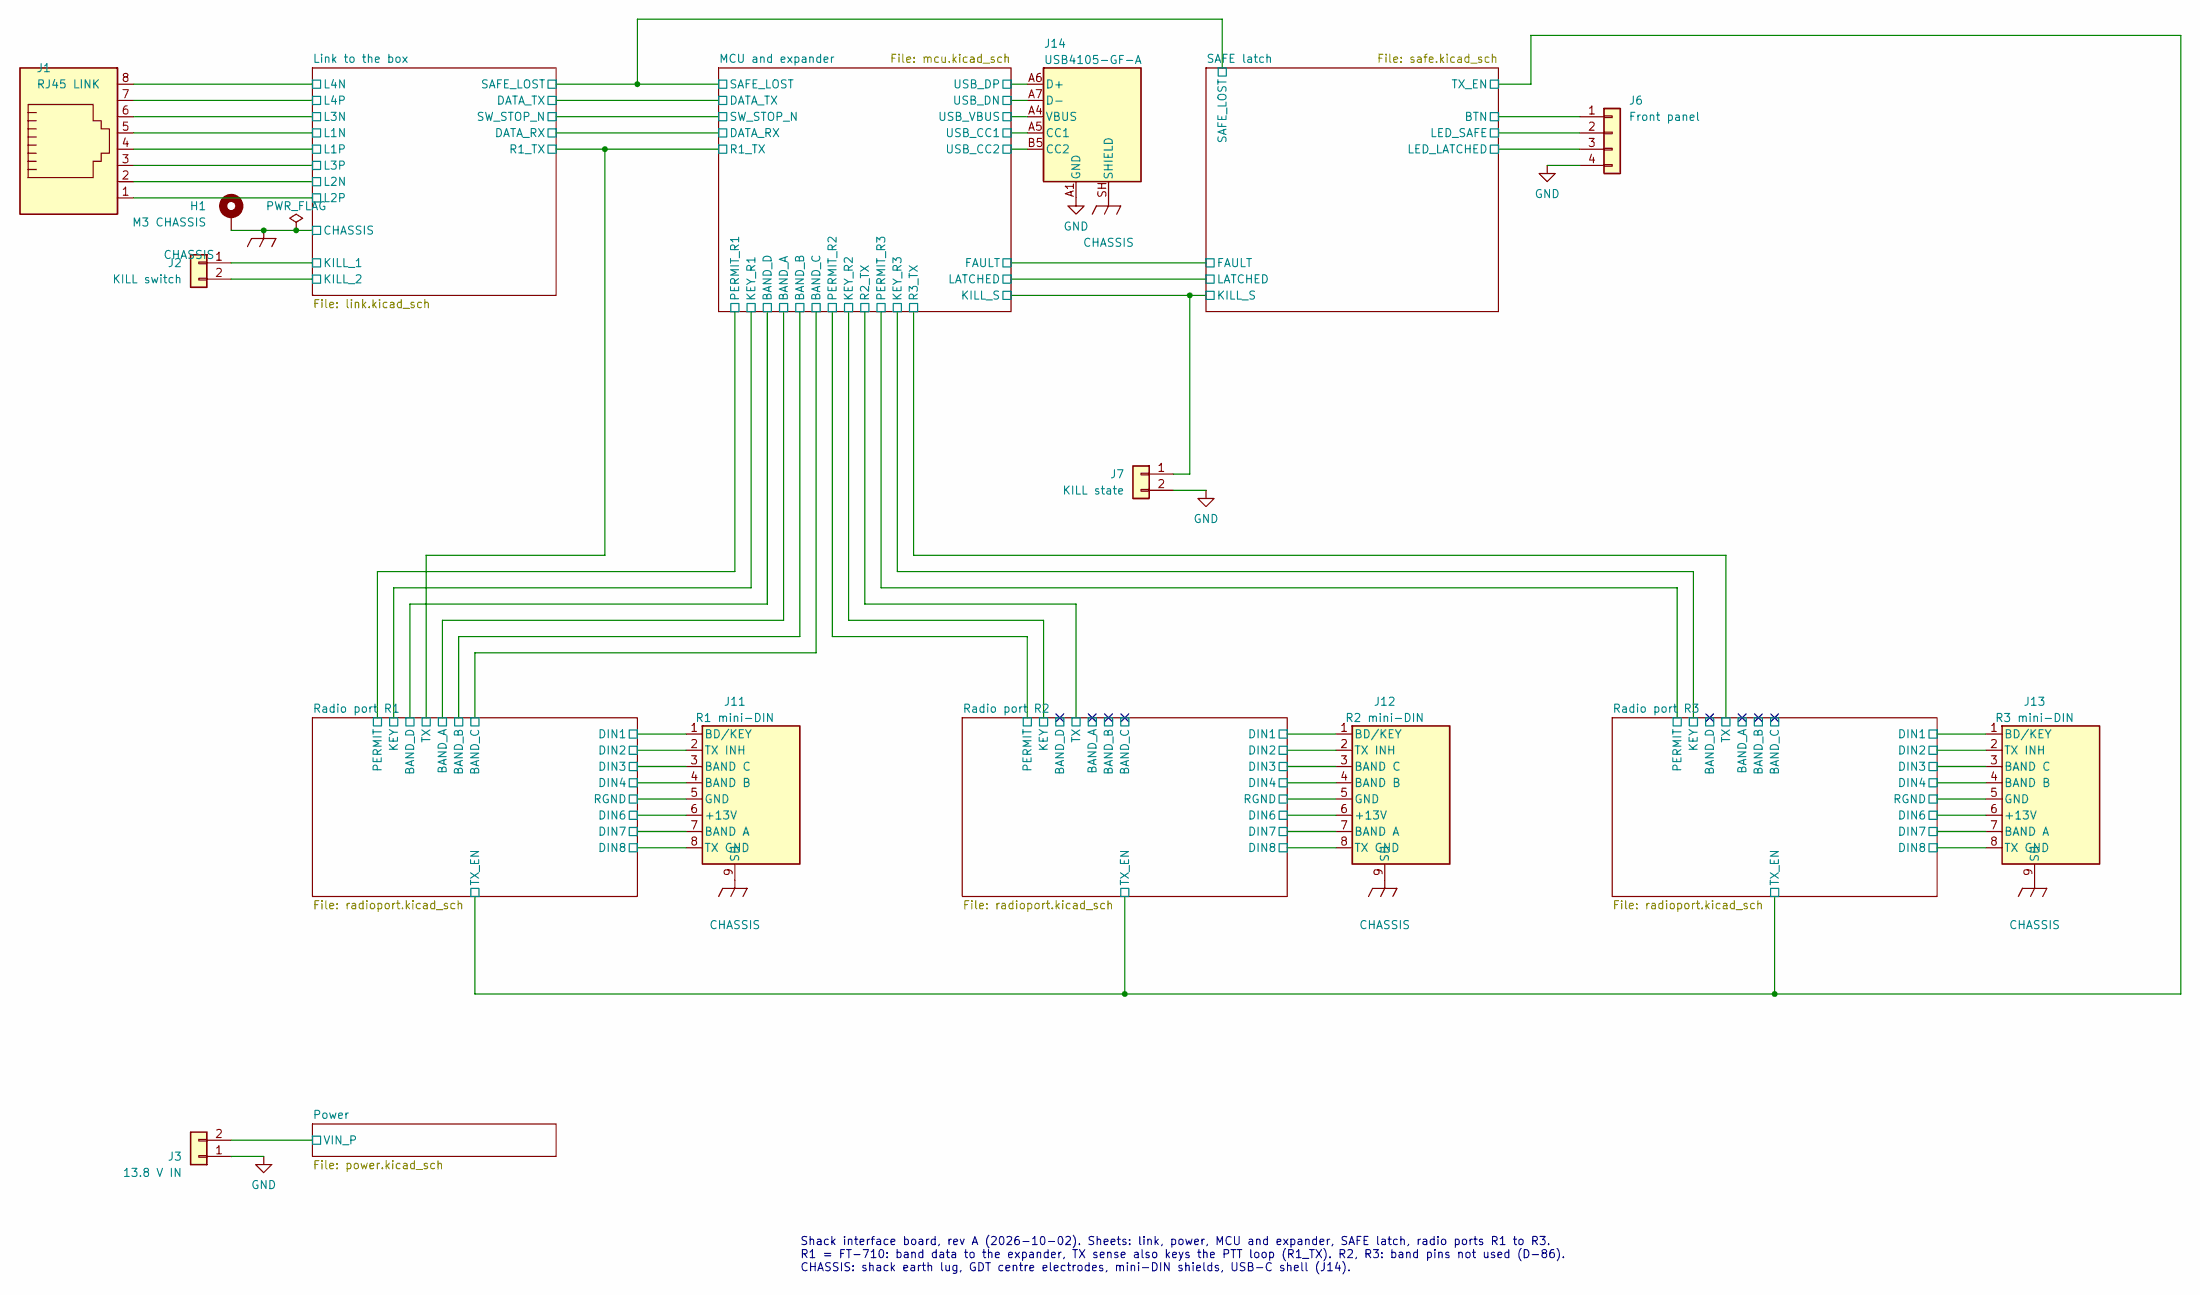
[picture p111: schematic shack-interface.kicad_sch, Shack interface: overview and connectors]

Parts:
H1: M3 CHASSIS; MountingHole_3.2mm_M3_Pad
J1: RJ45 LINK; RJ45_8P8C_Unshielded_TabDown; MPN 615008137121
J2: KILL switch; JST_XH_B2B-XH-A_1x02_P2.50mm_Vertical
J3: 13.8 V IN; AMASS_XT60PW-M_1x02_P7.20mm_Horizontal; MPN XT60PW-M
J6: Front panel; JST_XH_B4B-XH-A_1x04_P2.50mm_Vertical
J7: KILL state; JST_XH_B2B-XH-A_1x02_P2.50mm_Vertical
J11: R1 mini-DIN; MiniDIN-8_SameSky_MD-80SM_Horizontal; MPN MD-80SM
J12: R2 mini-DIN; MiniDIN-8_SameSky_MD-80SM_Horizontal; MPN MD-80SM
J13: R3 mini-DIN; MiniDIN-8_SameSky_MD-80SM_Horizontal; MPN MD-80SM
J14: USB4105-GF-A; USB_C_Receptacle_GCT_USB4105-xx-A_16P_TopMnt_Horizontal; MPN USB4105-GF-A

Connections:
/Link to the box/KILL_1: J2.1; also elsewhere on the board
/Link to the box/KILL_2: J2.2; also elsewhere on the board
/Link to the box/L1N: J1.5; also elsewhere on the board
/Link to the box/L1P: J1.4; also elsewhere on the board
/Link to the box/L2N: J1.2; also elsewhere on the board
/Link to the box/L2P: J1.1; also elsewhere on the board
/Link to the box/L3N: J1.6; also elsewhere on the board
/Link to the box/L3P: J1.3; also elsewhere on the board
/Link to the box/L4N: J1.8; also elsewhere on the board
/Link to the box/L4P: J1.7; also elsewhere on the board
/MCU and expander/KILL_S: J7.1; also elsewhere on the board
/MCU and expander/USB_CC1: J14.A5 (CC1); also elsewhere on the board
/MCU and expander/USB_CC2: J14.B5 (CC2); also elsewhere on the board
/MCU and expander/USB_DN: J14.A7 (D-), J14.B7 (D-); also elsewhere on the board
/MCU and expander/USB_DP: J14.A6 (D+), J14.B6 (D+); also elsewhere on the board
/MCU and expander/USB_VBUS: J14.A4 (VBUS), J14.A9 (VBUS), J14.B4 (VBUS), J14.B9 (VBUS); also elsewhere on the board
/Power/VIN_P: J3.2; also elsewhere on the board
/Radio port R1/DIN1: J11.1 (BD/KEY); also elsewhere on the board
/Radio port R1/DIN2: J11.2 (TX INH); also elsewhere on the board
/Radio port R1/DIN3: J11.3 (BAND C); also elsewhere on the board
/Radio port R1/DIN4: J11.4 (BAND B); also elsewhere on the board
/Radio port R1/DIN6: J11.6 (+13V); also elsewhere on the board
/Radio port R1/DIN7: J11.7 (BAND A); also elsewhere on the board
/Radio port R1/DIN8: J11.8 (TX GND); also elsewhere on the board
/Radio port R1/RGND: J11.5 (GND); also elsewhere on the board
/Radio port R2/DIN1: J12.1 (BD/KEY); also elsewhere on the board
/Radio port R2/DIN2: J12.2 (TX INH); also elsewhere on the board
/Radio port R2/DIN3: J12.3 (BAND C); also elsewhere on the board
/Radio port R2/DIN4: J12.4 (BAND B); also elsewhere on the board
/Radio port R2/DIN6: J12.6 (+13V); also elsewhere on the board
/Radio port R2/DIN7: J12.7 (BAND A); also elsewhere on the board
/Radio port R2/DIN8: J12.8 (TX GND); also elsewhere on the board
/Radio port R2/RGND: J12.5 (GND); also elsewhere on the board
/Radio port R3/DIN1: J13.1 (BD/KEY); also elsewhere on the board
/Radio port R3/DIN2: J13.2 (TX INH); also elsewhere on the board
/Radio port R3/DIN3: J13.3 (BAND C); also elsewhere on the board
/Radio port R3/DIN4: J13.4 (BAND B); also elsewhere on the board
/Radio port R3/DIN6: J13.6 (+13V); also elsewhere on the board
/Radio port R3/DIN7: J13.7 (BAND A); also elsewhere on the board
/Radio port R3/DIN8: J13.8 (TX GND); also elsewhere on the board
/Radio port R3/RGND: J13.5 (GND); also elsewhere on the board
/SAFE latch/BTN: J6.1; also elsewhere on the board
/SAFE latch/LED_LATCHED: J6.3; also elsewhere on the board
/SAFE latch/LED_SAFE: J6.2; also elsewhere on the board
CHASSIS: H1.1, J11.9 (SH), J12.9 (SH), J13.9 (SH), J14.SH (SHIELD); also elsewhere on the board
GND: J3.1, J6.4, J7.2, J14.A1 (GND), J14.A12 (GND), J14.B1 (GND), J14.B12 (GND); also elsewhere on the board

Notes on the sheet:
Shack interface board, rev A (2026-10-02). Sheets: link, power, MCU and expander, SAFE latch, radio ports R1 to R3. R1 = FT-710: band data to the expander, TX sense also keys the PTT loop (R1_TX). R2, R3: band pins not used (D-86). CHASSIS: shack earth lug, GDT centre electrodes, mini-DIN shields, 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
