PE1RGU/hf-antenna-switch/hardware/shack-interface/shack-interface.kicad_pcb

## KiCad design hardware/shack-interface/shack-interface.kicad_pcb (continued)

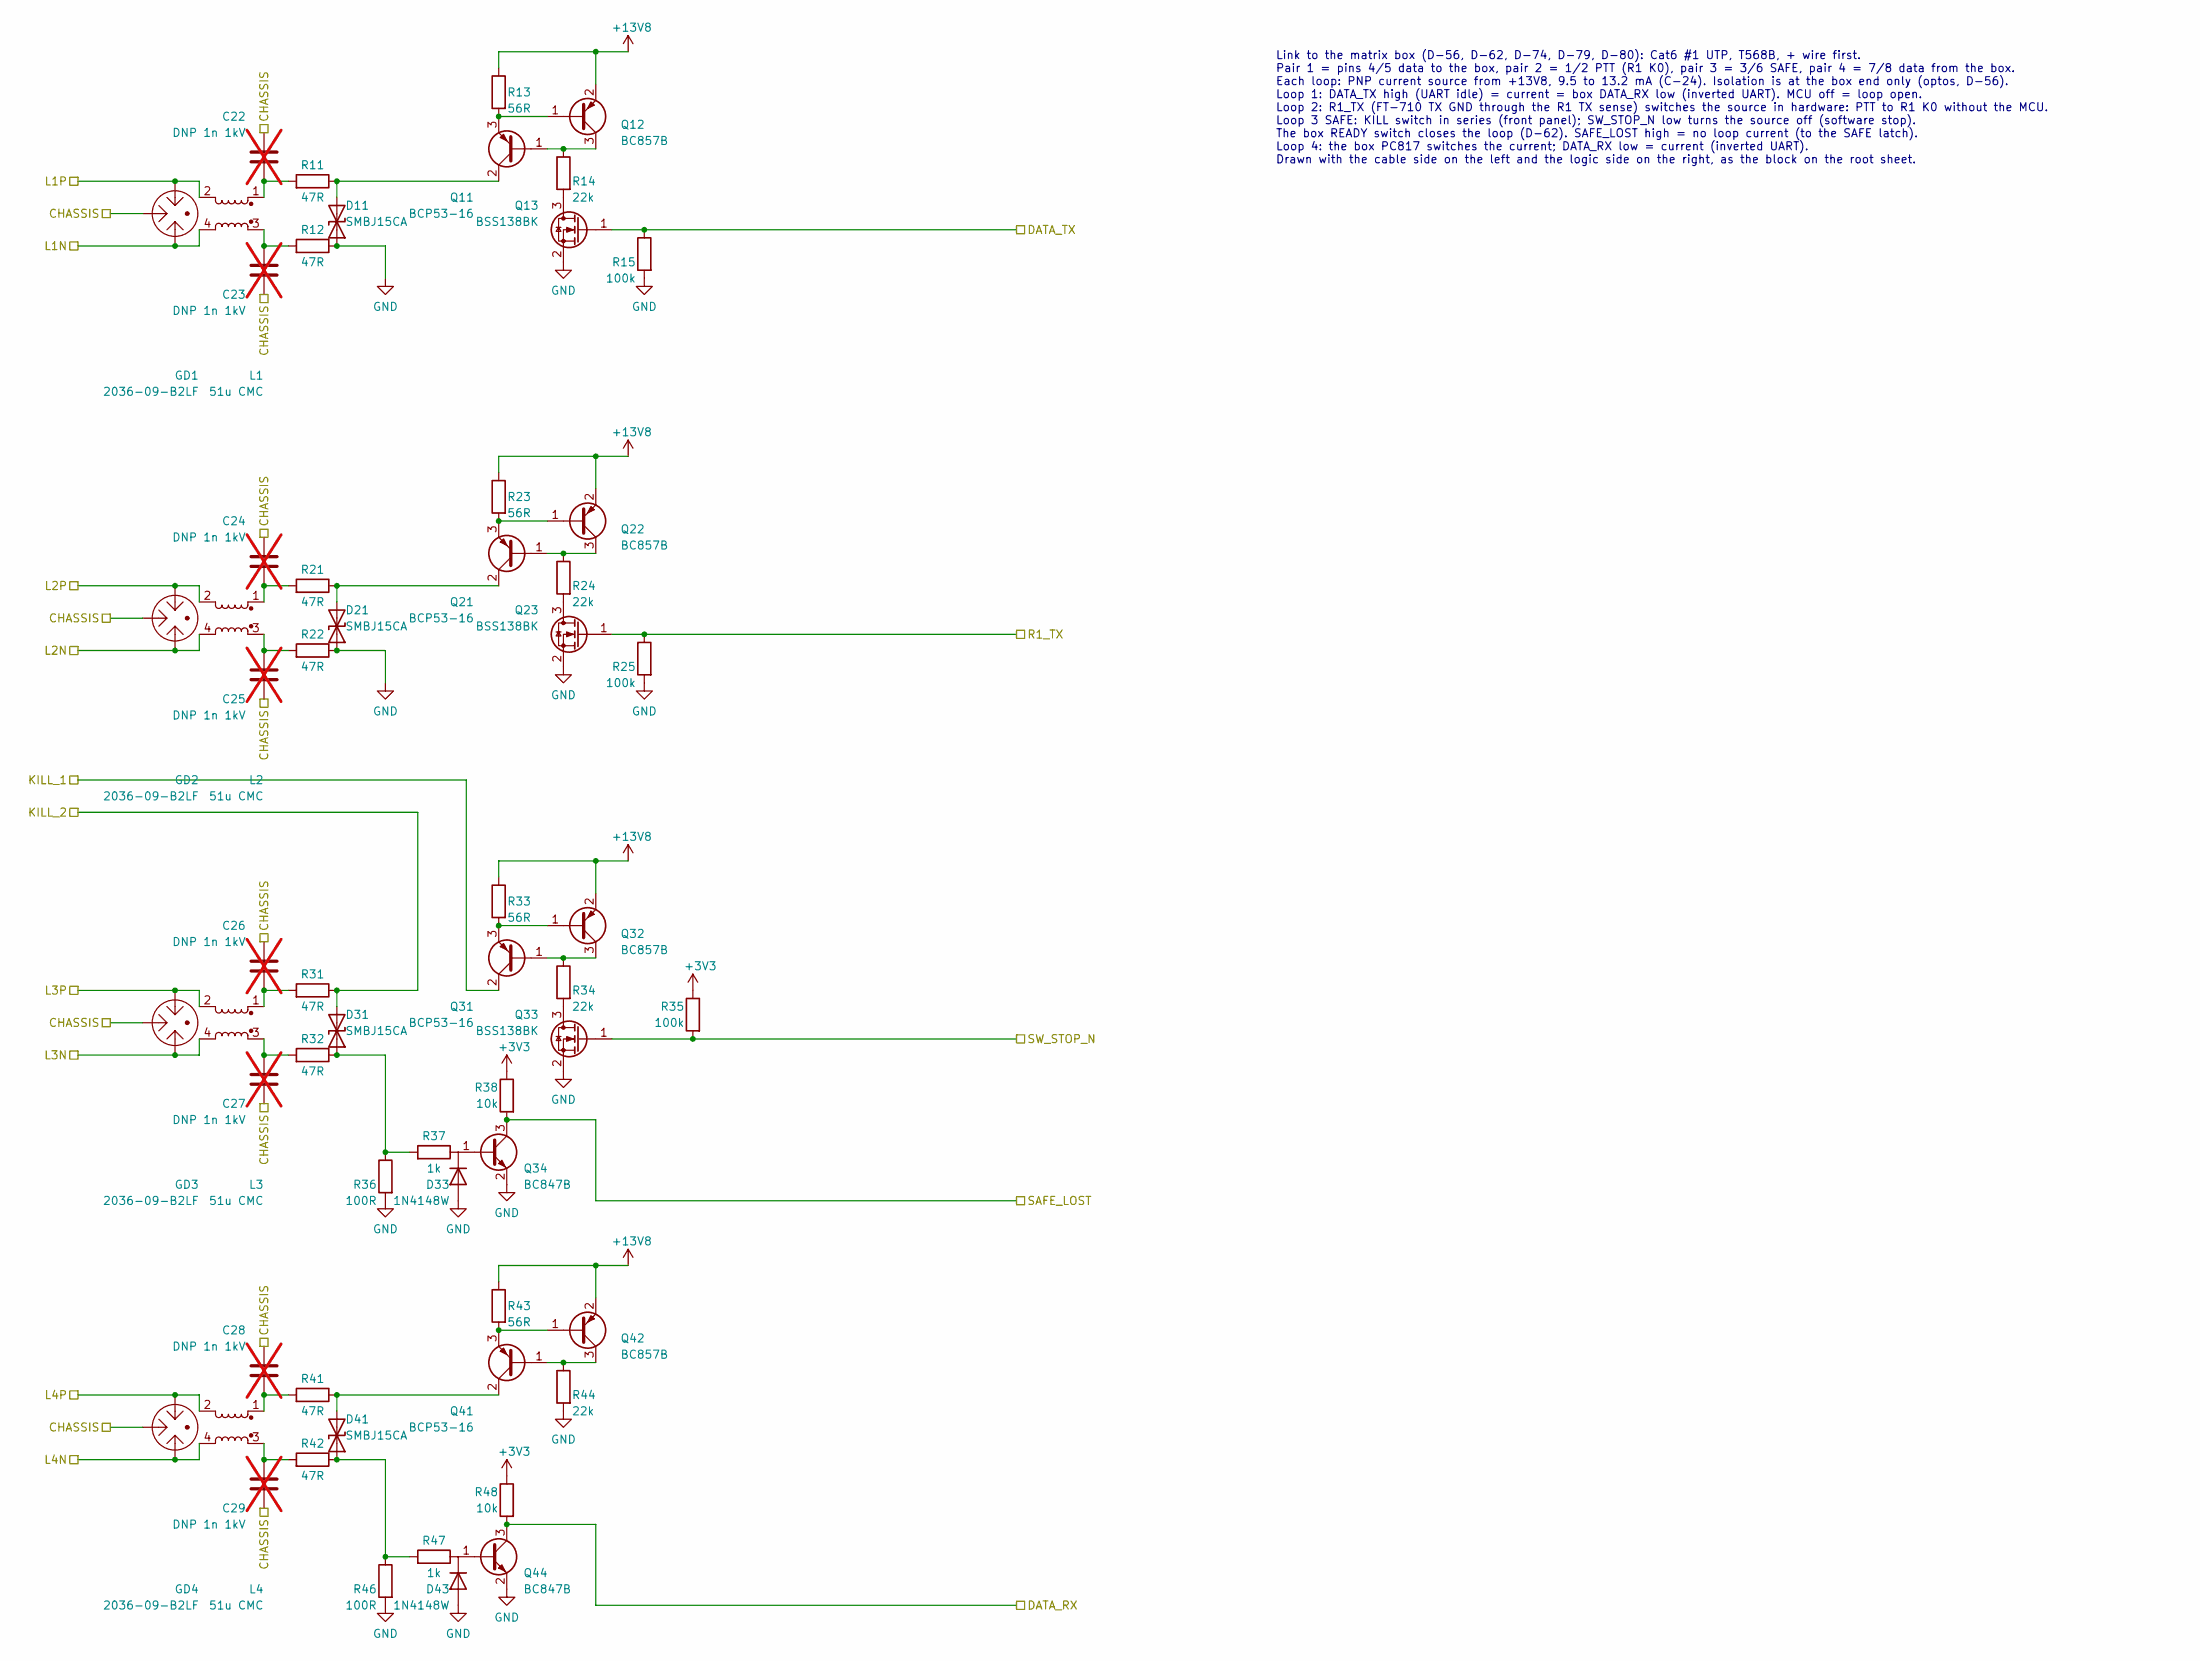
[picture p112: schematic link.kicad_sch, Shack interface: link to the matrix box]

Parts:
C22, C23, C24, C25, C26, C27, C28, C29: DNP 1n 1kV; C_1206_3216Metric_Pad1.33x1.80mm_HandSolder; not fitted
D11, D21, D31, D41: SMBJ15CA; D_SMB; MPN SMBJ15CA
D33, D43: 1N4148W; D_SOD-123; MPN 1N4148W
GD1, GD2, GD3, GD4: 2036-09-B2LF; GDT_3Pin_P4.40mm_Bourns-2036-B2_Littelfuse-SL1003A-R; MPN 2036-09-B2LF
L1, L2, L3, L4: 51u CMC; L_CMC_TDK_ACT45B; MPN ACT45B-510-2P-TL003
Q11, Q21, Q31, Q41: BCP53-16; SOT-223-3_TabPin2; MPN BCP53-16
Q12, Q22, Q32, Q42: BC857B; SOT-23; MPN BC857B
Q13, Q23, Q33: BSS138BK; SOT-23; MPN BSS138BK
Q34, Q44: BC847B; SOT-23; MPN BC847B
R11, R12, R21, R22, R31, R32, R41, R42: 47R; R_MELF_MMB-0207
R13, R23, R33, R43: 56R; R_0603_1608Metric_Pad0.98x0.95mm_HandSolder
R14, R24, R34, R44: 22k; R_0603_1608Metric_Pad0.98x0.95mm_HandSolder
R15, R25, R35: 100k; R_0603_1608Metric_Pad0.98x0.95mm_HandSolder
R36, R46: 100R; R_0603_1608Metric_Pad0.98x0.95mm_HandSolder
R37, R47: 1k; R_0603_1608Metric_Pad0.98x0.95mm_HandSolder
R38, R48: 10k; R_0603_1608Metric_Pad0.98x0.95mm_HandSolder

Connections:
+3V3: R35.1, R38.1, R48.1; also elsewhere on the board
+13V8: Q12.2 (E), Q22.2 (E), Q32.2 (E), Q42.2 (E), R13.1, R23.1, R33.1, R43.1; also elsewhere on the board
/Link to the box/KILL_1: Q31.2 (C); also elsewhere on the board
/Link to the box/KILL_2: D31.2 (A2), R31.1; also elsewhere on the board
/Link to the box/L1N: GD1.1, L1.4; also elsewhere on the board
/Link to the box/L1P: GD1.3, L1.2; also elsewhere on the board
/Link to the box/L2N: GD2.1, L2.4; also elsewhere on the board
/Link to the box/L2P: GD2.3, L2.2; also elsewhere on the board
/Link to the box/L3N: GD3.1, L3.4; also elsewhere on the board
/Link to the box/L3P: GD3.3, L3.2; also elsewhere on the board
/Link to the box/L4N: GD4.1, L4.4; also elsewhere on the board
/Link to the box/L4P: GD4.3, L4.2; also elsewhere on the board
/Link to the box/R1_TX: Q23.1 (G), R25.1; also elsewhere on the board
/Link to the box/SW_STOP_N: Q33.1 (G), R35.2; also elsewhere on the board
/MCU and expander/DATA_RX: Q44.3 (C), R48.2; also elsewhere on the board
/MCU and expander/DATA_TX: Q13.1 (G), R15.1; also elsewhere on the board
/MCU and expander/SAFE_LOST: Q34.3 (C), R38.2; also elsewhere on the board
CHASSIS: C22.1, C23.2, C24.1, C25.2, C26.1, C27.2, C28.1, C29.2, GD1.2, GD2.2, GD3.2, GD4.2; also elsewhere on the board
GND: D11.1 (A1), D21.1 (A1), D33.2 (A), D43.2 (A), Q13.2 (S), Q23.2 (S), Q33.2 (S), Q34.2 (E), Q44.2 (E), R12.1, R15.2, R22.1, R25.2, R36.2, R44.2, R46.2; also elsewhere on the board
unnamed: C22.2, L1.1, R11.2
unnamed: C23.1, L1.3, R12.2
unnamed: C24.2, L2.1, R21.2
unnamed: C25.1, L2.3, R22.2
unnamed: C26.2, L3.1, R31.2
unnamed: C27.1, L3.3, R32.2
unnamed: C28.2, L4.1, R41.2
unnamed: C29.1, L4.3, R42.2
unnamed: D11.2 (A2), Q11.2 (C), R11.1
unnamed: D21.2 (A2), Q21.2 (C), R21.1
unnamed: D31.1 (A1), R32.1, R36.1, R37.2
unnamed: D33.1 (K), Q34.1 (B), R37.1
unnamed: D41.1 (A1), R42.1, R46.1, R47.2
unnamed: D41.2 (A2), Q41.2 (C), R41.1
unnamed: D43.1 (K), Q44.1 (B), R47.1
unnamed: Q11.1 (B), Q12.3 (C), R14.1
unnamed: Q11.3 (E), Q12.1 (B), R13.2
unnamed: Q13.3 (D), R14.2
unnamed: Q21.1 (B), Q22.3 (C), R24.1
unnamed: Q21.3 (E), Q22.1 (B), R23.2
unnamed: Q23.3 (D), R24.2
unnamed: Q31.1 (B), Q32.3 (C), R34.1
unnamed: Q31.3 (E), Q32.1 (B), R33.2
unnamed: Q33.3 (D), R34.2
unnamed: Q41.1 (B), Q42.3 (C), R44.1
unnamed: Q41.3 (E), Q42.1 (B), R43.2

Notes on the sheet:
Link to the matrix box (D-56, D-62, D-74, D-79, D-80): Cat6 #1 UTP, T568B, + wire first. Pair 1 = pins 4/5 data to the box, pair 2 = 1/2 PTT (R1 K0), pair 3 = 3/6 SAFE, pair 4 = 7/8 data from the box. Each loop: PNP current source from +13V8, 9.5 to 13.2 mA (C-24). Isolation is at the box end only 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

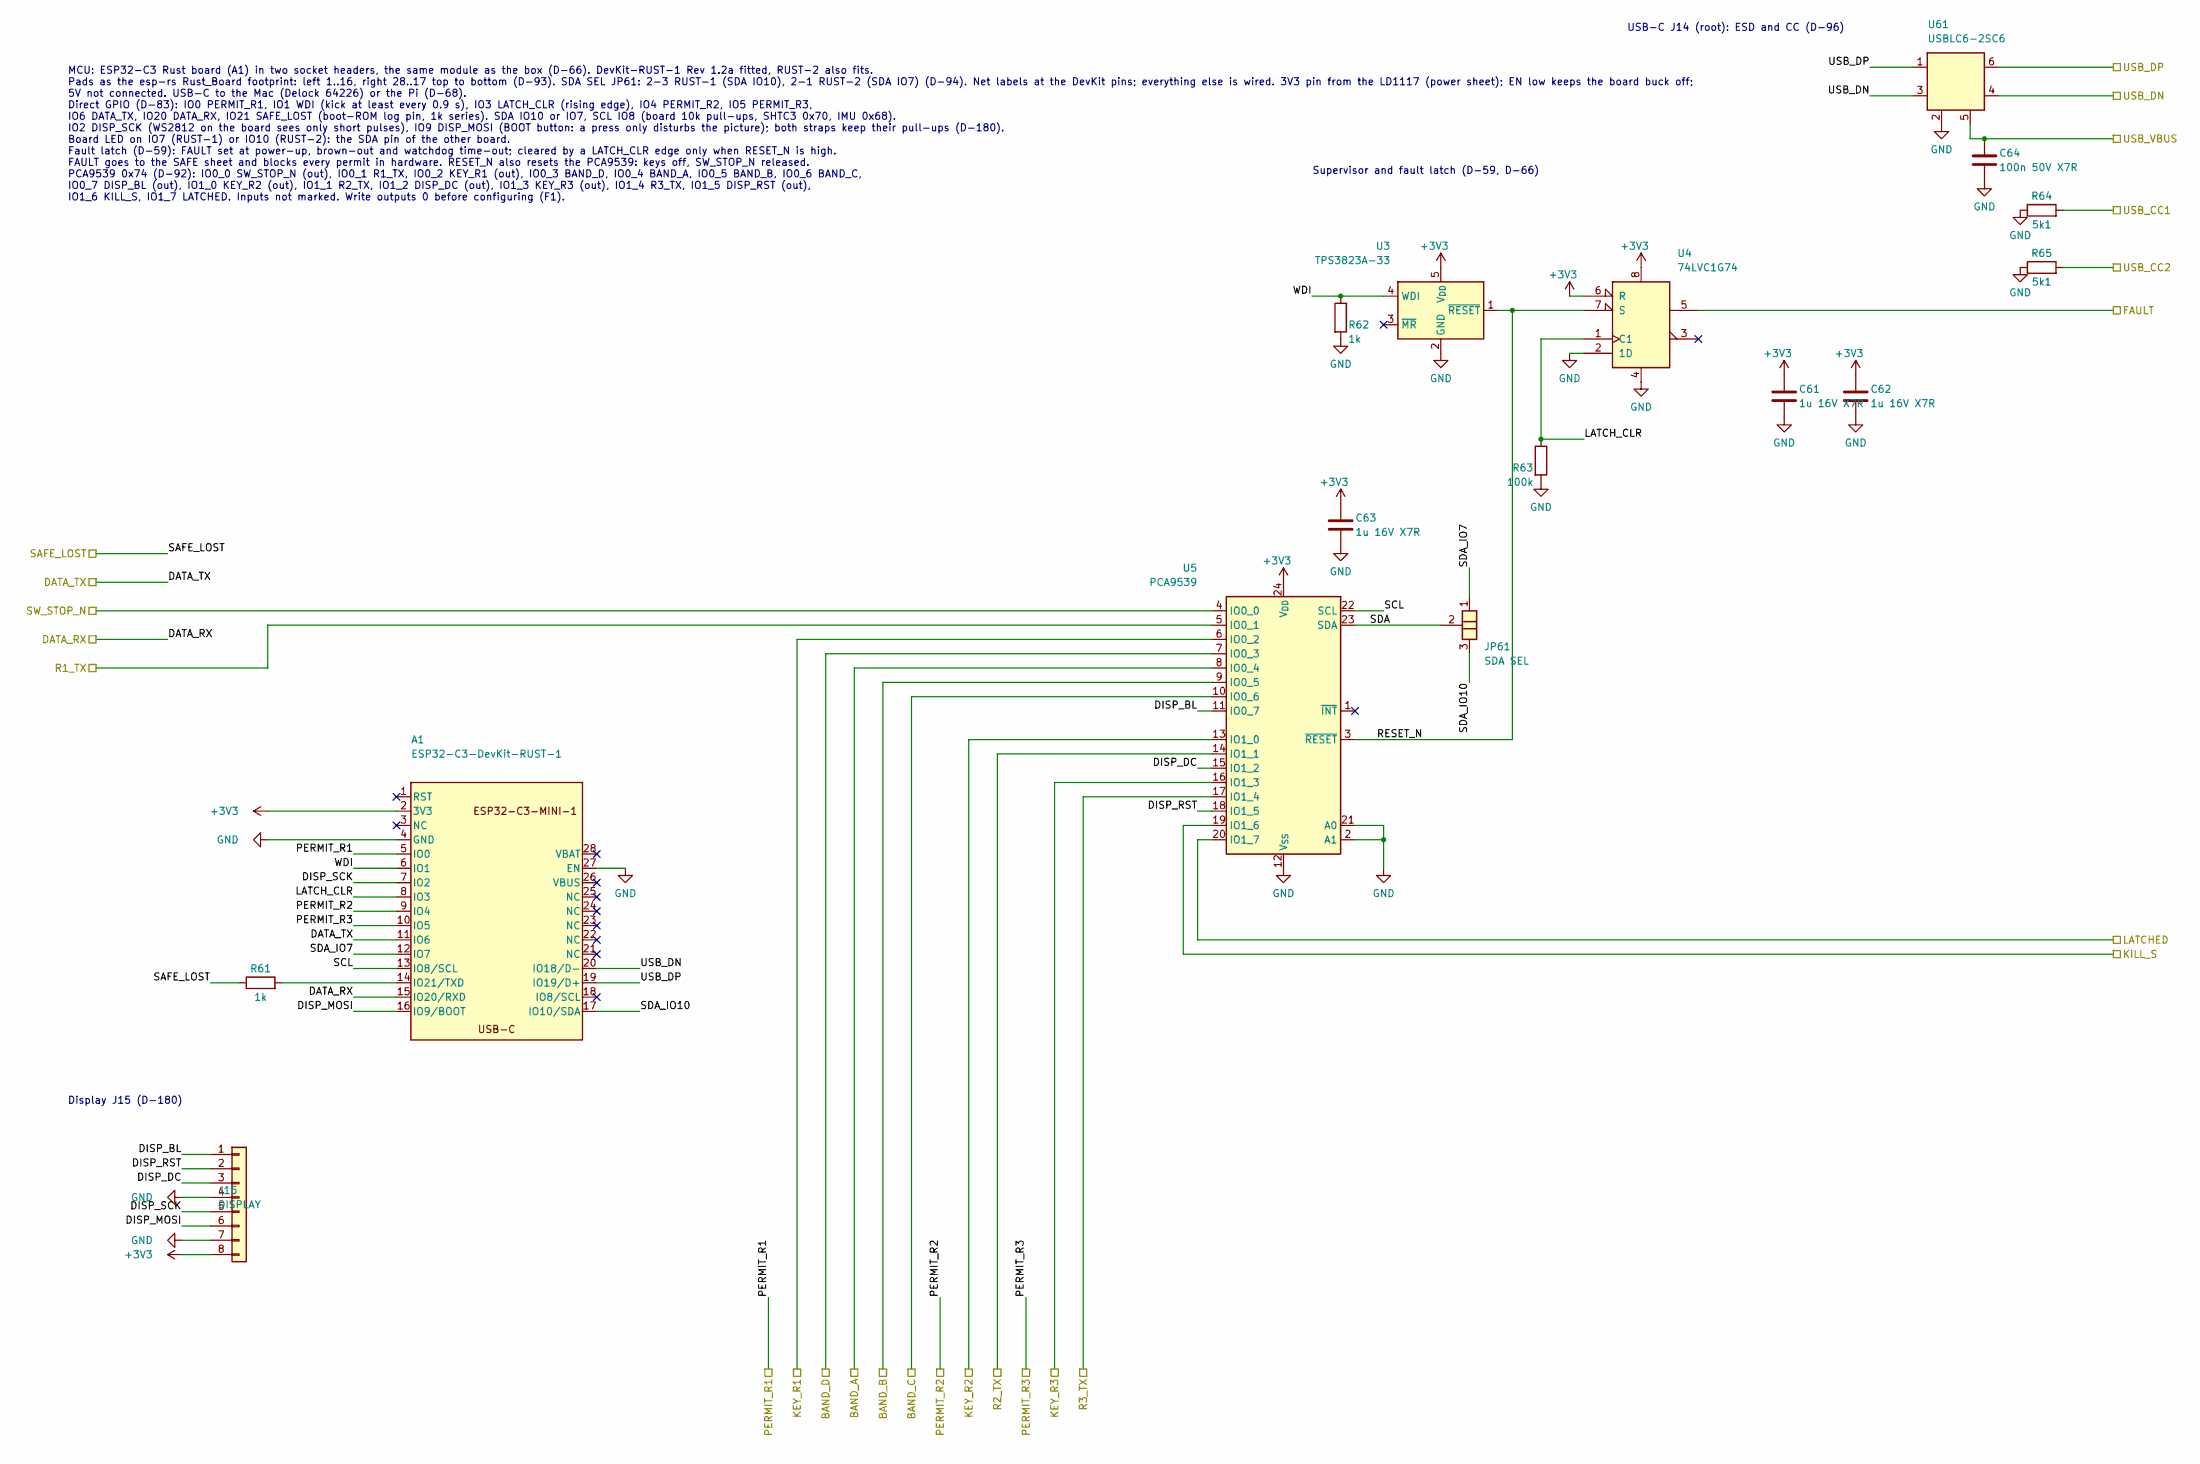
[picture p113: schematic mcu.kicad_sch, Shack interface: MCU, supervisor and expander]

Parts:
A1: ESP32-C3-DevKit-RUST-1; ESP32-C3-DevKit-RUST_Socket
C61, C62, C63: 1u 16V X7R; C_0603_1608Metric_Pad1.08x0.95mm_HandSolder
C64: 100n 50V X7R; C_0603_1608Metric_Pad1.08x0.95mm_HandSolder
J15: DISPLAY; PinHeader_1x08_P2.54mm_Vertical
JP61: SDA SEL; SolderJumper-3_P1.3mm_Open_RoundedPad1.0x1.5mm_NumberLabels
R61, R62: 1k; R_0603_1608Metric_Pad0.98x0.95mm_HandSolder
R63: 100k; R_0603_1608Metric_Pad0.98x0.95mm_HandSolder
R64, R65: 5k1; R_0603_1608Metric_Pad0.98x0.95mm_HandSolder
U3: TPS3823A-33; SOT-23-5; MPN TPS3823A-33DBVR
U4: 74LVC1G74; VSSOP-8_2.3x2mm_P0.5mm; MPN SN74LVC1G74DCUR
U5: PCA9539; TSSOP-24_4.4x7.8mm_P0.65mm; MPN PCA9539PW,118
U61: USBLC6-2SC6; SOT-23-6; MPN USBLC6-2SC6

Connections:
+3V3: A1.2 (3V3), C61.1, C62.1, C63.1, J15.8, U3.5 (V_{DD}), U4.6 (R), U4.8, U5.24 (V_{DD}); also elsewhere on the board
/Link to the box/R1_TX: U5.5 (IO0_1); also elsewhere on the board
/Link to the box/SW_STOP_N: U5.4 (IO0_0); also elsewhere on the board
/MCU and expander/BAND_A: U5.8 (IO0_4); also elsewhere on the board
/MCU and expander/BAND_B: U5.9 (IO0_5); also elsewhere on the board
/MCU and expander/BAND_C: U5.10 (IO0_6); also elsewhere on the board
/MCU and expander/BAND_D: U5.7 (IO0_3); also elsewhere on the board
/MCU and expander/DATA_RX: A1.15 (IO20/RXD); also elsewhere on the board
/MCU and expander/DATA_TX: A1.11 (IO6); also elsewhere on the board
/MCU and expander/DISP_BL: J15.1, U5.11 (IO0_7)
/MCU and expander/DISP_DC: J15.3, U5.15 (IO1_2)
/MCU and expander/DISP_MOSI: A1.16 (IO9/BOOT), J15.6
/MCU and expander/DISP_RST: J15.2, U5.18 (IO1_5)
/MCU and expander/DISP_SCK: A1.7 (IO2), J15.5
/MCU and expander/FAULT: U4.5; also elsewhere on the board
/MCU and expander/KEY_R1: U5.6 (IO0_2); also elsewhere on the board
/MCU and expander/KEY_R2: U5.13 (IO1_0); also elsewhere on the board
/MCU and expander/KEY_R3: U5.16 (IO1_3); also elsewhere on the board
/MCU and expander/KILL_S: U5.19 (IO1_6); also elsewhere on the board
/MCU and expander/LATCHED: U5.20 (IO1_7); also elsewhere on the board
/MCU and expander/LATCH_CLR: A1.8 (IO3), R63.1, U4.1 (C1)
/MCU and expander/PERMIT_R1: A1.5 (IO0); also elsewhere on the board
/MCU and expander/PERMIT_R2: A1.9 (IO4); also elsewhere on the board
/MCU and expander/PERMIT_R3: A1.10 (IO5); also elsewhere on the board
/MCU and expander/R2_TX: U5.14 (IO1_1); also elsewhere on the board
/MCU and expander/R3_TX: U5.17 (IO1_4); also elsewhere on the board
/MCU and expander/RESET_N: U3.1 (~RESET), U4.7 (S), U5.3 (~RESET)
/MCU and expander/SAFE_LOST: R61.1; also elsewhere on the board
/MCU and expander/SCL: A1.13 (IO8/SCL), U5.22 (SCL)
/MCU and expander/SDA: JP61.2, U5.23 (SDA)
/MCU and expander/SDA_IO7: A1.12 (IO7), JP61.1
/MCU and expander/SDA_IO10: A1.17 (IO10/SDA), JP61.3
/MCU and expander/USB_CC1: R64.2; also elsewhere on the board
/MCU and expander/USB_CC2: R65.2; also elsewhere on the board
/MCU and expander/USB_DN: A1.20 (IO18/D-), U61.3 (I/O2), U61.4 (I/O2); also elsewhere on the board
/MCU and expander/USB_DP: A1.19 (IO19/D+), U61.1 (I/O1), U61.6 (I/O1); also elsewhere on the board
/MCU and expander/USB_VBUS: C64.1, U61.5 (VBUS); also elsewhere on the board
/MCU and expander/WDI: A1.6 (IO1), R62.1, U3.4 (WDI)
GND: A1.4 (GND), A1.27 (EN), C61.2, C62.2, C63.2, C64.2, J15.4, J15.7, R62.2, R63.2, R64.1, R65.1, U3.2 (GND), U4.2 (1D), U4.4, U5.2 (A1), U5.12 (V_{SS}), U5.21 (A0), U61.2 (GND); also elsewhere on the board
unnamed: A1.14 (IO21/TXD), R61.2

Notes on the sheet:
Supervisor and fault latch (D-59, D-66)
USB-C J14 (root): ESD and CC (D-96)
Display J15 (D-180)
MCU: ESP32-C3 Rust board (A1) in two socket headers, the same module as the box (D-66). DevKit-RUST-1 Rev 1.2a fitted, RUST-2 also fits. Pads as the esp-rs Rust_Board footprint: left 1..16, right 28..17 top to bottom (D-93). SDA SEL JP61: 2-3 RUST-1 (SDA IO10), 2-1 RUST-2 (SDA IO7) (D-94). Net labe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

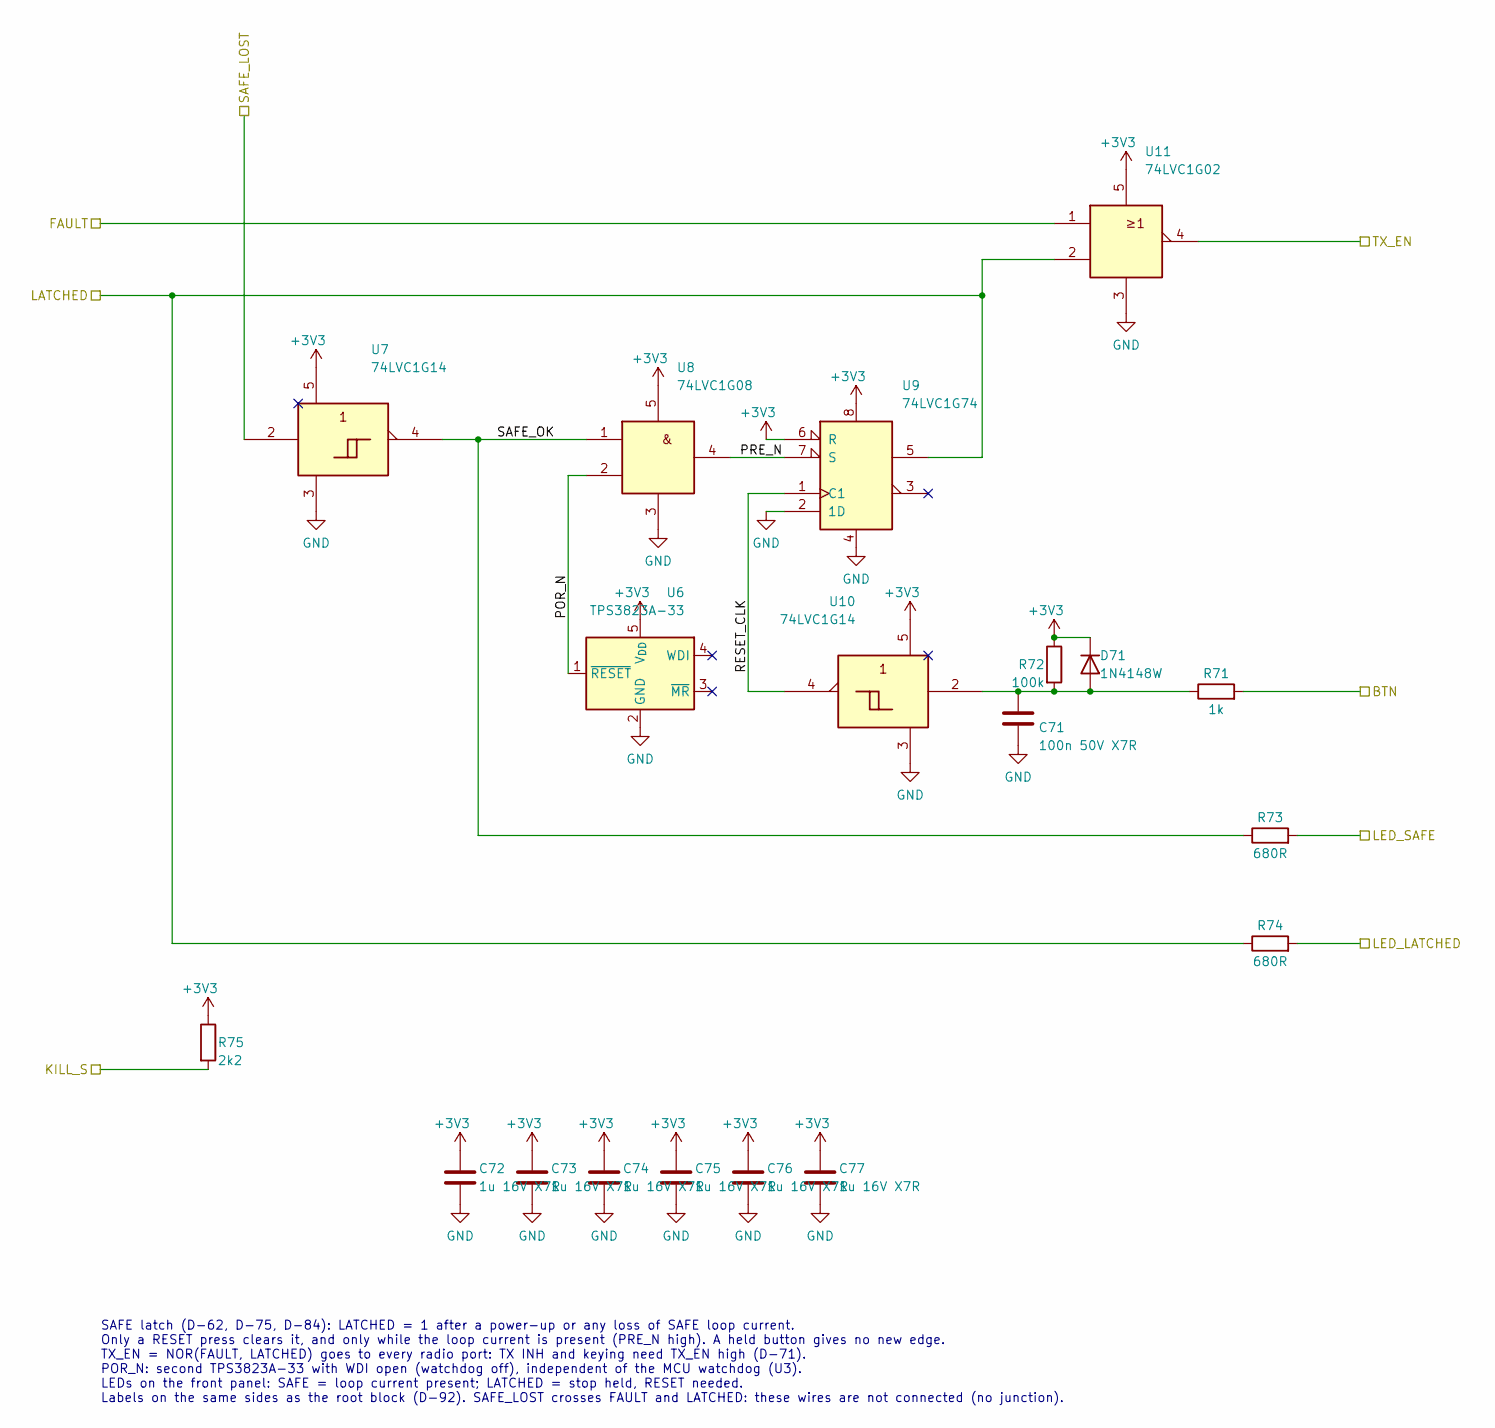
[picture p114: schematic safe.kicad_sch, Shack interface: SAFE latch, RESET and TX enable]

Parts:
C71: 100n 50V X7R; C_0603_1608Metric_Pad1.08x0.95mm_HandSolder
C72, C73, C74, C75, C76, C77: 1u 16V X7R; C_0603_1608Metric_Pad1.08x0.95mm_HandSolder
D71: 1N4148W; D_SOD-123; MPN 1N4148W
R71: 1k; R_0603_1608Metric_Pad0.98x0.95mm_HandSolder
R72: 100k; R_0603_1608Metric_Pad0.98x0.95mm_HandSolder
R73, R74: 680R; R_0603_1608Metric_Pad0.98x0.95mm_HandSolder
R75: 2k2; R_0603_1608Metric_Pad0.98x0.95mm_HandSolder
U6: TPS3823A-33; SOT-23-5; MPN TPS3823A-33DBVR
U7, U10: 74LVC1G14; SOT-23-5; MPN 74LVC1G14GV
U8: 74LVC1G08; SOT-23-5; MPN 74LVC1G08GV
U9: 74LVC1G74; VSSOP-8_2.3x2mm_P0.5mm; MPN SN74LVC1G74DCUR
U11: 74LVC1G02; SOT-23-5; MPN 74LVC1G02GV

Connections:
+3V3: C72.1, C73.1, C74.1, C75.1, C76.1, C77.1, D71.1 (K), R72.1, R75.1, U6.5 (V_{DD}), U7.5, U8.5, U9.6 (R), U9.8, U10.5, U11.5; also elsewhere on the board
/MCU and expander/FAULT: U11.1; also elsewhere on the board
/MCU and expander/KILL_S: R75.2; also elsewhere on the board
/MCU and expander/LATCHED: R74.1, U9.5, U11.2; also elsewhere on the board
/MCU and expander/SAFE_LOST: U7.2; also elsewhere on the board
/Radio port R1/TX_EN: U11.4; also elsewhere on the board
/SAFE latch/BTN: R71.2; also elsewhere on the board
/SAFE latch/LED_LATCHED: R74.2; also elsewhere on the board
/SAFE latch/LED_SAFE: R73.2; also elsewhere on the board
/SAFE latch/POR_N: U6.1 (~RESET), U8.2
/SAFE latch/PRE_N: U8.4, U9.7 (S)
/SAFE latch/RESET_CLK: U9.1 (C1), U10.4
/SAFE latch/SAFE_OK: R73.1, U7.4, U8.1
GND: C71.2, C72.2, C73.2, C74.2, C75.2, C76.2, C77.2, U6.2 (GND), U7.3, U8.3, U9.2 (1D), U9.4, U10.3, U11.3; also elsewhere on the board
unnamed: C71.1, D71.2 (A), R71.1, R72.2, U10.2

Notes on the sheet:
SAFE latch (D-62, D-75, D-84): LATCHED = 1 after a power-up or any loss of SAFE loop current. Only a RESET press clears it, and only while the loop current is present (PRE_N high). A held button gives no new edge. TX_EN = NOR(FAULT, LATCHED) goes to every radio port: TX INH and keying need TX_EN hi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
