PE1RGU/hf-antenna-switch/hardware/shack-interface/shack-interface.kicad_pcb

## KiCad design hardware/shack-interface/shack-interface.kicad_pcb (continued)

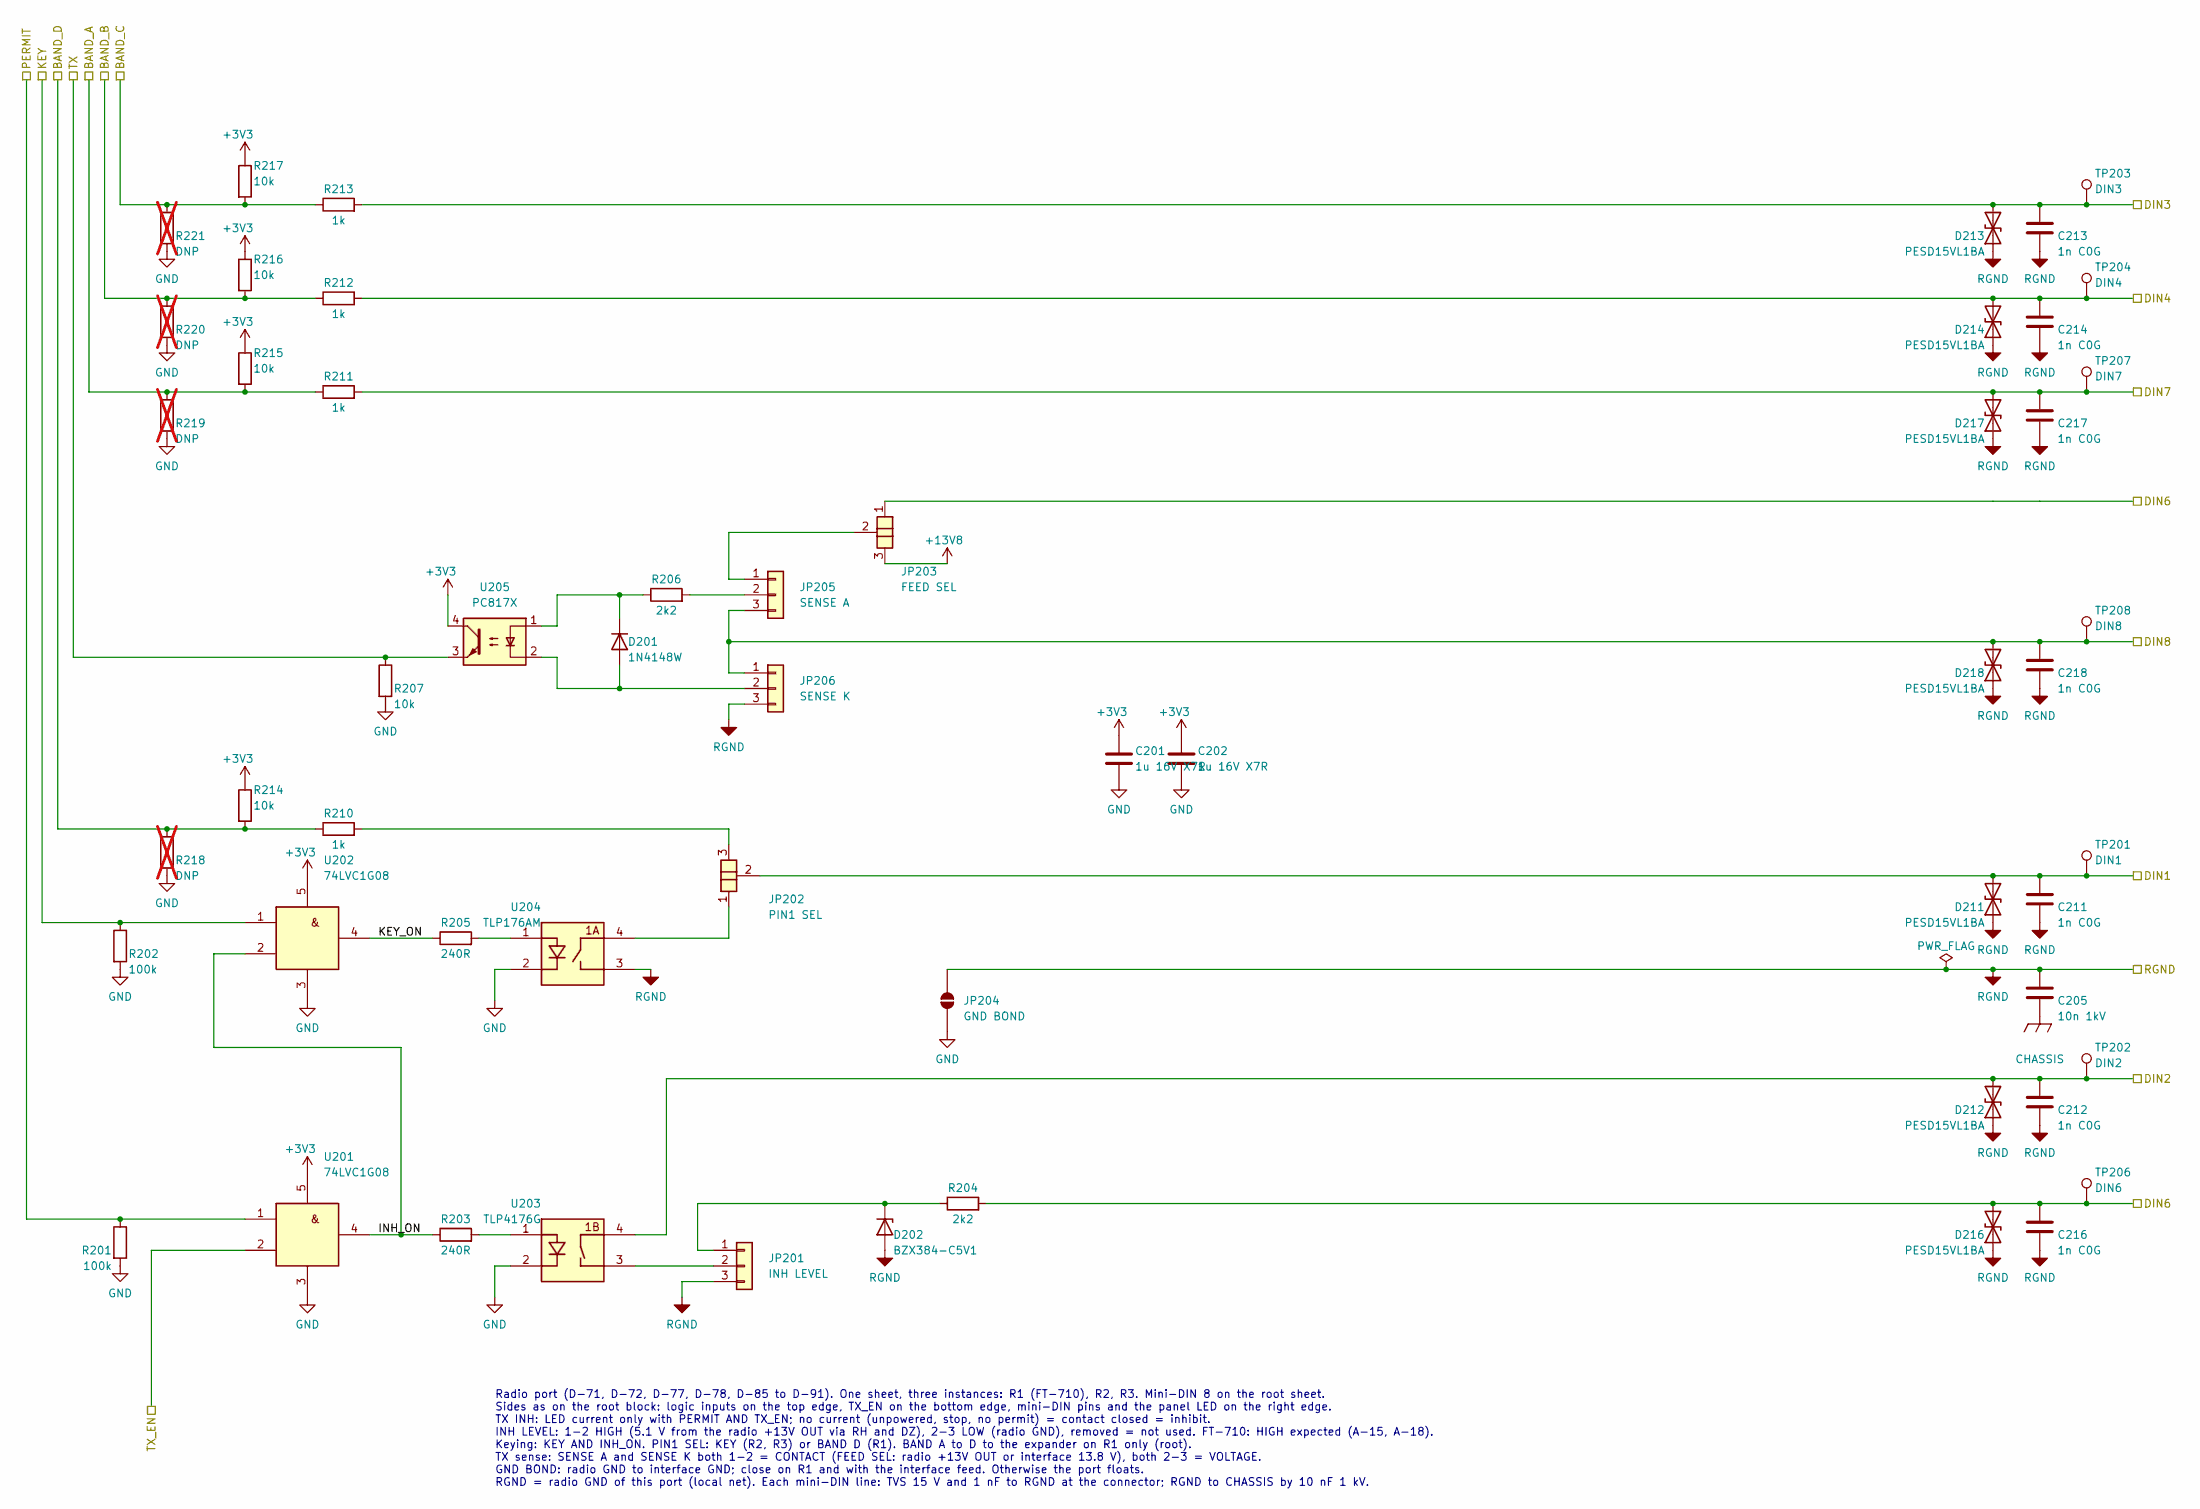
[picture p115: schematic radioport.kicad_sch, Shack interface: radio port (R1, R2, R3)]

Parts:
C201, C202: 1u 16V X7R; C_0603_1608Metric_Pad1.08x0.95mm_HandSolder
C205: 10n 1kV; C_1206_3216Metric_Pad1.33x1.80mm_HandSolder
C211, C212, C213, C214, C216, C217, C218: 1n C0G; C_0603_1608Metric_Pad1.08x0.95mm_HandSolder
D201: 1N4148W; D_SOD-123; MPN 1N4148W
D202: BZX384-C5V1; D_SOD-323_HandSoldering; MPN BZX384-C5V1
D211, D212, D213, D214, D216, D217, D218: PESD15VL1BA; D_SOD-323_HandSoldering; MPN PESD15VL1BA
JP201: INH LEVEL; PinHeader_1x03_P2.54mm_Vertical
JP202: PIN1 SEL; SolderJumper-3_P1.3mm_Open_RoundedPad1.0x1.5mm_NumberLabels
JP203: FEED SEL; SolderJumper-3_P1.3mm_Open_RoundedPad1.0x1.5mm_NumberLabels
JP204: GND BOND; SolderJumper-2_P1.3mm_Open_RoundedPad1.0x1.5mm
JP205: SENSE A; PinHeader_1x03_P2.54mm_Vertical
JP206: SENSE K; PinHeader_1x03_P2.54mm_Vertical
R201, R202: 100k; R_0603_1608Metric_Pad0.98x0.95mm_HandSolder
R203, R205: 240R; R_0603_1608Metric_Pad0.98x0.95mm_HandSolder
R204: 2k2; R_0603_1608Metric_Pad0.98x0.95mm_HandSolder
R206: 2k2; R_1206_3216Metric_Pad1.30x1.75mm_HandSolder
R207, R214, R215, R216, R217: 10k; R_0603_1608Metric_Pad0.98x0.95mm_HandSolder
R210, R211, R212, R213: 1k; R_0603_1608Metric_Pad0.98x0.95mm_HandSolder
R218, R219, R220, R221: DNP; R_0603_1608Metric_Pad0.98x0.95mm_HandSolder; not fitted
TP201: DIN1; TestPoint_Pad_D1.5mm
TP202: DIN2; TestPoint_Pad_D1.5mm
TP203: DIN3; TestPoint_Pad_D1.5mm
TP204: DIN4; TestPoint_Pad_D1.5mm
TP206: DIN6; TestPoint_Pad_D1.5mm
TP207: DIN7; TestPoint_Pad_D1.5mm
TP208: DIN8; TestPoint_Pad_D1.5mm
U201, U202: 74LVC1G08; SOT-23-5; MPN 74LVC1G08GV
U203: TLP4176G; SOP-4_P2.54mm_PhotoRelay_LongPad; MPN TLP4176G
U204: TLP176AM; SOP-4_P2.54mm_PhotoRelay_LongPad; MPN TLP176AM(TPL,E)
U205: PC817X; DIP-4_W7.62mm; MPN PC817X

Connections:
+3V3: C201.1, C202.1, R214.1, R215.1, R216.1, R217.1, U201.5, U202.5, U205.4; also elsewhere on the board
+13V8: JP203.3; also elsewhere on the board
/Link to the box/R1_TX: R207.1, U205.3; also elsewhere on the board
/MCU and expander/BAND_A: R211.1, R215.2, R219.1; also elsewhere on the board
/MCU and expander/BAND_B: R212.1, R216.2, R220.1; also elsewhere on the board
/MCU and expander/BAND_C: R213.1, R217.2, R221.1; also elsewhere on the board
/MCU and expander/BAND_D: R210.1, R214.2, R218.1; also elsewhere on the board
/MCU and expander/KEY_R1: R202.1, U202.1; also elsewhere on the board
/MCU and expander/PERMIT_R1: R201.1, U201.1; also elsewhere on the board
/Radio port R1/DIN1: C211.1, D211.2 (A2), JP202.2, TP201.1; also elsewhere on the board
/Radio port R1/DIN2: C212.1, D212.2 (A2), TP202.1, U203.4; also elsewhere on the board
/Radio port R1/DIN3: C213.1, D213.2 (A2), R213.2, TP203.1; also elsewhere on the board
/Radio port R1/DIN4: C214.1, D214.2 (A2), R212.2, TP204.1; also elsewhere on the board
/Radio port R1/DIN6: C216.1, D216.2 (A2), JP203.1, R204.2, TP206.1; also elsewhere on the board
/Radio port R1/DIN7: C217.1, D217.2 (A2), R211.2, TP207.1; also elsewhere on the board
/Radio port R1/DIN8: C218.1, D218.2 (A2), JP205.3, JP206.1, TP208.1; also elsewhere on the board
/Radio port R1/INH_ON: R203.1, U201.4, U202.2
/Radio port R1/KEY_ON: R205.1, U202.4
/Radio port R1/RGND: C205.1, C211.2, C212.2, C213.2, C214.2, C216.2, C217.2, C218.2, D202.2 (A), D211.1 (A1), D212.1 (A1), D213.1 (A1), D214.1 (A1), D216.1 (A1), D217.1 (A1), D218.1 (A1), JP201.3, JP204.2 (B), JP206.3, U204.3; also elsewhere on the board
/Radio port R1/TX_EN: U201.2; also elsewhere on the board
CHASSIS: C205.2; also elsewhere on the board
GND: C201.2, C202.2, JP204.1 (A), R201.2, R202.2, R207.2, R218.2, R219.2, R220.2, R221.2, U201.3, U202.3, U203.2, U204.2; also elsewhere on the board
unnamed: D201.2 (A), JP206.2, U205.2
unnamed: D201.1 (K), R206.1, U205.1
unnamed: D202.1 (K), JP201.1, R204.1
unnamed: JP201.2, U203.3
unnamed: JP202.1, U204.4
unnamed: JP202.3, R210.2
unnamed: JP203.2, JP205.1
unnamed: JP205.2, R206.2
unnamed: R203.2, U203.1
unnamed: R205.2, U204.1

Parts of its further copies:
C301, C302, C401, C402: 1u 16V X7R; C_0603_1608Metric_Pad1.08x0.95mm_HandSolder
C305, C405: 10n 1kV; C_1206_3216Metric_Pad1.33x1.80mm_HandSolder
C311, C312, C313, C314, C316, C317, C318, C411, C412, C413, C414, C416, C417, C418: 1n C0G; C_0603_1608Metric_Pad1.08x0.95mm_HandSolder
D301, D401: 1N4148W; D_SOD-123; MPN 1N4148W
D302, D402: BZX384-C5V1; D_SOD-323_HandSoldering; MPN BZX384-C5V1
D311, D312, D313, D314, D316, D317, D318, D411, D412, D413, D414, D416, D417, D418: PESD15VL1BA; D_SOD-323_HandSoldering; MPN PESD15VL1BA
JP301, JP401: INH LEVEL; PinHeader_1x03_P2.54mm_Vertical
JP302, JP402: PIN1 SEL; SolderJumper-3_P1.3mm_Open_RoundedPad1.0x1.5mm_NumberLabels
JP303, JP403: FEED SEL; SolderJumper-3_P1.3mm_Open_RoundedPad1.0x1.5mm_NumberLabels
JP304, JP404: GND BOND; SolderJumper-2_P1.3mm_Open_RoundedPad1.0x1.5mm
JP305, JP405: SENSE A; PinHeader_1x03_P2.54mm_Vertical
JP306, JP406: SENSE K; PinHeader_1x03_P2.54mm_Vertical
R301, R302, R401, R402: 100k; R_0603_1608Metric_Pad0.98x0.95mm_HandSolder
R303, R305, R403, R405: 240R; R_0603_1608Metric_Pad0.98x0.95mm_HandSolder
R304, R404: 2k2; R_0603_1608Metric_Pad0.98x0.95mm_HandSolder
R306, R406: 2k2; R_1206_3216Metric_Pad1.30x1.75mm_HandSolder
R307, R314, R315, R316, R317, R407, R414, R415, R416, R417: 10k; R_0603_1608Metric_Pad0.98x0.95mm_HandSolder
R310, R311, R312, R313, R410, R411, R412, R413: 1k; R_0603_1608Metric_Pad0.98x0.95mm_HandSolder
R318, R319, R320, R321, R418, R419, R420, R421: DNP; R_0603_1608Metric_Pad0.98x0.95mm_HandSolder; not fitted
TP301, TP401: DIN1; TestPoint_Pad_D1.5mm
TP302, TP402: DIN2; TestPoint_Pad_D1.5mm
TP303, TP403: DIN3; TestPoint_Pad_D1.5mm
TP304, TP404: DIN4; TestPoint_Pad_D1.5mm
TP306, TP406: DIN6; TestPoint_Pad_D1.5mm
TP307, TP407: DIN7; TestPoint_Pad_D1.5mm
TP308, TP408: DIN8; TestPoint_Pad_D1.5mm
U301, U302, U401, U402: 74LVC1G08; SOT-23-5; MPN 74LVC1G08GV
U303, U403: TLP4176G; SOP-4_P2.54mm_PhotoRelay_LongPad; MPN TLP4176G
U304, U404: TLP176AM; SOP-4_P2.54mm_PhotoRelay_LongPad; MPN TLP176AM(TPL,E)
U305, U405: PC817X; DIP-4_W7.62mm; MPN PC817X

Connections of its further copies:
+3V3: C301.1, C302.1, C401.1, C402.1, R314.1, R315.1, R316.1, R317.1, R414.1, R415.1, R416.1, R417.1, U301.5, U302.5, U305.4, U401.5, U402.5, U405.4; also elsewhere on the board
+13V8: JP303.3, JP403.3; also elsewhere on the board
/MCU and expander/KEY_R2: R302.1, U302.1; also elsewhere on the board
/MCU and expander/KEY_R3: R402.1, U402.1; also elsewhere on the board
/MCU and expander/PERMIT_R2: R301.1, U301.1; also elsewhere on the board
/MCU and expander/PERMIT_R3: R401.1, U401.1; also elsewhere on the board
/MCU and expander/R2_TX: R307.1, U305.3; also elsewhere on the board
/MCU and expander/R3_TX: R407.1, U405.3; also elsewhere on the board
/Radio port R1/TX_EN: U301.2, U401.2; also elsewhere on the board
/Radio port R2/BAND_A: R311.1, R315.2, R319.1
/Radio port R2/BAND_B: R312.1, R316.2, R320.1
/Radio port R2/BAND_C: R313.1, R317.2, R321.1
/Radio port R2/BAND_D: R310.1, R314.2, R318.1
/Radio port R2/DIN1: C311.1, D311.2 (A2), JP302.2, TP301.1; also elsewhere on the board
/Radio port R2/DIN2: C312.1, D312.2 (A2), TP302.1, U303.4; also elsewhere on the board
/Radio port R2/DIN3: C313.1, D313.2 (A2), R313.2, TP303.1; also elsewhere on the board
/Radio port R2/DIN4: C314.1, D314.2 (A2), R312.2, TP304.1; also elsewhere on the board
/Radio port R2/DIN6: C316.1, D316.2 (A2), JP303.1, R304.2, TP306.1; also elsewhere on the board
/Radio port R2/DIN7: C317.1, D317.2 (A2), R311.2, TP307.1; also elsewhere on the board
/Radio port R2/DIN8: C318.1, D318.2 (A2), JP305.3, JP306.1, TP308.1; also elsewhere on the board
/Radio port R2/INH_ON: R303.1, U301.4, U302.2
/Radio port R2/KEY_ON: R305.1, U302.4
/Radio port R2/RGND: C305.1, C311.2, C312.2, C313.2, C314.2, C316.2, C317.2, C318.2, D302.2 (A), D311.1 (A1), D312.1 (A1), D313.1 (A1), D314.1 (A1), D316.1 (A1), D317.1 (A1), D318.1 (A1), JP301.3, JP304.2 (B), JP306.3, U304.3; also elsewhere on the board
/Radio port R3/BAND_A: R411.1, R415.2, R419.1
/Radio port R3/BAND_B: R412.1, R416.2, R420.1
/Radio port R3/BAND_C: R413.1, R417.2, R421.1
/Radio port R3/BAND_D: R410.1, R414.2, R418.1
/Radio port R3/DIN1: C411.1, D411.2 (A2), JP402.2, TP401.1; also elsewhere on the board
/Radio port R3/DIN2: C412.1, D412.2 (A2), TP402.1, U403.4; also elsewhere on the board
/Radio port R3/DIN3: C413.1, D413.2 (A2), R413.2, TP403.1; also elsewhere on the board
/Radio port R3/DIN4: C414.1, D414.2 (A2), R412.2, TP404.1; also elsewhere on the board
/Radio port R3/DIN6: C416.1, D416.2 (A2), JP403.1, R404.2, TP406.1; also elsewhere on the board
/Radio port R3/DIN7: C417.1, D417.2 (A2), R411.2, TP407.1; also elsewhere on the board
/Radio port R3/DIN8: C418.1, D418.2 (A2), JP405.3, JP406.1, TP408.1; also elsewhere on the board
/Radio port R3/INH_ON: R403.1, U401.4, U402.2
/Radio port R3/KEY_ON: R405.1, U402.4
/Radio port R3/RGND: C405.1, C411.2, C412.2, C413.2, C414.2, C416.2, C417.2, C418.2, D402.2 (A), D411.1 (A1), D412.1 (A1), D413.1 (A1), D414.1 (A1), D416.1 (A1), D417.1 (A1), D418.1 (A1), JP401.3, JP404.2 (B), JP406.3, U404.3; also elsewhere on the board
CHASSIS: C305.2, C405.2; also elsewhere on the board
GND: C301.2, C302.2, C401.2, C402.2, JP304.1 (A), JP404.1 (A), R301.2, R302.2, R307.2, R318.2, R319.2, R320.2, R321.2, R401.2, R402.2, R407.2, R418.2, R419.2, R420.2, R421.2, U301.3, U302.3, U303.2, U304.2, U401.3, U402.3, U403.2, U404.2; also elsewhere on the board
unnamed: D301.2 (A), JP306.2, U305.2
unnamed: D301.1 (K), R306.1, U305.1
unnamed: D302.1 (K), JP301.1, R304.1
unnamed: D401.2 (A), JP406.2, U405.2
unnamed: D401.1 (K), R406.1, U405.1
unnamed: D402.1 (K), JP401.1, R404.1
unnamed: JP301.2, U303.3
unnamed: JP302.1, U304.4
unnamed: JP302.3, R310.2
unnamed: JP303.2, JP305.1
unnamed: JP305.2, R306.2
unnamed: JP401.2, U403.3
unnamed: JP402.1, U404.4
unnamed: JP402.3, R410.2
unnamed: JP403.2, JP405.1
unnamed: JP405.2, R406.2
unnamed: R303.2, U303.1
unnamed: R305.2, U304.1
unnamed: R403.2, U403.1
unnamed: R405.2, U404.1

Notes on the sheet:
Radio port (D-71, D-72, D-77, D-78, D-85 to D-91). One sheet, three instances: R1 (FT-710), R2, R3. Mini-DIN 8 on the root sheet. Sides as on the root block: logic inputs on the top edge, TX_EN on the bottom edge, mini-DIN pins and the panel LED on the right edge. TX INH: LED current only with PERM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

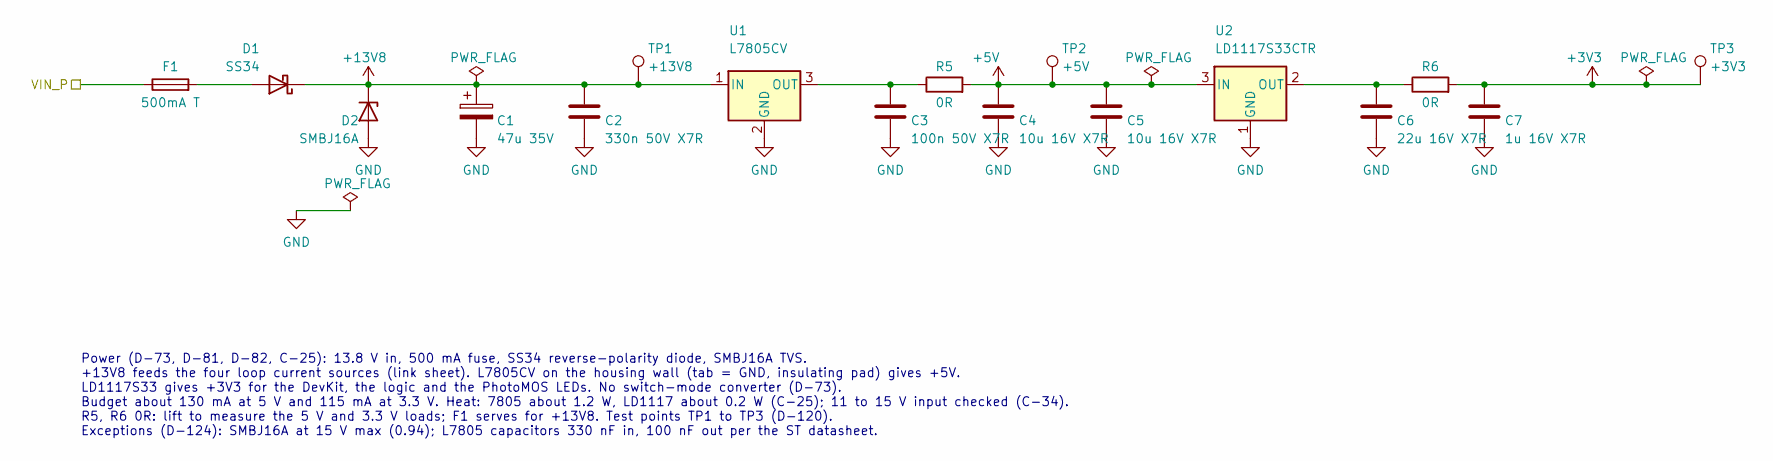
[picture p116: schematic power.kicad_sch, Shack interface: power 13.8 V, 5 V, 3.3 V]

Parts:
C1: 47u 35V; CP_Radial_D6.3mm_P2.50mm
C2: 330n 50V X7R; C_0805_2012Metric_Pad1.18x1.45mm_HandSolder
C3: 100n 50V X7R; C_0603_1608Metric_Pad1.08x0.95mm_HandSolder
C4, C5: 10u 16V X7R; C_1206_3216Metric_Pad1.33x1.80mm_HandSolder
C6: 22u 16V X7R; C_1210_3225Metric_Pad1.33x2.70mm_HandSolder
C7: 1u 16V X7R; C_0603_1608Metric_Pad1.08x0.95mm_HandSolder
D1: SS34; D_SMC; MPN SS34-M3/57T
D2: SMBJ16A; D_SMB; MPN SMBJ16A
F1: 500mA T; Fuse_1206_3216Metric; MPN SF-1206S050
R5, R6: 0R; R_1206_3216Metric_Pad1.30x1.75mm_HandSolder
TP1: +13V8; TestPoint_Pad_D1.5mm
TP2: +5V; TestPoint_Pad_D1.5mm
TP3: +3V3; TestPoint_Pad_D1.5mm
U1: L7805CV; TO-220-3_Vertical; MPN L7805CV
U2: LD1117S33CTR; SOT-223-3_TabPin2; MPN LD1117S33CTR

Connections:
+3V3: C7.1, R6.2, TP3.1; also elsewhere on the board
+5V: C4.1, C5.1, R5.2, TP2.1, U2.3 (IN)
+13V8: C1.1, C2.1, D1.1 (K), D2.1 (K), TP1.1, U1.1 (IN); also elsewhere on the board
/Power/VIN_P: F1.1; also elsewhere on the board
GND: C1.2, C2.2, C3.2, C4.2, C5.2, C6.2, C7.2, D2.2 (A), U1.2 (GND), U2.1 (GND); also elsewhere on the board
unnamed: D1.2 (A), F1.2
unnamed: C3.1, R5.1, U1.3 (OUT)
unnamed: C6.1, R6.1, U2.2 (OUT)

Notes on the sheet:
Power (D-73, D-81, D-82, C-25): 13.8 V in, 500 mA fuse, SS34 reverse-polarity diode, SMBJ16A TVS. +13V8 feeds the four loop current sources (link sheet). L7805CV on the housing wall (tab = GND, insulating pad) gives +5V. LD1117S33 gives +3V3 for the DevKit, the logic and the PhotoMOS LEDs. No switc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

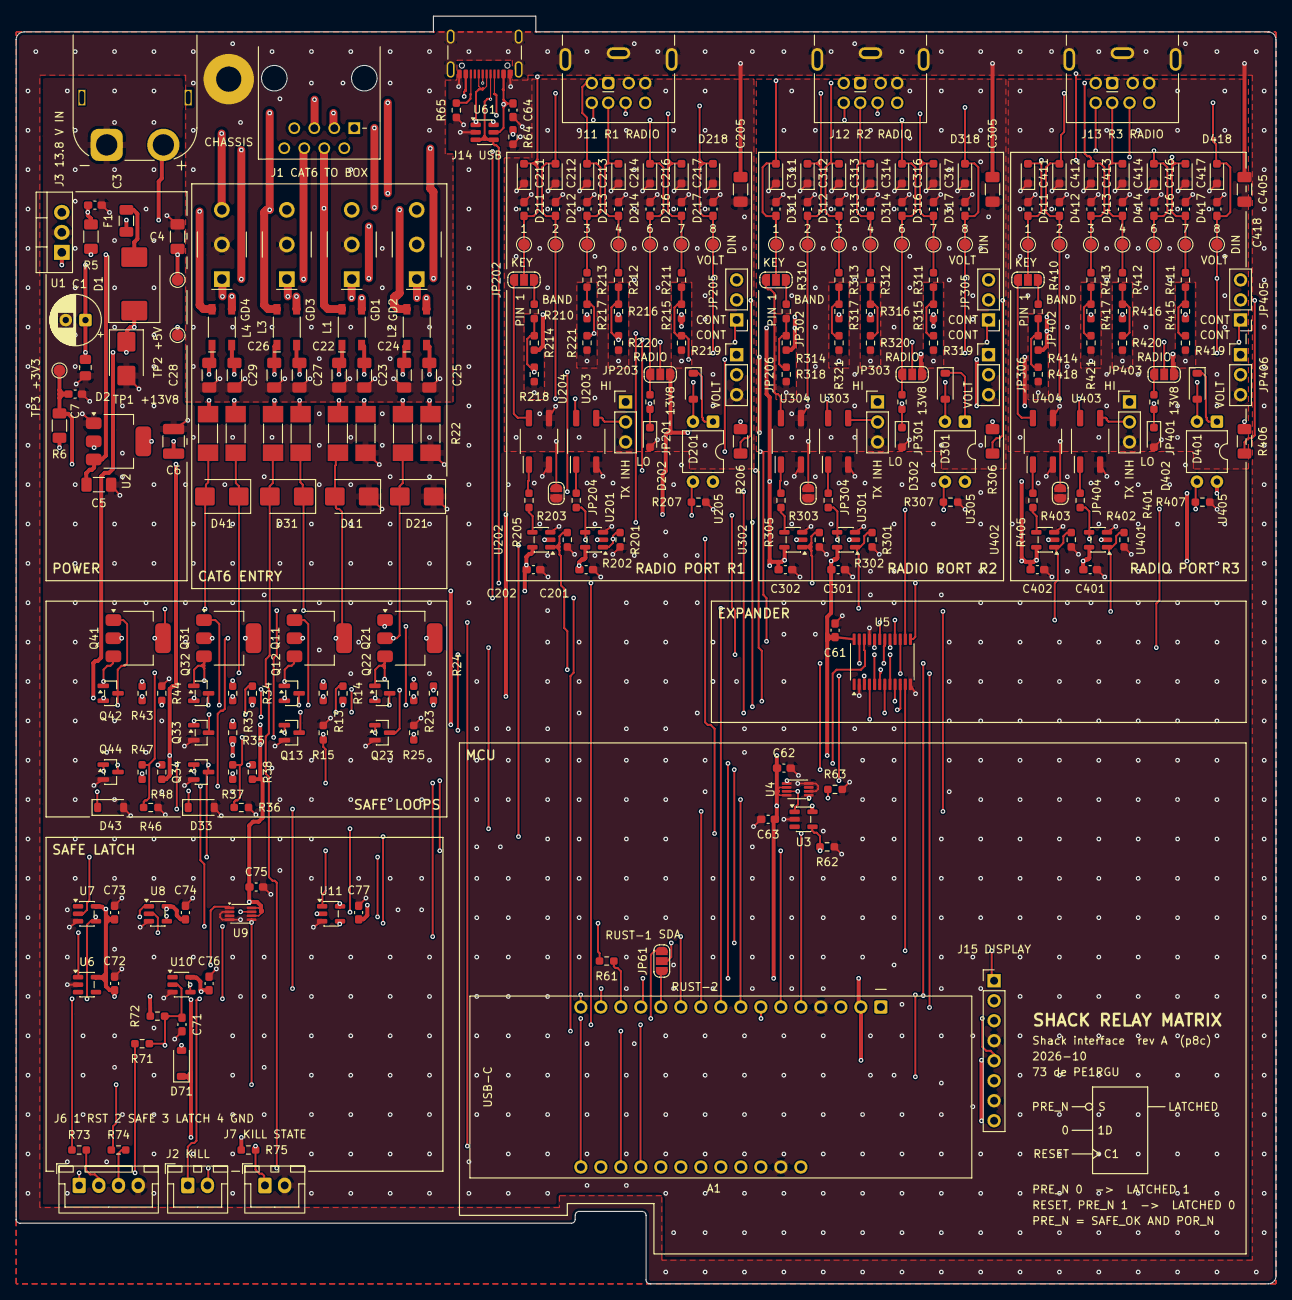
[picture p117: board shack-interface.kicad_pcb from above]

Board: 4 copper layers, 160.0 x 161.0 mm, 290 parts (0 on the bottom side), 160 nets.
