PE1RGU/hf-antenna-switch/hardware/unit/controller-board/gen_controller_pcb.py

#!/usr/bin/env python3
"""Controller board layout generator, increment p1 (board, nets, outline, holes, placement).
Run with the KiCad 10 Python from this folder:
  /Applications/KiCad/KiCad.app/Contents/Frameworks/Python.framework/Versions/3.9/bin/python3 gen_controller_pcb.py
Input: ../verify/ctl9.xml (netlist), footprint libraries. Output: controller-board.kicad_pcb (made new on every run; all layout
work is in this script), netclasses in controller-board.kicad_pro.
Coordinates: the RF board frame (mm from the RF board top left corner, y down), so that the holes, J2 and the parts on the
RF board line up without a conversion. Sources: D-131 (2 layers, L2 GND), D-137 (outline on S1, S2, S4, S5), D-138 (J1),
R-14 (DevKit USB corridor), C-27 (height stack), D-51 (J14 pin-out), D-102 (supports), D-130 (Cat6 entry)."""
import json, os, sys
import xml.etree.ElementTree as ET
import pcbnew

REV = "c-s6"
BOARD, PRO, NETLIST = "controller-board.kicad_pcb", "controller-board.kicad_pro", "../verify/ctl16.xml"
RF_BOARD = "../rf-board/rf-board.kicad_pcb"
OX, OY = 20.0, 20.0                                   # page offset of the RF frame origin (same as the RF board)
X0, Y0, X1, Y1, RC = 1.0, -2.0, 153.0, 120.5, 3.0   # outline (RF frame): 4 mm left of S2, 1 mm from the top wall (y -3)
FPLIB = "/Applications/KiCad/KiCad.app/Contents/SharedSupport/footprints"
mm = pcbnew.FromMM
P = lambda x, y: pcbnew.VECTOR2I(mm(OX + x), mm(OY + y))

b = pcbnew.BOARD()
KEEP = []                                             # keep the Python proxies alive (SWIG type table)

# ---- 1. footprints and nets from the netlist ----
root = ET.parse(NETLIST).getroot()
pinnet = {}
for n_ in root.iter("net"):
    for nd in n_.iter("node"):
        pinnet[(nd.get("ref"), nd.get("pin"))] = n_.get("name")
nets = {}
def net(name):
    if name not in nets:
        ni = pcbnew.NETINFO_ITEM(b, name); b.Add(ni); nets[name] = ni; KEEP.append(ni)
    return nets[name]
def load(fpid):
    lib, name = fpid.split(":")
    path = "lib/controller-board.pretty" if lib == "controller-board" else f"{FPLIB}/{lib}.pretty"
    f = pcbnew.FootprintLoad(path, name)
    assert f is not None, fpid
    f.SetFPID(pcbnew.LIB_ID(lib, name)); return f
fps = {}
for c in root.iter("comp"):
    ref = c.get("ref")
    f = load(c.findtext("footprint")); f.SetReference(ref); f.SetValue(c.findtext("value"))
    props = {q.get("name") for q in c.iter("property")}
    f.SetDNP("dnp" in props); f.SetExcludedFromBOM("exclude_from_bom" in props)
    b.Add(f); KEEP.append(f); fps[ref] = f
used = set()
for ref, f in fps.items():
    for pad in f.Pads():
        k = (ref, pad.GetNumber())
        if k in pinnet:
            pad.SetNet(net(pinnet[k])); used.add(k)
assert not (set(pinnet) - used), sorted(set(pinnet) - used)[:10]
# board-only mounting holes: NPTH M3 at S2, S4, S5 (H1, plated CHASSIS, is the schematic part at S1)
for ref in ("H2", "H3", "H4"):
    f = load("MountingHole:MountingHole_3.2mm_M3"); f.SetReference(ref); f.SetValue("M3 NPTH")
    f.SetBoardOnly(True); f.SetExcludedFromBOM(True); b.Add(f); KEEP.append(f); fps[ref] = f

# ---- 2. board settings: 2 layers, 1.6 mm, L2 solid GND (D-131) ----
ds = b.GetDesignSettings()
b.SetCopperLayerCount(4)                              # D-144: L1 vertical, L2 GND, L3 horizontal, L4 GND
ds.SetBoardThickness(mm(1.6))
tb = b.GetTitleBlock()
tb.SetTitle("Shack Relay Matrix rev C: controller board"); tb.SetRevision(REV); tb.SetCompany("PE1RGU")
tb.SetDate("2026-10-21"); tb.SetComment(0, "JLC04161H-7628, 4 layers, 1.6 mm: L1 vertical, L2 GND, L3 horizontal, L4 GND (D-144). Frame: RF board coordinates")
tb.SetComment(1, f"Generated by gen_controller_pcb.py {REV}; netlist {NETLIST}")

# ---- 3. outline ----
def edge(shape):
    shape.SetLayer(pcbnew.Edge_Cuts); shape.SetWidth(mm(0.1)); b.Add(shape); KEEP.append(shape)
for (xa, ya, xb, yb) in ((X0 + RC, Y0, X1 - RC, Y0), (X1, Y0 + RC, X1, Y1 - RC), (X1 - RC, Y1, X0 + RC, Y1), (X0, Y1 - RC, X0, Y0 + RC)):
    l = pcbnew.PCB_SHAPE(b, pcbnew.SHAPE_T_SEGMENT); l.SetStart(P(xa, ya)); l.SetEnd(P(xb, yb)); edge(l)
kc = RC * (1 - 0.5 ** 0.5)
for (sx, sy, mx, my, ex, ey) in ((X0, Y0 + RC, X0 + kc, Y0 + kc, X0 + RC, Y0), (X1 - RC, Y0, X1 - kc, Y0 + kc, X1, Y0 + RC),
                                 (X1, Y1 - RC, X1 - kc, Y1 - kc, X1 - RC, Y1), (X0 + RC, Y1, X0 + kc, Y1 - kc, X0, Y1 - RC)):
    a = pcbnew.PCB_SHAPE(b, pcbnew.SHAPE_T_ARC); a.SetArcGeometry(P(sx, sy), P(mx, my), P(ex, ey)); edge(a)

# ---- 4. fixed parts ----
def place(ref, x, y, rot=0.0, side="F"):
    f = fps[ref]
    if (side == "B") != f.IsFlipped():
        f.Flip(f.GetPosition(), pcbnew.FLIP_DIRECTION_LEFT_RIGHT)
    f.SetOrientationDegrees(rot); f.SetPosition(P(x, y))
def pad_mm(pad):
    q = pad.GetPosition(); return (round(pcbnew.ToMM(q.x) - OX, 3), round(pcbnew.ToMM(q.y) - OY, 3))
HOLES = [("H1", 5.0, 5.0), ("H2", 149.0, 5.0), ("H3", 46.0, 116.5), ("H4", 99.0, 116.5)]   # on S1, S2, S4, S5 (D-137)
for ref, x, y in HOLES:
    place(ref, x, y)
placed = {r for r, _, _ in HOLES}
# J2 on the bottom side, pad n over RF J14 pad n (socket on the RF header, D-51)
rf = pcbnew.LoadBoard(RF_BOARD)
j14 = {p.GetNumber(): pad_mm(p) for f in rf.GetFootprints() if f.GetReference() == "J14" for p in f.Pads()}
for rot in (0.0, 90.0, 180.0, 270.0):
    place("J2", *j14["1"], rot, side="B")
    if all(abs(pad_mm(p)[0] - j14[p.GetNumber()][0]) < 0.01 and abs(pad_mm(p)[1] - j14[p.GetNumber()][1]) < 0.01 for p in fps["J2"].Pads()):
        break
else:
    raise SystemExit("J2: no rotation puts every pad over J14")
placed.add("J2")
# J2 3D: Samtec ESQ-112-33-G-D STEP (Prins, 2026-10-20). File: row along x, height along y with the seating plane at
# y -7.62, rows at z +-2.54. Rotation and offset checked in a STEP export (seating on the board, body 16.13 mm high, D-139)
m = fps["J2"].Models()[0]
m.m_Filename = "${KIPRJMOD}/lib/3d/ESQ-112-33-G-D.stp"
m.m_Offset = pcbnew.VECTOR3D(-1.27, -13.97, 7.62); m.m_Rotation = pcbnew.VECTOR3D(-90.0, 0.0, 90.0)
# J1: front face 0.5 mm from the top wall (inner wall at y -3, face 7.93 mm from the peg line), x next to H1 and the GDTs
J1_X, J1_FACE = 28.5, -2.5                         # J1 centred over the four entry columns (2.5 to 54.5)
place("J1", J1_X, J1_FACE + 7.93, 180.0); placed.add("J1")
# DevKit (R-14): USB end toward +x at the right board edge; the 40 x 14 mm corridor lies over the RF relay field, where no
# part reaches the controller board level. USB receptacle 33.56 mm from the footprint origin (pads 16/17 end)
A1_Y = 30.0
place("A1", X1 - 0.5 - 33.56, A1_Y, 90.0); placed.add("A1")
usb = [pad_mm(p) for p in fps["A1"].Pads() if p.GetNumber() in ("16", "17")]
assert all(u[0] > pcbnew.ToMM(fps["A1"].GetPosition().x) - OX for u in usb), f"DevKit USB end not toward +x: {usb}"
# Isolation barrier (D-142): the Cat6 loop side (J1, entry parts, opto LED or switch sides) lies left of LOOP_X and above
# LOOP_Y; the logic side (GND plane) right of LOGIC_X and below LOGIC_Y. The 3 mm band between has no copper (rule area).
Y_B = 63.0                                            # barrier centre line through the opto row
LOOP_X, LOGIC_X, LOOP_Y, LOGIC_Y = 54.5, 57.5, Y_B - 1.5, Y_B + 1.5
# ---- 4b. Cat6 entry: one template per pair (p5, symmetry). Columns in the J1 pin order (J1 turned 180: pin 8 left):
# pair 4 (pins 7, 8), pair 3 (3, 6), pair 1 (4, 5), pair 2 (1, 2). Pair 3 has the READY photorelay U6 beside U3.
# In each column N runs on the left rail (cx - 3) and P on the right rail (cx + 3), from the GDT down to the opto:
#   GDT (N, CHASSIS, P) - choke (dots diagonal: one N/P crossing below it, on B.Cu, the loop side has no plane)
#   - Y-capacitor footprints left and right of the choke - 47R per wire - TVS across - LED resistor (P) - reverse or
#   series diode across - opto, loop side up (VO2611: cathode left, anode right; PC817: collector left, emitter right).
CW, CX0, CW3 = 11.8, 2.5, 16.6                        # column width, left edge, width of the pair 3 column
COLS = [(4, "U4"), (3, "U3"), (1, "U1"), (2, "U2")]
CX, xl_ = {}, CX0
for k, u in COLS:
    CX[k] = xl_ + 5.6 if k == 3 else xl_ + CW / 2
    xl_ += CW3 if k == 3 else CW
assert abs(xl_ - LOOP_X) < 0.01, xl_
YG, YL, YR, YT, YR3, YD = 23.0, 30.0, 38.5, 46.0, 51.2, 56.0          # rows: GDT, choke, 47R, TVS, LED R, diode
def fixp(ref, x, y, rot=0.0): place(ref, x, y, rot); placed.add(ref)
# GDT x offset from the column centre (D-149): the second source SL1003A is 12.2 mm long over the lead bends, so the GDTs
# of pairs 3 and 1 move toward J1 to keep 12.8 mm between neighbours; the four stay symmetric about J1 (x 28.5)
GDX = {4: 0.0, 3: 1.3, 1: -1.0, 2: 0.0}
for k, u in COLS:
    cx = CX[k]
    fixp(f"GD{k}", cx + GDX[k], YG, 0)                 # pin 1 N left, pin 2 CHASSIS, pin 3 P right
    fixp(f"L{k}", cx, YL, 0)                           # TDK ACT45B (D-149): P winding right column, N left, both start at the top
    fixp(f"C{19 + 2 * k}", cx + 4.4, YL, 270)          # Y cap P out (pad 2 at the bottom, next to the P out of the choke)
    fixp(f"C{20 + 2 * k}", cx - 4.4, YL, 90)           # Y cap N out (pad 1 at the bottom)
    fixp(f"R{10 * k + 1}", cx + 3, YR, 270)            # 47R P, pad 1 (from the choke) at the top
    fixp(f"R{10 * k + 2}", cx - 3, YR, 270)            # 47R N
    fixp(f"D{10 * k + 1}", cx, YT, 0)                  # TVS: pad 1 N left, pad 2 P right
    if k != 4:
        fixp(f"R{10 * k + 3}", cx + 3, YR3, 270)       # 220R LED series on P, pad 1 at the top
        fixp(f"D{10 * k + 2}", cx, YD, 180)            # 1N4148W across the LED, cathode (pad 1) right on the anode node
        fixp(u, cx + 3.81, Y_B - 3.81, 270)            # VO2611: pin 2 anode cx + 1.27, pin 3 cathode cx - 1.27
    else:
        fixp("D42", cx, YD, 0)                         # series diode P to the collector, cathode (pad 1) left
        fixp(u, cx - 1.27, Y_B + 3.81, 90)             # PC817: collector cx - 1.27, emitter cx + 1.27 on the loop side
# choke check (D-149): P winding on the right, N on the left, both enter at the top; Y-capacitor wire pad below CHASSIS
for k, _ in COLS:
    pp = {pd.GetNumber(): (pad_mm(pd), pd.GetNetname()) for pd in fps[f"L{k}"].Pads()}
    (x1, y1), n1 = pp["1"]; (x2, y2), _ = pp["2"]; (x3, y3), n3 = pp["3"]
    assert n1.endswith(f"L{k}P") and n3.endswith(f"L{k}N") and x1 > x3 and abs(y1 - y3) < 0.01 and y1 < y2, (k, pp)
    for c in (f"C{19 + 2 * k}", f"C{20 + 2 * k}"):
        cp = {pd.GetNetname().endswith("CHASSIS"): pad_mm(pd)[1] for pd in fps[c].Pads()}
        assert cp[True] < cp[False], (c, cp)
U6X = CX0 + CW + 13.9
fixp("U6", U6X, Y_B, 90)                               # READY photorelay: switch pins 4 (left) and 3 (right) up
# opto logic side, same template per column: decoupling on VCC (pin 8), pull-up on the output (pin 6)
YLOG = Y_B + 3.81 + 2.8
for k, u in COLS:
    cx = CX[k]
    if k != 4:
        fixp(f"C{k}", cx + 3.81, YLOG, 270)            # pad 1 (+5V) at the top, on pin 8
        fixp(f"R{10 * k + 4}", cx - 1.27, YLOG, 90)    # pad 2 (output) at the top, on pin 6
    else:
        fixp("R43", cx - 1.27, YLOG, 90)               # +5V to the LED anode (pin 1), pad 2 at the top
        fixp("Q4", cx + 1.27, YLOG + 0.5, 90)          # drain (pin 3) at the top, on pin 2
# test points in one row under J2 (2.54 mm pitch, D-120, D-141): J2 signals under their own J2 pin, then +5V, +3V3,
# FAULT, and RF_A2_N under J2 pin 17
YTP = 17.0
for ref, pin in (("TP5", "1"), ("TP6", "3"), ("TP7", "5"), ("TP8", "7"), ("TP9", "9"), ("TP1", "11"), ("TP2", "13"),
                 ("TP3", "15"), ("TP4", "17")):
    fixp(ref, j14[pin][0], YTP)
# K0 links R51 to R53 under the TP row, each on its J2 pin (11, 13, 15); pad 1 TX_ANY at the bottom
for ref, pin in (("R51", "11"), ("R52", "13"), ("R53", "15")):
    fixp(ref, j14[pin][0], YTP + 4.0, 90)
# ---- 5. grid placement of the rest (p6): rows on fixed y lines, ICs at rotation 0, 0603 parts upright (90 or 270,
# pad 1 toward the pin it serves). Every IC has its decoupling capacitor upright right of it (3.3 mm opto side, 3.6 mm gate row).
# opto logic side, row 2 (row 1 is YLOG above): gate pull-down under Q4, READY gate U16 under U6, PTT inverter U5 under U2
Y2 = YLOG + 5.5
fixp("R44", CX[4] + 1.27, Y2, 90)
fixp("R35", U6X - 1.27, YLOG, 270)                     # on U6 pin 1, in row 1 with the other opto parts
fixp("U16", U6X, Y2, 0); fixp("C5", U6X + 3.3, Y2, 90); fixp("R36", U6X - 3.3, Y2, 90)
fixp("U5", CX[2], Y2, 0); fixp("C4", CX[2] + 3.3, Y2, 90)
# 3.3 V supply and safety gate in one row under the DevKit signal pins (pin row at y 40.16), 8 mm pitch, then JP11.
# Row 2 (YM2): LDO bypass and output link under U11, pull-ups and pull-downs under the gate they serve.
YM, YM2 = 50.0, 55.5
MX = {"U11": 96.0, "U14": 104.0, "U15": 112.0, "U13": 120.0, "U12": 128.0}
for ref, x in MX.items():
    fixp(ref, x, YM, 0)
fixp("C11", MX["U11"] - 3.6, YM, 90)                   # LDO input
for ref, c in (("U11", "C13"), ("U14", "C16"), ("U15", "C17"), ("U13", "C15"), ("U12", "C14")):
    fixp(c, MX[ref] + 3.6, YM, 90)                     # LDO output, gate decoupling
fixp("C12", MX["U11"], YM2, 90); fixp("R65", MX["U11"] + 3.3, YM2 + 0.8, 90)
fixp("R63", MX["U14"], YM2, 90); fixp("R62", MX["U13"], YM2, 90)
fixp("R64", MX["U12"] - 1.6, YM2, 90); fixp("R61", MX["U12"] + 1.6, YM2, 90)
fixp("R66", MX["U15"], YM2, 90)                       # FAULT to GPIO6 (D-191), in the free slot under U15
fixp("JP11", 136.0, YM, 0)                             # SDA select, between DevKit pins 12 and 17
left = [c.get("ref") for c in root.iter("comp") if c.get("ref") not in placed]
assert not left, left

# ---- 5a. plane vias (routing r1, r4): every SMD GND pad on the logic side and every SMD CHASSIS pad on the loop side
# (D-145) gets its own via to the planes, next to the pad, with a short F.Cu track. THT pads join the zones directly.
# The router does not route GND or CHASSIS.
CHASSIS = "/Link and PTT/CHASSIS"
LOGIC_POLY = [(LOGIC_X, Y0), (X1, Y0), (X1, Y1), (X0, Y1), (X0, LOGIC_Y), (LOGIC_X, LOGIC_Y)]
LOOP_POLY = [(X0, Y0), (LOOP_X, Y0), (LOOP_X, LOOP_Y), (X0, LOOP_Y)]
PLANES = (("GND", LOGIC_POLY), (CHASSIS, LOOP_POLY))           # net, region (logic side D-142, loop side D-145)
VIA_D, VIA_DR, VIA_CL, GTW = 0.6, 0.3, 0.25, 0.254
def pad_box(pd):
    q = pd.GetPosition(); bb = pd.GetBoundingBox()
    return (pcbnew.ToMM(bb.GetX()) - OX, pcbnew.ToMM(bb.GetY()) - OY, pcbnew.ToMM(bb.GetRight()) - OX, pcbnew.ToMM(bb.GetBottom()) - OY)
ALLPADS = [(pd, pad_box(pd)) for f in fps.values() for pd in f.Pads()]
def clear_of_pads(x, y, own, cl=VIA_CL):
    r = VIA_D / 2 + cl
    for pd, (a, b_, c, d) in ALLPADS:
        if pd is own: continue
        dx = max(a - x, 0, x - c); dy = max(b_ - y, 0, y - d)
        if (dx * dx + dy * dy) ** 0.5 < r: return False
    return True
def add_via(x, y, netname):
    v = pcbnew.PCB_VIA(b); v.SetPosition(P(x, y)); v.SetWidth(mm(VIA_D)); v.SetDrill(mm(VIA_DR))
    v.SetNet(net(netname)); v.SetLocked(True); b.Add(v); KEEP.append(v)    # locked: export_geom.py passes it to the router
VIAS = []                                                      # (x, y) of all plane vias, for the stitching spacing
CL_PLANE = {"GND": VIA_CL, CHASSIS: 0.55}                     # via to pad: CHASSIS is in the Loop class (0.5 mm)
REGION = dict(PLANES)
def inside(x, y, poly):
    c = False
    for (xa, ya), (xb, yb) in zip(poly, poly[1:] + poly[:1]):
        if (ya > y) != (yb > y) and x < xa + (y - ya) * (xb - xa) / (yb - ya): c = not c
    return c
def edge_dist(x, y, poly):
    m = 1e9
    for (xa, ya), (xb, yb) in zip(poly, poly[1:] + poly[:1]):
        dx, dy = xb - xa, yb - ya; t = max(0, min(1, ((x - xa) * dx + (y - ya) * dy) / (dx * dx + dy * dy)))
        m = min(m, ((x - xa - t * dx) ** 2 + (y - ya - t * dy) ** 2) ** 0.5)
    return m
# ---- 5a-1. U13 fan-out (D-154): VSSOP-8 at 0.5 mm pitch. The pad gap (0.15 mm) is below the Default clearance (0.2 mm)
# and below the router keep-out, so the middle pins get fixed 0.2 mm copper here and the router ends on terminals
# (routing/terminals.json, read by export_geom.py). Pins 6 and 8 (+3V3): strap outside the pad tips, terminal at the middle of its
# vertical part (the corners are 45 degrees since c-s4).
# corner. Pin 7 (RESET_N) and pin 4 (GND): stub inward to a via under the body; terminal of pin 7 is its via (L1 and L3).
# Pin 2 (GND): strap to pin 4 around pin 3 (NC). Pins 1 and 5 are corner pins; the router reaches them directly.
# U13 pads get a local clearance of 0.12 mm (pad to pad only; tracks keep 0.2 mm).
FW, FCL, SX = 0.2, 0.12, 2.6
u13 = fps["U13"]
U13P, U13N = {}, {}
for pd in u13.Pads():
    pd.SetLocalClearance(mm(FCL))
    a, b_, c, d = pad_box(pd); U13P[pd.GetNumber()] = ((a + c) / 2, (b_ + d) / 2); U13N[pd.GetNumber()] = pd.GetNetname()
ux0, uy0 = pcbnew.ToMM(u13.GetPosition().x) - OX, pcbnew.ToMM(u13.GetPosition().y) - OY
assert u13.GetOrientationDegrees() == 0 and U13N["6"] == U13N["8"] == "+3V3" and U13N["2"] == U13N["4"] == "GND", U13N
assert U13P["8"][0] > ux0 and U13P["8"][1] < U13P["7"][1] < U13P["6"][1] and U13P["2"][1] < U13P["4"][1], U13P
def chamfer(pts, leg=0.45):
    """45-degree corners instead of 90-degree bends (Prins, 2026-10-23; hardware skill pcb-layout.md)."""
    q = [pts[0]]
    for (xa, ya), (xb, yb), (xc, yc) in zip(pts, pts[1:], pts[2:]):
        l1, l2 = ((xb - xa) ** 2 + (yb - ya) ** 2) ** 0.5, ((xc - xb) ** 2 + (yc - yb) ** 2) ** 0.5
        u1, u2 = ((xb - xa) / l1, (yb - ya) / l1), ((xc - xb) / l2, (yc - yb) / l2)
        if abs(u1[0] * u2[0] + u1[1] * u2[1]) > 0.01: q.append((xb, yb)); continue
        d = min(leg, 0.45 * l1, 0.45 * l2)
        q += [(round(xb - u1[0] * d, 4), round(yb - u1[1] * d, 4)), (round(xb + u2[0] * d, 4), round(yb + u2[1] * d, 4))]
    return q + [pts[-1]]
def ftrack(pts, netname):
    pts = chamfer(pts)
    for (xa, ya), (xb, yb) in zip(pts, pts[1:]):
        t = pcbnew.PCB_TRACK(b); t.SetStart(P(xa, ya)); t.SetEnd(P(xb, yb)); t.SetWidth(mm(FW)); t.SetLayer(pcbnew.F_Cu)
        t.SetNet(net(netname)); t.SetLocked(True); b.Add(t); KEEP.append(t)
p2, p4, p6, p7, p8 = (U13P[k] for k in "24678")
ftrack([p8, (ux0 + SX, p8[1]), (ux0 + SX, p6[1]), p6], "+3V3")
v7, v4 = (ux0, p7[1]), (ux0, p4[1])
ftrack([p7, v7], U13N["7"]); ftrack([p4, v4], "GND"); ftrack([p2, (ux0 - SX, p2[1]), (ux0 - SX, p4[1]), p4], "GND")
for v, n in ((v7, U13N["7"]), (v4, "GND")):
    add_via(v[0], v[1], n); VIAS.append(v)
json.dump({"U13": {"6": [ux0 + SX, (p8[1] + p6[1]) / 2, ["F"]], "8": [ux0 + SX, (p8[1] + p6[1]) / 2, ["F"]],   # strap middle (corners chamfered)
            "7": [v7[0], v7[1], ["F", "B"]]}},
          open("routing/terminals.json", "w"), indent=1)
gnd_vias = 0
for f in fps.values():
    fx, fy = pcbnew.ToMM(f.GetPosition().x) - OX, pcbnew.ToMM(f.GetPosition().y) - OY
    for pd in f.Pads():
        pn = pd.GetNetname()
        if pn not in ("GND", CHASSIS) or pd.GetAttribute() != pcbnew.PAD_ATTRIB_SMD: continue
        if f.GetReference() == "U13": continue                  # fan-out above (5a-1)
        a, b_, c, d = pad_box(pd); px, py = (a + c) / 2, (b_ + d) / 2
        if pn == "GND" and not (px > LOGIC_X + 1.0 or py > LOGIC_Y + 1.0): continue
        if pn == CHASSIS and not (px < LOOP_X - 1.0 and py < LOOP_Y - 1.0): continue
        ox, oy = px - fx, py - fy                      # outward from the part centre first
        dirs = sorted(((1, 0), (-1, 0), (0, 1), (0, -1), (1, 1), (1, -1), (-1, 1), (-1, -1)),
                      key=lambda u: -(u[0] * ox + u[1] * oy) / (abs(u[0]) + abs(u[1])) ** 0.5)
        hx, hy = (c - a) / 2, (d - b_) / 2
        cand = [(px + ux * (hx + VIA_D / 2 + g), py + uy * (hy + VIA_D / 2 + g))
                for g in (0.15, 0.4, 0.7, 1.0) for ux, uy in dirs]       # nearest gap first, outward first
        spot = next((q for q in cand if clear_of_pads(q[0], q[1], pd, CL_PLANE[pn]) and inside(q[0], q[1], REGION[pn])
                     and edge_dist(q[0], q[1], REGION[pn]) > VIA_D / 2 + 0.2
                     and all((q[0] - a_) ** 2 + (q[1] - b2) ** 2 >= 1.0 for a_, b2 in VIAS)), None)   # 1 mm to other vias
        if spot is None:
            raise SystemExit(f"no GND via place at {f.GetReference()} pad {pd.GetNumber()}")
        vx, vy = spot
        add_via(vx, vy, pn); VIAS.append((vx, vy))
        t = pcbnew.PCB_TRACK(b); t.SetStart(P(px, py)); t.SetEnd(P(vx, vy)); t.SetWidth(mm(GTW)); t.SetLayer(pcbnew.F_Cu)
        t.SetNet(net(pn)); t.SetLocked(True); b.Add(t); KEEP.append(t); gnd_vias += 1
print("pad vias", gnd_vias)
# stitching vias (D-145, skill section 8): along the edge of each plane region, 1.0 mm inside it, pitch STITCH; a spot is
# skipped when it is near a pad or within 2 mm of a via already placed
STITCH, INSET = 5.0, 1.0
stitch = 0
for netname, poly in PLANES:
    for (xa, ya), (xb, yb) in zip(poly, poly[1:] + poly[:1]):
        L = ((xb - xa) ** 2 + (yb - ya) ** 2) ** 0.5; ux, uy = (xb - xa) / L, (yb - ya) / L
        for k in range(int(L // STITCH) + 1):
            for nx_, ny_ in ((-uy, ux), (uy, -ux)):                            # inward normal: the one that lands inside
                x, y = xa + ux * k * STITCH + nx_ * INSET, ya + uy * k * STITCH + ny_ * INSET
                if inside(x, y, poly) and edge_dist(x, y, poly) > INSET - 0.05: break
            else:
                continue
            ccx = X0 + RC if x < X0 + RC else (X1 - RC if x > X1 - RC else None)    # rounded board corners
            ccy = Y0 + RC if y < Y0 + RC else (Y1 - RC if y > Y1 - RC else None)
            if ccx is not None and ccy is not None and ((x - ccx) ** 2 + (y - ccy) ** 2) ** 0.5 > RC - INSET: continue
            if not clear_of_pads(x, y, None, CL_PLANE[netname]) or any((x - p) ** 2 + (y - q) ** 2 < 4.0 for p, q in VIAS): continue
            add_via(x, y, netname); VIAS.append((x, y)); stitch += 1
print("stitching vias", stitch)

# ---- 5c. tracks and vias from the grid router (routing r2, D-143): routing/routes.json, made by routing/grid_router.py
# from routing/geom.json (routing/export_geom.py). Run the router again after any placement change. Before
# export_geom.py, run this script with --no-routes: old tracks on a changed board can give new vias a wrong net in KiCad.
ROUTES = "routing/routes.json"
if os.path.exists(ROUTES) and "--no-routes" not in sys.argv:    # --no-routes: board for export_geom.py
    rj = json.load(open(ROUTES))
    assert not rj["failed"], rj["failed"]
    # a track end on the middle of a same-net track (router T joint): split that track there, else KiCad DRC reports the
    # end as dangling (c-s6, R66 route)
    ends = {}
    for t in rj["tracks"]:
        ends.setdefault((t["net"], t["layer"]), set()).update({(t["x1"], t["y1"]), (t["x2"], t["y2"])})
    split = []
    for t in rj["tracks"]:
        dx, dy = t["x2"] - t["x1"], t["y2"] - t["y1"]; L2 = dx * dx + dy * dy
        cut = sorted(((ex - t["x1"]) * dx + (ey - t["y1"]) * dy) / L2 for ex, ey in ends[(t["net"], t["layer"])] if L2 > 0
                     and 1e-6 < ((ex - t["x1"]) * dx + (ey - t["y1"]) * dy) / L2 < 1 - 1e-6
                     and abs((ex - t["x1"]) * dy - (ey - t["y1"]) * dx) / L2 ** 0.5 < 1e-3)
        pts = [(t["x1"], t["y1"])] + [(round(t["x1"] + u * dx, 4), round(t["y1"] + u * dy, 4)) for u in cut] + [(t["x2"], t["y2"])]
        split += [dict(t, x1=a[0], y1=a[1], x2=c[0], y2=c[1]) for a, c in zip(pts, pts[1:])]
    if len(split) != len(rj["tracks"]): print("T joints split:", len(split) - len(rj["tracks"]))
    rj["tracks"] = split
    for t in rj["tracks"]:
        tr = pcbnew.PCB_TRACK(b); tr.SetStart(P(t["x1"], t["y1"])); tr.SetEnd(P(t["x2"], t["y2"])); tr.SetWidth(mm(t["w"]))
        tr.SetLayer({"F": pcbnew.F_Cu, "In2": pcbnew.In2_Cu}[t["layer"]]); tr.SetNet(net(t["net"])); b.Add(tr); KEEP.append(tr)
    for v in rj["vias"]:
        vi = pcbnew.PCB_VIA(b); vi.SetPosition(P(v["x"], v["y"])); vi.SetWidth(mm(v["d"])); vi.SetDrill(mm(v["drill"]))
        vi.SetNet(net(v["net"])); b.Add(vi); KEEP.append(vi)
    print("routes", len(rj["tracks"]), "tracks", len(rj["vias"]), "vias")

# ---- 5d. silkscreen p3 (skill schematic-and-marking.md): labels, art block, stackup legend on the back, then every
# reference placed clear of pads, silk and the other texts. Text 1.0 mm, line 0.15 mm (JLCPCB minimum).
SH, ST = 1.0, 0.15
def bx(box, m=0.0):
    return (pcbnew.ToMM(box.GetX()) - OX - m, pcbnew.ToMM(box.GetY()) - OY - m,
            pcbnew.ToMM(box.GetRight()) - OX + m, pcbnew.ToMM(box.GetBottom()) - OY + m)
def hit(a, c): return a[0] < c[2] and c[0] < a[2] and a[1] < c[3] and c[1] < a[3]
SILK = {pcbnew.F_SilkS: [], pcbnew.B_SilkS: []}                # boxes of texts and drawings placed in this section
def text(s, x, y, side="F", h=SH, t=ST, rot=0.0, just="c"):
    o = pcbnew.PCB_TEXT(b); o.SetText(s); ly = pcbnew.F_SilkS if side == "F" else pcbnew.B_SilkS; o.SetLayer(ly)
    o.SetTextSize(pcbnew.VECTOR2I(mm(h), mm(h))); o.SetTextThickness(mm(t)); o.SetTextAngleDegrees(rot)
    o.SetHorizJustify({"l": pcbnew.GR_TEXT_H_ALIGN_LEFT, "r": pcbnew.GR_TEXT_H_ALIGN_RIGHT, "c": pcbnew.GR_TEXT_H_ALIGN_CENTER}[just])
    if side == "B": o.SetMirrored(True)
    o.SetPosition(P(x, y)); b.Add(o); KEEP.append(o); SILK[ly].append(bx(o.GetBoundingBox())); return o
def sline(xa, ya, xb, yb, side="F"):
    ly = pcbnew.F_SilkS if side == "F" else pcbnew.B_SilkS
    l = pcbnew.PCB_SHAPE(b, pcbnew.SHAPE_T_SEGMENT); l.SetStart(P(xa, ya)); l.SetEnd(P(xb, yb)); l.SetLayer(ly)
    l.SetWidth(mm(ST)); b.Add(l); KEEP.append(l); SILK[ly].append(bx(l.GetBoundingBox(), 0.1))
def scircle(x, y, r):
    c = pcbnew.PCB_SHAPE(b, pcbnew.SHAPE_T_CIRCLE); c.SetCenter(P(x, y)); c.SetEnd(P(x + r, y)); c.SetLayer(pcbnew.F_SilkS)
    c.SetWidth(mm(ST)); b.Add(c); KEEP.append(c); SILK[pcbnew.F_SilkS].append(bx(c.GetBoundingBox(), 0.1))
# labels: Cat6 entry, pairs in the J1 pin order, isolation band, test points (D-120, D-141), SDA select jumper (D-94)
text("J1 LINK  Cat6 to shack", J1_X, 16.7)
for k, _ in COLS:
    text(f"PAIR {k}", CX[k] + GDX[k], 18.6)
text("ISOLATION 3 mm (D-142)", (LOOP_X + LOGIC_X) / 2, 30.0, rot=90)
TPSIG = {"TP5": "SCL", "TP6": "SDA", "TP7": "EXP_INT", "TP8": "RLY_EN", "TP9": "TX_ANY", "TP1": "+5V", "TP2": "+3V3",
         "TP3": "FAULT", "TP4": "RF_A2_N"}
for ref, sig in TPSIG.items():
    x = pcbnew.ToMM(fps[ref].GetPosition().x) - OX
    text(f"{ref} {sig}", x, YTP + 6.5, rot=90, just="r")      # reads upward, hangs below the K0 link row
for i, s in enumerate(("JP11 SDA", "1-2 IO7", "2-3 IO10")):
    text(s, 139.5, 48.0 + 1.6 * i, just="l")
# art block (front): project, board, revision, date code (update at each order), call; the safety gate as an IEC 60617 NOR
AX, AY = 64.0, 88.0
text("SHACK RELAY MATRIX", AX, AY, h=1.5, t=0.3, just="l")
text(f"Controller board  rev C  ({REV})", AX, AY + 2.6, just="l")
text("2026-10  DC 2643", AX, AY + 4.6, just="l")
text("73 de PE1RGU", AX, AY + 6.6, just="l")
GX0, GX1, GY0, GY1 = 110.0, 118.0, 85.0, 97.0
for a, c in (((GX0, GY0), (GX1, GY0)), ((GX1, GY0), (GX1, GY1)), ((GX1, GY1), (GX0, GY1)), ((GX0, GY1), (GX0, GY0))):
    sline(*a, *c)
text("≥1", (GX0 + GX1) / 2, GY0 + 2.2)
for y, s in ((87.0, "KILL"), (91.0, "MCU_EN_N"), (95.0, "FAULT")):
    sline(GX0 - 5.0, y, GX0, y); text(s, GX0 - 5.5, y, just="r")
scircle(GX1 + 0.6, 91.0, 0.6); sline(GX1 + 1.2, 91.0, GX1 + 6.0, 91.0); text("RLY_EN", GX1 + 6.5, 91.0, just="l")
for i, s in enumerate(("inputs  RLY_EN", "all 0     1", "any 1     0")):
    text(s, 133.0, 87.0 + 2.0 * i, just="l")
# back: board-to-board socket and the stackup legend (D-144)
text("J2 to RF board J14", 74.0, 6.0, side="B")
for i, s in enumerate(("JLC04161H-7628  1.6 mm  4 layers", "L1 signals vertical     L2 GND / CHASSIS",
                       "L3 signals horizontal   L4 GND / CHASSIS", "Tracks 0.254 signal, 0.508 power and Cat6 loops")):
    text(s, 100.0, 100.0 + 2.0 * i, side="B")
# references: first spot clear of pads (+0.25), silk and texts (+0.1), the board edge (0.6) and, if possible, of the
# other parts' courtyards. Board-only holes and test points (labelled above) have no reference on the silk.
def obstacles(side_cu, side_silk, side_crt):
    pads, silk, crt = [], [], []
    for f in fps.values():
        for pd in f.Pads():
            if pd.IsOnLayer(side_cu): pads.append(bx(pd.GetBoundingBox(), 0.25))
        for g in f.GraphicalItems():
            if g.GetLayer() == side_silk and g.Type() == pcbnew.PCB_SHAPE_T: silk.append(bx(g.GetBoundingBox(), 0.1))
        cy_ = f.GetCourtyard(side_crt)
        if cy_.OutlineCount(): crt.append((f, bx(cy_.BBox())))
    return pads, silk, crt
OBS = {"F": obstacles(pcbnew.F_Cu, pcbnew.F_SilkS, pcbnew.F_CrtYd), "B": obstacles(pcbnew.B_Cu, pcbnew.B_SilkS, pcbnew.B_CrtYd)}
unplaced = []
for ref in sorted(fps, key=lambda r: (pcbnew.ToMM(fps[r].GetPosition().y), pcbnew.ToMM(fps[r].GetPosition().x))):
    f = fps[ref]; fld = f.Reference()
    if ref in ("H2", "H3", "H4") or ref in TPSIG:
        fld.SetVisible(False); continue
    side = "B" if f.IsFlipped() else "F"; ly = pcbnew.B_SilkS if side == "B" else pcbnew.F_SilkS
    pads, silk, crt = OBS[side]
    fld.SetTextSize(pcbnew.VECTOR2I(mm(SH), mm(SH))); fld.SetTextThickness(mm(ST)); fld.SetVisible(True)
    fld.SetHorizJustify(pcbnew.GR_TEXT_H_ALIGN_CENTER); fld.SetVertJustify(pcbnew.GR_TEXT_V_ALIGN_CENTER)
    own = next((c for g_, c in crt if g_ is f), None) or bx(f.GetBoundingBox(False))
    ocx, ocy = (own[0] + own[2]) / 2, (own[1] + own[3]) / 2
    others = [c for g_, c in crt if g_ is not f]
    best = None
    for strict in (True, False):
        for gap in (0.3, 0.8, 1.5, 2.5):
            for rot, where in ((0, "N"), (0, "S"), (90, "W"), (90, "E"), (0, "W"), (0, "E"), (90, "N"), (90, "S")):
                fld.SetTextAngleDegrees(rot); fld.SetPosition(P(ocx, ocy)); tb_ = bx(fld.GetBoundingBox()); hw, hh = (tb_[2] - tb_[0]) / 2, (tb_[3] - tb_[1]) / 2
                x, y = {"N": (ocx, own[1] - gap - hh), "S": (ocx, own[3] + gap + hh), "W": (own[0] - gap - hw, ocy), "E": (own[2] + gap + hw, ocy)}[where]
                box = (x - hw, y - hh, x + hw, y + hh)
                if box[0] < X0 + 0.6 or box[2] > X1 - 0.6 or box[1] < Y0 + 0.6 or box[3] > Y1 - 0.6: continue
                if any(hit(box, o) for o in pads + silk + SILK[ly]): continue
                if strict and any(hit(box, o) for o in others): continue
                best = (rot, x, y, box); break
            if best: break
        if best: break
    if best is None:                                   # last tier: on the part's own body, between its pads
        fx, fy = pcbnew.ToMM(f.GetPosition().x) - OX, pcbnew.ToMM(f.GetPosition().y) - OY
        for rot in (90, 0):
            fld.SetTextAngleDegrees(rot); fld.SetPosition(P(fx, fy)); tb_ = bx(fld.GetBoundingBox()); hw, hh = (tb_[2] - tb_[0]) / 2, (tb_[3] - tb_[1]) / 2
            for dx in sorted((i * 0.25 for i in range(-14, 15)), key=abs):
                for dy in sorted((i * 0.25 for i in range(-10, 11)), key=abs):
                    box = (fx + dx - hw, fy + dy - hh, fx + dx + hw, fy + dy + hh)
                    if not any(hit(box, o) for o in pads + silk + SILK[ly]):
                        best = (rot, fx + dx, fy + dy, box); break
                if best: break
            if best: break
    if best is None:
        unplaced.append(ref); fld.SetTextAngleDegrees(0); fld.SetPosition(P(ocx, ocy)); continue
    fld.SetTextAngleDegrees(best[0]); fld.SetPosition(P(best[1], best[2])); SILK[ly].append(best[3])
print("silk: references not placed", unplaced)

# ---- 5b. zones (D-142, D-144): GND planes on In1.Cu (L2) and B.Cu (L4) and a GND pour on F.Cu, on the logic side only; a copper-free rule
# area along the barrier. Fill with kicad-cli pcb drc --refill-zones --save-board.
def poly(pts):
    o = pcbnew.SHAPE_LINE_CHAIN()
    for x, y in pts: o.Append(P(x, y))
    o.SetClosed(True); return o
# CHASSIS (D-145): the same three layers over the loop side. Clearance 0.5 mm (Loop class); spokes 1.0 mm for the GDT
# surge current to H1 (L4 B.Cu is 1 oz), still hand-solderable.
for netname, region, clr, spoke in (("GND", LOGIC_POLY, 0.3, 0.5), (CHASSIS, LOOP_POLY, 0.5, 1.0)):
    for layer in (pcbnew.In1_Cu, pcbnew.B_Cu, pcbnew.F_Cu):
        z = pcbnew.ZONE(b); z.SetLayer(layer); z.SetNetCode(net(netname).GetNetCode()); z.SetAssignedPriority(0)
        z.Outline().AddOutline(poly(region))
        z.SetLocalClearance(mm(clr)); z.SetMinThickness(mm(0.25))
        z.SetPadConnection(pcbnew.ZONE_CONNECTION_THERMAL); z.SetThermalReliefGap(mm(0.5)); z.SetThermalReliefSpokeWidth(mm(spoke))
        b.Add(z); KEEP.append(z)
BAND = [(X0, LOOP_Y), (LOOP_X, LOOP_Y), (LOOP_X, Y0), (LOGIC_X, Y0), (LOGIC_X, LOGIC_Y), (X0, LOGIC_Y)]
ra = pcbnew.ZONE(b); ra.SetIsRuleArea(True); ra.SetLayerSet(pcbnew.LSET.AllCuMask())
ra.SetDoNotAllowTracks(True); ra.SetDoNotAllowVias(True); ra.SetDoNotAllowZoneFills(True); ra.SetDoNotAllowPads(False)
ra.SetDoNotAllowFootprints(False); ra.SetZoneName("isolation barrier D-142")
ra.Outline().AddOutline(poly(BAND)); b.Add(ra); KEEP.append(ra)
b.Save(BOARD)
# physical stackup JLC04161H-7628 (D-144): written as text, the Python wrapper does not expose BOARD_STACKUP
STACKUP = [("F.Cu", "copper", 0.035, None, None), ("dielectric 1", "prepreg", 0.2104, "FR4 7628", 4.4),
           ("In1.Cu", "copper", 0.0152, None, None), ("dielectric 2", "core", 1.065, "FR4", 4.6),
           ("In2.Cu", "copper", 0.0152, None, None), ("dielectric 3", "prepreg", 0.2104, "FR4 7628", 4.4),
           ("B.Cu", "copper", 0.035, None, None)]
def stackup_text():
    st = ['\t\t(stackup', '\t\t\t(layer "F.SilkS"\n\t\t\t\t(type "Top Silk Screen")\n\t\t\t)',
          '\t\t\t(layer "F.Paste"\n\t\t\t\t(type "Top Solder Paste")\n\t\t\t)',
          '\t\t\t(layer "F.Mask"\n\t\t\t\t(type "Top Solder Mask")\n\t\t\t\t(thickness 0.01)\n\t\t\t)']
    for name, typ, th, mat, er in STACKUP:
        body = [f'(type "{typ}")'] + (['(color "FR4 natural")', f'(thickness {th})', f'(material "{mat}")', f'(epsilon_r {er})',
                                       '(loss_tangent 0.02)'] if mat else [f'(thickness {th})'])
        st.append(f'\t\t\t(layer "{name}"\n' + "".join(f"\t\t\t\t{x}\n" for x in body) + '\t\t\t)')
    st += ['\t\t\t(layer "B.Mask"\n\t\t\t\t(type "Bottom Solder Mask")\n\t\t\t\t(thickness 0.01)\n\t\t\t)',
           '\t\t\t(layer "B.Paste"\n\t\t\t\t(type "Bottom Solder Paste")\n\t\t\t)',
           '\t\t\t(layer "B.SilkS"\n\t\t\t\t(type "Bottom Silk Screen")\n\t\t\t)',
           '\t\t\t(copper_finish "ENIG")', '\t\t\t(dielectric_constraints no)', '\t\t)']
    return "\n".join(st) + "\n"
txt = open(BOARD).read()
i = txt.find("\n\t(setup\n"); assert i > 0, "no setup block"
j = i + len("\n\t(setup\n")
if txt.startswith("\t\t(stackup", j):
    k = txt.index("\n\t\t)\n", j) + len("\n\t\t)\n"); txt = txt[:j] + txt[k:]
open(BOARD, "w").write(txt[:j] + stackup_text() + txt[j:])

# ---- 6. netclasses in the project file ----
pro = json.load(open(PRO)) if os.path.exists(PRO) else {}
ns = pro.setdefault("net_settings", {})
classes = ns.setdefault("classes", [])
base = next((c for c in classes if c.get("name") == "Default"), None)
if base is None:
    base = {"name": "Default"}; classes.insert(0, base)
base.update({"track_width": 0.254, "clearance": 0.2, "via_diameter": 0.6, "via_drill": 0.3})
def cls(name, tw, cl):
    c = dict(base); c.update({"name": name, "track_width": tw, "clearance": cl, "priority": 0}); return c
ns["classes"] = [base, cls("Power", 0.508, 0.2), cls("Entry", 1.016, 0.5), cls("Loop", 0.508, 0.5), cls("GND", 0.254, 0.2)]   # widths 0.254 / 0.508 (Prins)
ns["netclass_patterns"] = ([{"netclass": "GND", "pattern": "GND"}] +
                           [{"netclass": "Power", "pattern": p} for p in ("+5V", "+3V3", "*U11-VOUT*")] +
                           [{"netclass": "Entry", "pattern": p} for p in ("*/L?P", "*/L?N")] +
                           [{"netclass": "Loop", "pattern": p} for p in ("*/CHASSIS", "Net-(C2?-Pad?)", "Net-(D?1-A?)",
                                                                     "Net-(D?2-K)", "Net-(D32-A)")])
open(PRO, "w").write(json.dumps(pro, indent=2) + "\n")
print(REV, "footprints", len(list(b.GetFootprints())), "nets", len(nets), "placed", len(placed),
      "J2 rot", fps["J2"].GetOrientationDegrees(), "USB", usb)
