PE1RGU/hf-antenna-switch/firmware/crates/shack-core/src/shack/host.rs

//! Host port: text lines from the Mac or Pi (docs/design/host-protocol.md).
//!
//! The host asks; the shack logic decides. No command here clears the SAFE latch
//! or gives a permit: commands only set what the host wants, as the API does.
//!
//! Each tick reads the received bytes and answers every complete line in the same
//! tick (`ok`, `err ...` or a text answer). Commands for the box answer `ok` when
//! queued; the box result comes later as an event. Events are not sent at once:
//! they are queued and sent at the end of the tick, after the change detection,
//! so the host sees the new state in a fixed order.

use super::*;
use core::fmt::{self, Write as _};
use heapless::{String, Vec};
use host_proto::{
    BoxPart, ErrorCode, ErrorLine, HostCommand, HostEvent, KEEP_ALIVE_DEFAULT_S, MAX_LINE,
    NameTarget, NamesLine, PROTO_VERSION, RadioStatus, StatusLine, TxPhase, parse,
};

/// Longest line the shack sends (the status line is about 200 characters).
const OUT_LINE: usize = 256;

/// Last value sent to the host per item; `None` = not sent yet.
#[derive(Default)]
struct Seen {
    safe_ok: Option<bool>,
    latched: Option<bool>,
    kill: Option<bool>,
    band: Option<u8>,
    permit: [Option<bool>; 3],
    tx: [Option<TxPhase>; 3],
    routes: [Option<Route>; 3],
}

pub(super) struct HostPort {
    buf: Vec<u8, MAX_LINE>,
    overflow: bool,
    events_on: bool,
    /// Keep-alive time-out in seconds (`keepalive`, section 8).
    keep_alive_s: u8,
    /// Time of the last line from the host; None until the host speaks (keep-alive off).
    last_line: Option<Ms>,
    queued: Deque<HostEvent, 32>,
    logs: Deque<&'static str, 4>,
    seen: Seen,
}

impl HostPort {
    pub(super) fn new() -> Self {
        HostPort {
            buf: Vec::new(),
            overflow: false,
            events_on: true,
            keep_alive_s: KEEP_ALIVE_DEFAULT_S,
            last_line: None,
            queued: Deque::new(),
            logs: Deque::new(),
            seen: Seen::default(),
        }
    }

    fn push(&mut self, e: HostEvent) {
        if self.queued.is_full() {
            self.queued.pop_front();
        }
        let _ = self.queued.push_back(e);
    }

    pub(super) fn log(&mut self, text: &'static str) {
        if self.logs.is_full() {
            self.logs.pop_front();
        }
        let _ = self.logs.push_back(text);
    }
}

fn phase(s: TxState) -> TxPhase {
    match s {
        TxState::Idle => TxPhase::Idle,
        TxState::Requesting => TxPhase::Requesting,
        TxState::Permitted => TxPhase::Permitted,
        TxState::Ending { .. } => TxPhase::Ending,
        TxState::Releasing => TxPhase::Releasing,
    }
}

fn write_line<H: ShackHw>(hw: &mut H, args: fmt::Arguments<'_>) {
    let mut s: String<OUT_LINE> = String::new();
    let _ = s.write_fmt(args);
    hw.usb_write(s.as_bytes());
    hw.usb_write(b"\r\n");
}

/// Mark a change and remember the new value.
fn changed<T: PartialEq + Copy>(seen: &mut Option<T>, now: T) -> bool {
    let c = *seen != Some(now);
    *seen = Some(now);
    c
}
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
