PE1RGU/hf-antenna-switch/(commit log)

2026-10-27 Initial publication: HF antenna switch, design phase
2026-10-27 README: renders, system diagram, safety chain diagrams
2026-10-27 Shack interface: end plates, schematic and PCB update; design log
2026-10-29 Shack interface: 2 inch display, front plate a8, board p8b, full render
    - D-186, M-102: layout p7, J14 (USB-C) at the rear edge; rear plate a7.
    - D-187, M-103: Waveshare 2inch LCD (240x320 IPS, ST7789VW); front plate a8;
    new printed display frame on WA-SMSI 9774055151R spacers.
    - M-104, M-105: layout p8b with the display notch, routed 155 of 155, DRC 0.
    - M-106: full SolidCraft render (case/render-full/); README open-case view.
    Claude-Session: https://claude.ai/code/session_01B1V8swdbsr8c87yrmmzj34
2026-10-29 README: new layout, matching open-case views of both units
    - Outdoor unit render from rf-case.solidcraft with the lid hidden
    (hardware/unit/case/render-open.json), same viewpoint as the shack interface.
    - Shack interface front and rear renders; old shack-interface.png removed.
    - README rewritten: overview, key numbers, why the project may interest
    readers, unit sections, safety chain, status table.
    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
2026-10-29 README: clearer front and rear views of the shack interface
    SolidCraft views in place of the dark CPU ray-traced renders; same style
    as the open-case views.
    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
2026-10-29 Firmware P0: Rust workspace, shack-core pin map, ESP32-C3 build target
    - firmware/PLAN.md: emulate at the HAL boundary, phases P0 to P7; no flashing before P7
    - Host workspace with shack-core (no_std): shack interface pin map (D-83, D-92, D-180, D-94), 3 tests
    - targets/shack-esp32c3: esp-hal 1.2 + embassy bring-up stub, build check only
    - check.sh and GitHub Actions: fmt, clippy, tests, no_std and target builds
2026-10-29 Firmware P1: link protocol spec and link-proto crate
    - docs/design/link-protocol.md v0.1: COBS frames with CRC-16/CCITT-FALSE,
    shack polls the box, state-based commands, TX handshake (D-63, F13, F14),
    time-outs; P-01 to P-04 decided by Prins (8N1, hold routes on link loss
    without permit, refuse TxRequest while TX_ANY, firmware update reserved)
    - link-proto (no_std): COBS, frames, streaming decoder, messages,
    shack and box link state machines
    - Tests: round trip, CRC finds 1 to 3 bit errors, every single bit error on
    the wire, random bytes, resync, retry with same seq, no double run,
    link loss at 300 ms at both ends, shack restart, version mismatch
    - check.sh builds every core cra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
2026-10-29 Firmware P2: simulator core and shack board model
    - sim-core: virtual time (us), trace of signals, I2C and UART bytes,
    I2C transaction runner, UART line with 8N1 byte timing, cut and fault filter,
    embedded-hal 1.0 adapters (I2c, OutputPin, InputPin, SpiBus) over a Board trait
    - sim-models: PCA9539 (register level, reset defaults, pair toggle, F1 effect),
    74LVC1G74, TPS3823 (td and tout at min/typ/max), ST7789 (240 x 320, MADCTL)
    - Shack board model: SAFE loop wired AND, fault latch, SAFE latch with POR,
    TX_EN, INH and keying per port, PTT loop, expander pin levels, display on SPI
    with DC/RST on the expander, data link lines
    - 16 board tests port verify_system.py sections 1, 3 (L1 t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
2026-10-29 Firmware P3a: shack logic on the board model
    - pca9539 driver (no_std): init in the F1 order with read-back, outputs,
    inputs, config read to find an expander reset
    - shack-core: ShackHw trait; Shack state machine: expander set-up and
    re-set-up, LATCH_CLR once, WDI every tick, link via link-proto,
    R2/R3 handshake (permit only on the box permit bit), F14 end rule and
    plausibility flag, R1 permit from its route (off during route changes),
    link loss drops all permits, software stop
    - sim-shack: ShackHw over the board model, scripted box stub, harness,
    demo binary that prints the timeline
    - 13 scenarios: start-up order, handshake, latched interface, F14 with short
    and long RF tail,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
2026-10-29 Host protocol spec v0.1 (P3b)
    Text lines over the ESP32-C3 USB Serial/JTAG port, one protocol for the Mac
    and the Pi. Commands, answers, events, status line, host keep-alive (2 s),
    clearfault. P3b-01 to P3b-04 and the P3a choices C-1 to C-3 decided by Prins.
2026-10-29 Firmware P3b: Mac protocol on the simulated shack interface
    - host-proto (no_std): line parser into HostCommand, answers, events and
    status line through core::fmt; round-trip and no-panic tests
    - shack-core: host port on ShackHw (USB): answers, change events, logs,
    host keep-alive (2 s, ends TX and releases keys), clearfault after a
    supervisor reset (P3b-04, C-2), events on/off; host served also while
    the expander is down
    - Spec: host lines end with CR, LF or CR LF so a plain terminal works;
    the shack sends CR LF; status shows key for R1 too
    - Board model and Board trait: USB port; harness: host() helper, host lines
    - sim-shack --pty: simulated shack in real time on a pseudo-termin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
2026-10-29 Host protocol: keepalive command for typing by hand
    `keepalive <seconds>` sets the host keep-alive time-out from 2 to 60 s.
    Default 2 s, back to 2 s at power-up; a host app leaves it at 2 s.
    The status line shows keepalive=<s>. Spec section 5, 7 and 8 updated.
    Prins found the 2 s time-out ended TX while typing commands by hand.
2026-10-29 Firmware P3c: display pages B, C and Safe stop
    - Mock-ups (docs/design/display-mockups): first round A, B, C; chosen by
    Prins: B and C and Safe stop in the modern style (anti-aliased M+ fonts)
    - shack-ui (no_std): UiState snapshot, page B flow (metro-map routes,
    TX glow), page C cards, Safe stop screen with cause and operator steps,
    fault screen, warning toast; frame buffer in ST7789 format; ST7789 commands
    - shack-core: display driver (RST, SLPOUT, init over the expander D/C),
    redraw on change, frame sent in 48-row chunks per tick, re-start after an
    expander loss; ui_state() with Safe stop causes; page b|c|auto
    - Host protocol: page command, status page=; auto = B 10 s, C 5 s
    - Si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
2026-10-29 Shack: configurable names and stored settings
    - Host protocol 8a: `name <A1..EXP|R1..R3> <text>` (1 to 8 characters),
    `names`; stored over a power cycle: names, routes, bias, page; never TX or
    keys; saved 2 s after the last change; restored at each link up once the
    box is ready (also after a box restart)
    - host-proto: Name, NameTarget, NamesLine
    - shack-core: config record with version and CRC-16 (bad or erased record
    gives the defaults), load at start-up, save, restore; ShackHw config_load
    and config_save (flash on the target, P7)
    - shack-ui: antenna and radio names come with the state
    - Simulator: stored record in the harness, optional state file
    - Tests: record round trip and ev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
2026-10-29 Simulator: terminal UI with the display, TCP host port, all systems
    - sim-shack runs a terminal UI by default (ratatui, crossterm): the display
    as the firmware draws it (ratatui-image: Sixel, kitty, iTerm2, else
    half-blocks), the outside world on F-keys, board signals, host traffic and
    a command line (host commands, and `:` outside-world commands)
    - TCP host port 127.0.0.1:7300 for host tools on every system; the pty mode
    stays for Unix only; `--demo`, `--state`, `--tcp`, `--no-tcp`
    - Stored settings kept in shack-sim-state.bin, so a simulator restart is a
    power cycle; auto keep-alive (F10) for typing by hand
    - Outside-world commands shared by the UI and the pty (ShackSim::world)
    -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
2026-10-29 Simulator UI: query the terminal before the UI starts, then clear
    macOS Terminal does not know the image-support queries and printed parts
    of them over the display title (seen by Prins). Query first, then start
    the UI with a cleared screen. Plain ASCII in the display title.
2026-10-29 Simulator UI: text view of the display for every terminal
    macOS Terminal cannot show pixels, so the half-block display was blurred
    (seen by Prins). The text view draws pages B, C and Safe stop from the
    same state with box and line characters and the 16 basic colours: route
    lines (heavy for TX), names, Safe stop cause and steps, warning line.
    Default in terminals without an image protocol; Tab switches to pixels.
    - shack-ui: wording module (stop title, cause, steps, warning line) shared
    by the pixel pages and the text view
    - shack-core: shown_page(now) for the page on screen (page auto included)
    - Tests: text view for all three pages, Tab to pixels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
2026-10-29 Simulator text view: TX and RX routes to one antenna stay apart
    A TX and an RX route to the same antenna ended on the same row, and the
    TX line hid the RX line (seen by Prins with R2 on A3/A3). Antenna boxes
    are now 4 rows like the radio boxes: TX enters the upper row, RX the
    lower. Turn order by direction (going down RX turns first, going up TX
    turns first), so the two routes of a radio never touch. Lines that cross
    other lines show a crossing.
2026-10-29 Simulator UI: --probe for display detection; TERM_PROGRAM first
    - `sim-shack --probe` prints the environment, window size, terminal query
    result and the chosen display mode, then exits
    - iTerm2 hint: TERM_PROGRAM names the terminal; LC_TERMINAL only counts
    when TERM_PROGRAM is not set, as it can leak into other terminals
2026-10-29 Simulator UI: iTerm2 uses iTerm2 images, not kitty
    `--probe` in iTerm2 (Prins): "query = Kitty, font 7x15". iTerm2 answers the
    kitty graphics query, but its kitty support is partial and the display
    stayed empty. With iTerm2 in TERM_PROGRAM, kitty and Sixel answers are
    replaced by the iTerm2 image protocol; the queried font size is kept.
2026-10-29 README: firmware and emulator section; full emulator guide
    - Main README: firmware and emulator section with two screenshots (pixel
    view in iTerm2, text view), how to start it; firmware status, layout,
    tools and licence lines brought up to date
    - firmware/README.md rewritten as the emulator guide: quick start, how it
    works (same no_std logic, models at the HAL boundary), what is and is
    not modelled, screen, keys, commands, a first session, display views,
    stored settings, host programs over TCP or pty, options,
    troubleshooting, tests, code layout, ESP32-C3 targets
    - Firmware licence MIT, as the repository's LICENSE-MIT (was "MIT OR
    Apache-2.0" without an Apache licence file); M+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
2026-10-29 Firmware: four faults found by the documentation review
    - clearfault: with the expander down, the fault is kept and the log says
    so; it no longer claims "cleared" (host-protocol.md section 5)
    - Watchdog: WDI is kicked last in a tick, after the checks of the pass,
    also when the pass stops early (D-59 rule 1)
    - Box link: after a version mismatch, Hello goes out at the answer
    time-out pace (60 ms), not back to back (link-protocol.md section 5)
    - Emulator: without 13.8 V the MCU is off and nothing reaches the host;
    when the supply returns the firmware starts from boot with the stored
    settings, as a real power cycle
    - A test for each, each checked to fail when its fix is undone
    - Guide,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
2026-10-29 Firmware rule F15: alarm on TX without permit (D-188, option A)
    Found by Prins in the emulator: an inhibited R2 could transmit without any
    warning.
    - Emulator radio model: a radio transmits only when not inhibited; an
    inhibit during TX stops it after its inhibit response time (default
    20 ms, M-12); `radio_no_inh` models a radio without a TX INH input
    - shack-core F15: TX sense without the permit for more than 50 ms, outside
    the 500 ms after its permit went off (RF tail), raises the alarm once:
    event, `!txsense <radio> nopermit`, first warning on the display. Nothing
    stops by itself (Prins, option A)
    - Terminal UI: F5 to F7 are the radio PTT; the Board panel shows TX,
    blocked and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
2026-10-30 Firmware P4: box board model and pin map
    - box-core crate with the box pin map (expanders U901 to U1001, GPIO),
    taken from rf14.xml and ctl14.xml.
    - RT1 relay model: operate, release and bounce at the datasheet maxima.
    - PCA9539 model: INT line, and a fault switch for an open RESET pin.
    - Box board model: supervisor, fault latch, READY and the SAFE loop, safety
    gate, expanders on RLY_EN, +12V_SW, 37 relay positions (A2 TX not fitted),
    K0 paths, RF detectors, bias-T, RF along the closed contacts, hazards H1
    to H4 and hot switching.
    - Tests reproduce verify_logic.py sections 2 to 9, including the S1 to S7
    intervals at minimum and maximum timing and the crossbar counts. Each
    rule wa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
2026-10-31 Firmware P5: box-core state machine and box emulator
    - box-core: RelayBox (start-up F11/F1, set-up again after KILL F5,
    switching sequence F10 with 12 ms waits and a TX_ANY pause, box side
    of the TX handshake, link time-out F13/P-02, WDI, bias-T faults),
    crossbar check H1 to H4 (F6), BoxHw trait.
    - Stop exit (decided 2026-10-31): Hello, or TxEnd for each radio that
    had a permit; then MCU_EN_N = 0 and the F11 start-up.
    - Hello ends every permit; K0 released 100 ms later (F14 wait).
    - Expander lost with a permit out opens SAFE, as a link loss.
    - link-proto: fault code 6, link time-out with no permit out.
    - sim-box: harness, scripted shack with SAFE latch, 22 scenarios.
    - sim-models: PC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
2026-10-31 Firmware P6: both firmwares joined in sim-system
    - sim-system: SystemSim runs the shack and box harnesses with their
    stubs off and joins them by the four Cat6 pairs (data both ways,
    PTT loop, SAFE loop). Radio RF starts after the F7 TX delay. A
    per-ms check: R2/R3 released only with K0 settled on TX (D-63).
    - 17 system scenarios with fault injection, and the 256-row SAFE
    table of system-verification section 1 across both boards.
    - shack-core fixes found by the joined run: store the route and bias
    the box accepted, not the read-back in its immediate answer; resend
    stored routes and bias each time the box is READY again, per item,
    waiting while a radio still ends TX.
    - sim-box: S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
2026-10-31 Firmware P7: shack and box targets on the ESP32-C3, first flash
    - shack-esp32c3: ShackHw on esp-hal (I2C, permits, WDI, LATCH_CLR,
    SAFE_LOST, box UART with inverted RX per D-58, USB host port, display
    SPI, frame buffer in static RAM). Main loop 1 ms: logic every 10 ms,
    USB send buffer pumped every pass, never blocking. Settings in RAM.
    - box-esp32c3 (new): BoxHw on esp-hal (I2C, WDI, LATCH_CLR, MCU_EN_N
    high at boot, KILL with pull-up, link UART with inverted RX). Main
    loop 1 ms; debug log on USB; phase blink on the DevKit LED (GPIO7,
    free on the controller board with JP11 for the RUST-1, D-94).
    - Flashed on a bare DevKit-RUST-1: shack answers hello/status/help;
    box shows WaitS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
2026-10-31 Power-up self-test on both boards
    Box (box-core): the first time the SAFE loop closes after power-up,
    before any relay can move: gate (MCU_EN_N opens READY and drops RLY_EN,
    no expander answers), expander set-up, start-up inputs (warning),
    watchdog trip within 0.5 to 3 s, second LATCH_CLR edge (cause known,
    rule 2). Fail: MCU_EN_N high, Phase::Failed, fault 7 to 9 (or 1, 2)
    until a power cycle. New fault codes 7 to 10 in link-proto.
    Shack (shack-core): expander within 1 s, SAFE latch set at power-up,
    TX sense and DevKit I2C parts (warnings), watchdog trip seen as an
    expander reset; then the one LATCH_CLR edge. Fail: no edge, so TX_EN
    stays low; no permits. Colour-bar test pattern for 1 s on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
2026-10-31 Targets: loop and stack figures, shack status LED
    - Both ESP32-C3 targets: tick time (max, average), the longest gap
    between tick starts, and the stack high-water mark (paint at boot,
    above the esp-hal stack guard), every 10 s. Shack: `# diag` line on
    the host port; box: a line in its USB log.
    - Shack target: DevKit LED (GPIO7) shows the self-test: 5 Hz running,
    1 Hz passed, 10 Hz failed. GPIO7 joins no net on the shack board with
    JP61 set for the RUST-1 (D-94).
    - Bare DevKit, 2026-10-31: shack tick 0.1 ms avg, 10.0 ms rhythm;
    box tick 1 to 7 us, 1.0 ms rhythm; stack 1.9 KB used on both.
    Recorded in PLAN; README updated.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
2026-10-31 Shack target: LED with the same meaning as the box
    1 Hz = TX possible (self-test passed, no fault, SAFE latch clear, link
    up, box ready); 5 Hz = starting or waiting; 10 Hz = self-test failed;
    on solid = the box reports a link-loss stop.
2026-10-31 Emulator program runs the real box firmware
    - SystemSim moves into sim-shack (module `system`), so the terminal UI
    and the pty mode can run it without a crate cycle; sim-system
    re-exports it and keeps the system tests.
    - Terminal UI and --pty run SystemSim: the box firmware on the box
    board model, joined by the four Cat6 pairs. Board panel: box phase
    and fault, relay hazards and hot switches.
    - Box world commands: box hang (F8, replaces box mute), box power,
    box rfa2, box ready stuck, box r64, box nack U901-U1001. reset and
    cable act on both boards.
    - Tests: world commands reach the box; UI tests press RESET after the
    box self-test; panel shows the box lines.
    - --demo keeps the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
2026-10-31 Pre-order review; RF board seat keep-outs; part reuse P-1 to P-5
    - docs/reviews/2026-10-31-pre-order-review.md: review of all three boards
    before ordering (verify scripts, ERC/DRC, pin maps, BOM, fab and case,
    firmware against spec, open items, part reuse).
    - RF board (D-189, M-107): no other-net copper or vias under the case
    seats at S1 to S6 and the SO-239/SMA GND bosses; relay NC pads (pad 12)
    in netclass RF. Re-routed, DRC 0.
    - Part reuse (D-190, M-108): one value text for 2k2, 100n 50V X7R and
    10n 50V X7R; shack PC817X order code as the controller; shack U4/U9 in
    VSSOP-8 (TI DCU, Nexperia DC) with fixed fan-out, re-routed.
    Netlists rf15, ctl15, si17; ERC 0.
    Co-Authored-By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
2026-10-31 Shack settings in flash; box fixes F-1 to F-4
    - Shack target saves its settings in the nvs partition (0x9000) with
    esp-storage. Settings are also saved when no expander is fitted.
    - F-1: after a Hello, K0 is released only when no RF is on the column.
    - F-2: no TX route or permit on EXP without unit 2.
    - F-3: one I2C error is ridden out (2 retries); a read-back mismatch
    writes the outputs again.
    - F-4: each switching step waits RELAY_WAIT + IO_MARGIN (20 ms).
    - New emulator tests for each fix; docs updated.
2026-10-31 S-1: FAULT to GPIO6, box fault 11, host clearfault
    Hardware (D-191, M-109):
    - Controller board: R66 1k from FAULT (U13 Q) to DevKit pin 11 (GPIO6).
    Schematic c15-fault-io6, netlist ctl16, layout c-s6, re-routed.
    ERC 0, DRC 0 violations and 0 unconnected. BOM: R66 on the 1k line.
    - gen_controller_pcb.py splits a track where a same-net track ends on it.
    - verify_logic.py checks R66 and FAULT_IO6.
    Firmware:
    - Box reads FAULT. After the self-test, FAULT = 1 gives fault 11
    (supervisor trip); READY stays open.
    - New link command ClearFault (0x03): one LATCH_CLR edge, Ok if FAULT
    clears, else NotReady. No edge without a trip.
    - Host clearfault also sends ClearFault when the box reports fau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
2026-10-31 S-2: SDA jumpers bridged 1-2 for RUST-1 by default
    JP11 (controller) and JP61 (shack) use the Bridged12 solder jumper.
    Pad 1 = SDA_IO10 (RUST-1), pad 3 = SDA_IO7 (RUST-2). Boards ship ready
    for RUST-1; for RUST-2 cut 1-2 and bridge 2-3. New netlists ctl17 and
    si18, new JP11/JP61 checks, boards re-routed, DRC clean. D-192, M-110.
2026-10-31 S-3: drain copper per bias-T FET on F.Cu and B.Cu
    Each feed FET (Q1012/Q1022/Q1032/Q1042) gets an /A?_BIAS pour on F.Cu
    around the tab and on B.Cu over its cell, with 9 thermal vias. About
    415 mm2 (0.64 in2) per FET; estimated RthJA 70-75 K/W, Tj 110-114 C in a
    held short at 55 C (C-17). stitch.py puts no grid vias in the cells.
    RF layout p3-drain: 168/168 nets, 1124 vias, DRC 0 (30 pad-12 pairs as
    before). D-193, M-111. Held-short test on the prototype to confirm.
2026-11-01 S-8: shack interface 159.6 mm wide
    The side edges in the extrusion slots move in 0.2 mm each (x 0.2 and
    159.8), so the board fits the 160 mm slots with the JLC outline
    tolerance. Centre stays at x 80: end plates unchanged. Shack layout
    p8e: 155/155 nets, 429 vias; DRC as p8d plus one starved thermal
    (R418 pad 2); JP406 reference hidden. D-194, M-112.
2026-11-01 S-9: controller production zip c-s7
    New Fabrication Toolkit zip for layout c-s7 (S-1 R66/FAULT to IO6, S-2
    JP11 bridged). Drill hits per tool read back and equal to the board.
    ORDER sheet: c-s7 / c16 / ctl17, 0.8 and 1.0 mm hole labels corrected.
    c-s5 zip removed (copy in backups/). M-113.
2026-11-01 S-12: display strap check on IO2/IO9 (M-114)
    The Waveshare 2inch module has no pull on SCK or DIN, and the ST7789VW
    input current is 1 uA max. The IO2 and IO9 straps read high at reset.
    No board change. D-180 gets the evidence, rev-a pin map updated, review
    doc closes S-12. Boot check with the display stays for the prototype.
2026-11-01 S-4: MPN BSS138BK,215 (Nexperia) on RF and shack (M-115)
    The ROHM BSS138BKT116 has the same name and another pin order. All 45
    BSS138BK (RF 42, shack 3) now carry MPN BSS138BK,215. Nexperia pinning
    1 G, 2 S, 3 D matches the footprint. ERC 0 on both; boards and
    netlists unchanged.
2026-11-01 S-5: RF J14 = Samtec TSW-112-07-L-D (M-116)
    Post 5.84 mm above the body, 10 uin gold on the post. Mates with the
    ESQ-112-33-G-D socket: engagement 4.89 mm at the 19.7 mm board gap,
    inside 3.68 to 6.35 mm. ERC 0; boards unchanged.
2026-11-01 S-6: order codes for LM2901, JST XH and shack 1 nF (M-117)
    MPN fields only: RF U801 LM2901DR; shack J2/J7 B2B-XH-A(LF)(SN),
    J6 B4B-XH-A(LF)(SN), 21 x 1 nF C0G GRM1885C1H102JA01D. Values,
    netlists and boards unchanged. ERC 0 on both.
2026-11-01 S-7: plain PCA9539 only, never the R variant (D-133)
    The PCA9539R resets only the I2C interface, so relay outputs would keep
    their old state. The firmware relies on RESET clearing the registers
    (relay_box.rs:434, 478, 564). The rule is already in the part
    descriptions and goes into the order BOM with B-3. Docs only.
2026-11-01 S-10: MAX823SEUK+T first source, IRFL9014TRPBF-BE3 (D-195, M-118)
    Supervisor U12 (controller), U3 and U6 (shack): MAX823SEUK+T first,
    TPS3823A-33DBVR and APX823-29W5G-7 second. Same pin-out; RESET_N loads
    are CMOS inputs; WDI and MR behave as the TPS3823 in our circuits.
    RF Q1012 to Q1042: IRFL9014TRPBF-BE3. TLP176AM in stock at Mouser.
    SO-239 83-798 stays single source, order first. Values and boards
    unchanged. ERC 0 on all three.
2026-11-01 SO-239: 83-1R first source, 83-798 second (D-196, M-119)
    Same flange, hole pattern, thread and front length (drawings 83-1R rev
    AM, 83-798 rev AG). PBT insulator: solder the strap fast and check the
    centre contact; no halogen statement (exception to D-135, reason
    supply). Value and footprint unchanged; ERC 0; boards unchanged.
2026-11-01 Review: close Decide D-148 (settled by D-195)
    MAX823SEUK+T is the first source and its datasheet is filed. Remove
    the Decide row and the section 8 row; note the decision in
    controller-board.md.
2026-11-01 D-197: RF creepage 2.0 mm accepted for the prototype
    Review Decide item closed. C-05, A-01, S-03 and S-04 stay open: read
    IEC 60664-1 and -4 before product use or a second batch. IEC 60664-4
    covers up to 10 MHz only. Residual risk: tracking in a humid box.
2026-11-01 D-198: RT1 isolation at HF accepted, M-01 on the first RF board
    Review Decide item closed. Buy all relays for the build; Prins measures
    isolation, insertion loss and match on the first assembled RF board
    through the SO-239s (no coupon). A-04 and M-01 updated.
2026-11-01 D-43 decided: clamp zener BZT52H-C24,115 (M-120)
    Nexperia BZT52H-C24 passes the 13-coil clamp pulse (11.5 W peak, about
    0.5 ms) against the PZSM curve (about 16 W at 0.5 ms). Diotec
    BZT52C24 is the second source (no surge rating stated). Drain peak
    39.1 V against 42 V. ERC 0; boards unchanged.
2026-11-01 D-199: unit PSU Mean Well HDR-30-12 + HDR-15-5
    HDR-30-12 (12 V 2 A, +-1 %, set 12.0 V) feeds both XT60 inputs;
    HDR-15-5 feeds the XT30. Hiccup overload of a few A, far below the
    50 A fuse breaking capacity: A-13 closed. RD-50A dual output rejected
    (12 V channel +-7 %). Risk: switch-mode near the antennas, listen test.
2026-11-01 D-200: part merges P-6 to P-12 declined, P-13 RF only
    P-13: RF C6/C7 get a 47 uF 35 V polymer part in 6.3 mm at B-3
    (MPN only). Shack C1 stays the 47 uF 35 V radial. Review doc
    Decide row removed; section 10 status points to D-200.
2026-11-01 D-201: case items decided (screws, spacers, ribbon slot)
    - A-27: end plates on pan-head ST3.5 x 8, no countersink.
    - A-29: WA-SMSI spacers without NPTH; test plate check first,
    drill 3.7 mm by hand as fallback.
    - D-53: unit 2 ribbon slot about 32 x 3 mm in the first CNC order;
    position set in the case CAD update before the resubmit.
    Review doc: last Decide row removed.
2026-11-02 B-3: order BOMs for RF board and shack interface; D-202 1206 RF tap caps
    - New gen_bom.py for the RF board and the shack interface. Each writes
    production/bom_hand_assembly.csv with first and second source per line.
    - D-202: C404 to C704 move to a 1206 land with a 2.0 mm pad gap
    (C_1206_3216Metric_RFgap2.0), part Knowles 1206J1K04P70CCT.
    Netlist rf16, ERC 0, DRC 0 (30 known relay pad-12 unconnected).
    - RN part fixed to CAY16 (convex), D-121.
    - M-121 shack fuse check, M-122 BOM sweep and source swaps.
    - Review doc: B-3 closed.
2026-11-02 B-4: order-readiness pass for RF board and shack interface (M-123)
    - Fabrication Toolkit output for both boards in production/: Gerber and
    drill zip, position, designators, IPC netlist.
    - Gerber and drill read back against each board: layers, outline and
    holes per tool match.
    - Order sheets ORDER-rf-board.md and ORDER-shack-interface.md.
    - RF rev p3-drain to p3-c1206, text changed in place on the board.
    - M-123 logs a finding: gen_rfboard_pcb.py no longer reproduces the RF
    board (A1_BIAS drain vias). Do not re-run it on the board.
    - Open: JLC DFM upload and sign-off of the RF routing.
2026-11-02 S-16, S-17: logic check to D-162; close superseded log rows (M-124)
    - verify_logic.py: support check now tests D-162 (each Sn on its own
    CHASSIS_Sn net with only its DNP bond to GND; H1 on CHASSIS).
    rf16/ctl17: 54 pass, 0 fail. Logic and system reports filed again.
    - design-log.md: closing note on 50 rows from the review S-17 list,
    each naming the entry that closed it. No text removed.
    - Review doc: S-16 and S-17 closed.
2026-11-02 Review: S-14 sample parts ordered (DigiKey, TME)
2026-11-08 D-203, D-204: radio SO-239 move and milled case tray
    - RF board p3-so239: J1 and J2 moved for the case pocket corner (D-203, M-125)
    - Case CAD updated for D-203 (M-126) and for milling (D-204, M-127, M-128)
    - Fit-print STLs and lid artefact fix (M-129), drawings rev C and D
2026-11-10 M-130, M-131: RF production files p3-case, XT polarity confirmed
    - RF zip made again for p3-case (D-203, D-204); read-back matches the board
    - S-13 closed: XT60/XT30 + on the flat side, pad 2 on all four footprints
    - A-05, A-21 closed: real 83-1R and 142-0701-631 fit
    - RT1 and display received; display check open
