PE1RGU/hf-antenna-switch/(notices)

Notices in the files:
README.md:
Hardware: CERN-OHL-S-2.0
